sakuyaShining/FPGA-Music-project-internal/src/gowin/bringup_9k/image_rom_preview.png

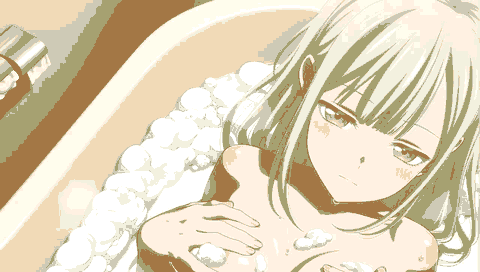
src/gowin/bringup_9k/image_rom_preview.png
