sakuyaShining/FPGA-Music-project-internal/README.md

**2026-10-29 基线复核更正：传感板暂停投产。** 实际S1 Gerber底层地铜到22个非地排针焊盘最小间距约0.162858mm，低于保留门限0.1651mm；此前原生DRC0、5μm图形比对与较低通用门限未覆盖该严格条件。可继续询价，先不按本版传感板付款生产。旧冻结包字节保留用于追溯，不能据其中的PASS或READY文字忽略本更正。详见基线`evidence/retained-clearance-gate-audit.json`。

**2026-10-29 硬件交付接续**：先读[当前交付基线](project/DELIVERY-BASELINE-20261029.md)。冻结Control88 R2×1与Sensor14Bank S1×6及送厂资料；采购报价、固件与整机验收仍未完成。任务分支候选不自动成为main。

# FPGA Music 项目总入口

**当前统一入口（2026-10-27）**：[project/CONSOLIDATION-20261027.md](project/CONSOLIDATION-20261027.md)。已整合硬件阶段成果与恢复资料；完整实体、制造文件和产品验收仍待完成。

**快速接手**：[产品规格与差距](project/PRODUCT-SPEC.md) → [工程分布](project/SOURCE-MAP.md) → [待办与验收](project/WORK-PLAN.md)。仓库现已公开；实际远程main是发布入口，未合并PR仍是候选。

当前协作工程见[工程入口](project/ENGINEERING.md)与[2026-10-24协作检查点](project/COLLABORATION-CHECKPOINT-20261024.md)：`fpga/current/`、`hardware/current/`、`host/current/`。这是有输入身份和验证边界的开发候选，完整产品未验收；历史根目录源码不作为最新开发入口。

**先读[当前设计](project/DESIGN-CURRENT.md)与[快速取得版本](project/QUICKSTART.md)，再读 [project/CURRENT.md](project/CURRENT.md)。** 该页统一导航音乐基线、开发候选、临时探针、GUI与硬件版本。

**新Agent直接读[启动入口](project/AGENT-START.md)和[交接身份](project/handoff.json)**；可转交的完整指令见[NEXT-AGENT-PROMPT](project/NEXT-AGENT-PROMPT.md)。

- 机器版本与验证边界：[project/state.json](project/state.json)
- 已保全源码及恢复身份：[版本清单](project/versions/workspace-preservation-20261022.json)
- 开工规则：[AGENTS.md](AGENTS.md) · [协作板](docs/00-协作/AGENT-BOARD.md)
- 核对命令：`python tools/scripts/project_control.py check --full --remote --fresh-entry`
- 审阅期限、活跃源与未发布WIP：`python tools/scripts/design_governance.py status --remote`，本机核对加`--live`；长期维护见[MAINTAINING-MAIN](project/MAINTAINING-MAIN.md)

当前完整功能产品顶层尚未实现并验收。GitHub保存的WIP不代表功能完成；路由完成也不代表STA通过。

---

## 历史主目录说明

以下保留原README的阶段基线。最新版本分工与有效证据以以上总入口为准。

# FPGA 加法合成电子乐器

基于高云 GW2AR-LV18QN88C8/I7（Sipeed Tang Nano 20K）的纯硬件实时加法合成乐器。
振荡器、包络、效果与曲谱时序全部在 FPGA 内完成，主机仅经串口下发控制参数。

选题：2026 高云半导体 FPGA 创新设计赛道「基于 FPGA 的实时多音色合成电子乐器引擎」。

## 音频链与硬件参数

| 项 | 参数 |
|---|---|
| 主时钟 | 板载 27 MHz（引脚 4），不使用 PLL |
| 采样率 | 52734.375 Hz = 27 MHz ÷ 16 ÷ 32 |
| 音频输出 | I2S 从模式（BCK / WS / DIN 三线），帧内单声道使用 24 位定点数据 |
| 控制接口 | UART 115200 8N1，两字节帧 `[地址][数据]`，地址表已冻结 |
| 演奏输入 | 16 路电容触摸电极（RC 充放电计数）：左手 8 键定音高，右手 8 键定泛音幅度 |
| 面板指示 | 6 个板载 LED；板载按键（引脚 88）预留 |

## 合成引擎要点

- **时分复用结构**：一个样本周期划分为 512 个时隙，即 32 声部 × 16 泛音。每个时隙完成一次相位累加、幅度查表与累加。
- **振荡器更新率**：512 × 52734.375 Hz ≈ 27.0 M 次/秒。
- **音高**：128 项相位增量 ROM 覆盖 MIDI 0–127。增量按精确频率计算而非现场近似，实测音高误差小于 0.1 音分。
- **混叠保护**：某次泛音的频率超过 Nyquist 频率时将其静音，而不是任其混叠。
- **塑谱**：16 字节泛音幅度表（谱 RAM），支持逐声部刷新。物理电极掩码与主机下发的谱按位或，因此"手指塑谱"与"软寄存器塑谱"逐位一致。
- **音色预设**：4 组泛音表。
- **效果**：延迟、合唱、8 抽头混响网络（含反馈与阻尼）。
- **曲谱时序**：片内定序器。曲谱既可固化在 RTL 中（上电后自行演奏，不依赖主机），亦可经 UART 下载。

## 目录结构

```
src/rtl        可综合 RTL：时分复用合成引擎、声部分配与音高、电极扫描、
               效果器、I2S 发送、串口接收、寄存器堆、片内定序器
src/sim        仿真测试台（各模块与顶层、判据验证）
src/constr     引脚约束（.cst）与时序约束（.sdc）
src/gowin      Gowin 工程与综合用数据表（音高表、预设泛音表、倒数表）
tools/scripts  构建、回归与判据脚本；命令行上位机；寄存器表抽取
tools/host     图形界面上位机（PyQt5）
docs           赛事情报、技术方案与学习路线文档
sim_build      仿真产物与音频证据（音频仅保留交付用的少量文件）
```

## 构建与验证

```powershell
# 编译全部仿真测试台
powershell -File tools\scripts\build_sims.ps1

# 全量回归：12 组套件，含 512 点频谱栅格与 16 组位一致比对
python tools\scripts\regress_all.py --full

# 综合与布局布线
powershell -File tools\scripts\build_gowin.ps1 `
    -Project src\gowin\tdm_synth\tdm_synth.gprj `
    -SspiAsGpio -PlaceOpt 2 -RouteOpt 2

# 图形界面上位机
python tools\host\dsp_gui.py
```

`-SspiAsGpio` 用于把 54/55/56 三脚从专用 SSPI 功能释放为普通 IO，DAC 数据线接在这三脚上，因此该选项不可省略。

## 验证方法

- **回归套件（12 组）**：加法引擎黄金参考（时分复用实现与全并行参考实现逐位一致）、I2S 编解码、包络、测试模式频谱栅格、寄存器音高、定序器事件、混响冲激响应、Nyquist 保护等。
- **音频级判据**：音高估计 7/7（±1 音分内）、混响衰减曲线、谱外能量占比。
- **判据全集、配方与证据路径**：`docs/02-技术方案/21-验收判据清单.md`。
- **接口规格（冻结）**：`docs/02-技术方案/19-UART协议v1.0草案.md`。
- **电极规格**：`docs/02-技术方案/20-pad扫描规格书.md`。

## 资源占用（最近一次布局布线）

- 逻辑资源 13690 / 20736（约 66%）
- SETUP 时序余量 +17.372 ns

## 上位机

`tools/host/` 为图形界面：键盘演奏、16 路泛音幅度调节、电极遥测柱状显示与量程判定、寄存器回读、帧序列导出。

串口不可用时可用内置"模拟设备"模式走通完整界面流程；连接真实硬件时，界面顶部徽标会明确标示当前设备类型，避免把模拟数据误认为硬件读数。

## 文档导航

| 想了解 | 位置 |
|---|---|
| 选题范围与硬性约束 | `docs/01-竞赛情报/01-选题确认与约束条件.md` |
| 整体开发计划与里程碑 | `docs/02-技术方案/01-开发方案与里程碑.md` |
| 板卡引脚与音频通路接线 | `docs/02-技术方案/02-硬件bringup-TangNano20K音频通路.md` |
| 乐器形态与交互层取舍 | `docs/02-技术方案/03-乐器形态方案建议.md`、`docs/02-技术方案/18-交互层决策清单.md` |
| 架构决策与候选方案对比 | `docs/02-技术方案/06-架构决策框架-v2.md`、`07-候选架构方案-v1.md` |
| 协议与寄存器表 | `docs/02-技术方案/19-UART协议v1.0草案.md` |
| 验收判据与证据 | `docs/02-技术方案/21-验收判据清单.md` |
| **演奏表情（力度/亮度/滑音/颤音）** | `docs/02-技术方案/31-演奏表情规格.md`（规格）、`32-演奏表情问题总表-设计层.md` / `-实现层.md` / `.json`（问题与落点）、`33-滑音颤音实现方案v1.md`（待拍板方案） |
| **当前版本规格（基线，带源码 SHA）** | `docs/02-技术方案/34-当前版本规格-基线v1.md` |
| **五阶段推进状态（阶段闸口）** | `docs/02-技术方案/35-五阶段推进状态.md` |
| 审计与复核记录 | `docs/02-技术方案/33-审计复核记录-2026-10-06.md` |
| 音高与八度规格 | `docs/02-技术方案/25-音高与八度规格.md` |
| 触控面板（选型/原型/PCB/装配） | `docs/02-技术方案/28-触控模块选型决策.md`、`29-触控原型验证程序.md`、`30-PCB布局需求单.md`、`26-电极面板装配指南.md` |

### 常用命令

| 目的 | 命令 |
|---|---|
| 全量回归闸口（33 套） | `python tools/scripts/regress_all.py --full` |
| **力度-亮度 试听与调音**（出 wav + 对照报告） | `python tools/scripts/vel_audition.py` |
| 只试一版新的力度权重表 | `python tools/scripts/vel_audition.py --table D:\tmp\my_vel.hex` |
| I²S 标准接收判据 | `python tools/scripts/i2s_std_check.py --simdir <dir>` |
| 顶层音频通路端到端判据 | `python tools/scripts/i2s_top_check.py --simdir <dir>` |
| GUI 自检（截图 + 帧一致性 10 项） | `python tools/host/dsp_gui.py --selftest` |
| 综合与时序 | `powershell -File tools/scripts/build_gowin.ps1 -Project src/gowin/tdm_synth/tdm_synth.gprj` |

## 命名约定

- 文档：`docs/<分类>/<序号>-<标题>.md`，序号自 00 起
- RTL：`src/rtl/<模块名>.v`，模块名小写下划线
- 约束：`src/constr/<顶层名>.cst`
- 测试台：`src/sim/tb_<被测模块>.v`
