sakuyaShining/FPGA-Music-project-internal/hardware/electrode-fullpanel-cam-20261030/README.md

# 完整84路电极面板：原生制造核验候选

2026-10-30已在嘉立创EDA V4.1.71实际恢复原工程，保存、关闭、重开后DRC违规0，并原生导出Gerber、BOM、插件坐标和IPC-D-356A。源文件SHA256仍为b7e9ecb16e4ea0141e8bf67e942ae228f7d2daf6d877422ee6b835a3f779530a，与旧WIP完全一致；没有重跑布线或修改C88/S2。

完整面板236×156mm，25音位×3+5八度+4备用=84路、六个背面1×16排针、六个3.2mm非金属安装孔。raw_index=channel*6+bank、C5三电极B0/B1/B2 CH12保持不变。整机450×190×60mm及18mm音位间距为已确认外形目标。

真实两层Gerber最小异网铜距：Top 0.264920mm、Bottom 0.255951mm，均通过0.25mm门限；90网全部连通，源铜与导出铜双向对应。84个活跃电极无阻焊开窗，102个过孔双面盖油，96个排针焊盘双面开窗；198 PTH（96排针+102过孔）与6 NPTH逐孔匹配，板框236×156mm，BOM六个C22465876、插件坐标与96针IPC网表逐项一致。详见FULL84-NATIVE-CAM-AUDIT.json、FULL84-NATIVE-ASSEMBLY-AUDIT.json。

首轮独立检查曾报六个安装孔中心各1µm铜点和排针钻孔坐标量化差。保留FIRST-PASS-RAW.json。源NPTH零尺寸焊盘被编辑器夹到0.001mm，导出同样的六个微小圆；检查明确证明它们全部位于3.2mm非金属钻孔内并在钻孔后去除，不能误算成成品浮铜，也没有忽略未知铜。排针导出内部单位量化最大约0.000081mm，逐孔对应界限0.0001mm；铜距门限仍为0.25mm。没有放宽铜距或修改源来掩盖差异。

本包供独立工程复核与厂家审单/报价，未代替用户制造放行、付款或供应商DFM。表面处理由厂家按阻焊覆盖及背面插件焊接工艺审单；不要求裸露触摸铜。装配目录为候选：真实屏幕盖板/孔位/后插头、线束对插高度与定长、覆盖材料/外壳配合、触摸和噪声性能仍未实测签收。不要据本包直接开整机屏幕孔或断言整机已可无条件装配。

复核：Python3+Shapely2，运行 python -B audit_native_cam.py 与 python -B audit_native_assembly.py。脚本只读原生源和导出、输出本目录报告；独立恢复重跑记录见PORTABLE-VERIFICATION.json。旧hardware/electrode-fullpanel-450-20261030保持WIP追溯，本目录为新增CAM检查点，不能把两版文件混装。
