sakuyaShining/FPGA-Music-project-internal/hardware/electrode-fullpanel-450-20261030/README.md

# 完整84路FR-4电极面板：布线源已完成，制造核验待接续

2026-10-30。**这次已经有整套25音位、5八度、4备用的完整PCB布线源；此目录当前用于队友/Agent备份与接续，不能作为已核验的送厂包。** 尚未生成本面板的真正Gerber。采购继续按C88 R2及Sensor14Bank S2各自入口审单；不要因本目录有原生PCB就付款生产电极面板。

采用用户确认的450×190×60mm外形包络、18mm音位间距。左手PCB236×156mm，两排12+13音位，每音位三电极，共75；另5个八度、4个实体备用，共84。六个背面1×16排针分别对接六块Sensor S2的J1。`raw_index=channel*6+bank`不变，C5三电极仍B0/B1/B2 CH12。右侧保留J10七英寸屏，J11取消。整机仍为C88×1+S2×6+已有Nano20K+本完整电极面板+右屏及电源/覆盖/结构/线束附件。

原生入口：`candidate/Electrode84-450-CANDIDATE/Electrode84-450-CANDIDATE.eprj3`，PCB位于其pcb子目录。最新PCB SHA256见CHECKPOINT.json（b7e9ecb1…）。原生API已将六排针翻至背面，添加布线并保存。成品源有457段线、102过孔（84个电极内原过孔+18布线换层孔）；路由器会话463段被原生合并6段冗余/共线记录，逐网逐层实际铜并集完全相同。

已独立核验：90个网络（84信号+6本地地针对）全部连通，异网源铜距最小0.255948989mm，保留0.25mm检查门限；铜到板边至少3.383026mm、到安装NPTH孔边至少2.259486mm；所有84映射及6背面排针匹配，无新增顶层走线/换层铜碰到活跃演奏电极。默认线宽0.254mm，部分焊盘逃线为0.1905mm，超过原生保留最小0.15249906mm。没有用宽度默认值掩盖颈缩。电极区域背面没有地铜平面；六组地仅连接各自15/16针，公共地经现有传感/控制线束汇合。

原生客户端在布线保存后退出，桥接连接窗口数变为0；窗口控制服务也返回app-server exited。长调用超时记录保留，不能把超时当成功。当前保存源的全部布线已用独立几何和路由会话核对，**原生保存重开DRC、真实Gerber导出及铜/阻焊/钻孔/板框对应核验仍未完成**。本次没有制造放行或实物演奏验收。

队友接续顺序：

1. 通过嘉立创EDA文件菜单打开上述eprj3，确认PCB名Electrode84-450；查询真实项目/文档ID，不照抄旧窗口ID。
2. 保存、关闭PCB、重开，运行严格DRC；记录实际结果与源SHA。若有失败，保留原门限修正，不降低规则。
3. 同源导出Gerber及BOM/插件坐标。预期96排针镀孔+102过孔=198个PTH，另6个3.2mm NPTH；ViaDRL是PTH子集，不能双计。此预期仍须逐孔核验。
4. 核对两层实际铜连通/异网间距、全部电极阻焊覆盖、所有过孔盖油、96排针开窗、NPTH/板框和源图形双向一致性。PCB顶层为演奏面，全部6排针在背面，由工厂插件预焊。
5. 使用assembly的96针合同预制六根1:1线束；确认实物接头高度/方向和屏幕完整外形/插头净空，再冻结外壳加工图、覆盖材料厚度与接线长度。
6. 厂家DFM和含运报价、700元总预算及实物触摸/串扰/标定另行验收。

`assembly/instrument-450-assembly-candidate.svg`为安装包络候选。六块S2旋转90°后按3×2排列，轮廓无重叠；屏幕180×104仅是预留名义框，厂商触控盖板/孔/插头数据未到，不能据此切壳。`overlay-cut-candidate-1to1.svg`和毫米DXF为连续绝缘覆盖外形候选，含6个3.4mm固定孔，没有露铜窗口；PET0.25+胶0.05mm仅待实测选型，没有确认具体采购商品。更多装配要求见assembly/ASSEMBLY.md。

独立复核需要Python3和Shapely2，在目录内运行`python audit_full_panel.py`与`python verify_assembly_contract.py`；复制到独立目录再跑，避免覆盖备份证据。原生工程已包含嵌入库，不依赖原作者D盘。运行记录与精确SHA见MANIFEST/CHECKPOINT/PORTABLE-VERIFICATION。
