sakuyaShining/FPGA-Music-project-internal/hardware/team-handoff-20261030/README.md

# 采购队友与 Agent：2026-10-30 统一交接入口

本包冻结的是截至本次同步的真实成果与已确认决定。**不是整机全部可付款生产的放行包。** 先读本文件和 `ORDER-STATUS.csv`，再打开旧送厂资料。旧文件中的 READY/PASS、手贴铜箔、另买音箱、外形待提供等内容与本页冲突时，以本页及对应新证据为准；旧制造源保持原字节供追溯。

## 整机统一口径

一台整机由 Control88 R2 控制板×1、Sensor14Bank×6、用户已有 Tang Nano 20K×1、左手完整 FR-4 电极面板×1套、右手 J10 7英寸电容触摸屏×1套，以及覆盖层、外壳、固定件、供电和连接线组成。不是七块板加屏就已可装成成品。Control88 已集成 PCM5122，无需再买 DAC；J11 已取消。音箱由用户借用，采购预算中不再计音箱。

用户已确认：**450×190×60 mm（宽×高×厚），18 mm 音位中心距优先采用**。左手两排25音位（C3–B3 的12个、C4–C5 的13个），每音位3电极共75路，加5八度与4备用，共84路。传感板每块14个外部通道，另2个校准通道。严守 `raw_index=channel*6+bank`；C5三电极仍为 B0/B1/B2 的 CH12。不能为了采购或布线重排映射。

左手236×156 mm与右屏名义180×104 mm的放置仅是包络候选；内部堆叠、安装孔、插头弯线和实际触控盖板干涉尚未验收。60 mm深度不是已经装配成功的结论。详见电极目录 `mechanical-envelope.json`。

新增全部硬件、PCB/SMT、屏幕、附件和运费合计上限 **700元人民币**。现有 Nano 不重复采购；用户没有 USB-A 转 USB-C 数据线或5V电源；有源音箱借用。没有已经确认的整机总价和供货日期，未知报价不能填0。

## 现在能做什么

|对象|当前状态|采购队友的动作|
|---|---|---|
|Control88 R2×1|原生与制造资料已冻结，可送厂家DFM/贴装审单|使用 `factory-files/factory-handoff-20261029/01-Control88-R2/` 的 Gerber/BOM/CPL，请厂家报1块组装成品、排针预焊、运费；裸板最小数量单独计价。确认预览、器件及报价后才付款生产|
|Sensor14Bank×6|**S1暂停投产；目前只是询价未付款**|只能询价和告知等待修订。不要按本包S1旧文件付款；S2修正制造文件尚未完成|
|左手完整电极面板1套|完整面板尚未布完；有单音位样片工程|本包 coupon 是46×72 mm单音位三电极，不能当25音位整套下单。等完整布局/制造核验与装配定义|
|J10屏幕1套|选型方向确定，完整配置和含运报价未闭合|可立即向厂家官方店询配置与交期，见下文；不要直接购买默认裸模块|
|USB数据线1条|有精确商品 C430908|可按详情核对后购买1条；不是系统大电流供电线的额定证明|
|音频面板座1个|已选 C381127，属于未接线裸座|可采购该座；优先连同线束询价预焊。并非C88上已有3.5mm座，也不能直接加进C88 SMT BOM|
|5V电源/分线、全部线束、覆盖层和结构件|接口/方案部分已定，精确商品未全部闭合|先按下文要求询价和核验，型号、额定值、配合尺寸与总价确认后购买|

## 直接商品与询价要求

1. **USB数据线：Ckmtw S100920007 / C430908**，USB-A公转USB-C公、1m、有数据功能，1条。立创详情：https://item.szlcsc.com/426730.html 。袋装数量不等于购买起订量；国内实时价格、库存、运费以结算页为准。
2. **音频座：星坤 XKB PJ-301M-3-B / C381127**，TRS立体声、3焊片、带螺母面板安装。https://item.szlcsc.com/353359.html 。不要误买 -2-B/-2-Y 单声道版本。C19189087不再作为本方案首选。C88 的 J12 是 C49257 三针排针，针1=L、针2=R、针3=GND；经约200mm柔性双芯屏蔽线到 TRS 的 Tip/Ring/Sleeve。实际座脚须以插入TRS插头的通断测试确认，不猜焊片编号。预焊、绝缘热缩、应力释放、面板固定一并报价。详见 `audio/` 的厂家图纸、接线说明和可直接提交的补充需求。
3. 嘉立创可以对 C88 上 J12 等排针做插件焊接审单；**外置音频座和线束是否接单尚未确认**。定制线束询价入口：https://cable.szlcsc.com/customize.html 。普通裸母排针不是已压接好的成品线束。若采购队友联系厂家，附 `audio/给嘉立创-音频接口预焊补充需求.txt` 并索取接单确认、针序图、含运总价和交期。
4. **屏幕厂家候选：BuyDisplay ER-TFTM070-5V4**，7英寸800×480、RA8875、FT5316电容触控。官方：https://www.buydisplay.com/7-inch-lcd-module-capacitive-touch-screen-panel-i2c-spi-serial 。明确要求出厂 **4线SPI、5V供电、3.3V逻辑兼容、FT5316 I2C/INT/RESET、预焊40针及所有匹配线束**；索取模块/触控外形、孔位和接头图纸、完整配置含运人民币报价与真实发货日期。默认接口可能为8080并口，料号和页面起价不足以保证配置；不能把 Arduino shield 变体当直接替代。用户仅允许屏幕单独走厂家官方店，其他器件继续嘉立创/立创。我们没有代发询价或取得报价。
5. **供电**：5V系统，Nano USB-C独立支路，C88 J13另一支路，共地；J5.1 的 Nano5V保持NC，J13不能给Nano供电。5V架构确定不等于电源商品已选好。需核对整机电流预算、峰值裕量、接头和线径后确定电源及分线，不能用未核实的充电头冒充已闭合方案。
6. 电极到传感板6组接口线、控制板到传感板线、J10屏线和触控线、USB线、供电分支和音频线均须在总表核对，不能只买排针。传感板J1通道CH0…13对应针8/7/6/5/4/3/2/1/14/13/12/11/10/9，15/16地；按针号逐端核验，不能只看线色。外壳、螺柱螺钉、绝缘支撑、连续粘合绝缘覆盖层仍待完整机械设计精确选型。Nano有TF槽，是否需另买卡及容量/格式随最终固件确认，不另买TF模块。

## 必须保留的工程暂停项

Sensor S1 实际导出的底层地铜到22个非地排针焊盘最小铜距 **0.16285815884790691 mm**，低于保留门限 **0.1651 mm**。原生DRC0和旧宽松图形容差没有覆盖此严格条件。旧冻结包与统一送厂包原字节保留，**完整性校验PASS不代表传感板可投产**。修正独立S2源、重铺地铜、保存重开DRC、同源Gerber严格量测及连通/回流/钻孔/BOM/CPL复核尚未完成。

电极 coupon 已有真实原生源、保存重开DRC0、同源Gerber和独立铜距/阻焊/19孔/闭合板框核验；完整25音位FR-4面板、安装孔、覆盖与预焊定义未完成。触摸单调性、噪声、邻音误触和演奏表情没有实物测量通过的结论。工厂蚀刻面板是当前方向，旧资料中的手贴铜箔不再作为最终采购动作。

后续执行顺序：S1严格铜距修正 → 完整电极/机械集成 → 同源制造及装配核验 → 其余精确采购闭合 → 实物安装、固件联调与标定。采购队友可同时推进C88审单、屏幕完整配置询价和附件供应确认，不必等待所有设计工作才询价。

## 包内索引与 Agent 接续

- `ORDER-STATUS.csv`：逐项数量、状态、下一动作和来源；询价反馈填 `QUOTE-REPLY-TEMPLATE.csv`，保留币种、运费、配置和交期，不填写虚构报价。
- `audio/`、`procurement/`：今天新增采购和音频资料；带日期的历史说明有沿革，当前状态以本页/STATUS.json为先。
- `electrode-candidate/`：样片原生工程、Gerber、84路CSV、生成/检查脚本、清单、真实核验输出和450mm包络。不是完整面板放行包。
- `factory-files/`：原统一送厂包解包，主要供C88审单；其中S1始终HOLD。`historical-recovery-HOLD/`：原封存包、原教程、Q4固件源码恢复包及证据。旧整机步骤仅供沿革，不覆盖本页。
- `MANIFEST.json`：本整合包所有文件大小及SHA256，附 `verify_handoff.py`。解压后运行 `python verify_handoff.py` 核对完整性。

远程仓库 https://github.com/sakuyaShining/FPGA-Music-project-internal ，交回既有 PR #9；本次同步仍是任务分支候选，尚未合入main。采购Agent不要只读取main或旧README。源码全历史以远程仓库为准，本包保全当前硬件与采购输入及Q4源码恢复，未声称固件/整机验收完成。

若从仓库获取：先 fetch `internal`，阅读本次PR指定提交的 `hardware/team-handoff-20261030/README.md`；不要在有未提交改动的目录直接切分支。原生电极源在 `hardware/electrode-panel-20261029/`，原冻结恢复在 `hardware/delivery-baselines/20261029-r2-s1/`。运行现有治理/完整性检查；缺本地producer路径时明确未实时核验，不擅自抹除检查项。只同步本轮实际工程、决定、采购和限制；未上传完整私聊、账号配置或令牌。
