sakuyaShining/FPGA-Music-project-internal/project/reviews/20261023-team-handoff/evidence/hardware/u8-power-corridor-20261022/address3-local-recovery/retained-control-recovery/u9-layout/README.md

# PCB当前施工入口

更新2026-10-23T18:58:38.588878+08:00。工程：C:\Users\Sakuya\Documents\LCEDA-Pro\projects\FPGA-Music-U9ControlWork-20261023。
SHA256：e098c5db426edb8e02a966807079db3f125332653c14a250b5521ffbb76655c7；会话：707f3d01-d542-452d-a514-a4d59d2f0078。

原生四层重铺、严格DRC、保存关闭重开：0间距/0物理/0网表，47项未连通/13网，227件616孔，899节点。**仍不可投板，实物UNMEASURED，aaa37恢复基线未修改且施工版未晋升。**

本批BUS_MOSI整网真实闭合，J6.6/U8.14/U15.4/R64.1/TP14已同一实铜岛。27段声明新铜、8个信号孔、6个新地孔；全板Top/Inner16/Bottom整岛目标路由先取得38段，再删除12个冗余线/孔对象，新增线长度合计137.738mm；这是分支长度总和，不是时序或示波器测试通过。电气工作频率、驱动强度和最终信号完整性仍须结合最终固件/上电波形核实，未修改产品RTL。

mosi-main-native-review.json通过：431项声明范围参考比较无新增退化、全部新增信号全宽最近参考缺口0、孔焊盘/钻孔及真实回流合格；899节点、52外部接口、全部未声明非铜及实际铜对账通过。额外mosi-main-connected-ground-review.json对整个实际MOSI的34根原生线核查，参考只计算通过四层实铜/焊盘/地孔环与U8.8地焊盘真实连通的地多边形，6个新地孔均连至该网；沿用自孔1mm/通孔焊盘0.5mm排除及已有回流门。后续批次自动保留此连接检查。

同网原生自动接点和拆段导致Bottom铜最大0.0000248498mm微差，已保留前后逐段声明mosi-main-bottom-native-junction-normalization.json；其他网/层保持独立1e-5mm铜对账，制造、连通、参考、回流规则未变。P0/C8/R63/R64/3个测试PAD的全部历史验收继续保留。

恢复包construction-native-NOT-FOR-FAB.zip包含19原生文件和本说明；前一2884/51/602孔完整包mosi-main-source-native.zip不覆盖。所有apply/路由终态。

当前唯一施工原生e098c5db/47未连通13网/227件616孔，MOSI已整网闭合，禁止再把U8/U15/J6/R64/TP14当未连通孤岛，也不重跑已终态MOSI寻路/apply。全部接口MOS信号现真实同岛；27段声明新铜(初始38段已去冗余)、8信号孔、6个真实地孔，最近实际回流均合格。431项参考比较无新增退化，899节点/52外部焊盘/精确非铜和实铜通过；MOSI全网34根实际原生铜的最近参考只采用与U8.8真实铜连通的地多边形，6个新地孔均连至该实地网。该门已加入control-branches-review.py next和four_layer_geometry.grounded_planes，后续必须保留。仅MOSI Bottom同网原生自动接点/拆段最大0.0000248498mm显式记录，不放宽全局1e-5mm铜对账或物理门。原2884/51/602孔完整包mosi-main-source-native.zip保留；原aaa37基线未改，区域施工仍不可晋升/投板，所有实物UNMEASURED。当前无活动路由任务。下一步读control-central-270-current-screen.json及control-native-footprint-geometry.json：已直接抽取本版原生内嵌FOOTPRINT，使用POLY3实际丝印含圆弧/圆、POLY48本体及真实焊盘，不能再只用焊盘加0.25mm代理器件边界。U9中央74/42mm270度、C9旧Top78.5/46.5种子有3处器件冲突，不能导入；C9改Bottom77.5/47.5(或77.5/48、77/47.5)的初筛无同面器件冲突，仍有按pad-对象计49处IO/GND/BUS_SCK/TP_RESET_N铜孔约束，未完成quiet/全部焊盘、去耦/回流/供电/参考/13控制及邻近TP_RESET_N联合恢复，绝不是可直接apply的方案。优先完成该短去耦回路和所有耦合线路方案，保留MOSI/P0/P3/HARM/触控复位和全部47个IO供电脚。当前实际U9=91/19mm180、C9=99.25/16mm0保持，只有完整13网及受影响TP_RESET_N恢复候选通过才原生联合改位，不增加未恢复负担。旧Top90度方案、原位ENC319mm/P2绕行、旧C8Top11mm、旧R64南移、541替换和SPI死支路均终态，不重跑。另一个只读反事实control-original-pose-current-screen.json显示原U9/C9回原位有7个新MOSI/孔焊盘冲突，不能直接回放老铜。共享IO母线27.232mm不能盲删；可联合调整控制/PDN/GND但必须完整恢复，不碰RC/传感/音频/5V铜，不改RTL。继承ADDR3/M02/M03/旧复位参考缺口、低活动触控复位Inner16最近Ground2约6.110mm例外、RC_DRIVE旧地孔Ground16接触0.1474mm²偏好缺口仍开放。实际3个Bottom SMT(C8/R63/R64)、224Top/3Bottom组件、212TopSMT/3BottomSMT/12TH不变，旧CPL及单面报价无效，背面净空/双面装配报价待核；不假设手焊。其后收口ADDR0/1/2/MUX_DISABLE与剩余9个区域控制。最终屏SKU/CTP/RESET(NC)接口/线束机械、电源/84附件/制造及BOM/CPL与上电测试门仍开放；本轮未改产品RTL、未下单、未外发。

9个区域控制及4个地址/禁用原目标仍开放；整板参考例外/真实功能验证/制造装配和最终硬件选型未收口。当前自动唤醒继续，仅PCB与最终选型均完成才关闭。

## 2026-10-23T22:59:02.407042+08:00 离线联合恢复与采购核对

本轮未修改原生，仍e098/47项13网，包及19个原生文件哈希均核对一致。当前CAD会话a367084e-a21d-4082-8b70-50052c68a272已恢复同一自有工程；首次冷启动枚举超时的证据保留，随后原工程UUID/PCB身份确认成功。

270度中央方案的供电/短去耦及触控复位候选不能通过完整时钟恢复，未导入；北移36/34mm又与SW2/模拟音频保护冲突，未导入。改为90度功能朝向后时钟已离线整网连通，整岛供电源/目标方法恢复47脚。当前仍需全部其余控制、真实参考/回流/铜与非铜验证，所有候选不得直接apply。唯一接续为本目录next-entry.json及central90-controls-work-state.json，运行状态须核对真实进程，不把旧running当活任务。

板上BOM已按227件逐项对齐为215SMT+12TH、36料号；新SMT草稿及采购入口在purchase-preparation-20261021-r1。新LCSC快照不是嘉立创工厂装配库存、国内报价或交期；Nano20K/屏/线束/84附件仍另行收口。实际仍224Top/3Bottom组件，旧CPL六行失效、双面及TH工厂装配/机械待核，不假设手焊。仍不可投板/下单，实物UNMEASURED。
