sakuyaShining/FPGA-Music-project-internal/hardware/team-handoff-20261030/procurement/采购优先-第一批核实-20261029.md

# 整机采购优先：第一批核实（2026-10-29）

**2026-10-30 更新：音箱改为借用，移出新购清单。音频引出插座选定星坤PJ-301M-3-B/C381127（带螺母TRS双声道面板座）；完整预焊线束尚无已确认成品SKU，已写明定制规格、固定和导通验收。详见 `audio-j12-20261030/J12音频输出插座-采购与装配.md`。下文“没有音箱，需要采购”是此前状态，由本更新覆盖。**

统一配置已写入远程 PR #9 的说明顶部：https://github.com/sakuyaShining/FPGA-Music-project-internal/pull/9 。本记录仅描述实际完成的采购核实，不表示全部配单完成。用户确认除 Tang Nano 20K 外，没有USB-A转USB-C数据线、5V电源或带AUX输入有源音箱；这三项均需采购。整机新增采购与运输上限700元保留。

## 已确定规格，可先购买

|用途|精确商品|数量|立创购买入口|边界|
|---|---|---:|---|---|
|Nano下载、调试及USB供电连接|Ckmtw 灿科盟 S100920007，C430908，USB-A公转Type-C公数据线，1m|1条|https://item.szlcsc.com/426730.html|国内页面确认数据线、1m、起订1条；电流额定值未给，不将它认定为整机大电流主电源线|

国内页面动态价格未读到；页面“￥0.00”是未选数量的占位，不能当免费。LCSC公开商品接口本次返回型号S100920007、库存67、起订档1件US$3.224；这是海外接口快照，不能当国内人民币价格、库存或交期。实际付款金额以国内页面为准。不要按100条/袋误买100条。

## 优先发起的成品板审单

- Control88 R2：1块装配成品，使用现有单板Gerber、BOM、CPL，含SMT并优先报价插件预焊。板上已含PCM5122，避免再买DAC模块或板载芯片散料。
- Sensor14Bank：6块装配成品，当前仅询价未付款。旧S1实际Gerber严格铜距未过，继续保留制造暂停；需修正版闭环后才能付款投产。
- 成品传感板独立分板交付；工厂SMT需要的拼板、工艺边和分板费用由厂家审单列出。按净需求1+6核价，多余裸板不自动增加SMT。

## 屏幕：可直接访问的精确厂家商品，完整选项尚待确认

首选仍是EastRising ER-TFTM070-5V4：https://www.buydisplay.com/7-inch-lcd-module-capacitive-touch-screen-panel-i2c-spi-serial 。官方索引确认RA8875、800×480及FT5316电容触控选项；基础显示价US$40.18是页面索引快照，不是完整含触控/预焊/线材/运费报价。本次直接取商品页返回403，未取得可结算配置总价；不据此声称已确认下单。

需要购买的完整配置：

1. ER-TFTM070-5V4，7英寸800×480，RA8875；触控选电容FT5316，不能选无触控或电阻触控版本。
2. 出厂配好4线SPI及5V输入，保留3.3V主控信号适配；请厂家回传显示/触控引脚表、触控I2C/INT/RESET电平、跳线与实物照片。
3. 预焊40针，配套母端连接器和可接线缆；电容触控接口及其线缆必须一并包含。控制板J10是1×12，不是屏端40针直接对插，仍须端到端配线。
4. 数量1套，报价分别列主模块、电容触控、预焊、连接线、税运、人民币结算方式和实际发货日。
5. 不为当前需求另买Arduino主板、第二块屏、HDMI模块、字体/闪存扩展等附件。

官方资料还存在ER-TFTM070-5V4-4125套装，页面说明默认5V/4线SPI，但包含Arduino shield配件。它尚未完成与现有J10、预焊和触控配线的核验，不直接替换首选型号，不因此新增功能板。

官方资料：https://www.buydisplay.com/download/manual/ER-TFTM070-5V4_Datasheet.pdf 。§4.4列出5V选择与4线SPI焊接配置，说明仅型号正确仍不足以认定到手接口配置正确。

## 继续优先核实的电源、音箱与线束

|项目|已确定的适配条件|未关闭项|
|---|---|---|
|成品电源|稳定5V；Nano USB-C和Control J13两支路，J13.1=5V/J13.2=GND|精确国内SKU、额定输出/负载预算、接口与供电分配线、价格交期|
|有源音箱|可接模拟立体声AUX线路输入，自带功放|立创精确商品、含运价、是否自带音频线及独立供电；USB纯数字音箱不能直接替代|
|Control到6传感板|6条1×16、2.54mm母对母，逐针1→1|成品/定制商品、长度、价与交期；不能用2×8 IDC替代|
|J13供电线|板端为JST B2B-XH-A(LF)(SN)，准确间距2.5mm|整条预压线商品；XHP-2只是胶壳，不能作为已完成电源线采购|
|音频输出端|J12.1=L/.2=R/.3=GND，可靠固定的插座或成品引出线|现有C19189087是裸插件插座，不当作接好线的附件购买完成|

已查到立创正式目录有音箱/音响168款、充电器315款，不能因为公开搜索结果不完整就断言平台没有卖。目录入口：https://www.szlcsc.com/catalog.html ；音箱类目：https://list.szlcsc.com/catalog/13614.html ，充电器：https://list.szlcsc.com/catalog/11536.html 。本次类目正文未成功读到完整可核实商品，所以两项继续找具体SKU，仍遵守屏幕以外优先嘉立创平台约束。

## 后续耗时工作

完成上述采购确认后，继续传感板铜距修复、完整25音位电极面板与结构尺寸、最终线束制造和整机装配核验。电极样片的DRC/Gerber检查不能代替完整面板或实物触摸验收。TF卡容量/格式和旋钮帽等按固件/轴型确认后配单，不能遗漏，也不能随意选一个商品先买。
