sakuyaShining/FPGA-Music-project-internal/hardware/current/module-plan/evidence/module-readiness-current.md

# 当前距离采购组装的剩余工作

**2026-10-27 接续更新**：用户已于17:58批准指定35段通孔过渡区的限定验收口径，证据见 `project/reviews/20261027-hardware-consolidation/sensor35-approval.json`。后续继续同源制造文件核验；尚未完成该核验，也未授权投板、下单或制造放行。文内较早的“待确认”属于批准前状态。

2026-10-27：不是只差保存/取消接口。新增三键候选解决的是电气输入设计，不能把它算成已经买到预焊成品或产品编辑功能已实现。

|组|项目|实际未完成项|
|---|---|---|
|G1|84路传感前端|35项数值已提交，验收口径待用户决定；同源制造、预焊报价、交期未闭合|
|G2|控制/编辑/存储/保护|三独立键串接候选逐针合同与64件电气清单已生成；完整预焊板、布局/CPL、固件读回和产品动作语义未签收|
|G3|J10完整屏配置|等待已约定的完整配置/含运报价/出货日；物理针序未全部冻结|
|G4|PCM5122到3.5mmAUX|准确55元音频板候选保留；初始化、共享模拟路径人口、输出RC保护、准确转接件与供电仍待关闭|
|G5|全部采购附件与预算交期|板载TF卡座已核可省外部FPGA读卡模块；卡SKU未选；电极、线束、结构、供电、代焊运费均须补齐，总价≤700未证|
|G6|实体整机与视频|完整产品物理顶层/驱动/时序及12条实测未签收；没有将旧板测继承为新整机通过|

新增进展：edit-control-interface-current.md/json列三键最小增量、全部脚号和位序；control64-candidate-BOM-current.csv/json列原56项和新增8件，未冒充正式BOM/CPL；Nano-TF-storage-scope-current.md/json保留板载TF证据、排除下架卡。不改PCB/RTL、不下单或外发询价。35项口径仍未获明确批准。
