sakuyaShining/FPGA-Music-project-internal/hardware/current/module-plan/evidence/sensor-header-fanout-current.md

# 传感前端：14路排针扇出与左8路完整路径离线候选

本轮没有原生PCB/原理图/RTL改动。源仍83b238df，原生仍21网56项未连。原951和14页、当前小板40项文件哈希保持。图中彩线仅为候选，不是当前接受铜。

## 已核过的具体改变

- 原14个排针信号回流地孔在排针右侧x约6.4513mm，占据J1到ESD的扇出区。候选把这14孔镜像到排针左侧x约3.5487mm；各孔y/孔径/钻孔不变，21个既有信号通孔回流约束未放宽，本次14孔对应距离最大1.45125964mm，均小于1.5mm。另22孔、91段原铜及全部器件位置保持。
- 不重跑终态网格搜索。改用明确整组几何：14路J1—ESD直达/折线路径；14段封装内外部NC直通短桥；左8路ESD—串阻在x17.5mm转为水平入焊盘。共68段候选铜、0新增信号孔，按150PAD、91原线、36候选孔以及全部候选线相互核实际间距，全部通过。
- 直接大斜率入串阻曾碰邻接R10/R9/R8焊盘（原实际距0.039761/0.053019/0.035239mm，要求0.1651mm），已明确改为x17.5水平入端；拒绝结果保存在JSON内，没有放宽规则。最终左8路额外净距最小0.00985183mm，仍需原生实际读回复核。
- 继承上轮22PAD候选改网及84路外接补偿表，仍未实施。对所有电极焊盘与候选真实铜做并集连通：E00—E07各1岛（排针/ESD IO/NC/串阻全部相连），E08—E13仍各2岛，尚缺ESD至右侧串阻部分。校准CH14/15、六路独立SENSE_OUT和单J10目标不变。

## 尚未通过的地参考与接受门

移孔后的Ground只有假设模型：用旧实际Bottom多边形填旧14个地钻孔、切新14孔，模型仍一组件；它不是原生真实重铺结果。左8条ESD—串阻在此模型全线宽缺失0，但排针扇出在通孔终端区域外仍有最大约0.000492292mm²未覆盖，因此**不把整组参考判为通过，也不扩大终端例外或阈值**。这个差异和TH过渡/原源Cu/接触/DC/细颈/机械均需在完整候选真实重铺后核验。

## 接续工作

1. 先完成右6路ESD至串阻的共同通道规划，保留这批明确扇出与左8路作为候选输入；不能把原生仍开放的8网报为已接受闭合。
2. 同时保留7个控制/采样网的通道，不能只求14电极而封死其余网络。不得重放旧grid/Top35/native apply或整段复建工程。
3. 完整候选成立后，先实时核同一工程/PCB/网关/PID、SHA/对象/规则/恢复点、软件自动保存和资源；再在同一自有工程可回滚试验，显式同步22PAD、14地孔和线束标签。
4. 实际重铺、全部源铜参考/回流/旧接触/DC及严格原生DRC、保存关闭重开全部通过后才可接受。之后才可提交同版制造与工厂预焊报价。

当前预焊报价/清远交期、控制保护、屏完整价、完整700元总价及整机固件接口仍未闭合。实物UNMEASURED。没有下单、付款、外发消息或删除功能。
