sakuyaShining/FPGA-Music-project-internal/hardware/current/module-plan/evidence/传感小板参考验收口径-待确认.md

# 传感小板：需要确认的一项验收口径

**2026-10-27 接续更新**：用户已于17:58批准指定35段通孔过渡区的限定验收口径，证据见 `project/reviews/20261027-hardware-consolidation/sensor35-approval.json`。后续继续同源制造文件核验；尚未完成该核验，也未授权投板、下单或制造放行。文内较早的“待确认”属于批准前状态。

当前候选 SHA256：`617f550eadc818ffab26a3992f2a86bb9f72ed027043c6e64a0c0428077ba643`。

小板已经完成真实四层重铺、保存关闭重开，严格 DRC 和未连通均为零。150 个焊盘与原理图网表一致；原 91 段铜和原硬规则逐项保留。实际新增及移动铜、钻孔间距独立检查通过。地网直流连通、实际地铜接触、全部三层地铜在 0.1651mm 细颈侵蚀检查后均保持一个连通组件。

此前两处真实问题已经修复：E13 改走底层避开相邻信号孔的地铜避空；ADDR2 局部改线避开 ADDR3 换层孔的地铜避空。排针地焊盘的内层热焊桥增加了真实地线连接，修复原细颈；没有画假地铜。新增 E13 换层孔有实际配对地孔，另补了 3.3V 输入排针的回流地孔。所有信号及电源通孔的最近实际配对地孔均不超过 1.452mm，配对地孔与实际铺铜的接触面积均不小于 0.15mm²。

## 剩余 35 段报警究竟是什么

它们不是 35 处断线。现有检查将地铜缺失投影到整段信号铜，并只扣除旧的“焊盘/孔铜边缘向外 0.1651mm”终端范围。原生地铜按保存的铜区规则及算法，为信号通孔留出的绝缘避空实际更大。因此，一段已经连接到信号通孔的铜线，在该孔自己的真实地铜避空内仍会触发旧口径报警。

本次没有扩大旧口径或将其改判通过。另做的诊断直接读取实际地铜多边形的孔边界，不用假设半径：**全部剩余缺失均仅落在本信号自己的实际反焊盘内，反焊盘没有包含其他网络通孔，实际反焊盘之外已无未覆盖的信号或供电铜段。** 上述真实邻网避空问题修复后才得到这个结论。

证据：`sensor-fourlayer-exact-antipad-scope-review-current.json`、`sensor-fourlayer-final-candidate-audit-current.json`、`sensor-fourlayer-Ground-DC-current.json`。其中旧验收仍明确记为失败，尚未接受小板。

## 请求确认的唯一变化

允许将“本信号通孔自身的、从原生真实地铜读取的绝缘避空”作为局部换层/排针过渡区，使用已经核实的配对地孔、地铜接触和连通性单独验收。过渡区外仍要求完整实际参考；不得把邻网避空或其他跨空区域并入。

所有铜距、孔距、过孔尺寸、细颈要求、严格 DRC、原铜保护以及其他功能要求保持原值。**这不是同意投板、下单或认为实体性能已测试。** 工厂叠层、装配机械、完整预焊方案、全部采购总价不超过 700 元和交期仍须收口。

需要确认的原因来自用户持续要求的“不得扩大旧例外”：在获得明确确认前，不能把上述诊断当作旧验收通过。若保持旧口径，此小板继续保持未接受状态。
