sakuyaShining/FPGA-Music-project-internal/project/reviews/20261023-team-handoff/evidence/hardware/AUTONOMOUS-CURRENT.md

2026-10-23T22:59:02.407042+08:00 本轮原生e098/47项13网未变；90度联合布局候选的时钟和47脚供电仅离线连通，完整控制/参考/回流待复核，不能导入或投板。采购227件/215SMT+12TH/36料号已与原生核对及新LCSC快照；屏/线束/机械/工厂报价仍开放。唯一入口u9-layout/next-entry.json，真实任务状态以进程核对；自动继续，实物UNMEASURED。

2026-10-23T18:58:38.588878+08:00：BUS_MOSI原生整网闭合，J6/U8/U15/R64/TP14同岛；当前e098c5db…0间距/物理/网表、47项13网、227件616孔。431项参考比较无新增退化，34根实际MOSI铜及6新地孔的真实接地参考核验通过；899节点/接口/非铜与铜对账通过。仍9个区域控制和4个地址/禁用原目标开放，尚不可投板/实物UNMEASURED。下一步新74/42mm270度U9与C9 Bottom候选联合恢复13网及邻近TP_RESET_N，候选只是筛选不得直接导入；原Top C9种子有3处器件冲突。唯一入口construction-state/README；原2884和aaa37包保留，自动继续。

以下历史仅供追溯，接续以上述唯一入口和实时哈希为准。

2026-10-23T18:27:02.262411+08:00：原生R63/R64与3测试PAD联合改位及供电/地/信号分组恢复，当前2884b393…0间距/物理/网表、51项14网、227件602孔；MOSI5岛→3岛，U8/R64/TP14同岛，J6/U15仍隔离，时钟原2岛无拆分。430参考比较无新增退化、899节点/接口/精确铜与非铜核验通过。当前3件Bottom SMT，旧CPL与单面报价无效，机械/双面报价仍开放。下一步新实际场上联合MOSI主干/邻近出线，再恢复9个U9控制；旧失败/终态事务不重放。唯一入口u9-layout/construction-state.json和README。仍不可投板、实物UNMEASURED、自动续跑继续。

以下为历史记录，当前只以上述入口实时哈希为准。

# PCB当前施工入口

更新 2026-10-23T17:59:16.682620+08:00。工程：C:\Users\Sakuya\Documents\LCEDA-Pro\projects\FPGA-Music-U9ControlWork-20261023。
SHA256：8a0fe13678ec90701948c6666fbd49aa8b9779a442ad7dc12477bc4d97be1fed。会话：9cd263f6-82f5-4793-9189-ade7dcaafcef。

四层重铺保存关闭重开严格DRC：0间距/0物理/0网表，54项未连通/14网，227件603孔，899节点。**仍不可投板，实物UNMEASURED，原aaa37基线未修改且未晋升本施工副本。**

本轮C8已实际移至Bottom，60.75/50mm、0°；同一电容/封装/引脚/物料，其他器件不动。3条13.2mil新铜、1个24/12mil供电孔及1个24/12mil地孔：U8 VCC到C8供电支路2.33650mm，C8地支路0.89874mm。全部47个3V3_IO供电脚原生闭合，地保持；实际换层回流距离1.45mm，新增地孔Ground15/16/2接触以报告实测几何为准。原Top新候选被固定5V总线迫成11.042mm绕行，未导入；Top近场和局部时钟改道筛选均终态，不能重复。

最新control-C8-bottom-native-review.json通过：428项当前/原生参考比较无新增退化、声明新增线全宽最近参考缺口0、孔与焊盘/钻孔间距及实际回流通过；PRESET0/PRESET3/HARM/触控复位保持。实际铜对账、899节点、52外部接口焊盘和全部未声明非铜保持；只声明C8位置/面和其自身随动标注，标注内容/字体/BOM属性保留，C8两焊盘位置/网/形状/面另行核对，未忽略非铜差异。

**装配约束已变化**：当前226件Top+1件Bottom；SMT为214件Top+1件Bottom，12件通孔。不能再沿用C8旧CPL行或单面SMT报价。完整机械背面净空与双面装配报价还未核实，不代表该制造条件已获报价或放行；不得假设用户可以手焊替代工厂工序。

Resume same native U9ControlWork source8a0fe136/54 connections/14nets/603vias. C8 is now ACTUALLY Bottom at60.75/50mm0deg, fully restored3V3_IO/GND; never replay or restore old Top C8 plan. Exact current proof control-C8-bottom-native-review.json, accepted_component_plans(C8) and accepted_control_plans(PRESET0+C8 power). New2.3365mm supply and0.89874mm Ground branches, actual1.45mm return, reference/physical/pads/native0clearance0physical0netlist and899node checks passed. Current board226 Top components+1 Bottom; same227 BOM; old C8 CPL and old single-side PCBA quote invalid. No fab release: mechanical underside clearance and two-side assembly quotation remain pending. Source9d03 cleanup andaaa37 backups preserved. Top C8-at58.75/52mm proposal had11.042mm supply detour and was rejected; close Top-only C8 fields and local clock-corridor probes terminal, do not repeat or rerun old job handles. All real jobs terminal. Next jointly relocate remaining R63/R64 and3 standalone testpads to free original U9 control area while preserving all current power/Ground/clock/BUS_RETURN pad partitions and improving or preserving MOSI. Since Bottom assembly is already introduced, screen short Bottom pulldown loops near U8: initial R64=63.75/50.25mm0deg, R63=66.75/50.25mm0deg are ONLY fresh seeds, not verified routes or imports; protect Bottom sensor/RC/audio quiet zones and C8 component courtyard. Prove all four-layer copper/hole/pad/nearest-reference/return geometry before any native batch, expand exact declaration validator specifically for these component moves and standalone TP13/14/15 PAD transforms, preserve both accepted PRESET0 and C8 checks. Testpads may be placed on actual connected main Cu islands, not fixed isolated goals. No new PCB copies or terminal-route replay. Future U9 site74/42mm must be re-screened with functional orientation: prefer checking270deg so CLK/LOAD face U8 and encoder inputs face right-hand controls; C9 near78.5/46.5Top is ONLY a seed with unknown actual clearances. Old90deg screen is historical, do not import directly. Keep actual U9=91/19mm180,C9=99.25/16mm0,R30=68.4/65.6mm90 until complete coupled13-net restoration is proven; do not add unfinished native debt. All9 regional U9 control mains and5 original targets still open, construction not promoted overaaa37. Keep RC/audio/sensor/5V copper and47IO supply pads,899nodes,52externalpads; all physical testsUNMEASURED.

实际U9=91/19mm180°，C9=99.25/16mm0°，R30=68.4/65.6mm90°，新C8=Bottom60.75/50mm0°。未连通仍9个U9控制网加原5目标，未缩减功能、未改产品RTL。继承ADDR3/M02/M03/旧复位参考缺口、触控复位最近Ground2约6.110mm例外及RC_DRIVE旧孔Ground16接触0.1474mm²偏好缺口仍开放。

恢复：construction-native-NOT-FOR-FAB.zip为本版19原生文件+本说明；C8-bottom-source-native.zip是改C8之前9d03/54/601孔；clock-clear-source-native.zip是40c/54/602孔；原aaa37包保持。所有apply均终态，不重放，不重开旧作业。当前没有活动路由任务。下一步只读construction-state.next_action和本README，旧Top八变换screen仅历史。最终屏SKU/CTP/线束机械/电源预算/84传感附件/同版制造和装配资料仍开放，自动唤醒继续。

---
历史记录（禁止当最新源或操作入口）：
# PCB当前唯一施工入口

更新 2026-10-23T13:27:54.333911+08:00。当前原生工程 C:\Users\Sakuya\Documents\LCEDA-Pro\projects\FPGA-Music-U9ControlWork-20261023。
PCB SHA256：9d03b544866a02748d0b6e19df21414a5ee23742a81723506d942844966767b0。会话：d67a7f2d-02ad-42d5-bd2b-c9b966fdce9c。

四层重铺、保存关闭重开：0间距/0物理/0网表错误，54项未连通/14网，227件601孔，899节点。仍不可投板，实物均UNMEASURED。原aaa37基线未修改、未晋升本施工副本。

本批删除已确认无负载的BUS_SCK Top终端死支路 1.253291mm 和其旧过孔：f3a6405ac4b283d9、1a1cee6c2ae8b608。该Top支路只接此同网过孔，不接任何焊盘/其他Top线；过孔的两段Inner16铜保持原坐标相接。删除前后时钟仍2个焊盘岛，全部原生未连通项逐网完全相同，不能称时钟主连接完成。未移动器件或测试点，未新增铜。

当前完整证据 control-clock-clear-native-review.json：428参考比较无新增退化，声明新增铜全宽参考/回流仍通过，PRESET0/PRESET3/47路3V3_IO及地保持，899节点/52外部接口焊盘/非铜和实际铜对账通过。clock-clear-field-review.json确认后续六邻件候选的两处原时钟铜/孔冲突已实际清除；仍未证明新布局供电/回流/完整布线或原生courtyard。

实际位置：U9=91/19mm180°、C9=99.25/16mm0°、R30=68.4/65.6mm90°。不要把离线候选当成这些器件已经改位。保留PRESET0/PRESET3，不重跑已完成作业。

Continue same U9ControlWork native9d03b544/54 connections/14nets/601vias, new session recorded in construction-state. Clock cleanup fully accepted: terminal Top stub f3a6405ac4b283d9 and obsolete via1a1cee6c2ae8b608 removed once; both Inner16 branches retained and clock pad partitions/native DRC unchanged. Never replay cleanup. PRESET0/PRESET3/PDN/HARM/touch reset preserved. Read control-clock-clear-native-review.json, clock-clear-field-review.json and rebased control-joint-layout-screen.json. Six-neighbor candidate new pads now have zero track/via conflicts; no components or testpads moved yet, no routes proven. Prepare one fully restored six-neighbor batch C8=58.75/52mm180deg,R63=66/52.75mm90deg,R64=62.25/52.75mm90deg,TP13=67.5/52,TP14=60.75/53.25,TP15=68.5/69, keeping actual U9=91/19mm180,C9=99.25/16mm0 and accepted P0/P3. First jointly prove short C8 supply/GND and new clock/pulldown/testpad links using real current copper and true old leaf classification. Preserve47 IO supply pads,clock and BUS_RETURN pad partitions, improve or preserve MOSI. Expand exact validator for declared C8/R63/R64 component and TP13/14/15 standalone TEST PAD moves before native import; preserve all other nonCu,899nodes,52externalpads and retained references/returns. Future U9=74/42mm90,C9=72/36.25mm0 only placement-screened,34 control/PDN/GND copper conflicts remain, not native/routed; do not move them until coupled restoration proven. ENC_A319mm/PRESET2detours terminal, no reruns. Preserve oldaaa37 and40c recovery packs. No RC/audio/sensor/5V copper edits or shared motherline blind deletion, no fab release/testsUNMEASURED. All9 U9 control mains and5 original targets still pending.

9个U9区域控制网仍待恢复：BUS_SCK、INPUT_LOAD_N、KEY_QH、ENC_A/B/PUSH、PRESET1/2、EDIT；原5目标BUS_MOSI、ADDR0/1/2、MUX_DISABLE仍开放。继承ADDR3/M02/M03/旧复位参考缺口未消失；低活动复位最近Ground2约6.110mm缺口例外不得扩大；RC_DRIVE孔Ground16接触0.1474mm²偏好缺口仍记录。最终屏SKU/CTP/电气/机械/线束、供电预算/84电极附件、同版制造和装配资料仍未定稿。

恢复：construction-native-NOT-FOR-FAB.zip为本次19原生文件+本README；native-package-manifest.json逐文件SHA/CRC核验。clock-clear-source-native.zip保留本次之前40c/54/602孔；control-branches-source-native.zip保留b766/58；control-source-native.zip保留adb/67；../native-touch-reset-WORK-IN-PROGRESS.zip保留aaa37。所有旧apply已终态，严禁重放。无活动路由任务，保持自动唤醒，只有PCB设计及最终硬件选型均定稿后关闭。

---
历史记录（不作为最新源/下一操作）：

## 2026-10-23T13:18:14.782062+08:00：固定布局试算终态，转联合邻近控制区域

原生源仍40c8175b…，54项/14网、227件602孔；PRESET0/PRESET3及已恢复供电保持，不是本轮新增成果。ENC_A三层与四铜层图搜索均得到约319.73mm绕行，未导入，均终态；四铜层选项没有实际使用Inner15，也没有证明更好的路线。禁止重复这些作业。

已完成 control-joint-layout-screen.json 的新布局初筛：U9=74/42mm90°、C9=72/36.25mm0°；C8=58.75/52mm180°、R63=66/52.75mm90°、R64=62.25/52.75mm90°、TP13=67.5/52、TP14=60.75/53.25、TP15=68.5/69。初始C8/U8包络、C9/RC_DRIVE、TP13及下拉电阻/5V铜冲突已通过候选位置调整消除，未动实物源。最新初筛的包络/焊盘冲突及范围外铜冲突为零；仍有36条按新器件分别统计的控制/供电/地铜冲突须恢复。这个数字不是剩余飞线，也不代表布通。

下一步唯一入口 construction-state.json.next_action：先准备C8/R63/R64及3个独立测试PAD的完整联合恢复批次，保持当前U9/C9/P0/P3，解除未来U9位置占用；新TP14/R64位置涉及BUS_SCK线f3a6405ac4b283d9和孔1a1cee6c2ae8b608，须联合恢复时钟。完整路线、实际新参考地、去耦回路、原生courtyard均尚未通过，不能直接导入八器件候选。TP13/14/15是独立PAD，验证器必须精确核对声明的PAD变换，不能忽略非铜差异。保护47供电脚、共享母线及RC/传感/音频，禁止为了开路删除共享电源主干。

所有任务终态，无路由进程；当前自有CAD会话路径/PCB UUID/哈希已复核。原生恢复包及aaa37回退包未改。浏览器读取官方屏目录尝试因本地运行时资源路径缺失失败，没有创建页面、没有核实新报价。硬件选型未定、所有实物UNMEASURED；继续自动唤醒。

2026-10-23T08:10:30.215435+08:00：本轮原位连通候选未同时满足回流/参考门，未导入；CAD仍aaa62f2、37项/6网。已转U9/C9联合布局筛选（91/19mm180°、97.75/16mm0°），零当前Top铜/孔到新焊盘冲突，短出线0.893mm间距且Ground15无全宽缺口，但13网尚未恢复，不能当投板版。唯一下入口 retained-control-recovery/u9-layout/README.md；旧局部作业终态，不重开。原37项原生包不变，自动唤醒继续。

# 当前PCB施工检查点：PRESET3按钮/上拉支路接通

2026-10-23T07:03:27.633525+08:00

原生工程：`C:\Users\Sakuya\Documents\LCEDA-Pro\projects\FPGA-Music-Dualscreen-Addr3Work-20261022`；PCB SHA256 `aaa62f2192f0779e8e69e94432d5eb0daee9dab01339829d435f060e789c6c7e`；会话 `50c7434a-3f4d-4707-8544-b1fd2a8ce3a8`。四层重铺、保存关闭重开严格DRC：**0间距、0物理、0网表错误；37项未连通（6网）**。227件（215SMT/12TH），609过孔。未投板放行。

本批以10条6mil线、2个信号孔将SW5.1/SW5.2/R56.2接成一个实际铜网络区域；PRESET3从4个焊盘孤岛降为2个，U9.5仍隔离，不能称整网完成。新增Ground孔109.8/30.7mm为换层提供实际Ground15/2回流，最近距离约1.079/1.049mm。原生重铺后发现EDIT Bottom参考Ground16损失0.679mm，已以123.35/30.4mm实际Ground孔恢复，未降低规则。

当前三基线f09/7ffb/6a参考比较共1287项，无新增退化；新增线中心及全线宽投影检查通过。38项接口比较无退化，899节点与原理图一致，实际铜与预期偏差0.00e+00mm。PCB元件/属性/网表/原理图/板框/层数/BOM除既有授权变更外完全保留；本批不改器件位置，R30仍68.4/65.6mm、90°，旧R30 CPL坐标仍失效。

保留单J10右手泛音构造触控屏、84路传感、Nano20K、140×100mm四铜层；J11音乐可视化屏已取消；产品RTL未改。HARM_CS_N及触控复位保持闭合。继承ADDR3、M02/M03及复位旧段参考缺口开放；低活动触控复位Inner16用Ground15，最近Ground2缺口约6.110mm，例外不用于时钟/数据。RC_DRIVE孔Ground16接触约0.1474mm²，低于项目0.15偏好，仍开放。上电、触控/显示、84路传感、音频/SNR/SI全部UNMEASURED。

剩余BUS_MOSI7、ADDR0/1/2各7、MUX_DISABLE7、PRESET3 2。最终屏SKU/CTP/线束、负载/机械、最终固件、同版制造/采购资料仍未闭合。自动唤醒pcb继续，仅PCB与最终硬件选型两项均落定后关闭。

唯一接续：`next-entry.json` → `mosi-closure/NEXT.md`。原生恢复包：`native-touch-reset-WORK-IN-PROGRESS.zip`；前一6a/39恢复包在`mosi-closure/source-native.zip`。全部旧作业终态，不重开或重放apply。

---

2026-10-23T03:14:35.579284+08:00 实际原生6a1363c7…HARM_CS_N完整闭合；R30移至68.4/65.6mm、90°并恢复供电，外部针脚及BOM227不变。四层重铺保存重开0间距/0物理/0网表/39未连通（6网），605孔。原新增复位/PRESET退化及I2C_SDA邻近退化均修复；854项双基线比较无新增退化，38接口比较通过，899节点一致。继承参考缺口及触控复位最近Ground2例外仍开放，实物全未测、未投板。下一步BUS_MOSI主干与R64/TP14联合布局，不重跑旧固定端点。唯一入口REGIONAL-WORK-IN-PROGRESS.json/retained-control-recovery/next-entry.json；自动唤醒继续。

2026-10-23T02:48:35.998541+08:00 实际原生7ffb8f92…已联合修复DISP_RESET_N/PRESET1及过程中TP_RESET_N/3V3_IO参考退化；426项实际比较无新增退化，37接口比较无退化。保存重开0间距/0物理/0网表/42未连通（7网），227件602孔。触控复位完整、实际Ground15投影缺口0，最近Ground2仍6.110mm及继承缺口开放，实物全未测。HARM_CS_N固定R30端点搜索终态受阻，下一步联合R30布局及供电支路。当前唯一入口REGIONAL-WORK-IN-PROGRESS.json；未放行投板，自动唤醒继续。

2026-10-23T02:24:53.565562+08:00 实际原生候选8e3d2a1f…：触控复位完整连通，四层重铺保存重开0间距/0物理/0网表/42未连通（7网），227件600孔。新增参考退化3项中RC_DRIVE浮岛已用真实三层地孔恢复，仍有DISP_RESET_N/PRESET1 Bottom两项退化待修，候选未通过参考地门；不是投板版。唯一入口REGIONAL-WORK-IN-PROGRESS.json与retained-control-recovery/README。f09/44的完整恢复ZIP保留，所有作业终态。

2026-10-23T01:37:26.990461+08:00 清理取消J11的SPI死支路11线/2孔共69.055mm；保留MOSI/SCK完整且无孤立铜，全部当前线参考地无新增退化。原生四层重建保存重开严格DRC仍0间距/0物理/0网表/44未连通（8网），227件590孔。当前源f09bf462…，唯一入口REGIONAL-WORK-IN-PROGRESS.json/retained-control-recovery。下一步TP_RESET_MOD_N等8网联合出线。未投板、实物未测。

2026-10-23T00:43:36.415053+08:00 实质进展：保留触控屏DISP_RESET_N完整闭合，U15改用6→14通道；U8.6/J10.7及52个外部接口焊盘不变，BOM227和布局不变。MOS参考退化已修复，36项接口及传感/音频无新增退化，新增铜投影缺口0；地网原生无断点。R30/R32/R33/R34层级标签修正后网表错误归零。当前原生源171a17cb…已保存重开0间距/0物理/44未连通（8网），当前唯一入口REGIONAL-WORK-IN-PROGRESS.json及retained-control-recovery/README.md。原30eb/46、db55中间参考退化及3c781中间元数据版均非当前入口；所有任务终态，不可重放旧脚本。继承参考缺口、制造/机械/屏SKU/最终固件与实物未测仍开放，未放行投板。

2026-10-22T23:15:26.272136+08:00 当前用户范围已落实：删除J11/R31/R65及视觉专用网，保留J10泛音触控屏、84路传感和Nano20K。当前施工源已切为单触控WIP SHA30eb6988…，保存重开0间距/0物理/46项未连通（9网），另有1项原生Netlist Error阻断；899有效节点独立一致不替代原生通过。6条敏感参考退化均已修复，保留触控链33项比较无新增退化，新线参考缺口仍开放。唯一入口REGIONAL-WORK-IN-PROGRESS.json及single-touch-scope/README.md，原650…/57双屏源仅供恢复。当前无运行作业，禁止重放事务。制造未放行、实物未测。

2026-10-22T22:49:28.549423+08:00 用户范围更新：取消J11/MSP2401实体可视化屏，保留J10右手泛音触控屏、84路传感及Nano20K。历史“保持双屏”和可视化专用BOM约束已被本次人类指令覆盖。现有已验证源650…/57项保留；独立候选79b…/50项的六条敏感参考退化均已修复，新线参考缺口仍开放。下一步从REGIONAL-WORK-IN-PROGRESS.json.pending_trial.single_touch_scope接续，先核对运行状态，禁止重复导入。制造未放行，实物未测。

2026-10-22T18:56:29.950114+08:00：参考地局部修复已保存重开，原生仍0/0/50；已修复原6条敏感线退化中的4条（L0_E08/L2_E05/RC4/L0_M07），余L2_M00/M01需联合8mil邻近短线与回流孔调整。当前候选SHAaabad01a…，新线参考缺口及50项未连通仍开放，未提升为已验证施工源，原SHA650…57项源未改。当前唯一入口REGIONAL-WORK-IN-PROGRESS.json.pending_trial及address3-local-recovery/reference-local-repair/README.md。所有作业终态；实物未测、禁止投板。

2026-10-22T18:04:28.498907+08:00：独立 ADDR3 原生候选已保存重开，严格 DRC 0/0/50（11网），ADDR3完整闭合，四条传感网均恢复（M04/M14原铜、M02/M03保持8mil）。17个新增地孔实铜接触通过。参考复核仍有6条Top敏感线退化及3处新线参考投影缺口；候选未提升，已验证施工源仍为SHA650…的0/0/57。唯一接续入口REGIONAL-WORK-IN-PROGRESS.json.pending_trial及address3-local-recovery/README.md；原生恢复包明确REFERENCE-REPAIR-PENDING。实物未测、禁止投板。

2026-10-22T12:25:15.665580+08:00 更新：INV2完整闭合，联合恢复局部3V3_PERIPH/VIS_DC并新增1个真实地缝合孔；保存重开严格DRC为0/0/57（12网）。实际铜/声明变更对账、115个敏感/音频网参考地无退化、原63及R15哈希核对通过。可恢复原生包及逐项证据见u8-power-corridor-20261022/inv2-coupled/README.md。唯一当前入口REGIONAL-WORK-IN-PROGRESS.json；8b9旧地址候选不可重放。制造未放行、实物未测。

2026-10-22 04:55 离线续作：原生源SHA8b9b68a5…未变，仍为已保存重开验证的0/0/59。地址/禁用35个目标中27个形成通过四层铜/孔/焊盘/敏感区几何检查的候选出线；尚有8个出口，未形成完整新网、未导入。ADDR0剩U2.10，其内侧出口受底层L1_M07/L1_M06实铜及敏感保护堵塞，首轮局部模拟线恢复在原紧密端点失败。唯一下一入口u8-power-corridor-20261022/address-next-checkpoint.json；后续须联合恢复受影响传感铜及真实参考地。MOSI/R64单独换位不足，不能重复；全板fanout因处理未选中3V3_IO而按范围保护中止，任务均已终止。21个探针网络复核并修正TP13/TP14旧坐标，实物仍未测。

2026-10-22 04:22 更新：U8供电/出线联合调整后 BUS_SCK 完整闭合，INPUT_LOAD_N恢复；10个新地孔连接真实参考地并关闭C8/R63.2地岛。保存重开原生DRC为0间距/0物理/59未连通（13网）。唯一入口 REGIONAL-WORK-IN-PROGRESS.json 已切到 U8BusWork 原生工程；原63项和R15保留。成果见 u8-power-corridor-20261022/README.md。R64已核实为BUS_MOSI到GND的下拉支路，下一步移动其位置/出线并恢复GND；不得重跑相同固定布局搜索。

2026-10-22 BUS_RETURN 已补缺失换层孔及邻近 GND 孔，保存重开后原生 DRC：0 间距 / 0 物理 / 63 未连通（14 网）；实际交付及最新源哈希见 bus-return-repair-20261022/checkpoint-review.json。R24 未闭合完整网络，未导入。夜间本对话续跑 automation id=pcb，每30分钟唤醒；额度耗尽不能绕过，保留断点接续。

# 最新施工接续 · 2026-10-21T23:28:33+08:00 · 当前账户Sakuya

当前施工以 **REGIONAL-WORK-IN-PROGRESS.json → R21原生工程（吸收R22/R23已验证结果）** 为入口。保存重开完整原生DRC为 **0间距／0物理／65未连通，15网**；接手R19施工状态为84项。新增关闭VIS_CS_N、VIS_BL_EN、DISP_MOSI、TP_RESET_N、3V3_IO和3V3_PERIPH；两处新增地网断点已补专用短线与过孔并复查关闭。详见regional-recovery-20261021-r21/README.md、checkpoint-review.json。

**稳定布线基线仍为R15的0/0/58，未晋升施工副本；制造未放行。** R15、R19原源保留。当前原生会话属于Sakuya账户，跨账户必须重新打开保存工程，不能沿用会话句柄。只用R21/native_project.py；源PCB SHA `5cd300aa8ebe4402c98b4d9d6336ab4d0df981354eaa93534e1d34b08c6dbb79`。R22/R23旧DSN/SES/计划已过期，禁止重放。没有在本聊天建立或修改自动化，不把历史goal/自动化状态当作当前运行证据。

下一步从新几何联合安排U8地址/禁用与BUS时钟/数据出口，继续恢复6条区域控制信号；保留回流、传感、工厂、机械、采购、同版CPL与最终固件开放项。当前采购CPL须核对U15/C35/R30/R31/R63/R64六器件坐标；TP13/TP14测试焊盘在PCB及测试资料中核对。下方R19及更早入口为历史。

---

> ???????**REGIONAL-WORK-IN-PROGRESS.json ? regional-layout-20261021-r19**????????????/????/?????????U15???6??+2?????????????????0??/0??/93???????????????????R15/0-0-58??????????????????goal API?????active?R17/R18???????????????????????????????????????????????

> 最新离线比较：**R16未采用，ACTIVE仍R15**。inv2-comparison-20261021-r16/README.md 与 CURRENT-RESULTS.json：从R15重新生成DSN，8轮有界结束但INV2无新铜；连续几何确认两端顶层自由区不同。R13为SENSE_2串联220Ω，不能套用R30供电上拉移动方案。原生19SHA未变，不重复相同DSN/无变化DRC。当前仍0/0/58、11网、530孔；下一步联合端点出线/合法换层及参考地，不将路由失败写成物理无解。下方R15为最新有效原生检查点。

> 最新工作版：**R15**，harm-closure-20261021-r15/README.md、native-candidate-checkpoint.json。HARM整网已闭合，完整原生保存重开DRC **0间距/0物理/58未连通，11网，530孔**。PCB SHA `5029ca7091053a207a08908edfbe4b2716058640fa654b720c08c2bc0333cacb`。只用R15/native_project.py，会话 `5f9103d1-1d21-447c-aca2-50e7aefa6a13`；不要用旧wrapper修改R3/R7。5信号孔+5参考地缝合孔，R30移动但3V3_IO原铜精确不变；原R7全部19文件未变。C35/R30历史CPL失效，制造未放行。原生包/回流空缺/下一步见R15 README。下文R7/R12/R13及旧goal状态均为历史。
>
> 接续：从R15源重新规划剩余11网，不重放R7 DSN。HARM仍有参考地空缺，音频原缺口未变，保留SI/传感/工厂/机械/报价/最终固件开放项。R5旧会话已正常关闭，R3/R7源保留。automation-2配置仍ACTIVE；goal接口最新返回paused而人类本次已明确继续，无resume接口可调用，不改配额/不标完成。防休眠helper未运行。

> 最新复核：topology-graph-20261021-r12/README.md 与 CURRENT-RESULTS.json。R12/R13试算均因绕行否决；已定位顶层3V3_IO分隔，48电源焊盘联合桥接几何连通但无整体收益，未写原生。ACTIVE仍R7，19SHA未变、0/0/62、520孔。下一步用现有Freerouting2.5.0做经过DSN坐标/层/孔校准的有界对照，禁止重复仅按过孔数的区域树或重放旧DSN；保留全部保护区与制造未放行状态。

> 技能已安装：skill-installation-20261021.json。当前用户技能目录C:/Users/huangyongtao/.codex/skills，新增pcb-routing-knowledge、schematic-design、review-schematic-and-layout、select-components-and-bom；原easyeda-api/lcsc已复制注册。下轮读取相关SKILL.md后用于复核，依旧以当前原生工程/主项目实验为准；社区工具通过安装试运行不代表PCB通过。

> 最新接续：routing-topology-20261021-r10/CURRENT-RESULTS.json。goal已恢复active；R10确认跨区域落孔导致绕行，R11四层单内层连通区尝试因U15.8无安全出线失败（非物理无解）。下一步建立顶层/内16区域及合法过孔连接图。ACTIVE仍R7，19文件SHA未变，无新原生修改。已找到并读取用户目录easyeda-api与lcsc技能，后续结合现有CLI和原厂验证使用，不新装桥接、不改权限。

> 最新离线检查点：`six-layer-comparison-20261021-r9/README.md`。R8/R9绕行方案未采纳，未创建六层原生工程；ACTIVE仍R7，19源文件哈希未变，最后原生0/0/62。下一步先诊断连续自由空间与局部电源/地支路阻挡，不要盲目加层。目标当前返回usageLimited，等待正常恢复；不标完成、不改配额。

> 当前R7优先：local-layout-20261021-r7/README.md 和LATEST顶部；ACTIVE已更新2cec5192…，0/0/62、520孔。用r7/native_project.py会话b6e9a4d0…，R4/R6旧CLI会话已正常关闭。C35历史CPL行失效。

# 自主接续入口 · 2026-10-21

> r6音频比较已否决：27→10孔虽DRC0/0/62，但真实邻近参考地覆盖不足，未晋升；ACTIVE仍r5。下一步和失败边界见LATEST顶部/audio-routing-20261021-r6/README.md。

> 最新r5工作源：ACTIVE-ROUTING-CANDIDATE.json；四铜层三介质物理结构已实际核验，0/0/62。仅用stackup-validation-20261021-r5/native_project.py操作新会话09c0fd69…；r4和r3保持原哈希。下面旧r4“叠层缺失”是历史，具体新证据和下一步优先看LATEST顶部/r5 README。

> 最新工作分支优先读取 ACTIVE-ROUTING-CANDIDATE.json：r4 独立逻辑四铜层原生候选，0间距/0物理/62未连通，物理叠层尚不完整。原双层r3/74项由CURRENT-STATE.json保留为采购/制造基线。新分支仅用 joint-routing-20261021-r4/candidate_native.py 的新项目和新会话继续；具体下一步见LATEST.md顶部与r4 README。

用户已授权长任务：争取明确/决定完整硬件清单，推进到可下单、组装、调试的准备阶段，并使用自动唤醒接续。不是仅做状态汇报。自主完成普通可逆工作；不实际付款/下单、不发供应商消息、不下载未验证固件、不削减功能。

## 唤醒与环境

- 本线程 heartbeat：`automation-2`，名称“双屏乐器硬件收口与采购准备”，ACTIVE，每小时一次。不能绕过额度；正常恢复后接续。不能因此保证关机/休眠时仍运行。
- 之前8小时防休眠helper PID11444已于UTC04:14正常结束；重新加载.ps1被本机ExecutionPolicy拒绝，未改/绕过策略，新进程未启动。automation-2仍ACTIVE但不保证休眠时唤醒。见task-runtime-20261021/keep-awake-restart-failure.json。不要把历史active状态当仍运行，不重复同一被拒绝调用。
- 当前goal已在系统接续时恢复，06:03 get_goal实际返回active。上轮05:46的blocked是历史状态；本轮有实际PCB修改/原生DRC进展，不能算作连续无进展阻塞。不得自行提前complete/blocked。
- 工作副本 `C:/Users/Sakuya/.codex/worktrees/06df/FPGA-Music-project`；主项目 `C:/Users/Sakuya/FPGA-Music-project`。
- 本副本 Git HEAD 是旧 `fe326ad...`，主项目 main `2770e637...`（38–86号记录已提交）；新硬件/实验不少未提交。不能拿副本旧根 src 替代最新产品来源。
- 原生工程 `C:/Users/Sakuya/Documents/LCEDA-Pro/projects/FPGA-Music-Dualscreen-Review-20261019`。
- 交付目录 `D:/FPGA-Project/codex-deliverables/dual-screen-review-20261020-v2`。
- Python 用 `D:/anaconda/python.exe`；PowerShell 管道中文需 `$OutputEncoding=[System.Text.UTF8Encoding]::new($false)` 和 `PYTHONIOENCODING=utf-8`，Python 文本显式 UTF-8。
- Git 加 `-c safe.directory=C:/Users/Sakuya/.codex/worktrees/06df/FPGA-Music-project`。不得输出账户凭据。
- 不主动创建子代理；用户未请求多代理。

## 当前真实检查点

先读 `CURRENT-STATE.json`、`LATEST.md`、`release-open-items.csv`。当前local-power-bus-r3 PCB SHA256：`0e96a38677afbe5af945c3ea02ea6915b26064fdeab45619d10ad11285cedd3a`。
230器件、3262段API线+28段真实原生微短线、533孔、1079焊盘、两面重建地铜。完整原生DRC保存重开后为0间距/0物理错误、74未连通对象、16网，5V_PERIPH已全部连通。I²S三线仍9/8/10孔。源清单 `route-checkpoint-0clear-74open-local-power-bus-r3-20261021.json`；捕获 `joint-routing-20261021-r3/verified-source-74.json`。旧quality-r1的be576哈希和78项方案仅供历史追溯，不能重放。
原生包和整理前快照均已保存并验哈希。后续规划必须从当前捕获开始，不重放旧方案。

已完成局部 ngspice：16 I²C+32电源工况，独立校准和步长检查，见 `spice-validation-20261021/README.md`。TPS2553原厂PSpice原库不兼容，保留原库，在独立副本仅适配一个XNOR表达式。不是完整电源链/工艺热角落/实物验证。
25/26物理位置均可由84接口容纳，采购按完整84能力保留，不能让尚未定的MIDI起止音阻断通用电子件准备。
尺寸草案：整机470×220mm来自10/15空间提案，当前PCB140×100mm仍暂定，未机械配准。`dimensions-review-20261021` 是核对重绘，不是新定稿机械图。图文见 `notes/2026-10-21-尺寸图与未决项说明.md`。

## 本轮推进顺序（进行中）

1. 建立当前原生硬件与最新86号冻结实验的接口/节点分配追溯，区分已有真实驱动与结构探针；发现问题先证据化，不能用旧16路pad测试签84路。
2. 形成完整采购主清单：36类板上件/230位号，以及Nano/喇叭已有项、两屏确切选配、线束公母/端子、AUX、电源、microSD、电极材料、固定/外壳和制造装配。每项写用量/购买量/备件/来源/核对状态及前置条件，不能把旧库存/美元价当实时人民币到手价。
3. 优先关闭能查资料决定的屏幕SKU、线束/配对和PCB机械器件；保留真实测量才可关闭的电源、模拟和人体交互问题。采购通用/可复用模块与定制PCB分别标明就绪条件，不能把它们全部冻结成假最终版。
4. 继续当前PCB的联合出线/回流整理与17网闭合。先备份、绑定哈希、几何审查，再应用原生；规则不放宽。每次应用后地铜重建、保存重开和完整原生DRC。
5. 从同版设计形成最终Gerber/钻孔/BOM/CPL与检查材料、工厂/手焊范围、逐模块组装调试流程和最小待用户补充信息。严格区分材料准备与可制造放行。

## 停止条件与恢复记录

### 已完成的自主阶段 r1

- `hardware-contract-20261021-r1/check_contract.py` 已真实执行6组数字测试：3个原版本负对照按预期失败、3个候选正对照通过。发现并隔离修复两个硬件接口问题：86号扫描595字的高两位00会把本板LCD/TP复位拉低；86号示例NODE_MAP顺序0..77不符合本板lane-major电极布局与存储address-major编号。候选增加运行时复位输入，生成25/26实际焊盘映射；完整串行595测试32行/128字，含授权等待、背压、复位状态切换、超时。尚未接入最终产品、未跑联合PnR，不是可下载固件。原PCB和5个冻结86源文件未改。
- `purchase-preparation-20261021-r1/refresh_catalog.py` 已从公开LCSC接口重新读取36类物料，完整原始响应和时间戳见catalog与fresh-catalog.json，33个MPN文本一致，3个连接器是既知本地化名称差异。**C318884按钮散买库存本轮为0，C50984仅5，PCM5122为52**；不拿旧网页缓存库存冒充本次结果。minimum必须取minBuyNumber，minPacketNumber是整包数量，已在脚本纠正。
- 小屏厂家页已核实MSP2401无触摸、3.3V IO、VCC3.3–5V及1..9脚功能，足以生成明确的载板J11到模块脚序表。原接口表的NOT_ASSIGNED尚未更新，下一步补。
- 大屏官网英文/中文页面和V4PDF直读仍403；官方中文搜索索引有FT5316、5V300mA最大和273.22元基础价线索，但不是含CTP/线束/税运总价或完整PDF核验。H01不能写关闭。
- 已读JST官方XH目录确认应匹配XHP-2及SXH-001T-P0.6系列，下一步选适配线径和成品压接线，避免漏壳体/端子。JLC国际官网明确PCBA原型最低2板；国内平台具体政策/报价仍需实际匹配。
- Spreadsheet skill已读取，运行时依赖当前可用：`C:/Users/huangyongtao/.cache/codex-runtimes/codex-primary-runtime/dependencies/node/bin/node.exe` 及其 `node/node_modules`。工作簿已用artifact-tool完成，见下文采购阶段记录。

### 采购阶段 r1 已完成

- 统一数据`purchase-preparation-20261021-r1/purchase-master.json`、全范围MD及4页Excel已生成；Excel在该目录outputs/本线程ID/硬件采购准备-r1.xlsx。**artifact create marker已成功执行一次，后续修改同文件不要再当首次创建重复标记。**
- 36类/230位号、32行外部范围已覆盖；每板装配分工调整为**217 SMT（含5个按钮）、13通孔**，没有改电路。国内公开商品页精确身份核验显示C318884散买0但smtStockNumber273109，因此选择工厂供料，不换封装。平台最终匹配和新增上料费仍待确认。国内对两个连接器的严格MPN文本比较失败已保留，不能把它当无货结论。
- 数量为1套整机，暂按2块SMT板（第二块备份）、1块补焊接口板、5块裸板询价；这是可修改的报价假设，未订购第二套屏幕，未提交订单。
- 八线MSP2401接线表已完成；217工厂供料项散买0，13通孔按MOQ/销售倍数上取整。4页均渲染检查，贴装数量和缺货状态重算测试、导出XLSX缓存逐行独立核验、3个筛选表及原生19文件未改检查通过，见final-verification.json。
- 下一步：先从当前原生PCB导出新的真实CPL，与217位号BOM核对；然后继续主板布局/剩余网络、连接器配合、大屏资料与报价问题。不要在DRC仍78未连通时误标制造放行。

### 原生导出权限与制造坐标核对

- Fresh `session list` 成功：a76fe16e-e9d6-4ef9-8423-778d735010aa alive/headless，指向正确原生工程。但 `autonomous-r1-current-cpl` 返回 **“未启用扩展和独立脚本的外部交互权限”**，原始拒绝在evidence目录。当前本轮第1次遇到此阻碍；未改应用权限，未绕过，不要再盲目重放同一失败调用。
- `reconcile_assembly_files.py` 已核对历史真实原生230行CPL与当前磁盘230组件：坐标原点最大舍入差0.00049924mm，旋转/层/封装全一致；得到30类217位号BOM和217行历史CPL筛选件，位号集合完全相等，见placement-reconciliation.json。不是本轮新原生导出，不可下单。
- 若原生权限未恢复，仍继续可独立完成的屏幕、配套线材/连接器、离线几何、模拟/接口和采购报价工作。只有同样阻碍连续3个goal turn且确无独立工作可推进才依规则标blocked；不能现在提前blocked，也不要求用户在睡觉时回复。

每个有效阶段在这里更新实际结果、证据、下一步和未解决原因。额度不足时保留检查点，后续唤醒继续；不使用账户限额重置权益。
用户在睡觉，不以缺可选偏好反复问。缺真实Nano版号/模块实测等信息时，继续其他能独立完成的工作，最后集中给出必要项。
完成目标后停用 automation-2；不要在仍有必需工作时标 goal complete。

### 05:45 heartbeat接续 · r2 实质进展

- 原厂XFCN/JST图纸取得，原PDF/UTC/SHA与渲染见`connector-qualification-20261021-r2`。J20–J25的16针2.54mm/Ø1.02mm，以及J13的2.5mm/两针Ø1.0mm均与当前嵌入原生封装一致。用原生封装中心而非0.1mil舍入API显示坐标；7组件全部标称尺寸匹配，仍未签成品孔公差/体积/插头/线束。
- 电源线端收敛为XHP-2+**SXH-001T-P0.6普通型**+AWG22，绝缘外径0.9–1.9mm；不自动替换低插入力N或002细线型。采购JSON、可读总表和Excel已更新。成品线供方/长度/适配器端仍待核。
- ALPS公开产品页确认Standard、20mm/6mm平轴、30定位15脉冲带按压；Discontinued是分类图例，不能误判停产。旋钮帽实际孔深/行程、通用封装/槽孔仍待核。三种BOOMELE图直读403，不重放；32GB存储卡候选尚无当前国内在售证据/到手价，不假定可买。
- 新执行入口 **`装配与分阶段验收-r2.md`**：217 SMT+13通孔，13通孔逐位号、线束、四种供电状态、双屏/共享总线/I2C/音频/电极小样/84扩展/整机并发均有阶段退出证据。明确EN直连Nano轨、FAULT仅TP8、小屏背光随轨使能、595上电状态与冷启动边界；没有发明额外GPIO/PWM或把独立候选当最终码流。
- `bringup-acceptance-20261021-r2/prepare_acceptance.py`核对21测试点网络/精确坐标、165接口脚网络、关键控制连接和230/217/13装配数。生成22阶段、四电源状态32测量槽和165脚模板，**全为pending/null，未实测**。每份记录必须填实物身份/限值/原始证据；不覆盖未来runs。
- `prepare_handover.py`的旧开放项仅作首次种子，改为保留已维护的release-open-items.csv，避免重建线束时把后续证据覆盖回旧状态；复验记录见本轮交付检查点。
- 根`harness-contract.csv`实际已含小屏错位映射，早先“NOT_ASSIGNED尚未更新”已过时；本轮165脚核对通过。
- 全部19原生文件仍与quality-r1相同。未重复原生权限拒绝、未重跑DRC、未改PCB/产品RTL、未下载或下单；仍78未连通、制造放行false。
- 下一步：有正常EDA外部交互权限恢复证据后，做联合中部出线/电源/I²S回流及同版原生导出；同时继续三种BOOMELE机械图/线端、确切大屏出货版、国内模块来源/整价。本轮未要求用户立刻醒来回复。

### 06:03 goal接续 · r3 已落盘原生进展

- 23网整网联合试布原始版全拒绝；SOIC出线预留范围修正到0.65mm后有2个候选，但恢复保留铜线后的联合几何仍失败，均未应用。不是原生DRC通过。
- 原生默认脚本的getCurrentDocument/getAll正常。doctor/functions仅作只读诊断，没有换到已授权Common扩展身份。此前带sys_FileSystem的CPL调用权限拒绝不能推断所有原生操作不可用；本轮正常原生create/delete/save/rebuild/reopen/check均已执行成功。
- 实际应用仅局部供电/BUS_RETURN/GND方案：删两段BUS局部线、三段冗余U13细连接，加入22段规划线、4孔（2电源/1信号/1地）。完整原生DRC从78降至74、5V网退出错误表；16个控制/显示网仍待布。1mm主干、0.8mmTPS出线、0.5mm独立DAC支路。电源负载/热/压降未签实测通过。
- 地缝合孔距新BUS过孔0.85mm；真实重建地铜的两面接触面积已核对（visual-local-power-bus-r3-20261021/plane-contact-audit.json），不能把这扩大为完整I²S回流签核。
- 应用后初始校验因“旧线段ID必须全部保留”过严而停止；编辑器实际自动拆分了3根相交电源线。native-geometry-reconciliation及final-verification已用原生铜形状证明完全符合方案、无非计划变化。其他17原生文件不变；eprj3只改PCB version/updateTime两项保存元数据。不要把这个中间断言当成未落盘或盲目重跑applier。
- 细线API在重开后过滤额外4段微短线，所以最新API3262+原生28=3290；不是丢线。规划必须包含全部28段真实铜线。原始API应用后3266是历史暂态捕获。
- 已保存修改前独立快照、74项原生ZIP、19文件SHA/CRC和源稳定DRC。CURRENT-STATE.json为采购/制造/台架生成器唯一最新入口。工作副本旧src仍不是最新产品固件。
- 继续优先处理中部/地址总线/I²S联合布局与16网；外部文件导出权限、确切大屏、价格/机械和实物问题继续保留，不因元件数一致就假制造放行。

### r4 接续中 · 2026-10-21 09:25

当前原生仍为 r3 / 74 项 / PCB SHA 0e96a38677afbe5af945c3ea02ea6915b26064fdeab45619d10ad11285cedd3a，未写入任何 r4 布线。`joint-routing-20261021-r4/progress.json` 保存本轮各失败边界：全 U15 + SCAN_LATCH 联合试布恢复原铜后冲突；connected-first 最后只留下与原线完全相同的 TP_RESET_N，均未应用。局部 IO/GND/电源交换本身几何通过，但完整显示时钟仍被外围封住，不能只应用孤立换层点当进展。`local-v3` 保留源绑定的假设局部交换。

已核查双层只是采购/报价暂定工艺，没有找到用户硬性锁定层数。现运行独立 `plan_four_layer.py`，输出 `four-layer-offline`，L2 全地、L3 控制线 + 剩余地，评估能否消除旧控制绕行；未创建或改动四层原生工程。必须补查连续几何、真实四层连通、保留失败网的铜线、L3 对底层 I²S/模拟回流影响、真实叠层及原生 DRC 后，才能决定该候选是否值得推进；不能把它当成已选工艺或制造放行。当前运行会话30771，仅此规划进程；不要重复启动同目录。

### r4 实质进展已归档 · 2026-10-21 09:55

优先读 `ACTIVE-ROUTING-CANDIDATE.json` 和 `joint-routing-20261021-r4/README.md`。独立原生候选已实际应用14网并重建4地铜、保存重开，完整原生DRC=0间距/0物理/62未连通，230件/1079pad/3264API+28微线/519孔。原双层r3全部19文件未动，CURRENT-STATE/采购基线仍为r3/74。四层新工程session ae301abb-a496-44e3-bb39-1706da348b0f，专用candidate_native.py；旧native_review默认指向双层，勿误调用。原生ZIP/源哈希/回滚快照/42个逐网逐层铜形核对均已保存。

不要重复运行prepare/apply/finalize/create-inner-ground，均已有结果且有重放保护。当前无持续路由进程。实际失败边界和下一步见r4 README：特别是逻辑4铜层API没补物理LAYER_PHYS（仍原两铜层/单介质），命名叠层API空，格式文档厚度单位与继承数据外观冲突；必须核实，不猜单位写入。回流几何定位为真实地铜，84地孔接触两个内层，但I²S排除自身信号孔1mm及信号通孔焊盘外扩0.5mm后的地覆盖约97.6/92.8/91.7%，不是SI合格。新平面传感Cp也未验证。后续先叠层/回流/C35去耦及余12网，多层过孔障碍必须包含四层。

### r5结构已修复，r6离线音频推进中

物理字段单位通过安装包decoder/UI双向代码确认：raw mil；CLI格式注释不适用该版本。叠层API是stub，不再重复调用。r5候选源d21fb554…，ZIP e9659c25…；四铜层三介质按JLC公开7628/1.6mm名义表建模并原生保存重开，DRC仍0/0/62。其余所有平面记录及API捕获与r4相同。损耗、工厂确认、传感Cp、SI未签核。第一次EOF写入失败在打开前拦截，只重建未打开副本，失败源保留。

r6阶段尚未应用任何铜线：top-only全局连通分区实际相连，旧A*有限窗口和1.5M上限不能证明无解；全局MCP顶层路径能找到但已试顺序绕行长度超预算。参考地预测过于保守/参考空洞栅格需正确保留洞（v1有填洞错误已拒绝，v2修正）；physical-diagnostic长度/过孔结果只作诊断，不得应用。接着用全局多层最短路或有依据的联合局部重布，同时验证真实地铜，不再盲目重复旧A*。当前无原生修改进行中；异步离线进程须按工具session核对终态。

### 12:20接续检查点 · r5结构闭合、r6回流筛查否决

r5四铜层三介质物理结构已核验并交付（0间距/0物理/62未连通、519孔）。**ACTIVE-ROUTING-CANDIDATE.json 仍是r5，采购基线仍r3。** r6隔离比较虽把音频27孔降到10孔并通过完整原生DRC，但真实邻近参考地覆盖不足，已明确否决，未晋升。详见 audio-routing-20261021-r6/README.md 与 actual-return/audio-reference-comparison.png；不要应用/重放失败试布，也不要把r6的502孔写成当前工作版。

下一次先构造音频铜移除后的最大真实地参考并约束回流，再进行一次联合试布；同时12网出线/C35去耦仍可独立推进。实际工厂叠层/传感寄生/大屏出货版/机械尺寸和产品固件整合仍未关闭。制造放行false，未购买/下单/联系供方/下载固件。

临时防休眠进程已按8小时期限正常结束。重新加载helper被本机PowerShell脚本执行策略拒绝，未改/绕过策略；automation-2仍配置ACTIVE，但不能保证电脑休眠/关机时唤醒。失败与恢复边界在task-runtime-20261021/keep-awake-restart-failure.json。

### 13:40 r7接续 · 本轮真实进展

ACTIVE-ROUTING-CANDIDATE.json 现指向 local-layout-20261021-r7，专用native_project.py，会话b6e9a4d0…。PCB SHA **2cec51920011e0e8512956064d1c3b396bc4b98b98a94989432e883b30029eae**。只移动C35及局部去耦铜，VCC支路10.11→2.38mm、地短线0.9mm/新接地孔接入两个内层地铜；其他229器件和音频铜不变。保存重开完整原生DRC **0间距/0物理/62未连接，520孔**。前两处因器件外形间距被否决；只认最终270°/77.7、45.3mm位置。原生源、图及全部失败边界见r7 README/final-layout-review.json。

下一步优先联合布通HARM_CS_N、ADDR1、ADDR3、PRESET3、DISP_SCK，使用current-escape-regions.json真实连续出线区。当前U15.18可放孔局部区域已由0.11146扩大至3.89179mm²，但还未布通，不计作闭合网络。余12网、音频回流、传感寄生、工厂工艺等仍未关闭，制造放行false。

采购仍以保留R3基线记录数量/物料；实际继续PCB工作认R7。C35改位使历史CPL该行失效，不能用于R7制造下单。R4/R6本线程旧后台会话因内存清理已正常关闭，源哈希未变；日常不要调用旧wrapper。R5保留，R6回流否决仍有效。防休眠helper仍未重启，不重复脚本执行策略拒绝。

2026-10-23T08:40:28.623044+08:00：U9/C9区域独立施工副本已实际改位（91/19mm180°、99.25/16mm0°），恢复全部3V3_IO/地并完整闭合PRESET3；新增I2S_BCK参考退化经移动新信号孔修复。最新原生adb46cc1…四层重铺保存重开0间距/0物理/0网表，67未连通/15网、578孔；411项当前几何比较无新增退化，899节点/外部焊盘不变。67包含拆线后10个待恢复控制网，临时副本不晋升，原aaa37验证包未改。唯一入口u9-layout/README.md及construction-state.json；无运行任务，禁止重放终态apply，自动续跑继续，实物UNMEASURED。

2026-10-23T12:22:39.013317+08:00：真实最新施工b766/58项15网/597孔，远端控制支路恢复，426比较无新增退化，899节点和其他非铜对账。旧入口adb67数字已统一纠正。10条U9主连接仍开放；固定单目标PRESET2两/三层试算终态未导入，现转整个连通铜岛目标方法，不改任何门限。只恢复当前施工副本，原aaa37不变，不可投板，实物UNMEASURED。当前离线作业是否存活必须查进程，不依赖stored running。

2026-10-23T12:40:06.993712+08:00：PRESET0整网原生恢复，施工58→54项/14网，当前SHA40c8175b…，227件602孔。实际重铺发现的既有Ground16接触不足经移动两段新控制铜共同折点+0.05/-0.10mm修复，实际0.166928mm²，回流0.809514mm。四层重铺保存重开0间距/0物理/0网表；428比较无新增退化，实铜/899节点/外部焊盘/非铜核验通过。当前仍9控制网待恢复，施工副本不晋升原aaa37。唯一入口u9-layout/README与construction-state；全任务终态，下一ENC_A，再其余控制。PRESET2旧固定目标/392及445mm绕行候选拒绝，不重跑；下次联合邻近DISP_MOSI/PDN方法。最终选型仍开放，实物UNMEASURED，自动续跑继续。
