sakuyaShining/FPGA-Music-project-internal/project/DELIVERY-BASELINE-20261029.md

**2026-10-29 基线复核更正：传感板暂停投产。** 实际S1 Gerber底层地铜到22个非地排针焊盘最小间距约0.162858mm，低于保留门限0.1651mm；此前原生DRC0、5μm图形比对与较低通用门限未覆盖该严格条件。可继续询价，先不按本版传感板付款生产。旧冻结包字节保留用于追溯，不能据其中的PASS或READY文字忽略本更正。详见基线`evidence/retained-clearance-gate-audit.json`。

# 当前硬件交付基线（2026-10-29）

默认送厂入口为[Control88 R2 + Sensor14Bank S1基线](../hardware/delivery-baselines/20261029-r2-s1/README.md)，机器索引为[delivery-baseline.json](delivery-baseline.json)。两种设计制造资料已保全，可提交询价；Sensor S1严格铜距未通过，需修复重导出后再重新核验；尚未下单付款、未取得厂家接受/交期，完整产品未实物验收。

|项目|冻结身份/数量|状态|
|---|---|---|
|Control88 R2|PCB 733e1d9c…；1块；88件|原生保存重开DRC0，同源Gerber/孔/BOM/CPL证据随包|
|Sensor14Bank S1|PCB 2184d027…，SCH 7710964c…；6块；28件/板|原理图及PCB保存重开DRC0，含实际地铜连通及四层制造图形比对|
|板上采购|38种C料号、256净件|232 SMT + 24插件；不能替代整机屏幕/附件清单|
|Q4固件|带显式依赖、数据表与报告的只读源码恢复包|未在本轮重跑构建/测试，不是可烧录正式版；旧PnR不继承为本快照验收|
|整机|已有Nano20K，J10单屏，84电极|屏幕、附件、全成本、固件接合与实物验收仍待完成|

从基线目录解压`factory-handoff-20261029.zip`，先读README及给厂家需求；PCB网站分别上传01/02内的Gerber。使用相应单板BOM和SMT CPL，成品目标1+6。源与证据另见两个冻结ZIP。

接续顺序：厂家审单/报价与屏幕配置询价；精确附件与700元含运预算；固件依据真实RC_DRIVE/SENSE接口做定向仿真并接屏幕/存储；到货后电源→一块传感板参考通道→一个三电极音位→六板→屏幕/音频→整机验收。详见基线里的两份采购/安装及下单教程。

旧951整合载板和早期小板/控制板候选是历史恢复来源，保留其原本未完成状态，不再作为这次1+6制造任务的默认输入。原FPGA/主机工程和产品音乐规则未被本次整理替换，完整四槽等目标没有削减。

本轮为当前任务分支的基线候选，main仍以实际合入为准。本次整理不自动授权合并main、给供应商发消息、付款投产或烧录。最终提交/远程核验收据见同一review目录；其他owner后续源码变化须另行登记。
