sakuyaShining/FPGA-Music-project-internal/project/WORK-PLAN.md

**2026-10-29 基线复核更正：传感板暂停投产。** 实际S1 Gerber底层地铜到22个非地排针焊盘最小间距约0.162858mm，低于保留门限0.1651mm；此前原生DRC0、5μm图形比对与较低通用门限未覆盖该严格条件。可继续询价，先不按本版传感板付款生产。旧冻结包字节保留用于追溯，不能据其中的PASS或READY文字忽略本更正。详见基线`evidence/retained-clearance-gate-audit.json`。

**2026-10-29 硬件交付基线更新**：送厂与采购接续先读[DELIVERY-BASELINE-20261029.md](DELIVERY-BASELINE-20261029.md)。当前为Control88 R2×1 + Sensor14Bank S1×6，制造源核验已完成，可交厂家DFM/SMT审单报价；屏幕/附件报价、固件接合、实物及整机验收仍待完成。下文旧日期的951载板和早期小板状态仅适用于各自历史版本。本更新仍是任务分支候选，main发布以实际合入为准。

# 下一阶段任务与验收

**2026-10-27 统一接续入口**：先读 [CONSOLIDATION-20261027.md](CONSOLIDATION-20261027.md)。当前硬件已汇入951保存源、模块／传感小板／三键候选和恢复检查点；35项限定口径已批准，制造核验及实体整机仍未完成。下文带旧日期的未合并／源版本说明保留历史适用范围。

本表定义任务及限定进度。4d37除维护规格/登记外，已在协作板认领的隔离目录实施资源协调器候选；不接管其他源owner目录。任务按依赖推进，硬件制造周期与音乐回归分别收口。

| 任务 | 优先级/负责范围 | 输入与允许写入 | 完成条件/交回内容 |
|---|---|---|---|
| T01 规格与入口纠错 | P0 管理，本轮 | PRODUCT-SPEC、决定证据、corrections、地图、公开仓库同步规则 | 人类决定可追溯；提案不升级为承诺；所有当前导航一致；治理/保全/工程检查通过；PR交回，合入仍由用户确认 |
| T02 音乐黄金差异定位 | P0 明确profile与反例已完成限定验证 | MUSIC-GOLDEN-DIAGNOSIS、music_profiles.py；原owner目录不改 | 历史profile三轨迹逐字节相等；当前profile三探针通过、7次快照/112幅度独立参考及3项定向反例有效。旧默认测试失败保留；并非独立完整PCM模型、四层产品或听感签收。后续按新功能扩展判据，RTL变更须新PnR/STA |
| T03 PCB施工收口 | P0 硬件，原owner | producers硬件入口→u9-layout/next-entry及真实保存PCB；管理只读 | 新观察原生a3a258局部ADDR1保存版49项13网/620孔，旧e09847项仍为current检查点；继续恢复控制/地址/禁用网络；保护已闭合MOSI和参考/回流门。原生严格DRC、保存关闭重开、哈希/网表/铜/非铜核对；同版BOM/CPL与参考例外清单；仍由独立门决定制造放行 |
| T04 屏幕/外围/装配资格 | P0 硬件，与T03协调 | 当前227件机器BOM、J10及电源/AUX原理图；提案不直接改接口 | 确定屏SKU/CTP/电气/机械/线束；核电极与结构、AUX有源音箱、供电/USB隔离；工厂SMT+TH/双面装配与含税运报价、板数/备用量；旧CPL六行和单面报价不得复用 |
| T05 设备接口合同 | P1 FPGA/主机/硬件共同审阅，owner待登记 | 当前寄存器/协议/引脚参考及用户流程；先形成接口文档 | 明确84节点、手指实例、四槽、J10、独立键/编码器、EEPROM/TF的消息与时序；区分旧pad/UART测试接口和载板接口；变更引脚先协调，不擅自采用PCF8575或16键方案 |
| T06 分层与实体编辑 | P1 资源候选由4d37限定实现；编辑/整机接口仍待接合 | current候选及R01/R05/R06/R07；D-019及NOTE-RESOURCE-CONTRACT；note_resource_20261024/audio | 已接真实四槽/音符分量生成器→TDM：16384×2独立分量向量、4幅度反例、546请求/5136真实装载/4080PCM帧；高倍率力度回绕和配置/起音并发互等已修复并有反例。同版综合11515Logic/4865REG/14BSRAM；后续input增量已接双来源身份路由/匹配回包及排队取消：24000拍独立参考/3反例、真实547请求/5136装载和取消反例通过，68单测；同版综合11722Logic/4974REG/14BSRAM。单元PnR两次路由进程异常，无STA；实际contact/曲谱适配、激发自动OFF、独立PCM/瞬变及完整顶层/PnR/STA仍待完成，短淡出待确认。实体编辑/逐槽/断电保存仍未完成，不以测试数据提供器或UART代替实体闭环 |
| T07 J10与扫描整链 | P1 功能owner待认领，依赖T04/T05 | J10路线、rh/rc模块和最终器件合同 | 泛音与曲谱/编辑页面按模式交互，保持/RESET行为正确；全规模扫描/多指跟踪/标定，最坏触摸至声音≤10ms实测，不声称电容测力 |
| T08 录放与整机验收 | P1，依赖完整顶层/文件协议 | SDRAM/PCM候选、TF与事件/曲谱需求；D-019 | 曲谱与现场同等共享32组，按空闲/尾音/最早按住音分配，整音符回收且新音完整起音；PCM播放另走最终混音，不替代曲谱事件重演。文件/事件恢复、完整同版资源/时序、AUX模拟、稳定与断电/故障恢复；保存源码不等于整机验收 |

## 开工与交回合同

用户已确认当前产品复述准确并授权按此推进；共享与尾音优先的最终资源方向见D-019，其替代旧D-018严格FIFO；剩余边界见OPEN-RULES.md。T02诊断证据不代表认领原FPGA目录或已完成整机验收。

功能任务必须补充：负责人、具体分支、精确输入清单/源提交、独占文件、接口依赖、判据和结果存放目录。未认领不视为已经并行实施；不得写其他owner目录、重用历史构建输出或改原黄金消除失败。

若必须重新解释音乐规则，先引用用户决定；未决项由用户确认，不用作者估算或工期压力替用户删功能。验收结果只绑定实际输入，main合入与制造放行为不同步骤。

## Contact命令端点增量

后续帧增量见versions/note-frame-source-20261024.json：已接捕获格式的immutable-frame源到完整token命令端点，保留坏帧/标定/序号/看门狗和seen/blocked，新增默认26联系人、四层小接口、背压与延迟起音取消语义对照；仍未接真实分配/renderer、全层finger消费端及实体模拟扫描。新单元PnR同样0xC0000005无STA；下一步不再重复帧/端点oracle-only工作，应接实际消费者与后端。

T06的contact生命周期已实现为独立RTL命令端点：两来源标签/31位serial及窄位宽耗尽、全层运动、取消/回包/尾音复用竞态对照通过，另有5项指定字段反例。边界见versions/note-contact-transport-20261024.json。尚未接原帧生产者、finger_pitch、曲谱脉冲源、自动OFF或真实音频顶层；本版单元全约束PnR在route80%发生0xC0000005，无有效STA。下一步必须接真实源与消费端，不再把oracle或替身回包当接合完成。
