sakuyaShining/FPGA-Music-project-internal/docs/02-技术方案/38-代码盘点与实现基线-2026-10-09.md

> **2026-10-23 当前范围覆盖提示**：先读[最新设计入口](../../project/DESIGN-CURRENT.md)及`project/design-state.json`。用户已取消J11实体音乐可视化屏，保留J10泛音触控屏；本文旧双屏要求与旧状态不覆盖后续决定。新观察FPGA候选和旧已验检查点分列，本轮未修改产品RTL。

# 代码盘点与实现基线 · 2026-10-09

> 当前实现的阅读入口。设计目标另见 [39-最新设计构想与落地差距](39-最新设计构想与落地差距-2026-10-09.md)。
> 盘点起点：`fe326ad9505c94f46f9236bf7f9bfc3b5f1b9a12`，开始时 Git 工作树干净。
> 本次只增加盘点、版本检查工具和文档提示，没有修改产品 RTL、参数表或协议。
> 当前主目录源码指纹：`notes/baselines/main-2026-10-09-board-diag.json`（192文件）；盘点阶段快照`main-2026-10-09-v2.json`与实测摘要`2026-10-09-verification.json`保留。
> 首次盘点快照 `2026-10-09.json` 保留，后续仅基线工具增加了跨工作树支持，产品源码未改。
> 后续板级测试增加独立诊断源码与脚本，对旧快照检查为7个新增、0个修改；完成评估和验证后另写上述新快照，旧快照不覆盖。产品RTL未改；源码指纹PASS不表示功能全绿。诊断副本修复不等于已合入产品；结果见[41号](41-板级全面测试报告-2026-10-09.md)。

## 0. 最重要的发现：最新成果并不都在 main

**2026-10-19联合探针资源后续**：见[86号](86-联合探针资源调整与布线失败边界-2026-10-19.md)和`experiments/joint_probe_resources_20261019/project/CURRENT.md`，版本`joint-probe-resources-20261019-v0`。先备份116项，MAC前15项、RAM延迟前11项；85号音乐引擎88文件及全部时序/引脚约束不变。仅把验证探针历史链迁至9个DSP寄存器与96拍RAM延迟，普通寄存器11243→10760；五配置10万拍逐位历史对照、DSP/延迟反例，以及两延迟各200实际音乐PCM录入/读出和200图案播放在限定数字范围**已验证**。联合布局通过，但正常策略仍DesRoute/PR0004，路由**未通过**；PnR报告20478Logic、10357/10368CLS、32BSRAM、22.75/24DSP，无有效setup/hold/recovery/removal余量、无新码流，加严构建未运行。三个前候选路由失败及错误目标中止均保留；不能用0 unrouted字样放行。COM6未找到，串口清单为空，本轮板状态未核实；无下载/发音/Flash/TF操作，最后成功确认仍76号。探针**已实现待验证**、整机**部分实现**，禁止下载结构探针；下一步针对核心高占用/局部路由及真实命令包装继续优化，不擅减复音/泛音或取消可视化，不据此裁定双板。

**2026-10-19联合布局实际边界**：见[85号](85-音乐存储联合布局与RAM模式修正-2026-10-19.md)与`experiments/joint_timing_20261019/project/CURRENT.md`，版本`joint-timing-20261019-v0`。先备份106项、修RAM前8项、原生RAM前8项；保留84/83及原源。建立保留音乐/可视化/扫描/录放的串行结构探针，实际PLL与55个SDRAM内部端口；不是实体演奏协议，禁止下载。联合PnR先暴露rc_delta_store的DPB READ_FIRST不支持，已改为写口保持＋碰撞旧值旁路；36万拍对照、160帧位置/5帧扫描回归通过。音高双存储改原生RAM，寄存器718→142，8万拍独立全地址及96万拍音高对照、三组985PCM旧轨迹逐字节一致；两延迟各200音乐PCM录入/读出和200图案播放在限定数字范围**已验证**。但最终综合20189Logic/11243寄存器/31BSRAM，默认和策略1均PR0003，仍158寄存器未放置，**联合布局未通过、无有效时序余量、加严构建未运行**。全部六构建保留FAIL；不能用资源总数或RTL回归放行。新路径**已实现待验证**、整机**部分实现**，没有下载/Flash/TF/新听感；COM6只读确认76号就绪/活动0/512拍。下一步压缩结构探针开销/状态布局并重做联合PnR，最终混音/文件/非易失继续**待实现**，不据此擅自减少功能或裁定双板。

**2026-10-19音高状态资源优化**：见[84号](84-音高状态分存与资源优化验证-2026-10-19.md)与`experiments/pitch_memory_20261018/project/CURRENT.md`，版本`pitch-memory-20261019-v0`。先备份102项，82号音乐/存储副本仅改pitch_mod状态存储；96万拍四配置逐拍/全组对照、两故障反例、原三组506645拍/985PCM轨迹逐字节一致及配置/包络回归，在限定数字范围**已验证**。公平综合20422→20117Logic，省305，BSRAM仍31，余619Logic/15BSRAM；寄存器增加64，并非整表变成RAM。无完整联合PnR或新音高实体验证，优化路径**已实现待验证**，整机**部分实现**。系统盘耗尽期间的轨迹/构建不签收，转D盘后完整重跑并保留失败；没有删除历史交付。用户断电后已用操作2重载76号，COM6身份/512拍/2048零PCM通过，无Flash/TF或新听感结论。下一步音乐＋实际SDRAM时钟联合时序，再接回放混音/文件；83号旧比较异常根因仍待定位，不据本轮综合解除。

**2026-10-18录放SDRAM板验**：见[83号](83-录放SDRAM调度板验与诊断比较修正-2026-10-18.md)与`experiments/sdram_stream_board_20261018/project/CURRENT.md`，版本`sdram-stream-board-20261018-v4`。先备份19项、诊断修订前再备份117项；82号五个搬运RTL逐字节保持。实际COM6/B、ID81B仅操作2 SRAM，默认1024字FIFO/每向256KiB环形区，两次完整静音合成图案测试各1345540内存事务：266240样本/方向含两次回绕、停止后排空、在途/阻塞请求清空、132097连续前缀、8次读空和4096样本/方向恢复均在限定范围**已验证**。早期四个物理版本最终前缀比较异常均保留FAIL并恢复76号；分字节寄存复核后两次通过，未证明旧异常根因为工具或排除全部时序因素。选定v4加严PnR setup/hold +4.205/+0.011ns，余量紧、原始时钟布线警告/确切die温压/完整联合时序仍**待验证**。已恢复76号，身份/512拍/2048零PCM确认，无Flash/TF操作。新调度限定板验完成，文件/非易失/最终混音/真实音乐录放及完整联合PnR仍**待实现/待验证**，整机**部分实现**。下一步先恢复逻辑余量并做音乐＋存储联合时序，再接回放混音/TF文件，不能用独立诊断余量签整机。

**2026-10-18录放环形调度接合**：见[82号](82-录放缓冲与SDRAM环形调度接合-2026-10-18.md)与`experiments/sdram_stream_20261018/project/CURRENT.md`，版本`sdram-stream-20261018-v0`。先备份101项，冻结原音乐/双FIFO，沿用81号注册输出控制器；新增录制/回放独立SDRAM环形区、四客户轮转及clear接受/清退/完成围栏，停止采集仍排空旧队列。四配置共680016拍/49139内存请求/6341清空、最多等其他3次授予；双后端整链及溢出前缀/读空恢复、四个故障反例在数字范围**已验证**。同工程20124→20422Logic，31BSRAM，余314Logic/15BSRAM；只算联合综合，无新PnR/板验。中间一次工具卡住人工终止，退出0仍不计通过，串行新工程正常完成后才签收。本轮无下载/COM/Flash/TF访问，板上仍76号；实际新调度**已实现待验证**。逻辑数据搬运已接通，但TF/文件/非易失/事件配对/最终混音/完整音乐联合时序仍**待实现/待验证**，整机**部分实现**。下一步隔离调度板验、联合时序与资源优化，再接TF和回放音频，不能用SDRAM易失缓存冒充断电保存。

**2026-10-18 SDRAM时序与板验**：见[81号](81-SDRAM时序排查与板级读写验证-2026-10-18.md)及`experiments/sdram_timing_20261018/project/CURRENT.md`，版本`sdram-timing-20261018-v0`。先备份109项，修复前再备份194项；隔离注册命令/地址/DQM输出，18万拍9593事务旧源对照和原SDR模型/四反例通过。补齐内部SDRAM映射、双向min/max及相关时钟约束，27→27MHz PLL改善核心时钟分布；正常setup/hold为+5.704/+0.225ns，加严为+4.204/+0.037ns，原未注册加严−0.877ns反例和漏约束假绿反例保留。实际COM6/B、ID81B，仅操作2 SRAM，两次8MiB双图案写读各16777216事务无错；已恢复76号并确认身份、512拍采样与2048零PCM。限定板上路径**已验证**，原始PLL输入PR1014/确切die与封装时序/温压和长期保持仍**待验证**，不作量产签收。本轮无Flash/TF访问或音乐源/GUI/旧快照变更；完整音乐＋新控制器联合资源/PnR、FIFO仲裁/环形区、TF文件/非易失/混音仍**待实现/待验证**，整机**部分实现**。下一步接录放缓冲与SDRAM有界调度/清退，再做联合时序与实测。

**2026-10-18 SDRAM控制增量**：[80号](80-SDRAM单事务控制与时序模型验证-2026-10-18.md)与`experiments/sdram_controller_20261018/project/CURRENT.md`为新存储控制实验。先备份108项；冻结79号引擎/双FIFO，新增16位单事务、32位SDRAM/半字DQM、200us候选初始化、CAS3、显式预充电与自主刷新。2147事务/1090读1057写、95刷新、最长间隔397拍、最长接受后响应11拍及四个故障反例，在自写子集模型范围**已验证**。公平联合综合20082→20114Logic，BSRAM仍31，余622Logic/15BSRAM；整体映射差值不等于控制器固有成本。真实die时序/封装内引脚/约束/收发时钟/PnR/板验仍**待验证/待实现**，没有下载/串口/Flash或介质访问，板上仍76号。FIFO到SDRAM环形缓冲/仲裁尚未连接，TF/文件/非易失/混音仍**待实现**；整机**部分实现**。下一步缓冲调度/在途事务清退与实际SIP包装/模型、资源和板级验证，不把子集模型PASS当实体RAM已可用。

**2026-10-18录放缓冲增量**：[79号](79-录放双向缓冲与停顿边界验证-2026-10-18.md)和`experiments/pcm_buffer_20261018/project/CURRENT.md`为新存储实验入口，音乐引擎沿用78号。先备份206项；新增两路1024×16同步RAM FIFO、录制溢出锁存/连续前缀保护、播放读空报告与独立清空。2/8/1024深度共153180拍独立队列参考/坏指针反例、2290578拍双路压力仿真通过；512拍采样、约14.81ms后台停顿后2344录制样本完整、同时2304播放样本无读空。公平联合综合19765→20082Logic、29→31BSRAM，余654Logic/15BSRAM。限定数字缓冲/综合**已验证**，无PnR/板验；SDRAM/TF控制器、文件保存、非易失、最终混音/曲谱配对仍**待实现**。本轮无下载/串口/介质/Flash访问，板上仍76号，原源/GUI/快照保持；录放整体**部分实现**。小FIFO单向满容量约19.42ms，不能保证卡停顿；下一步SDRAM初始化/刷新/读写与缓冲调度资源探针，后端切换还须清退在途事务。

**2026-10-18参数回读RAM优化**：[78号](78-参数回读RAM与逻辑余量恢复-2026-10-18.md)及`experiments/register_memory_20261018/project/CURRENT.md`为最新源码入口。先备份195项，保留原reg_bank/旧顶层和77号；仅在实际tdm_top_owned接入128字节同步RAM与35字节实时镜像/前拍写转发。15万拍全地址存储/复位、5万拍9993次回读对照及漏转发反例，原音乐/包络/配置回归和115200板级包装仿真通过。同工程20635→19765Logic，减少870；11592→10844寄存器，BSRAM28→29，余971Logic/17BSRAM。限定数字与综合**已验证**；诊断PnR10629Logic/22BSRAM，setup+9.076/hold+0.074ns，无新下载/串口/介质或Flash访问，实体新RAM路径**已实现待验证**。当前板上仍为76号；GUI/原源/旧包/快照保持。非易失、SDRAM/TF与录放仍**待实现**，整机**部分实现**；下一步以恢复的资源做存储控制器和缓冲的隔离验证/联合预算，不据诊断余量承诺全功能。

**2026-10-17效果器存储优化**：[77号](77-效果器单读口与存储资源账-2026-10-17.md)及`experiments/fx_memory_20261017/project/CURRENT.md`为最新源码入口。先备份189项，仅隔离改fx_delay为单同步读＋标签/转发，保留原抽头更新边沿及现有调度。两轮各60万拍、两种深度逐拍输出/十抽头/写回对照、错位标签反例和原音乐/包络/配置回归通过；同工程20537/46BSRAM→20635/28，释放18块但Logic增98仅余101。数字优化/综合**已验证**；14脚新诊断PnR10369Logic/21BSRAM，setup+7.694/hold+0.083ns，未下载/新板验，实体路径**已实现待验证**。板上和GUI仍用76号已实测版本；原源/包/旧快照保持，本轮无COM/Flash/介质访问/采购。原效果器实际free-running调度与注释不符及启动未知另列，等价不当作时间规格达标；断电保存/TF/SDRAM/录放仍**待实现**。下一步用释放RAM换逻辑余量，再接存储控制，整机仍**部分实现**。

**2026-10-17包络资源优化与配置板验**：[76号](76-包络共享资源优化与配置板验-2026-10-17.md)及`experiments/envelope_resources_20261017/project/CURRENT.md`为最新入口。先备份172输入，仅隔离共享互斥D/R运算；680560组×3宽度参考、原音乐逐拍/独立包络/配置传输及104GUI回归通过。相同工程仅osc_env不同，20767→20537Logic减少230，余199，BSRAM46/46；联合综合**已验证**，无完整联合PnR。14脚配置诊断PnR10495Logic/39BSRAM，setup+8.486/hold+0.074ns；实际COM6/B、ID81B，仅操作2 SRAM下载，新能力75/1，5次配置确认、快慢起音/击发/两独立音/坏CRC与忙拒绝、最终2048零PCM在限定板上范围**已验证**。当前SRAM已为新配置诊断，使用本轮隔离GUI；旧73六用例与原GUI/exe保留回退，未覆盖或读写Flash。加速复位测试仅确认512时隙关门/幅度/待写及零PCM，不宣称短窗口env全清或新增物理S2实测；新听感待用户反馈。整机仍**部分实现**，断电保存/录放/独立效果/四层/实体显示触控等缺口保持；下一步缓存与存储资源账、非易失和录放接合，不据诊断余量签整机容量。

**2026-10-17可靠配置传输/GUI接合**：[75号](75-配置可靠传输与GUI接合验证-2026-10-17.md)及`experiments/config_transport_20261017/project/CURRENT.md`为最新实验入口。先备份138输入，隔离接合能力75/ABI1、CRC完整帧、inactive bank提交、事务/版本回读、失败隔离/恢复及GUI应用，旧D4部分应用保留。串口独占/双入口与标准115200引脚到PCM、11主机故障项、104离线GUI、原包络/逐拍兼容及反例在记载范围**已验证**。完整联合候选实际综合20767Logic，超20736上限31，**未通过**；逐位CRC尝试已回滚，失败报告保留，无本版本PnR/码流/板验。完整配置仍**部分实现**，仅通电有效，非易失/录放/完整四层/独立效果/实体触控显示缺口保持。原源/GUI/74号/旧快照不改，未开COM或下载/Flash/采购；下一步有回归约束的资源优化，再做对应音频板级包装/PnR和真实应用确认，不以仿真回执当实体成功。

**2026-10-17乐器配置/独立包络接合**：[74号](74-乐器配置与逐层包络接合验证-2026-10-17.md)及`experiments/instrument_config_20261017/project/CURRENT.md`为最新实现入口。先备份110输入，在72号隔离副本扩88位运行时槽和独立A/D/R时间参数，schema1持续/击发/混合、频谱与ADSR可编译到逻辑配置口；旧音保留配置、新音用发布数据仍为原型。11项编译检查、5万拍独立RAM/包络参考、最大分频两次回绕、4123PCM/5ON5OFF整链、原985PCM逐拍兼容及额外启用选项兼容、3反例在限定数字范围**已验证**。完整组合综合20277Logic/11189寄存器/45BSRAM，余459Logic/1BSRAM，未PnR/新板验，不保证全产品容量。当前仍仅Nano20K＋喇叭；CLI只写本地文件，真实UART/GUI应用、非易失及独立颤音/效果器仍待接，开启不支持项明确拒绝，完整配置**部分实现**。原源/GUI/71/72/73/旧快照保持，无新下载或Flash操作；下一步可靠传输/能力确认与GUI应用，再接板级验证。

**2026-10-17在手硬件更正**：用户最新明确当前只有Tang Nano 20K和喇叭，暂无屏幕与实体触控；以此覆盖较早“已有显示屏”的在手清单，不能安排立即点屏/实体触控实测，也不将屏幕候选视为已购买/已到手。约7英寸右手泛音显示触控、逐音滑条及可视化功能目标保持；接口/面板仍待选型闭环与实物验证。73号板载音频限定实测继续有效，原RTL/包/快照未改。后续优先推进不依赖新增外设的完整乐器配置/逐层包络及主机参数应用，使用虚拟输入和仿真继续验证，再将已接合路径上板；录放/存储仍按资源与接口证据推进，不能把板载TF卡座当作已有存储卡。此为开发顺序建议，不替用户冻结音乐行为、取消功能或发起采购。详情见`notes/hardware-availability-20261017/CURRENT.md`。

**2026-10-17板级实测**：[73号](73-板级音频实测与复位按键更正-2026-10-17.md)与`notes/board-audio-hardware-20261017/CURRENT.md`为最新实体入口。USB恢复后识别COM6/B、GW2AR ID81B，操作2临时SRAM下载成功，实际UART profile72/ABI1/D3正确；六项2048PCM回读、512拍采样、32组满载/34子ON抢占和停止清音在限定板上范围**已验证**。短音另捕获起音/释放下降/最终零PCM；实际复位后计数/绑定归零、2048零PCM，重新A4演奏成功；用户反馈能听到且暂未发现异常。重要更正：约束87脚对应**S2**，旧72/40/41等“S1/87”是文字编号错误，按S1的失败记录保留；码流连接未改。原源/GUI/71/72准备包及旧快照保留，新证据另存，不读写Flash。实体引脚边沿/外部I²S时序/模拟质量、屏幕/触控/完整整机及配置/存储/录放缺口仍待验证/实现；不把短诊断检查外推整机完成。

**2026-10-17板级音频准备**：用户此前未上电；新增[72号](72-板级音频诊断准备与复位清音验证-2026-10-17.md)及`experiments/board_audio_20261017/project/CURRENT.md`。先备份542项，隔离14脚音频诊断与静音回退，保持原源/GUI/71号及旧快照；发现按住双层音复位后时隙可残留发声，板级默认启用两遍512时隙清音/启动围栏，默认关闭路径仍与71号三组506645拍/985PCM逐字节一致。板级284PCM/40ON38OFF/12移动、实际115200配置仿真、512时隙清零及故障反例、主机9项检查在限定数字范围**已验证**。最终默认策略PnR 15258Logic/7287寄存器/36BSRAM/14IO，内部27MHz setup +3.523ns、hold +0.214ns、TNS0；策略1超时保留，外部I²S/实体未验，诊断资源不外推完整71号/整机。交付SRAM临时镜像/静音回退/只读默认串口脚本，**已实现待验证**；未开实际串口、下载、读写Flash/采购，下一步上电核验并保存真实音频与状态证据，完整配置/录放/7英寸等缺口保持。

**2026-10-16资源优化与回归增量**：最新实验入口为`experiments/resource_safety_20261016/project/CURRENT.md`，见[71号](71-资源优化与逐拍等价回归-2026-10-16.md)。采用同触点锚点共享、实例身份预取、触点记录同步缓存/写转发；5000事件、三组各50040拍锚点、541帧原桥测试＋26条600帧随机桥对照及三组完整音频共506645拍/985PCM逐拍输出在限定范围已验证，3个故意错误副本均被检出。相同工程重新综合参考20668/12604/43与选定19892Logic/11120寄存器/43BSRAM，减少776Logic/1484寄存器，余844Logic/3BSRAM；未PnR/板验/证明全产品容量。先备份500文件，原产品/GUI/70号及旧快照保留，启动未知和既有硬件/显示/延迟缺口不清零，未改变音乐交互语义；下一步完整逐层包络/配置与非易失/录放接合。

**2026-10-16四槽/双层候选增量**：最新实验入口移至`experiments/instrument_layers_20261016/project/CURRENT.md`，见[70号](70-四槽运行时音色与双层音频原型-2026-10-16.md)。四槽运行时频谱/频率比/衰减/延音表、完整提交、双层子身份与一指多组滑音、原选择释放和抢占隔离在限定数字链已验证；原始595/理想RC到双层PCM及旧PCM/I²S对照通过。联合选定综合20668Logic/12604寄存器/43BSRAM，余68Logic/3BSRAM，无PnR/板验，不能容纳全部未来功能的证明。原配置格式/GUI仍未接完整设备应用，逐层起音/释音/效果器、四层同时、非易失、录放与7英寸界面待接；三次失败资源变体与启动未知边界保留。先备份334文件，原源/GUI/69号及旧快照保持。

**2026-10-16接合候选增量**：主目录产品源仍未变，较新实验代码在`experiments/left_hand_events_20261016/`。沿engine-safety246和68号接合区，新增带实例身份的分配/完成反馈、触点桥、逐指绑定；理想RC扫描到真实PCM、同音独立/抢占保护与左右控制在限定数字范围已验证，见[69号](69-左手实例事件与真实音频接合-2026-10-16.md)。串行实例查找联合综合19621Logic/41BSRAM，未PnR/板验，不是全机资源签收。完整配置/分层/非易失/录放/7英寸界面仍待接，当前入口为该实验`project/CURRENT.md`；原源/GUI/68号/旧快照均保留。

**2026-10-15高级工具窗口修复入口补充**：用户截图定位到`C:/Users/Sakuya/.codex/worktrees/ca03/FPGA-Music-project`的较新上位机10版（HEAD仍fe326ad、存在未提交GUI与此前RTL修复，不能以HEAD视作main同内容）。本轮只增量修复其高级工具的屏幕边界、固定关闭/部分应用、文件菜单与反馈，目标发行11版；100项离线主机测试及缩放布局检查通过，打包实际验收见`notes/advanced-tools-redesign-20261015/delivery.json`和该工作树`docs/05-上位机/高级工具窗口重设计-20261015.md`。实现前233文件ZIP/哈希备份，原10版发布输入零漂移；本次不改引擎/约束/音频帧协议，不合入main、不接串口或下载。10版已支持预设/谱部分应用，不能再将6e70的应用按钮禁用现状外推到用户运行版本；完整配置应用仍待实现。

**2026-10-15小样接线与新增录放需求**：既有工程备份后已保存三页接线草稿，53元件/231引脚，其中207接线、24明确NC；原生Protel网表独立比对0差异，原生规则检查0项，限于图纸连接范围**已验证**。交付在`hardware/pitch-sliders/prototype-schematic-20261015/`，保护/电极封装/最终Nano约束/PCB与实测仍待完成。用户新增音频保存播放、实体演奏录入与曲谱指引，见[57号](57-小样接线与录音曲谱功能扩展-2026-10-15.md)：候选用板载TF＋SDRAM、配对PCM与事件轨，均**待实现**，未把EEPROM当录音介质。main192输入仍PASS，未改产品源/旧快照。

**2026-10-15硬件选型恢复**：用户解除选型暂停，实际嘉立创选型审阅工程已保存12个关键元件，18种型号/C号/真实库UUID、原生BOM与129引脚在身份读回范围**已验证**。交付与脚本在`hardware/pitch-sliders/selection-20261015/`和`notes/hardware-selection-resume-20261015/`，说明见[56号](56-嘉立创硬件选型恢复与关键料审阅-2026-10-15.md)。未接线/ERC/PCB/报价签收，未改音乐引擎、产品RTL/表/约束/协议或旧快照；不以选型工具校核当传感/完整产品完成。

**2026-10-15可视化性能核验**：新增隔离`metrics/`测试，未改任何RTL。原双音20Hz不外推全负载：保守接口压力最长绘制51.721ms，50ms门槛未全通过；5ms短音轨迹漏记已复现。FFT实际约47.64Hz、9.71ms波形快照/50ms、频谱UI回落约900ms等见[55号](55-音乐可视化性能指标核验-2026-10-15.md)，源码/测试/日志哈希绑定在`metrics-summary.json`。性能审计范围**已验证**，优化与实屏**待实现/待验证**；不把审计COMPLETE说成流畅目标完成，原基线/引擎不变。

**2026-10-15可视化增量**：用户提供YT240L008N并要求先备份、保护引擎；实现前完成297/248/46文件三份ZIP备份及哈希校验。新模块隔离在`experiments/music_visualizer_20261015/`，含真实PCM波形、1024点FFT/48频带、32声部音高轨迹及ILI9341横屏局部更新。5组FFT/5组波形、8轮SPI图像、1505012周期PCM/I²S对照在各自数字范围**已验证**；单独2968Logic/7BSRAM，核心联合19777Logic/38BSRAM，无真实IO/PnR。产品接合**部分实现**、实屏**待实现/待验证**；main192和最新246身份PASS，原备份297文件未变，未改产品RTL/旧快照、未下载。具体来源、SHA-256、边界和下一步见[54号](54-音乐可视化独立模块与验证报告-2026-10-15.md)。

**2026-10-14增量**：整合07底座之上已在独立工作树`C:/Users/Sakuya/.codex/worktrees/instrument-engine-safety/FPGA-Music-project`实现第一阶段频率安全与重奏修复，分支`codex/instrument-engine-safety`，源码提交`a7427ed`，交付记录提交`683db48`。246输入清单`project/versions/engine-safety-20261014-01.json`；29项针对性组合覆盖（非一次全量29/29），最终新PnR setup+9.643ns/hold+0.310ns/TNS0，Logic18796、CLS10066、BSRAM38、DSP10.75；check-build通过，未下载/板验。main及原66a4产品源码未合并或覆盖。完整交付包与身份见主目录`notes/engine-safety-stage1-20261014/delivery.json`，详见本工作树`project/engine-safety-20261014.md`。下表较早快照和既有缺陷边界按各自版本阅读。

**main 停在 `fe326ad`，项目较新成果分散在工作树中。** 下文 §1–§5 描述当前主目录，不能套用到所有工作树。
本次没有切换分支、合并代码、修改其它工作树、提交或推送。

| 工作区 | 版本 / 工作树状态（本次读取） | 实际成果与边界 |
|---|---|---|
| 主目录 `main` | `fe326ad`，盘点前干净 | 旧事件源仍单槽；本次复现 pads 两项失败；无 `finger_pitch` |
| `a61b`，任务“修复 pad 紧邻事件丢失” | `7ca52c9`，detached HEAD，干净 | **事件修复已交付在此处**：四源各4槽、公共 FIFO 连续出队修正、轮转空源跳过、UART 可读丢弃诊断；另有逐指连续音高数字接口 |
| `6e70`，任务“冻结首版行为并确认 DSH 运行” | 分支 `codex/v1-behavior-freeze`，HEAD `6246926`，**有大量未提交修改** | 本地配置文件层已提交；新版 GUI、协议v1.1与部分 RTL/驱动改动仍是工作树状态，不能只用 HEAD 描述；未与 a61b 接合 |
| `eb59`，任务“调研项目触控器件” | `00cc5c5`，detached HEAD，**有未提交调研/文档** | 触控器件调研与旧PCB假设修正，后续快速前端候选还见 6e70 的47号文档；没有实物验收 |
| `4e09` | `90e891d`，较早检查点 | 数据清单整理历史版本，不是最新产品候选 |
| `8c56`、`b5b8` | 两者 HEAD 都是 `fe326ad` | 显示原理 / 公开字段任务上下文；不是事件和逐指接口最新版本 |

后三项是否存在未提交改动本次没有逐一盘点；不要从相同 HEAD 推断工作树内容相同。
各主要工作树源码指纹分别在 `notes/baselines/a61b-2026-10-09.json`、`6e70-2026-10-09.json`、`eb59-2026-10-09.json`；
快照包含采集时 Git 状态。**文件在同一个 Git 仓库中可见，不等于它已经进入 main。**

### a61b 的已提交增量与证据

- `3520270`：事件 FIFO / 四源队列 / 可读丢弃诊断；`494e278`：补轮转跳过两个空源测试；`f24aa0a`：修检查器环境依赖；`88a94ab`：固化证据。
- `6b50ca9`：`finger_pitch.v`、触点ID→声部绑定、位置锚点与逐组频率比例；`7ca52c9`：固化验收与待办。
- 事件阶段历史记录为一次全量 **50/51**，唯一检查器失败专项修正后通过；组合证据覆盖 **51 项硬判据**，不能写成当时全量51/51。
- 逐指阶段历史全量 **52/52**，另有 i2c/t60 两项已知失败、两项INFO；**额外旧 LFO 波形跳变缺陷未修，也未计入门禁失败数**。
- 逐指表达需 `FINGER_EXPR=1`；默认0，板级包装新输入接零。数字路径验过，**实体触控、触点追踪/绑定上游、同音多指独立性仍未完成**。
- 逐指启用探针只有综合：Logic 87%；不继承事件阶段 PnR 的 +10.218 ns 到逐指新版。

本次没有重跑 a61b 的长回归，只核对源码、版本差异和归档：两个证据 ZIP 的 **13+11 项 SHA-256 全匹配**，
逐指证据绑定的 **6 项源码 blob 与 a61b 当前工作树一致**。复核结果在 `notes/baselines/worktree-evidence-2026-10-09.json`。
原始证据在 a61b 的 `docs/02-技术方案/验收证据/`，没有搬走或改写。

### 接合前需要的最小处置

选定以哪个工作树成果作为下一版实现，先固定 6e70 的未提交改动清单与源码指纹，
再将 a61b 的事件/逐指成果与 GUI/协议逐项比对、接合并验证。此处是后续建议，**本次盘点没有执行合并**。
不要在 main 重新写一遍已经在 a61b 完成的修复；也不要因 a61b 回归通过就声称新版GUI和全部交互已交付。

## 1. 当前究竟是哪一版

当前**主目录**是 **32 声部 × 16 泛音的 TDM 加法合成引擎，带 16 路物理 RC 电极输入**。
38 通道键位映射模块已经存在，但整块新面板、逐声部四维表情和新手势尚未完成。
事件接收已有公共 FIFO 与确认握手，但源端单槽仍会丢紧邻事件。

| 项目 | 当前源码事实 | 核对入口 |
|---|---|---|
| 出货工程 | `src/gowin/tdm_synth/tdm_synth.gprj` | 19 个启用的 Verilog 文件、2 个约束文件 |
| 出货顶层 | `tdm_ship` 包装 `tdm_top`；调试音符口、引脚预设、引脚测试模式接常量 | `src/rtl/tdm_ship.v`；本地 process config 的 `TopModule=tdm_ship`；构建命令仍需核对选项 |
| 主时钟 | 27 MHz，音频主链无 PLL | `tdm_top.v`、`audio_clk_en.v` |
| 实际采样率 | **52734.375 Hz = 27 MHz / 16 / 32**，512 拍/样本 | `tdm_top.v:909` 显式覆盖 `DIV_BCK=16`；本次出货顶层仿真实测 |
| BCK / 字宽 | BCK 1.6875 MHz；内部 24 位、取高 16 位，左右槽重复同一个样本 | `i2s_tx.v`，不是双路独立立体声 |
| 合成配置 | `NSLOT=512`、`NG=32`、`P=16`、24 位相位 | `tdm_top.v`、`tdm_engine.v` |
| 物理输入 | `pad[15:0]`：低 8 位进音高，高 8 位进泛音掩码 | `tdm_ship.v`、`tdm_top.v:471–515` |
| 当前触摸音高 | 低 8 键是 MIDI 48–55，即 C3–G3 的全半音；固定力度 `4'd12` | `pp_touch={30'b0,pad_state[7:0]}`、`BASE=48`；不是旧五声音阶映射 |
| 音域条 | 模块已实例化，但 `cell_t=0`，保持默认档 | `strip_ctrl.v`、`tdm_top.v` |
| 主机控制 | UART 115200 8N1；寄存器写、回读、谱编辑、曲谱与遥测 | `reg_bank.v`、UART 收发、`tools/scripts/dsp_host.py` |

注意：`audio_clk_en` 的**默认参数**仍是 18，对应 46875 Hz；不能用模块默认值替代顶层覆盖值。
本次 `clock` 测试验证默认 18，另加 `shipclock` 测试验证真正出货配置 16，两项分别记录。

## 2. 模块盘点与边界

| 功能 | 主线代码 | 当前状态 / 边界 |
|---|---|---|
| TDM 振荡、累加与包络 | `tdm_engine.v`、`osc_env.v` | 已实现；历史黄金参考逐位比对通过，本次未重跑音频全量 |
| 声部分配、释放与抢占 | `note_map.v` | 同音优先、空闲优先、最后抢占；note-off 同时清 `gact` 并回 `FREE`；**释放回收已修复** |
| 事件接收 | `event_hold.v` + 顶层仲裁 | 公共队列深度 4，`ev_ack` 接收确认与轮转结构已存在；**源端缺陷仍在** |
| 音色 / 逐组刷新 | `note_map.v`、6 张 `.hex` | 4 预设、16 项谱 RAM、叠加/替换、`0x63` 指定组/全体刷新存在 |
| 力度 → 音量 / 音色 | `vel_shape.v`、`vel_wtab.hex`、`note_map.v` | 装载时烘进每泛音幅度；物理输入固定力度，未接真实力度采样 |
| 亮度 | `0x5C`、`tilt_wtab.hex` | 已实现；恒等点 `0x70`；参数为全局，装载/刷新时应用，尚无逐声部独立控制状态 |
| 滑音 | `note_map.v`、`pitch_mod.v` | 每组偏移与线性收敛已有；**正常连奏不会自动复用组**，声部满走抢占时才可能产生初值 |
| 颤音 | `pitch_mod.v` | 一个全局 `lfo_ph`、一个全局深度；不是逐声部颤音，也没有触后映射 |
| 效果器 | `fx_delay.v` | 延迟、合唱、混响通路存在；T60 高反馈限制未了结 |
| 定序器 / 指示 | `song_seq.v`、`led_ind.v` | 片内曲谱、下载和板载 LED 路径存在；新增面板 LED 驱动未接入 |
| 输入映射 | `pad_scan.v`、`pad_pitch.v`、`strip_ctrl.v` | 16 路 RC 扫描；38 位逻辑接口存在，仅低 8 位音高接入；音域条未接真实输入 |
| GUI | `tools/host/dsp_gui.py`、`serial_link.py`、`theme.qss` | 源码与历史帧一致性自检存在；模拟设备不出声；现有 exe 是否与源码同版本次未验证 |
| I²C | `i2c_master.v`、`mpr121_model.v` | v2 资产，**未列入 TDM 出货工程**，历史自检失败 3 项；不能算已接入触控器件 |
| 全并行引擎 / 显示 | `osc_core`、`osc_additive`、`synth_top`、显示相关模块 | 保留的参考与独立工程资产，不是当前音乐出货主线；显示历史上板记录不等于音乐系统上板完成 |

6 张权威数据表位于 `src/gowin/tdm_synth/`：`sine256`、`note_inc`、`preset_part`、`recip_inc`、`vel_wtab`、`tilt_wtab`。
改这些表同样属于产品行为变更。主线有 Nyquist 静音判断，但旧预设越界审计还存在；
本次只复核音符增量表，不据此宣称所有预设和音域都没有混叠。

## 3. 明确未修的缺陷与未验证项

| 编号 | 状态 | 证据与后续落点 |
|---|---|---|
| B-01 pads 紧邻 OFF→ON 丢失 | **本次复现，未修** | `tb_padfast` 产生 2 条，ack 1 条，note49 未分配；2 个断言失败；方案见 37 号文档 |
| B-02 UART 单槽覆盖 | **源码风险，未新增实测** | `if(u_ev_valid)` 无未处理保护，覆盖挂起数据；真实串口是否能达到触发速率需针对性验证，不能把内部一拍写当成真实串口吞吐 |
| B-03 定序器 / 调试口容量 | **每源单槽，突发风险** | `sh_pend`、`dh_pend`；本次未构造新复现 |
| B-04 丢事件对外可观测性 | **未实现** | 公共 FIFO 有 overflow 信号，但未形成主机可读、覆盖所有源的诊断通路 |
| B-05 legato 语义 | **现状测试确认缺口** | 按住 60 再按 64 → 两个组，未复用；先裁定和弦/连奏/滑动模式再改分配语义 |
| B-06 I²S 板级相位 | **未裁决** | 数字闭环记录不代替 WS/SD 实测；36 号文档为板级方案 |
| B-07 触控 / 压力与新面板 | **无完整验收** | 不把电容滤波数值直接当已验证压力；器件、IRQ、量程与采样周期仍需原型证据 |
| B-08 时序 / 烧录 / 听感 | **本次未验证** | 本次未 PnR、未烧录；旧 +17.372 ns / +15.229 ns 不能当当前源码签收结果 |

此前的 pads 队列集成已回滚。`sim_build/tdm_top.v.WIP-queue-attempt` 是忽略目录里的尝试存档，
不属于交付源码，不作为已经完成的修复；该文件是否完整可用本次未验证。

## 4. 本次验证与历史证据分开记录

2026-10-09 针对性验证（原始日志在 `sim_build/baseline-20261009/`，该目录被 Git 忽略）：

| 检查 | 本次结果 | 正确解释 |
|---|---|---|
| 出货顶层时钟 `shipclock` | PASS：样本 512 拍，BCK 16 拍 | 真实顶层配置为 52734.375 Hz |
| 默认时钟模块 `clock` | PASS：样本 576 拍 | 单元默认 46875 Hz，不是出货频率 |
| `alloc` | PASS | 32 组填满再释放，回收与不抢按住的音得到验证 |
| `inv` | PASS | `gact==0 ⇒ gtab==FREE`；可回收第三档当前不可达 |
| `legato` | PASS（现状刻画） | **证明正常演奏不触发**，不代表目标 legato 已完成 |
| `padfast` | **FAIL，2 项** | 与已登记缺陷一致；不能算产品验收通过 |
| `spec_sha` | PASS：23 行一致 | 旧文档 17 个 RTL + 6 个数据表指纹一致；不代表旧文档的文字结论正确 |
| `nyquist_check.py` | 见本次验证摘要 | 静态增量表公式核对，不能替代所有预设音频验收 |

历史记录 `sim_build/regress_FINAL_f4c53b5.txt` 为 **48/48 纳入项通过，另有 5 项未计入**。
其中 `25 i2c`、`35 t60`、`36 padfast` 是已知失败；`30 deadparam`、`34 gatecov` 是信息项。
所以“48/48”不等于“产品无缺陷”，也不是本次全量回归结果。
`cc3d496 → HEAD` 的 RTL diff 仅 `tdm_top.v` 新增 32 行缺陷说明注释，逻辑未改。

## 5. 文档冲突的裁定

| 旧说法 / 位置 | 本次核实后的阅读规则 |
|---|---|
| 34 号采样率 46875 Hz | 出货顶层覆盖为 52734.375 Hz；默认参数不能覆盖实例参数 |
| README / 旧图仍有五声音阶映射 | 现接 `pad_pitch BASE=48`，物理 8 键为全半音 48–55 |
| 35 号前半称事件通路完成 | 公共队列接好，但源端紧邻事件缺陷未修；以后半收口记录与本次复现为准 |
| 34 号称 note-off 不回 FREE、末尾说无公共队列 | 已过期：源码有回 FREE 和公共队列，本次验证回收正确 |
| 31 号称三维齐备 / legato 已可演示 | 是目标与早期误判混写；四维物理表情尚未完成 |
| 架构图 README / 05 图说 TILT 未实现 | TILT 已实现，连续手势和逐声部控制仍未完成；图绑定 `aa0ae80` 是历史版本 |
| 25 号同时写 36/38 通道、端点 C7/C8 | 最新通道表与 `pad_pitch` 都是 38；每档跨度只有 24 半音，详见 39 号待澄清表 |
| 顶层自举注释说 `0x02` 的 bit2=1 | **算术错误**：`0x02=00000010`，bit1=1、bit2=0；默认滑音应用门关闭，颤音深度为 0。本次保留 RTL 指纹，单独登记注释错误 |

历史材料保留供追溯，但当前状态从本文查，目标状态从 39 号查。

## 6. 以后怎样维持基线

每次切回一个设计话题，先运行：

```powershell
git status --short
python tools/scripts/project_baseline.py --check notes/baselines/main-2026-10-09-board-diag.json
```

该检查覆盖 Git 跟踪及未忽略的新文件：`src/`、`tools/host/`、`tools/scripts/`。
会列出新增、删除、内容变化，**只识别版本漂移，不证明功能正确**；不覆盖被忽略的产物或其它目录。
HEAD 单独显示：仅改文档的新提交不会使代码检查失败。

检查另一工作树（只读其源码，结果文件在当前主目录）：

```powershell
python tools/scripts/project_baseline.py --repo C:/Users/Sakuya/.codex/worktrees/a61b/FPGA-Music-project --check C:/Users/Sakuya/FPGA-Music-project/notes/baselines/a61b-2026-10-09.json
```

6e70/eb59 用对应路径与快照；未提交成果也能被指纹检查覆盖。该工具未覆盖讨论文档；最新决定须读39号。

讨论收尾时，更新 39 号对应设计项的状态与差距；实现收尾时记录源码版本、必要判据和未验证边界。
有实质实现改动并验证后，用 `--write notes/baselines/<新日期或版本>.json` 建立新快照，再更新本文的入口。
工具拒绝覆盖已有快照，避免重写证据。不要为了让检查变绿直接重记基线。
