sakuyaShining/FPGA-Music-project-internal/docs/02-技术方案/25-音高与八度规格.md

# 音高与八度规格（键位表）

> **2026-10-09：本文存在旧稿残留（36/38 通道、音域终点、Shift），不可把所有段落叠加成现行规格。**
> 通道表与映射模块为 38 通道；单档为 24 半音跨度，默认 C3–C5，五档整体 C2–C8。Shift 是否保留未统一。详见 [39-设计账本 §3](39-最新设计构想与落地差距-2026-10-09.md)。

> 2026-10-05 起草案 · 本文是**契约**，不是描述：每一条都对应到可自动执行的判据（见第 7 节）。
> 适用对象：左手音高键位、修饰键、八度档、以及它们产生的音符事件。
> 不涉及：音色（谱形）、效果器、包络——那些属于引擎规格。

## 1. 目的与范围

把"演奏者按下某个物理位置 → 系统发出哪个音"这件事**完全确定下来**，包括边界情况（高音到头、修饰键中途变化、挂音防护）。改键位时只改本文，不改代码里的隐含约定。

## 2. 物理布局与通道分配

面板为两排、每排 13 个触摸位置，另加两个八度键与八个泛音键，合计 **36 通道**（三片 12 通道触摸控制器）。

| 通道 | 位置 | 功能 | 半音偏移 |
|---|---|---|---|
| 0 – 11 | 下排第 1–12 键 | 音高：C3 → B3 | 0 – 11 |
| 12 – 23 | 上排第 1–12 键 | 音高：C4 → B4 | 12 – 23 |
| 24 | 上排最右 | 单独的高音 C5 键 | 24 |
| 25 – 29 | 面板顶部音域条 | 音域档 5 格（−1 / 0 / +1 / +2 / +3） | 不发声 |
| 30 – 37 | 泛音排 | 泛音 1–8 掩码 | 不发声 |
| **合计 38** | | 四片控制器（48 通道，也是 I²C 地址数上限）余 10 个 | |

说明：

- **没有两个通道映射到同一个音**。高音端点 C5 由单独的通道 24 提供，而不是让两排都包含端点——若两个相邻物理键对应同一个音，按在交界处会同时触发两个通道，白白占用两个声部并发出两条 note-off。
- 每排是 12 个等宽键（C 到 B），加上右侧独立的高音 C 键，构成完整的两个八度加一个端点。
- 泛音键不产生音符事件，只改变当前声部的谱形掩码（对应 `0x5B` 与掩码通路）。

## 3. 音高计算与八度档

### 3.1 计算公式

```
音符号 MIDI = 48 + 半音偏移 + 12 × 档位
```

- 基准 `48` = C3
- 半音偏移：见第 2 节表格，取值 0 – 24
- 档位：见 3.2

### 3.2 音域条（八度档）

音域条是**绝对位置选择器**：5 个独立触摸格，每格对应一个八度档。触摸某格并**持续按住 ≥ 100 ms** 后，该档生效。

| 格 | 档位 | 相对基准 |
|---|---|---|
| 第 1 格 | −1 | 低一个八度 |
| 第 2 格 | 0 | 基准（上电默认） |
| 第 3 格 | +1 | 高一个八度 |
| 第 4 格 | +2 | 高两个八度 |
| 第 5 格 | +3 | 高三个八度 |

防误触要求（三条同时满足）：

1. **确认延迟**：按住不足 100 ms 的触摸**不改变档位**
2. **位置分离**：音域条布置在手掌正常活动范围之外
3. **逐格指示**：每格旁一个 LED，当前档位常亮

**不做连续滑条**：手工铜箔难以保证位置检测线性度；连续滑条还会带来"滑过一点就换挡"的风险。分格条天然离散、可靠、易标定。

### 3.3 档位表

| 档位 | 相对基准 | 音域起点 | 音域终点 |
|---|---|---|---|
| −1 | 低一个八度 | C2 (36) | C7 (96) |
| 0 | 基准（上电默认） | C3 (48) | C8 (108) |
| +1 | 高一个八度 | C4 (60) | C8 (108) 截断 |
| +2 | 高两个八度 | C5 (72) | C8 (108) 截断 |
| +3 | 高三个八度 | C6 (84) | C8 (108) 截断 |

- **整体覆盖 C2 – C8（MIDI 36 – 108）**，含钢琴最高音 C8，E7(100) 在内。
- **限幅规则**：计算结果 **大于 108 时不再发声**（不是夹紧到 108）。理由：夹紧会让最高档的多个键发出同一个音，演奏者会误以为按键坏了；不发声是明确的行为。
  - 注意：现有 RTL 的上限判断是"小于 108"（即最高 107）。按本文应为 **≤ 108**，需要一行改动。
- **档位边界**：在 −1 档再按降档、在 +3 档再按升档，**档位不变**（不环绕）。
- 上电默认档位为 **0**。

### 3.4 档位与曲谱播放

片内曲谱播放**不随档位移调**，始终按曲谱自身音高发声。理由：行为可预期；否则"先按档位再播放"的结果不确定，且可能把整首曲子推到音域之外。

## 4. 修饰键（Shift）

| 项 | 规定 |
|---|---|
| 功能 | 与音高键同时按住时，该音升高一个半音 |
| 作用范围 | 只对音高键有效；对八度键与泛音键无效 |
| 单独按住 | **不产生任何音符事件** |
| 中途变化 | 不影响已经按下的音：**以按下瞬间算出的音为准**（见第 5 节） |
| 组合顺序 | 先按 Shift 后按键、或先按键后按 Shift 均可；以**按键瞬间** Shift 的状态决定 |

## 5. 音符事件语义（防挂音）

这是全篇最容易出错、也最必须写死的一节。

1. **按下**时：计算最终音符号 → **存入该通道的锁存器** → 发出 note-on（含力度）。
2. **松开**时：**读锁存器**发出 note-off → 清除锁存器。
3. 因此：按下之后无论档位或 Shift 如何变化，松开时一定发出**同一个音**的 note-off，**不会挂音**。
3b. **八度档只在按下瞬间参与计算，绝不作用于已经在发声的声部。**
    这是一条实现约束，不是风格偏好：若把档位做成引擎侧的实时移调，换挡就会让所有正在响的音一起滑音（或集体变调），与演奏直觉不符，也会让 P12 失败。
4. 锁存器**每通道一个**（36 个），互不影响。
5. **重复触发**：某通道在未松开时再次被识别为按下，视为**同一次按键**，不重复发 note-on。
6. **声部不足**：当 32 个声部已满，引擎的声部抢占策略决定谁被替换；**事件本身仍照常发出**（即本规格不因声部不足而改变事件语义）。

## 6. LED 指示

### 6.1 v1：板载 6 颗灯，按模式切换

板上是 6 颗独立单色 LED（引脚 20/19/18/17/16/15），**共阳接法、低电平点亮**。
六颗灯要同时满足多种用途，数量不够，因此**按模式切换含义**：

| 状态 | led[5] | led[2:0] | led[3] | led[4] |
|---|---|---|---|---|
| **曲谱播放中** | 节拍闪（跟拍点脉冲） | 音高台阶的 3 位 | 音高台阶的第 4 位 | 音高台阶的第 5 位 |
| **手弹时** | 心跳（1 Hz） | 音域档图案（见 6.2） | 定序器运行 | 测试模式 |

说明：

- 曲谱播放时，**音高台阶**把「下一个音的绝对音高」映射到 6 档中的一档，亮对应位置；节拍闪跟着拍点脉冲（对应拓展要求 E7 的「规范演奏节奏」）。
- 手弹时，音域档优先——这是演奏中最需要看清的信息。
- **模式切换必须可辨**：两种模式下同一颗灯含义不同，因此切换瞬间要有明显不同（见判据 P16）。

### 6.2 音域档图案（手弹模式）

| 档位 | led2 | led1 | led0 |
|---|---|---|---|
| −1 | 灭 | 灭 | 亮 |
| 0 | 灭 | 亮 | 亮 |
| +1 | 灭 | 亮 | 灭 |
| +2 | 亮 | 灭 | 灭 |
| +3 | 亮 | 亮 | 灭 |

五个图案两两不同（判据 P10）。

### 6.3 v1.1：面板指示灯走 I²C 总线

音域条的 5 格指示灯与音高台阶灯条**不直接接 FPGA 引脚**，而是挂在**同一条 I²C 总线**上的一颗 PWM LED 驱动芯片（如 PCA9685，16 路、16 位亮度，地址可级联）。

理由：

- **不占任何新增引脚**（引脚已被 16 路电极占满，48/77 又留给触摸控制器）
- **真 PWM 调光**，因此可做：当前档满亮、其它档半亮、呼吸心跳、换挡渐变
- 与触摸控制器共用总线，只多一颗芯片

代价与约束：

- 与触摸数据**共用总线带宽**——触摸轮询必须优先于 LED 刷新（LED 30 Hz 足够）
- 必须在触摸通路在真板上跑通之后再接入，**不列入 v1 关键路径**

因此 v1 阶段面板上**预留灯的焊盘与走线**，控制器侧预留接口，避免后续返工。

### 6.4 极性

板载灯是共阳（低电平点亮）；自己焊的外部灯通常是**高电平点亮**（阴极接地）。
RTL 中两种极性必须分开处理，否则会出现「逻辑对了但灯不亮」。

| 档位 | 指示 |
|---|---|
| −1 | LED1 亮 |
| 0 | LED1 + LED2 亮（上电默认，双重确认） |
| +1 | LED2 亮 |
| +2 | LED3 亮 |
| +3 | LED3 + LED2 亮 |

规则：档位指示占用 LED1–LED3；其余 LED 保持原有用途（心跳、定序器指引）。具体灯位分配在实现时按现有 LED 驱动补全，但**"每一档必须唯一可辨"**是硬要求。

## 7. 判据清单

每条判据都要能自动执行、能判红。

| 编号 | 判据 | 输入 | 期望 | 如何测 |
|---|---|---|---|---|
| P1 | 键位映射正确 | 25 个音高键 × 5 个档位 = 125 组 | 音符号 = 48 + 偏移 + 12×档位，逐组相等 | 表驱动测试台 |
| P2 | 半音完整 | 遍历下排 13 键 | 12 个半音类各出现一次，C4 出现两次 | 同上，集合比对 |
| P3 | 档位语义 | 同一键在 5 个档位各按一次 | 音符号依次相差 12 | 同上 |
| P4 | 上限行为 | 档位 +2 / +3 下的高音区键 | 超过 108 的键**不发 note-on**；不夹紧 | 事件序列比对 |
| P5 | 档位边界 | 在 −1 按降档、在 +3 按升档 | 档位不变，无环绕 | 读档位寄存器 |
| P6 | 挂音防护 | 档位 0 按下 → 切到 +2 → 松开 | 恰好一条 note-off，音符号等于**按下时**的值 | 事件序列比对 |
| P7 | Shift 语义 | Shift + 各音高键 | 升半音；Shift 单独按住无事件 | 事件序列比对 |
| P8 | 非音高键不发声 | 八度键、泛音键 | 不产生任何 note 事件 | 事件序列比对 |
| P9 | **无同音通道** | 遍历 25 个音高键（同一档位） | 25 个音符号**两两不同**，无重复 | 集合比对 |
| P9b | 高音端点存在 | 档位 0 下按通道 24 | 发出 C5（音符号 72） | 事件序列比对 |
| P10 | LED 唯一可辨 | 5 个档位 | 指示图案两两不同 | 断言灯位向量 |
| P11 | **切档不产生事件** | 只按八度键、不碰音高键 | 事件序列为**空** | 事件序列比对 |
| P13 | **音域条防误触** | 触摸某格但按住时间 < 100 ms | 档位**不变** | 读档位寄存器 |
| P14 | **音域条生效** | 触摸第 5 格并保持 ≥ 100 ms | 档位变为 +3，且相应 LED 常亮 | 读档位寄存器 + 灯位向量 |
| P15 | **音域条不发声** | 只操作音域条 | 事件序列为空 | 事件序列比对 |
| P16 | **LED 模式切换可辨** | 在曲谱播放与手弹之间切换 | 两种模式下的灯向量**不同**，且切换后稳定 | 断言灯位向量 |
| P17 | **音高台阶映射正确** | 给定曲谱下一个音的绝对音高 | 亮起的档位与映射表一致（表驱动，遍历音域） | 表驱动测试台 |
| P12 | **跨档同时发声** | 档位 0 按下键 A → 切到 +1 → 按下同一物理键 → 依次松开 | 发出 note-on(A) 与 note-on(A+12)，两者在重叠期间**同时存在**；松开时各自发出对应的 note-off；切档本身不产生事件 | 事件序列比对 + 声部数检查 |

P11 与 P12 保证一件事：**换挡只改变「下一次按键算出什么音」，不会打断正在响的音**。这是演奏上的硬要求——如果换挡会掐断当前音，任何跨档乐句都会出现断音，乐器就没法正常演奏。

## 8. 与旧判据的替换关系

旧判据是针对五声音阶写的，改键位后其断言全部失效。替换关系必须逐条列出，避免"悄悄丢掉一条判据"。

| 旧判据 | 新判据 | 说明 |
|---|---|---|
| PS1（8 键对应 8 个五声音） | P1、P2 | 被表驱动判据覆盖，且覆盖更全 |
| PS2（力度 12/15） | 保留（并入 P1 的力度字段） | 力度语义不变 |
| PS3（按下/松开事件） | P6 | 增加锁存语义 |
| PS4（音高表逐项相等） | P1 | 由 8 组扩为 125 组 |
| PS5（八度档） | P3、P4、P5 | 原为未接线状态，现正式定义 |
| PS6（修饰） | 新增 P7 | 原来没有修饰键 |
| PS7（非音高键） | P8 | 原为遥测键，现增加八度键 |

## 9. 涉及文件、接口与预期

| 项 | 内容 |
|---|---|
| RTL 改动 | `src/rtl/pad_scan.v`（音高表、偏移、档位）、`src/rtl/tdm_top.v`（事件通路加锁存、档位端口、LED 指示） |
| 约束改动 | `src/constr/tdm_top.cst` 增加八度键引脚（或经 I²C 通道 26/27 提供） |
| 引擎侧 | **不动**（1739 行，9 个文件） |
| 资源预期 | 逻辑占用不超过 70%（当前 66%） |
| 时序预期 | SETUP slack 变动不超过 1 ns（当前 +16.039 ns）；以 `accept_all.ps1` 的实测为准 |
| 协议 | 若档位需要主机可读，使用保留地址新增一个只读寄存器 |

## 10. 已定项与后续版本

**2026-10-05 已定**（原未定项，现全部落定）：

| 项 | 结论 |
|---|---|
| 半音布局 | 两排全半音（每排 12 键）+ 右侧独立高音 C |
| 泛音键数量 | **8 个**（对应现有 8 位泛音掩码） |
| 音域条几何 | **5 格，每格 20×30 mm，置于面板顶部** |
| 板载按键 S2 | **进/出设定模式** |
| 是否加第三排 | **v1 不加**（音域条已解决可达范围；第三排只影响同时按宽和弦） |

**后续版本：**

1. I²C PWM LED 驱动（面板指示灯，见 6.3）——列入 v1.1
2. 第 6 格半音级微调（若要更细的音域调整）
3. 第三排（若要单手宽和弦）
4. 蓝牙 / 手机联动（拓展要求 E8 的选做项；「在线曲谱下载」已用串口实现）

## 10b. 原始未定项（存档）

1. **半音布局形态**：当前采用"两排全半音、每排 12 键 + 独立高音 C"。备选为"两排全音阶交错"（A 排 = C D E F# G# A#，B 排 = C# D# F G A B），其优点是任意音程指法一致、换调只需整手平移，代价是学习成本。
2. 泛音键的数量与排列（当前按 8 个设计）
3. 音域条的具体位置与格宽（需与防误触要求一起定）；是否需要一个第 6 格做半音级微调
5. 是否把面板扩为 3 排 × 12 键（三个八度同时可及，通道数逼近 48 上限）
4. 是否需要一个"低音档"把音域向下延伸到 C1（会增大限幅与判据范围）

## 11. 手工电极的几何约束（制造相关）

电容触摸对相邻电极的耦合敏感，手工铜箔面板需要遵守：

| 项 | 要求 | 原因 |
|---|---|---|
| 单键宽度 | ≥ 12 mm（建议 15 mm） | 手指接触面积与重复性 |
| 键间距 | ≥ 3 mm | 减少邻键耦合 |
| 键间隔离 | 相邻键之间铺设**接地走线** | 显著降低串扰，是电容触摸的标准做法 |
| 两排间距 | ≥ 25 mm | 避免手指悬停时误触另一排 |
| 引线 | 尽量短、远离音频与时钟走线 | 减少噪声耦合 |
