sakuyaShining/FPGA-Music-project-internal/docs/02-技术方案/47-纯滑条音高演奏三方案与制造边界-2026-10-15.md

# 纯滑条音高演奏：三方案与制造边界

> **范围纠正/后续替代**：本文原先围绕少量全音域条及单条多指展开，源于助手误解，不是用户改变原两八度逐音设计。用户最新明确两排逐音滑条覆盖两个八度＋一条八度切换滑条；三版选型须以同一布局完整比较。最新有效入口为[48号](48-两八度逐音滑条三版选型设计-2026-10-15.md)。本文商城来源及错误检索证据仍可参考，4/8条规模例子和布局待选叙述不再用于定案。

状态：**讨论中**。用户已取消钢琴键，滑条演奏为**待实现**目标。用户后续明确“三板”是指**三套方案**，不要求制造三块实物板。用户询问两种滑条布局的含义，目前尚未选定；以下提供三个传感架构供实质比较，不是三个已完成PCB。

布局释义：多条独立滑条是多个分开的手指触摸/滑动区域，候选每条一次跟踪一个触点，各条可同时控制不同音；各条可配置相同音域，不要求一条固定对应一个音名或预设。单条多指滑条是一个共享连续区域，同时获取多个触点的位置及身份，每个触点独立控制一个音；需要多触点空间分离及追踪能力，单一电位器输出或单一重心不能直接满足。滑条在此指手指触摸的感应区域。四条示例不代表数量冻结，也与四预设槽数无绑定关系。两种布局与A/B/C三种传感架构是不同设计维度，并非一一对应。

## 1. 共同边界

Nano20K发声与触控算法；不增加计算MCU。屏/喇叭复用。保留逐音滑动、手动颤音、自定义乐器和音色分层；真实压力未有传感证据，不从电容量或接触面积推定。整机最坏触摸到声音≤10ms，包含传感、判定、通信、事件队列和音频，单元转换速度不能单独签收。

若使用多条单触点滑条，每条本身就是一个控制身份，可在FPGA绑定多个音符/层；若要求同一条多指独立，需要额外空间观测和触点分离，三个电极的单一重心不满足。音色分层不自动增加可跟踪的物理手指数。滑条绝对位置选音、落指量化/之后连续、每条固定基音相对弯音是不同音乐规则，尚未替用户选择。

## 2. 三个传感架构

| 方案 | 结构与商城候选 | 优点 | 主要缺口 | 当前建议 |
|---|---|---|---|---|
| A FPGA直接测量电容 | 定制PCB电极＋CD74HC4067M96 C496123（需要复用时）＋SN74LVC14ADR C133541＋外部RC | 主要算法和采样时序自有；电极可按布局制造；IC成本低 | 门限/寄生/干扰、多条时序、位置分辨率均需原型；不是成熟触控芯片替代品即插即用 | 低成本原型候选；未有实测前不作为最终量产承诺 |
| B 原始CDC＋FPGA位置算法 | 定制PCB电极＋AD7147ACPZ-1500RL7 C207411（SPI，LFCSP24） | 测量前端有正式规格，使用原始CDC结果计算位置；少量滑条时芯片数量可能合理 | 仍需电极/标定；QFN焊接与实际报价；内部自动基线/阈值不作为FPGA算法替代；具体禁用/读取配置待核对 | 少量独立条值得优先对照；芯片数随电极数/扫描预算算，不沿用旧24键规模结论 |
| C 膜式位置电位器＋ADC | ThinPot TSP-L-0050-103-3%-MP C17239514（50mm）＋多通道SAR ADC | 有现成线性位置传感器；FPGA处理电压采样与演奏语义 | 当前该条缺货/仅参考价；按压手感/有效行程；ADC及释放判定；若多条要累计逐条成本 | 保留技术对照，当前不能作为可下单主BOM |

方案B的AD7147（无-1）为SPI；AD7147-1是I²C，不能直接换协议。C207411对应1500RL7包装，C456284对应500RL7包装，不因核心型号相同就抄库存/价格。FDC2114RGHR C2652079及FDC2214RGHR C913845可读原始量，但每片4通道及LC网络增加规模，保留备选，不另外包装成已经满足成本/延迟的第四定案。

## 3. 实际查询的候选身份与供货观察

以下是本轮公开商品页观察，页面可能缓存；国际站库存与USD价格不等于中国站可结算报价，不据此冻结采购。所有参数最终以所列厂家手册及实物为准。

| MPN / C编号 | 包装 | 公开页面观察 | 来源 |
|---|---|---|---|
| CD74HC4067M96 / C496123 | SOIC24-300mil | 有库存；1+ USD0.6635，MOQ1 | [LCSC](https://www.lcsc.com/product-detail/C496123.html) |
| SN74LVC14ADR / C133541 | SOIC14 | 有库存；5+ USD0.2514/片，MOQ/倍数5 | [国内商城](https://item.szlcsc.com/144847.html)、[国际站](https://www.lcsc.com/product-detail/C133541.html) |
| AD7147ACPZ-1500RL7 / C207411 | LFCSP24 4×4mm | 有库存；1+ USD5.3468 | [LCSC](https://www.lcsc.com/product-detail/C207411.html) |
| AD7147ACPZ-500RL7 / C456284 | LFCSP24 4×4mm | 缺货；USD6.9985仅参考 | [LCSC](https://www.lcsc.com/product-detail/C456284.html) |
| TSP-L-0050-103-3%-MP / C17239514 | 膜式传感条 | 缺货；USD13.3441仅参考，50mm | [国内商城](https://item.szlcsc.com/18368621.html)、[国际站](https://www.lcsc.com/product-detail/C17239514.html) |
| FDC2214RGHR / C913845 | WQFN16 4×4mm | 有库存；1+ USD6.3908 | [LCSC](https://www.lcsc.com/product-detail/C913845.html) |
| FDC2114RGHR / C2652079 | WQFN16 4×4mm | 国内页已核型号/封装；公开目录显示缺货，未得有效国内价 | [国内商城](https://item.szlcsc.com/2743988.html) |

ADC128S022系列/国产XADC128S022-XC C53026457仅为方案C后续ADC候选，未完成手册、价格和完整模拟链审查；不放入已定BOM。

## 4. 规模与延迟如何计算

用`S`表示滑条数，`E`表示每条独立测量电极数；总节点`N=S×E`，不含右手及八度/设置。`E=3`只是小样候选，长滑条可能需要更多分段，不能先承诺长度再硬塞3电极。

- A：`B`条并行测量路径、每路径最大`K=ceil(N/B)`节点，则一轮约`K×(切换稳定＋放电＋充电计时＋读回)`。必须有实测上界，27MHz本身不证明足够快。
- B：AD7147在decimation64时，每转换阶段表列0.768ms，6阶段4.608ms，12阶段9.216ms；若采用每芯片6阶段并行，所需片数至少`ceil(N/6)`，仍须考虑芯片扫描/数字滤波的触摸响应及后续判定/读回，不把4.608ms当端到端测量。13输入不等于13个独立完整结果的同周期承诺，转换阶段与电极拓扑必须明确。
- C：ADC总吞吐按条数共享，计入通道切换后的RC稳定、采样保持建立、释放检测与滤波；12bit不等于12bit有效音高精度。单条电位器输出不能默认分辨同条两个手指。

仅举算例（不是用户已选布局）：4条×3电极=12节点，B用2片各6阶段；8条×3=24节点则4片。旧两排24～26滑动键的72～78节点估算不再作为新布局预算。换成少量独立条可能显著减少前端规模，需用户决定交互后再算。

## 5. 500元制造预算控制表（上限分配，非真实报价）

沿用此前“新增采购总预算”保守口径，已有Nano20K/屏/喇叭不重复计；在用户明确仅音高区预算前，不把500元全部花在音高滑条上。实物板数量、滑条尺寸、条数尚未确定，因此本表只能约束设计支出。

| 项目 | 分配上限（元） | 覆盖 |
|---|---:|---|
| 传感前端/ADC等核心器件 | 120 | 选定一个主方案，含MOQ/备件；不同时购买三方案全量 |
| PCB小样＋正式板 | 100 | 层数/面积/最小出货数量和重复打样都计；三块板是否够用待实际报价 |
| 焊接/装配 | 50 | 需要QFN时核实SMT或有能力的手工装配；不假设已有工具 |
| 连接器/阻容/保护/线材 | 50 | 原理图完成后落到具体料号 |
| 覆盖膜/固定结构 | 30 | 不含未经报价的大型外壳 |
| 运费 | 30 | 计PCB/物料分开发货 |
| 其余整机控件/接口预留 | 60 | 四槽/编辑/恢复等控件及必要适配 |
| 返工和波动预备 | 60 | 不先花满 |
| 合计 | **500** | 不以优惠券或国际站参考价冒充国内制造总价 |

超过某项上限时先换封装/料号或重新分配，不能静默减少多指/表情/可视化等已要求能力。预算内是否能完成必须以完整BOM和制造计价核实，现阶段不是已取得500元报价。

## 6. 制造方案的交付条件

最终制造包至少应有：已确认交互边界、传感器/电极/前端拓扑、精确BOM与替代项、EDA原理图与PCB、引脚与供电表、ERC/DRC及网表核对、制造文件、装配接线、位置/延迟验收方法、国内可结算报价与文件身份。

当前尚缺关键交互边界、EDA客户端、传感实测、国内完整报价，故**不满足用户“无未明确边界再制作最终制造方案”的条件**。可以交付架构比较、预算约束和接入工作流，不伪造已签收Gerber或最终型号。下一步先收到“三板”和滑条触点布局答复，再补条数/有效行程/起音音高规则，随后落实一个主方案的可审阅原理图和试制BOM。

## 7. 资料与验证边界

厂商资料：[AD7147表10及原始CDC](https://www.analog.com/media/en/technical-documentation/data-sheets/ad7147.pdf)、[Microchip滑条布局](https://www.microchip.com/content/dam/mchp/documents/TXFG/ApplicationNotes/ApplicationNotes/Capacitive-Touch-Sensor-Design-Guide-DS00002934-B.pdf)、[TI 4067](https://www.ti.com/lit/ds/symlink/cd74hc4067.pdf)、[TI LVC14A](https://www.ti.com/product/SN74LVC14A)、[FDC2x1x](https://www.ti.com/lit/ds/symlink/fdc2114.pdf)。公开商城身份/报价筛选已做，不等于原型验证。本轮无产品RTL/约束/参数表/主机协议变更，无新综合、板验或听感签收。
