sakuyaShining/FPGA-Music-project-internal/docs/02-技术方案/51-四滑条小样电路与整机接口候选-2026-10-15.md

# 四滑条小样电路与整机接口候选

> **2026-10-15接线增量优先阅读**：三页草稿53个元件已接线，207接线引脚＋24明确NC、59个网络；原生Protel网表独立逐引脚0差异，原生规则检查0项，仅为图纸范围**已验证**。交付`hardware/pitch-sliders/prototype-schematic-20261015/`；新增J1是12针逻辑主机线缆口，J2是12电极试验板连接口，不能套用下面旧20针示意。未用模拟通道I9～I15在当前草稿明确NC，未实际创建测试焊盘；ESD/电极封装/最终Nano引脚/PCB待完成，尚不能制造。用户新增录音/回放/曲谱需求及板载TF预留见57号。

> **恢复选型进展**：用户现已恢复选型，[56号](56-嘉立创硬件选型恢复与关键料审阅-2026-10-15.md)记录18种库身份、12件关键料审阅页/原生BOM、129引脚读回和新B2按压旋钮候选。尚未连线/ERC/PCB；本稿“无嘉立创工程/命令空间缺失”是此前状态。完整规模每路改列2个校准负载，避免26音位例超出128总节点；小样3负载保留。旋钮A/B/按压上拉、缺货阻容替代等以新审阅包为候选，不将本稿旧表直接下单。

状态：**讨论中/待实现**。本轮已生成可审阅的BOM与逻辑引脚连接表；尚无嘉立创工程、ERC/DRC、PCB/Gerber或采购订单，不是最终制造包。

## 1. 已确定的输入条件

- 产品继续两排、共两八度的逐音滑条，并有独立八度选档条；小样只有4条用于测量，不缩减完整产品音位。
- 用户新明确八度条无需测力，仅选择档位；可评估分段电容位置条，不再采购压力测量ADC/测力器件。最终档数/在奏音切换规则未定，不能凭例子冻结五档。
- 增加带按压旋钮；断电重启恢复保存的自定义乐器是需求。
- 预算仍约500元，包括小样与后续制造的总支出；已有Nano、屏和喇叭排除。没有完整人民币报价，不能把国际站USD或预算分配当结算价。

## 2. 小样候选电路

建议90×100mm范围内研究4条相邻滑条，每条候选有效区48×12mm、中心间距18mm、3个插值电极，共12个原始节点。上述尺寸为实验初值，不是用户已签收的人体工学/最终面板。电极参考[Microchip AN2934](https://www.microchip.com/en-us/application-notes/an2934)的自电容滑条/插值原则；专用触摸芯片参考设计的效果不直接继承到本RC前端。

电气分两路并行，每路两个滑条、6节点：

`电极 → 候选1k串联保护电阻 → CD74HC4067 → 公共RC节点 → SN74LVC14A → 候选220Ω数字串阻 → FPGA计时`

`锁存输出RC_DRIVE → 候选47k测量电阻 → 公共RC节点`

每路MUX的I6/I7/I8分别接10/47/100pF C0G参考负载；I9～I15留模拟测试焊盘，仍按完整16地址时序扫描。参考电容只验证测量链，不代表人体触摸信号或手感。

FPGA负责切换前禁用、地址和充放电控制、整形信号同步/计时、超时、基线、位置与接触判定。RC_DRIVE由锁存器输出，输出延迟计入计时起点；不能假定从FPGA发串行字的首位开始就已改变电极电压。

全规模例8路并行、16地址，目标一帧≤2ms时每地址≤125µs；小样同样扫描16地址，但只有两路实物前端，不冒充完整8路并发噪声/负载验证。两帧确认占约4ms仅是规划，必须再计入事件和音频，实际触摸到声音≤10ms尚未验证。

### 本轮识别的模拟风险

[4067手册](https://www.ti.com/lit/ds/symlink/cd74hc4067.pdf)给出典型公共端电容50pF；这与走线、输入、电极寄生共同降低小触摸增量的相对占比。[LVC14A手册](https://www.ti.com/lit/ds/symlink/sn74lvc14a.pdf)的输入漏电和阈值随指定条件变化，MUX亦有漏电；因此不能无限增加R来换计数灵敏度。

`rc_sensitivity.py`仅做集总RC敏感性算例：100pF基线/5pF增量、27MHz计数、假设阈值2.0/0.6V及不同漏电压力条件。不同器件手册限值的条件不相同，算例不是3.3V整机保证，更不是SPICE。较大R可能使充/放电无法跨过阈值；47k初值亦未资格确认。原理图评审和实测后才能确定R、阈值处理及是否改更低漏电前端。没有测量证据时不释放制造定稿。

覆盖层先比较薄绝缘膜与不同厚度样片，检查静按漂移和往返位置；不把裸铜直接触摸的小样结果继承到最终面层。屏/功放运行干扰、相邻多指、湿手与边缘误触另测。ESD器件需按电容/漏电选型；芯片HBM参数不等于面板已通过系统ESD。

## 3. 候选关键料与用途

| 小样器件 | 数量 | 商城参考料号 | 当前边界 |
|---|---:|---|---|
| CD74HC4067M96 | 2 | C496123 | 官方商城及社区目录身份核对；模拟性能待测 |
| SN74LVC14ADR | 1 | C133541 | 官方商城型号/封装可核；本次社区查询无命中，不填作匹配成功 |
| SN74LV595ADR | 1 | C205940 | 地址/禁用/驱动锁存候选；须核3.3V时序和封装 |
| SN74LV165ADR | 1 | C273656 | 4预设＋编辑＋编码器A/B/按压共8输入；须核最大旋转速度 |
| 24LC256-I/SN | 1 | C411625 | SOIC-8、32KiB I²C存储候选；报价和供货须在国内实际复核 |
| 带按压旋钮 | 1 | 待选 | 已明确需要，轴高/开孔/脚距未定；不能沿用任意EC11封装 |

生成文件见`notes/slider-prototype-20261015/`：

- `bom-review.csv`：数量、参考器件、封装和官方手册来源；未核通用阻容/编码器的具体商品号不伪填。
- `connections-review.csv`：按器件实际引脚号列出的逻辑连接。J_FPGA编号只是候选连接器编号，**不是Nano排针位置或FPGA封装管脚号**。
- `review-status.json`：只检查列表一致性/重复引脚，不替代ERC。
- `rc-sensitivity.json`：理论敏感性算例，不能签收传感性能。

本轮[商城4067](https://www.lcsc.com/product-detail/C496123.html)公开页为USD0.6635起、[LVC14](https://www.lcsc.com/product-detail/C133541.html)为5件起USD0.2514；社区装配库存/价格与商城不相同。仅说明有参考供应，不转换成国内总价保证。小样元器件采购最小量、PCB、焊接、面层和运费必须合并报价，不能把用量当购买量。

## 4. 保留整机扩展的接口方案

完整8路感测直连方案与屏/实体操作/存储约需29信号，超过现规划外接18GPIO。候选使用带锁存595和并载165，共享显示SCK/MOSI；全规模计数约18信号，详细预算见50号。小样只装2路感测，接口为其余6路预留逻辑连接，但尚无物理引脚表。

595必须在完整控制字移入后才锁存，禁止屏幕像素传输改变地址/驱动；165每次先并载、再按正确相位读回。读取实体输入的周期与编码器防抖另定，不能等一帧屏幕发完才扫描。低速和高速阶段的时序须依LV型号3.3V数据核对，不把普通HC的高电压典型速率直接套用。

串行移位/电平整形属于电气外围，扫描、触点位置、手势、音符和显示仍由FPGA计算。新增外围不授权引入计算MCU。

## 5. 断电保存的候选实现

[24LC256手册](https://www.microchip.com/content/dam/mchp/documents/MPD/ProductDocuments/DataSheets/24AA256-24LC256-24FC256-Data-Sheet-20001203W.pdf)列出2.5～5.5V、400kHz、64字节页、页写最长5ms。候选3.3V、SDA/SCL各4.7k上拉、地址0x50；原理图仍须核对总线电容与模块上拉。

建议每槽采用两份带版本/长度/序号/校验/提交标记的记录，先写非活动副本，读回校验后最后提交；启动选择完整有效的新记录。4槽×2副本×每份2048字节的候选配额为16KiB，32KiB候选容量尚有余量，但最终配置格式未冻结，不能把2048字节当用户自由度上限。

只在明确保存操作后写入，演奏时的连续表情不逐帧写EEPROM；I²C与页写等待使用非阻塞控制，不停止音频。掉电中断写入应保留上一份有效乐器；若两份都损坏，有明确错误与出厂预设恢复路径。记录层不是掉电前自动保存所有未提交编辑的承诺。

## 6. 下一步与放行条件

先补屏幕型号/接口并完成全机资源/引脚预算；修复嘉立创编辑器命令空间连接后，新建小样工程，核对库符号/封装与实际引脚，绘原理图、ERC、PCB/DRC和真实报价。当前CLI服务connected=true且版本匹配，但两次隐藏编辑器启动都报`BRIDGE_NOT_READY / command-space-missing`，无有效session；已请求用户手动进入编辑器，不能宣称已接通绘图。

小样需通过位置连续、多指相邻独立、静按/释放、噪声与全规模扫描预算，再选完整前端。完整面板还要实际组合PnR、真实≤10ms、总预算与制造评审。三版候选比较继续保留，不把第一版的设计文件当成传感性能通过。
