sakuyaShining/FPGA-Music-project-internal/docs/02-技术方案/58-右手泛音触控区域与音高滑条组合候选-2026-10-15.md

# 右手泛音触控区域与音高滑条组合候选

状态：**讨论中**，器件组合为具体候选，尚未替换现有原理图或形成采购定案。用户澄清“触控屏幕”指进行泛音构造的右手区域，不能继续当成只询问已有音乐可视化TFT是否有触摸。

**后续用户决定与筛选结果**：用户已明确右手需要在手指下方直接显示泛音图形；纯触控面板不再作为该区域替代。较新的3.5英寸/2.8英寸筛选、立创实际库存、双显示器预算，以及GT911上报周期资料修正见[59号](59-右手触摸显示区商城筛选与接口预算-2026-10-15.md)。下文“是否需要本地显示”是较早未决状态，已被该决定解决；尺寸/型号/是否最终合屏未冻结。

## 1. 已有事实与不能混淆的部分

- 已有YT240L008N为用户确认的ILI9341无触摸显示屏；左手四滑条RC小样已完成图纸连通检查。
- 右手多触点、全和弦修饰、松手保持、RESET平滑恢复保留。V1.0的二维选组/纵向相对调整、每组单编辑所有权等按原讨论状态阅读，不借选型冻结新手势。
- 先前8组×3电极=24节点是容量算例，**没有选定一块二维多点触控屏**；三个自电容电极的一维条也不能直接等同任意二维多指触摸屏。
- 用户这次澄清不等于已经选定两块LCD、替换已有TFT、右手尺寸或增加预算。下面以右手区域可显示泛音图形并触摸作为一种具体候选；若仅需触控平面而无显示，选型应另列纯传感面板。

## 2. 具体组合候选：独立多点触控屏＋PCB逐音滑条

| 区域/器件 | 型号与参数 | 采购/接合状态 |
|---|---|---|
| 右手泛音触控屏 | Waveshare **2.8inch Capacitive Touch LCD，SKU27579**；ST7789T3显示＋CST328触摸；240×320，横屏320×240；厂家标称5点触控；显示SPI、触摸I²C；模块50.54×73.06mm，显示区43.20×57.60mm；厂家标称3.3V/5V输入 | 新增候选，未采购；不是ILI9341驱动直接即插即用；手指间距与右手操作面积待实测 |
| 左手逐音滑条 | 定制PCB自电容，25/26音位两例，每音位3电极，保留两排各完整八度；小样仍4条×3节点，48×12mm有效区/18mm中心距为实验初值 | 已有小样草稿；原始传感/定位/延迟待验证 |
| 左手/八度模拟复用 | **CD74HC4067M96 / C496123**，小样2颗；完整新组合6颗为容量例 | 本轮不把原8路示意BOM直接删成6路，不更改原理图 |
| RC输入整形 | **SN74LVC14ADR / C133541**，小样1颗；6路例1颗六门可供6路 | 漏电、阈值、噪声/供电干扰待测 |
| 扫描锁存/实体输入 | **SN74LV595ADR / C205940**、**SN74LV165ADR / C273656**，各1颗 | 沿用候选，时序与总线仲裁待实现 |
| 八度选择 | 独立位置/接触条，不测力；用5节点仅作预算例 | 档数/尺寸不冻结 |
| 参数存储 | **24LC256-I/SN / C411625**，32KiB I²C | 与右手触摸同总线是候选，地址、电平、并联上拉和总线服务延迟须核 |

[微雪官方产品资料](https://www.waveshare.com/product/displays/lcd-oled/2.8inch-capacitive-touch-lcd.htm)的搜索缓存提供上述模块身份/参数；直接页面读取返回403，未绕过，也未据缓存判断实时库存或国内成交价。[官方模块原理图](https://files.waveshare.com/wiki/2.8inch-Capacitive-Touch-LCD/2.8inch_Capacitive_Touch_LCD_Sch.pdf)可读取。不得混买同厂带ESP32/RP2350开发板的型号，亦不能将ST7789T3+CST328写成ILI9341+FT6336。规格可能依模块版本变化，采购前仍需核实实物版本与参考程序。

CST328先提取触点坐标，FPGA再做触点状态/所有权、泛音映射与音乐处理。这与原始电极全部由FPGA处理不同，是架构候选调整；虽然未增加通用计算MCU，也不能声称所有原始触控计算都在FPGA。屏幕显示更新与触摸报告率是两个指标；当前未取得足够资料/实测证明CST328的最坏报告周期和端到端≤10ms，因而不能签收。

## 3. 通道/接口重新核算

右手由独立I²C触控控制器提供坐标时，原24个RC节点不再计入同一个模拟前端。以每音位3电极、八度5节点、每路2个参考负载为例：

- 25音位：75＋5=80感测节点。
- 26音位：78＋5=83感测节点。
- 6颗4067有96地址，每路保留14/15两个参考地址，余84个感测位置，可容纳上述两例；两个例子余4/1位置。
- 六个计时输出由一颗六门LVC14提供。跨路标定、所有电极的扫描/串扰/位置算法仍需验证；容量足够不代表传感已达标。

原18逻辑GPIO例：共享显示/移位SCK及MOSI2＋595锁存1＋165并载/串行输入2＋原始计时8＋LCD CS/DC/RST3＋I²C2。将计时8→6可空出2逻辑GPIO，用于TP_INT与TP_RST；触摸SDA/SCL与EEPROM共用则示例仍为18。以上假设只有一条显示输出、显示只写不接MISO、背光无需新增GPIO、八度节点不超过容量，且还未分配真实Nano管脚。

若已有YT240L008N与新触摸屏都要同时显示，就属于双屏方案，必须另算CS/DC/RST、实际写入带宽、渲染及FPGA资源；不能套用18GPIO单屏例宣称直接可接。共用SPI也不会把两块屏的带宽变成两份。是否复用一屏显示泛音/可视化、保留两屏或采用纯触摸面板仍待确定。

## 4. 其他候选的排查结果

- XPT2046四线电阻触摸的常规单触点方案不能当作右手多点二维需求已经满足；不因便宜而默默削成单指。
- 更大的纯触摸面板参考 **Orient Display CTP043B0**：4.3英寸、GT911、I²C、3.3V、5点，盖板105.5×67.2mm；它是触摸面板而非完整LCD，厂家页面当前缺货、美国发货，不列为500元预算的采购首选。[厂家资料](https://orientdisplay.com/products/4-3-capacitive-touch-panel-ctp043b0/)
- [汇顶官方](https://www.goodix.com/en/product/touch/touch_screen_controller)列GT911报告率100Hz；若实际模组上报周期为10ms，不能保证再加读取/处理后的最坏≤10ms。后续取得的模组厂家公开手册有`0x8056`的`5+N ms`周期配置，不能将100Hz概述当成不可更改的芯片极限；资料差异、实际配置和端到端验收见59号。触摸控制器名称不能替代具体面板报告周期/抖动/丢点验收。
- 普通4.3英寸800×480 RGB整屏会增加数据/IO和缓冲需求，不因为“更大”直接替换当前SPI屏。

## 5. 预算与下一步

新增右手触摸屏的国内含运价、连接器和触控驱动开销尚未取得；原500元预算只排除了原有Nano、屏、喇叭，新购另一块屏必须真实加入，不能宣称组合已满足500元。减少模拟前端可能省料，但不能以未报价的节省抵消屏幕费用。

下一步优先核对右手是否需要本地显示、操作面积与同时触点目标、报告周期及10ms预算；再确认对应模块国内版本/报价、总线/真实引脚、联合综合PnR。已有四滑条小样仍可推进，不先购整机面板或改已审阅原理图。若严格≤10ms为不变硬门槛而成熟屏触摸不满足，须换可证明更快的触摸前端或继续FPGA原始感测路线，不能以屏幕标称多点取代延迟验收。

本轮主目录HEAD `fe326ad9505c94f46f9236bf7f9bfc3b5f1b9a12`，192输入基线PASS；仅用户术语澄清、候选资料与容量/接口算例，无RTL/约束/原理图改变、无采购及新增硬件验证。原型53元件/231引脚的图纸验证不扩展为本候选组合已验证。

## 6. 嘉立创平台承担范围

状态：**讨论中**。右手泛音触控区可以以嘉立创体系为主要选型、接板和制造工作流；尚未证明所需完整触控模组能在商城直接买齐。

- 立创商城：筛选匹配的多点触控面板/成品模组，核对资料、接口、尺寸、库存及含运价格。优先完整匹配的面板与控制器组合，单独选定触控芯片不等于已经得到可用触控面板。上一节微雪型号仍只是外部参考候选，未确认商城有对应在售料号。
- 嘉立创EDA：建立连接器、供电、保护与SPI/I²C接口，纳入原理图、PCB和BOM，检查实际模块电平、引脚和安装尺寸。
- 嘉立创PCB/SMT：制作载板/转接板及左手铜电极滑条，按实际工艺与BOM报价。普通PCB下单不能视为已包含定制TFT液晶玻璃或多点触摸玻璃总成；若完整面板需外购，仍可在嘉立创设计其接口与配套板。

下一步先查商城可供的完整多点触控组合，再逐项核对操作面积、触点稳定性和报告延迟；未找到合适现货时再对比外部成品模组。总预算约500元与端到端延迟目标分别验收，平台选型成功不代表这两项目标已达成。本节未新增采购、音乐交互决定或硬件实现。

服务依据：[嘉立创平台](https://www.jlc.com/)、[PCB/FPC/SMT工艺能力](https://www.jlc.com/portal/vtechnology.html)、[嘉立创EDA PCB下单说明](https://docs.lceda.cn/cn/PCB/Order-PCB/)。
