sakuyaShining/FPGA-Music-project-internal/docs/02-技术方案/59-右手触摸显示区商城筛选与接口预算-2026-10-15.md

# 右手触摸显示区：商城筛选与接口预算

状态：**讨论中**。用户已决定右手泛音构造区必须在手指下方直接显示可操作的泛音图形；纯触控平面＋另一块屏反馈不作为这一区域的替代。器件尚未采购、未冻结尺寸和触点数，也未完成制造定案。

**较新核对**：见[60号](60-整机选型收尾与真实排针核对-2026-10-15.md)。F款SKU30896官方资料列5V供电/3.3V逻辑、显示窗口49.36×73.84mm；下表此前借通用3.5英寸/DFR0669的73.44×48.96mm作面积例，不能用于F款开孔。新取得国内官方搜索索引107.06元参考价，仍无库存/结算证明；双屏GPIO另有共享DC/复位经595的17脚候选及真实排针位置，原21脚仅为较早独立控制预算。旧源码“27～42全在排针”的注释已发现不准确，实际接法依60号核对且尚待实现/实测。

## 1. 本轮收敛结果

优先验证**3.5英寸、五点电容触控、带显示显存的SPI模组**，2.8英寸五点为紧凑备选。这是工程推荐，不是用户已决定的屏幕尺寸或五指同时操作规则。屏幕控制器负责像素存储，触控控制器负责提取坐标，音乐及手势解释仍由FPGA承担；没有引入通用计算MCU。

| 候选 | 显示/触控 | 显示区（横屏） | 供货、价格证据 | 本轮判断 |
|---|---|---|---|---|
| Waveshare **3.5inch RPi LCD (F)，SKU30896** | ST7796S＋GT911；480×320；SPI显示/I²C触控；厂家标称5点 | 73.44×48.96mm | 官方国际页标价USD19.99；国内C号、含运人民币价及库存未核实 | 较大面积优先候选；须核对RGB565配置、模块接口/供电、触控上报与国内报价 |
| DFRobot **DFR0669 / C17641738** | ILI9488＋GT911；480×320；SPI/I²C；厂家标称5点 | 73.44×48.96mm；模块95×55.5mm | 立创公开商品数据精确MPN/C号匹配，当前库存0；厂家国内自营页标价**169元、有货**，未进入结算 | 有明确国内价格的采购参考候选；显示发送需按RGB666三字节评估，不直接套用已有ILI9341驱动 |
| Waveshare **2.8inch Capacitive Touch LCD，SKU27579** | ST7789T3＋CST328；320×240；SPI/I²C；厂家标称5点 | 57.60×43.20mm | 官方国际页USD16.99；国内商城完整料号/人民币含运价未知 | 紧凑备选；报告时序和指腹遮挡待验证 |

厂家依据：[微雪3.5寸F款](https://www.waveshare.com/product/displays/lcd-oled/3.5inch-rpi-lcd-f.htm)、[DFR0669资料](https://wiki.dfrobot.com/dfr0669/)、[DFR0669国内自营](https://www.dfrobot.com.cn/goods-2877.html)、[微雪2.8寸](https://www.waveshare.com/product/displays/lcd-oled/2.8inch-capacitive-touch-lcd.htm)。微雪本轮网页直接读取有403，规格/美元标价来自官方搜索索引，不当成实时库存或国内报价；未绕过访问限制。DFRobot自营页面通过公开HTTP实际读取并留存。

立创页：[DFR0669](https://item.szlcsc.com/18770998.html)。公开SSR包含`productModel=DFR0669`、`productCode=C17641738`、`stockNumber=validStockNumber=0`。保留`encaptionPrice`但不把它直接当成交单价。零库存结论只针对查询时的国内商城，不扩展为所有渠道缺货。

## 2. 具体排除和降级

- **HS28B03A / C42432560**：商城挂载的汉昇手册封面是**HS28B03ASRN**，后缀R为电阻触摸；G才表示GT911多点。手册描述了可选多种配置，不能把基础商城型号、家族可选功能和五点成品混为一谈。五点SGN/IGN配置只是依命名推导出的询价方向，没有已核实的在售C号。本轮不纳入可直接下单的五点清单。[商城托管厂家手册](https://atta.szlcsc.com/upload/public/pdf/source/20250102/A36DE46EC42CDC76F150F51E9212C5B9.pdf)
- **LCKFB-st7789-2.0inch-screen / C53184555**：商城精确身份和当前1434库存可读；厂家文档为2英寸、ST7789V2＋FT6336，有效区40.8×30.6mm。资料未证明该模块达到五点，面积也更小，降为接口/开源参考，不因有现货替代多点需求。[立创开发板文档](https://wiki.lckfb.com/zh-hans/fdb/lckfb-st7789-2.0inch-screen.html)
- 微雪 **3.5inch Capacitive Touch LCD / SKU29318** 是ST7796S＋FT6336U，官方明确两点；**SKU30896的F款**才是本轮五点GT911候选，不能只按“微雪3.5寸电容屏”购买。[29318官方规格](https://www.waveshare.com/3.5inch-capacitive-touch-lcd.htm)
- XPT2046/HR2046常规电阻单点、额外MCU开发板、HDMI/DSI整屏不因便宜/同尺寸自动替换当前接口路线。

## 3. 操作面积比像素数更直接

以尚未冻结的8逻辑组横向显示作几何算例：3.5英寸每组9.18mm，2.8英寸每组7.20mm；若16列同时直接编辑，则分别仅4.59/3.60mm，尚未扣除边框和间隙。五点上报不等于五指可以舒适地并排操作。

因此推荐优先评估3.5英寸的触点移动、邻区误选及手指遮挡。8组、16列、分组或翻页属于UI候选，不在选型过程中擅自冻结，也不改变全和弦修饰、松手保持与RESET平滑恢复。已生成[实际尺寸A4比较图](../../hardware/right-touch/selection-20261015/touch-area-actual-size.svg)，按100%打印并核对50mm标尺；它不是模块开孔或PCB外形图。

## 4. 延迟结论修正与验证入口

此前58号按[汇顶官网GT911标称100Hz](https://www.goodix.com/en/product/touch/touch_screen_controller)指出10ms周期已经占满预算，该推论只在实际模组采用10ms上报时成立。**不能据此断言GT911没有更快配置。** DFRobot公开提供的GT911手册，寄存器`0x8056 Refresh_Rate`注明周期为`5+N ms`；另有按下/松开去抖`0x804F`、滤波`0x8050`和低功耗`0x8055`。这为更短周期提供了资料线索，仍不证明具体量产模组的固件、配置、五点噪声条件下会稳定实现5ms，也不代表首次落指响应为5ms。[模组厂公开手册](https://dfimg.dfrobot.com/wiki/21129/DFR0669_tft-touchscreen-display-module_datasheet_v1.pdf)

GT911地址按7位写为0x5D或0x14，手册0xBA/0xBB与0x28/0x29为含读写位的8位表示；与EEPROM0x50无地址冲突不等于共线电气已验证。原理图需检查上拉并联、3.3V逻辑、INT上电地址选择、触摸RESET可控性及不使用SD卡的片选状态。

400kHz I²C按“读1字节状态＋读5×8字节触点记录＋清状态”计算：含从地址、16位寄存器地址、ACK/NACK为477个时钟，即**1.1925ms理想总线时间**；不含START/STOP、总线空闲、拉伸、仲裁、传感去抖、滤波和音频输出。该值是算式，不是实测最坏时延。

下一轮验收按物理触摸→INT/有效报告→FPGA读取→音乐参数生效→声音输出测量；分别覆盖落指、连续移动、松手、1～5触点、屏幕刷新与功放干扰、休眠后首触。保留≤10ms目标，不以提高LCD刷新率代替触控验证，不先改面板出厂传感参数。若某模组不能满足，应标不合格或继续找前端；不能默默放宽原要求。

## 5. 显示与单/双屏资源

右手必须显示泛音图形已经明确；已有YT240L008N的音乐可视化用途继续保留。**优先按现有可视化屏＋右手触摸显示屏的双显示器场景核算**，不把“屏幕数量未定”当成无须计算第二屏。是否最终合屏是后续产品选择，本轮未擅自取消已有可视化区，也不据双显示器直接增加第二块FPGA。

- 左手6路RC＋单触摸LCD的18逻辑GPIO算例，增加独立第二屏CS/DC/RST是约21逻辑GPIO；可否共享DC/复位、背光固定、是否接MISO、模块RESET实际接法须逐项核查，尚未分配Nano物理引脚。不能把原18脚单屏结论用于双屏。
- LCD SPI与触控I²C分别调度，声音更新不等待画图完成。共享I²C的EEPROM写入/ACK轮询不得长期阻塞触点服务；共享SPI时595锁存仍必须隔离LCD移位流。
- 模组自带GRAM允许局部绘制，不需要立即在FPGA内放两张整帧缓存；右手需要独立寄存器/布局、显示初始化、脏区管理和仲裁，资源尚未联合综合/PnR。
- 同为480×320，RGB565整帧307200byte；DFR0669厂商[ILI9488初始化代码](https://raw.githubusercontent.com/DFRobot/DFRobot_GDL/master/src/Drivers/DFRobot_ILI9488.h)设置`0x3A=0x66`，须按RGB666、3byte/像素评估，共460800byte。商品写RGB565不能据此套用2byte的SPI线速预算。
- 6.75MHz时以上纯像素分别约364.09/546.13ms；2.8英寸RGB565约182.04ms。它们都不能据“SPI”就宣称全屏20/30fps。ST7796S可用频率、RGB565模式、模块电平转换/线缆和FPGA时钟须单独资格确认，不能直接套树莓派示例48MHz/60fps。

这些是预算和接口检查，**未新增显示RTL、未验证双屏流畅性或单板整机资源**。

## 6. 500元预算的真实状态

右手触摸显示屏是新增采购，已有无触摸屏不能抵扣。DFR0669厂家169元标价占总预算33.8%，留下331元用于全部滑条/控件/存储卡/PCB/装配/结构/运费/返工。**当前没有整机含运报价证明可以控制在500元。**

另存一份500元的分项支出上限工作表：屏170、传感/控件/EEPROM器件80、两轮PCB80、装配35、连接/保护/阻容线材35、覆盖固定20、TF卡30、运费20、余量30。它是后续询价的约束，任何一项均非商家报价；比旧分配压缩了其他项目，尚未证明可行，也不以假设减掉右手RC节点就声称节省已实现。若报价超限，先找同能力更合适的模块与制造组合，并列出超额来源，不擅自减音位/触点、取消录放或改变交互。

## 7. 嘉立创实际连接结果与交付

已使用独立隐藏会话对现有小样工程进行**只读系统库查询**。指定真实系统库UUID后，已知SN74LVC14ADR/C133541对照能查回；DFR0669、HS28B03A、CTPH043、2.8inch Capacitive Touch LCD、LCKFB-st7789-2.0inch-screen、DFR1092查询返回空。查询范围有限，不能由此断言整个商城没有这些器件，也不能虚构模块deviceUuid/footprintUuid。SKU30896本轮未做精确库查询。

后续接合可以使用核实过的模块端口/连接器建立接口，配套PCB仍由嘉立创制作；模块是外接装配件时应在系统BOM列明，不能把整屏误放为普通SMT芯片。本轮未放器件、接线、保存图纸、换封装或下单；会话结束仅关闭助手创建的窗口。现有工程所有受检文件SHA256前后相同，新增文件0。

交付：`hardware/right-touch/selection-20261015/`中的候选CSV、预算/线速/I²C算式JSON、A4尺寸图、证据哈希；完整原生查询/公开网页及PDF在`notes/right-touch-selection-20261015/evidence/`。入口main HEAD `fe326ad9505c94f46f9236bf7f9bfc3b5f1b9a12`，192输入基线PASS。身份/资料读取在记录范围**已验证**；器件资格、双屏接合、触控实测、整机预算及制造包均**待实现/待验证**。未改引擎/产品RTL/约束/协议或旧快照。

下一步按3.5英寸F款与国内明确价格候选核对具体版本、报告配置、完整引脚/上拉和国内报价；并行以两屏局部更新估算联合资源。器件通过资格确认后再备份现有图纸并建立右手接口页；目前不给不确定模块锁死PCB外形与孔位。
