sakuyaShining/FPGA-Music-project-internal/docs/02-技术方案/62-七英寸右手触屏选型与整机布局评估-2026-10-15.md

# 七英寸右手触屏选型与整机布局评估

状态：**讨论中**。本轮实际通过嘉立创EDA原生系统库和立创商城继续搜索，并以厂家资料补全整屏选项；未冻结采购型号、画新PCB或下单。右手尺寸方向改为用户提出的**约7英寸**，此前2.8/3.5英寸不再作为主要尺寸推荐。已确认需求及原引擎继续保留。

## 1. 本轮推进结果

- 新增6条整屏比较路线、原生库17条筛选命中记录、5条国内公开商品身份/库存、500元分配表及470×220mm布局提案。文件在`hardware/seven-inch-selection-20261015/`。
- 主推荐**架构方向**为7英寸横屏、800×480、屏侧显存/图形命令、低引脚SPI显示与直接I²C多点电容触摸。五点是筛选目标，不把用户原需求自动变成“只准五点”。7英寸和分辨率不等于已保证刷新/端到端延迟。
- **尚未找到同时完成接口资格确认、可小量购买、整机约500元闭环的最终型号**。型号候选与价格待核没有混写为已选定；尤其整屏参考价不能忽略控制板、触摸版本、线缆、供电和驱动开发代价。
- 左手逐音PCB滑条、只选档八度条、四槽预设/编辑/按压旋钮、已有小屏、录制伴奏＋现场演奏、喇叭及AUX线路输出继续保留。没有偷偷合并两屏、增加计算MCU、购买第二FPGA或减少八度范围。

## 2. 嘉立创平台的实际结果

原生嘉立创EDA专业版4.1.71只读打开既有小样工程，助手拥有的隐藏会话`7050cfd7-edaf-486d-b00a-63c36da1de58`。系统库UUID为`0819f05c4eef4c71ace90d822a990e87`，正对照SN74LVC14ADR成功；搜索结果为空只表示该查询未命中，不推断整个平台没有这类器件。

| 实际库件 | 立创号 | 本轮意义 |
|---|---|---|
| LT7680A-R / Levetop | C5156687 | QFN68、真实库UUID；但国内商品页**已停售/库存0**，不能列为已选采购件 |
| LT7683 / Levetop | C360622 | 原生精确厂家/型号/C号命中，可作显示桥研究；未取得国内小量价格/库存闭环 |
| LT7381 / Levetop | C360626 | 原生精确身份命中；不因型号较新就当LT7680针脚/寄存器直接替换 |
| RA8875L3N / RAIO | C77790 | 原生真实库件；芯片支持SPI不等于所有使用它的成品模块均引出了SPI |
| SSD1963QL9 / SOLOMON | C15216 | MRB路线控制器参考；整屏仍按厂家16位并口规格核对 |
| SN74LV595APWR / TI | C116847 | TSSOP16真实库件，可研究串转并；尚未实施该屏接口桥 |
| PCM5122PWR / TI | C962071 | 原生精确命中，国内公开库存456；小量单价和52.734375kHz配置/串行时序资格仍未完成 |
| PT8211-S / PTC | C92004 | 原生精确命中，国内公开库存1；低成本AUX方向，但右对齐格式和模拟支路需另核 |

实际CLI请求、原始响应/编码、查询及公开HTML保留在`notes/seven-inch-selection-20261015/evidence/`；表中库存是本轮公开读取瞬时口径。AT070TN92返回的C990…且厂家空白记录仅是裸屏线索，不视为可购七英寸触摸成品。MRB7966、ER-TFTM070、SSP0700A、MSP7001查询无结果，未虚构库UUID；LT7686查询也未命中，不能借LT7683代替。

国内页面精确核对MPN/C号后才接纳库存。`encaptionPrice`按原字段保留为**整包参考价**，没有把2000片PCM5122整卷价24020元当成单片价，或将PT8211-S百片包208元作为一片小量报价。C359951包数1、参考239.40元可说明单件包装水平，仍不等于含税运/最终结算金额。原始数据可复核。

来源：[LT7680A-R商城页](https://item.szlcsc.com/5791065.html)、[PCM5122PWR商城页](https://item.szlcsc.com/1043162.html)、[PT8211-S商城页](https://item.szlcsc.com/93193.html)、[微雪7英寸HDMI C商城页](https://item.szlcsc.com/334768.html)。

## 3. 整屏候选与排序

### 3.1 成本追查线索：RONBO MSP7001

厂家页列7英寸800×480、电容触摸、185×105mm、有效区154.08×85.92mm、5V供电/3.3V逻辑和SPI显示，公开美元标价30。**没有取得国内人民币小量含运报价**，不直接换汇当预算结论。

关键缺口：显示控制器IC栏空白；页面写3线SPI，同厂家其他销售描述写4线；触摸IC、触点数和完整接口图未定。产品页后面的GT911/FT5316触摸面板“相关产品”不等于该模组实际装配的触摸IC。不能看到“电容”就认为五点或把MSP7001当Surenoo同款。

本轮将其列为**优先追查的低成本成品线索**，不作为已经可直接连线/购买的推荐型号。要取得确切控制器/显存/绘图能力、触摸型号与点数、原理图、版本及人民币报价，才进入小样屏接口。

来源：[RONBO原厂产品页](https://www.ronboe.com/shop/msp7001/)；原始公开HTML已保存，200响应。无需留言/询价授权来完成只读搜索，本轮未联系厂家。

### 3.2 价格比较路线：LCDWIKI MRB7966

明确为**电容版MRB7966**，不是电阻版MRB7963。800×480、SSD1963、GT911/I²C、16位8080显示、5V供电/3.3V IO，PCB181×108mm，有效区154.08×85.92mm；官方功耗2.03W。厂家原理图存在，可核查实际供电/触摸接口。

它的SPI FLASH/SD接口**不能作为显示SPI**。主机直接并口约需16条数据＋控制，不能照搬原17 GPIO表。串转并可以研究，但至少还要处理RS、WR、CS、读写方向、锁存和共享传感扫描；“两颗595就直接兼容整机”尚无证据。本轮不生成未经验证的桥接电路/约束，也不因桥便宜承诺流畅。

没有国内小量完整报价，暂作成本对比候选。若它价格明显更低，再与SPI成品的开发/器件开销一起比较。

来源：[厂家wiki](https://www.lcdwiki.com/zh/7.0inch_16BIT_Module_SSD1963)、[官方模块原理图](https://www.lcdwiki.com/res/MRB7963/7inch_SSD1963_display_Schematic.pdf)。原理图属于该系列，仍须核实际电容版与批次。

### 3.3 资料较清楚的SPI备选：ER-TFTM070-5V4

需要选定**4线SPI＋电容触摸FT5316配置**，不能只买同名基础版。7英寸800×480、RA8875带图形功能，接口由版本配置决定。厂家国内页搜索索引基础标价**273.22元**，电容触摸为单独选项，尚未取得这一配置的总价。273.22＋其他分配300已经573.22元，且还没加未确认的电容选项，因而不作为当前500元预算已满足的方案。

产品表外形180×104mm，规格书不同修订机械图存在差异，未用该数给外壳开孔。直读厂家页403，保留失败，不绕过；索引信息只用于技术/价格线索。

来源：[厂家国内产品页](https://www.buydisplay.com/chinese/7-inch-lcd-module-capacitive-touch-screen-panel-i2c-spi-serial)、[厂家规格书](https://www.buydisplay.com/download/manual/ER-TFTM070-5V4_Datasheet.pdf)。

### 3.4 其他路线的处理

- **Surenoo SSP0700A-800480 CTP**：LT7686、详细表触摸FT5426/I²C，185×105×7.98mm/5V，低引脚显示架构较合适。标题“GT5426”和详细表不一致，所谓3线SPI同时有分开的MOSI/MISO；须看手册时序，不按线数文字接线。国内价/点数和具体可售版本未闭环，外币搜索标价不能直接作国内报价。来源：[厂家页](https://www.surenoo.com/products/23163813)。
- **MACLIGHT 7英寸LT7680 SPI＋I²C五点模块**：接口方向符合，但缺确切料号、外形、后缀和价格，只作架构线索，不交付假MPN。来源：[厂家页](https://www.szmaclight.com/product/7-inch-spi-tft-lcd-800480-i2c-ctp.html)。
- **微雪7inch HDMI LCD (C)，C359951**：国内公开库存1、单件包参考239.40元；厂家定义1024×600、HDMI视频＋USB五点触摸。Nano有HDMI口不代表有USB触摸主机栈；需核USB主机电路/HID、视频合成资源和时序。因额外开发与资源开销，不作为本轮首选。既有USB调试口不能直接当USB Host。来源：[厂家产品页](https://www.waveshare.com/product/raspberry-pi/7inch-hdmi-lcd-c.htm)。
- RGB裸屏/MIPI/纯USB显示、单点电阻屏、未证明多点的UART菜单屏不因面板便宜进入首选。屏侧专用图形控制器与另加一颗通用计算MCU是不同架构，后者未自动获准。

## 4. 整机布局：先用470×220mm空间提案

交付`layout.png`为比例草图，**不用于PCB封装、开孔或制造**：

- 左手两排逐音滑条在左；示例每排13个位置、18mm中心距、12×48mm触控区，两排净高108mm。13格仅容量示例，不替用户冻结完整八度端点数或MIDI映射。
- 右手横放7英寸触屏，先容纳185×108mm模块包络；有效触控图形区约154×86mm，左右预留隔离带。候选实际玻璃可能超出PCB，必须按最终模组整体尺寸再核。
- 已有可视化屏放左上；预设1～4、编辑和按压旋钮位于上缘，八度选择条置于左手上方。小屏外框只是留位，YT240L008N转接板/引脚未实测。
- Nano插接载板置于下层，USB/TF/电源/AUX朝背缘并留插拔空间；喇叭开孔、支撑柱、连接器高度、排线弯折/EMI、腕部空间仍待实物布局，不称整机结构已经设计完成。

7英寸若示例划成8组，每组节距154.08/8≈19.26mm；留7条2mm间隔后每组净宽约17.51mm。相较3.5英寸更适合多指直接操作，但8组/图形形态仍是示意，不把物理屏变大解读为音乐映射已冻结。先画纸样试双手姿势，再确定有效条长、位置和倾角。

## 5. 性能和接口门槛

- 800×480 RGB565一帧768000字节；6.75MHz SPI只传像素理想就要**910.22ms**，20次全屏/秒需122.88Mbit/s。不能承诺原小屏驱动换个分辨率就流畅。
- 推荐用屏侧显存保持图像，图形命令/局部更新画泛音和手指反馈。控制器内部扫描刷新率、主机图形更新率、触控报告率是三个指标。七英寸尺寸本身不要求主引擎持有一张新帧缓冲。
- 即使是SPI成品，也须核MISO/忙状态/FIFO、独立CS、复位、上电触摸地址、I²C地址/上拉和共享总线仲裁。原17脚表依赖两小屏共DC/写入方式；新屏控制接口不同，**本轮未沿用它作为最终接线**。既有音频/TF/USB/保留脚继续保护。
- 触摸目标包括真实并发点数、触点ID连续、落指/移动/抬指、位置噪声/边缘/手掌误触和整机干扰；最坏触摸到声音≤10ms仍需示波/音频或等价测量，不以“GT911”“100Hz”字样代验收。
- 按MRB功耗，单屏约5V/0.406A；原型整机可按**5V3A供电容量候选**重新核峰值及电源路径，非已证实消耗3A，也不表示直接并接USB与外源。新适配器/线材若需购买计入预算。
- 原可视化联合核心19777/20736 Logic、38/46 BSRAM属于此前构建，仍无新屏/触控/录放/四层全功能联合PnR；专用屏控可减轻像素存储/持续扫描，不能据此宣布单板资源已经满足。

## 6. 500元预算约束的实际含义

`budget-targets.csv`仅给控制成本的**分配目标**：屏幕/触摸/控制板及线缆200；左手前端/逻辑/合格保护60；电极和载板小样制造/装配65；AUX支路25；卡25；按钮旋钮连接器30；电源线材25；面板覆盖/简易结构35；运费/余量35，合计500元。

**这些都不是已报价成本**。特别80/83电极保护、较大PCB/装配、供电及简易外壳可能超出分配；不靠忽略保护、假定免费打样或虚构零元外壳让总数等于500。更完整外壳或多轮迭代应另核。

本轮确切售价线索仍未给出“200元以内已资格确认的7英寸整屏”。若屏最终239.40元，其他仍按300分配则539.40元，且HDMI/USB开发代价另算；ER基础273.22则至少573.22元加触摸选项。预算压力据此明确保留，不能写“全部选型完成且500元保证”。

## 7. 验证范围与下一步

本轮仅资料/身份/算式与布局评估。原生只读会话已关闭，只关闭助手创建的会话；既有EDA工程前后哈希**changed0/added0**。主目录源码HEAD仍`fe326ad9505c94f46f9236bf7f9bfc3b5f1b9a12`，main192输入身份检查PASS；不新写快照、不改变引擎/参数/协议/约束、不改旧BOM和图纸。公开数据、生成脚本与交付哈希保留供复核。

下一步按优先顺序：

1. 对MSP7001及直接SPI/I²C七英寸模组补齐控制器/触摸型号、具体版本/原理图和国内小量整价；缺一不作为下单料。
2. 取得MRB7966实际完整价格，比较“便宜并口模组＋桥接验证”与SPI成品总成本，而不是只比玻璃价。若无可读报价，可先把询价所需规格明确列成待办，不冒充已联系商家。
3. 按实际屏重算GPIO/电源/连线、隔离驱动和图形命令压力测试，连同左手扫描、音乐可视化、TF录放一起做联合资源验证。任何借用LED脚/读入串行脚都需波形与总线方向审查。
4. 纸样/实屏确认双手姿态与安装尺寸后，再先备份、修改原生原理图并导出BOM/网表；完整报价与屏接口通过之前不生成“最终制造包”。

新硬件功能均**待实现/待验证**，选型**讨论中**。本轮没有采购、制造、外部联系、下载码流或更改用户音乐交互决定。
