sakuyaShining/FPGA-Music-project-internal/docs/02-技术方案/73-板级音频实测与复位按键更正-2026-10-17.md

# 板级音频实测与复位按键更正 · 2026-10-17

本轮在用户上电并恢复USB数据连接后，完成板载音频诊断的首轮实体检查。该限定范围**已验证**，完整产品继续**部分实现**。只执行Gowin操作2的SRAM临时配置，没有读写Flash；测试结束设备处于未使能、未演奏、无活动绑定/音符、无故障状态。

## 1. 重要更正：87脚对应S2

当前约束和实际码流的`reset_button`位于FPGA87脚，官方Nano20K rev1.30原理图将其标为`PIN87_MODE1_KEY2 → KEY_S2 → S2`；88脚对应S1。72号及较早记录将87脚文字标成S1，是编号错误。RTL连接和高有效极性未改变，本轮无需重编音频镜像；操作时应按**S2**。

起初按S1后的回读仍为case3、ack192，未观察到复位。失败记录保留在`after-user-reset/result.json`，没有把静音PCM误报为复位通过。更正为S2后，监听捕获计数/状态清空及2048个零PCM；用户回复“已按S2”。旧准备包与72号保留为历史快照，后续操作使用本轮修正说明/包。

## 2. 来源、连接与配置身份

- main `fe326ad9505c94f46f9236bf7f9bfc3b5f1b9a12`，engine-safety `683db4834a031baca217b9e3ae7a0369644b8935`，源自71/72号隔离音频诊断，原引擎/GUI/71号/准备交付不变。
- 13:40、13:43两次检查没有USB串口/下载器；13:54重试识别COM5/COM6，FTDI 0403:6010，A/B序列号`2025030317A/B`。本轮实际UART为COM6/B，未向COM5发送串口控制。
- JTAG扫描1个器件，Family GW2AR，ID `0x0000081B`；Gowin操作2“SRAM Program”成功，UserCode `0x94CB`，Status `0x6020`。实际码流SHA256为`7384acdf9fb51f887dc20d1d63ed01a8dc69cb36d78305fc77d9e6a8df8ca246`。
- 实际UART读取profile `0x72`、ABI1、诊断`0xD3`、范围32；使能前ready=true、armed/running/bound/fault=false、活动0。不能仅凭下载器退出0判定正确固件运行。
- 前置583个源/证据文件及包/文档哈希逐项一致；本轮另备份12个交付/入口/包文件，ZIP逐项校验。主机脚本和记录在`notes/board-audio-hardware-20261017/`，具体会话`20261017-135414/`。

## 3. 六项板上检查

每项通过实际UART捕获2048个24位单声道PCM，停止后检查清音；这不是主机合成音频。初轮数字结果如下：

| 测试 | 采样时活动组 | 非零PCM数 | 绝对峰值 | 停止后活动组 |
|---|---:|---:|---:|---:|
| 1 A4单音 | 1 | 2045 | 126688 | 0 |
| 2 C/E/G和弦 | 3 | 2048 | 260640 | 0 |
| 3 同音双层 | 2 | 2048 | 126656 | 0 |
| 4 两音/单指滑音 | 2 | 2048 | 210096 | 0 |
| 5 短音自动释放 | 0 | 0 | 0 | 0 |
| 6 静音满载/抢占 | 32 | 2048 | 736976 | 0 |

所有采样间隔观察值均为512个FPGA时钟；A4频谱峰约439.35Hz（以标称27MHz、52734.375Hz采样率换算，未外部校准晶振）。2048样本窗口约38.8ms，FFT补零不增加原始频率分辨率，不能把小数位当绝对音准精度。

压力测试观察活动掩码`0xffffffff`（32组），先16触点×2层，再增加第17触点使子ON增量34；最终ON/OFF相等、活动0、无故障。该例硬件PA/DIN按设计保持静音；主机回读没有外部功放引脚测量，不能独立签收模拟静音电平。

捕获中没有样本命中±24位满量程端点；这只是该检查结果，不等于证明所有混音情况下无溢出/模拟削顶。case3证明两组同时分配及非零音频，采样较晚，未单独定量分离两个音色贡献；case4证明两组运行和音频回读，逐指隔离完整规则还结合71号数字回归阅读。

`fingers`字段来自`finger_pitch.expr_active=enabled`，释放时保留偏移供尾音使用，不是物理手指数。停止后该掩码可以保留；当前清音检查使用分配表active、触点bound、使能与PCM，不能将其非零误判为仍按住。

## 4. 短音补测与实体复位

初轮case5延后捕获时已全部为零，仅足以说明该时刻静音；因此另做三个完整捕获窗口。起音2048样本全非零；释放窗口256样本分块RMS从约39214降到22036；最终2048样本全零。每次只有一次ON和一次OFF、停止后活动0。触发由Windows/UART控制、偏移为近似，未测精确起音/释音延迟。

S2监听中，复位前最近一次观察有2组活动；按键期间出现一次预期的UART无回应，恢复身份后case/ack/on/off/active/fingers均归零，ready恢复且未使能，无故障，2048个PCM全零。前后快照间隔约3.875s，其中包含3秒UART等待；这是抽样观察与用户操作反馈，未用仪器捕获按键边沿或逐一读出512个时隙RAM。512时隙的逐项清空仍以72号仿真为证。

随后重新演奏A4成功，2048样本非零、谱峰约439.35Hz，再停止后active0、armed/running/bound/fault=false。不是只有复位成功、无法恢复演奏的单向检查。

用户对本轮扬声器短音的反馈为“能听到，暂未发现异常”。这补充了真实功放/喇叭路径的基本发声观察，没有示波器、模拟录音或系统听感评测，外部I²S setup/hold和模拟质量仍**待验证**。

## 5. 当前交付与下一步

新入口`notes/board-audio-hardware-20261017/CURRENT.md`，修正包`package/`含相同音频SRAM镜像、静音回退镜像、原校验脚本及S2说明；本轮未下载静音回退镜像。哈希、主机脚本、原始PCM、成功/失败记录与文档状态由新`delivery.json`绑定，旧72号准备快照不覆盖。

本轮没有修改音乐RTL/参数/约束或新增合成配置。测试工程的15258Logic/36BSRAM/14IO与27MHz内部PnR来自72号，不代表包含左手扫描、右手触控和可视化的完整整机容量。临时SRAM配置断电消失，Flash内容未检查。

下一步转向真实屏幕接口/供电/绑带确认、屏幕显示与物理触控小样验证；完整逐层包络/配置应用、四层同时、断电保存、录制伴奏＋实时旋律/曲谱、7英寸界面、完整资源/延迟及约500元制造仍**待实现/部分实现/讨论中**。本轮不减少既定功能或裁定未决音乐交互。
