sakuyaShining/FPGA-Music-project-internal/refs/素材库/交接-DeepSeek会话恢复.md

# 会话恢复文件（DeepSeek 的记忆文件）

> **用法**：新会话的**第一句话**说——
> 「读 `refs/素材库/交接-DeepSeek会话恢复.md`，然后按它继续」
> 本文件是**无损**的；DSH 的自动压缩摘要是**有损**的 ✗，不要只依赖它。

---

## 0. 一句话背景

**项目**：用 Sipeed Tang Nano 20K（GW2AR-LV18QN88C8/I7）做一台**加法合成电子乐器**（TDM 引擎：512 时隙 = 32 声部 × 16 泛音，fs = **52734.375 Hz**）。
**死线 11/4**；假期结束时功能集冻结；报告 6 天 + 板上联调 5 天已排定。
**当前分工**：单代理期 —— **ZCode（GLM）已因额度离线** ✗，我同时承担 RTL 功能线 + 验证/审计/回归。
**用户**：唯一裁定人（协议歧义、取舍、冻结，都由用户点头）。

---

## 1. 必读顺序（照这个顺序，别跳）

| 序 | 文件 | 为什么 |
|---|---|---|
| 1 | `refs/素材库/交接简报-2026-10-02-ZCode致DeepSeek.md` | **v2 总入口**：七件事摘要 + 工单表 + 状态快照 |
| 2 | `refs/素材库/未验证与挂账清单.md` | **我的账本**：什么已关闭 / 什么无独立复核 / 什么"尚未成立"。**销账前必须先更新它** |
| 3 | `docs/02-技术方案/21-验收判据清单.md` | **ZCode 的验收标准全集**（我按它自评，她回归后抽验） |
| 4 | `docs/02-技术方案/19-UART协议v1.0草案.md` | **冻结协议**：§1 帧格式、§3 地址表、§8 修正案 **A1–A6**。**动冻结项前必须通读 §1–§8** |
| 5 | `docs/02-技术方案/20-pad扫描规格书.md` | pads 引脚表 + RC 时序 + 五声音阶表 + PS1–PS7 |
| 6 | `refs/素材库/双代理任务板.md` | 认领/销账/裁定记录 |

---

## 2. 进度快照（2026-10-02 晚）

**批次序：② → ① → ③ → ④**（②必须先行：时序收敛瓶颈在 note_map）

| 步 | 内容 | 状态 | 证据 |
|---|---|---|---|
| **②** | note_map 流水化（5 态）+ 加宽 + 奈奎斯特防护 | ✅ **完成** | slack **+0.391 → +12.494 ns**；闸口 **28/28**；`tb_nyq` ⇒ `RESULT nyq=PASS killed=7 alive=25` |
| **①a** | 0x60/0x61 串行事件 + 三事件源（UART>定序器>排针）+ 回读按 A3 挪到 0x0F | ✅ **完成** | `tb_ev` ⇒ `RESULT vp6=PASS events=16 inc0=104870 slot0=0`；闸口 **28/28** |
| **①b** | `pad_scan.v` + 16 路 pad + cst | 🔄 **模块与判据已完成**（`RESULT pad=PASS ps1=1 ps2=1 ps4=1 ps3=1` ✓）；**待做**：tdm_top 例化 + `EV_PIN_EN` + cst 16 引脚 + PS6 cst 审计 + PS4 的 inc 级校验 + PS5（依赖③） | 见 §3 |
| **③** | 谱 RAM 16×8 + 0x58/59/5A + 刷新在响声部（D6）+ 0x63 逐声部（A1）+ 替换/叠加 | ⏳ | 判据 VP1–VP5 已在 21 号 §4 写好 |
| **④** | reg_bank 默认表按 19 号 §3 重写 + A3/A4/A5/A6 + 0x7F=0x10 + cst test_mode 改下拉 | ⏳ | 判据 VP7 |

**已完成的其他事**：`tm_load_amp 60→8`（ZCode 的 F1 取证前提）✓；上位机 `dsp_host.py` 按冻结表 + A3/A4/A5 对齐 ✓；`步骤11` 文档卫生 ✓；F1 已入闸口（`--full` 套件 12）✓。

---

## 3. 下一步：①b（pads）

**依据 20 号规格书**：
- **引脚**：27–34 `pad_note[7:0]`（左手**五声音阶** ×8）、35–42 `pad_harm[7:0]`（右手泛音键 ×8 → `HARM_PADS` 0x5B）、48/77 备用（v2: MPR121 I2C）
- **扫描**：RC 充放电计时；12 位计数器（溢出封顶 4095）；每路 3 拍（充/放/读）；16 路轮转 ≈3.6 µs/轮；每样本周期（512 拍）约 9 轮
- **基线**：复位后前 32 轮取**中位数**；此后慢速跟踪漂移（≈1%/s）；阈值带滞回
- **五声音阶表写死在 `case` 里**（**不要用 `$readmemh`** —— song_seq 的教训）
- **判据 PS1–PS7**（21 号 §5），其中 **PS6 = cst 审计**（16 根 pad 引脚 + S2 全部 `IO_TYPE=LVCMOS33`）

**我已定的实现决定（A6 留的口子）**：
A6 说"`ev_*` 保留为测试口**不上引脚**"，而 pads 占用 27–42 ⇒ `ev_*` 在出货构建里没有引脚 ✗。
⇒ **加 `parameter EV_PIN_EN`**：测试构建 =1 走 `ev_*`（**15 个测试台一行都不用改** ✓）；出货构建 =0 时把 `ev_*` 在 RTL 里与掉（悬空输入不进事件通路 ✓）。

---

## 4. 铁律（每次改 RTL 都要走）

1. **改 `src/rtl/**` 前先在任务板认领**（双代理时代是规则①，现在仍照做 ⇒ 留痕 ✓）
2. **改完必跑**：`build_sims.ps1`（16 个目标全编译）→ `regress_all.py`（快速 11/11）→ **`regress_all.py --full`（28/28）** → **`build_gowin.ps1` 读 `timing_paths` 的 slack（目标 ≥ +5 ns）**
3. **销账前先更新账本**；**主张必须挂证据文件路径** —— 写不出路径的主张 = 未证 ✗
4. **动冻结项前通读 19 号 §1–§8 + A1–A6**（⑤ 的教训：只读 §3/§4 会漏 ✗）
5. **先加判据再加功能**；判据不循环论证（尺子要与被测物同源，但不重算被测物的公式）
6. **结论不超过证据** —— 未证的部分必须写明（账本 C 区）

---

## 5. 关键数字（可直接抄进报告）

| 项 | 值 |
|---|---|
| 采样率 / 时隙 | fs = **52734.375 Hz**（27 MHz ÷ 16 ÷ 32），NSLOT = **512**（每样本恰好 512 拍，**不变量**） |
| 吞吐 | 512 × 52734.375 ≈ **27.0 M 振荡·Hz** |
| 复音 | 32 声部 × 16 泛音 = 512 时隙 |
| PnR（①a 后） | slack **+12.494 ns**；Logic **12112/20736（58%）**；Register 3714/15750；BSRAM ≈29/46；DSP 8.75/24 |
| 闸口 | 快速 **11/11**、全量 **28/28**（含 16 组 R0 掩码×包络 **0/2495 逐位一致** + F1 512 谱峰 G1–G4） |
| E5 延迟 | t_pin **2807 拍 = 0.104 ms**（预算 5 ms，约 48× 余量） |
| 判据 | R0 0/2495 ✓、E1a 512 档 32/32 ✓、E2 颤音 0/26.31/52.64 音分 ✓、E4 三件套 ✓、E7 S1–S6 ✓、VP6 PASS ✓、nyq PASS ✓ |

---

## 6. 命令（复制即用）

```powershell
# ★ 每条命令前必须加 iverilog 到 PATH
$env:PATH = 'D:\iverilog\bin;' + $env:PATH

# 全量重编 16 个测试台（改 RTL 后第一步）
powershell -NoProfile -ExecutionPolicy Bypass -File tools\scripts\build_sims.ps1

# 闸口（脚本自己重编，所以用的总是当前 RTL ✓）
python tools\scripts\regress_all.py            # 快速 11/11
python tools\scripts\regress_all.py --full     # 全量 28/28

# PnR + 时序（改 RTL 后必跑；读 impl\pnr\tdm_synth.timing_paths）
#   ★★ 必须带 -SspiAsGpio！否则清过 impl\ 之后会报
#      PR2017 "'dac_din' cannot be placed ... dedicated pin (SSPI)" ✗
#      （54/55/56 是 SSPI 专用脚，本工程的 DAC 就接在这三根上；脚本里有开关 ✓）
#   ★★ 出货顶层是 tdm_ship（src/rtl/tdm_ship.v），它把 ev_*/preset/test_mode
#      接成常量 ⇒ 那些测试口不进网表、不占引脚 ✓（防"幽灵音符事件" ✗）
powershell -NoProfile -ExecutionPolicy Bypass -File tools\scripts\build_gowin.ps1 `
  -Project src\gowin\tdm_synth\tdm_synth.gprj -SspiAsGpio

# 上位机（不需要板子）
python tools\scripts\dsp_host.py --dry demo-score
python tools\scripts\dsp_host.py --check-map          # 与 RTL 地址表对账
python tools\scripts\regmap_dump.py --dump            # 权威地址表

# 波形渲染（长，按需）
cd sim_build\audio ; vvp audio.vvp +test=0 ; vvp audio.vvp +test=1
python tools\scripts\render_wav.py --dump sim_build\audio\audio_proto.txt --out out.wav --src-rate 52734.375 --rates 48000
python tools\scripts\audio_check.py --simdir sim_build\audio
```

---

## 7. 惯犯陷阱（本项目已踩过的，按出现次数排）

1. **"先声明后使用"** ✗（4 次）：`reg`/`wire`/`localparam` 必须在引用它的 `always`/`assign` **之前**声明。改 FSM 时最容易犯。
2. **有符号/无符号** ✗（4 次）：**位选（`x[15:0]`）和拼接（`{a,b}`）在 Verilog 里是无符号** ✗ ⇒ 负值被**零扩展**成大正数。凡是有符号运算，先落到 `signed wire` 上再算。实测后果：输出 +50% 直流、49% 削顶。
3. **`x` 传播** ✗：复位后第一个样本引擎未定态 → 写进效果器线缓冲 → 反馈环反复回写 → 整条线变 x。已用"上电冲刷"解决（`FLUSH_LEN`）。
4. **位宽上下文** ✗：`a * b` 的宽度由上下文决定；`g*P` 在窄上下文里会溢出。显式加宽。
5. **PowerShell 处理中文** ✗：中文引号会打断 `-Command` 解析；`.ps1` 必须 **ASCII-only**（PS 5.1 把无 BOM 的 UTF-8 当 ANSI 读）。**改文本文件一律用 edit/write 工具，不要用 PowerShell 字符串替换**。
6. **陈旧构建** ✗：改完 `.v` 不重编就跑，看到的是旧行为。`build_sims.ps1` 有 mtime 检查；`regress_all.py` 自己重编（可信 ✓）。
7. **窄脉冲被慢节拍采样** ✗（3 次）：1 拍的 valid 只在 512 拍一次的 tick 上采 ⇒ 完全采不到。要么持续保持，要么用 always 块监视。
8. **`$readmemh` 静默失败** ✗：文件缺失/行宽不符 ⇒ 存储器全 x，但编译不报错。改运行目录时务必确认 hex 都在。
9. **默认值放不进位宽** ✗：`DELAY_LEN` 默认 2048 而线缓冲 2^11 ⇒ 截断成 0 ⇒ 抽头读到刚写入的样本（已改 1500，见 A5）。
10. **测试台自己的竞态** ✗：触发发生在 UART **数据字节末尾**，而 `wr_reg` 要等 234 拍停止位才返回 ⇒ "等 load_en"会假超时。用**事件监视器**而不是固定窗口。
10b. **PowerShell 文本 I/O 会加 UTF-8 BOM** ✗✗（2026-10-02 又中一次）：`Set-Content -Encoding UTF8` 写出的 `.v` 带 BOM ⇒ **iverilog 直接报 "Unable to find the root module"** ✗。**结论：改任何文本文件只用 `edit`/`write` 工具或 Python**（`open(...,encoding='utf-8-sig').read()` → 写回 `encoding='utf-8'` 可去 BOM ✓）。
10c. **反过来：`edit` 工具会去掉 `.ps1` 的 BOM** ✗✗（2026-10-03 中招）：PS 5.1 把**无 BOM 的 UTF-8 当 ANSI** 读 ⇒ 脚本里的中文注释变乱码 ⇒ **解析失败 "UnexpectedToken"** ✗。含中文的 `.ps1` 必须**带 BOM**：用 Python 写回 `encoding='utf-8-sig'` ✓。
10d. **加宽计数器后忘了改 `case` 标签** ✗✗（2026-10-03 中招，很隐蔽）：`b_idx` 从 5 位加宽到 6 位，而 case 里仍写 `5'd32`…`5'd44` ⇒ **常量回绕**成 0…12 ✗ ⇒ 引导序列从第 32 条起**写错寄存器** ✗（症状：谱 RAM 前 4 个泛音是 0、第 5 起是 **x** ✗）。**规则：改位宽后 grep 一遍所有带位宽的常量** ✓。
10e. **"能编过" ≠ "能重新构建"** ✗✗（C0 的教训）：Gowin 的**增量流程复用历史布点/布线** ⇒ 只要 `impl\` 在就"一直能编" ✓；**清一次 `impl\` 或换台机器就编不出来** ✗✗。**判据：把 `impl\` 删掉再编一次，能出 `.fs` 才算真的可构建** ✓。
   另外：**构建必须带 `-SspiAsGpio`** ✓（54/55/56 是 SSPI 专用脚 = 本工程 DAC ✗）；**`-PlaceOpt 2 -RouteOpt 2` 才能在日志里看到真实的未布线条数** ✓（默认选项报 "0 unrouted nets" 是工具没真跑 ✗）。
10f. **★★ 三态的使能必须写成寄存器** ✗✗（2026-10-03 花了整整两轮才定位）：本工程 16 路电极是 `inout`（充/放/读同一根线 ✓）。用**组合逻辑**推断三态
   （`assign pad = (st == S_CHG) ? 1 : 'bz;`）⇒ Gowin 报 `PR0004 ... 86 unrouted nets` ⇒ **出不了码流** ✗✗。
   **改成寄存器使能**（`reg pad_drv_en; always @(posedge clk…) pad_drv_en <= (st == S_CHG); assign pad = pad_drv_en ? 1 : 'bz;`）
   ⇒ **编译成功** ✓✓（`.fs` 7093.9 KB、slack +15.356 ns ✓）。
   已排除：`OPEN_DRAIN=ON` ✗、寄存器表瘦身 ✗、`DRIVE=8` ✗、`PULL_MODE` ✗、`initial` 块 ✗。
   **工具**：`python tools/scripts/pad_mode.py --inout|--input|--show` ✓ 一键切换、防回归 ✓。
10g. **★★ 本设计一直贴着"布线悬崖"** ✗✗（第 7 轮）：RW 资源不是问题（Logic 70% ✓），**布线资源**才是 ✗。
   实测：在已经能出码流的版本上**只加一个电极遥测功能** ⇒ 未布线从 0 涨到 **187 条** ✗✗。两条便宜原则：
   ① **绝不要随便读 `R[addr]`（`regs_flat`）** ✗ —— 它的**每一个切片都会综合出一棵 NW:1 读 mux** ✗，
      全设计几十个切片；新功能需要寄存器时，**用专用寄存器走普通写通路** ✓（这一条把 187 降到 54 ✓）；
   ② **`reg_bank` 的项数越少越好** ✓：从 256 缩到 **128**（0x00–0x7F 已覆盖全部冻结地址 ✓）
      ⇒ 未布线 **54→0** ✓✓，还附送 **省 677 LUT + 797 个 FF** ✓（Logic 15185→14508 ✓、Register 4366→3569 ✓）。
      注：当年"缩到 128 报 EX3784"的障碍来自那张 256 项并行版初值表 ✗ —— 它已在第 5 轮按 §3 重写 ✓，障碍消失 ✓。
10h. **★★ `fx_delay` 的 `sample_en` 必须是【÷12 频闪】** ✗✗（第 8 轮，害我查了很久）：该模块内部是
   **12 态 FSM** 且 `else if (sample_en)` ⇒ **每态只在 sample_en 那一拍推进** ✓ ⇒ **一整遍 = 12 个频闪** ✓。
   把它接成恒 1 ✗（我以为每拍一个样本 ✓）⇒ 实测**输出恒 0** ✗✗（看起来像"功能坏了" ✗）。
   **正确用法**照 `tb_fx`：`reg [3:0] pc; wire sample_en = (pc == PERIOD-1);` ✓，
   录音时**等 12 个频闪**再取一个输出 ✓（= 一整遍 ✓）。
   配套教训：测试台的 `while (cond) @(posedge clk);` **一旦条件不成立就是仿真空转** ✗ ——
   本项目仿真的超时是 **40 秒仿真时间 = 10.8 亿拍** ✗✗（会跑几小时 ✓）。调试期务必用固定拍数 ✓。
10j. **★★ 湿声路径的"域"必须对齐（D1，2026-10-03 第 9–10 轮）** ✗✗：`fx_delay` 的线缓冲是 **16 位** ✓，
   而干声 `din` 是 **24 位** ✓。原来的混音 `mix_sum = dry + wet` 里，湿声只是把抽头**符号扩展**到 24 位
   （数值不变 ✗）⇒ 满幅抽头在 24 位域里只有 1/128 = **42 dB 偏低** ✗✗
   ⇒ **混响/延迟/合唱全都几乎听不见** ✓，而 demo 里"听得见的混响"其实是 `RV_FB=0.75` 时
   线缓冲**饱和削顶**产生的自激失真 ✗✗（假象 ✓）。
   **修法**：湿声先 `wet_sum <<< 8` 再按 `wet_sh` 衰减 ✓（满幅 32767<<8 = 8388352 恰好不越 24 位 ✓）。
   **联动**：所有"以线缓冲域为绝对幅度预期"的判据都要同步 ✗ —— 例如 `fx_check.py` 的
   `--imp` 默认从 5000 → **1280000**（= ×256 ✓，已注明原因 ✓）。
   **顺带**：`RV_FB` 默认也因此从 `0xC0`(0.75, 91.9% 削顶 ✗) 降到 **`0x80`** ✓。
10k. **★ 闸口工具会被"文件锁"弄崩** ✗（第 9 轮）：本机常驻有工作区监视进程（实测 **ZCode 有 16 个进程**在跑 ✗），
   它会**持续**持有 `sim_build/regress/*/rc_*.txt` 的句柄 ⇒ 原 `shutil.rmtree` 抛 `WinError 32`
   把**整个闸口**带崩 ✗✗（表面上看像"套件失败" ✓✗，极易误判）。已改为"重试 10 次 + 仍失败则跳过" ✓
   （`regress_all.py` ✓）。**另**：跑闸口时**不要并行**手工跑同一个 `sim_build` 下的 vvp ✓；
   有残留 `vvp` 进程时先 `Get-Process vvp | Stop-Process -Force` ✓。

---

## 8. 不可触碰 / 不许声称

**三不变量（改引擎前默背，21 号 §2）**：
1. 装载走"待生效区"+周期奇偶标签，样本边界统一消费 —— **禁止恢复直写状态存储**
2. 奇偶翻转在 `sc = NSLOT-1`，判定用**读取时刻**奇偶（ppr1）
3. 累加窗口旋转 LAT 拍（清零 `sc=LAT`、锁存 `sc=LAT-1`）
外加：门初值 0；**每样本拍数 = NSLOT**；查表地址用**推进前**相位。

**不许声称"已成立"的（账本 C 区）**：
- **板上行为**（从没插过电 ✗）
- **逐音音高正确**（判据本身不成立 ✗：HPS 6/7 + 自相关工具也有错）
- **上电行为 VP7**（待步④）
- **塑谱 VP1–VP8**（待步③）、**pads PS1–PS7**（待步①b）
- **M1/M9/F3**（批次做完才达成）
- 音质/听感（无耳朵；音质只能标"仅自评"⚠️）

**报告口径**：时序只用 **PnR 频率收敛点**（压力测试在 `refs/素材库/时序裕量特征/`）。

---

## 9. 人机分工（现在）

- **用户**：唯一裁定人。协议歧义/取舍/冻结都要请示；不确定就列表问，不要自己拍。
- **ZCode**：离线 ✗。她的**验收标准**在 21 号（我按它自评）；她回归后按 §4–§7 抽验，**不合格的销账要回滚**。
- **我**：RTL 功能线 + 验证/审计/回归 + 上位机 + 文档。
- **两个机制文件互相咬合**：任务板（认领/销账）↔ 账本（未验证/无独立复核）↔ 21 号（判据）。
