sakuyaShining/FPGA-Music-project-internal/refs/素材库/TDM顶层端到端证据.md

# TDM 顶层端到端验证证据（tdm_top）

> 2026-10-01 · **`tdm_top` 此前只综合过、从未仿真过。这是第一次端到端验证。**

## 结论

**TDM 顶层从引擎到 DAC 引脚，整条链打通，逐样本一致。**

```
==============================================================
 tdm_top 端到端验证
==============================================================

[V1] 时钟链（引脚实测）
     BCK  周期 = 666.684 ns  -> 1.5000 MHz   (期望 666.667 ns / 1.5 MHz)
     LRCK 半周期 = 10666.944 ns   全周期 = 21333.888 ns
     LRCK 频率   = 46873.7813 Hz              (期望 46875 Hz)
     BCK/LRCK    = 32.000                   (期望 32)

[V2] 起音与输出
     非零样本数 = 199 / 200
     第一个非零样本 = 4

[V3] I2S 闭环（解码 vs 引擎 sample_out）
     收到 左 202 个 / 右 202 个样本，比对 201 次
     对齐 now（与最近一次 sample_en 的值比）：不符 0
     对齐 old（与上一次 sample_en 的值比）  ：不符 1
     => ★★★ I2S 链路逐样本一致（对齐 now）
```

| 项 | 结果 |
|---|---|
| BCK 频率 | **1.5000 MHz** ✓ |
| LRCK 频率 | **46873.78 Hz** ✓（差 1.2 Hz 是仿真时钟半周期取 18.5185 而非 18.518518… 所致） |
| BCK/LRCK | **32.000** ✓ |
| 是否出声 | **是** ✓（199/200 样本非零，第 4 个样本起） |
| **I2S 闭环** | **201 次比对，0 不符** ✓ |

---

## 复现

```powershell
mkdir sim_build\toptb -Force
copy sim_build\additive\sine256.hex sim_build\toptb\   # ★ 必须：$readmemh 找不到会静默输出全 0
iverilog -g2005 -o sim_build\toptb\top.vvp -s tb_tdm_top `
  src\rtl\audio_clk_en.v src\rtl\osc_env.v src\rtl\i2s_tx.v `
  src\rtl\tdm_engine.v src\rtl\tdm_top.v src\sim\tb_tdm_top.v
cd sim_build\toptb ; vvp top.vvp
```

---

## 这次验证解决了什么

1. **`tdm_top` 的开机装载序列能用吗** —— 之前**没人知道**。
   它驱动 `boot_clr` / `boot_pclr`，而这两个信号在引擎里**都已经没有逻辑**
   （`clr` 分支与 `pclr` 预置分支分别在第五轮与第二十三轮被删除）。
   实测：**仍然出声** ✓ —— 因为门初值改成 0 之后，装载时的
   `load_gate=1'b1` 正好构成一次显式 0→1 沿，触发起音 ✓
2. **I2S 链路通不通** —— 全并行版做过（`tb_i2s_tx`），**TDM 路径从未做过** ✗。
   现在补上了：**逐样本一致** ✓

---

## 过程中修掉的三个错误（都是测试台自己的）

### 1. I2S 解码状态机多要一拍 → 收到 0 个样本

一个 LRCK **半帧只有 16 个 BCK 上升沿**，而 **WS 跳变的那一拍本身就是 MSB** ✓。
正确的状态机是「跳变拍移入 bit0，之后 15 拍移入 bit1..bit15」，**恰好 16 拍**。

第一版写成「跳变拍只做检测、不移位，之后收 16 位」——**需要 17 拍**，
在半帧里结构上不可能完成，于是计数永远到不了终点，表现为**收到 0 个样本** ✗。

> **这个约束本身就是判据**：另一种常见理解（「跳变后跳过一格」）同样需要 17 拍，
> 因此**结构上不可能** —— 这从侧面证实了 `i2s_tx.v` 注释所述的约定。

### 2. 把 LRCK 的【半周期】当成了周期

WS 的跳变包含上升沿与下降沿，所以"相邻两次跳变的间隔"是**半周期**。
第一版直接当周期报，得到 **93747 Hz —— 恰好是 46875 的两倍** ✓
**这个数字本身就在提示"你量的是半个周期"。**

### 3. I2S 帧与 `sample_out` 的对齐差一个样本

I2S 帧是在 `sample_en` **之后**的 32 个 BCK 里发出去的，
等左声道收满 16 位，`sample_out` 可能已经推进到下一个样本 ✗。

**没有猜"差几拍"，而是两种对齐都测** —— 结果 `now` 为 0、`old` 为 1，
判据自明 ✓（同一招也用于判定 I2S 约定）。

---

## 审计中发现的待处理项（尚未修）

| 项 | 说明 | 风险 |
|---|---|---|
| `boost_en` 端口 | **早期轮次留下的有害残留**（实测破坏包络关闭基线），现已无人使用 | 死代码，但会误导 |
| `tdm_top` 驱动 `boot_clr`/`boot_pclr` | 两者在引擎里已无逻辑 | 死代码；实测不影响功能 |
| `tdm_top` 硬接 `gate_in(1'b1)` | 无演奏控制 | 功能缺口，非缺陷 |

**三项都需要改 RTL，改完必须重跑 `tb_tdm_equiv` 的 8 掩码回归。**
