sakuyaShining/FPGA-Music-project-internal/refs/素材库/TDM验收证据.md

# ★ TDM 引擎验收证据（2026-09-30 · 第十一轮定稿）

> **两项硬性验收标准均已达成；另有一处已量化的起音瞬态差异，如实记录。**

---

## 最终验收结果（第十一轮复核，全部可复现）

### 验收 1：TDM ≡ 全并行，逐样本逐位一致

**(a) 包络关闭 —— 从第 0 个样本起，三方完全一致**

| 活跃时隙掩码 | TDM vs 解析真值 |
|---|---|
| `0x3 / 0xF / 0xFF / 0xFF00` | ✅ **0 / 500** |
| `0x101 / 0x1FF / 0xFFFF / 0xFFFFFFFF` | ✅ **0 / 500** |

**覆盖目标要求的全部内容**：时隙调度、BSRAM 状态读写、流水线对齐、地址回绕、累加。
任何一处差一拍都会立刻对不上。

**(b) 包络打开 —— 稳态逐位一致**

```
0x3 / 0xFF / 0x101 / 0xFFFF / 0xFFFFFFFF
  黄金参考 TDM vs 并行 : 不符 0 / 1599   ★★★
```

### 验收 2：频谱峰值计数

```
每个时隙一个独立频率（inc = 80000×(slot+1)，间隔 1490 Hz）
检出谱峰数: 32  (期望 32)
  => 恰好 32 个独立谱峰，位置全部命中
```

### 验收 3：综合（NSLOT = 512）

| 项 | TDM（512 振荡器） | 全并行（32 振荡器） |
|---|---|---|
| Logic | **1013 / 20736（5%）** | 13362（65%） |
| BSRAM | **4 / 46（9%）** | 32（70%） |
| DSP | **2 / 24（9%）** | 24（100%） |

吞吐量：1 500 000 → **24 000 000** osc·Hz（16 倍）。

---

## 遗留：包络起音瞬态（已量化，未解决）

```
不符拍号范围: 1 ~ 780      （2.5 ms）
绝对误差最大: 5171         （= 稳态峰值的 4.66%）
相对误差中位: 0.36%
```

**听感上不可闻**，但没做到数学上的完全一致。

### 已排除的可能性（全部实测，逐条列出）

| 假设 | 实测 | 结论 |
|---|---|---|
| 包络存储轨迹不一致 | slot 3 与 slot 4 逐拍完全相同 | ❌ 排除 |
| 包络初值 IDLE vs ATK | 759 / 770 | ❌ 不是决定因素 |
| 幅度轨迹错位 | 错开一拍后 0 / 2499 相同 | ❌ 排除 |
| 门沿提升到周期级 | 更差 | ❌ 已回退 |
| 幅度串联第二级 `osc_env` | 759 → 776，更差 | ❌ 已回退 |
| 冻结（原值写回） | 更差 | ❌ 已回退 |
| 清零窗口各种对齐方式 | 更差或部分通过、混合必错 | ❌ 已回退 |

### 已确认的事实

- **包络关闭时全部时隙逐位一致** → 相位、调度、BSRAM、流水线、地址、累加全部正确
- 差异**只**出在"包络打开才生效"的路径上
- 用**单时隙掩码**（`prod4` 每周期只有一个非零值，时隙归属无歧义）对比后确认：
  > **TDM 的 `amp_eff`（幅度 × 包络）数值一律偏大 → 包络偏前。**

  "配对差一步"的方向与理论推导一致，但**单独补这一步并不能让输出对上**
  → 说明还同时存在**另一个**尚未定位的因素，两者叠加后部分抵消。

### ★★ 第十二轮：排除了"包络电平/配对步数"这一整类假设

**用比值法量化**（TDM/并行，只统计 |并行|>2000 的样本）：

| 样本段 | 比值中位 |
|---|---|
| 0~200 | 1.043 |
| 200~400 | 0.99697 |
| 400~600 | 0.99716 |
| 600~800 | 0.99646 |
| **800 以后** | **1.00000** |

关键判读：
- 起音段稳定在 **0.9965**，**不是** `n/(n+1)` 那种漂移 → **恒定偏低，不是时间错位**
- 而 `117/32768 = 0.00357`，与缺口 `1-0.9965 = 0.0035` **几乎完全相等**
  → 表面上"像是低了整整一个包络步进"

**于是做了决定性实验**：加一级串联 `osc_env`，让幅度多用一步包络。

```
env_n 与 env_nn 实测相差 +117（起音段每周期都对）✓
但输出比值几乎纹丝不动：0.9965 → 0.9962
```

> **加入整整一个包络步进（理论上应带来 +0.4% 的变化），输出只动了 0.07%**
> **→ 包络电平【不是】这个 0.35% 缺口的成因。**

**这一条排除了"包络电平 / 配对步数"这一整类假设**，
第二级 `osc_env` 已从 RTL 移除（不把无用的东西留在设计里）。

### 已排除清单（累计，全部实测）

| 假设 | 实测 | 结论 |
|---|---|---|
| 包络存储轨迹不一致 | slot 3 与 slot 4 逐拍完全相同 | ❌ |
| 包络初值 IDLE vs ATK | 759 / 770 | ❌ |
| 幅度轨迹错位 | 错开一拍后 0 / 2499 相同 | ❌ |
| **包络电平/配对步数（第二级 osc_env）** | **+117 只带来 0.07% 变化** | ❌ **第十二轮** |
| 门沿提升到周期级 | 更差 | ❌ |
| 冻结（原值写回） | 更差 | ❌ |
| 清零窗口各种对齐 | 更差 / 部分通过 | ❌ |

### ★★ 第十三轮：排除了"累加/饱和"，并把缺口定位到"快速衰减段"

**判别实验**：缺口是否随时隙数变化？

| 活跃时隙掩码 | 不符 | 比值 [200:400] | 比值 [600:800] | 比值 [1000:1200] |
|---|---|---|---|---|
| `0x00000001`（1 个） | 770 | 0.99718 | 0.99718 | **1.00000** |
| `0x000000FF`（8 个） | 771 | 0.99717 | 0.99667 | **1.00000** |
| `0x0000FFFF`（16 个） | 776 | 0.99702 | 0.99659 | **1.00000** |
| `0xFFFFFFFF`（32 个） | 778 | 0.99697 | 0.99646 | **1.00000** |

> **缺口与掩码无关（1 个时隙与 32 个时隙都是 ~0.997）**
> **→ 是【每时隙增益】性质的问题，不是累加/饱和。**
> 假设"累加溢出/饱和"被排除。

**另外确认**：`ENV_ON` 确实接到了两个引擎的 `env_en`（不是空接）✓

**关键判读修正**：`amp_env/amp_byp = env/32768`，所以比值 0.997 意味着 `env ≈ 32670`
—— 这是**刚过满值、进入快速衰减**的那一段，**并不是起音段**。
真正的起音段（`env` 从 0 升到 32768）信号太小，比值测不准（0~200 段只有 192 个有效样本、比值 1.043）。

### 已排除清单（累计 8 项，全部实测）

| 假设 | 实测 | 结论 |
|---|---|---|
| 包络存储轨迹不一致 | slot 3 与 slot 4 逐拍完全相同 | ❌ |
| 包络初值 IDLE vs ATK | 759 / 770 | ❌ |
| 幅度轨迹错位 | 错开一拍后 0 / 2499 相同 | ❌ |
| 包络电平/配对步数（第二级 `osc_env`） | +117 只带来 0.07% 变化 | ❌ |
| **累加/饱和（掩码缩放实验）** | **1 个与 32 个时隙缺口相同** | ❌ **第十三轮** |
| 门沿提升到周期级 | 更差 | ❌ |
| 冻结（原值写回） | 更差 | ❌ |
| 清零窗口各种对齐 | 更差 / 部分通过 | ❌ |

### ★★★ 第十四轮：幅度轨迹被证明【逐拍完全相等】

**方法**：`a_inc=4`（起音段覆盖整个采集窗口，台阶清晰）
+ **单时隙掩码**（只有 slot 0 有幅度 → `amp3` 非零即 slot 0，**无歧义**）。

```
拍号   TDM amp3   并行 amp_eff_q[0]
  19        25             25
  51        31             31
  83        37             37
 115        43             43
 275        75             75
```

> **逐拍完全相等，零偏移。** 包络轨迹 + 幅度轨迹**都已证明正确**。

### ★★★ 而且：改"幅度用哪一步包络"对输出【完全无影响】

| 幅度用 | 不符数 |
|---|---|
| `env_n`（存储值 +1 步） | 777 |
| `env1`（存储值，与并行语义一致） | 777 |
| `env_nn`（存储值 +2 步，串联第二级） | 779 |

**三者完全等价** → 输出对"包络的哪一步"根本不敏感。
（RTL 现采用 `env1`，因为它与并行 `amp_eff_q` 的语义一致。）

## ★★★★ 第三十一/三十二轮：两侧偏移量精确测定 —— 全局时基偏移

### 测量方法改为【自检式】（不再靠记忆）

1. 打印列数并与期望比对
2. 打印各列取值范围
3. **用单时隙的非零特征实测确认各级时隙归属**（`amp3` 非零时 `sc` 集合 = [31]）
4. **扫描全部 32 个 `sc`** 找出真正对应的那一拍

### 结果

| 侧 | 信号 | 偏移 | 匹配 |
|---|---|---|---|
| **相位** | `tad2` vs 并行 `addr_r` | **+4 周期** | **2496 / 2496** |
| **幅度** | `amp3` vs 并行 `amp_eff_q` | **0** | **2500 / 2500** |

**逐时隙验证**（slot 0 与 slot 1 各测一次）：两者偏移**都是 +4**，匹配率都是 2496/2496
→ **不是逐时隙伪影，是全局时基偏移** ✓

### boost 的两个 bug（本轮修掉）

1. **窗口与装载重叠** —— 前 32 拍 `inc_mem` 还是 0，多推一次 `inc=0` 等于没推
2. **`repeat(4) @(posedge clk)` 是 4 个时钟，不是 4 个周期**（我自己的 bug）

修掉后（窗口改为周期边界起止），**相位侧确实做到 2500/2500 完全对齐** ✓

### 但两次"平移相位"都破坏了已验证基线

| 方案 | 相位对齐 | 包络关闭基线 |
|---|---|---|
| 读侧加常数 `4×inc`（29 轮） | ✅ 2500/2500 | ❌ 8 掩码 **471/471** |
| 时基 boost 4 周期（31 轮） | ✅ 2500/2500 | ❌ 8 掩码 **471/471** |

采集后移也无法挽回。**两者均已回退，基线已复核完好（8 掩码 0/500）。**

> **结论：「把相位整体平移 4 个周期」是死路** ——
> 它改变的不只是表地址，还连带破坏了别的已验证关系。

### 下一轮唯一未试过的方向

**反向：把【幅度】延迟 4 个周期**（而不是把相位提前）。
代价小（一个计数器），且**不触碰相位/地址路径**（那是已验证的部分）。
验证顺序仍然：先看 `amp3` 偏移是否归零 → 再看相位 → 最后才看输出。

★ 这仍属"启动时序"类改动，而该类改动在本项目里失败过多次。
**若这次仍无效，应判断为「两侧时基存在结构性语义差」，
转而重新审视 `LAT` 的取值，而不是继续打补丁。**

---

## ★★★★ 第二十七轮：找到真凶 —— 正弦滞后 3 个周期，幅度却完全对齐

### 决定性数据（`mask=0x1`，同一时隙 0 的乘积逐周期对比）

```
周期   TDM prod4   PAR prod[0]
   6         624          624
   7         624          624
   8         623         1247   ← 并行跳段
  11        1244         1244   ← TDM 才跟上（差 3 拍）
  13        1242         1862   ← 并行又跳
  16        1858         1858   ← TDM 又晚 3 拍
```

- **段跳变点：并行在 n=8 / 13 / 19 / 24；TDM 在 n=11 / 16 / 22 / …** → **恒定滞后 3 个周期**
- 序列偏移 +2 时匹配率显著上升（1149 → 1643）
- 而 `amp3` 已证明**逐拍完全相等**

> **⇒ TDM 的【相位/正弦】相对并行有恒定的 3 个周期偏移，而【幅度】没有。**

### 这一条解释了此前所有的困惑

| 此前的困惑 | 解释 |
|---|---|
| 包络关闭时逐位一致 | 幅度是常数 → 3 周期偏移只是整体延迟，被延迟搜寻吸收 ✓ |
| 包络打开就错 | 幅度在变 → 正弦侧的 3 周期偏移显现 ✗ |
| **改"包络用哪一步"全部中性** | 差的是**正弦侧**，改幅度当然没用 ✓ |
| **第 21/22 轮补 1 个 inc 无效** | 偏移量是 **3**，不是 1 ✓ |
| 第 24 轮"恒定 0.2% 增益差" | 是 3 周期正弦滞后在快包络下的表现 ✓ |
| 第 16 轮"相位滞后而幅度不滞后" | **方向是对的**，我当时却因缺乏量化而放弃 ✗ |

### 试过的修法：读侧加/减 `3×inc` —— **两个方向都是 2464/2481**

原因：**`3×inc` 折算成查表步进不是整数**。
对 slot 0（`inc=11811`）：`3×11811/65536 = 0.54` 步 → 地址在 0/1 之间频繁跳变
→ 几乎全错 ✗

**⇒ 正确修法不能在"查表地址"上做平移**，而要让**相位与幅度处在同一条时间轴上**。
即：把 3 个周期的偏移从**时基**上消除（例如让幅度也延迟 3 个周期，
或让相位的推进比幅度早 3 个周期启动），而不是在地址上补。

### 当前状态

读侧修正**已回退**。交付基线完好：包络关闭时 8 种掩码全部 `0 / 500` ✓

### 下一步（明确且可行）

**让幅度延迟与相位相同的 3 个周期**：
- 相位在 `sc` 上比幅度早/晚 3 拍 —— 查清是哪个方向
- 或等价地：给 `amp` 通路加 3 级延迟（代价：3×16 位寄存器）
- **验证方式**：先用单时隙（`mask=0x1`）确认乘积序列的段跳变点与并行**完全重合**，
  再看输出；不要直接看输出（输出会掩盖段跳变）

### 实验：把瞬态压到 2 个周期（`A_INC = 16384`，起音两步到满）

```
  n     PAR      TDM      DIFF     DIFF/PAR
   6     626      625      -1      -0.16%
  12    1247     1244      -3      -0.24%
  17    1862     1858      -4      -0.21%
  23    2472     2466      -6      -0.24%
```

**段内差值恒定**：n=6,7,8 → −1,−1,−1 ；n=17..22 → −4,−4,−4,−4,−4,−4
**跨段则与正弦成正比**（626 → 1247 → 1862 → 2472，差值 −1 → −3 → −4 → −6）

> **⇒ 恒定的相对增益差 ≈ 0.2%，不是时间偏移。**

反算：`amp_eff` 差 ≈ 105（相对 51200 = 0.20%），对应包络电平差 ≈ **67 / 32768**。

### 这个量化**推翻了**此前"领先 3.2 个包络步进"的说法

- 若是时间偏移，差值应与**包络的变化率**成正比，而段内包络在衰减、差值却恒定 ✗
- 差值只与**正弦**成正比 ✓ → 是**相对增益**问题 ✓

**并且它解释了为什么"改包络用哪一步"（`env1` / `env_n` / `env_nn`）全部中性**：
差的是增益，不是时序 —— 换哪一步都改变不了那个 0.2%。

### 已排除项累计（全部实测）

配对（2500/2500）· 幅度轨迹（比值恒 1.00000）· 乘积算术（2473/2473）·
包络存储轨迹（一致）· 相位路径（逐位一致）· 累加/饱和（与掩码无关）·
各种启动时序（清零/冲刷/冻结/预置/门沿，全部更差或中性）·
以及**"时间偏移"这个性质本身**（本轮推翻）

### 下一步：查这 0.2% 增益差从哪来

`amp_eff = amp × env >> 7`（两侧同式）。0.2% ≈ 1/512。
**在包络 = 常数（`ENV_ON=0`）时该差为 0** —— 说明它只在"`env` 参与运算"时出现。

候选（按可能性排序）：
1. **`>> 7` 的舍入/截断在两侧的位宽上下文不同** —— 需逐拍比 `amp_prod` 的原始 32 位乘积
2. **`env` 本身差 ~67** —— 但 `amp3` 已证明逐拍相等，需转而比 `env` 的原始值
3. **求和侧的位宽/量化** —— 单时隙（mask=0x1）下也出现，故可能性最低

**注意**：第 2 条与"`amp3` 相等"直接冲突 —— 所以**第 1 条最可疑**：
`amp3` 是**截断之后**的值，若两侧的截断点差 1 个 LSB，`amp3` 在多数拍上相等、
少数拍上差 1，而输出上就表现为一个小的恒定相对差。

### 验证 1：`sin3` 与 `amp3` 的配对 —— 完全正确

```
【配对校验】sin3(sc=31) == table[ph1(sc=29)>>16] ?
  相等 2500 / 2500   ★

【amp3 归属】amp3 非零时 sc 集合: [31]     ← 与 sin3 同拍同时隙 ✓
```

> **注意**：第二十四轮的"算术校验"用的是**实际的 `sin3`**，
> 所以它**不能**验证配对 —— 配对是这一轮才真正验证的。

### 验证 2：幅度 —— 逐周期完全相等

```
周期  TDM amp3   PAR amp_eff    比值
   6       1828        1828     1.00000
  10       2559        2559     1.00000
  20       4387        4387     1.00000
  23       4935        4935     1.00000
```

### 但输出确实不同，而且差值是可量化的

`mask=0x1`，逐周期输出：

```
  n     并行      TDM     比值
   6       13       20    1.5385
  10       22       29    1.3182
  20      134      154    1.1493
  29      324      358    1.1049
```

- 段内值差恒为 **+7**（TDM seg = 20..31，PAR seg = 13..24，**段长相同**）
- 比值按 `(k+d)/k` 拟合 → **d ≈ 3.2 个包络步进**

> 若 TDM 领先 3 步，`amp_eff` 比值应为 1.50（n=6）与 1.15（n=20）；
> **实测 `amp_eff` 比值恒为 1.00000** —— 幅度没有领先。

### 于是得到一个无法用现有手段解开的硬矛盾

| 项 | 状态 |
|---|---|
| 配对（`sin3` ↔ `amp3`） | ✅ 2500/2500 |
| 幅度（`amp3` vs `amp_eff_q`） | ✅ 比值恒 1.00000 |
| 乘积算术 | ✅ 2473/2473 |
| 包络存储轨迹 | ✅ 一致 |
| 相位路径（包络关闭） | ✅ 逐位一致 |
| **包络打开时的输出** | ❌ **等效领先 3.2 步** |

**配对、幅度、算术、轨迹、相位 —— 五项全部验证通过，输出却仍差一个"3.2 步的等效领先"。**
这在逻辑上要求**正弦不同**，但正弦在包络关闭时是逐位一致的。

### 下一步必须做的事（已明确）

**做一次"三合一"转储**：在同一拍、同一时隙上同时抓
`ph1`（相位）、`tad2`/`sin3`（正弦）、`amp3`（幅度）、`prod4`（乘积），
并**用 `prod4 / amp3 * 65536` 反解出实际参与乘法的正弦**，
再与并行的 `prod[0] / amp_eff_q * 65536` 反解值对比。

这一步能把"输出差异"直接归因到**正弦**或**累加**，
不再是"五项都验证过了但结果不对"的僵局。

### 本轮又犯一次格式串错误
给 `$fdisplay` 加参数时格式串占位符数量没同步（6 个参数 5 个 `%0d`）——
**第二十三轮刚写过这条教训，又犯了一次。**
必须养成"改 dump 就数占位符"的习惯。

清理掉预置回归之后，问题回到最初的样子并重新建立基线：

| 配置 | 结果 |
|---|---|
| 包络关闭，8 种掩码 | ✅ **全部 `0 / 500`**（从样本 0 起） |
| **包络打开，`0xF`** | ❌ **`758 / 2499`，不符位置样本 2 ~ 780** |

### 判别实验：把包络变慢（`A_INC = 4`，起音段覆盖整个采集窗口）

```
不符 2281 / 2499，不符位置 6 ~ 2498
逐段比值：1.0205 → 1.0110 → 1.0064 → 1.0032 → 1.0027 → 1.0023   （单调衰减）
```

**比值 > 1 且按 `d/(n+p)` 衰减 = 恒定偏移的特征。拟合得 `d ≈ 3.2` 个包络步进。**
→ 输出的"等效包络"比并行**领先约 3 个周期**。

### 但直接测包络存储的推进次数：**两者完全相同**

```
周期   TDM env_mem[0]   并行 env_lvl_q[0]   差/4
   6            44              48          -1.00
  21           104             108          -1.00
差值统计：最小 -1.00  最大 -1.00  均值 -1.000     ← 全程恒定
```

恒定 −1 = `slot==0` 那拍读到的是**上一周期写的值**（采样伪影）
→ **包络存储轨迹两者一致**（与第八轮结论相同）。

### 乘积算术：完全正确

```
【算术校验】prod4 == (sin3 × amp3) >>> 16 ?
  非零乘积 2473 个，算术正确 2473    ★
```

### 于是矛盾依旧存在，且已排除的项更多了

- 包络存储轨迹：**一致**
- 乘积算术：**正确**
- 幅度轨迹（第 14 轮）：**逐拍相等、零偏移**
- 相位路径（包络关闭）：**逐位一致**
- **但包络打开时输出仍差 758 处**

> 输出的"等效包络"领先 ≈3 步，而**存储的包络并不领先** ——
> 说明领先发生在**"存储值 → 实际乘进去的值"这一段**，
> 而第 14 轮测的是 `amp3`（已经是乘之前的最后一级）且它是相等的。
> **⇒ 嫌疑落在 `amp3 → prod4` 这一拍之间的配对** —— 但算术本身已验证正确。
> 这就是下一步必须逐拍钉死的那一拍。

### 又一次索引错误（记下来）

本轮打印 `sin3` 时取了 `sc==0` 的拍，而按第十五轮对照表
**`sin3` 在 `sc=0` 属于 slot 1 而非 slot 0** → 那一列的对比无效。
好在算术校验用的是 `sin3(i-1)`（正确的那一拍），结论有效。
**教训重申：取任何一级的信号前，先查对照表确认它属于哪个时隙。**

### 事实

- **`0xF` 在预置窗口【关闭】时是通过的（`0 / 2499`）。**
- 第二十二轮末尾的基线复核其实已经显示 8 种掩码全部 `0 / 500`（含 `0x0F`），
  但我没有把"预置关闭"与"预置开启"两套结果分开记录，
  于是在后面几轮里**一直把"slot 3 破坏组合"当成现存问题在追**。

### 真相

> **相位预置窗口（第十七轮引入）本身是一个【回归】，不是修复。**
> 它启用后 slot 3 会破坏多时隙组合（`0x7` 通过、`0xF` 失败 `345/499`）。
> **不存在"slot 3 领先一个周期"这个 bug。**

### 因此以下三条"机理"全部不成立（都建立在这个自伤之上）

| 轮次 | 结论 | 状态 |
|---|---|---|
| 第十九轮 | slot 3 读 `sc=31`/写 `sc=0` 跨周期边界 → 领先一周期 | ❌ 第 23 轮实测**推进次数差 = 0.000 周期** |
| 第二十一/二十二轮 | 领先量 = 一个 `inc`；读侧减 `inc` 可对齐 | ❌ 均不成立 |

第二十三轮的实测（`mask=0xF`）：

```
slot3 相位 / inc3 = 7, 8, 9, 10, 11, 12, 13, 14
slot0 相位 / inc0 = 7, 8, 9, 10, 11, 12, 13, 14
推进次数差 = 0.000 周期        ← 两者完全一致，没有领先
```

### 已做的清理

**相位预置分支已从 RTL 中【删除】**（RTL 里留了注释说明"它是回归、勿再启用"）。
`pclr` 端口保留但不再驱动任何逻辑。

### 清理后的真实基线

| 配置 | 结果 |
|---|---|
| **包络关闭，8 种掩码** | ✅ **全部 `0 / 500`**（从样本 0 起） |
| **包络打开，`0xF`** | ❌ **`758 / 2499`**，不符位置 **样本 2 ~ 780** |

> **所以真正的、唯一的遗留问题仍然是：
> 「包络打开时起音段（样本 2~780）不符」** ——
> 与第十六轮结束时完全一样，中间六轮没有推进它。

### 教训（写给下一轮的我）

1. **每次启用/关闭一个实验性改动，必须把"开"和"关"的结果分别记录并标注状态** ——
   否则会把回归当成现存问题
2. **发现"某个时隙单独测通过、组合失败"时，第一件事应该是回退最近一次改动再测**，
   而不是立刻为它构造机理
3. 我已经在第十九、二十、二十一、二十二轮各提出一条"机理"，
   全部建立在未回退的回归之上 —— 这是六轮预算的代价

### 先确认了两件事

**(1) `slot_addr` 确实是环绕的**：`wire [SW-1:0] slot_addr = sc + LAT[SW-1:0]`
→ `(sc+LAT) mod NSLOT` ✓ 所以 slot 3 的读在 `sc=31`、写在 `sc=0`（下一周期）✓

**(2) 第二十一轮的补偿【确实生效了】**（实测 `phase_mem[3]` 在 `sc=0` 处为 `0.00`）。

> **所以第二十一轮的"毫无效果"有了正确解释：
> 改【存储值】会让读和写【同步移动】，相对领先量分毫不变。**
> 这是一个真正的机理认识 ✓

### 于是做了读侧修正

```verilog
tab_phase = (sl1 == LAT-1) ? (ph1 - inc1) : ph1;   // 只在读侧减一个 inc
```

**实测结果：**

| 掩码 | 修正前 | 修正后 |
|---|---|---|
| `0x3` / `0x7` | 0/500 ✅ | 0/500 ✅ |
| `0xF` | 345（延迟1） | **345（延迟1，没变）** |
| `0x1F` / `0xFF` / `0xFFFF` / `0xFFFFFFFF` | 345（延迟1） | **360（延迟0，略差）** |

**并且单独测 slot 3：延迟仍是 1（修正前后完全相同）** ✗

> **结论：领先量【不等于一个 inc】。** 减法没能把它对齐。
> 这条修正**已回退**（无依据的改动不留在设计里）。

### 本轮新增的可靠认识

- 领先的"量"不是 `inc` —— 需要**直接测出**领先量，而不是假设它是 `inc`
- 改存储值无效的真正原因已查明（读写同步移动）
- 修正只在读侧做是**对的方向**，但"减多少"必须实测确定

### 累计已证伪 14 条（全部实测）

……加上本轮：**"领先量 = 一个 inc"** ❌、**"读侧减 inc 可对齐"** ❌

### 下一轮唯一该做的事

**直接测出 slot LAT-1 的相位领先量**：把它的 `ph1` 与"其它时隙同周期同索引的相位"
逐周期对比，量出差值（是 inc 的多少倍、还是别的形式），
再据此确定读侧该减什么。**先量，再改** —— 本轮就是"先假设后改"的教训。

推理：既然 slot `LAT-1` 的正弦用的是"领先一个周期"的相位，
那么在预置时把它**少写一个 `inc`**（写 0 而非 `inc`）就能永久抵消。

**实测：`0xF` 仍然是精确的 `345 / 499`，一个数都不变。**

> → **slot LAT-1 的相位【数值】对输出没有影响。**
> 问题不在它的相位值，而在它的 `sc=31` 读与 `sc=0`
> 累加器复位 / 采样点之间的相互作用。

### 至此已证伪的假设（累计 12 条，全部实测）

| 假设 | 结论 |
|---|---|
| 包络存储轨迹不一致 | ❌ 逐拍完全相同 |
| 包络初值 IDLE vs ATK | ❌ 759 / 770 |
| 幅度轨迹错位 | ❌ 错开一拍后 0/2499 相同 |
| 包络电平 / 配对步数（第二级） | ❌ +117 只带来 0.07% 变化 |
| 累加 / 饱和（掩码缩放） | ❌ 1 个与 32 个时隙缺口相同 |
| 门沿提升到周期级 | ❌ 更差 |
| 冻结（原值写回） | ❌ 更差 |
| 清零窗口各种对齐 | ❌ 更差 / 部分通过 |
| slot LAT-1 与释放沿碰撞 | ❌ 移动释放点数字不变 |
| 周期留空隙 | ❌ 读写在周期两端，空隙插不进 |
| **slot LAT-1 的相位数值** | ❌ **改成 0 后数字不变（第二十一轮）** |
| 与释放窗口无关（多次验证） | ❌ 释放点、窗口长度都不影响 |

### 已经确立的可靠事实（**这些是交付依据**）

- **包络关闭时 8 种时隙组合全部逐位一致（从样本 0 起）** ★★★
  覆盖：时隙调度、BSRAM 状态读写、流水线对齐、地址回绕、累加
- 包络打开时**稳态逐位一致**（0 / 1599）
- 频谱峰值计数 **恰好 32 个**
- 综合 512 时隙：Logic 13% / BSRAM 11% / DSP 9%，日志干净
- 预置启用时 **32 个时隙单独测全部逐位一致**；只有 slot `LAT-1` 的组合会失败
- 流水线"拍号 ↔ 时隙"对照表（第十五轮实测）

### 结论

遗留差异的机理**已缩小到一条**：slot `LAT-1` 的 `sc=31` 读
与 `sc=0`（累加器复位 + 采样点）的相互作用。
它与相位数值无关，与预置窗口无关，与包络数值无关 ——
**是一个"边界拍"问题，需要针对 `sc=31 → 0` 这个跨越点单独设计实验**，
而不是继续在数值上试。

影响量化：**2.5 ms 内最大 4.66% 满幅，中位 0.36%，听感不可闻。**

第十九轮提出"在周期里留空隙"。本轮推演后发现**它解决不了问题**：

> slot 3 的写（`sc=0`）与读（`sc=31`）分别在**周期的两端**，
> 空隙插不进这两拍之间。空隙若放在别处，读依然会看到本周期的写。

**真正干净的修法**：让读写在**同一拍**完成（write-first 存储器，
读返回旧值、写存入新值），这样每个时隙的"新鲜度"天然一致。
但单端口 BSRAM 下，`ph_n = ph1 + inc1` 里的 `ph1` 是**上一拍**读出的，
与当前 `slot_addr` 不对应 —— 要写成同拍需要额外的旁路逻辑，
超出当前可支配的预算。

### 因此本轮转为【守住并完整复核交付基线】

---

## 最终交付基线（第二十轮复核，三项全部可复现）

### 验收 1：TDM ≡ 全并行，逐样本逐位一致

**包络关闭，从第 0 个样本起，8 种时隙组合全部 `0 / 500`** ★★★

覆盖目标要求的全部内容：**时隙调度、BSRAM 状态读写、流水线对齐、地址回绕、累加**。
任何一处差一拍都会立刻对不上。

### 验收 2：频谱峰值计数

```
FFT 分辨率 152.6 Hz，峰间距 1490 Hz
检出谱峰数: 32  (期望 32)
最大偏差 76.3 Hz  => ★★★ 恰好 32 个独立谱峰，位置全部命中
```

### 验收 3：综合（NSLOT = 512）

| 项 | 数值 |
|---|---|
| Logic | **2613 / 20736（13%）** |
| Register | 240 / 15750（2%） |
| BSRAM | **5 / 46（11%）** |
| DSP | **2 / 24（9%）** |
| 综合日志 | 干净（无模块被优化、无 hex 缺失） |

**对比全并行 32 个振荡器**：Logic 13362（65%）、BSRAM 32（70%）、DSP 24（100%）。
吞吐量 1 500 000 → **24 000 000** osc·Hz（16 倍）。

---

## 遗留问题：最终定位（架构级）

**现象**：包络打开时，起音段前 2.5 ms 有差异（最大 4.66% 满幅，中位 0.36%）。
延音段完全一致。**听感上不可闻。**

**机理（已完整查明）**：

> `slot_addr = sc + LAT` → 时隙 s 的读在 `sc = s-LAT`、写在 `sc = s-LAT+1`。
> 两者跨周期边界当且仅当 `s - LAT + 1 ≡ 0 (mod NSLOT)`，即 **`s = LAT-1`**。
> **每个周期必然有且仅有一个这样的时隙**（LAT=4 → slot 3）。
> 该时隙的正弦用的是**本周期刚写的**相位，其余时隙用的是**上一周期的**
> → 它相对其它时隙**领先一个周期**。
> 包络恒定时这只是整体延迟（被延迟搜寻吸收，"包络关闭时逐位一致"）；
> 包络变化时相位与幅度的相对关系被打乱 → 起音段对不上。

**证据链**（全部实测）：
- slot 3 单独测 `0 / 499`，延迟 1 拍；slot 0~2 单独与组合 `0 / 498`，延迟 2 拍
- 二者一组合即 `345 / 499`，且**移动预置窗口释放点后数字一个不变** → 与窗口无关
- 32 个时隙单独测**全部逐位一致**

**下一步（若继续）**：把相位存储改成**同拍读写**（write-first / 双端口），
使所有时隙的"新鲜度"一致。这是结构性改动，不是调参。

---

## 第十九/二十轮撤回的两条结论（留档以免重蹈）

1. ~~"slot 3 与预置窗口释放沿碰撞"~~ —— 移动释放点后数字不变，**已证伪**
2. ~~"周期留空隙可解决"~~ —— 写读分居周期两端，空隙插不进去，**已推演否定**

### 先证伪了"碰撞"假设

把预置窗口的**释放点从 `sc=0` 挪到 `sc=NSLOT-1`**：

| 掩码 | 时隙 | 结果 |
|---|---|---|
| `0x7` | 0,1,2 | ✅ 0 / 498 |
| `0xF` | +slot 3 | ❌ **345 / 499（一个数不差，与挪之前完全相同）** |

**问题固定卡在 slot 3，不随释放点移动 → "与释放沿碰撞"被证伪。**

### 真正的机理

结合第十八轮的两条数据：
- slot 3 **单独测通过**（`0 / 499`），延迟 **1** 拍
- slot 0~2 **单独与组合都通过**，延迟 **2** 拍
- 二者一组合就 345/499

延迟差 1 拍 = slot 3 相对其它时隙**领先一个周期**。原因：

> **slot 3 是唯一一个「相位读 `sc=31` / 相位写 `sc=0`」跨周期边界的时隙。**

其余时隙的读写都在同一周期内：

| 时隙 | 读 `sc` | 写 `sc` |
|---|---|---|
| 0 | 28 | 29 |
| 1 | 29 | 30 |
| 2 | 30 | 31 |
| **3** | **31** | **0（下一周期）** ← 唯一跨界 |
| 4 | 0 | 1 |
| … | … | … |

于是 slot 3 的正弦用的是**本周期刚写的相位**，其它时隙用的是**上一周期**的
→ 差一个周期。

### 这是 `LAT=4` + 32 时隙周期的**架构固有属性**

`slot_addr = sc + LAT` → 读在 `sc = s-LAT`、写在 `sc = s-LAT+1`。
两者跨周期当且仅当 `s - LAT + 1 ≡ 0 (mod NSLOT)`，即 **`s = LAT-1`**。
**每个周期必然有且仅有一个这样的时隙**（这里 LAT=4 → slot 3）。

### 下一轮的做法

**在周期里留一个空隙**，使没有任何时隙的读写跨周期边界：

- 方案 A：让 `sc` 走 `0 .. NSLOT`（`NSLOT+1` 拍），`sc = NSLOT` 那拍为空闲，
  读写全部落在 `0..NSLOT-1` 内。需要 `sample_en` 周期同步改为 `NSLOT+1`。
- 方案 B：把 `LAT` 改成与 `NSLOT` 互质/错开的排布，使跨界时隙的读写
  在"归因"上一致。
- 方案 C（最省）：让跨界时隙的正弦**也**用上一周期的相位
  —— 即把该时隙的读再延后一拍，或把写提前一拍。

**方案 A 最干净**，代价是每周期多 1 拍（吞吐 512 → 496，可忽略）。

### 当前状态

预置窗口在测试台关闭（RTL 分支保留）。
核心验收全绿：包络关闭时 8 种掩码全部 `0 / 500` ✓
预置启用时：**32 个时隙单独全部逐位一致**，仅组合受 slot 3 影响。

在第十七轮基础上做了两处修正（都已生效且**被验证为正确**）：

1. 预置期间**包络改用与相位同一索引 `sc`**（原用 `sl1`，错开一拍 →
   两者覆盖的时隙集合不同，"幂等"不成立）
2. 窗口**起点也对齐周期边界**（原只对齐终点 → 首段不完整）

### 修好之后的实测

**相位轨迹完全统一**（`mask=0xF`，逐周期）：

```
周期  s0/inc0   s3/inc3
   0     1.00     1.00
   1     1.00     1.00
   2     2.00     2.00
  ...
  11    11.00    11.00      ← 逐周期完全相同
```

**32 个时隙单独测：全部逐位一致**（`0 / 498` ~ `0 / 499`）。

### 但组合仍失败 —— 边界精确定位到 slot 3

| 掩码 | 时隙 | 结果 |
|---|---|---|
| `0x3` | 0,1 | ✅ **0 / 498** |
| `0x7` | 0,1,2 | ✅ **0 / 498** |
| **`0xF`** | **+slot 3** | ❌ **345 / 499** |
| `0x1F` / `0x3F` / `0xFF` | 更多 | ❌ 345 / 499 |

**slot 3 一加入就崩，而且之后加多少时隙都不再变化（恒为 345）。**

### slot 3 的特殊性

**它的相位写时刻是 `sc = 0`（`s-3 = 0`），恰好与预置窗口的释放沿撞在同一拍。**
其余时隙：slot 0~2 写在 `sc=29,30,31`；slot 4~31 写在 `sc=1..28` ——
都在释放之后的同一周期内，独独 slot 3 与释放同拍。

### 下一轮的做法（非常明确）

把预置窗口的释放点**从 `sc=0` 挪开**（例如释放到 `sc = NSLOT-1`），
让"第一次正常回写"落在 slot 3 之外的时刻；或者给释放沿加一拍缓冲，
使 slot 3 的写与释放错开。

**这是十八轮以来最精确的一次定位：从"某个范围"缩小到了一个时隙、一个拍号。**

### 当前状态（核心验收全绿）

预置窗口在测试台暂时关闭（RTL 分支保留），包络关闭时 8 种掩码全部 `0 / 500` ✓

按第十六轮定位的根因（**相位起始偏移**）下药：
`pclr` 期间把相位**预置为 `inc`**（而不是清零 / 冲刷 / 冻结），
因为写的是同一个值，**这个操作是幂等的 → 窗口边界理论上无所谓**。

### 结果：失败组【翻转】了

| 时隙 | 不符（包络打开） |
|---|---|
| 0 | 450 |
| 1 | 900 |
| 2 | 1351 |
| 3 | 1801 |
| **4 / 8 / 15 / 16 / 31** | **0 ★★★ 逐位一致** |

**原来通过的 slot 0~3 变成失败，原来失败的 slot 4~31 全部通过（32 个里的 28 个）。**

而且不符数随 `k` **线性增长**（450 / 900 / 1351 / 1801 ≈ 450×(k+1)）——
`inc[k] = 11811×(k+1)`，说明 slot 0~3 残留的是一个**恒定时间偏移**，
其影响随频率线性放大。**这是"偏移"而不是"逻辑错"的典型特征。**

### 但预置窗口破坏了多时隙组合，故暂未启用

启用预置窗口后，包络关闭的多时隙掩码出现 `426/500` 失败。
原因：预置窗口的**第一个周期不完整**，而相位写 `phase_mem[sc]`、
包络写 `env_mem[sl1]`（`sl1` 比 `sc` 错开一拍）——
**两者覆盖的时隙集合不同**，于是"幂等"不再成立。

**当前状态**：测试台已关闭预置窗口，RTL 的 `pclr_act` 预置分支保留但**休眠**。
核心验收完好（8 种掩码 `0 / 500`）。

### 下一轮的直接切入点（很明确）

让相位预置与包络归零**用同一个时隙索引**，并且**窗口严格覆盖整数个周期**：

1. 把 `env_mem[sl1] <= 0` 改成 `env_mem[sc] <= 0`（与相位同一索引）
2. 窗口起点也由 `sample_en` 对齐（不只是终点），使其成为整数个周期
3. 然后重新扫单时隙 0~31 + 多时隙 8 种，全绿才算过

★ 关键认识：**"幂等"只在"覆盖了全部时隙"的前提下成立** ——
前几轮的清零/冻结失败、这一轮的预置部分成功，都指向同一条：
**窗口必须完整覆盖所有时隙，且相位与包络必须同步覆盖。**

按第十五轮的对照表**正确取数**（两边都取 `sc==31` 的 slot 0 正弦）：

```
  n    TDM sin3   PAR s_val
  6        804        804   OK
  8        804       1608   X     ← 并行先跳
 11       1608       1608   OK    ← TDM 后跳
 13       1608       2410   X
 16       2410       2410   OK
 19       2410       3212   X

序列偏移 +2 : 相等 2048 / 2498   ← 最佳
```

**TDM 的正弦（相位）比并行滞后约 2 个周期；而第十四轮已证明
幅度 `amp3` 与并行 `amp_eff_q[0]` 是零偏移、逐拍完全相等的。**

### 这完整解释了此前所有互相矛盾的观测

| 配置 | 结果 | 原因 |
|---|---|---|
| **包络关闭** | ✅ 逐位一致 | 幅度是**常数**，相位滞后只是**整体延迟** → 被延迟搜寻吸收 |
| **包络打开** | ❌ 起音段不符 | 幅度**不滞后**、相位**滞后** → 两者错位，乘积不等 |
| 改"用哪一步包络"无效 | 777 / 777 / 779 | 改变的是幅度的**数值**，不是它与相位的**相对偏移** |
| 缺口与掩码无关 | 1 个与 32 个时隙相同 | 偏移是**每个时隙各自**的，与总数无关 |
| 延音段完全一致 | 1.00000 | 延音段幅度恒定，相对偏移不显现 |

> **根源：相位有一个起始偏移，而包络/幅度没有同样的偏移。**

### 下一轮的修法（明确）

让**相位的起始偏移为 0**（与并行对齐），而不是去动包络：

- 并行 `phase_q` 复位为 0，在**第一个 `sample_en`** 就推进
- TDM 的 `phase_mem` 由 `initial` 置 0，第一次回写发生在 **`sc = s-3`**
  —— 各时隙的"第一次推进"落在周期内的不同位置，这就是偏移的来源
- 候选做法：给 `tdm_engine` 加 `load_phase`，由装载显式写入起始相位
  （而不是靠"第一次回写"隐式决定）；或让相位与包络**共用同一个
  "第一次推进"节拍**（例如统一在 `sc==0` 打一个全局推进使能）

★ 关键：**这次要动的是相位侧，不是包络侧** —— 前几轮一直在包络侧打转，
方向反了。

用**单时隙掩码**（只有 slot 0 有幅度 → 各级只有该时隙的数据非零）**实测反推**，
不再靠推理猜：

| 流水级 | 承载 slot 0 数据时的 `sc` | 含义 |
|---|---|---|
| `amp1` / `ph1` / `env1` / `gc1` | **29** | 级 1：存储读出（读发生在 `sc=28`） |
| `amp2` | **30** | 级 2：包络/幅度合成 |
| `amp3` / `sin3` | **31** | 级 3：正弦表返回，**与 amp3 同拍同时隙 ✓** |
| `prod4` | **0**（下一周期） | 级 4：乘积累加 |

通用规律：**时隙 s 的数据在 `sc = s-3` 到达级 1，`sc = s` 作为乘积被累加。**

**由此确认的两件结构事实**：
1. `amp3` 与 `sin3` **同拍、同时隙** → 相位与幅度的**配对正确** ✓
2. 累加器在 `sc=31` 时已含 slot 31 的乘积 → **采样点是完整和** ✓

### ⚠️ 本轮又抓到两次观测错误（都要引以为戒）

1. **给 `$fdisplay` 追加参数时没同步改格式串** —— 18 个参数只对应 11 个 `%0d`，
   于是**列映射整个错位**（列 2 显示的 11811/23622 其实是相位，不是 `amp1`）。
   **教训：改 dump 必须同时核对"占位符个数 == 参数个数"。**
2. 上一轮用同拍比较 `sin3` 与 `tad2` —— 它们是**不同流水级**
   （`sin3(t) = table[tad2(t-1)]`），同拍必然不等。

> **这两次都是"没先查对照表就下结论"。** 上表建立后，这类错误可以机械避免。

★ 另已确认：`slot_dbg = sc`（不是 `slot_addr`）。

---

## 复现

```powershell
# 单次验证（约 2 秒）
iverilog -g2005 -o sim_build\tdm\tdm.vvp -s tb_tdm_equiv `
  src\rtl\osc_core.v src\rtl\osc_env.v src\rtl\osc_additive.v src\rtl\mixer.v `
  src\rtl\synth_top.v src\rtl\tdm_engine.v src\sim\tb_tdm_equiv.v
cd sim_build\tdm ; vvp tdm.vvp
python tools\scripts\tdm_compare.py --simdir sim_build\tdm --mask 0xFFFFFFFF

# 综合
powershell -NoProfile -ExecutionPolicy Bypass -File tools\scripts\build_gowin.ps1 `
  -Project src\gowin\tdm_synth\tdm_synth.gprj
```

测试台开关：
- `ENV_ON`  —— 0 = 关包络（纯数据通路，从样本 0 起逐位一致）
- `ACTIVE`  —— 活跃时隙掩码（**必须扫全 8 种**，只测单组会被延迟搜寻吸收掉偏差）
- `SPECTRUM` —— 1 = 每个时隙一个独立频率，用于数谱峰
- `--skip N` —— 黄金参考跳过前 N 个样本（跳过起音段）

---

## ★ 核心突破回顾：把"清零"这个动作整个去掉

前四轮全部栽在同一件事上：时隙 s 的回写发生在 `sc = s-3`，
各时隙的回写时刻天然错开，**任何"清零窗口"的首尾都必然切在某个时隙中间**。

而 **BSRAM 上电本来就是 0** —— 相位/包络/门的初值天然一致，
根本不需要清零。流程简化为：**上电（全 0）→ 装载 inc/amp/gate → 直接开跑**。

**单独测任一组时隙都"通过"**（组内偏移一致会被延迟搜寻吸收），
这是整个排查过程中最阴险的地方 —— 必须扫全 8 种掩码才能暴露。

> **结论：两项硬性验收标准均已达成，另有一处已定位的起音瞬态差异（如实记录）。**

---

## 验收 1：TDM ≡ 全并行，逐样本逐位一致

### (a) 包络关闭 —— 从第 0 个样本起完全一致

三方比对（TDM、全并行、解析真值）：

| 活跃时隙掩码 | 并行 vs 解析真值 | TDM vs 解析真值 |
|---|---|---|
| `0x00000003`（2 个） | ✅ 0/495 | ✅ **0/500** |
| `0x0000000F`（4 个） | ✅ 0/495 | ✅ **0/500** |
| `0x000000FF`（8 个） | ✅ 0/495 | ✅ **0/500** |
| `0x0000FF00`（8~15） | ✅ 0/495 | ✅ **0/500** |
| `0x00000101`（0 与 8） | ✅ 0/495 | ✅ **0/500** |
| `0x000001FF`（9 个） | ✅ 0/495 | ✅ **0/500** |
| `0x0000FFFF`（16 个） | ✅ 0/495 | ✅ **0/500** |
| `0xFFFFFFFF`（32 个） | ✅ 0/495 | ✅ **0/500** |

**这一项覆盖了目标要求的全部内容**：时隙调度、BSRAM 状态读写、流水线对齐、
地址回绕、累加 —— 任何一处差一拍都会立刻对不上。

### (b) 包络打开 —— 稳态逐位一致

| 掩码 | 黄金参考 TDM vs 并行 |
|---|---|
| 全部 8 种 | ✅ **不符 0 / 1595**（跳过前 900 个样本） |

稳态段 1595 个样本、0 处不符。

---

## 验收 2：频谱峰值计数

每个时隙给一个互不相同的频率（`inc = 80000 × (slot+1)` → 1490 Hz 间隔），
对 TDM 输出做 FFT：

```
检出谱峰数: 32  (期望 32)
期望峰位: 1490, 2980, 4470, 5960, 7451, 8941 ...
实测峰位: 1526, 3052, 4425, 5951, 7477, 9003 ...
最大偏差 76.3 Hz  (FFT 分辨率 152.6 Hz)
  => 恰好 32 个独立谱峰，位置全部命中
```

> **踩过的坑**：第一版把峰间距设成 46.5 Hz，而 FFT 分辨率是 152.6 Hz ——
> 峰挤在 2.56 个格内，被"间隔≤3 格就合并"的分组规则并成了一个峰，
> 白排查一轮。**峰间距必须远大于 FFT 分辨率。**

---

## 验收 3：综合（NSLOT = 512）

| 项 | TDM（512 振荡器） | 全并行（32 振荡器） |
|---|---|---|
| Logic | **1013 / 20736（5%）** | 13362（65%） |
| Register | 166 / 15750（2%） | 4459（29%） |
| BSRAM | **4 / 46（9%）** | 32（70%） |
| DSP | **2 / 24（9%）** | 24（100%） |
| 综合日志 | 干净（无模块被优化、无 hex 缺失） | — |

**用 5% 的逻辑、9% 的 BSRAM、9% 的 DSP，做出了 16 倍的振荡器数。**

吞吐量对比：
- 全并行：32 × 46875 = **1 500 000** osc·Hz
- TDM：512 × 46875 = **24 000 000** osc·Hz

---

## ★ 突破点：把"清零"这个动作整个去掉

前四轮全部栽在同一件事上，而正确的做法是**不做这件事**。

时隙 s 的回写发生在 `sc = s-3`，各时隙的回写时刻天然错开。
任何"清零窗口"的首尾都必然切在某个时隙中间：

| 释放点 | 受害时隙 | 实测现象 |
|---|---|---|
| `sc = LAT` | 写回时刻 `sc < LAT` 的（s3~s6） | 0~7 延迟 2、8~15 延迟 1 |
| `sc = 0` | 换一批（s3） | 问题没消失 |

**单独测任一组都"通过"**（组内偏移一致会被延迟搜寻吸收）——这是最阴险的地方。

**正确做法**：BSRAM 上电本来就是 0。相位/包络/门的初值天然一致，
流程简化为 **上电（全 0）→ 装载 inc/amp/gate → 直接开跑**。

---

## 遗留问题（如实记录，未解决）

### ★★ 已把范围锁死到"slot 4 及以上"（本轮最大进展）

**逐个时隙单独测**（包络打开，黄金参考从样本 0 起）：

| 时隙 | 结果 |
|---|---|
| **slot 0, 1, 2, 3** | ✅ **不符 0 / 2495** |
| **slot 4 ~ 31** | ❌ 不符 750~764 / 2495 |

**分界正好落在 `slot = LAT = 4`。**

而 slot s 的**首次访问时刻是 `sc = s - 4`**（`slot_addr = sc + LAT`，读发生在 `sc = s - LAT`）：

| 时隙 | 首次访问 `sc` |
|---|---|
| 0~3 | **28, 29, 30, 31**（周期末尾，绕回） |
| 4~31 | **0 ~ 27**（周期开头） |

**所以：首次访问落在 `sc=0..27` 的时隙出错，落在 `sc=28..31` 的正常。**

回写时刻是 `sc = s - 3`，同样以 `s=4` 为界。

### 已排除的可能性（逐条实测，不是推理）

| 假设 | 实测 | 结论 |
|---|---|---|
| 包络存储轨迹不一致 | `TDM 领先一格后：0 / 2499 不同` | **轨迹完全相同** ❌ |
| 幅度对齐错位 | `amp3` 与 `amp_eff_q[0]` 错开一拍后 **0 / 2499 相同** | 幅度轨迹也一致 ❌ |
| 初值 IDLE vs ATK | 759 / 770，几乎一样 | 不是决定因素 ❌ |
| 幅度该"多用一步包络"（串第二级 `osc_env`） | 759 → **776（更差）** | **已回退** |
| 门沿检测提升到周期级 | 更差（连小规模都不过） | **已回退** |

### 症状特征
> **只有起音+衰减段对不上（样本 1~780），延音段 0 处不符。**
> 延音段包络是常数 —— 任何"用错包络步数"的偏斜在常数段都看不出来。

### ★ 已排除：包络（第八轮，逐拍实测）

把**通过者 slot 3** 与**失败者 slot 4** 的每次访问逐拍拉出来：

```
拍   sc  slot   env1  envn
 0    0   4      0     0     ← 触发
31   31   3      0     0     ← 触发
32    0   4      0   117     ← 第一次步进
63   31   3      0   117     ← 第一次步进
64    0   4    117   234     ← 第二次步进
95   31   3    117   234     ← 第二次步进
```

**两者包络轨迹逐拍完全相同** → **包络不是成因**。

同时确认周期 0 的第一拍（复位释放那一拍）的陈旧写回是无害的：
该拍 `sl1` 是复位值 0，写出的 `ph_n` 与 `gc1` 也都是 0（复位值），
所以 `gq_mem[0] <= 0`，不会误把 slot 0 标记成"已触发"。

### ★ 第九轮：试过"冻结"方案，实测更差，已回退

思路：pclr 期间把相位/包络的**原值写回**（不推进）。冻结是**幂等**的，
理论上窗口首尾切在哪里都无所谓 —— 这正是"清零/冲刷"解决不了的问题。

**实测结果：更差，已回退。**
- 第一次跑：`pc` 在 `t_pclr` 期间被按住 → 没有 `sample_en` →
  `pclr_hold` 永远释放不了 → 包络被永久冻结（不符 2449/2461）
- 修掉 `pc` 之后：全部时隙都不符 770 左右，**比不回退还差**

已把 `pclr` 从测试台移除（RTL 里的冻结路径保留但处于休眠）。

### ⚠️ 需要说明的状态变化

第八轮记录过"包络打开时 slot 0~3 通过、4~31 失败"。
经过第九轮的几处改动与回退，**测试台的时序基准发生了偏移**，
当前包络打开时**所有时隙都不符约 770**。

**核心验收不受影响**（回退后已重新验证）：
包络关闭时 8 种时隙组合仍全部 `0 / 500` **逐位一致**。

### ★ 第十轮：残余差异的【量化】

```
最佳延迟 1，不符 778 / 2499
不符拍号范围: 1 ~ 780         （2.5 ms @312.5kHz 仿真采样率）
绝对误差最大: 5171            （= 稳态峰值的 4.66%）
相对误差    : 中位 0.36%、最大 518%（最大值出现在信号过零点附近，
                                    绝对差极小但因分母接近 0 而放大）
```

**结论：残余差异集中在音符起始的 2.5 ms 内，最大偏差不到满幅的 5% —— 听感上不可闻。**

### ★ 第十轮：配对关系已用【无歧义】的方式钉死

用**单时隙掩码**（只有 slot 0 有幅度）—— 这样 TDM 的 `prod4`
每个周期只有一个非零值（实测间隔严格为 32 拍），**时隙归属毫无歧义**。

逐段对比后确认：
> **TDM 的 `amp_eff`（= 幅度 × 包络）在同一段内数值一律偏大 → 包络偏前。**

即：配对关系"差一步"这个方向是**对的**（与理论推导一致），
但单纯补这一步（第九轮试过串联第二级 `osc_env`）并没有让输出对上 ——
说明还同时存在**另一个**尚未定位的因素，两者叠加后互相抵消了一部分。

### 已试尽的启动/配对方案（七种，均未解决）

| 方案 | 结果 |
|---|---|
| 清零窗口对齐周期边界 | 更差 |
| 清零走正常回写通路 | 更差 |
| 零 + LAT 冲刷 | 部分通过、混合必错 |
| 包络初值 ATK | 759→770，无改善 |
| 门沿提升到周期级 | 更差 |
| 幅度串联第二级 `osc_env`（补一步） | 759→776，更差 |
| 冻结（原值写回） | 更差 |

**共同教训**：每一次"看起来更合理"的启动时序改动，实测都没有改善甚至更差。
继续盲试只是在消耗预算。

### 建议的下一步（换思路，不再动启动时序）

把 **`prod4` 与并行 `prod[0]` 在【同一时隙、同一相位索引】下逐拍比对**
（本轮已建立无歧义的观测手段：单时隙掩码 + `prod4` 每周期一个非零值）。
先把"配对是否等价"彻底钉死，再回头谈启动 —— 顺序反了就一直在打转。

> **包络关闭时全部时隙都逐位一致** —— 这说明**相位、时隙调度、BSRAM 状态读写、
> 流水线对齐、地址回绕、累加全部正确**。
> 因此差异**只可能**出在"包络打开才生效"的那条路径上，
> 而包络的**存储轨迹已被逐拍证明与并行完全一致**（第八轮）。
> 剩下的唯一嫌疑是 **`amp_eff` 的配对/启动方式**。

**下一轮建议**：不要再动启动时序（清零/冲刷/冻结都已试过、都更差）。
改为**把并行的包络路径也搬进 TDM 的验证范围** ——
即抓 `prod4` 与并行 `prod[0]` 的**同一时隙、同一相位索引**值逐拍比对，
先把"配对是否等价"这件事彻底钉死，再谈启动。

已确认的事实链：
| 项 | 状态 |
|---|---|
| 包络轨迹（存储值） | ✅ 逐拍一致 |
| 幅度轨迹（`amp3` vs `amp_eff_q`） | ✅ 错开一拍后 0/2499 相同 |
| 包络关闭时全部时隙 | ✅ 逐位一致 |
| 包络打开时 slot 0~3 | ✅ 逐位一致 |
| 包络打开时 slot 4~31 | ❌ 7xx 不符 |

**所以差异出在"包络打开时才生效"的那条路径上**，而包络本身已排除 ——
即 **`amp_eff` 的配对方式**（用包络的哪一步去乘）在**不同时隙上表现不同**。

这与"相位首次回写发生在周期 0 还是周期 1"直接相关
（slot 0~2 在周期 0 的 sc=29/30/31 完成首次相位回写；
slot 3 及以后在周期 1 的 sc=0..28 完成 —— 同样以 **s=3/4 为界**）。

**下一轮**：把 slot 3 与 slot 4 的**相位存储**逐周期打出，确认是否也存在
"首次回写落在周期 0 还是周期 1"的差别；若是，把相位初值也改成显式装载
（`load_en` 同时写相位），彻底消除"首次回写时刻"这个变量。

---

## 复现

```powershell
# 单次验证（约 2 秒）
iverilog -g2005 -o sim_build\tdm\tdm.vvp -s tb_tdm_equiv `
  src\rtl\osc_core.v src\rtl\osc_env.v src\rtl\osc_additive.v src\rtl\mixer.v `
  src\rtl\synth_top.v src\rtl\tdm_engine.v src\sim\tb_tdm_equiv.v
cd sim_build\tdm ; vvp tdm.vvp
python tools\scripts\tdm_compare.py --simdir sim_build\tdm --mask 0xFFFFFFFF --skip 900

# 综合
powershell -NoProfile -ExecutionPolicy Bypass -File tools\scripts\build_gowin.ps1 `
  -Project src\gowin\tdm_synth\tdm_synth.gprj
```

测试台开关：
- `ENV_ON`  —— 0 = 关包络（纯数据通路，从样本 0 起逐位一致）
- `ACTIVE`  —— 活跃时隙掩码（**必须扫全 8 种**，只测单组没有意义）
- `SPECTRUM` —— 1 = 每个时隙一个独立频率，用于数谱峰

---

# ★ 2026-10-01 修复验收：起音段对齐（ZCode）

## 结论
**8 种掩码在【跳过 0 个样本】（含完整起音段与衰减段）下，TDM ≡ 全并行逐位一致，各 0/2495，延迟恒 5 拍。**

| 掩码 | 活跃时隙 | ENV_ON=1（含起音段） | ENV_ON=0（回归） |
|---|---|---|---|
| 0x00000003 | 2 | 0/2495 ✓ | 0/2495 ✓ |
| 0x0000000F | 4 | 0/2495 ✓ | 0/2495 ✓ |
| 0x000000FF | 8 | 0/2495 ✓ | 0/2495 ✓ |
| 0x0000FF00 | 8 | 0/2495 ✓ | 0/2495 ✓ |
| 0x00000101 | 2 | 0/2495 ✓ | 0/2495 ✓ |
| 0x000001FF | 9 | 0/2495 ✓ | 0/2495 ✓ |
| 0x0000FFFF | 16 | 0/2495 ✓ | 0/2495 ✓ |
| 0xFFFFFFFF | 32 | 0/2495 ✓ | 0/2495 ✓ |

## 修了什么（三处 RTL + 一处测试台，根因链见《TDM进展与未解问题.md》§3.1）
1. **装载样本边界对齐**：load 口改写"待生效区"（pv/pp/pg/pi/pa 存储阵列 +
   周期奇偶标签），各时隙在装载后第一个完整样本周期统一消费。
   两个陷阱：奇偶翻转点必须在 sc=NSLOT-1（周期末尾）；判定用读取时刻奇偶（ppr1）。
2. **累加窗口旋转 LAT 拍**：清零 sc=LAT、锁存 sc=LAT-1、sum_raw 改寄存器输出。
   旧窗口 [sc0..sc31] 混两代状态（slot 0~3 读上一周期、slot 4~31 读本周期），
   旧版能过解析真值纯属装载起点恰落在组边界的幸运。
3. **门初值 1→0**：废除"上电幽灵音符"，起音只由显式 load_gate 0→1 沿触发。
4. **测试台激励对称化**：并行侧 inc/amp/gate 改寄存器（STIM_INC_AT=0/Gate_AT=1），
   与 TDM 装载同为"显式音符事件、样本边界生效"。

## 代价与回归
- 综合（tdm_synth, NSLOT=512）：Logic 1979→2089（11%）、BSRAM 4→5 块、DSP 2/24、
  SETUP slack +18.4ns（42.331ns 要求）。报告存档：步骤4_多声部/综合报告_TDM修复后.txt
- 音色示范（tdm_demo render）：四个音色频谱演化数据与修复前逐位相同
  （org 18%→18% 静止；piano 10→5.2%；bell 5.1→3.1%；marimba 3.6→0%）→ 听感零变化
- 其余测试台不触及 tdm_engine，无需回归

## 复现
```powershell
# 包络开（验收对象）：把 tb_tdm_equiv.v 的 ENV_ON 改 1'b1、ACTIVE 改目标掩码
iverilog -g2005 -o sim_build\tdm\tdm.vvp -s tb_tdm_equiv `
  src\rtl\osc_core.v src\rtl\osc_env.v src\rtl\osc_additive.v src\rtl\mixer.v `
  src\rtl\synth_top.v src\rtl\tdm_engine.v src\sim\tb_tdm_equiv.v
cd sim_build\tdm ; vvp tdm.vvp ; cd ../..
python tools\scripts\tdm_compare.py --simdir sim_build\tdm --mask 0xFFFFFFFF
```
