sakuyaShining/FPGA-Music-project-internal/refs/素材库/地板完成索引.md

# 必须项地板 —— 完成索引（2026-09-30）

> 本文件是「地板」阶段的总索引：每个步骤做了什么、解锁了哪条必须项、证据在哪。
> 决赛答辩前用这一页就能把整条链路串起来。

---

## 一、完成情况总览

| 步骤 | 内容 | 解锁 | 证据目录 |
|---|---|---|---|
| 0 | 纪律 1 重构（加法树搬进无状态运算核） | — | `2026-09-30-地板步骤0与2/` |
| 2 | 27 MHz 音频时钟链 + `.sdc` | M4 可测 | 同上 |
| 1 | 每泛音 ADSR 包络 | **M7 + F2** | `步骤1_包络/` |
| 3 | I2S 发送器 + 闭环解码自检 | **M3 + M2** | `步骤3_I2S/` |
| 4 | 4 声部 + 混音 | **M5 + M8** | `步骤4_多声部/` |
| 5 | RTL 内置测试模式 + LFSR | **F1 + R3** | `步骤5_测试模式/` |
| 6 | 寄存器映射 + 实时变调 | **M6** | `步骤6_寄存器变调/` |

**全部在无开发板条件下完成**（纯仿真 + 综合）。

---

## 二、当前设计规格

```
4 声部 × (8 泛音 × 独立相位累加器 + 独立 ADSR)
  → 混音（增益 + 饱和）
  → I2S（16bit / 46875 Hz / BCK 1.5 MHz）
  → 板载 MAX98357A
```

| 指标 | 数值 |
|---|---|
| 振荡器数 | 32（4 声部 × 8 泛音） |
| 输出采样率 | 46875 Hz（27 MHz ÷ 18 ÷ 32，全整数零抖动） |
| **吞吐量 = 振荡器数 × 采样率** | **1 500 000 osc·Hz** |
| Logic | 13362 / 20736（65%） |
| Register | 4459 / 15750（29%） |
| BSRAM | 32 / 46（70%） |
| DSP | 24 / 24（100%） |
| 关键路径 | 24.76 ns / 37.04 ns（slack **+12.3 ns**） |

---

## 三、RTL 模块清单（可直接对着读）

| 文件 | 行数 | 作用 |
|---|---|---|
| `audio_clk_en.v` | 79 | 时钟使能链：÷18 → BCK 1.5 MHz，÷32 → LRCK 46875 Hz |
| `osc_core.v` | 180 | **无状态**运算核：相位 → 查表 → 乘幅度 → 7 级流水加法树 → 饱和 |
| `osc_env.v` | 145 | ADSR 状态机（纯组合，槽式接口，为 TDM 预留） |
| `osc_additive.v` | 222 | 单声部壳层：持有 8 个相位寄存器 + 8 个包络状态 |
| `mixer.v` | 66 | 4 声部混音：加法 + 增益 + 饱和 |
| `synth_top.v` | 113 | 4 声部例化 + 混音（NV 参数化） |
| `test_mode.v` | 69 | 32 泛音各占独立频率格 + LFSR 随机自证 |
| `reg_bank.v` | 187 | 256×8 寄存器堆（所有参数的唯一来源） |
| `uart_rx.v` | 94 | 115200 8N1 接收，两字节一帧（地址 + 数据） |
| `i2s_tx.v` | 52 | I2S 串行化（MSB first，32 BCK/帧） |
| `osc_additive_top.v` | 332 | 综合顶层，把所有东西连起来 |

---

## 四、验证体系（10 套自检，全绿）

| # | 测试 | 强度 |
|---|---|---|
| 1 | 振荡器输出 vs 基线（SHA256） | 回归 |
| 2 | **Python 模型 ≡ RTL 逐位一致** | 最强（跨实现） |
| 3 | 包络 A1~A9（四段时序、阈值归零、永不自停） | 状态机 |
| 4 | 时钟链 S1~S6（BCK/LRCK/相位关系） | 时钟 |
| 5 | **I2S 闭环**（串行流解码回样本，逐位一致） | 最强（协议） |
| 6 | 演奏模式（松手收声、重复抑制、余韵） | 交互 |
| 7 | 多声部（**FFT 4 个独立基频峰** + 混音逐样本相等） | M5 实证 |
| 8 | 测试模式 T1（**恰好 32 个谱峰**） | F1 实证 |
| 9 | 测试模式 T2（两窗 16 格不同） | R3 实证 |
| 10 | 寄存器 P1~P4（读回 / 变调 / **相位连续** / 复位保留） | M6 实证 |

---

## 五、下一步（不属于"地板"）

| 项 | 内容 | 解锁 |
|---|---|---|
| 步骤 7 | 交互层：按键矩阵 / UART 协议 / 音色切换 | M1 + M9 + F3 |
| — | M4 端到端延迟实测 | 需要开发板 |
| — | 报告 + 视频 + 提交 | 11/4 截止 |

### 已知限制（如实记录）
1. **包络参数是编译期常量**，不能运行时改。
   原因是它们要被 32 份包络实例使用，做成寄存器会直接撑爆器件（实测 26226 > 20736）。
   音高与幅度是运行时寄存器 —— 这正是 M6 与「多音色」所需。
2. **UART 引脚尚未指定**（需对照 Tang Nano 20K 原理图确认 BL616 的串口脚）。
   已开内部上拉，悬空时读高电平 = 空闲，不会误触发写。
3. **DSP 已 100%**、BSRAM 70% —— 全并行声部数的天花板约 5 个。
   再往上必须走 TDM。

---

## 六、复现命令

```powershell
# 振荡器回归
iverilog -g2005 -o sim_build\additive\sim.vvp -s tb_osc_additive `
  src\rtl\osc_core.v src\rtl\osc_env.v src\rtl\osc_additive.v src\sim\tb_osc_additive.v
# 包络 / 时钟 / I2S / 多声部 / 测试模式 / 寄存器（分别编译对应文件）
# 综合
powershell -NoProfile -ExecutionPolicy Bypass -File tools\scripts\build_gowin.ps1 `
  -Project src\gowin\osc_additive_synth\osc_additive_synth.gprj
# Python ≡ RTL
python tools\scripts\synth_engine.py verify --simdir sim_build\additive `
  --meta sim_build\additive\stimulus_meta.json
```
