sakuyaShining/FPGA-Music-project-internal/refs/素材库/表情调制验收证据.md

# 表情调制验收证据（滑音 + 颤音）

> 2026-10-02 · **赛题拓展要求 E2「≥3 维演奏表情调控逻辑（力度动态、滑音、颤音）」的引擎侧实现与验收。**
> 新增模块：`src/rtl/pitch_mod.v`；改动：`tdm_engine.v` / `note_map.v` / `tdm_top.v`。

---

## 一、结论

**滑音与颤音已用"音高比例偏移"实现，两档配置（128 / 512 时隙）判据全部通过，且关闭时逐位不影响原有回归。**

### 128 档（NG=8 / 128 时隙，fs=39062.5）—— 用来把轨迹看细

| 判据 | 结果 |
|---|---|
| **G1** 滑音轨迹 vs Python 镜像 | **滞后 0 样本，不符 0 / 39598** ✓ |
| **G1b** 滑音终点 | 实测 252256.0，目标 252256 → 误差 **+0.000 音分** ✓ |
| **G2** 滑音全过程 第16泛音/第1泛音 频率比 | **16.00000 ~ 16.00013**（偏差 0.0008%）✓ |
| **V1** 颤音幅度与周期 | 频偏 **−26.63 ~ +26.00 音分**（设定 26.22），周期 **0.2000 s**（期望 0.2000）✓ |
| **V2** 两个泛音的 cents 偏移差 | 最大 **0.0146 音分** ✓ |
| **C1** 相位增量连续性 | 相邻样本最大相对变化 **0.045%**（无跳变＝无咔哒）✓ |
| **R0** 调制关闭时 TDM ≡ 全并行 | **延迟 5，不符 0 / 2495**（与改动前完全相同）✓ |

### 512 档（**出货配置**：NG=32 / PART=16 / 512 时隙，fs=48828.125）—— 用来证明"真的这一档"

| 判据 | 结果 |
|---|---|
| **E1a** 32 复音同时发声 | **32 / 32 路**声部的基频时隙相位增量**逐个精确等于** `note_inc.hex` 期望值 ✓★ |
| **E1b** FFT 旁证 | 高音区 16 个基频附近均有能量 **16 / 16**（旁证；11.9 Hz 分辨率本来就数不出 32 个峰） |
| **E1 意义** | 「32 复音」从此**不再只有综合证据**（此前一直是覆盖清单里的已知缺口） |
| **G1** 滑音（**16 号组** slot 256） | 轨迹 vs Python 镜像 **不符 0 / 6048**，初值 gq0 = −39528（≈ −1600 音分 = 16 个半音）✓ |
| **G2** 比例 d271/d256 | **16.00000 ~ 16.00021** ✓ |
| **V1** 颤音 | 深度 26.22 音分、周期 **0.02000 s**（LFO 50 Hz）✓ |
| **V2** 两泛音 cents 差 | **0.0180 音分** ✓ |

> ★ **为什么必须单独做 512 档**：两档差的不是性能，是**索引位宽**（组号 = slot[8:4]，5 位）。
> 本次修掉的一个真 bug 正出在这里 —— 组号曾被截成 4 位，第 16~31 组的滑音初值会被写到
> **错误的组**（0~15）。**综合告警发现了它，而 8 组的仿真发现不了**。
> 512 档专门让抢占指针走到 16 号组，测的正是会出错的区间。

---

## 二、实现要点（三句话）

1. **插入点只有一行**（`tdm_engine.v`）：
   ```
   ph_n = ph1 + eff_inc + ((eff_inc × poff) >> 16)
   ```
   `poff` = 每音符的有符号 Q2.16 **音高比**偏移。因为 `inc` 里已含泛音比，
   所以**所有泛音同比移动** —— 这才是"音高在滑"，而不是"音色在扭"。

2. **两个来源、一个乘法**：`poff = gq[note] + vib_q`
   - `gq`：滑音偏移，note_on 时初值 = `(inc_旧 − inc_新)/inc_新`，之后
     `|gq| -= max(1,(|gq|×m)>>k)` **指数衰减到 0**（复用包络那套移位衰减，**零 DSP**）。
   - `vib_q`：全局三角 LFO × 深度（Q16），控制速率。
   - 初值不用除法器：`note_map` 用 **128 项倒数 ROM**（`recip_inc.hex`）乘一次即可。
     实测 MIDI 60→74：gq0 = **−36343** = 2^(−14/12)−1 的 Q16 表示，**精确吻合**。

3. **默认关，且关闭时逐位不变**（保护门）：`GLIDE_EN=0 且 VIB_EN=0` → `poff ≡ 0`
   → `ph_n` 与原来的 `ph1 + eff_inc` 逐位相同。R0 回归因此必须原样通过。

### 为什么 `gq` 必须走装载待生效区（不是设计洁癖，是实测逼出来的）

**这个坑有正反两副面孔，两次都被判据抓出来了。**

**第一副（128 档发现）："旧 inc × 新 gq"**

第一版让 `note_map` 直接写 `gq`。实测在滑音起点出现**1 个样本的相位增量异常**：

```
实测序列（组 0 的 slot 0 相位增量）：
  112367  112367  112367  [50053]  112417  112467 ...
                            ↑ 旧 inc × 新 gq = 112367 + ((112367×−36343)>>16)
```

即"新 gq 已到、新 inc 还没生效"的**混代样本** —— 与本项目栽过的
"累加窗口横跨两代状态"是同一类错误。修法：把 `gq` 并入装载待生效区
（`pgq_mem`，+1 块 BSRAM），在**装载被消费的那一拍**与 inc/amp/gate/epar 一起生效。

**第二副（512 档发现）："新 inc × 旧 gq"**

上面修完后，128 档全绿，但 512 档（16 号组）又出现 1 个异常样本：
实测 **179788 = 纯新 inc、无调制**，而镜像期望 71348（= 新 inc × 旧音高比）。
成因不同：`gq` 表是**寄存器组**，在第 N 拍写入、第 N+1 拍才读得到；
而 inc 走的是**待生效区直通**（`eff_inc = consume ? pi1 : inc1`），第 N 拍就生效。
两者差一拍，于是在消费那一拍配错。

修法（与 inc/amp/gate 完全对称的**一次选择**）：

```verilog
wire signed [QW-1:0] gq_eff = (gw_en === 1'b1) ? gw_val : gq[rd_note];
```

即"正在消费装载的那个时隙，用待生效值"，同时照旧写回寄存器供后续样本使用。
修后 512 档 G1 **0/6048**、G2 **16.00000~16.00021**，128 档仍全绿。

> **教训（值得写进报告）**：一个"边界对齐"的修复必须**覆盖同一组参数的所有成员**。
> 只把 `gq` 放进待生效区、却让它在读口上比 inc 晚一拍，等于把混代问题从
> 一副面孔换成了另一副。**判据必须是"逐样本比对"，而不是"看起来对"。**

---

## 三、过程中修掉的两个真 bug + 一个附带发现

### 1. LFO 三角波写错（两处）
- 错法一：`lfo_t = ph[23] ? (127-u) : (u-128)`，其中 `u = ph[23:16]`。
  `ph[23]=1` 时 `u` 已经是 128..255，再算 `127-u` 得到的还是负半周
  → **三角波根本没越过零点**。
- 错法二：三元表达式两个分支一个有符号一个无符号 → 整体判为无符号，负半周当大正数。
- 症状：`vib_q` 恒正、均值 ≈ +1450（应 ≈ 0），频偏呈 +25..+50 音分。
- 修法：两半都用段内 7 位 `u7 = ph[22:16]`，且乘法两个操作数都显式 `$signed`。

### 2. `sample_en` 自锁（测试台）
`wire sample_en = (pc == 0)` 又拿 `sample_en` 去清零 `pc` → `pc` 永远停在 0、
`sample_en` 永远为高 → 引擎的 `sc` 每拍被清零，**两个引擎都不推进**，数据全 0。
更隐蔽的是：中间还写过 `pc == NSLOT[6:0]` —— **对 128 做位选得 0，不是 127**。
现在测试台自带自检：**`sample_en` 周期必须 = 128 拍**（那两次错误时它分别是 1）。

### 3. ★ 附带发现：`note_inc.hex` 的采样率与顶层不匹配（会毁掉现场演示）

`note_inc` 里的数字直接含采样率：`inc = f × 2^24 / fs`。

| 用途 | 采样率 | MIDI 69（A4）的 inc |
|---|---|---|
| 原表（`note_map_gen.py` 默认） | 39062.5 Hz（5 MHz / 128，仿真时间基准） | 188979 |
| **`tdm_top` 实际**（27 MHz/18/32） | **46875 Hz** | **157482** |

两者差 **1.2 倍 = 3.16 个半音** —— 上板后 **A4 听起来是 528 Hz**，
而综合、时序、I2S 全部正常，**没有任何工具会报这个错**。
已修：`note_map_gen.py` 增加 `--fs`，并分别生成
`sim_build/*`（39062.5，给 tb）与 `src/gowin/tdm_synth/`（**46875，给上板**）两份。

---

## 四、资源与时序增量（GW2AR-LV18QN88C8/I7，NSLOT=512）

| 项 | 加表情调制前 | **加之后（最终）** | 增量 |
|---|---|---|---|
| Logic | 4093 / 20736（20%） | **8874 / 20736（43%）** | +4781 |
| Register | 719（5%） | 1313（9%） | +594 |
| BSRAM | 8 / 46（18%） | **9 / 46（20%）** | +1（`pgq_mem`） |
| DSP | 3.25 / 24（14%） | **6.25 / 24（27%）** | +3 |
| 综合告警 | — | **仅剩既有的 PR1014** | 无新增 |
| SETUP | arrival 31.42 ns，slack +10.912 | arrival **30.111 ns**，slack **+12.220** | 更宽 |
| HOLD | slack +0.324 | slack **+0.201** | 变薄，**要盯** |

> **逻辑 43% 是本次最大的代价**（32 项 `gq` 表的每样本衰减回路 + 32:1 读选择
> + `note_map` 的 25×20 初值乘法 + 128 项倒数 ROM）。
> 若将来紧张，最省的一刀是：把 `gq` 衰减从"每样本 32 路并行"改成
> **分时复用**（样本末尾有 64 拍空闲），预计可回收一千多 LUT。

---

## 五、复现

```powershell
# 生成表（注意 fs：仿真用默认值，上板/综合必须 46875）
python tools\scripts\note_map_gen.py gen --outdir sim_build\pitchmod                 # 39062.5
python tools\scripts\note_map_gen.py gen --outdir src\gowin\tdm_synth --fs 46875     # 46875

# 表情调制验收（约 1 秒音频，2~4 分钟）
iverilog -g2005 -o sim_build\pitchmod\pm.vvp -s tb_pitch_mod `
  src\rtl\osc_env.v src\rtl\tdm_engine.v src\rtl\pitch_mod.v src\rtl\note_map.v src\sim\tb_pitch_mod.v
cd sim_build\pitchmod ; vvp pm.vvp
python tools\scripts\pitch_mod_check.py --simdir sim_build\pitchmod

# R0 回归（调制关闭，必须仍 0/2495）
iverilog -g2005 -o sim_build\_recheck\tdm.vvp -s tb_tdm_equiv `
  src\rtl\osc_core.v src\rtl\osc_env.v src\rtl\osc_additive.v src\rtl\mixer.v `
  src\rtl\synth_top.v src\rtl\tdm_engine.v src\rtl\pitch_mod.v src\sim\tb_tdm_equiv.v
cd sim_build\_recheck ; vvp tdm.vvp
python tools\scripts\tdm_compare.py --simdir sim_build\_recheck --mask 0xFFFFFFFF

# 顶层端到端（I2S 闭环）
python tools\scripts\build_gowin.ps1 -Project src\gowin\tdm_synth\tdm_synth.gprj
```

**运行目录必须有四张表**：`sine256.hex` / `note_inc.hex` / `preset_part.hex` / `recip_inc.hex`
（`$readmemh` 找不到不报错，只是表全 0 → 静音或全 0 数据）。

---

## 六、验证范围与已知缺口（如实记录）

| 项 | 状态 |
|---|---|
| 滑音/颤音功能验证 | ✅ **两档都做了**：128 档（轨迹细节、终点收敛 0.000 音分）+ **512 档（出货配置，32 复音 + 16 号组滑音）** |
| 512 档 = 出货配置 | ✅ NG=32 / PART=16 / NSLOT=512；**32 路基频逐个精确** ⇒ 「32 复音」已有功能证据（不再只是综合证据） |
| 颤音在 `tdm_top` 里默认关 | 有意为之：测试模式的 512 个谱峰若被颤音抹开就数不清（现场自证要求）。等交互层的寄存器通路建好，按模式开关 |
| 参数目前是编译期常量 | 与现有包络参数一致；接入 `reg_bank` 时统一改成端口（见 `docs/02-技术方案/15-拓展项内核化方案与排期.md`） |
| 力度 | 已有（装载时 `amp × vel`），本次未改 |
| 板上实测 | 未做 |

### 下一步
见 `docs/02-技术方案/15-拓展项内核化方案与排期.md`：
两天内按 **E5 延迟测量 → E2+E3 参数寄存器化 → E4 延迟+合唱 → E7 定序器+E6 LED 指引** 推进。
