sakuyaShining/FPGA-Music-project-internal/project/reviews/20261024-frame-source/ASSESSMENT.md

# Frame-format producer to full-token contact ledger

This increment connects the captured immutable-frame interface format to the implemented contact command endpoint. Frames, note maps, raw position, resolved velocity/glide/layers are frozen. Seen/blocked state, consecutive bad-frame quarantine, calibration, sequence gaps/wrap and stale-frame recovery are retained. Release during delayed admission now exercises the actual connected cancellation path. Resource retirement does not cause a held contact to emit another ON; full token and all surviving layer groups are retained for movement.

Final replay09 covers1143 accepted stimulus frames acrossNF4/four-layer, defaultNF26/single-layer and event/reply-backpressured scenarios. Single-layer selection is a declared fixture configuration, not an automatic product reduction. There are five designated faults: mutable-frame position, held retrigger, ignored sequence gap, missing watchdog recovery and missing accepted-transaction timeout. Timely boundary observations and direct held-request assertions prevent eventual ON/OFF counts or a timeout from falsely qualifying those mutants.107 unit tests pass.

An implementation review caught an actual omission before publication: monitoring only source command stalls lost the original bridge's REPLY-wait link diagnostic after acceptance. The final wrapper tracks link_pending through completion consumption; a delayed-admission case checks that diagnostic even while the source itself is idle. The ignore-pending-link mutant reproduces the omission and fails LINK. No unresolved transaction is dropped or rewritten to recover from timeout.

Zero resolved layers is handled as a diagnostic invalid admission, without presenting an invalid zero-layer ON or deadlocking a frame; seen state still needs a real release. This does not approve editor/all-slots-off workflow or in-flight-note update rules. Positions are forwarded without a new pitch scale, and velocity/glide/note map remain caller-resolved.25/26 physical endpoints and84-node analog scanning are not decided or measured by these fixtures.

## Failures and scope

- Replay01 compilation failed because of a generated string newline; original tool/bench/errors remain, no negative qualified.
- Replay02 candidates passed, but observations were too weak to qualify three counterexamples. It remains FAIL. Replay03 added frame-boundary and pre-ready held assertions;04 adds stalls;05 cancellation;06 sequence wrap;07 source-command timeout;08/09 restore and test accepted-transaction timeout.
- Pre-fix timing01 and final changed-RTL timing02 retain the same complete diagnostic constraints. Both reach routing80% then exit0xC0000005. Their distinct Windows events match actualPID64416 and55736, gowin.dll offset0x1c9f10. Final source guards are unchanged; no STA exists.02 is required validation of changed RTL, not a blind rerun of the old17-case investigation.
- The draft pre-link capture is preserved on D; all original experiment directories remain. The final archive binds original failures, source/tool snapshots, commands, expected semantic traces, actual traces and reports. Opaque compiled netlists/binaries remain in original D outputs; no golden or old result is edited.

The allocation server is still a test stub. The actual analog scanner, full-layer finger-pitch consumer/allocator reuse notifications, real manager/renderer/audio path, score source/overflow/automatic OFF and complete top remain pending. A frame-format test is not physical sensor qualification, independent full PCM validation, a10ms latency measurement or final bitstream acceptance. Fixed scan-shell pins/27MHz constraints are not a PCB interface and must never be programmed.

The new four-producer observation matches the preceding reviewed metadata with no added/modified/deleted producer inputs. It renews only actual source observation after reviewing this new functional increment, not hardware/functional acceptance. The hardware951 owner handoff is still failed/unqualified as previously recorded; no CAD, geometry job, native archive qualification or manufacturing release is performed here. D-019 is unchanged, P-020 remains unapproved and other product rules are not silently frozen. PR4 remains an unmerged candidate, actual main the sole published authority.
