sakuyaShining/FPGA-Music-project-internal/fpga/current/upstream-notes/FPGA-REMAINING-20261022.md

# FPGA 侧剩余工作清单 · 2026-10-22

只列 FPGA 侧。不含 PCB、不含采购、不含上位机。
全部结论来自只读核查，未修改任何源文件。

---

## 0. 先纠正一个容易混的事实：当前顶层不发声

`rtl/joint_timing_top.v:270`：

```verilog
// No acoustic output: internal DAC logic remains visible in observation.
assign {dac_din,dac_ws,dac_bck,pa_en}=4'd0;
```

**音频四根线全部硬钉为 0。** 这不是"待接线"，是设计上就不出声——这个顶层的目的只是把内部状态
压成 956 位可观察量、再从 `probe_out` 一位一位吐出来。

同一文件 `:38`：

```verilog
localparam INPUT_BITS=587,OUTPUT_BITS=956,OBS_CHUNKS=30;
```

输入是 587 位串行历史（一根 `scan_in`），输出是 956 位异或压缩（一根 `probe_out`）。
**这是一个纯位串行探针，不是产品。**

所以必须区分三种构建，不能混着说"板子能出声"：

| 构建 | 内容 | 发声 | 真实输入 | 面积 |
|---|---|---|---|---|
| 72/73 号测试工程 | 音乐引擎 + I²S 输出 | **是** | 否（PC UART） | 15258 Logic / 14 IO |
| `joint_timing_top` | 全功能探针 | **否** | 否（1 位 `scan_in`） | 20233 Logic |
| **产品顶层** | — | — | — | **不存在** |

73 号文档自己也写明了：「测试工程的 15258 Logic / 36 BSRAM / 14 IO 与 27MHz 内部 PnR 来自 72 号，
**不代表包含左手扫描、右手触控和可视化的完整整机容量**」。

---

## 1. 关键判断：最小可演奏单板的面积其实是够的

按 87 号的分层账（同一次综合、互不重叠的子层次，不能相加父层）：

| 层 | Logic | 属于"能演奏"必需吗 |
|---|---:|---|
| 音乐全部 | 14710 | **是** |
| 原始扫描 / 校准 / 位置 | 1523 | **是** |
| **小计** | **16233** | |
| 可视化 | 2909 | 否 |
| 双向 FIFO / 环形仲裁 | 501 | 否（录放用） |
| SDRAM 控制 | 153 | 否（录放用） |
| system 合计 | 19796 | |

**16233 / 20736 = 78%。** 按 87 号的折算比 0.5136 估 CLS ≈ 8337/10368，**余约 2000 格**。

而现在塞不下的 20233 里，有 **3563 Logic 是可视化 + 录放 + SDRAM——没有一项是"能演奏"的必需品**。

> **结论：砍掉可视化与录放，做一个"音乐引擎 + 左手电极 + 音频输出"的最小单板，
> 面积与时序大概率自然通过。** 这是 11-04 前唯一现实的路径。
> 限定：8337 是线性估算不是实测，必须真跑一次 PnR 才算数。

---

## 2. 工作项清单

### P1 产品顶层（阻塞其余一切）

| # | 工作 | 现状 | 说明 |
|---|---|---|---|
| **W1** | 新建产品顶层 | **不存在** | 从 `joint_timing_top` 派生，但删掉全部探针 |
| **W2** | 音频真正接出 | `:270` 钉 0 | 删掉那行，`dac_*`/`pa_en` 接到真实引脚 |
| **W3** | 真实引脚映射 | 14 IO，全用于探针 | 左手电极 `pad` **inout ×16**、I²S ×3、UART ×2、复位、LED |
| **W4** | 去掉 587 位串行历史 | `probe_scan_store` 占 368 Logic + 1 BSRAM | 换成真实源：`pad_scan` + UART + 配置寄存器 |
| **W5** | 原子演奏命令入口 | 无，现在靠 587 位分次移位 | 一次写入整组事件，避免半截状态被当成演奏 |

> W4 是真正的工作量所在：那 587 位 `controls` 现在是靠位串行移进来的，产品里必须由
> `pad_scan` 的 `ev_note/ev_on/ev_valid`、右手推子、配置寄存器三方真实驱动。

### P2 时序收敛

| # | 工作 | 现状 |
|---|---|---|
| **W6** | 最小单板重跑完整 PnR，四类 STA | setup −0.700 / hold −0.126（**全功能**构建） |
| **W7** | 若最小单板仍违例 | 已穷尽 `place_option` 0/1/2/3/4、`route_option 1`、`correct_hold_violation`；唯一未试的是 RA8875 渲染器替换 |

> 最小单板不含可视化，所以 W7 大概率用不上。**但必须真跑一次才知道**，不能拿 20233 的结论套 16233。

### P3 右手泛音构造

| # | 工作 | 现状 | 代价 |
|---|---|---|---|
| **W8** | 规则 6 条定案（R1–R6） | 65 号列了 5 条待定 | 纯文档 |
| **W9** | 推子能否衰减 | **不能**，`tdm_engine_rh.v:493` 下限钳 256 | RTL + 重做 HEX + 重算位宽 |
| **W10** | 16 泛音配对方案 | `part_to_control` 是外部 48 位输入 | **零 RTL**，只改映射表 |
| **W11** | **屏触摸 → I²C → 推子位置** | **不存在** | 新写 I²C 主机 + FT5316/GT911 协议 + 坐标→推子映射 |

> W11 是右手通路唯一的硬缺口。注意屏的触摸 IC 可能是 FT5316 不是 GT911，寄存器表不同。

### P4 演奏逻辑

| # | 工作 | 现状 | 代价 |
|---|---|---|---|
| **W12** | 效果器打开 | 已实现且已在网表，开机 `FX_CTRL=0x01` 旁路 | **零面积**，写一位寄存器 |
| **W13** | 包络按泛音独立 | 16 泛音共用一条包络形状 | 要面积（`env_mem` 已是每 slot 一份，缺的是每泛音参数） |
| **W14** | `nyq_kill` 高音闷 | 超 Nyquist 直接清零（数学对，听感闷） | 小改动 |
| **W15** | 同音叠层 | 不能，`found_match` 复用同组 | 中，涉及分配器 |
| **W16** | 三 / 四层 | **未实现**，`layer_dispatch.v:100` 明确拒绝 `>2` | 大，新写分配逻辑 |

### P5 存储 / 录放

| # | 工作 | 现状 |
|---|---|---|
| W17 | TF 控制 + 文件服务 | 未实现 |
| W18 | PCM 与事件配对 | 未实现 |
| W19 | 断电保存（24LC256 EEPROM） | 未实现 |
| W20 | 回放 + 现场最终混音 | 未实现 |

### P6 显示

| # | 工作 | 现状 |
|---|---|---|
| W21 | RA8875 渲染器集成 | 已写好并实测（−628 Logic、路由 FAIL→PASS），**但在 `experiments/` 里，未进产品源** |
| W22 | 短音漏显示 | 已知缺陷 |
| W23 | 双屏 | 面积不够，暂缓 |

### P7 验证签收

| # | 工作 | 现状 |
|---|---|---|
| W24 | 行为等价性回归六套（pitch / engine / phase_wrap / native / layers / sensor） | 部分有 |
| W25 | `audit_build.py` 四类 STA 全绿签收 | 未签 |
| W26 | `HANDOFF.json` + `verify_handoff.py` | 未做 |

---

## 3. 11-04 前的现实切片

| 档 | 工作 | 理由 |
|---|---|---|
| **必做** | W1–W6（产品顶层 + 音频接出 + 真实引脚 + 最小单板时序） | 不做就没有能烧的码流 |
| **必做** | W8–W10（右手规则 + 配对方案） | 纯文档 + 零 RTL，不做白不做 |
| **必做** | W12（效果器） | 零面积，一行寄存器 |
| **可缓** | W11（右手触摸 I²C） | 来不及就先用上位机滑块，文档写明是原型路径 |
| **可缓** | W13–W16（包络/nyq/叠层/四层） | 都在面积与排期之外 |
| **不做** | W17–W20（录放）、W23（双屏） | 面积和排期都不允许 |
| **顺手** | W21（RA8875 集成） | 如果最小单板有余量再考虑 |

---

## 4. 建议的下一步

**W1 的骨架**：从 `joint_timing_top.v` 派生一个 `product_top.v`，分四刀切：

1. 删 `probe_scan_store` 与 956 位 `observable` 压缩链
2. 删 `assign {dac_din,dac_ws,dac_bck,pa_en}=4'd0`，把 `probe_dac_*` 提到端口
3. 把 587 位 `controls` 拆成三路真实源：`pad_scan` 事件、右手推子增益、配置寄存器
4. 端口换成真实引脚：`pad` inout ×16、I²S ×3、UART ×2、复位、LED

第 3 刀最难，也是整个 P1 的核心。

---

## 5. 复现命令

```bash
P=D:/FPGA-Project/codex-deliverables/fpga-agent-handoff-20261022-v1/candidate_source

# 顶层不发声
sed -n '268,271p' $P/rtl/joint_timing_top.v

# 探针规模
sed -n '38,40p' $P/rtl/joint_timing_top.v

# 左手是 FPGA 直扫，电极 inout
sed -n '1,3p;85,88p' $P/engine/src/pad_scan.v

# 分层限制
grep -n "selected_count" $P/engine/src/layer_dispatch.v

# 推子下限
grep -n "bounded boost only\|10'd256 ? 10'd256" $P/engine/src/tdm_engine_rh.v

# 效果器旁路
grep -n "8'h40; b_data <= 8'h01" $P/engine/src/tdm_top_owned.v
```
