sakuyaShining/FPGA-Music-project-internal/fpga/current/upstream-notes/INFO-BASELINE-20261023.md

# 项目信息基线 · 2026-10-23

> **这份文档是什么**：把散落在 20 多个位置的事实汇到一处，作为开工前的唯一事实来源。
> **不是什么**：不是方案，不是建议。方案要你拍板（`PROJECT_MEMORY` 明确「架构决策权归用户」）。
> **读法**：§1–§2 是硬约束，§3–§6 是现状，§7 是冲突清单，§8 是导航，§9 是我此前的错判记录。

---

## §1 死线与硬约束

| 项 | 内容 |
|---|---|
| **提交死线** | **2026-11-04 18:00**（距今 **12 天**） |
| 决赛 | 2026-11-20～22，南京，含 FPGA 基础编程考核 |
| 选题 | 高云赛道二「基于 FPGA 的实时多音色合成电子乐器引擎」 |
| 平台 | GW2AR-LV18QN88C8/I7（Tang Nano 20K），**不换平台、不增 MCU** |
| 时钟 | 27 MHz，不用 PLL；fs = 52734.375 Hz = 27M ÷ 16 ÷ 32 |
| 文档权威顺序 | 官方原文 > `docs/01-竞赛情报/01-选题确认与约束条件.md`（项目宪法）> 设计方案 > `notes/` |

### 1.1 七条红线（AGENT-BOARD §2，任何 agent 不得以"省资源"为由推翻）

1. **双屏保留，不合屏、不缩小推子。** RA8875 出推子/编辑/曲谱，ILI9341 出可视化。（Codex 87 号 §4.6）
2. **不削减**：32 组 × 16 分量、四槽分层、逐音滑条、录放、非易失、实体交互。
3. **不换平台**（GW2AR-LV18QN88C8/I7），**不改 PCB 接口**。
4. **左手是两排逐音滑条 + 独立八度条**，不是 8 个离散触摸键。
5. **右手是 7 英寸电容触摸 + 分区竖直推子**；左右分区、同侧就近、两侧取算术中点、松手保持、分区隔离。
6. **PCM5102A 在 52.734375 kHz 不可用**，用 PCM5122（TI SLAS859C §9.3.5.2 的 ±4% 检测窗口）。
7. **禁止下载码流、禁止制造放行**，除非用户明确批准。

> 注意：红线 1「不合屏」与 87 号动作 A「合并两屏删 ILI9341 渲染器」在字面上冲突。
> 87 号的实测结论是：合屏只回收 −37 CLS，但让布线从 FAIL 变 PASS；随后暴露出 WNS −5.608 ns。**该动作尚未成为产品决定。**

---

## §2 三条并行轴与所有权

| 轴 | 内容 | 所有者 | 独占路径 | 当前状态 |
|---|---|---|---|---|
| **A · 逻辑时序与资源** | `u_tdm` 关键路径、M1/M2、真实产品顶层 | **Codex**（`4d37`） | `experiments/nano20k_feasibility_*/`、`src/rtl/`、`experiments/joint_probe_resources_*/` | 布线 PASS 但 **WNS −5.608 ns** |
| **B · PCB 与硬件制造** | 逐网收敛 → DRC → Gerber → 制造放行 | **WorkBuddy** | `hardware/`（06df）、LCEDA 工程 | **0/0/57（12 网未连通）**，制造未放行 |
| **C · 显示与交互驱动** | RA8875 命令层、双屏仲裁、推子/曲谱界面 | **待认领** | `experiments/ra8875_driver_*/` | 未开工 |

**A 与 B 的唯一交界**：`hardware/review-manufacturing-20261019/expected-pin-nets.json` 与 17 脚面板 GPIO 表。双方共读、只读。

### 2.1 仓库与远程（两个坑）

- 真正 git 仓库：`C:/Users/Sakuya/FPGA-Music-project`（main = `3824391`）
- **只推 `internal`。禁止 `git push origin` / `git push public`** —— 不带 `-internal` 的仓库是对外公开的
- push 不保护 `experiments/`（2103 MB，0 跟踪）、`notes/`（502 MB，2 跟踪）、`hardware/`（304 MB，0 跟踪）
- 17 个 worktree 并存，其中 `4d37`、`4a4b` 是 detached + 未提交

---

## §3 产品规格（已冻结部分）

- **核心**：实体机独立完成自定义乐器（激励 + 频谱/分量 + 时间演化 + 表情映射）+ 四槽同次演奏同音分层
- **左手**：两排逐音滑条，每排一个完整八度；另有**只选档、不测力的八度条**
- **右手**：7 英寸触摸显示区，手指下显示泛音图形，作用于全和弦，松手保持，RESET 平滑恢复
- **音频**：板载 MAX98357A + 4Ω/3W 喇叭；新增 3.5mm **线路输出**（只接有源音箱，非耳机/无源喇叭）
- **录放**：TF + SDRAM 缓冲 + 事件/音频配对；支持"伴奏回放期间现场演奏另一乐器"
- **存储**：24LC256 存乐器参数（32 KiB）
- **控件**：4 预设 + 编辑 + 带按压旋钮

### 3.1 17 脚 GPIO（零余量，88 号 §1）

| 信号 | 脚 | 备注 |
|---|---|---|
| BUS_SCK / BUS_MOSI | 27 / 15 | 共享 SPI（595/165/两屏） |
| SCAN_LATCH / INPUT_LOAD_N / INPUT_DATA | 16 / 17 / 28 | 595 锁存 / 165 载入 / 165 输出 |
| SENSE_0/1/2 | 29/30/31 | 6 路 RC 并行测量 |
| SENSE_3/4/5 | 41/42/48 | 同上 |
| STORE_SDA/SCL | 25/26 | I²C：EEPROM + FT5316 + PCM5122 |
| LCD_VIS_CS_N / LCD_HARM_CS_N / LCD_SHARED_DC | 18 / 19 / 20 | 双屏 |
| TP_INT | 77 | 触摸中断 |

**零余量是最大单点风险**：若模组需 BUSY/背光 PWM/第二路 TP_INT，没有安全余量（6 路 SENSE 减到 4 路会让节点容量从 84 降到 56，不够 83 节点）。

---

## §4 硬件：**三套设计，不要混**

| # | 名称 | 时间 | 规模 | 用途 | 状态 |
|---|---|---|---|---|---|
| ① | 四滑条小样 | 10-15 | **19 种 / 53 件**，2 颗 4067，**2 根 sense** | 传感原理验证 | 原理图接线完成，**PCB 空** |
| ② | 双屏载板 v2 | 10-20～22 | **230 件 / 1054 引脚 / 261 网络 / 14 页**，6 颗 4067，**6 根 sense** | 整机 | 布局完成，布线 **0/0/57** |
| ③ | 88 号采购 BOM | 10-19 | 23 项，**¥652.8** | 采购清单 | 已核价，未下单 |

### 4.1 传感链路（已定，88 号 §0）

```
电极 → 1kΩ 串阻 → 74HC4067（16 地址）→ 公共端 RC → SN74LVC14ADR（施密特）
     → 220Ω → FPGA 计时
```

- **6 路并行 SENSE**，每片 4067 用 14 个电极位 + 2 个参考负载（地址 14/15）
- 6 × 16 = 96，减 12 个参考负载 = **84 可用电极位**
- 25 音位 = 80 节点（余 4）；26 音位 = 83 节点（**余 1**）
- 595 的 8 位全占满：Q0–Q3 地址 / Q4 使能 / Q5 RC_DRIVE / Q6 屏 RESET / Q7 触摸 RESET
- 165 的 8 路全占满：4 预设 + 1 编辑 + 旋钮按压 + A 相 + B 相

### 4.2 预算（已裁定放宽）

- 原目标 ¥500 → **10-19 21:13 用户裁定放宽到 ¥700**，采纳 7 英寸屏
- 88 号合计 **¥652.8**（含 ER-TFTM070 ¥280 起价，**未含 CTP 加价与运费**）
- 加上已购 Nano 20K（¥180–220）与已持有小屏/喇叭，整机物料约 **¥850–900**
- `budget-ceilings.json`（500 元 9 项分配）是**旧版**，已被上述裁定覆盖

### 4.3 B 轴 PCB 收敛轨迹

| 日期 | 未连通 | 网数 | 过孔 |
|---|---:|---:|---:|
| 10-19 v1 | 149 | — | — |
| 10-21 R15 | 58 | 11 | 530 |
| 10-21 R21 | 65 | 15 | — |
| 10-22 BUS_RETURN | 63 | 14 | — |
| 10-22 U8 | 59 | 13 | — |
| 10-22 12:25 INV2 | **57** | **12** | — |
| 10-22 18:04 ADDR3 候选 | 50 | 11 | **未提升** |

**制造未放行**：无 Gerber、无钻孔、无真实 CPL、实物未测。板框 140×100 mm 是临时评估用。

---

## §5 A 轴逻辑/资源现状

### 5.1 资源账（87 号 §2，综合口径）

| 资源 | 用量 | 上限 | 占用 | 余量 |
|---|---:|---:|---:|---:|
| **CLS（约束项）** | ~10168 | 10368 | **98.1%** | **~200** |
| Logic | 19796 | 20736 | 95.5% | 940 |
| 普通寄存器 | 10708 | 15552 | 68.9% | 4844 |
| BSRAM | 31 | 46 | 67.4% | 15 |
| DSP | 13.75 | 24 | 57.3% | 10.25 |

**关键判断**：约束是 **CLS（物理逻辑片）**，不是 Logic/寄存器/BSRAM/DSP。过去几轮优化（71 号锚点共享、78 号参数回读 RAM、85 号音高 RAM）都在减寄存器，方向对但收益有限——寄存器本来就有 31% 余量。

要在 CLS 上腾余量：5% 余量需砍 ~620 Logic；10% 需砍 ~1630；容纳新功能需砍 ~2270。

### 5.2 层次明细（86 号 resource-map.json）

| 层次 | Logic | 占比 |
|---|---:|---:|
| `music` | 14710 | 74.3% |
| └ `u_tdm`（合成引擎） | 3999 | 20.2% |
| └ `u_nm`（声部分配） | 2702 | 13.7% |
| └ `contact_expression.u_finger` | 1942 | 9.8% |
| `visualizer` | 2909 | 14.7% |
| └ `u_renderer` | 2057 | 10.4% |
| `sensor` | 1523 | 7.7% |
| `transport` + `sdram` | 654 | 3.3% |

三个反常点：`u_nm` 1474 寄存器（逐组平铺）；`sensor` 1458 寄存器（比 `u_tdm` 还多）；`u_renderer` 2057 Logic 只为画 320×240。

### 5.3 动作 A 的实测修正（重要）

| | 估算 | **实测** |
|---|---:|---:|
| 删 `u_renderer` + 接 RA8875 命令层 | −1657 Logic / −851 CLS | **−628 Logic / −37 CLS** |

**错因**：按模块名切账 ≠ 按"与输出方式是否相关"切账。`u_renderer` 的 2057 Logic 里 1428 是画面内容计算，与输出方式无关。

**但结论方向成立**：布线从 `DesRoute failed` → **PASS**，第一次拿到有效码流。真正起作用的机制是"凑出 48 个空 CLS 给打包器"。

**同时暴露**：`core_clk` Setup **TNS −250.223 ns / WNS −5.608 ns**（在 `u_tdm`，26 号从来测不到）。

### 5.4 87 号给出的解法（一箭双雕）

```
要时序约束 → 需要探针 → 探针放不下 → 路由失败 → 拿不到时序
```

86 号探针用了 **587 位串行输入历史链** + **956 位分 30 块奇偶观察**，本身不是产品需要的（只占 368 Logic / 1.8%，但占 9 DSP）。

**解法**：用真实 UART 命令接口替代重型探针。产品本来就需要命令协议（配置/演奏/状态回读）。输入变成真实音乐命令帧，输出变成状态寄存器回读，探针开销降到接近 0，同时解决"探针不能演奏"。

---

## §6 传感与力度现状

### 6.1 两条扫描路线互斥

| 顶层 | 传感前端 | 能发声 | 资源 |
|---|---|---|---|
| `tdm_top_owned.v` | `pad_scan #(.NCH(16))`，16 路 inout **直连** | **能**（73 号已验证） | CLS 99.6% |
| `instrument_sensor_probe.v` | `rc_mux_scan #(.LANES(6), .STRIPS(26))` | **不能**（纯探针） | 95.4% Logic |

`rc_mux_scan` 在 `engine/src/` 里**只被探针实例化**，主顶层里没有。

**⇒ 能演的固件跑不了现有小样板（2 根 sense），能跑小样板的固件不发声。** 这是 11-04 前必须裁定的岔路口。

### 6.2 力度：表是对的，功能是关的

- **`vel_wtab.hex` 完全正确**：16 力度 × 16 泛音，基音恒 256，有效泛音数随力度增加（vel0 只 3 条 → vel15 全 16 条），频谱重心 0.96 → 8.32（8.7 倍）
- **Bug 1**：`reg_bank.v` 只有 `mem[8'h5C]=8'h70`，**没有 `0x6E`** ⇒ 复位 0 ⇒ `vel_vscale=0` ⇒ 力度完全不影响音色
- **Bug 2**：力度值本身是固定的 —— `pad_scan` 固定 12/15，`pitch_pos` 固定 `4'd12`（`tdm_top_owned.v:645`），只有 `u_ev_vel = wr_data[3:0]`（上位机）可变
- **MUX 路线**：`rc_strip_positions` 只用 `read_delta` 做位置质心，`grep -i "vel|force|pressure"` **零命中** ⇒ 力度通路一行没写
- **物理信号在**：`row_count` 每帧都有，轻按接触面积小 → delta 小，重按压扁覆盖层 → delta 大
- **时间预算**：每地址 ~31 μs 典型 / ~97 μs 最坏，16 地址整帧 **0.5–1.6 ms**，对 10 ms 指标有 6–20 倍余量
- **唯一硬前提**：重按/轻触 ≥ 1.5 倍（**未上板验证**）

### 6.3 现有 `pad_scan` 素材（若走直连路线）

`cnt[i]`（12 位放电计数）、`raw[i]`（锁存）、`base[i]`（标定窗最小）、`hi = base×1.156`、`lo = base×1.078`；`dbg_raw_sel`/`dbg_base_sel` 已输出。

加力度需：`output reg [3:0] ev_vel` + `input [3:0] vel_shift`，约 **32 LUT + 4 寄存器**。`vel_shift ≈ log2(base/60)`，**必须上板量 base**。

---

## §7 五处文档冲突（需终审，我不裁定）

### 冲突 1：C470754 到底有没有按压开关 —— **翻了三次**

| 时间 | 文档 | 结论 |
|---|---|---|
| 10-15 | 56 号（`selection-20261015/README.md` §1） | **带**按压，1.5 mm 行程 |
| 10-19 | 88 号 §4.1 | **不带**，改 C370986（EC11E183440C） |
| 10-19 晚 | PCB 审查 README（`review-manufacturing-20261019/README.md` §"本轮纠正"第 5 条） | **撤销 88 号**，恢复 C470754。理由：ALPS 原厂页面明确带按压；C370986 附件实际指向 **EC11E15244G1**，不能证明 EC11E183440C 规格 |

**当前倾向**：带按压（恢复 C470754）。但**建议以 ALPS 原厂图纸 + 实物终审**，因为这条已经错了两轮。

### 冲突 2：屏到底有没有

| 文档 | 说法 |
|---|---|
| 43 号（10-14）§1 | "已有/已购：显示屏、Tang Nano20K、喇叭" |
| 49 号 10-17 增量 + `hardware-availability-20261017/CURRENT.md` | **更正为"仅有 Nano 20K + 喇叭，暂无屏幕"** |
| 88 号 | 买 ER-TFTM070-5V4 ¥280 |

**结论**：没屏。10-17 的更正最新。

### 冲突 3：预算 500 还是 700

`budget-ceilings.json` 与 43/49 号都是 500 元；但 **10-19 21:13 用户裁定放宽到 ¥700**，采纳 7 英寸屏。500 元那份文件未更新。

### 冲突 4：MUX 型号

| 来源 | 型号 |
|---|---|
| 四滑条小样（10-15） | `CD74HC4067M96`（TI, SOIC-24, C496123） |
| 88 号 §3.2 | 改 `74HC4067PW,118`（Nexperia, TSSOP-24, C179326），6 片省 ¥6.90，需交厂 SMT |
| PCB v2（10-20） | 需核实实际用的是哪个 |

### 冲突 5：25 还是 26 音位

84 个可用电极位。25 音位 = 80 节点（余 4）；26 音位 = 83 节点（**余 1**）。成本差 ¥2.3。**这是设计决定，不是成本决定**，未裁定。

---

## §8 信息地图（去哪读什么）

### 8.1 必读三份（开工前）

1. `docs/00-协作/AGENT-BOARD.md` —— 轴划分、红线、编号规则、交接格式
2. `docs/02-技术方案/38-代码盘点与实现基线-2026-10-09.md` —— 源码事实与验证边界
3. `docs/02-技术方案/39-最新设计构想与落地差距-2026-10-09.md` —— 目标、状态、未决项

### 8.2 按主题

| 想了解 | 去哪 |
|---|---|
| **设计总纲（含所有增量）** | `49-最终收敛设计总纲-2026-10-15.md`（最上面是最新） |
| **通用乐器框架** | `43-通用乐器框架与功能选型定案工作稿-2026-10-14.md`、`44-音乐引擎对通用乐器与分层的适配审计` |
| **资源约束与收敛路径** | `87-资源约束定位与单板收敛路径-2026-10-19.md`（在 `codex/wb-20261019` 分支） |
| **硬件选型与 BOM** | `88-硬件选型与BOM-2026-10-19.md` + `.csv`（同上分支） |
| **RA8875 渲染器验证** | `89-渲染器RA8875化-字节级与帧级验证-2026-10-19.md` |
| **PCB 当前状态** | `hardware/review-manufacturing-20261019/LATEST.md` + `AUTONOMOUS-CURRENT.md`（最新在最上） |
| **PCB 唯一接续入口** | 同目录 `REGIONAL-WORK-IN-PROGRESS.json` |
| **四滑条小样** | `hardware/pitch-sliders/prototype-schematic-20261015/README.md` |
| **选型审阅包** | `hardware/pitch-sliders/selection-20261015/README.md` |
| **经验教训** | `PROJECT_MEMORY.md` §896–1294（含"架构决策权归用户"原则） |
| **行动指南** | `PROJECT_MEMORY.md` §1294–1579 |
| **M1 工作（10-22）** | `codex-builds/fpga-m1-agent-work/`（13 份 md，含 ARTICULATION-RUNTIME-SPEC、GENERAL-INSTRUMENT-GAPS、VELOCITY-PATH、HARDWARE-ALIGNMENT） |
| **接口规格（冻结）** | `19-UART协议v1.0草案.md` |
| **电极规格** | `20-pad扫描规格书.md`、`25-音高与八度规格.md` |
| **验收判据** | `21-验收判据清单.md` |
| **演奏表情** | `31-演奏表情规格.md`、`32-*`、`33-滑音颤音实现方案v1.md` |

### 8.3 编号规则（已撞过一次）

- **Codex**：继续 `NN-标题-日期.md`，下一个可用号 90（87/88 各存在两份）
- **WorkBuddy**：**不用** `NN-`，用 `WB-NN-标题-日期.md` 或写进 `experiments/<axis>/README.md`
- 新建 `NN-` 前先 `ls docs/02-技术方案/ | grep -E '^[0-9]+-' | sort -n | tail -3`

---

## §9 我此前的错判记录（供你判断我的可信度）

| 我之前的说法 | 实际 | 错因 |
|---|---|---|
| "C470754 无按压，不可用"（10-22 BOM-PROTOTYPE） | 来自 88 号 §4.1，而 88 号**已被 PCB 审查撤销** | 只读了 88 号，没读到撤销它的那份 |
| "我错了，C470754 带按压"（10-23 HARDWARE-ALIGNMENT） | 方向对了，但**不知道中间有 88 号那一轮**，也不知道已撤销 | 只读了 56 号 |
| "16 路直连 GPIO，不需要外部模拟前端" | 现有小样只有 2 根 sense，必须 4067 分时 | 只读 `pad_scan.v`，没读原理图 |
| "5 颗 IC 必须等 PCB ¥288" | 10-15 就已在实物 BOM | 同上 |
| "买 ¥280 屏会破 500 元预算" | 预算 10-19 已裁定放宽到 ¥700 | 只读 `budget-ceilings.json`，没读到裁定 |
| "退路 B：全局力度推子" | 板上没这个物理件，设计明确"八度条不测力" | 没读 43/49 号的左手规格 |
| "现有硬件清单 19 项" | 那是**四滑条小样**；整机是 230 件双屏载板 | 没读 `hardware/` 全目录 |

**共性错因**：只读一个来源就下结论，没有做"同一事实的所有出处"检索。本文 §7 的冲突清单就是为了堵这个洞。

---

## §10 现在能开工的四条路（等你指定）

| # | 轴 | 具体动作 | 阻塞 |
|---|---|---|---|
| **1** | A | 修 `0x6E` 初值（一行）+ 用真实 UART 命令接口替探针 | 需确认 `reg_bank.v` 改动不破 8047→26226 那个综合失败陷阱 |
| **2** | A | 接 `rc_mux_scan` 进主顶层，让能演的固件跑小样板 | CLS 99.6%，面积可能放不下 |
| **3** | B | 继续 PCB 逐网收敛（12 网剩） | 需 LCEDA Pro 在跑 + 原生会话 |
| **4** | C | RA8875 命令层（89 号已验证字节级/帧级） | 无人认领 |

**我建议的顺序**：先 1（一行改动，立刻让 vel12 那行的音色效果出现，且是力度通路的前置），再 4（C 轴空白，且 89 号已有验证基础），2 和 3 属于 11-04 之后。

但**顺序由你定**。要我先做哪条？
