sakuyaShining/FPGA-Music-project-internal/fpga/current/upstream-notes/PROCUREMENT-20261023.md

# 采购单与 codex 版 BOM 比对 · 2026-10-23

回答两件事：**① 现在该买什么、买多少；② 和 codex 已有的采购方案差在哪。**

数据来源（三份，互相有冲突，见 §4）：

| 来源 | 覆盖范围 | 电极路线 |
|---|---|---|
| `docs/02-技术方案/88-硬件选型BOM表-2026-10-19.csv`（分支 `codex/wb-20261019`） | 产品全集，23 项，大部分已核价 | **83 节点 MUX**（6×74HC4067） |
| `BOM-PROTOTYPE-20261022.md`（工作区） | 原型，从 88 号裁剪 | **16 路直连** |
| `hardware/system-candidate-20261015/system-bom-candidate.csv` | 官方候选，价格多为 pending | 未定 |

---

## 1. 现在买（解锁 11-04 B 档：四层 + 编辑宏观版 + 自定义上传）

| # | 件 | 具体型号 | 数量 | 参考价 | 为什么是现在 |
|---|---|---|---:|---:|---|
| 1 | **I²C 16 位 IO 扩展模块** | **PCF8575 模块**（成品带排针，地址 0x20–0x27） | **2** | ~¥7/个 | 16 独立键方案的核心。**买模块不买芯片**：PCF8575 只有 SOIC/SSOP/TSSOP-24，**没有 DIP**，裸片要自己焊转接板 |
| 1b | 备选（若买不到 8575） | **PCF8574 模块 ×2**（地址 0x20 / 0x21） | 2 | ~¥3/个 | 8+8=16 键，功能等价，模块更好买 |
| 2 | **EEPROM（DIP 版）** | **24LC256-I/P**（PDIP-8） | **3** | ~¥5 | **不要买 codex 单子里的 `-I/SN`（SOIC-8）**，那个要转接板。DIP 直接插面包板 |
| 3 | 轻触按键 6×6 | TS-1187A-B-A-B（C318884）或 6×6 通用 | **25** | ~¥0.30 | 16 键 + 备 9。codex 单子只有 6 颗 |
| 4 | I²C 上拉电阻 | 10 kΩ（0603 或插件均可） | **10** | ~¥0.02 | **SDA/SCL 各一颗必需**，其余备用。codex 三份单子里原型版**完全没有** |
| 5 | 去耦电容 | 100 nF（0603 或插件） | **10** | ~¥0.03 | PCF8575 + EEPROM 各一颗，其余备用 |
| 6 | 洞洞板 | 7×9 cm 双面镀锡 | **3** | ~¥4 | 焊模块 + 16 键。比面包板可靠得多 |
| 7 | 杜邦线 | 母对母 20 cm | **1 排（40 根）** | ~¥8 | 板 → 模块 |
| 8 | 排针 | 2.54 单排 + 双排 | 各 1 条 | ~¥5 | |
| | **小计** | | | **≈ ¥68** | |

## 2. 强烈建议（省掉一整天的盲调）

| # | 件 | 型号 | 数量 | 参考价 | 为什么 |
|---|---|---|---:|---:|---|
| 9 | **USB 转 I²C 适配器** | CH341A 模块（带 I²C 排针版） | 1 | ~¥15 | **在写 FPGA 驱动之前，先用 PC 确认三个从机地址都应答**：PCF8575=0x20、24LC256=0x50、触摸 IC=0x5D/0x70。这一步不做，就是"FPGA 不响应"却不知道是 RTL 错还是线错 |
| 10 | **逻辑分析仪** | 24 MHz 8 通道（配 PulseView） | 1 | ~¥30 | I²C 时序出问题时，没有它只能猜。**codex 三份 BOM 全都没有这一项** |
| 11 | SOP8/SOIC24 转 DIP 转接板 | 各 2 片 | 4 | ~¥2 | 万一只能买到贴片封装 |
| 12 | 万用表（若手上没有） | 任意 | 1 | ~¥30 | 量 3.3 V、量通断 |
| | **小计** | | | **≈ ¥83** | |

## 3. 可以等

| 件 | 为什么能等 |
|---|---|
| **7" 触摸屏 ¥280–350** | **SKU 三份文档不一致，必须先定案**（见 §4.3）。买错 = 白花钱 + 白写驱动 |
| EC11 编码器 ¥15.56 | 16 个独立键已经够用；编码器是连续调参的锦上添花 |
| microSD ¥30 | 只有录放功能需要 |
| PCM5122 线路输出 ¥28 | 拍视频用板载 MAX98357A 够 |
| 74HC4067 ×6 / SN74LVC14 ×5 / 595 / 165（¥38.41） | **原型阶段不需要**（7 电极直连）。产品阶段做 84 电极时才需要 |
| 覆盖膜 / 底板 / 铜柱 ¥40 | 用亚克力或洞洞板代 |

---

## 4. 与 codex 版 BOM 的比对

### 4.1 最关键的一条：路线变了，不是"加几颗料"

| | codex 88 号 BOM（产品全集） | 本次方案（原型） |
|---|---|---|
| 电极 | 83 节点，**6×74HC4067 MUX** + 5×施密特 + 595/165 扫描 | **7 路直连 GPIO**（引脚 27/28/29/30/31/41/42） |
| 按键 | **6 颗轻触，直连 GPIO**（备注原文"4预设+1编辑+备"） | **16 颗，走 I²C PCF8575** |
| I²C 总线 | 只有 EEPROM 一个从机 | **三个从机**：PCF8575(0x20) + 24LC256(0x50) + 触摸IC |
| I²C 上拉 | 无 | **必需**（SDA/SCL 各 10 kΩ） |
| 调试工具 | 无 | CH341A + 逻辑分析仪 |

**所以不是"在 88 号 BOM 上加 PCF8575"，而是原方案的按键是 6 颗直连、现在改成 16 颗走 I²C。** 原方案的 6 键连"4 槽 + 1 编辑 + 1 备"都紧，16 键在它那里根本放不下（GPIO 不够）。

### 4.2 codex 版里六处需要修正的地方

| # | 位置 | 原文 | 问题 |
|---|---|---|---|
| 1 | `BOM-PROTOTYPE` §3.1 | "CLS 现在 99.6% 满，第二块屏面积放不下" | **数字错了**。99.6% 是 SDRAM 探针顶层（`build_m1_*`）；产品顶层 `tdm_ship_owned` 是 **8265/10368 = 80%**。结论（单屏）恰好是对的，但理由不对——单屏是因为**用户主动取消了可视化屏**，不是面积 |
| 2 | `BOM-PROTOTYPE` §3.2 | "板载功放 + 喇叭已实测能出声" | **措辞会误导**。板载只有 MAX98357A **功放**，**没有喇叭**。用户 10-23 就是因为"没接喇叭"以为板子坏了。应写"板载功放，需外接 4Ω/3W 喇叭" |
| 3 | `BOM-PROTOTYPE` §1.2 | 轻触按键 **6** 颗 | 16 键方案要 **25** 颗（含备） |
| 4 | `BOM-PROTOTYPE` §2 | 24LC256 列进"必须等 PCB" | **原型就需要**。要做"掉电保存"演示必须有它，¥5 的东西不该等打样 |
| 5 | `BOM-PROTOTYPE` §1 | 无 I²C 上拉、无逻辑分析仪、无 CH341A 之外的调试件 | 接上三个 I²C 从机后，**没有上拉就完全不通信**；没有分析仪就只能猜 |
| 6 | 88 号 BOM | `24LC256-I/SN`（SOIC-8） | 原型用 **`24LC256-I/P`（PDIP-8）**，直接插面包板，省掉转接板 |

### 4.3 屏的三个版本不一致 —— 这个必须先定

| 文档 | 屏 | 显示控制器 | 触摸 IC | 价 |
|---|---|---|---|---:|
| 88 号 BOM / `BOM-PROTOTYPE` | **7" ER-TFTM070-5V4** | RA8875 | FT5316 | ¥280 起 |
| `system-bom-candidate.csv` | **3.5" Waveshare RPi LCD (F) SKU30896** | ST7796S | GT911 | ~¥107 |
| `DESIGN-CURRENT.md`（权威） | "**7 英寸候选**；具体模组 SKU/CTP/电气/线束和机械**尚未全部签收**" | — | — | — |

**权威文档只写了"7 英寸候选"，没有签收型号。** 而两份 BOM 一个写 7" 一个写 3.5"，**触摸 IC 也跟着不同（FT5316 vs GT911）**，这直接决定要写哪个驱动。

**建议**：先不买屏。用 **CH341A（¥15）** 去读手上任何一块能拿到的屏的触摸 IC 地址，确认是 `0x5D`（GT911）还是 `0x70`（FT5316），再决定。**¥15 换掉一个 ¥280 的买错风险。**

---

## 5. 总额

| 组 | 金额 |
|---|---:|
| 现在买（§1） | **¥68** |
| 强烈建议（§2） | **¥83** |
| **合计（不含屏）** | **¥151** |
| codex `BOM-PROTOTYPE` §1.1+§1.2 小计 | ≈ ¥485（**含 ¥280 屏**） |
| codex 88 号 BOM 全集 | ≈ ¥653 |

**即：codex 单子里去掉屏之后约 ¥205，本单 ¥151。差额主要是把 codex 的编码器、microSD、旋钮帽等非当前必需项（¥48.56）换成了 debug 工具（CH341A ¥15 + 逻辑分析仪 ¥30 + 万用表 ¥30）。**

---

## 6. 到货依赖顺序

```
D+0  下单：PCF8575 模块、24LC256-I/P、按键、电阻电容、洞洞板、CH341A、逻辑分析仪
D+2~3 CH341A 到 → 先单独验 EEPROM 和 PCF8575 地址（不碰 FPGA）
D+3~5 PCF8575 到 → 写 I²C 调度器 + 按键驱动（E0 步）
D+3~5 EEPROM 到 → 写读写 + 校验（掉电保存）
```

**CH341A 应该最先到、也最先用。** 它能在 FPGA 代码一行没写的时候就告诉你"地址对不对、线接对没对"，把最容易卡住的一类问题挡在前面。

---

## 7. 一句话总结

> **买**：PCF8575 模块 ×2、**24LC256-I/P（DIP，不要 SOIC）×3**、6×6 按键 ×25、10 kΩ ×10、100 nF ×10、洞洞板 ×3、杜邦线、排针、**CH341A ×1、逻辑分析仪 ×1**。合计约 **¥151**（A 组 ¥68 + B 组 ¥83，均不含屏）。
>
> **先不买**：7 寸屏（SKU 三份文档不一致，先定案）、EC11、microSD、PCM5122、74HC4067 那一批（原型用不上）。
>
> **与 codex 版的差别不是加料，是路线**：codex 是"83 节点 MUX + 6 颗直连按键"，现在是"7 电极直连 + 16 键走 I²C"。
