sakuyaShining/FPGA-Music-project-internal/refs/素材库/时序裕量特征/F1-TDM谱峰验证-2026-10-02.md

# F1 证据重制：TDM 测试模式 512 频率栅格（2026-10-02 · ZCode）

## 结论
1. **引擎的 512 频率栅格本身精确无误**：16384 样本 FFT（分辨率 3.2Hz）下，
   栅格峰与理论值偏差 0.1–1.1 Hz（225.3/280.0/334.7/418.4/502.1/556.8Hz…全部命中）。
2. **当前谱中的"栅格外森林"（2121 峰/65% 谱外能量）= 饱和互调**：
   tm_load_amp=60 × 512 时隙同时满叠 × 顶层增益 ≈ 输出触及 2²³ 满幅 →
   设计内的饱和限幅（防回绕）在病态激励下产生互调产物。
   真实音乐不会 512 音同幅，这不影响演奏；但 F1 证据需要干净的栅格。
3. **待修（一行常量，DeepSeek 的 tdm_top.v）**：`tm_load_amp 8'd60 → 8'd8`，
   使 512 音之和远低于满幅 → 栅格干净后重出本证据。
4. **附带确认 A1 谱证据**：reg_bank 上电默认 0xDC = 延迟/合唱/混响全开+干声关、
   VIB_DEPTH 0x9E06（正常测试值 40 倍）——UART 引导写清零后仍需修默认值
   （修正案 A2 已批准，步④实施）。

## 过程中的三个坑（都值得记）
- **I2S 采样沿**：LRCK 每半帧翻转一次，两个沿都采会把时间轴拉长一倍、
  频率全部减半（症状：栅格 225Hz 测出 112.7Hz、间距 27.7 测出 13.85）——
  必须只采 posedge。
- **采样等待要按"样本周期"计而非"拍"**：BOOTWAIT 6000 拍=11.7 个样本，
  采在包络瞬态里 → AM 边带污染。
- **判据失败先看谱长什么样再定论**：G3 55.79% 两轮一模一样的"没变化"是
  BFM 有效但该寄存器不是主因的线索；Top-25 峰表一出来定位只用了 1 分钟。

## 复现
见 `src/sim/tb_tdm_f1.v` 头注释（tb + f1_check_tdm.py + 4 个 hex 表）。

## ★ 终版结果（tm_load_amp=8 + 判据栅格公式修正后）

| 判据 | 结果 |
|---|---|
| G1 栅格覆盖 | **512/512** 全部为独立局部极大 |
| G2 独立峰计数 | **512**（恰好等于振荡器数） |
| G3 谱外能量 | **1.99%**（<5% 过） |
| G4 峰位偏差 | **max 1.61 Hz**（≪ 半格 13.85） |

★★★ 通过：512 个独立谱峰与 RTL 栅格公式一一对应。
另记：DeepSeek 纠正 ZCode 简报一处算术（100ms = 5273 样本，非 5040）——属实，已认。
