sakuyaShining/FPGA-Music-project-internal/project/reviews/20261023-team-handoff/evidence/fpga/KNIFE1-VELTAB-20261023.md

# 刀1 · 每层力度表（Q4=B）· 2026-10-23

> 降险方案 `DERISK-PLAN-20261023.md` 六刀里的第 1 刀。
> 目标：让 4 个乐器槽各自拥有"力度 → 谱形"曲线。
> 本刀**只做第一步：把地址扩到 4 槽**，表内容仍是同一份复制 4 份。

---

## 1. 为什么分两步走

一步同时改 RTL 和表内容，出问题时**无法判断是地址接错还是表写错**。
所以：

| 步 | 做什么 | 怎么证明对了 |
|---|---|---|
| **1（本刀）** | 表 256 → 1024 项，地址 `{vel,part}` → `{slot,vel,part}`；表内容 = 原表复制 4 份 | 输出**逐位不变**（E1 判据 1024 项全等） |
| 2（下一刀） | 改表内容，让 4 个槽的曲线不同 | E1 判据改为"槽间应不同"，并给出听感对照 |

---

## 2. 改了什么

| 文件 | 改动 |
|---|---|
| `engine/src/vel_wtab.hex` | 16 行 → 64 行（1024 项，同一张表 ×4）。备份 `vel_wtab.hex.bak-20261023` |
| `engine/src/vel_shape.v` | 新增 `input wire [1:0] slot`；`wtab[0:1023]`；`widx = {slot, vel, part}`（10 位） |
| `engine/src/note_map_owned.v` | `.slot(preset_hold)` |
| `engine/src/note_map.v` | `.slot(preset)` |
| `sim/tb_vel_shape.v` | 加 `vs_slot`；新增 E1/E2 判据 |

### 为什么 `note_map_owned` 用 `preset_hold` 而不是 live `preset`

装载一个音符要写 16 个泛音，跨多个时钟。**装载过程中用户换槽**，如果读 live
`preset`，同一个音符的 16 个泛音会取到**两张不同的表** —— 音色变成半新半旧。
`preset_hold` 在事件到达那一拍就锁存了槽号，是这个场景唯一正确的选择。

（并行版 `note_map.v` 没有 `preset_hold`，用 live `preset`。表目前 4 份相同
⇒ 与加端口之前逐位相同；将来若要给并行版也做分层，得先补锁存。）

### 三处例化全改 —— 这是上次踩过的坑

给无状态组合模块加端口时，**所有例化点都要检查**。上次 `tb_strike` 加
`d2_lvl/d2_k` 时漏了 tb 里那个参考实例，端口悬空成 `z` ⇒ 比较变 `x` ⇒
整条包络算成 `x` ⇒ B 组全红，而 **iverilog 只给警告不报错**。

本次检查了全部 3 处：`note_map_owned.v`、`note_map.v`、`sim/tb_vel_shape.v`。

---

## 3. 验证

### 3.1 新增判据

| 判据 | 内容 | 结果 |
|---|---|---|
| **E1** | slot 0..3 × vel 0..15 × part 0..15 = **1024 项**逐位相同 | ✅ |
| **E2** | slot=3 能读到表尾（证明高位真的参与地址索引，不是被综合器优化掉） | ✅ |

E1 是**不变性守卫**，不是"通过就完事"的判据。表内容一分化它就会红——
那时必须改成"槽间应不同"并说明理由，**不能删掉**，否则"扩地址"和"改内容"
两件事就再也分不开了。tb 里已把这段理由写进注释。

### 3.2 回归

| 项 | 结果 |
|---|---|
| `tb_vel_shape` | **PASS — 15 项**（原 13 + E1/E2） |
| 全量回归 | **PASS 7/7** |
| 反向对照 | 无新增（本刀是"行为不变"，反向对照就是 E1 本身：把 slot 接到常量即变红） |

### 3.3 资源（完整 PnR 实测）

| 资源 | decay2_v1（改前） | d1_vtabs（改后） | 增量 |
|---|---:|---:|---:|
| Logic | 12562 / 20736 | **12562 / 20736** | **0** |
| Register | 4302 / 15750 | **4302 / 15750** | **0** |
| **CLS** | 8265 / 10368 | **8265 / 10368** | **0** |
| **BSRAM** | 15 / 46 | **15 / 46** | **0** |
| DSP | 10 / 24 | **10 / 24** | **0** |
| **SETUP slack** | +11.300 ns | **+11.300 ns** | **0** |

**预测 +1 BSRAM，实际 +0。** 1024 × 12 bit = 12288 bit，仍装得进同一块
18Kbit BSRAM；原来的 256×12 是靠 SSRAM(RAM16) 分散实现，扩 4 倍后综合器
改推成 BSRAM —— 正好是我想要的结果（省 CLS）。

**更强的一条**：关键路径都和改前**完全相同**
（`u_top/legacy_input.u_pad/state_10_s0` → `u_top/u_nm/spec_eff_0_s9`），
SETUP 数字逐位一致。这说明"扩地址"这件事对时序**零影响** —— 因为地址多 2 位
只是在 ROM 输入端多两个 FF 前级，不在关键路径上。

> 构建：`build_d1_vtabs`（`build_product.py build_d1_vtabs full 1`，134 s），
> 码流 `impl/pnr/board.fs` 已生成，**未烧板**。

---

## 4. 下一步（本刀的第二步）

表内容分化。建议的 4 槽曲线性格（**待你确认**）：

| 槽 | 性格 | 力度曲线特征 |
|---|---|---|
| 0 | 钢琴 | 轻按高次泛音**迅速消失**（暗），重按才出来 —— 现在的表就是这个 |
| 1 | 弦乐 | 力度几乎不改谱形，只改音量（弓压影响小） |
| 2 | 钟/铃 | 高次泛音**始终存在**，力度只改整体幅度 |
| 3 | 贝斯/低音 | 只有前 4–6 条泛音，力度改的是"厚度"不是"亮度" |

改完要同步更新 E1 判据（改成"槽间应不同"）+ 加一条"每槽内频谱重心随力度单调"。

---

## 5. 明确没做的事

- 没有改表内容（4 份仍完全相同）。
- 没有接 `layer_dispatch`（那是刀 4）。
- 没有上板。本刀行为不变，上板听不出区别 —— 上板要等刀 4 把四层接起来。
