sakuyaShining/FPGA-Music-project-internal/tools/host/README.md

# 上位机（PyQt5 + QSS）使用说明

> 单文件 exe：`tools/host/dist/dsp_gui.exe`（约 37.7 MB，免装 Python）
> 源码运行：`python tools/host/dsp_gui.py`

## 一、文件构成

| 文件 | 作用 |
|---|---|
| `dsp_gui.py` | 主界面（键盘 / 塑谱 / 电极遥测 / 寄存器表 / 日志） |
| `serial_link.py` | 通信层：**真串口**+**模拟设备**，外加量程判定与打包路径解析 |
| `theme.qss` | 主题样式表（"好看"全部集中在这里，改一行即换肤） |
| `build_exe.py` | 一条命令打包成单文件 exe，并**自测产物**|

## 二、三种"设备"状态（顶部徽标一眼可分）

| 徽标 | 含义 | 能做什么 |
|---|---|---|
| 🟢**真实串口**| 真的在跟板子说话 | 全部功能；声音由**FPGA**产生 |
| 🟡**模拟设备**| 进程内模拟：只存寄存器 + 合成遥测数字 | 走流程、看字节/回读/遥测柱判定；**不出声**|
| ⚪**未连接**| — | 只能点，不发帧 |

**模拟设备不是"电脑在算音频"**—— 它**根本不产生声音**。详细的边界见文末"硬底线"。

## 三、怎么用

1.**开发/无板**：端口选「【模拟设备】」→ 连接 → 随便点（键盘、塑谱、扫描 16 路）
2.**连板子**：装好驱动 → 刷新端口 → 选 `COMx` → 连接 → 顶部应显示 🟢**真实串口**
3.**上板第一件事**：点**扫描 16 路**—— 按 §1 的判据逐根看判定颜色：
 - 🟢 量程可用（松手 raw∈[20,2000]，按住 raw ≥1.3×base）
 - 🔴 封顶（RC 太慢）／太快（分辨率不足）⇒ 先调外接 R/C（建议每根**1 MΩ + 22 pF**）
4.**导出帧序列**：把界面上做过的所有帧写成一个文本文件 （**与 `dsp_host.py --emit` 同格式**，
 可被仿真测试台原样重放 —— 界面行为因此可复现、可回归）

## 四、自测（可证伪）

```powershell
python tools/host/dsp_gui.py --selftest      # 源码模式
tools\host\dist\dsp_gui.exe --selftest       # exe 模式（--windowed 无 stdout，结果落盘）
```

产物（`sim_build/gui/`）：
- `gui_preview.png` —— 界面截图（离屏渲染）
- `selftest_report.txt` —— 含**`RESULT gui_selftest=PASS`**与四项**帧一致性**检查

四项检查的含义：界面发出的字节必须与 `dsp_host.py` 的对应命令**逐字节相同**
（地址表与帧构造直接 `import dsp_host`，**不另抄一份**—— 从根上防"上位机与 RTL 各改各的"）。

## 五、重新打包

```powershell
python tools/host/build_exe.py
```

它会：检查/安装依赖 → `PyInstaller --onefile --windowed` →**运行 exe 的 `--selftest` 验证产物**。

要点/坑（都踩过）：
-**`pyserial` 必须在打包前就装好**—— exe 冻结后**不能**再用系统里的 pyserial；
 打包时没装 ⇒ exe 只能"模拟设备"（自测报告里会明写 `打包内含 pyserial = 无 ✗`）
-**`--add-data` 必须用绝对路径**—— PyInstaller 3.6 会按 `--specpath` 目录解析相对路径，
 拼成 `tools\host\tools\host\...` 找不到
- 三份 data 缺一不可：`theme.qss`（主题）、`dsp_host.py`（协议表，缺了 exe 里 import 不到）、
 `regmap_baseline.csv`（模拟设备的真实上电默认值，缺了会全 0）
-**本机 pip 的系统是坏的**（`ProxyError` / `getaddrinfo failed`）：`NO_PROXY=*` 可绕过
 （`build_exe.py` 已自动设置 ；手工装包时这样写：
 `$env:NO_PROXY='*'; python -m pip install pyserial`）
- 打包中间产物 `tools/host/build/`（约 41 MB）可随时删

## 六、硬底线（用户定的，必须守）

>**有板子的时候，电脑仅仅是展示界面，不是计算工具。**

| # | 约束 | 现状 |
|---|---|---|
| 1 | 协议里**没有**音频样本口 | 地址表 44 项全是参数/遥测（`dsp_host.py --check-map` 可对账） |
| 2 | 音频样本通路**永不经过 PC**| PC 只发参数级数据（实测 26 帧=52 B / 2.84 s ≈ 18 B/s） |
| 3 | 若将来加"本地发声引擎"，**连上真串口必须强制停用**| ⏳ 接口预留（`SerialLink` 与本地引擎互斥） |
| 4 | 界面/日志/导出文件三处标注设备类型 | 徽标 + 日志 + 导出表头 |
| 5 | 备好"脱机自证"演示动作（拔数据线，板子自己弹） | ⏳ 按钮待加（片上定序器已就绪） |

另注：项目复核记载**M1 判定为"现场演示可分别操控，PC 端不算"**——
所以上板演示时应用**触摸电极**操控，PC 键盘只作故障兜底 。
