sakuyaShining/FPGA-Music-project-internal/src/constr/README.md

# 引脚约束

Gowin `.cst` 文件。Tang Nano 20K 的音频引脚见 `docs/02-技术方案/02-硬件bringup-TangNano20K音频通路.md`。
