sakuyaShining/FPGA-Music-project-internal/hardware/team-handoff-20261030/procurement/READ-FIRST.md

本目录保留带日期的采购记录。当前采购状态与优先级先读上层README和ORDER-STATUS.csv；旧记录中音箱采购、外形待提供等文字已由2026-10-30决定覆盖。
