sakuyaShining/FPGA-Music-project-internal/hardware/current/module-plan/evidence/control-power-current-plan.md

# 控制、存储与电源保护当前核对

这是采购准备与接线核对，尚不是“购买后直接组装”的完整清单。保留原227功能；本文件展开其中56项控制/存储/接口/供电功能，不替代84路前端与音频文件。

## 本轮核到实际人民币价的直插候选

|器件|准确料号|所需/需买数量|网页单价|本行采购额|
|---|---|---:|---:|---:|
|U10 alternative|[24LC256-I/P / C411624](https://item.szlcsc.com/403161.html)|1/1|11.81元|11.81元|
|U15 alternative|[SN74LVC244AN / C1548565](https://item.szlcsc.com/1639371.html)|1/1|9.33元|9.33元|
|Local decoupling candidate; allocate per original C10 and retained rail locations|[CCT104KC6X7RF5FH5A0 / C2896145](https://item.szlcsc.com/3138694.html)|2/10|0.4142元|4.1420元|
|U10 socket candidate|[DS1009-08AT1NX-0A2 / C72124](https://item.szlcsc.com/73233.html)|1/20|0.2075元|4.1500元|
|U15 socket candidate|[DS1009-20AT1NX-0A2 / C72118](https://item.szlcsc.com/73227.html)|1/12|0.356元|4.272元|

五行合计33.704元，按33.70元展示，已经计入插座/电容起订多买部分。尚缺载体、实际组装、导线/排针、上拉、电源隔离保护与运费；网页“9元运费券”不是本项目实际运费。全部是直插件，不能称预焊模块。插座/电容的固定与焊接方案仍需落实，不把用户只能焊排针/导线自动扩大为贴片或整板焊接。

## 接线保持原功能

EEPROM使用原0x50地址：1/2/3/4/7接GND，8接3V3_IO，5接NanoJ6.10/SDA，6接NanoJ6.11/SCL；100nF靠近8/4。共享总线总上拉与负载核算后再落线，不盲目每块模块再加上拉。64字节页边界、双字节地址、ACK轮询和断电回读要求不变。

屏缓冲器以PDIP20替换同族封装，完整20针见JSON和此前同器件针号证明。20接3V3_PERIPH、10/1/19接GND；2/4/6/8/15分别接BUS_SCK/BUS_MOSI/LCD_RESET_N/HARM_CS_N/TP_RESET_N，18/16/14/12/5分别输出DISP_SCK/DISP_MOSI/DISP_RESET_N/DISP_HARM_CS_N/TP_RESET_MOD_N；11/13接GND、17接3V3_IO，3/7/9是未用输出保持NC。原J10逻辑针号不能当屏厂家40针编号；屏复位物理定义待完整配置冻结。

## 电源保护的实际容量约束

原R67=23.7kΩ±1%，结合TPS2553原厂公式得到限流约1.002A下界、1.184A上界，标称约1.09A。它不是接上5V3A适配器就能提供3A的通道。原PTC、反接管、限流、断电使能/泄放和3.3V隔离功能全部保留，未调整任何阈值。

本产品以3.5mm立体声AUX输出，不把内置或USB供电喇叭加入必购清单。仅核屏、音频板和原控制/传感电路的峰值、启动电流与受保护分支；当前资料还不足以证明原限流下的整机功耗余量。外部演示接收设备如需新增，须明确计入预算，不暗算成已拥有。

## 排除误用与仍需实现

DFR0565虽然有预焊隔离模块和99元标价，但原厂限定隔离侧最大150mA，且要求两侧不可短接。不能当作原共同地整机的TCA9517直接替代，也不能给屏/声卡整路供电。Adafruit5159/TCA4307原厂明确电源直接贯通，不能把3V3_IO与3V3_PERIPH按默认线缆接到同一模块两侧。其供电/上拉/使能断电行为和国内交付尚未核实，不列入接受替代。

原U8/U9的LV595/LV165、U11读回选择、U14 I2C隔离、U16触摸中断整形、U17限流、U18外围3.3V仍没有已核价、预焊且满足原功能的完整采购实现。本轮检索没有找到合格项，不等于市场不存在；不重跑已知无关社区搜索结果。56项原器件的具体网络和保留去向见JSON。

## 下一步

先收口仍需代焊的最小功能集合与实际可交付服务/报价，完成前端整组通道方案后才能获得小板有效制造报价；同时等待屏完整报价，核3.5mm立体声AUX链与受保护电源分支。所有载体、配线、材料、运费和代焊计入700元。到货前做兼容性和采购证据闭合；实物验收仍UNMEASURED。

资料：原厂[限流器数据手册](https://www.ti.com/lit/ds/symlink/tps2553.pdf)第15/18页；当前文件全部本地保存，原生40文件哈希核对未变，没有改RTL、烧录、外发消息或下单。
