sakuyaShining/FPGA-Music-project-internal/PROJECT_MEMORY.md

# 项目持久记忆 Project Memory

> 本文件由 dsh-memoir 插件维护：记录本项目历次会话的工作归纳、经验教训与行动指南，
> 作为未来 AGENTS 接手本项目时的行动指南；它是人类可读的投影，不是 system prompt 的完整注入内容。
> 新会话只注入有界的 Hot Memory，完整历史通过 memoir_read 按需检索。

## 工作记录 Work Log

- [2026-09-18 18:09] [工作记录] 2026 FPGA创新设计赛道 赛事基础信息（时间线/规则/提交物/模板） — 赛事全称：2026 年全国大学生嵌入式芯片与系统设计竞赛 — FPGA 创新设计赛道（大赛含芯片应用/芯片设计/FPGA创新设计三条独立赛道）。
官网：www.fpgachina.cn（报名/作品提交都在这里，个人中心 dashboard.html）；大赛总官网 www.socchina.net。公众号：大学生FPGA创新设计竞赛。QQ群：1043037750、811036991。

【2026 时间线】发布通知 2026-07-06；报名 2026-07-06 ~ 09-22 24:00；作品设计 2026-09 ~ 11-04；作品提交截止 2026-11-04 18:00；决赛 2026-11-20~22，地点南京江北新区。
注意：今天是 2026-09-18，报名只剩 4 天。

【组织方】指导：中国电子学会；主办：中国电子教育学会；承办：东南大学 + 南京江北新区管委会。
协办（=7 家出题企业）：AMD、紫光同创、安路科技、高云半导体、易灵思、复旦微、中科亿海微。支持单位：武汉易思达、芯驿电子、璞致电子。运营：东南大学—无锡集成电路技术研究所等。

【规则要点】每队 ≤3 人、≤2 名指导老师、每人限 1 队；分组别=高职高专组/本科生组/研究生组（有研究生即研究生组）。报名后要资格审查（看完整度/创新性/科学性/工程可行性/设计难度/FPGA平台适用度）。初赛=线上评审作品报告+视频；决赛需现场 FPGA 基础编程能力考核，通过才有评奖资格。
奖项：一等奖 ≤100、二等奖 ≤200、三等奖酌情；另有最佳创意奖、最佳工程奖（各 ≤3）与企业特别奖。
竞赛方式：参赛队自行选择项目，用组委会指定 FPGA 平台开放自主设计，也可在指定平台外自行扩展电路。平台技术细节见各协办企业《选题指南》。
与 FPT'26 Design Competition 有合作赛道（FPT 赛题入选决赛名单已于 2026-09-01 公示，属独立通道）。

【作品提交物】视频(mp4) + 技术文档(pdf) + 代码包(.rar) + 参赛作品使用授权书(pdf)，海报(pdf/ppt) 可选。作品报告模板沿用 2025 版结构：摘要(≤800字)→一 作品概述(功能与特性/应用领域/主要技术特点各≤400字，主要性能指标≤200字建议表格，主要创新点≤200字逐点，设计流程≤200字)→二 系统组成及功能说明(整体框图+硬件系统+软件系统，软硬件模块要给出流程图与关键输入输出)→三 完成情况及性能参数(实物照片为主+量化指标)→四 总结(可扩展之处≤300字，心得体会≤1000字)→五 参考文献≤20篇。注意：作品名称与正文不得出现学校名称。

【2026 各厂商选题指南（7 份）】已下载原文 PDF 到 .site-probe/pdfs/，抽取文本在 .site-probe/txt/。
- [2026-09-18 18:12] [工作记录] 参赛选题确定：高云 选题二 · 实时多音色合成电子乐器引擎 — 已确定参赛选题：**高云半导体 选题二 —— 基于 FPGA 的实时多音色合成电子乐器引擎**（2026 FPGA 创新设计赛道）。
用户于 2026-09-18 通过问答确认。工作区 C:\Users\Sakuya\FPGA-Music-project 即为此项目。

【赛题硬性要求（原文）】
- 交互：自研方案（电容触摸/光电感应/压力检测/无接触手势等），≥2 个独立可控演奏维度，能识别选音、和弦、触发、拨弦等指令。
- 合成：完整音频生成通路必须**全部基于 FPGA HDL 硬件逻辑**，逐样本、逐声部实时运算；算法可用波表采样/加法合成/FM 调频/物理建模任意一种；**经 I2S 输出至 DAC 解码发声**。
- 延迟：控制信号到音频输出**总延迟 ≤10ms**（拓展 ≤5ms 且确定性无抖动）。
- 复音：**基础 ≥4**（四路及以上独立声部并发）；拓展 ≥32 复音，或单音加法合成分量 ≥32 路，或多条并行物理建模单元。
- 必须支持：单音实时变调、ADSR 包络调控、多声部实时混音。
- **红线：严禁直接播放预录 PCM 音频、预置推流及整段录音触发**；现场需用频谱独立谱峰 + RTL 代码佐证纯硬件合成通路，验证无预录播放行为。
- 拓展：≥3 维表情调控（力度/滑音/颤音）；≥2 种音色切换；硬件内实现混响、延迟、合唱等效果器；可视化（LED 演奏指引、李萨如图形、实时频谱、波形）；脱机 LED 曲目指引、蓝牙+手机 App（曲谱下载/键位自定义/录音回传）。

【评分规则（原文核心）】
1. 独立发声单元 = 含独立相位累加器 + 频率调控 + 包络控制的完整振荡器；单波表采样查表不计多谐波数量，仅计单个振荡器；加法合成按运算分量统计、FM 按调制运算器统计、物理建模按并行弦/模态单元统计。
2. **吞吐量指标 = 同时活跃可闻独立振荡器总数 × 实际音频输出采样率**（过采样不叠加加分）。
3. 现场验证：测试模式输出多路不同频率音频，频谱可观测对应数量独立谱峰，并用 RTL 代码佐证。

【适配板卡】Sipeed Tang 系列 Tang Nano 20K / Primer 25K / Mega 60K / Tang Mega 138K。注意：高云免费申请通道的申请表里，选题 2 对应的可申请板卡只有 **Tang Mega 60K**（GW5AT-LV60PG484A），每队只能申请一块，**完赛后需寄回**。申请渠道 https://www.gowinsemi.com.cn/university/boardapply/2026 ，报名参赛时须同时勾选申请。
【EDA】指南未指定 EDA 工具与版本（高云自家为 Gowin EDA / 云源软件 GowinSynthesis）。
【技术支持】FPGA 竞赛官方指导群 QQ 213923272；官网 gowinsemi.com.cn；B 站线上课程 space.bilibili.com/1930822744；Sipeed 文档 wiki.sipeed.com/hardware/zh/tang/ 。
【原文空白】该指南未给出提交物清单、赛程时间、报名截止、板卡寄送时间；选题二未指定 DAC 型号（DAC 为外部器件）；各 Tang 板卡是否板载音频 codec 原文未说明。
- [2026-09-18 18:12] [工作记录] Tang Nano 20K / Mega 60K 板卡规格与音频通路（选题二硬件前提） — 高云选题二可选板卡（Sipeed Tang 系列）实测规格与音频通路结论：

【Tang Nano 20K】GW2AR-LV18QN88C8/I7：LUT4 20736 / FF 15552 / S-SRAM 41472 bits / B-SRAM 828K bits(46 块) / 乘法器 18x18 共 48 个 / PLL 2 / 64Mbit SDR SDRAM / 板载 BL616 作 JTAG+串口 / MS5351 时钟芯片（可出 3 路额外时钟）/ 27MHz 晶振 / HDMI + 40P RGB LCD / 6 个单色 LED（共阳）+ 1 个 WS2812 / 2 个用户按键 / TF 卡槽 / 64Mbit Flash。
**关键：板载 1 个功率放大器 MAX98357A —— 这是 I2S 输入 DAC + D 类功放，直接满足赛题「I2S 输出至 DAC」的硬要求，无需外接 DAC 模块。** 淘宝自购约百元级，适合立刻 bring-up。
资料：github.com/sipeed/TangNano-20K-example ；wiki.sipeed.com/hardware/zh/tang/tang-nano-20k/nano-20k.html

【Tang Mega 60K】GW5AT-LV60PG484AC1/I0（IDE 里选封装 PBG484A + Device Version B）：LUT4 59904 / FF 59904 / S-SRAM 468 Kbits / B-SRAM 2124 Kbits(118 块) / 乘法器 118 / PLL 8 / Transceivers 4 路 270Mbps–8.8Gbps / PCIe2.0 硬核（因 60K 与 138K 的 SERDES 通道 1/3 互换，本底板只能 x1）/ MIPI D-PHY 软核 RX≤1.6Gbps TX≤2.0Gbps / ADC 2 路 / 512MiB DDR3 / 64Mbit Flash。
底板（与 138K 共用 TANG MEGA NEO）：**2 个 Speaker CONN（支持两个 3W 扬声器）+ 1 个 3.5mm 立体声耳机口（无 Mic）+ 1 个 MIC ARRAY 接口（Sipeed 6+1 麦克风阵列）**；另有 HDMI TX/RX（DVI RX/TX 互占）、千兆网、USB3 x2、SD 槽、DVP、RGB888、2×40P 排针、2×PMOD、8 个 LED、1 个 WS2812、3 用户按键+1 reconfig、12V DC 供电、3.7V 锂电充放电管理。
注意坑：需长按 PWR 键 2s 开机；供电不足会导致指示灯全灭再依次亮起（需双 USB 5V 或 12V DC 或锂电）；烧录口是标记 DEBUG-USB2 的 USB-C，需装 FT2232 驱动；固化到 Flash 推荐用 exFlash Erase,Program thru GAO-Bridge 5A（IDE ≥1.9.10.03）；代码下载需商业版 IDE ≥1.9.10.03 或教育版 ≥1.9.11.03；商业版 Lic 可用 Sipeed 在线 Float Lic（ip 106.55.34.119 port 10559 或 gowinlic.sipeed.com）。
资料：github.com/sipeed/TangMega-60K-example ；原理图 dl.sipeed.com/shareURL/TANG/Mega_138K_60K/02_Schematic ；wiki.sipeed.com/hardware/zh/tang/tang-mega-60k/mega-60k.html
**待办：Mega 60K 板载音频 DAC/Codec 的具体型号未在 wiki 正文写明，需从原理图确认后才能写 I2S 引脚约束。**

【获取方式】高云免费申请只能申请一块，选题二对应 Tang Mega 60K，完赛后需寄回；申请渠道 gowinsemi.com.cn/university/boardapply/2026 ，须在报名参赛时同时勾选申请。
- [2026-09-18 18:26] [工作记录] 工作区目录结构（已重整）与用户零基础情况 — 项目工作区结构（2026-09-18 重整，用户明确要求"做好文件分类，不要在工作区根目录堆一堆单独文件"）：

根目录 C:\Users\Sakuya\FPGA-Music-project\
- README.md —— 目录索引 + 各目录用途速查表 + 命名约定
- PROJECT_MEMORY.md —— 记忆库自动生成，勿手改
- docs/01-竞赛情报/ —— 赛事情报、选题总览
- docs/02-技术方案/ —— 开发方案与里程碑、硬件bring-up、乐器形态建议
- docs/03-学习路线/ —— 零基础作战计划、教程笔记
- src/rtl/ —— 我们写的 Verilog（i2s_tx/osc_simple/sine_rom/voice/note_alloc/mixer/debounce/top）
- src/sim/ —— Testbench
- src/constr/ —— .cst 引脚约束
- src/gowin/ —— Gowin 工程与 IP 核
- refs/candidate-guides/ —— 7 家厂商选题指南 PDF + 抽取文本（含 _gaoyun-imgs）
- refs/official-notices/ —— 官网通知、竞赛背景
- refs/report-template/ —— 官方作品报告模板
- refs/vendor-examples/tang20k-audio/ —— Sipeed 官方音频例程源码
- refs/_site-archive/ —— 官网抓取的原始 json/html/js（存档，一般不看）
- tools/scripts/ —— Python/PS 小工具；tools/pylib/ —— 本地 pypdf 依赖
- notes/ —— 临时笔记、调试记录

命名约定：文档 docs/<分类>/<序号>-<标题>.md；RTL src/rtl/<模块名>.v（小写下划线）；约束 src/constr/<顶层名>.cst；笔记 notes/YYYY-MM-DD-<主题>.md。
原 .site-probe/ 目录已删除（内容全部分类归位）。

【重要】作品提交死线 = 2026-11-04 18:00。

【用户情况（关键）】完全零基础，2026-09-16 左右才开始学 FPGA 入门教程，目前仍在摸索。**没有申请板卡的打算**（不必再催板卡申请）。采用"一边学一边做"策略，要求学习过程与项目设计融合，尽快缩短真正上手的时间。→ 因此所有产出都要兼顾"教学性"：代码要带详细注释，文档要说清"为什么"。制定的路线见 docs/03-学习路线/00-零基础47天作战计划.md（三段式：能出声 9/18-10/05 → 能弹曲 10/06-10/19 → 能拿分 10/20-11/04），核心策略是"学习产物即项目零件，不做与项目无关的练习"。
- [2026-09-18 18:40] [工作记录] Gowin EDA 教育版安装完成记录（D盘，C盘零占用） — Gowin EDA 教育版已成功装到 D 盘（2026-09-18 由我执行完成），C 盘零占用。

【安装路径】
- IDE: D:\FPGA-Project\Gowin\Gowin_V1.9.11.03_Education\Gowin_V1.9.11.03_Education_x64\IDE\bin\gw_ide.exe
- Programmer: ...\Programmer\bin\programmer.exe
- USB驱动: ...\Programmer\driver\GowinUSBCableDriverV5_for_win7+.exe（需管理员权限手动点UAC）
- 卸载: ...\Gowin_V1.9.11.03_Education_x64\uninst.exe
- 桌面/开始菜单快捷方式已自动创建，均指向 D 盘。
- 版本：云源软件教育版 V1.9.11.03（64-bit），无需 License、不绑 MAC、无期限。

【关键成功要素】装进 D 盘且不吃 C 盘的做法：①安装包下到 D 盘；②解压到 D 盘；③**把 TEMP/TMP 环境变量指向 D:\FPGA-Project\temp** 再跑安装器（否则安装器往 C 盘临时目录解压）；④该安装器是 **NSIS** 打包，支持 `/S` 静默 + `/D=<路径>` 指定目录（/D 必须放最后且不加引号）。
⚠️ 用 Start-Process -Verb RunAs 提权会因 UAC 被取消而失败（"The operation was canceled by the user"）；**不提权直接跑 /S 安装反而成功**（装到 D 盘不需提权）。

【验证结果】①安装包 MD5 与官网一致；②IDE 能启动（窗口标题 "GOWIN FPGA Designer - [Start Page]"）；③**器件库确认支持 GW2AR-LV18QN88C8/I7**（在 IDE\share\device\device_info.csv，参数 20736 LUT/15552 FF/828Kb BSRAM，与 Tang Nano 20K 完全吻合）；④新建工程选型路径：GW2AR-18C 系列 → 封装 QFN88 → GW2AR-LV18QN88C8/I7。

【高云官网下载接口（无需登录）】GET https://www.gowinsemi.com.cn/softwareopen/{id} 返回 {"status":0,"url":"..."}。id: 9=云源软件教育版Win, 11=编程器教育版Win, 10/12=对应Linux, 51=教育版发布说明PDF。实际直链在 cdn.gowinsemi.com.cn。
教育版Win MD5: 软件 e5ed6222b1038369e52efbe1584f55a9 / 编程器 ae8db0e1cc0353cd7a07ac421e149eea。

【磁盘现状 — 重要隐患】C: 仅剩 2.6 GB / 146.5 GB（1.7%），D: 剩 53.6 GB / 329.1 GB。C盘可回收点：C:\Users\Sakuya\AppData\Local 约 25.6 GB（最大头）、Downloads 705 MB、AppData\Local\Temp 576 MB。**清理涉及删文件，须先列清单让用户确认，不擅自动手。**
D:\FPGA-Project\downloads (508MB) 与 installer (422MB) 可删，共省约 930 MB。

【待办】USB Cable 驱动需管理员权限手动安装（UAC），我没法代点。装完插板子到标 DEBUG-USB2 的 USB-C 口，设备管理器应出现 Gowin USB Cable。
文档：docs/02-技术方案/05-Gowin-EDA安装记录.md
- [2026-09-18 19:19] [工作记录] 建立「选题确认与约束条件」权威文档 + 工作区约束完整性审计 — 2026-09-18 应用户要求做了一次"工作区约束条件完整性审计"，结论与修复如下。

【审计发现的问题（已全部修复）】
1. **选题决策没有落到权威文档**：docs/01-竞赛情报/00-竞赛选题总览-2026.md 结尾仍写着"最终选定的厂商与选题"待确认 —— 与事实矛盾（选题早已锁定）。已改为"事项状态"表并标注 ✅ 高云选题二。
2. **无单一权威的"约束条件"文档**：赛题要求散在方案文档、赛事规则散在情报文档，没有一个地方能一眼看全"必须做什么/不能做什么"。→ 新建 **docs/01-竞赛情报/01-选题确认与约束条件.md** 作为"项目宪法"。
3. **失效路径引用**：文档里还写着 `.site-probe/`（该目录已在重整时删除）。已修正 5 个文件（docs/02-技术方案/02、refs/candidate-guides 下 4 份提取稿）。PROJECT_MEMORY.md 保留历史记录不改。
4. **文件错位**：template_general_2025.txt 误放在 candidate-guides/ → 移入 refs/report-template/ 并改名 `template_general_2025-报告结构.txt`；tools/pylib/pylib 多套一层 → 已拍平；gowin_edu_page.html → 移入 refs/_site-archive/。
5. 根 README 补了"先看这两份"、"文档权威顺序"、"关键节点"，并加了 refs/README.md 说明。

【新建的权威文档：docs/01-竞赛情报/01-选题确认与约束条件.md】
结构（七部分）：
- 第一部分 选题确认（高云 选题二，2026-09-18 锁定）
- 第二部分 赛题硬性约束：M1-M9 必须项（≥2维交互 / 全FPGA HDL通路 / I2S→DAC / 延迟≤10ms / 复音≥4 / 实时变调 / ADSR / 多声部混音 / 自研交互形态）；R1-R3 合规红线（**严禁播放预录PCM、预置推流、整段录音触发**）；2.3 核心评分依据（吞吐量=活跃独立振荡器总数×采样率，过采样不加分）+ 振荡器计数规则（加法按分量、FM按调制器、物理建模按并行单元；单波表查表只计1个）；E1-E8 拓展项；原文未指定项
- 第三部分 赛事规则约束（时间线/团队≤3人≤2老师/组别/资格审查/初赛线上评审报告+视频/决赛含FPGA基础编程考核通过才有评奖资格/奖项/提交物/报告模板结构/不得出现学校名称）
- 第四部分 我方自加设计约束 D1-D7（波表为主+加法特色音色、效果器并联湿声、引擎与形态解耦、采样率46.875kHz、ROM仅作波表、内置测试模式、RTL逐行中文注释）
- 第五部分 **约束自检清单**（合规性/必须项/交付物，提交前必须全打勾）
- 第六部分 约束来源与证据位置（可追溯到具体原文文件与行号）
- 第七部分 变更记录 + 待官方发布后回填项（高云评分细则、2026报告模板、2026提交要求、决赛编程考核范围）

【关键原则（已写入 README）】文档权威顺序：①官方原文（refs/下的PDF与通知）②约束条件文档（项目宪法）③其他方案文档 ④notes/临时笔记。

【已逐条比对原文核验通过】≤10ms、≥4、≥32、≤5ms、≥3维、≥2独立可控维度、严禁预录PCM、I2S、吞吐量公式、≤3人≤2老师、报名截止9/22 24点、提交截止11/4 18点、决赛11/20-22 —— 全部在原文中找到对应句。
- [2026-09-18 19:31] [工作记录] 决策清单第1批交付 + BSRAM双端口/时隙预算关键发现 + 外部信息监控机制 — 【协作模式再确认 — 用户 2026-09-18 明确】用户原话："我不是来参加手工比赛的 你也不是唯一设计者 而是协助我扩大设计空间以及帮我进行操作的 同时 我希望在这个项目中 你能够及时更新相关文档及其外部信息。"
→ 三条职责：①**扩大设计空间**（给足选项与代价，不要只给一个方案）；②**替他执行操作**（装环境、写代码、跑验证、抓资料）；③**及时更新文档与外部信息**（官网动态、官方新发布、文档同步）。
→ 决策粒度：**一次给 3–5 条**（他明确要求），不要一次只给 1 条。

【已交付：决策清单第1批 — docs/02-技术方案/06-架构决策清单-第1批.md】
5 项决策：D1 板卡档位(Nano 20K / Mega 60K / 双目标)｜D2 引擎架构(全并行 / TDM / 混合 / 推迟策略)★最关键｜D3 合成算法配比(波表/加法/FM/物理建模)｜D4 采样率(46.875k / 48k / 更高)｜D5 精度规格(相位位宽/波表深度/插值)。每项含选项表、代价、赛题影响、我的观察（标注"非结论"）、需要用户回答什么。未替用户做决定。

【本批两个关键事实发现（已写入文档）】
1. **Gowin BSRAM 支持真双端口（DP）**：官方 UG285《Gowin存储器(BSRAM & SSRAM)用户指南》原文「个 BSRAM 具有独立的 A、B 两个端口，具有独立的时钟、地址、数据和控 制信号，可以独立的进行读写操作，且两个端口共享一块存储空间」。→ 一块 BSRAM 可被 2 个声部同时独立查表，把"BRAM 端口不够"这个常见瓶颈砍半。Nano 20K 有 46 块/828Kb；1024点×16bit 波表=16Kb≈1 块，32 声部只需 16 块。
   （该 PDF 已抽取到 refs/_site-archive/UG285-Gowin-BSRAM用户指南.txt；本地文档在 D:\FPGA-Project\Gowin\...\IDE\doc\CN\，共 20+ 份官方 UG/SUG 手册可查）
2. **时隙预算极宽松**：46.875kHz 采样率 + 100MHz 内部时钟 = 每采样周期约 2100 个时钟。→ TDM（分时复用）理论上限可达 200+ 声部，振荡器上限不是逻辑资源而是控制复杂度。32 复音只是起点。
3. **指标效率排序（振荡器数/资源）**：物理建模(Karplus-Strong，一根弦=一段延迟线，成本极低) > 波表 ≈ FM > 加法(每分量需独立相位器+查表)。物模可能是性价比最高的指标放大器。

【新增外部信息监控机制】已写入约束文档第八部分：记录核查基线（通知 55 条最新 id=56/2026-09-15；文件 25 个最新 id=25/2026-08-31），并给出判定规则：**出现 id>56 的通知或 id>25 的文件即为有新内容**。核查命令已写入文档（用 tools/scripts/api.ps1）。待发布项：2026报告模板、2026提交要求、高云评分细则、决赛编程考核范围。
- [2026-09-18 19:34] [工作记录] 外部信息周检机制（Windows计划任务，每周五20:00自动执行） — 【外部信息监控机制 — 用户要求"每周查一次"，已做成真正的自动化（2026-09-18）】

用户要求：每周检查一次官网及外部信息。已实现为 Windows 计划任务，不依赖我记得。

【机制组成】
1. 检查脚本 `tools/scripts/weekly_check.ps1`：调用官网接口 `/cms/news/list` 与 `/cms/file/list`，与基线比较，把结果追加到日志，并更新基线。
2. 基线状态 `tools/state/monitor-state.json`：记录 lastNewsId / lastFileId / lastCheck / lastResult。
3. 检查日志 `docs/01-竞赛情报/monitoring-log.md`：人对可读的累积记录（含机制说明、预计执行日期、变更历史、逐次检查记录）。
4. Windows 计划任务 `FPGA竞赛官网周检`：**每周五 20:00** 执行，已启用 StartWhenAvailable（错过会补跑）。
   查看：`schtasks /query /tn "FPGA竞赛官网周检" /fo LIST`
   删除：`schtasks /delete /tn "FPGA竞赛官网周检" /f`
   手动跑：`powershell -NoProfile -ExecutionPolicy Bypass -File tools\scripts\weekly_check.ps1`

【判定规则】通知 id > lastNewsId 或 文件 id > lastFileId 即视为有新内容。基线（2026-09-18）：**lastNewsId=56、lastFileId=25**。→ 出现 id>56 的通知或 id>25 的文件就是有更新。

【预计执行日期】9/18(基线已跑)、9/25、10/2、10/9、10/16、10/23、10/30（提交前最后一次）、11/4 18:00 提交截止。

【⚠️ 重要环境坑（已解决，务必记住）】Windows PowerShell 5.1 读取**无 BOM 的 UTF-8 .ps1 文件会按 GBK 解码**，导致中文字符串乱码 → 语法错误（报 "You must provide a value expression following the '-' operator"）。**解决：含中文的 .ps1 必须保存为 UTF-8 with BOM**（EF BB BF）。write 工具写出的是无 BOM，需再用 [System.IO.File]::WriteAllText + UTF8Encoding($true) 转一次。
另：PowerShell 双引号字符串里的反引号是转义符，写 Markdown 的 `` ` `` 要避免，否则会吞掉后面的引号。

【未纳入自动检查（需人工）】高云官网软件页（EDA 新版本）、Sipeed 板卡资料、**高云官方指导群 QQ 213923272 公告**（我无法访问 QQ 群，需用户自己看；评分细则可能先在群里发）。
- [2026-09-18 19:40] [工作记录] 什么才叫好作品：官方评价维度 + 1442件历届获奖作品分析 + 音频方向历史战绩 — 【重大情报资产：历届获奖作品全量数据（2026-09-18 挖掘）】

发现官网 `/competition/awardInfo/search` 接口（参数 keyword/year/pageNum/pageSize，pageSize 上限 50），返回**全部获奖作品的 作品名称 + 奖项 + 学校 + 团队名 + 队员 + 指导老师**。
已全量拉取 2024+2025 共 **1442 条**，落盘：`refs/_site-archive/history-lists/获奖作品-2024-2025.csv`。
调用方式：`. tools/scripts/api.ps1` 然后 `Invoke-Api '/competition/awardInfo/search' @{keyword='';year=2025;pageNum=1;pageSize=50}`。

【奖项规模】2024: 一等100/二等194/三等395=689；2025: 一等100/二等193/三等460=753。**一等奖固定 100 个**（两年都一样）。另有 5 个企业杯（AMD杯/紫光同创杯/安路科技杯/**高云杯**/易灵思创新杯）+ 最佳创意奖≤3 + 最佳工程奖≤3（企业杯与专项奖不在该接口里，只在 PDF 名单）。
存疑：2025 获奖 753 支 vs 晋级决赛现场 305 支，数字对不上，官方未解释。

【官方评价维度（原文）】资格审查6项：提交完整度/创新性/科学性/工程可行性/设计难度/**FPGA平台适用度**；决赛评审3项：作品完整度/专业性/创新性；决赛另有 **FPGA基础编程设计能力考核，通过才有评奖资格**。
高云给选题三的权重表（可推测其评分习惯）：FPGA实时感知与控制40% / 系统稳定性25% / 自主导航能力20% / 创新设计10% / AI扩展功能5%。→ 高云最看重"FPGA真的在干活"+"稳不稳"，创新只占10%。

【高分画像（1442件定量分析）】
- 主题一等率：机器人34% > 密码29% > 医疗内窥25% > AI/加速21% > **音频17%** > 视觉14% > 信号仪器13% > 通信12% > 工业11% > **游戏娱乐10%(最低)**
- 2025 一等奖命名：40% 含"系统"，28% 含"智能/AI"，27% 含"基于FPGA"，26% 含具体应用场景词；名称平均11.4字
- **命题式赛题占比巨大**：同一作品名反复出现（如2024「高精度音频处理和效果生成系统」横跨5校多奖项；2025「智能信号分析与测试系统」10+次；「L1算子优化/HLS加速器」7+次=AMD命题基础赛道）→ 走企业命题是主流且能出一等奖，我们选高云选题二符合主流路径。

【与我们最相关：音频方向历史战绩】84 件音频类获奖，**14 件一等奖（17%，高于平均）**。一等奖含：「基于高云FPGA的音频处理系统」(2024,东莞理工)、「基于GW5A的高精音频处理装置」(2024,集美大学诚毅学院)、「高精度音频处理和效果生成系统」(2024,电子科大)、「高性能实时音频与音效处理系统」(2024,电子科大)、「真实沉浸式声音空间RISS」(2024,电子科大)、「FPGA私人可配置录音棚」(2025,电子科大)、「基于EG4S的多功能智能音箱」(2025,陕科大) 等。
→ **音频方向能拿一等奖，且有高云平台先例**。但**历届没有明确的"电子乐器/合成器"命名作品**，最接近的是「音频处理多功能演奏系统」(2025三等,重庆理工)、「灵芯：智能吉他效果器」(2025三等,大连理工)。→ 我们是新方向，无先例可抄，但邻近题材已被证明可行；需把"这是什么、有什么用"讲得比成熟题材更清楚。

【结论：什么才叫好作品】= 一件"完整、可演示、有真实应用场景、且 FPGA 在其中承担**不可替代**核心作用"的系统级作品。
六判据（按重要性）：①完整度(端到端跑通) ②FPGA不可替代性 ③应用场景清晰 ④可现场演示+可量化指标 ⑤专业性(规范/可复现) ⑥创新性。
陷阱：单模块验证无闭环 / FPGA只当接口板 / 无法现场演示 / 拿不出量化指标 / 只好玩没价值 / 基础编程考核过不了。

【对项目的行动含义】①第3层(现场演示与可讲解性)要在架构阶段就纳入设计；②第2层赛题评分指向明确=振荡器数×采样率；③第1层报告/视频是初赛生死线，从第一天起留存素材；④要给作品包装：应用场景故事+产品化名字(11字左右含场景词)+"FPGA为何不可替代"的核心论述+量化指标表+现场演示脚本。

文档：docs/01-竞赛情报/02-什么才叫好作品-评审逻辑与高分画像.md
- [2026-09-18 19:44] [工作记录] 2026 赛题与往年对比：厂商5→7家、赛题几乎全换、音频题从安路转到高云并升级为电子乐器 — 【2026 赛题与往年对比 — 关键结论（2026-09-18）】

**结论：今年课题与往年差异极大，几乎全换。**

【厂商阵容】2025 年 5 家（安路/高云/易灵思/紫光同创/AMD）→ 2026 年 **7 家**（新增 **复旦微、中科亿海微**）。2024 年官网未上传选题指南（只有通知，且是扫描件，通知里只写"详见竞赛协办企业选题指南"），2024 题目只能从获奖作品反推。
2025 选题指南以"通知"形式发布（通知 id=40~44，2025-09-01 同日）；2026 以"文件"形式发布（id=19~25）。已下载 2025 全部 5 份到 `refs/past-years/`。

【逐家赛题对比（2025 → 2026，几乎全换）】
- **高云**：全景会议相机/无线通信系统/多功能协议调试器/开放型 → **实时姿态控制/实时多音色合成电子乐器引擎/具身智能机器人/开放型**。3/4 换新，仅"开放型"延续。板卡也换：2025 用 TangMega60K/J270/ACG525 → 2026 用 J280/Tang系列/小梅哥ACG系列。
- **安路**：语音信号处理/以太网数据传输/实时图像信号传输/飞龙SOC人机交互/自主命题 → HDMI多媒体播放/实时数字图像处理/图像压缩加速/飞龙SOC智能工业/自主命题。4/5 换新。**注意：2025 音频题在安路（语音信号处理），2026 转到了高云且升级为电子乐器合成。**
- **紫光同创**：仪器仪表(智能信号分析测试)/智能制造(缺陷检测定位)/视频图像(软硬协同机器视觉)/自主命题 → RISC-V CPU设计/任意角度畸变矫正/ADAS/开放选题SOPC。全部换新。
- **易灵思**：2mm内窥图像/畸变校正/众脸识别加速/T20 ADC UI/自主命题 → AI实时绘画风格化/2D图形渲染加速/多模态AI终端/实时图像边缘检测/自由选题。全部换新。
- **AMD**：命题式基础赛道/FPT国际赛道/自主选题初级/高级 → **RTL/HLS本地智能体设计/具身智能**/自主选题初级/高级。结构大改，取消命题式基础赛道与国际赛道FPT。

【主题风向】2024：仪器仪表/ISP/采集卡/音频处理。2025：以太网传输/协议调试器/信号分析/AI算子。2026：**具身智能、AI智能体、电子乐器、多模态、ADAS**。明显从"接口与信号处理"转向"AI与具身智能"。"自主命题/开放型"是唯一每年都保留的选项。

【重要发现：2024 高云疑似就有音频题】2024 获奖名单中「基于ACG525的音频处理系统」出现 3 次（东南/重邮/东北）+「基于ACG525的音频处理」1 次（湖北大学）。**ACG525 是高云板卡** → 强烈提示 2024 高云有「基于ACG525的音频处理」命题。其战绩含 **一等奖**「基于高云FPGA的音频处理系统」(东莞理工)、**一等奖**「基于GW5A的高精音频处理装置」(集美大学诚毅学院)。→ **高云+音频历史上出过一等奖。**

【音频方向三年曲线】2024：48 件获奖（占 7%），其中一等奖 7 件（占一等奖 7%）→ 2025：24 件（3%），一等奖 5 件（5%）→ 降温一半，且转向语音识别/降噪/声源定位。**2026 高云重新给出专门的电子乐器合成题**（从"处理"变"生成"）。

【对我们选题的判断】历届获奖名单中**没有任何"电子乐器/合成器/音色引擎"命名的作品**，最接近的是「音频处理多功能演奏系统」(2025三等,重庆理工)、「灵芯：智能吉他效果器」(2025三等,大连理工)、「FPGA私人可配置录音棚」(2025一等,电子科大)。→ **我们是全新题目**：好处是参考少竞争可能小、创新性天然占优；风险是没现成做法可抄、更依赖自己的演示说服力。

【重要推论】**因为题目每年几乎全换，往届获奖作品只能参考"什么算好作品"的抽象规律，不能抄具体做法**（2025 高云的无线通信方案对我们毫无参考价值）。

文档：docs/01-竞赛情报/03-今年课题与往年对比.md；2025 指南原文存 refs/past-years/
- [2026-09-18 19:48] [工作记录] 架构决策框架 v2：审计发现 v1 漏掉两层评审，重写为三道闸 + 8 项决策 — 【决策框架 v2 审计重写（2026-09-18）】

用户要求："今年的选题更新很大 我们没现成做法可抄 但是别人也别想用祖传项目参赛 接下来重新审计一下那个决策框架"。→ 审计后确认 v1 有系统性缺陷，已重写为 v2。

【v1 的缺陷（审计发现）】
v1 决策框架（原 06-架构决策清单-第1批）**只优化了三层评审中的第2层（厂商评分）**，措辞统计为证：振荡器 18 次 / 指标 13 次 / 赛题 10 次，而 **完整性、创新、场景、量化、可复现 全部 0 次**，演示/答辩仅 2 次。
后果：按 v1 选出的架构可能"指标高但讲不清"（决赛失分）、"技术强但写不出故事"（初赛被刷）、"做成孤立引擎不像产品"（违反完整度判据）。
另一缺陷：v1 的 D2 只给实现方式，**没把"产品定位"当架构级决策**——而 26% 一等奖名称含应用场景词，定位反向决定技术选型。

【v2 的核心升级】
1. **三道闸评估**：每个决策必须过 ①闸1 合规与指标（第2层）②闸2 完整与演示（第3层）③闸3 报告与可复现（第1层）。依据：高云给另一题的权重是「FPGA实际作用40%+稳定性25%+创新10%」→ **"能演示、够稳定"权重高于"指标漂亮"**，与 v1 隐含假设相反。
2. **8 项决策**（v1 是 5 项）：新增 **D0 产品定位与场景故事（★最先定，阻塞其余全部）**、**D6 效果器与可视化**、**D7 测量与自证方案**。
3. **依赖图**：D0 → D1 → D2 → (D3,D5) → D4 → D6 → D7；D8 板卡横切。阻塞关系：D0 不定则后面空转；D2 不定则 D3/D5 是纸上谈兵；**D7 不是最后才测，测量方案要一开始设计**。
4. **D2 补上两个 v1 漏掉的代价**：TDM 的**答辩成本**（要论证"共享硬件算不算独立振荡器"，赛题定义含独立相位累加器/频率调控/包络控制）+ **调试成本**（时隙数据流比全并行抽象得多，对零基础是实际负担）。并提出"**双模式对照**"思路：平时全并行保演示，测试模式启用更多振荡器保指标。
5. **D6 关键洞察**：**可视化不只是好看，它是合规自证的武器**——赛题要求现场用频谱独立谱峰自证无预录，把实时频谱做出来等于自带证据。→ 建议**可视化优先于效果器**。
6. **D8 补闸2 风险**：Nano 20K 板载 MAX98357A 已验证通路（风险零）；Mega 60K 音频 DAC 型号尚未从原理图确认（未知数）。

【v2 提供的选项概要】
D0 定位：A 音乐教育 / B 无障碍演奏 / C 舞台演出合成器 / D 声学实验平台。我的观察（非结论）：A+B 可叠加（键盘保演示稳定性 + 手势拿赛题点名的"无接触"与社会价值故事）；D 不建议（难演示）。
D1 形态：A 键盘 / B 触摸滑条 / C 无接触手势 / D 吹奏。推荐组合 A 为主 + C 为辅 = **"演示冗余"**（即使手势失效，键盘仍能完成演示，这是决赛策略）。注意 Nano 20K 无 ADC，模拟力度用 RC 充放电时间测量法。
D3 顺序建议：波表(必须) → 物模(便宜且好听) → 加法(贵但指标高) → FM(可选)。物模(Karplus-Strong)是性价比之王。
D4 建议 A 46.875kHz（零复杂度+时序余量最大+对指标中性）。
D7 需问用户：**有没有示波器？**（决定延迟能否实测）；测试模式是否作为早期必做项。

【v1 处置】已归档到 docs/02-技术方案/archive/06-架构决策清单-第1批-v1.md（选项数据仍可参考）。
【v2 位置】docs/02-技术方案/06-架构决策框架-v2.md
【README 已更新】速查表新增"什么叫好作品""今年与往年对比""架构决策框架v2""历届获奖作品CSV"入口。
- [2026-09-18 19:53] [工作记录] 实验条件确认：有示波器，延迟可实测（影响 D7 与报告专业性） — 【实验条件确认（2026-09-18）】用户有**示波器**可用——原话："当然 我有 学校的实验室最不缺的就是这个东西"。
→ 这是重要条件，直接影响 D7（测量与自证方案）与报告的专业性：
- **"延迟 ≤10ms" 可以实测**（而非理论推算）：GPIO 输出触发脉冲 → 示波器 CH1；音频输出 → CH2；测时间差 = 端到端延迟。
- 可做**抖动分位数**（P50/P95/P99），高分作品的共性就是有分位数数据而非只有平均值。
- 可用示波器 FFT 做**频谱数峰**（赛题现场自证刚需：验证无预录 PCM）+ THD 测量。
- 若采纳 TDM 架构，还能验证时隙是否引入额外抖动。
待确认：示波器带宽/通道数（≥100MHz、2 通道够用）、是否有音频分析仪/频谱仪。
已更新文档：docs/02-技术方案/06-架构决策框架-v2.md 的 D7 节（含具体测量方案图）+ docs/01-竞赛情报/01-选题确认与约束条件.md 新增 3.7 节「可用实验条件」。
建议：测试模式在 P1 阶段就搭骨架（哪怕只有 2 个振荡器），后续每加一种算法就往里塞——它同时是赛题现场验证手段和多路互质频率演示工具。
- [2026-09-18 20:09] [工作记录] 四个关键维度：强制/自由/过拟合/FPGA与Agent发挥空间（含D0定位的一句话检验标准） — 【四个关键维度分析（2026-09-18）— 用户要求先铺信息再定方向】
用户原话："我想你先回答我'题目强制的东西 / 可自由设计的东西 / 最容易过拟合的地方 / 最值得发挥 FPGA 与 Agent 的地方' 至于我的直觉与野心暂时太大了 所以我想先了解更多信息和技术让这些直觉落地"
文档：docs/01-竞赛情报/04-四个关键维度-强制自由过拟合与发挥空间.md

【维度一 强制】
- 红线级3条：R1 严禁播放预录PCM/预置推流/整段录音触发；R2 所有音频逐音逐样本实时生成；R3 须能用 RTL 自证无预录。
- 硬指标级9条：M1 独立可控维度≥2；M2 完整音频通路全部基于FPGA HDL；M3 必须经 I2S→DAC；M4 控制信号到音频输出总延迟≤10ms；M5 基础复音≥4；M6 单音实时变调；M7 ADSR包络；M8 多声部实时混音；M9 交互形态必须自研。
- 形式级4条：F1 测试模式（多路不同频率、频谱可见独立谱峰）；F2 振荡器必须含独立相位累加器+频率调控+包络控制；F3 能识别选音/和弦/触发/拨弦；F4 适配 Sipeed Tang 系列。
- **关键**：题目强制的是"达到什么效果"，不是"用什么手段"——原文用"任意自研交互方案""任意合规算法"，交互/算法/形态/音色/UI 全部自由。

【维度二 自由】完全自由：产品定位与应用场景(⭐⭐⭐⭐⭐)、作品形态外观、交互传感器方案、合成算法组合(直接决定吞吐量指标⭐⭐⭐⭐⭐)、音色设计、演示脚本、可视化形式、额外功能。
半自由：板卡(限Tang四款)、采样率(未规定)、复音数(≥4底线，可到200+)、延迟(≤10ms上限)、精度、效果器。
**被忽略的自由度**："乐器"这个词本身——赛题没规定必须长成传统乐器样子，可能是键盘/触摸条/空气琴/打击垫/吹奏式/全新交互。

【维度三 过拟合】**反直觉实测数据：命题式作品一等率 12.8%，全部作品 13.9%，具体场景命名 13.4% —— 几乎持平，"照着命题做、名字取成赛题名"不带来优势。**（2024 大批「FPGA基础能力」一等奖是因为那属命题式基础赛道考核科目，非创意作品）
五个陷阱：①**唯指标论（最危险）**——为堆振荡器数牺牲稳定性/可演示性/可闻性；注意规则强调"同时活跃**可闻**"；②只做赛题列的算法/功能不做产品（功能堆砌≠好乐器）；③交互做成"能过测试"而非"能演奏"（赛题要求"适配乐器演奏场景"）；④追求参数漂亮忽略可闻（过采样不叠加加分）；⑤照着赛题原文写报告（一等奖作品名平均11.4字带具体场景词，"证明合规"是底线，"讲清价值"才拿分）。
镜像风险=欠拟合：只炫酷但没满足≥2维/复音不够/拿不出指标/没测试模式 → 同样致命。
平衡点：指标服从"能稳定演示+频谱数得清峰"。

【维度四 FPGA与Agent】
FPGA不可替代性（40%权重来源）：①大规模并行(CPU只能串行或几个核) ②**确定性时序**(延迟固定不抖动，CPU有中断/调度/缓存抖动) ③单周期级流水线 ④数据流架构。均可量化。
**建议的强论证结构**：同做32复音，CPU需分时调度+音频回调，延迟受缓冲区限制(5-20ms)且受负载抖动；FPGA是32套并行硬件每采样周期同时算完，延迟=固定流水线级数，抖动为0。**这个对比若能用示波器实测出来（CPU vs FPGA 同任务延迟+抖动分布），是最强加分点**，且成本低（软件合成器现成+有示波器）。
反面：软核跑合成(违反M2)、FPGA只做I2S接口、全用现成IP拼接、ROM放PCM(踩红线)。
Agent两个含义要区分：(a)**开发助手**——今年赛制明确鼓励（AMD 2026 新增"RTL/HLS本地智能体设计赛道"，自主选题权重含"大模型协作与技能包 15分"，要求提交交互记录+可复用技能包；复旦微 2026 明确鼓励用 Agent 工具做选题/方案/算法/开发，并要求细化"在什么环节用了何种AI工具及其在整体工作量中的占比"）。**但高云选题二未提及 Agent 协作，不假设加分，可低成本主动体现。**(b)**作品内智能**——必须仍满足 M2（纯FPGA HDL），会稀释精力，建议放最后作锦上添花。
已建 notes/agent-collaboration-log.md 协作日志（含已记录的3条协作 + 未来可沉淀为 skill/ 的候选清单）。

【给用户定 D0 的检验标准（一句话）】"如果这个作品用一台普通电脑/手机就能做出来，那 D0 选错了。" → 定位最好选"CPU 做不好"的场景：超低延迟演奏✅、几十声部同时✅、单纯播放音乐❌。
- [2026-09-18 22:02] [工作记录] 候选架构方案 v1「塑谱 Spectra」：音色可演奏的电子乐器（待用户批判） — 【候选架构方案 v1 已交付（2026-09-18）】文档：docs/02-技术方案/07-候选架构方案-v1.md
用户要求：以"系统架构师"角色，自主选定一个完整自洽的产品方向并推演到可实施程度，供他批判。明确要求：不要只依赖 prompt、要通读工作区全部文档、发现冲突必须指出不得静默修正、不伪造精确数字、每个架构选择说明 trade-off、必须 Red Team 自攻。

【产品定位（核心创意）】「塑谱 Spectra」——一台**"音色可演奏"的电子乐器**。
- 传统电子乐器：音色是"名词"（预设），选一次就固定
- 本产品：音色是"动词"——左手选音触发（上排12电极），右手在同一时间**连续改变这个音的内部泛音结构**（下排12电极横向滑动）
- 交互关系 = "塑造者"而非"选择者"；类比小提琴右手运弓、管乐气息（控制投入声音的能量分布），是演奏者已有的身体直觉
- 主要交互形式 = **"连续塑造声音"**（廉价乐器里最缺失的一种）
- 5 个独立维度：音高/谱心/力度/谱宽/滑音，全部来自**同一种硬件原语**（电容测量）
- 独立设备存在的三条理由：①感知闭环要求 <3ms（PC 5-20ms 抖动破坏闭环）②数百泛音 + 每周期必须完成的硬实时性 ③两手分工需要固定物理布局

【合成架构选择：加法合成】论证不是"因为它简单"，而是：
- **交互维度与合成参数完全同构**：交互控制的"谱心/谱宽"就是加法合成的参数本身（波表=表索引❌、FM=不能独立控单个泛音⚠️、物模=被物理限制❌）
- **只有加法能做"非谐变形"**（管风琴谐波列 → 钟的非谐列如 1:2.76:5.40:8.93），滤波器物理上做不到
- 验证性最好（每个泛音是独立可测单元）
- 诚实说明：产品需求与赛题指标（加法按分量计数）恰好同向，但**不是为指标设计的产品**

【关键硬结论：TDM 不是偏好而是物理必需】全并行时每泛音需每周期读正弦表，BSRAM 每块最多2个读端口，46块 → **最多92个并发读端口** → 全并行上限约92泛音 ≈ 5声部×16泛音，达不到要求。故 512 泛音（32声部×16泛音）**必须时分复用**。

【时钟推导（全部精确）】27MHz → rPLL → 108MHz（=27×4）；108e6/2304 = **46875 Hz 整除**；108e6/72 = 1.5 MHz BCK；46875×32 = 1.5e6 自洽。每采样帧 2304 周期。**单时钟域、零 CDC**（I2S 用寄存器输出而非派生时钟）。
⚠️ **重要：rPLL 具体参数未能确定**——官方 Sipeed 例程（27→6MHz）的 IDIV_SEL=5/FBDIV_SEL=0/ODIV_SEL=112 用官方文档公式 fCLKOUT=(fCLKIN×FBDIV)/IDIV **无法复现 6MHz**，说明 defparam 编码与文档公式间还有一层映射没搞清；VCO 范围 UG286 只说"参考产品数据手册"而本地无该手册。→ **因此文档中拒绝给出具体 PLL 参数值**，改为列出公式、备选频率表（108/81/54MHz 对应每帧 2304/1728/1152 周期）与保底方案（54MHz 下只能 256 泛音/16声部），并要求在 Phase 0 用 IP 向导+实测确认。

【其他关键结论】
- 数值：相位32bit（避免非谐拍频，24bit会引入2.8mHz拍频）、表1024×16+8位插值（SFDR≈-80dB）、幅度Q1.15、泛音累加32bit、主混音32bit→16bit饱和、输出round-to-nearest
- 分层包络：**泛音级指数衰减**（音色时间演化，钟声高频先消失）× **声部级ADSR**（提取到声部求和之后，省 512→32 次乘法）
- 特色机制：**掩蔽感知的泛音预算分配**（512泛音槽按心理声学规则动态分配，<200 LUT，诚实声明是启发式非机器学习）
- 效果器取舍：**做延迟(5块BSRAM) + 简化混响(6块)；合唱因 MAX98357A 单声道会退化为失谐，给出三条路径**（接受退化/外接 PCM5102A 立体声DAC ¥15/换其它效果），建议路径B
- 硬件：**一种传感原语×24**（铜箔电极 + IO弱上拉RC充放电 + FPGA并行TDC），无ADC无运放无模拟前端无机械结构，手工量约5小时
- 资源估算（architecture-level，无综合）：LUT 6900/20736(33%)、FF 4390/15552(28%)、BSRAM 20/46(43%)、DSP 18/48(38%)；**最大风险是 BSRAM 与 108MHz 时序，不是 LUT**

【主动声明的 6 处文档冲突（用户明确要求不得静默修正）】
1. 约束文档 D1「基础架构用波表法」**提前锁定了合成架构**，与本文档的加法核心冲突 → 提交为"待重新审议项"
2. `03-乐器形态方案建议.md` 主张"先引擎后外形"，与用户本次"先定产品定位"矛盾 → 调和为"定位先行、物理形态后置"
3. 两份不同的 47 天阶段计划（学习路线 P0-P5 vs 本文档 Phase 0-8）→ 建议以后者取代（原计划缺"架构风险前置验证"阶段）
4. 决策框架 v2 把 D0~D8 留给用户，本文档却给出选择 → 处理为"提案"，决策权仍在用户
5. **复音数指标（E1 要求≥32）vs 音乐需求（8-16声部已足够）** → 真实张力，不做调和，明确呈现
6. **MAX98357A 单声道 vs 赛题要求的"合唱"效果** → 给出三条路径不自行决定

【Red Team 7 条，最致命三条】
- RT-4：Teensy 4.0 可能做得更好（600MHz M7 能跑100+振荡器、开发快10倍、¥200）→ 诚实的回答是"产品层面 Teensy 覆盖 60-70%；若最终只做到 8×8，Teensy 确实更好——必须用数据证明 FPGA 必要性"
- RT-5：47 天对零基础可能不够（保守估算 44-49 天，成功率 40-50%）→ **必须立即定义 MVP = 4声部×8泛音（全并行）+12通道传感+测试模式+报告视频，MVP 优先级高于一切扩展项**
- RT-1：若只做到"亮度增减"就只是个滤波器 → 必须做出非谐变形

【下一步：4 个可验证实验（4.5 天内）】
E0 系统时钟可达性（0.5天，Gowin IP 向导试 108MHz）→ E1 电容传感 PoC（1天，最大风险，判定 SNR≥20:1、10min漂移<5%）→ E2 全并行 vs TDM 对比原型（2天）→ E3 最简链路延迟基线（1天，示波器测 100 次）

【三个最大未知数】U1 电容传感能否用 IO 弱上拉稳定工作（P0，3天内）｜U2 TDM 调度器能否在 47 天内写对（P3）｜U3 8声部×8泛音是否足够好（P2）
【附带未知数】108MHz 时序收敛（影响"指标优先配置"能否用，不影响产品成立）
- [2026-09-21 12:35] [工作记录] Tang Nano 9K + 4.3寸屏 第一次烧录 bring-up 完成（码流已编译） — 【板卡事实更正 — 重要】用户手上是 **Tang Nano 9K 和 20K 两块都有**（此前记忆写"只有 20K"不准确）。屏幕为 **Sipeed 4.3 寸 RGB 屏 480×272、40P 排线**（官方 lcd_4.3 例程对应）。
【战略提醒】竞赛指南适配板卡列表为 Nano 20K/Primer 25K/Mega 60K/Mega 138K，**不含 9K**；且赛题硬性要求「经 I2S 输出至 DAC」，**9K 无板载 DAC/功放，20K 才有 MAX98357A**。→ 9K 定位为学习/bring-up 板，声学通路最终必须在 20K 上打通。

【本次交付（2026-09-21）】
- 码流：src/gowin/bringup_9k/impl/pnr/bringup_9k.fs （2022 KB，MD5 13B562C6EEEC078C8B9C3E49F9637A58），器件 GW1NR-LV9QN88PC6/I5
- RTL：src/rtl/ 下 bringup_top.v / gowin_rpll.v / video_timing.v / test_pattern.v / led_heartbeat.v（全中文逐行注释）
- 约束：src/constr/bringup_top.cst；工程：src/gowin/bringup_9k/bringup_9k.gprj（用 ../../ 相对路径引用 rtl/constr，已验证可用）
- 工具：tools/scripts/build_gowin.ps1（一条命令编译）、tools/scripts/check_video_timing.py（时序自检）
- 指南：docs/02-技术方案/09-第一次烧录bring-up指南.md
- 官方保底码流：refs/vendor-examples/tang9k-official/step1_led/、step2_lcd43/

【设计要点】单设计两个独立时钟域：LED 跑 27 MHz 晶振直连（不过 PLL），视频跑 PLL 像素时钟。目的：PLL 挂了时 LED 仍能工作，故障现象唯一可辨（LED全灭=没配置成功；led[5]常亮=PLL没锁；LED闪+屏黑=屏侧问题）。视频总量照抄官方（560×297 @ 9MHz，54.1Hz），但把 DE 修正为正好 480×272（官方是 481×273 差一），并把官方"几乎恒低、实际无脉冲"的 HSYNC/VSYNC 改成规范同步脉冲（安全性论证：官方能跑⇒屏是DE模式⇒同步被忽略⇒规范脉冲也能跑）。
【资源基线】226 LUT(3%) / 109 FF(2%) / 0 BSRAM / rPLL 1of2 —— 8608 个 LUT 空着，说明后续 32 复音引擎逻辑资源不是瓶颈。
- [2026-09-21 12:39] [工作记录] Tang Nano 9K 上机首试：USB 未枚举，定位到物理层（换线/换口待验证） — 【当前状态（2026-09-21，未完成）】用户把 9K 插上电脑后 **USB 完全未枚举**：无新 USB 设备、无未识别设备、无 COM 口，`programmer_cli --scan-cables` 扫不到（exit 48）→ 排除驱动层，问题在物理连接层。
【用户实测】①板子上**有灯亮**（供电正常，VBUS 通）②插的是**靠 S1/S2 按键那一头的 Type-C**③用的是**随便找的一根 Type-C 线、未换过**。
【头号嫌疑 — 未验证，不得当结论】充电专用线（只有 VBUS/GND、无 D+/D-），现象完全吻合：灯亮但永不枚举。其次才是插错口（9K **两端各有一个 Type-C 口**）。尚未换线/换口验证。

【本轮从官方 FAQ 拿到的新情报】出处 https://wiki.sipeed.com/hardware/zh/tang/common-doc/questions.html
- **正常枚举形态**：设备管理器应出现**两个 `converter` 设备（USB Serial Converter A/B）+ 一个 COM 口** → BL702 固件是模拟成 **FTDI FT2232 双通道**的，**不是**"Gowin USB Cable"；FAQ 的排障建议是重装 FTDI 驱动。
- **Nano 9K 专属坑（重要，原文）**：「Nano 9K 在设计的时候将 JTAG_SEL 引脚连接到了 S2 按键上…JTAGSEL_N=0 的时候，芯片的 Jtag 引脚可以正常使用。在使用 Programmer 对 Nano 9K FPGA 板卡进行操作的时候按住 S2 按键就可以了。」
- **下载频率必须 ≤2.5MHz**，否则极慢或失败；不要勾带 Verify 的选项。
- 通电后需 2~3s（调试器可达十多秒）加载驱动才出现设备；只有两个 converter 而无 COM 时，走 converter B → 属性 → 高级 → 加载 VCP。

【交叉印证 1】本工程 PnR 报告显示**引脚 4 的 CFG 功能是 `JTAGSEL_N`**，而引脚 4 是官方例程里的复位按键 → **推测引脚 4 实物即 S2**，即我此前把 S1/S2 命名弄反了（bringup_top.v 中 pin4 叫 btn_rst_n/S1、pin3 叫 btn_user_n/S2）。**该对应关系待实物确认后再改代码与文档。**
【交叉印证 2】官方引脚图（wiki Tang-Nano-9K/assets/clip_image010.gif，实际是 PNG 需改名）底部图例明确标注 **BANK3 Vio=1.8V**、BANK1/BANK2=3.3V → 独立印证上一轮"Bank3 不能写 LVCMOS33"的约束修复；同图确认 9K 有两个 Type-C 口。
【旁证】官方仓库 .assets/lcd_4.3_colorbar.jpg 是 4.3 寸屏点亮彩条的实拍照片 → 该屏 + 官方例程组合确实能工作。
- [2026-09-21 12:59] [工作记录] 首次烧录成功：USB 认到、JTAG 扫到 GW1NR-9C、SRAM 烧录 2.9 秒、LED 与屏幕均已出图 — 【里程碑：2026-09-21 首次成功烧录并上板运行】

【1. USB 枚举问题已解决】设备管理器出现**两个 `USB Serial Converter A/B`（服务 FTDIBUS）+ `USB Serial Port (COM3)`（服务 FTSER2K）**，全部 Status=OK，与官方 FAQ 描述的"两个 converter + 一个 COM 口"完全一致。`programmer_cli --scan-cables` → **exit 0**，扫到 `USB Debugger A/0/8769`、`A/1/8770`。
⚠️ 触发因素**未确认**：用户上一轮明确说"还没换线、还没换口"，两轮之间执行了什么未知；`setupapi.dev.log` 显示 12:54:26 系统又跑了一次 FtdiPort 安装并成功。**不能断言"就是线的问题"**。

【2. JTAG 扫到 FPGA】`programmer_cli --device GW1NR-9C --scan`（exit 0）：
```
Target Cable: Gowin USB Cable(FT2CH)/0/None/null@2.5MHz
Family: GW1NR   Name: GW1N-9C GW1NR-9C   ID: 0x1100481B
```
→ 下载频率**自动就是 2.5MHz**（FAQ 推荐值），无需手动设。
⚠️ **重要修正（推翻此前待验证项）**：**不需要按 S2** 就能扫描并烧录成功。上一轮记录的官方 FAQ"用 Programmer 时按住 S2（JTAGSEL_N=0）"在本板/本机**并非必需**。适用范围：本次实测环境下成立；若将来扫不到器件，再回头尝试按住该键。

【3. 命令行烧录流程完全打通（可复用）】
```
programmer_cli.exe --device GW1NR-9C --operation_index 2 --fsFile <绝对路径>.fs
```
本次结果：`SRAM Program` 100%，`User Code is: 0x00000977`，`Status Code is: 0x0003F020`，`Cost 2.91 second(s)`，exit 0。
- `--operation_index 2` = **SRAM Program**（掉电即失、零风险）；4 = SRAM Program and Verify（**不要用**，FAQ 说带 Verify 会卡/极慢）。
- cable 无需指定，自动选中。
**烧录耗时仅 2.9 秒 → 改代码→重编→重烧的迭代成本极低。**

【4. 上板实测结果（自写码流 bringup_9k.fs，用户目视报告）】
- **LED：有几颗在有规律地变化，有的快有的慢，呈二进制计数状** → 正是设计预期（led[0] 1Hz 心跳 + led[4:1] 二进制计数）→ **证明 FPGA 配置成功、27MHz 晶振正常、PLL 已锁定、逻辑在跑**。
- **屏幕：由纯白变为出现图案** → **纯白 = 没收到有效图像；有图案 = 像素时钟已输出、DE 有效、面板正在接收有效时序** → 下载链路/时钟/PLL/屏时序/排线**全部打通**。
- ⚠️ **但图案与设计描述不一致，具体形态尚待用户拍照确认后定位**（未定位，不得写成已解决）。

【由此获得的实测结论】`gowin_rpll.v` 里照抄官方 lcd_4.3 的 rPLL 参数（IDIV=2/FBDIV=0/ODIV=48）**在这块板子上确实能工作**（否则 LED 不会闪、屏不会出图）。但"实际输出频率具体是多少 MHz"仍未核实，Phase 0 用 IP 向导核对的待办依然有效。
- [2026-09-21 16:00] [工作记录] rPLL 公式破解（9MHz 权威确认）+ 显示模块重构 + 图片显示上板验证 + 坐标偏移 bug 修复 — 【一、rPLL 频率之谜**彻底解决**（本轮最大成果）】
权威证据来自官方 IP 配置文件 `refs/vendor-examples/tang9k-official/step2_lcd43/src/gowin_rpll/gowin_rpll.ipc`：里面写着 **`CLKOUT_FREQ=9`**。
公式真相藏在同目录的 `.mod` 里——它记的是**向导界面上填的数**，而生成的 Verilog 写的是**减 1 之后的编码**：
```
.mod : -idiv_sel 3   -fbdiv_sel 1
.v   :  IDIV_SEL=2    FBDIV_SEL=0
```
于是两边公式完全一致：**fCLKOUT = fCLKIN × (FBDIV_SEL+1) / (IDIV_SEL+1)**，
约束：**fVCO = fCLKOUT × ODIV_SEL 必须落在 400~1200 MHz**。
本 IP：27×1/3 = **9 MHz**，VCO = 9×48 = 432 MHz ✓
三组官方例程交叉验证全部对上：9K lcd_4.3 → 9MHz（.ipc 佐证）；9K lcd_led → 27×24/5=129.6MHz，经 CLKOUTD(÷4)=32.4MHz（其注释说 33.33MHz），VCO=518.4 ✓

⚠️ **推翻一条旧结论**：项目早期记的"20K 音频例程 PLL 输出 6 MHz"是**错的**。该例程参数为 IDIV_SEL=5/FBDIV_SEL=0，正确公式下是 27×1/6 = **4.5 MHz**。做音频通路时必须重算，不得沿用 6 MHz。

决策：**刻意不把 .ipc/.mod 放进工程**——一旦放进，用 IP 向导"重新生成"会覆盖掉我加了 lock 端口的 wrapper。要看配置直接读 refs 里的原始文件。

【二、显示驱动重构为可复用模块】
- 新增 `src/rtl/lcd_480x272.v`：封装 PLL + 行场时序 + 打拍 + 消隐，对外只暴露"画布接口"。
- **客户契约只有两条**：① 组合逻辑：给 (px_x, px_y) 出 (px_r/g/b)；② 不用管消隐、不用管打拍。
- IP 归位：`gowin_rpll.v` 移到 `src/gowin/bringup_9k/ip/gowin_rpll/`（符合工作区约定）。
- 资源：LUT 241 → 310（4%），仍有大量余量。

【三、图片显示功能（已上板验证）】
需求：把 `D:\References\Pictures\305D2F603960543563769FDF41EA4463.jpg`（1280×1556 竖构图）显示到 480×272 屏上。
- **排版**：用户从 4 个候选方案中选定「**顶部对齐 + 裁剪填满**」。
- **硬约束（关键）**：GW1NR-9 的 BSRAM 只有 26 块共 468 Kbit；480×272 全彩 16 位需 2,088,960 bit（**4.5 倍**），8bpp 差 2.2 倍，**4bpp 也差 9%** → **只能 3bpp（8 色）**，实测占 **24/26 块（93%）**。
- 图像处理：裁剪填满 → 对比 ×1.25 + 饱和 ×1.5 → 8 色 + **Floyd-Steinberg 抖动**（抖动对观感提升巨大，实测无抖动版全是色块断层）。
- 实现：`image_rom.v`（`$readmemb` 加载）+ `image_view.v`（**地址预取 +1 抵消 BRAM 读延迟**，恰好满足驱动的"纯组合"契约；`y*480 = (y<<9)-(y<<5)` 无需乘法器）。
- 工具：`tools/scripts/make_image_rom.py`（可复现；已验证重跑生成的调色板与 RTL 里逐位一致）。
- 按键：松开 = 图片；**按住**（非复位键）= 自检图案。
- 用户确认：图片"**能认出是谁**"，颜色偏淡但正常。

【四、修掉一个真 bug：把"计数器值"当"像素坐标"】
`video_timing` 的行场计数器范围是 `x=0~559 / y=0~296`，而**有效区只是 `x=30~509 / y=5~276`**。
早期直接把计数器值当坐标交给图案模块，导致：白条只显示 30px（应 60）、黑条占 90px、左边框(x=0)画在行消隐里**永远不可见**、上边框同理；而 x=479/y=271 这两条"边框"落在有效区**内部**成了画面里的细线。
**最阴之处：色条顺序是对的**，只检查"颜色对不对"完全发现不了。
修法：`lcd_480x272` 交给客户的是**有效区相对坐标**（减掉 H_BP/V_BP）。
**已上板验证**：用户确认「八条彩条宽度相等，四周都有白边，底部有计数条」✓
- [2026-09-21 17:38] [工作记录] 新增一键烧录脚本 + 向用户讲清 bitstream/配置SRAM/BSRAM 的概念体系 — 【一、新增工具：一键烧录脚本】
`tools/scripts/flash_sram.cmd` —— 双击或命令行运行即可。
流程：① 检查 `programmer_cli.exe` 与码流文件是否存在（缺哪个明确报哪个）② 找下载器 ③ SRAM 烧录（约 4 秒）④ 失败时打印排查清单（线是否带数据 / 换口 / 等 10 秒驱动 / 设备管理器应有 2 个 converter + 1 个 COM）。
注释**刻意只用英文**：`.cmd` 在中文 Windows 的 cmd 里按 GBK 解码，中文注释会乱码（功能不受影响）。
至此项目有三条一键命令：编译 `build_gowin.ps1`、换图 `make_image_rom.py`、烧录 `flash_sram.cmd`。

【二、本轮向用户讲清的概念（准确表述，供未来复用，不要讲重复或讲错）】
- **`.fs` 就是 bitstream**（码流文件）。同目录还有 `.bin`/`.binx` 是同一设计的其他封装格式（实测 `.fs` 约为 `.bin` 的 8 倍大，**格式差异未验证**，只知道烧录用 `.fs`）。
- **`.fs` 里既没有 Verilog 也没有约束文件**。Verilog + `.cst` 是**编译输入**，它们的信息被"编译"成了"每一个配置开关的状态清单"。最贴切的类比：`.v`/`.cst` ≈ 源码，综合+布局布线 ≈ 编译链接，`.fs` ≈ `.exe`。
- **运行时 `.fs` 的状态**：就是躺在硬盘上的普通文件，一动不动。它的信息已变成电路（布线/LUT 部分）和 BSRAM 内容（图像数据部分），**芯片里没有任何地方还"存放着"这个文件**。类比：CPU 是"边看菜谱边做菜"，FPGA 是"按图纸把机器造好，图纸就可以收起来"。
- **为什么掉电丢失**：配置点是 **SRAM 工艺**，这是刻意的工程权衡——SRAM 配置点换来"快 + 可无限次重配 + 低功耗 + 高密度"，代价是掉电丢失。用 Flash 做配置点会牺牲 FPGA 最核心的"可重配置"能力。→ 行业方案：配置点用 SRAM + 外挂小 Flash 存配置数据。
  类比：**FPGA 配置点 = 白板**（写得快、可反复擦、断电即白），**板载 SPI Flash = 笔记本**（翻页慢、有寿命、合上还在）；每次上电 FPGA 先把笔记本抄到白板上（约 1 秒）。
- **精确边界**：GW1NR-9C 有 **608 Kbit User Flash**，但那是给设计用的非易失存储，**不参与配置**，容量也远不够（76 KB vs 码流 2 MB 起）。所以准确说法是"FPGA 没有把自己配置存下来的机制"，而不是"它没有非易失存储能力"。
- **必须分清两个都叫 SRAM 的东西**：**配置存储器**（决定芯片内部怎么连线，上电时用一次）vs **BSRAM**（你的设计运行时用的内存，图片/波表放这儿）。两者都掉电丢失，但 BSRAM 的内容会被码流一起带进来。
- **BSRAM 概念**：Block Select RAM，块状硬核存储，Xilinx 叫 Block RAM、Intel 叫 M9K。每块可配成 16K×1 / 8K×2 / 4K×4 / 2K×9 / 1K×18 / 512×36 等形状——**这就是"打包效率"的来源**，也直接决定 480×272 只能上 8 色。与 SSRAM（用 LUT 拼的分布式 RAM，仅 17,280 bit）相对。

【三、用户当前的理解进度】（便于下次接续，避免重复讲）
已讲清：JTAG vs UART 两条通道（本设计全程只用 JTAG，UART 引脚 17/18 完全没碰、COM3 从未打开）；"配置只发生一次、运行期完全独立"；706 万是**总吞吐量**而非每像素闪烁次数（每像素每秒刷新 54.1 次，且液晶是 sample-and-hold 不闪烁）；bitstream 与配置 SRAM 的本质。
用户已能提出"为什么 FPGA 不自动保存"这类概念性问题——**理解层次明显在往上走**。
- [2026-09-22 21:41] [工作记录] 答辩核心论证：「为什么是 FPGA 而非 MCU」四条论证 + 装饰性作品判据 + 最危险的平庸（软核） — 【核心判据（可证伪，一句话）】
> **"把这块 FPGA 换成一个同等价位的 MCU，什么东西会真的坏掉？"**
- 答"没什么会坏，只是慢一点" → **装饰性作品**，懂行的人一眼看出，不用到答辩
- 答"某条硬指标直接不成立" → 站得住

【四条论证，按强度排序】
**1) 确定性 —— 最强，因为它是架构属性而非性能指标**
best-effort vs **guarantee**。FPGA 里的"分时"是**编译期定死的静态调度**，最坏情况**可证明**；MCU 里是**运行期动态抢占（中断/cache/DMA 仲裁）**，最坏情况**只能统计**。赛题"≤5ms 且确定性无抖动"考的就是这个。
⚠️ 前提：必须能给出**具体数字**（"端到端 X μs，由 A 段 12 拍 + B 段 40 拍构成，时序报告可查"）。只说"我的延迟很低"是空话。

**2) 扩展的代价曲线**
FPGA 加通道 = 加**逻辑资源**（芯片够就能加）；MCU 加通道 = 加 **CPU 时间**（串行、总量固定、迟早撞墙）。
FPGA 是"**预算制**"（每采样周期 2304 拍，可逐拍算清）；MCU 是"**概率制**"。

**3) 并行性 —— 这是结构问题，不是性能问题**
要在同一个 21.3 μs 采样周期内同时完成：512 个泛音更新 + **12 个电容电极扫描** + 效果器 + 显示。MCU 上这些在抢同一份 CPU 时间（触摸扫描一轮几百 μs~几 ms，一轮就吃掉延迟预算一大块）；FPGA 上是**物理独立的电路**。
→ **"加一个电极，音频侧时序一个拍都不变"——这是 FPGA 独有的性质。**

**4) 吞吐量 —— 最弱，慎用** ⚠️
512 泛音 × 46,875 = 2400 万泛音采样/秒 ≈ 1 亿次运算/秒。
**"算力不够"这个理由站不住**——懂行的会直接回"Teensy 4.0 就能跑 32 复音波表"。
⚠️ 512 这个规模**正好卡在高端 MCU 极限上，是危险区**。吞吐量只能当佐证，**必须配合论证 1** 才有意义。

【诚实承认 MCU 更强的地方（能说清对手优势才说明想清楚了）】
复杂顺序逻辑/状态机、浮点与三角函数、文件系统/USB/蓝牙协议栈、手机 App 通信。
赛题拓展项里的"蓝牙+手机 App、脱机 LED 曲目指引"**天然属于 MCU**。
→ 成熟的架构回答是**分工**：FPGA 管必须确定/必须并行的部分（合成+交互闭环），MCU 管外围串行事务。**但音频通路必须全部在 FPGA —— 这是赛题红线。**

【型号选择的分层论证】
- **为什么高云**：赛题 7 家协办厂商之一（前提，非选择）+ 国产替代主题 + Tang 系列资料/例程最全
- **为什么 9K 不行**：不在赛题适配列表 + **无板载 DAC**
- **为什么 20K 够**：**板载 MAX98357A（I2S 输入 DAC + D 类功放）→ "经 I2S 至 DAC 发声"这条硬要求不用外接任何器件就满足**；20736 LUT4 / 46 块 BSRAM(828Kbit) / 48 乘法器
- **什么时候要 60K**：59904 LUT4 / 118 块 BSRAM(2124Kbit) / 118 乘法器 / 8 PLL / DDR3
  ⚠️ 但注意：**BSRAM 端口→TDM 的因果链不会因换芯片而消失**——全并行需每泛音每周期读正弦表，每块 BSRAM 最多 2 个读端口：20K 的 46 块 = 92 端口（全并行上限≈92 泛音），60K 的 118 块 = 236 端口，**仍不够 512** → **TDM 依然是正确解法，更大的芯片只是抬高天花板**。这条推理的价值在于：它不是"资源不够所以凑合"，而是"从芯片物理结构推导出架构的必然形态"。
  现实约束：60K 是申请制、每队限一块、完赛寄回；20K 自购常用。

【⚠️ 最危险的平庸（必须避开）】
**在 FPGA 里放软核 CPU（PicoRV32 / RISC-V），用 C 代码跑合成算法** —— 那是"用 FPGA 实现了一个更差的 MCU"：付出 FPGA 成本、得到 MCU 性能、还丢了确定性。
**Tang Nano 官方例程里就有 PicoRV 例子（`picotiny/`），诱惑就在那儿。**
赛题红线"完整音频生成通路必须全部基于 FPGA HDL 硬件逻辑"正是在堵这条路。
→ **软核只能做外围（UI/协议/调度），绝不能碰音频通路。**

【好消息：赛题规则本身就在防平庸】
禁预录 PCM（防当播放器）｜必须 I2S 至 DAC 逐样本实时运算（防外包）｜吞吐量=振荡器数×采样率且过采样不加分（强制真规模）｜现场频谱独立谱峰 + RTL 佐证（强制真做了）｜确定性无抖动（强制用上结构优势）｜决赛编程考核（强制人真懂）。
→ **一个用对了 FPGA 的作品，指标本身就是证据。如果作品需要靠在答辩里"论证 FPGA 有用"，那它大概真的没用。**

【验收清单（防跑偏）】
① 规模能越线吗 ② 延迟能给出上界吗 ③ 加一个交互维度，音频侧时序变不变 ④ 音频通路里有软核吗 ⑤ 效果器是"够用"还是"MCU 也能做" ⑥ **有没有一个功能是 MCU 根本做不到的** ← 终极判据。
对本项目，那一项应该是：**512 个独立振荡器，每个采样周期全部更新完毕，且延迟有硬上界。**

【当前诚实状态（不得粉饰）】今天的成果（8 色图片 + LED）**如果拿去交就是装饰性作品**——同样功能 MCU 是全彩且更轻松，我们做得更差。它的正确定位是**调试仪器，不是产品功能**。今天本来是打通链路阶段，但"打通链路过程中做出来的东西很容易被误当成作品的样子"。
- [2026-09-22 22:03] [工作记录] 仿真环境建成：iverilog 14.0 + GTKWave 装于 D:\iverilog，sim.cmd 一条命令跑通并验证自检能抓 bug — 【仿真环境建成：Icarus Verilog 14.0 + GTKWave（2026-09-21）】
- 安装包 `iverilog-v14-20260804-x64_setup.exe`（25.8 MB，来源 bleyer.org/icarus/）由我下载；**由用户自己点 UAC 完成安装**（见 lessons：Inno Setup 包绕不过提权）
- 安装位置：**`D:\iverilog`**
- 关键文件：`D:\iverilog\bin\{iverilog.exe, vvp.exe, gtkwave.exe}`
  ⚠️ **GTKWave 是官方安装包自带的**（装在 `bin\` 下），不需要另外下载
- 版本：Icarus Verilog **14.0 (devel)**，2026-08-04 构建
- ⚠️ **PATH 里没有它**（注册表 HKCU / HKLM 的 Path 均不含 iverilog，安装时没勾"加入环境变量"）
  → 按用户偏好（宁可终端级覆盖、不动系统 PATH），做成**会话级临时 PATH**，未改注册表

【新增：`tools/scripts/sim.cmd` —— 一条命令跑完 编译→仿真→开波形】
```cmd
tools\scripts\sim.cmd  src\sim\tb_xxx.v  src\rtl\xxx.v
```
内部三步：`iverilog -g2005 -Wall -o sim_build\sim.vvp <files>` → 在 `sim_build\` 里 `vvp sim.vvp` → 找最新 `.vcd` 用 GTKWave 打开。
只在当前会话加 PATH，**不改注册表**；仿真产物全部落 `sim_build\`（可安全删除）。
纯脚本调用时设 `SIM_NOWAVE=1` 跳过 GUI（原因见 lessons：GUI 占管道）。

【新增：仿真教学材料（`src/sim/`）】
- `hello_tick.v` —— 入门例子：每 N 个时钟产生一个使能脉冲。
  **选它是因为它同时是 UART 波特率发生器、I2S 位时钟 BCK、音频采样率发生器（46875 Hz）的共同内核**，正好等于用户《9/24 验收清单》里的 B3。
- `tb_hello_tick.v` —— **自检式** testbench：既录 VCD，又有自动断言（数 tick 间隔并打印 PASS/FAIL）
- `tb_template.v` —— 复制即用的 testbench 模板
- `src/sim/README.md` —— 重写：工具位置与用法、写 testbench 三要点、避竞争手法、GTKWave 首次使用步骤

【三项验证（均通过）】
1. 工具本体：`iverilog -V` → 14.0；`vvp -V` → 14.0；`gtkwave.exe` 存在
2. `sim.cmd` 端到端：编译 exit 0 → 仿真打印 `[PASS] 观察到 4 个 tick，间隔全部正好 10 拍` → VCD 3238 字节 → 脚本 exit 0
3. **自检确实能抓 bug**：把 `cnt == DIV-1` 改成 `cnt == DIV` 后重跑 → 报 `[FAIL] tick 间隔 = 11 拍，应该是 10 拍` × 3 次 + `[FAILED] 共 3 处错误`
   → 这条同时把用户《9/24 清单》的 **D3（有过一次仿真抓 bug 的真实经历）** 准备好了，他照 README 做一遍即可拿到

【本轮教给用户的可复用观念（认知优先）】
- testbench 的**两种用法**：① 看波形（新人用）② **自检**（专业做法，每次改代码都跑，几百个用例眼睛看不过来）
- **竞争（race）**：被测模块在 `posedge` 更新，检查逻辑若也在 `posedge` 读，读到更新前还是更新后**标准不保证** → 本项目统一**检查逻辑走 `negedge`**（隔半周期，值一定稳定）
- **坏习惯的替代方案**：不要"分频出一个慢时钟"去驱动别的模块，要用"**单一时钟 + 使能脉冲**"（`if (tick) ...`）——避免多时钟域、省全局时钟资源、时序分析简单。**这是本项目的单时钟域铁律。**
- [2026-09-23 19:43] [工作记录] Gowin EDA 无自带仿真器（三条证据）+ 全家桶 CLI 清单 + gao_sh 待探索 — 【Gowin EDA **没有自带仿真器**（2026-09-21 查证，三条证据）】
1. `IDE\bin` 全部 exe 中**没有任何仿真器**（无 vsim / vlog / modelsim）。
2. 官方文档 SUG100 §7「仿真文件」原文：**"云源提供用于仿真的输入文件"** —— 它只生成仿真所需的**输入**：综合后网表 `.vo`/`.vho`、延时文件 `.sdf`、功能仿真库 `prim_sim.v`（位于 `installPath\IDE\simlib`）、时序仿真库 `prim_tsim.v`。**仿真本身不归它管。**
3. 默认搭档是 **ModelSim**（文档原文："`*.vcd` 类型文件可用 ModelSim……Matlab、ModelSim 工具的使用需要取得**第三方授权**"）。安装目录里官方 IP 的仿真脚本全部放在 `IDE\ipcore\*\sim\Modelsim\` 下。
另：文档还提到 **"DSim 仿真验证云平台"**（IDE 菜单里有入口），是把设计传到云端跑——日常不合适。
→ **结论：在 Gowin IDE 里点不出仿真，别再找了。** 日常功能仿真用 **iverilog**（完全独立于 Gowin，环境见条目 de76a52a9d61）；时序仿真等后期需要时，再用 Gowin 生成的 `.vo`/`.sdf` 喂给 iverilog。

【Gowin 全家桶的 CLI 版清单（实地核对 `IDE\bin` 与 `Programmer\bin`）】
| 工具 | GUI 版 | **CLI 版** | 状态 |
|---|---|---|---|
| 云源软件 / IDE | `gw_ide.exe` | **`gw_sh.exe`**（运行时自打印 `*** GOWIN Tcl Command Line Console ***`） | ✅ 天天用 |
| 综合 | — | `GowinSynthesis.exe`（由 gw_sh 调用） | 间接用 |
| 布局布线 | — | 无独立 exe，由 `run all` 驱动 | 间接用 |
| 编程器 | `programmer.exe` | **`programmer_cli.exe`** | ✅ 今天烧 6 次 |
| 在线逻辑分析仪 GAO | `gao_analyzer.exe` | **`gao_sh.exe`** | ⏳ 未用 |
| 虚拟 IO 调试 | `gvio_analyzer.exe` | **`gvio_sh.exe`** | ⏳ 未用 |
| Verilog 预处理器 | — | `vlg_pp.exe` | 未用 |
| **仿真** | ❌ | ❌ | 用 iverilog 顶上 |
| 其他 | — | `hierarchy.exe` / `nlsresource.exe` / `gw_ctrl_reg.exe` / `GowinModGen.exe` / `gw_pkgviewer.exe` / `gw_sdceditor.exe` | 未用 |
→ **除仿真外，Gowin 全家桶都有 CLI 版。** 关键钥匙：**`gw_sh.exe` 是个 Tcl 控制台**，三行脚本即可驱动全套流程 —— `open_project "x.gprj"` → `set_option ...` → `run all`。

【🔍 未来值得探索（**未验证，不是承诺**）：`gao_sh.exe`】
GAO = 芯片内部逻辑分析仪，能把 FPGA **内部信号**（相位累加器值、包络电平、混音结果……）抓出来。
若它能像 `gw_sh` 一样被脚本驱动、并把抓到的数据**导出成文件**，那就意味着：**我可以直接"看见"芯片内部正在发生什么，不需要用户用眼睛描述。**
这对**音频调试**意义极大 —— 音频算法在板子上看不见、听不出细节（包络曲线对不对、有没有溢出、相位精度够不够，只有波形能说明）。现在的循环是"我改 → 用户听/看 → 用户描述"，GAO 若可用就能变成"我改 → 我直接读波形数据 → 我自己判断"。
⚠️ **尚未验证 `gao_sh.exe` 是否支持该用法。** 等要正式调音频时再一起摸。
- [2026-09-23 21:34] [工作记录] 2026-09-23 盘点：真实剩 41 天、声音进度 0%；能力评估=在"阅读理解"阶段未到"写作"；必须先补的只有三样 — 【⚠️ 时间校准（重要：此前多次算错）】
真实日期 **2026-09-23（周三）21:33**。此前我在多轮对话中默认按 **09-21** 计算，导致天数偏乐观。
- 提交截止 2026-11-04 18:00 → **剩 41 天**
- 第 1 段「能出声」（09-18 ~ 10-05，共 18 天）已过 **5 天，只剩 12 天**
- **9/24 回归验收 = 明天**
→ **纪律：算日期必须用 `Get-Date` 实取，不要沿用对话上下文里推断/记忆的日期。**

【工作区清点（2026-09-23）】
| 层 | 内容 | 状态 |
|---|---|---|
| 情报层 | `docs/` 19 份：竞赛情报 6 + 技术方案 9 + 学习路线 2 + 笔记 1 | ✅ |
| 资料层 | `refs/`：7 家厂商选题指南、往年真题、官方通知、Sipeed 9K 例程、4.3 屏官方 `.fs` + 源码 | ✅ |
| 代码层 | `src/rtl` 6 个模块（显示通路）+ `src/sim` 3 个 + `src/constr` 1 个 + Gowin 工程 | ✅ |
| 工具层 | 4 条一键命令：`build_gowin.ps1` / `flash_sram.cmd` / `sim.cmd` / `make_image_rom.py` | ✅ |
| **声音层** | **0 —— 没有任何音频相关模块** | ❌ |
→ **地基打得很好，房子还没开始盖。**

【能力评估（**按工作区实际痕迹，不按用户自我感觉**）】
| 技能 | 证据 | 判定 |
|---|---|---|
| Verilog 基础语法 / 时序逻辑 | 自学 UART 并写出收发 | ✅ |
| 计数器 + 使能脉冲 | UART 波特率发生器 | ✅ |
| 移位寄存器 | UART 串行收发 | ✅ |
| 状态机 | UART 收发状态机 | 🔶 会写简单的 |
| 工具链（综合→烧录） | 自己装 iverilog、自己烧板 | 🔶 会，但依赖脚本 |
| **`.cst` 引脚约束** | **用户主动说"这个要麻烦你"** | 🔶 见过，未独立写过 |
| **仿真** | `sim_build/` 里只见到我跑过的记录 | ❌ **未见到用户自己跑过的痕迹** |
| 多模块设计（例化/参数化/generate） | 读过 `bringup_top` 的结构 | ❌ 未自己搭过 |
| BSRAM 使用与初始化 | 见过 `image_rom.v` | ❌ 未自己写过 |
| 定点数 Q 格式 / 位宽溢出 / 流水线 / 时序报告 WNS / I2S / 电容触摸 / TDM | — | ❌ |

【核心判断：用户在"阅读理解"阶段，尚未进入"写作"阶段】
证据：`lcd_480x272.v` / `video_timing.v` / `image_view.v` / `image_rom.v` 等 **600+ 行 RTL 全部由我写**；用户**确实读懂了**（能发现"屏幕上在闪二进制数字"、能指出"图片颜色偏淡"、能问出"为什么 FPGA 不自动保存 bitstream"这类概念性问题），但**没有自己从零写过并调通**。
→ **读懂别人写的 ≠ 自己能写出来并调通。** 过这条河靠的不是更多知识，而是**自己独立做完一次**。
→ 比喻：用户现在能"跟着导航开车"，还不能"自己看地图找路"。
→ 这个判断**必须对用户明说，不能因为怕打击而含糊**——他自己就要求过诚实评估、拒绝虚高画像。

【"是否完备"是**错的问法**】
FPGA 知识体系无限，追求完备会把 41 天全花在准备上。
**用户自己那份《9/24 清单》第三部分已经回答了这个问题**——明确列出"不需要现在会"的 7 项（SDRAM/DDR 控制器、高速接口 PCIe/MIPI/千兆网、软核 CPU/AXI、复杂 IP 集成、高级时序约束、SystemVerilog 高级特性、PCB/信号完整性）。
→ **正确问法不是"我学完了没有"，而是"下一个零件，我能不能独立做出来"。**

【真正"必须先补"的只有三样，其余全可边做边学】
1. **仿真** —— 音频算法在硬件上**看不见**（包络曲线对不对、512 路累加会不会溢出、相位精度够不够，只有波形能说明），没仿真就是盲写。工具已就位，成本 **30 分钟**。
2. **`.cst` 引脚约束** —— 日常使用频率最高；用户必须**看得懂**（决赛要解释"为什么这个信号接这个脚"，将来加按键/触摸电极也要自己加行）。成本 **~30 分钟**。
3. **自己走完一次独立闭环** —— 不是知识，是**信心**。即《9/24 清单》里的「30 分钟挑战」。

【关键洞察：用户比自己以为的更接近"能出声"】
写 I2S 所需的东西：计数器+使能脉冲 ✅（UART 里已写过）、移位寄存器 ✅、MSB 先出 🔶半小时、WS 相位 🔶半小时、仿真 ⬜30分钟、`.cst` ⬜30分钟。
→ **UART → I2S 是一次小跳跃，不是大跳跃。**
→ 其余技能全部跟着项目零件自然出现：相位累加器→定点数；波表 ROM→BSRAM；ADSR→状态机进阶；32 声部→generate；混音→饱和限幅+流水线；效果器→真正的 DSP。

【时间账（难听的部分）】第 1 段的验收标准是"喇叭响"，而**当前声音进度 0%**。这 5 天做的工具链/显示/仿真/概念**是必要地基，没有白做**，且用户的理解深度（能问出"为什么不用 MCU"）**远超刚学 5 天的零基础**。**但地基不能替代房子——9/24 验收完必须立刻开始 I2S，不能再在地基上打磨。**
- [2026-09-23 21:53] [工作记录] 方案1深度审计v2：四条弱主张两条不成立 + 纯仿真验证链跑通（泛音独立性已证明） — 【方案1 深度审计 v2（2026-09-23）—— 新约束"只能靠仿真"下的重审】

【触发条件】用户明确：「我们现在没有那么多外设 甚至连板子都不一定一直有的用 所以我们只能靠仿真了」

【先做了纯仿真验证链（已跑通，可复现）】
链路：Python 生成正弦表+激励 → iverilog 仿真 → dump 12000 样本 → FFT 验证 + 渲染 WAV。
文件：`src/rtl/osc_additive.v`（8 个独立相位累加器的加法合成振荡器组）、`src/sim/tb_osc_additive.v`、`tools/scripts/additive_tool.py`（gen/analyze 两个子命令）、`tools/scripts/run_additive_sim.cmd`（一键复现）。
模型约定：fs=50 kHz（1 时钟=1 样本，周期 20 µs），相位 24 位，正弦表 256 项×16 bit，8 泛音，每测试 12000 样本（0.24 s）。
**实测结果：两个测试各 8/8 谱峰命中，频率误差 <1.67 Hz（FFT bin=4.17 Hz）。**
**核心证据：测试 A（谐波 1..8×220Hz）与测试 B（只把第 3 泛音改成 2.76×）对比 —— 只有第 3 个峰从 658.3 移到 608.3 Hz，其余 7 个峰位置逐位一致。这直接证明「每个泛音有独立相位累加器与频率控制」，正面命中赛题对"独立振荡器"的定义。**
桌面交付：`C:\Users\Sakuya\Desktop\FPGA仿真结果_20260923\`（2 个可播放 WAV + 报告 + 频谱 CSV + VCD + 源码 + 审计报告 + 「先看这个.md」）。

【四条弱主张裁决 —— 两条不成立、两条部分成立】
1. **TDM 必要且可实现 → ⚠️ 部分成立**。"全并行上限≈92 泛音"（BSRAM 46块×2端口）是硬事实；但"必须做 512 泛音"这个前提可疑。**新发现遗漏判据：仿真成本**——8 泛音仿真数十秒、32 泛音约 2-4 分钟、128 泛音 10-20 分钟、512 泛音 40-90 分钟，**会摧毁迭代节奏**。↔ 反向正面影响：TDM 原本最大的代价"时隙不可观测"在仿真里几乎消失（可 dump 任意内部信号）。
2. **电容传感可靠 → ❌ 不成立**。三重打击：无外设；**传感可靠性是物理/模拟问题，仿真只能验证其下游数字逻辑，无法验证"手指按上去真能测出来"**；而原方案整个产品概念全依赖这 24 个电极 → **照原样执行第一步就卡死**。
3. **47 天够用 → ⚠️ 需重估**。天数已变 41 天（9/23→11/4）。省掉硬件 bring-up 与传感器调试，但演示准备变难、新增仿真等待。**风险性质改变：从"技术做不出来"变成"做出来了但无法令人信服"（交付风险）**。
4. **32 声部有意义 → ❌ 基本不成立**。音乐上过剩；**在仿真条件下"高数量"变得廉价、说服力低**（没有物理约束在抵抗它）；消耗最稀缺的仿真时间。建议把"声部数"从目标降为参数。

【新判据：闸4「可仿真性」】在三道闸之外新增——①可观测吗（能否 dump 内部信号）②确定性吗 ③**仿真成本多大**。按此给设计要素打分：相位累加器/包络/混音/I2S/WS2812 全优；TDM 可用但规模受限于仿真成本；HDMI 视频成本高；传感逻辑可仿真但物理层不可验证。

【修订架构建议（方案1'）：三层解耦】
- 第3层 物理传感（可缺席、不在关键路径）：现状缺席 → 部署目标 = **板载 2 按键 + UART（零外部器件）**；可选增强 = 电容电极
- 第2层 事件解释与映射（纯逻辑，✅完全可仿真）：用**行为模型**驱动验证
- 第1层 合成引擎（✅已证明可仿真）：加法合成/包络/混音/效果器
**关键：三层之间唯一契约是「演奏事件接口」，只要它不变，第3层怎么换都不影响 1、2 层。**
参数化三档规模应对仿真成本：日常调试 8-16 泛音（<1min）／功能验证 32 泛音／最终演示 64-128 泛音（一次性长跑）。

【交付物形态调整（关键）】纯仿真下"作品"= 三件套：①可听音频（仿真渲染 WAV）②可视化证据（频谱图+**泛音独立性对比图**）③**工程严谨性（RTL+测试套件+资源/时序报告+一键回归）**。第③件被严重低估——没有实物时，**一套严谨的验证体系本身就是最能打的作品**，直接命中评审判据的"专业性"与"完整度"。

【时间重排结论】纯仿真路径下 41 天是够的（Phase 0 省 3 天因取消传感 PoC、Phase 1 省 2 天、Phase 4 省 2 天、Phase 7 省 3 天；Phase 6 验证 +2 天、Phase 8 +1 天）→ 合计 39 天，余 2 天缓冲。**比原估 44-49 天宽松**，因为省掉了硬件调试。

【新增风险】R21 无实物导致初赛视频说服力不足（高概率高影响，**头号战略风险**）｜R22 仿真规模拖慢迭代｜R23 仿真通过≠综合能跑（对策：每阶段跑一次综合，本机 CLI 已跑通）｜R24 行为模型与真实传感不一致。

【待用户决策 4 项】①板子能否稳定用 ②交互层走哪条路（板载按键+UART／行为模型／两者都做）③规模目标（16/32/64/128 泛音）④是否接受"验证体系即核心交付物"。

文档：docs/02-技术方案/10-方案1深度审计-v2.md
- [2026-09-23 22:02] [工作记录] 实时键盘演奏 + 长音频交付 + Python模型与RTL逐位一致（0样本差异） — 【音频交付与实时演奏（2026-09-23）】

【用户反馈】①上一轮 0.24 秒的 WAV 听不到（太短）②希望能"用电脑当上位机、键盘交互"，尝试第一次与项目交互。

【已解决：实时音频通路】手动安装 sounddevice 0.5.6（PyPI wheel 自带 PortAudio DLL，解包到 tools/pylib/_sounddevice_data/portaudio-binaries/）。本机音频设备正常（Realtek + Intel SST），默认输出设备 index=4，默认采样率 44100/48000。**实时播放已验证可用**（测试播放过 C-E-G-C 和弦 1.5 秒）。
⚠️ pip 仍因系统代理不可用 —— 装包方法：Invoke-WebRequest 从 pypi 下载 wheel → python zipfile 解包到 tools/pylib → 设 PYTHONPATH 使用。

【核心交付：tools/scripts/synth_engine.py】三个子命令：
- `verify`：逐位比对 Python 模型与 Verilog RTL 的仿真输出
- `demo`：渲染长音频到 WAV（小星星 29s × 2 + 泛音逐个进出 12s）
- `play`：实时键盘演奏（sounddevice OutputStream + msvcrt 轮询）

**【关键成果：Python 模型与 RTL 逐位一致，已实测 0 个样本差异】**
测试 harmonic 与 inharmonic 各 12000 样本比对，**不一致样本数 = 0，最大差异 = 0**。
→ 这句话因此成立："你在电脑上听到的，就是 RTL 烧进 FPGA 后会发出的声音。"
**注意 RTL 有一个固定启动延迟 = 2 个样本**（复位序列导致，起始相位 = 2×inc）。这是设计的真实属性，不是 bug（48kHz 下 42 µs，可忽略）。验证脚本用自动扫描起始相位（0..11 × inc）找出该延迟。

【实时演奏操作映射（play 模式）】白键 A S D F G H J K L ;（C D E F G A B C D E）／黑键 W E T Y U／Z X 八度／**[ ] 谱宽（泛音数 1-8）**／**- = 谱心（泛音衰减快慢）**／**, . 非谐度（0=管风琴 1=钟声）**／ESC 退出。4 声部复音，6ms attack + 200ms release 防爆音。
→ 这直接呼应方案1"塑谱"的核心交互：非谐度那条轴就是"管风琴↔钟"的连续变形。

【踩坑记录】
1. Verilog task 的字符串参数宽度不够会**静默截断**：`input [8*16-1:0] fname` 装不下 "samples_harmonic.txt"（20 字符），结果文件被写成 "les_harmonic.txt"。改成 8*40 解决。
2. Python 类里属性与方法同名会冲突：`self.release = int(...)` 覆盖了 `def release(self)` → `TypeError: 'int' object is not callable`。改名 release_len / start_release。

【桌面交付】C:\Users\Sakuya\Desktop\FPGA仿真结果_20260923\
- **★弹一弹（键盘实时演奏）.cmd** ← 双击即可实时演奏
- 音频\ ：1_小星星_管风琴音色_29秒.wav、2_小星星_音色渐变_29秒.wav、3_泛音逐个进出_12秒.wav
- 先看这个.md（操作说明+证据）、方案1深度审计.md、仿真验证报告.md、频谱CSV、VCD、源码\
- 注：旧的 0.24s 短音频 `听_加法合成_纯谐波.wav` 被播放器占用删不掉，已在 README 中说明可无视（也说明用户确实尝试播放过）。

【待办：用户听完后要拍板 4 件事】①板子能否稳定用 ②交互层路线（板载按键+UART／行为模型／两者都做）③规模目标（16/32/64/128 泛音）④是否接受"验证体系即核心交付物"。
【下一步技术动作】把这个 osc_additive 跑一次综合（tools/scripts/build_gowin.ps1），看 LUT/BSRAM/DSP 与 WNS —— 这是"能不能真的做出来"的答案。目前尚无该设计的综合数据。
- [2026-09-24 19:30] [工作记录] 综合暴露两问题并修复：LUT↓85%、时序违例消除、算法仍逐位一致 + 课题覆盖仅15%（F2缺包络） — 【综合 + 课题覆盖审计（2026-09-24）— 两个真问题已发现并修复】

【第一次综合 osc_additive v1 暴露两个仿真看不见的问题】
1. **正弦表没进 BSRAM**：`assign s_val = sine_tab[phase[..]]` 是**异步读**，而块 RAM 是**同步读**的 → 综合器无法映射到 BSRAM，退化成 LUT 搭的多级选择树。结果 LUT 用了 **2070 个**，BSRAM = 0。
2. **时序违例**：`sum_comb` 用组合 always + for 循环 → 综合成**串行 8 级加法链**。**SETUP slack = −2.987 ns**（数据路径 18.281 ns vs 要求 15.294 ns）。
v1 资源：Logic 2467/20736(12%)、Register 197、BSRAM 0、DSP 3/24（6×MULT18X18）、CLS 1241/10368。

【v2 修复（只改硬件结构，算法一字未改）】
- 表地址寄存一拍 + 同步读 → 表进 BSRAM
- 8 路求和改**加法树 + 逐级打拍**（7 级流水线，全部由 sample_en 使能）
- ⚠️ 关键：流水线寄存器必须由 sample_en 使能，否则每个系统时钟都推进一级，样本间空闲拍会被当数据处理
- v1 已存档 `src/rtl/archive/osc_additive_v1_异步读表.v`，v1 样本备份在 `sim_build/additive/_baseline_v1/`

【修复效果（实测）】
| 项 | v1 | v2 |
|---|---|---|
| Logic | 2467 (12%) | **371 (2%)** ↓85% |
| LUT | 2070 | **19** ↓99% |
| BSRAM | **0** | **8/46 (18%)** |
| Register | 197 | 391 |
| DSP | 3/24 | 3/24 |
| **SETUP slack** | **−2.987 ns 违例** | **+4.244 ns 满足** |
| 数据路径 | 18.281 ns | 11.050 ns |
**算法一致性已验证：v1 与 v2 各比对 2000 样本，不一致 0、最大差异 0，仅多 6 个样本延迟（流水线深度，48kHz 下 125µs）。**

【⚠️ 修复暴露的更硬约束 — 全并行上限修正】**BSRAM 用了 8 块 = 8 泛音一块一个**（综合器为每个读端口复制一份表，没用真双端口）。→ 推算：16泛音=16块、32泛音=32块(70%)、**46泛音=46块(100%上限)**、64+不可行。
→ **全并行实际上限 ≈ 46 个泛音**（不是我之前估的 92）。之前的 92 是按"真双端口 2 读/块"算的理论值，综合器实际按 1 读/块复制。**这反而更强支持 TDM 的必要性**：要做 128-512 泛音必须时分复用。理论上可手工约束成真双端口把上限提到 92，属后期优化项。

【时序距 108 MHz 仍差】工具无 .sdc 时默认要求 15.294 ns(≈65MHz)，v2 slack +4.244 ✅。但我们的目标 108 MHz = 9.259 ns，v2 数据路径 11.050 ns → **slack −1.79 ns 仍违例**。需再优化约 2 ns（继续细分流水线）或先降到 54 MHz。**同时必须补 .sdc 时序约束**，否则分析无意义。

【课题要求覆盖审计结果】**总覆盖度约 15%**
- 必须项 2/9（M2 部分：合成引擎是纯 RTL 但无输出通路；M6 架构支持但 inc 还是常量）
- 红线 2.5/3（R1 ✅设计上不可能踩、R2 ✅已仿真证明、R3 部分）
- 形式项 1.5/4
- 拓展项 0/8
**🔴 关键缺口 F2**：赛题要求"独立发声单元为包含**独立相位累加器、频率调控、包络控制**的完整振荡器"。我们现在有相位累加器✅ 频率调控✅ 但**没有包络**（amp_flat 是静态常量）→ 严格讲现在的单元还不算"完整振荡器"，**直接关系吞吐量指标的成立**，优先级高于扩展项。
其它缺口：M1/M9 交互层、M3 I2S、M5/M8 复音与混音、F1 测试模式、F3 指令识别。

【下一步 7 步（全部不需要开发板）】①✅修两问题 ②✅verify确认算法未变 ③✅重跑综合 ④补 .sdc 时序约束按 108MHz 分析 ⑤继续细化流水线把 slack 拉正 ⑥补包络(F2/M7) ⑦写 I2S(M3)

文档：docs/02-技术方案/11-综合结果与课题覆盖审计.md（含完整数据表与修复前后对比）
- [2026-09-27 19:48] [工作记录] 修复4个Bug（含摧毁核心演示的那个）+ 算法可行性成立 + 竞争力诚实评估（不在算法在交互） — 【模拟器 Bug 修复 + 算法可行性 + 竞争力评估（2026-09-27）】
文档：`docs/02-技术方案/13-模拟器Bug修复与算法可行性评估.md`

【修复的 4 个 Bug（tools/scripts/synth_engine.py）】
1. 🔴 **致命：按住音时改参数完全无效** —— `Voice.__init__` 把 `inc`/`amp` 固化了，之后改 state 只影响新按下的音。**这意味着我此前告诉用户"按住 A 连续按 . 会听到音色从管风琴变钟"在当时是假的**，而这是"塑谱"产品概念的核心演示。修法：新增 `Voice.set_spectrum(ratios, amps)` + play 模式里的 `apply_to_sounding()`。
   修复后实测：前段谱峰 [440,880,**1320**,1760,**2200**,2640,3080] → 后段 [440,880,**1215**,1760,**1915**,2640,**2685**]，第3/5/7泛音精确移到非谐比例，音高完全不动。✅
2. 🟠 改幅度会"咔哒" → 改为 **10ms 线性斜坡**过渡（频率仍立即生效，因相位连续不会咔哒）
3. 🟠 **方向键会弹出音符** —— Windows 下功能键是两字节（\xe0/\x00 打头），原代码丢掉首字节后第二字节被当普通字母（上箭头=H=A音）。修法：检测到 \x00/\xe0 就吃掉第二字节
4. 🟠 **音频回调抛异常会让流静默死掉** → 回调整体 try/except，异常记 state["err"] 供主循环检测
附带清理 `render_spectral_sweep`：删掉一段算完从未使用的死代码；原实现的语义也错了（把整段8泛音底噪与扫描段叠加，听不出"逐个进出"）→ 改用新加的 set_spectrum 做单 voice 实时幅度谱扫描。

【回归测试全绿】①与 RTL 逐位一致：0 差异（**验证脚本也修了**——v2 流水线版输出开头有 4 个填充样本，原脚本只扫起始相位不够，现在变成 (skip, k) 二维扫描）②demo 三段渲染正常 ③实时改参数生效 ④包络向量化后状态机正确（attack→sustain→release→done）

【算法可行性结论】**成立且证据充分**（8 条已验证）：频谱精确（误差<半个FFT格）、泛音真正独立、非谐变形可实现、定点无溢出、Python=RTL逐位一致、可综合（371LUT+8BSRAM+3DSP、slack+4.244ns）、可实时改参数、能出声。
**未验证 6 条**：多声部混音不溢出、TDM 调度器正确、高泛音数资源、108MHz 时序收敛（现仅满足~65MHz）、**实际听感（我听不到，需用户确认）**、演奏手感。

【⚠️ 对用户判断的诚实修正（重要，不要迎合）】用户说"算法比较优秀、比较激进、能实现的话应该有竞争力"。逐句评估：
- **"算法优秀"需修正**：**加法合成不是新算法**（1970年代 Synclavier、Kawai K5000 都是）。算法创新维度我们**没有优势**。答辩若说"我们用了加法合成"，评委会问"50年前就有了，新意在哪"——**答案不能是算法，必须是交互**（把音色内部结构做成可实时演奏的轴，这是廉价乐器里真没被做过的事）。
- **"激进"成立，但激进的不是算法而是工程目标**：实时塑谱交互 ✅激进｜零外设纯仿真可验证 ✅激进｜<3ms确定性延迟 ✅激进｜512泛音 ⚠️中等｜加法合成 ❌不激进。
- **⚠️ 必须警惕的陷阱：指标高 ≠ 竞争力强**。仿真条件下"512个振荡器"说服力低（没付出物理代价）。对比："测试模式输出512个独立谱峰"（中） vs "这是我们**弹**出来的，只有32泛音但能实时变形"（**高**）。**胜负手在能不能演示，不在数字多大。**
- **真正的竞争力来源排序**：①交互设计（实时塑谱）②**完整度+可验证性（我们的强项，命中"专业性"判据）**③FPGA不可替代性的可测证据（有论证但**还没做 CPU vs FPGA 对比实验**）④指标 ⑤算法创新（没有）。
- **一条现实对照**（来自1442件获奖作品分析）：音频类一等率17%高于平均13.9%，方向不错；但**历届无电子乐器先例**，没人证明过这条路能拿一等奖；一等率最高的是"有明确现实价值+FPGA不可替代"（机器人34%/医疗25%）→ **我们"给谁用"的应用价值叙事目前偏弱**，这是最可能失分处。

【建议下一步（按优先级）】①用户先听修复后的音频确认能听到、且听得出管风琴→钟的变化 ②用户先弹一遍 play 模式验证这次真有变化 ③补振荡器**包络**（M7/F2 最高优先级缺口）④做 **CPU vs FPGA 延迟对比实验**（把不可替代性从论证变成数据）⑤想清楚"给谁用"的应用场景。
【核心提醒】"现在的风险不是算法不行，而是**做出来没人信**。每一分力气优先花在'让它可信'上——能听、能弹、能测、能复现，比多100个振荡器有价值得多。"

【桌面已更新】C:\Users\Sakuya\Desktop\FPGA仿真结果_20260923\ —— 音频\ 里三段已换成修复后重渲染的版本，新增 Bug修复与可行性评估.md
- [2026-09-27 20:03] [工作记录] 修复演奏模式"一直响"：补上按键抬起事件 + 余韵档位 — 用户反馈"弹出来的音频会一直响"。定性：是 bug + 设计缺口，不是有意为之。

改动（tools/scripts/synth_engine.py）：
1. 新增 ConsoleKeyReader 类 —— ctypes 调 kernel32，CreateFileW("CONIN$") + GetNumberOfConsoleInputEvents + ReadConsoleInputW，拿到 bKeyDown 为 True/False 的按下与抬起事件；解析逻辑抽成独立函数 _parse_key_records 便于单测。
2. cmd_play 主循环重写：held 字典 键→声部，按下建声部、抬起 start_release()；自动重复（已在 held 里的键）忽略；ESC/Ctrl+C 退出；finally 里 reader.close() 恢复控制台模式。
3. 退化兜底：reader.ok 为假时仍走 msvcrt，但每个音 1.5 s 后自动 start_release()，杜绝"永远不停"路径。
4. Voice 新增余韵：self.decay（每采样衰减系数，1.0=不衰减）+ set_decay_seconds(sec)，_env_block 的 sustain 段支持指数衰减，env<1e-4 自动 done。播放模式用 1/2 键在 [0(持续),4,2,1,0.5,0.25] 秒之间切换。

新增测试 tools/scripts/test_play_release.py（假按键回放 + 假 sounddevice 驱动真实 cmd_play，逐块记峰值）：10 项断言全过；变异测试（start_release 置空）能报 3 项失败。

回归确认：synth_engine.py verify 仍报"逐位完全一致"（0 样本差异）；demo 三个 WAV 与桌面已交付版本 SHA256 完全相同，无需重新交付。

其它修复：桌面 ★弹一弹.cmd 的中文原本全变成 '?'（写文件时编码丢失），已按 UTF-8 重写并补上新按键说明；tools/scripts/play.cmd 头部注释同步更新；桌面 Bug修复与可行性评估.md 增加 Bug 5 章节（标题改为"5 个 Bug"）；先看这个.md 按键表补 1/2 余韵键。

遗留（下一步）：RTL osc_additive.v 目前完全没有包络，只有纯振荡器，所以这个 bug 在硬件上还不会出现 —— 但包络进 RTL 时必须把 RELEASE 由"按键抬起事件"驱动，而不是只在声部被抢占时进入。
- [2026-09-27 20:09] [工作记录] 架构数据核实与指标差距测算：DSP 24 而非 48、剩 37 天、无 .sdc、TDM 比全并行高 1~2 个数量级 — 对项目现状做了一次数据核实，更正了 3 处此前文档中的错误，并算出引擎架构（D2）的真实指标差距。

【已核实的事实（可复核，非推测）】
1. GW2AR-LV18 的 DSP 只有 24 个，不是文档 `06-架构决策框架-v2.md` 写的 48 个。来源：`src/gowin/osc_additive_synth/impl/pnr/osc_additive_synth.rpt.txt` 第 3 节 Resource Usage Summary，实际为 `Logic 371/20736`（19 LUT + 352 ALU）、`Register 391/15750`、`BSRAM 8/46`、`DSP 3/24`。
2. 今天 2026-09-27，死线 2026-11-04 18:00 → 剩 37 天。`12-课题要求覆盖清单.md` 里写的"剩 41 天"是 09-24 的旧数据，已过期。
3. 全项目**一个 .sdc 都没有**（只有 src/constr 下 3 个 .cst 管脚约束）。所以"时序收敛"不是"调优"，是完全没开始；此前说的"默认约束约 65 MHz"只是工具猜测值。
4. rPLL 公式之谜已解开（见 `src/gowin/bringup_9k/ip/gowin_rpll/gowin_rpll.v` 注释）：`fCLKOUT = fCLKIN×(FBDIV_SEL+1)/(IDIV_SEL+1)`，`fVCO = fCLKOUT×ODIV_SEL` 须落在 400–1200 MHz。108 MHz 的合法配置为 IDIV_SEL=0 / FBDIV_SEL=3 / ODIV_SEL=4（VCO=432 MHz）。108 MHz ÷2304 = 46875 Hz，÷72 = 1.5 MHz BCK，全整数无抖动。

【算出的架构差距（理论估算，未实测）】
全并行加法合成的真实瓶颈是**正弦表读口**（综合器按读口复制表，8 泛音 = 8 块 BSRAM），不是乘法器；46 块 BSRAM → 天花板约 46 泛音。三种架构的吞吐量（振荡器数 × 46875 Hz）估算：
- 现状 27 MHz 全并行 ×8 = 375,000 osc·Hz
- 全并行顶满 ~46 = ~2,160,000（5.8×）
- TDM @27 MHz（每样本 576 个时隙）= 13.5M–27M（36–72×）
- TDM @108 MHz（每样本 2304 个时隙）= 54M–108M（144–288×）
原因：全并行 8 套运算硬件在 576 拍里只用 1 拍（利用率 0.17%）；TDM 只需 1–2 块 BSRAM 放表，不再受读口限制。

【一个必须一起算的软天花板】
指标原文是「同时活跃**可闻**独立振荡器总数 × 实际音频输出采样率」。单个声部的可闻泛音数受 20 kHz 上限约束：220 Hz 音约 90 个、440 Hz 约 45 个、880 Hz 约 22 个。所以堆单声部泛音数没有意义，撑高数字必须靠声部数。可辩护的目标档：8 声部×32 泛音 = 256（12M，完全可闻）／16×32 = 512（24M）／32×32 = 1024（48M，需解释"32 个音同时响"）。

【与赛题要求的吻合点】
赛题 F1/R3 原文要求「支持测试模式下输出多路不同频率音频，频谱可观测对应数量独立谱峰」——所以"测试模式下 N 个独立谱峰"本身就是赛题要的验证方式，正好也是指标的证明方式。文档提过的"双模式（平时全并行、测试模式 TDM）"因此不是权宜之计。风险：评委可能追问"乐器平时只用 32 个振荡器，凭什么按 512 算"。

【包络的设计空间（5 个正交选择，尚未拍板）】
1) 挂在哪层：每泛音／每声部／分组。建议接口做成"每泛音"的形状、先只实例化"每声部"的数量。
2) 曲线：线性计数器（最省、与现有 Python 模型逐位一致）／一阶 IIR `env <= env + ((target-env)>>>k)`（一个加减+一个移位，天然指数，听感最好）／定点乘法／查表。
3) 更新率：每 64 样本（≈732 Hz）就够，且**不影响**"振荡器数×采样率"指标。
4) RELEASE 必须由按键抬起事件驱动，而不是只在声部被抢占时进入。
5) 参数走寄存器（可实时调），编译期常量则无法现场演示。
约束：任何包络实现都必须能镜像进 Python 模型，以保住"Python ≡ RTL 逐位一致"的验证性质。
- [2026-09-28 12:04] [工作记录] 交互维度实测：Python 侧 7 类可控量，RTL 侧 0 个运行时输入；4 个音色维度不等于赛题要的"演奏表情"维度 — 用户问"目前有多少个输入交互去决定一个音"。逐行核对代码后的实测清单（非估计）：

【Python 演奏器 = 7 类输入交互】
| # | 交互 | 影响 | 范围 |
|1| 15 个琴键 a s d f g h j k l ; / w e t y u | 音高 f0 | C4–E6 |
|2| Z / X | 八度 | −2 … +2 |
|3| 按键按下 / 松开 | 包络门（起音 / 释放） | 开 / 关 |
|4| [ / ] | 谱宽（参与发声的泛音数） | 1 … 8 |
|5| − / = | 谱心（泛音幅度衰减斜率） | 0.3 … 3.0 |
|6| , / . | 非谐度 | 0 … 1 |
|7| 1 / 2 | 余韵（包络衰减时间） | 0 / 4 / 2 / 1 / 0.5 / 0.25 s |
**写死不可调**：起音 6 ms、释放 200 ms、增益 1.0、幅度斜坡 10 ms。

【RTL = 0 个运行时输入】
`osc_additive.v` 名义上有 `inc_flat` / `amp_flat` 两个端口，但顶层 `osc_additive_top.v` 把它们接到了 **8 + 8 = 16 个编译期常量**上；顶层模块对外只有 `clk / rst_n / led / test`。**没有任何运行时控制入口**——改音高要重新综合。

【对照赛题】
- M1「≥2 个独立可控演奏维度」，判定方式是"现场演示可分别操控"→ RTL 侧 0 个，**完全未达成**。
- E2「≥3 维表情调控」→ 0 个。
- M6「单音实时变调」→ inc 是编译期常量，架构支持但没做。

【必须警惕的风险（已告知用户）】
现有 4 个音色维度（谱宽/谱心/非谐/余韵）**全都是"音色"维度**，而赛题 E2 原文举例的是「**力度动态、滑音**」这类**演奏表情**维度。这既是差异化（"塑谱"产品概念建立在此），也可能被评委判成"参数调节而非演奏维度"。
→ 建议至少补 1 个真正的演奏维度（力度或弯音/滑音），与音色维度搭配，"≥2 个独立可控"才守得住。
→ 力度在 Tang Nano 20K 上可行路径：**RC 充放电测时法（纯数字，零额外器件）**，本身也是技术亮点。注意 GW2AR **无 ADC**，不能用模拟采样。
- [2026-09-28 20:06] [工作记录] 分工定为方案 C；必须项 8.5 天计划落档；I2S 目标器件确认为 MAX98357A（免 MCLK 免 I2C） — 【用户拍板：分工 = 方案 C】
RTL 由 AI 实现；用户负责架构决策、产品定义、频谱曲线审美、验收、以及**答辩可辩护性**。用户自称"还没有足够合格的能力带你去实现更高更先进的项目"，已明确告知：这是正确分工，且选 C 不是降低天花板，是把瓶颈从"技能"换成"时间"。
**选 C 的必要条件（用户已知悉）**：决赛（11-20~22 南京）用户要一个人面对评委，所以每个模块必须配中文设计说明，做到"读完就能回答这块为什么这么写"；关键决策点要停下来问，不闷头写完。

【产出：`docs/02-技术方案/14-必须项实施计划.md`】
6 步 8.5 天，**全程不需要开发板**：
1. RTL ADSR 包络（1 天）→ M7 + F2 + 核心指标成立
2. 时钟架构 + 时序约束（1.5 天）→ 使 M4 可测，为 I2S 供时钟
3. I2S 发送器（1.5 天）→ M3 + M2
4. 多声部 + 混音 + 声部分配（3 天）→ M5 + M8；**★ 本步结束时产出 TDM 决策数据（8/16/32 泛音三档资源与时序曲线）**
5. RTL 内置测试模式（1 天）→ F1 + R3
6. 实时变调接口（0.5 天）→ M6
时间账：8.5 + 交互层 3 + 报告/视频/提交 6 = 17.5 天，剩 37 天 → 缓冲 19.5 天。
计划刻意不做：频谱参数化、TDM、物理建模、拓展项 E1–E8（都是天花板，等地板铺完）。

【三条设计纪律（贯穿全部步骤，属接口写法而非额外工作量）】
① 振荡器单元无状态（"给我 inc，还你一个正弦样本"，相位存哪由外层决定）
② 幅度来源可替换（常量 → 寄存器 → 参数化发生器，引擎一行不改）
③ 包络按"可时分复用的槽"设计（状态进/状态出）
合起来 = **状态与运算分离，且输入可替换**。成本约两小时接口思考，收益是 8.5 天后 TDM 的门还开着。

【I2S 目标器件已确认：MAX98357A（重要，之前是最大未知数）】
证据：`src/constr/tangnano20k.cst` 第 49–53 行（注释"MAX98357A I2S DAC + 功放"）、`docs/02-技术方案/02-硬件bringup-TangNano20K音频通路.md`。
- **不需要 MCLK**、**不需要 I2C 配置** → 省掉整个配置状态机，步骤 3 由 2 天下调为 1.5 天
- 支持 8 kHz–96 kHz → 46875 Hz ✅；BCK/LRCK = 32×（1.5 MHz / 46875）✅
- 使能：PA_EN（引脚 51）= SD_MODE，高电平有效
- **单声道**（D 类功放仅 1 路）→ 立体声效果需外接 DAC
- 官方 README 标注 "A bit loud" → 调试时先压低幅度，避免烧喇叭/扰民
- **新未知**：MAX98357A 内部有数字处理，存在固有群延迟，M4（≤10 ms）必须把它算进去 → 待查数据手册

【I2S 的验收方法：闭环自检】
写脚本把 I2S 串行流**解码回样本**，与源样本逐位比对。0 差异即证明整条输出通路，**不需要板子也不需要示波器**。这是本计划里最强的证据形式。

【时钟链（已验证推导）】
27 MHz → rPLL → 108 MHz（IDIV_SEL=0 / FBDIV_SEL=3 / ODIV_SEL=4，fVCO = 432 MHz ∈ [400,1200]）→ ÷72 = 1.5 MHz BCK；÷2304 = 46875 Hz 采样率。公式：fCLKOUT = fCLKIN × (FBDIV_SEL+1) / (IDIV_SEL+1)。

【已解决的历史悬置问题】
用户"内核比较激进"的印象来源已澄清：他读文档后认为"用大量 partial 合成"是有架构水平的事。已答复：复制不是架构，架构出现在"复制粘贴不管用"的那一刻（本设计约 46 泛音处）。
- [2026-09-28 21:40] [工作记录] 步骤0完成：释放曲线改指数并加 0 键 A/B；修掉"截止阈值导致 release_len 名不副实"的坑 — 完成用户批准的「步骤 0」：把模拟器的音符释放曲线从线性改成指数，并加现场 A/B 切换，让用户用耳朵拍板 RTL 包络的曲线。

【改动（tools/scripts/synth_engine.py）】
1. `Voice` 新增 `self.curve`（"exp" 默认 / "lin" 保留旧行为）+ `_calc_r_coef()`：`r_coef = 0.001 ** (1/release_len)`，即 release_len 个样本内衰到 -60 dB。新增 `set_curve()`。
2. `_env_block()` 的 release 段分两路：exp 走 `env * r_coef**arange(1,k+1)`；lin 保留原线性斜坡（供对比）。
3. `start_fast_release()`（声部抢占用）同步重算 r_coef。
4. 演奏模式新增 **`0` 键现场切换曲线**，状态栏显示"淡出=指数/线性"，`note_on` 时把当前曲线传给新声部。

【实测对比（fs=48000，松手后，分块取 max 换算 dB）】
| 松手后 | 线性(旧) | 指数(新) |
| 25 ms | −0.99 dB | −6.47 dB |
| 50 ms | −2.30 dB | −13.97 dB |
| 100 ms | −5.73 dB | −28.97 dB |
| 150 ms | −11.46 dB | −43.97 dB |
| 到静音 | 205 ms | 205 ms |
→ 指数 = 每 50 ms 稳定掉约 14 dB（听感均匀）；线性 = 前 100 ms 只掉 6 dB 然后一头栽下去（就是用户抱怨的"松开像被切断"）。

【踩坑并修复（可复用）】
指数截止阈值最初设在 `env < 1e-4`（-80 dB），导致释放实际拖到 **267 ms = release_len 的 1.33 倍**，`release_len` 名不副实，并让回归测试的静音窗口误判（假音频流里 peak>1 会被回调归一化到 1.0，所以只要非零就报 1.000）。
→ 改为 `env < 1.001e-3`（-60 dB），释放时长精确 = 200.0 ms（实测 9599 样本 vs 设定 9600），与线性一致。
**教训：渐进型（指数）包络必须显式定义"结束阈值"，否则参数名与真实时长不符；阈值应取 -60 dB 而非 -80 dB。**

【验证结果】
- `tools/scripts/test_play_release.py`：10 项断言全过（把第二次松手的静音窗口从 1.45–1.65 放宽到 1.48–1.68）
- `synth_engine.py verify`：仍是 **0 个样本差异**（包络不在比对范围内，符合预期）
- 桌面三个 demo WAV **故意未重出**——等用户听完 `0` 键定了曲线再一次性重新渲染交付
- 同步更新 `tools/scripts/play.cmd` 头部注释与桌面启动器 `★弹一弹（键盘实时演奏）.cmd` 的按键说明

【用户是否已试听并拍板】尚未回复。
- [2026-09-28 23:41] [工作记录] 修复"末尾截断感"：释放长度改为 3/4 键可调（默认 0.40s）+ 收尾阈值降到 -80 dB — 承接用户"末尾依旧有被截断的感觉"的反馈，完成诊断与修复（tools/scripts/synth_engine.py）。

【改动】
1. 新增模块常量 `ENV_CUTOFF = 1e-4`（−80 dB），替代原来写死的 −60 dB 收尾阈值；`_env_block()` 的指数分支改用它。
2. `Voice.__init__` 的 `release_s` 默认值 0.20 → **0.40**，并新增 `set_release_seconds(sec)`（同时重算 `release_len` 与 `r_coef`）。`release_s` 语义 = 衰到 −60 dB 的时间。
3. 演奏模式新增 `state["release_s"]`、`RELEASE_STEPS` 档位表、`bump_release()`，绑定 **`3`/`4` 键**；`note_on` 时把当前释放长度传给新声部；对已进入 release 的声部实时生效。状态栏新增"释放=0.40s"。
4. `banner()` 与 `tools/scripts/play.cmd` 头部注释、桌面启动器 `★弹一弹（键盘实时演奏）.cmd` 同步更新。

【测试改动（为消除对默认值的依赖）】
- 用例 1 改为**先按 4 次 `3`** 把释放压到最短档（0.10 s）再起音。注意：释放长度是在**建声部时**传给它的，所以参数键必须排在起音之前。
- 用例 1 各断言窗口整体后移并用大余量（响 [0.25,0.45]、静音 [0.75,0.90]、响 [1.05,1.25]、静音 [1.55,1.80]）。
- 用例 3（退化兜底）ESC 时刻 2.30 → 2.90 s，静音窗口改 [2.15,2.85]（默认释放变长后原来的窗口会被尾巴打中）。

【验证】
`python tools\scripts\test_play_release.py` → **10 项断言全过**（含"松手收声 / 自动重复抑制 / 余韵 / 退化兜底"）。
释放各档实测见同名 lessons 记忆。

【未做】
桌面三个 demo WAV 仍未重出——等用户听完 `3`/`4` 定了释放长度、并确定曲线后一次性重新渲染交付。

## 经验教训 Lessons Learned

- [2026-09-18 18:08] [经验教训] fpgachina.cn 官网情报抓取方法（API 签名 + PDF 解析 + 环境坑） — 抓 www.fpgachina.cn（FPGA创新设计赛道官网）的可行路径与踩坑记录：

【站点结构】dashboard.html?page=xxx 是 iframe 壳；真实页面是同目录下的 <name>-content.html（如 home-content.html / jssm-content.html / download-content.html）。jssm.html 等只是 meta refresh 跳转壳。

【接口需要签名】接口基址 http://www.fpgachina.cn/rest/pc。请求头必须带 lang: zh（值只能是 zh 或 en；zh-CN 会返回空字段）。GET 参数需签名：
- 取 params（去掉 null/空串），加 timestamp=Date.now()(毫秒)、nonce=16位随机字母数字
- 按 key 的 ASCII 升序拼 key=value&，末尾追加 key=<密钥>
- 密钥 defaultKey='kiHjr0YY2GXSu8FySitOKUiwRGmKwGaGFjc1Cm'（在 js/httpUtils.js 的 SignUtil 类里）
- MD5 后转大写即 sign，一并作为查询参数
已封装脚本：.site-probe/api.ps1（Get-Signed / Invoke-Api）。
常用接口：/cms/news/list、/cms/about/{id}（3=竞赛背景）、/cms/file/list、/cms/file/download/{id}（返回带签名的 OSS 直链）。

【环境坑】
1) PowerShell 5.1 的 Get-Content 默认按 ANSI(GBK) 读无 BOM 的 UTF-8 文件 → 中文全乱。必须用 [System.IO.File]::ReadAllText(path,[Text.Encoding]::UTF8)，并把 [Console]::OutputEncoding 设为 UTF8。Invoke-WebRequest 的 .Content 也会按 Latin-1 解码，应 -OutFile 后读字节再 UTF8 解码。
2) pip 直接安装失败（系统代理坏了：ProxyError Cannot connect to proxy），但 pypi 本身可直连。解法：用 Invoke-WebRequest 从 pypi 下载 whl，再用 python 的 zipfile 解包到本地目录，PYTHONPATH 指向它即可用（本机 Python 3.8.6，装了 pypdf 5.9.0 到 .site-probe/pylib）。
3) oss.fpgachina.cn 的 https 证书不受信任（握手失败）→ 把 URL 的 https 换成 http 可正常下载。

【产出物位置】.site-probe/ 下有：pdfs/（各厂商选题指南原文 PDF）、txt/（pypdf 抽取的纯文本）、about3.txt（竞赛背景）、news_*.txt（通知正文）、extract.py（PDF→文本）、docx_text.py（docx→文本）、api.ps1（接口调用）。
- [2026-09-18 18:28] [经验教训] 协作原则：架构决策权归用户 + Gowin EDA 选型结论 — 【重要协作原则 — 用户明确要求】用户不接受"先给框架让他照做"的协作方式。原话："这个项目的设计 我不会完全依赖你 整个项目的架构等等设计 我需要通过我自己的技术理解来拍板决定 而不是你先给一个框架让我照做就行（如果是那样的话我直接将这个设置为自动任务就行了）"。

→ 因此：**架构决策权归用户**。我的角色调整为"提供决策所需信息 + 执行用户决定 + 逐行讲解原理"，而不是"设计架构 + 布置作业"。
→ 具体做法：遇到技术选择时，列出选项、各自代价/收益、赛题规则如何影响该选择，让用户拍板；用户拍板后再实现。不要先写完整框架再让用户填空。
→ 理由（也是说服用户的论点）：决赛有专家提问环节，架构若不是自己想清楚的，问"为什么这么分声部""为什么相位位宽选24位"就答不上来。

【Gowin EDA 选型结论】教育版 vs 商业版差异（官网 2026-09-18）：教育版 V1.9.11.03 / 422MB / **无需 License** / 不绑定 / 仅限教育科研非盈利；商业版 V1.9.12.03 / 530MB / **需申请 License**（免费但需提交 MAC 地址，审核 1-3 工作日邮件发放）/ 期限 1 年 / **绑定本机 MAC，一套只能一台电脑**。
建议：**先装教育版**——零等待、零绑定风险、GW2AR 是老器件教育版必支持（Sipeed wiki 入门教程即基于教育版；且教育版 V1.9.11.03 已支持 GW5AT-60K）、竞赛属教育用途合规。这是可逆决策（不行再换），而先申请商业版是不可逆的 1-3 天等待。
下载页：教育版 https://www.gowinsemi.com.cn/software/3 ，商业版 https://www.gowinsemi.com.cn/software/1 。
需下两个包：云源软件教育版 + 云源编程器教育版（后者烧录用，别漏）。安装路径不要有中文和空格。
验证成功标准：新建工程时器件列表能找到 **GW2AR-LV18QN88C8/I7**。
文档：docs/02-技术方案/04-Gowin-EDA安装选型.md
- [2026-09-18 22:04] [经验教训] 用户澄清：要的是灵感不是审校 + 12 个乐器概念灵感库 — 【重要：用户澄清需求（2026-09-18）】用户原话："不是文档冲突 我是单纯的没灵感想让你给我一篇 找找灵感"。
→ 澄清：上一轮他要的不是"审校/冲突分析"，而是**灵感**。我上一轮把重点放在了文档冲突声明上，跑偏了。
→ 需求本质：**他目前没有灵感，需要一份概念素材来找感觉**。他此前也说过"我的直觉与野心暂时太大了，想先了解更多信息和技术让这些直觉落地"。
→ 对我（Agent）的要求：这个阶段该给的是**广度与启发**，不是深度与工程严谨。不要把创意阶段当成设计评审阶段。

【已交付：概念灵感库 docs/02-技术方案/08-概念灵感库.md】
12 个电子乐器概念，按四根轴组织：
- **轴一 换身体动作**：①「呼吸」手的高度控制"存在感"（高次泛音依次加入/退场）②「重力」倾斜板子=音的重量 ③「双人」一台乐器两人演奏/互相干扰
- **轴二 换映射隐喻**：④「不完美」把"电子乐器不好听"的病根做成可演奏维度（完美度从机器滑向生物，几百路独立LFSR微扰）⑤「时间」包络时间尺度可拉伸（同一个音色可以是鼓也可以是云）⑥「泛音阶」泛音不是音色而是音阶（蒙古喉音/口弦琴）
- **轴三 换可演奏对象**：⑦「群」一个音=8~16个微失谐副本，"一个"与"一群"之间连续滑动 ⑧「回声织机」演奏空间而非声音，几十条并行延迟线 ⑨「共振体」模态合成，敲哪里决定音色
- **轴四 换美学立场**：⑩「谱面」LED频谱就是键盘，所见即所触 ⑪「有限」把资源有限做成作曲规则 ⑫「数字」把数字性当美学（chiptune/比特破碎）

【还给了】①组合器：四根轴（动作/对象/隐喻/立场）交叉生成新概念的方法，附组合示例表；②陷阱清单（粒子合成会踩预录红线、纯手势空气琴演示翻车、带屏幕UI让注意力离开乐器、"AI生成音乐"引发质疑、追数字本身没意义、堆效果器）；③一句话判据："别做能发声的东西，做一件你按下第一次之后还想按第二次的东西——你自己愿意在没人的时候玩它吗？"；④说明所有概念都天然满足赛题要求（不用担心合规性，先选想做的）。

【我的私心推荐（已标注供参考可无视）】「不完美」+「群」的组合：纯FPGA强项、直击电子乐器不好听病根、极易被听懂、手工量近零、且有哲学上的漂亮——用最数字的硬件模拟最不数字的东西。

【教训】上一轮我把"用户要灵感"误读为"用户要设计评审"，做了 21 个维度的完整工程方案 + 6 处冲突声明。虽然内容有价值（用户未否决），但**方向偏了**。以后遇到"给我想法/找灵感"类需求，应先给广度再问是否需要深度。
- [2026-09-18 22:05] [经验教训] 交付新文档须标注路径与既有文档关系（07 与 08 是互补而非取代） — 【结论】docs/02-技术方案/07-候选架构方案-v1.md（「塑谱 Spectra」）**未被 08 取代，仍然有效**。两份文档用途不同、互为补充：
- 07 = **一个**方案的完整推演（21 部分，含产品定义/交互/合成/时钟/数值/资源/验证/47天计划/20项风险/7条RedTeam），供批判修改
- 08 = **12 个**概念的菜单（每个只讲"手做什么/为什么有意思/FPGA干嘛/代价"），供找灵感、挑选、组合
用户曾一度以为 07 "不见了"，实际是它在上一轮回复里没有出现在显眼位置。

【可复用经验】交付新文档时必须显式给出：①完整路径 ②它与此前交付文档的**关系**（取代/补充/并列/归档）。仅写"已创建"而不说明关系，会导致用户误以为旧文档被替换或丢失。
本项目已出现过同类问题：v1→v2 决策框架、P0-P5→Phase0-8 两份计划，都存在"新旧并存但关系未标注"的情况（后续已用 archive/ 目录与冲突声明处理）。

【当前技术方案文档谱系（稳定事实）】docs/02-技术方案/ 下：
01 开发方案与里程碑｜02 硬件bringup-TangNano20K音频通路｜03 乐器形态方案建议（其"先引擎后外形"主张与 07 的"定位先行"存在方法论张力，07 已声明）｜04 Gowin-EDA安装选型｜05 Gowin-EDA安装记录｜06 架构决策框架-v2（D0~D8 决策权在用户）｜07 候选架构方案-v1｜08 概念灵感库｜archive/06-架构决策清单-第1批-v1.md（已归档）。
- [2026-09-21 12:35] [经验教训] Gowin/Tang Nano 9K 实战踩坑集：Bank3 1.8V、SSPI 释放、gw_sh 批处理、PS1 编码 — 【坑1 — Gowin Bank 3 VCCIO 固定 1.8V】Tang Nano 9K 的 Bank 3（引脚 3、4、10、11、13、14、15、16）VCCIO 被锁在 1.8V。在这些脚上写 `IO_TYPE=LVCMOS33` 会让 PnR 直接报 `ERROR (CT1136): Bank 3 vccio(1.8) is locked by other constraint or embedded port`。→ 官方 led 例程故意不写 IO_TYPE，照抄（只写 PULL_MODE/DRIVE）。引脚报告里这些脚显示 LVCMOS18。
【坑2 — RP2017 / SSPI 专用脚】引脚 54/55/56（本设计用作 LCD 的 B0/G5/G4）默认是 SSPI 从机配置专用脚，不释放会报 `ERROR (PR2017): ... is a dedicated pin (SSPI)`。解法：`set_option -use_sspi_as_gpio 1`（命令行）或 `Project → Configuration → Place & Route → Dual-Purpose Pin → 勾 Use SSPI as regular IO`。⚠️该选项会持久化到 `impl/<工程名>_process_config.json`（写为 `"SSPI": true`），所以 IDE 里直接编译也通。释放 SSPI 不影响 JTAG 烧录，也不影响从板载 Flash 启动（那走 MSPI）。官方 wiki 驱屏教程明确提到这一步。
【坑3 — `cell` 是 Verilog-2001 保留字】`wire [3:0] cell = ...` 会报 `Syntax error near 'cell'`。改名即可。
【坑4 — gw_sh 批处理流程（重要工具知识）】Gowin 命令行编译用 `<GowinHome>\IDE\bin\gw_sh.exe <script.tcl>`，脚本三步：`open_project "xxx.gprj"` → `set_option ...` → `run all`，产出 `impl/pnr/<顶层名>.fs`。**工程选项不在 .gprj 里**（.gprj 只有器件+文件列表），必须用 set_option 传。set_option 全部选项名查本地 `IDE\doc\CN\SUG100-*_Gowin云源软件用户指南.pdf` §8.3.19（猜名字会浪费大量时间，直接查文档）。.gprj 里的文件路径支持 `../../` 相对路径。
【坑5 — PowerShell 编码】本机 harness 的 shell 实际是 **Windows PowerShell 5.1**（不是 PS7，且 PATH 里没有 pwsh）。含中文的 .ps1 必须存成 UTF-8 with BOM，否则按 GBK 解码出语法错（write 工具写出的是无 BOM，需用 [System.IO.File]::WriteAllText + UTF8Encoding($true) 转一次）。
【流程经验 — 烧录前的分阶段验证】第一次烧板子不要直接烧自写码流：先烧官方出货验证过的 .fs（点灯→再驱屏），把"线/驱动/板子/工具链"一整类问题排除掉，再烧自写码流。否则不亮时无法区分是代码问题还是硬件问题。烧录优先用 SRAM Program（掉电即失，零风险），确认正常后再固化 Flash。
- [2026-09-21 12:41] [经验教训] 「亮白光」= 空片 FPGA 的预期现象，不是屏坏；反过来可证 40P 排线已插好 — 【现象】Tang Nano 9K 通电、40P 排线接上 Sipeed 4.3 寸屏后，屏幕呈**纯白**（实测于 2026-09-21）。

【判读 — 可复用】背光与图像信号是**两条独立通路**：
- 背光从 40P 排线的**电源脚**直接取电 → 板子一通电背光就亮，**与 FPGA 是否已配置无关**。
- 此时 FPGA 若为空片（未烧任何码流），IO 处于浮空 / 弱上拉状态 → RGB 数据线全被拉高 = 全 1 = 最亮 → 面板显示**纯白**。
→ 结论：**"背光亮"不等于"屏幕在工作"**，也不能用来判断码流是否烧进去了。唯一可靠判据是**屏幕上有没有图像内容**（彩条 / 边框 / 计数条）。

【反向价值（这是正面证据，不是故障）】背光能亮 ⇒ 排线已把电源送到面板 ⇒ ①40P 排线插到位了 ②方向大概率正确（官方警告插反可能不出图甚至伤屏；插反时背光通常不会亮）③面板本体与背光未损坏。

【操作约束】既然排线是当时唯一"已确认插对"的连接，**不要反复拔插排线去"试试看"** —— 那会把唯一确定的变量重新变成不确定。

【对照参考】官方仓库 `.assets/lcd_4.3_colorbar.jpg` 是同一块屏正常显示彩条的实拍照片（有图像内容），可用来对照"什么是正常的"。

【适用范围】本判读针对「背光直接取电、无独立 BL 使能」的 RGB 屏 + 空片 FPGA 组合。若某面板的背光由 FPGA 引脚使能，则本判读不适用。
- [2026-09-21 12:59] [经验教训] 设备问题代码 28 的排查法：读 setupapi.dev.log 定性；libwdi 是红鲱鱼；Gowin 命令行烧录命令 — 【一、Windows 设备「问题代码 28 / CM_PROB_FAILED_INSTALL」的正规排查路径】
本次现象：Tang Nano 9K 的调试器（VID_0403&PID_6010，FTDI FT2232 双通道，设备自报字符串 "JTAG Debugger"）两个接口都是 Status=Error、ProblemCode=**28**。

排查该问题的**决定性证据源**是 Windows 的设备安装日志：
```
C:\Windows\INF\setupapi.dev.log
```
它会逐条记录 INF 段落安装、服务创建、设备启动的每一步与退出码。本次从中读到：
- `FtdiPort.NTamd64` 段安装、`Add Service: Created service 'FTSER2K'`，段落 `[Exit status: SUCCESS]`
- 但紧接着 `Device Status: 0x01802400 [0x1c - 0xc0000490]`（0x1c = 28）
→ 即**驱动段安装成功、设备仍启动失败**，据此可知问题不在"缺驱动"。

配套用法：
- 查驱动仓库里到底有没有可用驱动：`pnputil /enum-drivers`（关注 Published Name / Original Name / Provider / Driver Version / Signer Name）
- 查设备问题码：`Get-PnpDeviceProperty -InstanceId <id> -KeyName DEVPKEY_Device_ProblemCode`
- 查问题设备汇总：`pnputil /enum-devices /problem`
- 本次驱动包实际存在且 WHQL 签名正常：`oem132.inf = ftdibus.inf`、`oem133.inf = ftdiport.inf`，Provider **FTDI**，v**2.12.36.20**，Signer = Microsoft Windows Hardware Compatibility Publisher。

【二、一个已排除的红鲱鱼（避免下次误判）】
驱动仓库里有 `oem131.inf = usb_device.inf`，**Provider 是 `libwdi`**（即 Zadig / libusb 装 WinUSB 驱动的工具留下的）。看上去很像"被 Zadig 抢走了驱动"，但读 INF 内容发现它匹配的是 **`VID_33AA&PID_0120`（DeviceName = "GWU2X"）**，那是**高云自家的另一种下载线**，与本设备的 VID_0403&PID_6010 **无关**，且当时未绑定任何设备。
→ 结论：**看 Provider 名字就下判断会误判，必须读 INF 里实际匹配的 Hardware ID。**

【三、Gowin 驱动安装包的形态（供将来需要时参考）】
- 安装目录里**没有散装的 .inf/.cat/.sys**，驱动只存在于 `Programmer\driver\GowinUSBCableDriverV4/V5_for_win7+.exe` 内。
- 该 exe 是 **NSIS** 打包（读文件头可判定），本机无 7-Zip 时无法直接解包，需运行安装（要管理员/UAC）。

【四、Tang Nano 9K 上板烧录的可复用命令与参数】
```powershell
$env:GOWINHOME="D:\FPGA-Project\Gowin\Gowin_V1.9.11.03_Education\Gowin_V1.9.11.03_Education_x64"
& "$env:GOWINHOME\Programmer\bin\programmer_cli.exe" --scan-cables                       # 找下载器
& "$env:GOWINHOME\Programmer\bin\programmer_cli.exe" --device GW1NR-9C --scan             # 扫 FPGA
& "$env:GOWINHOME\Programmer\bin\programmer_cli.exe" --device GW1NR-9C `
      --operation_index 2 --fsFile "<绝对路径>.fs"                                        # SRAM 烧录
```
- `--operation_index`：2 = SRAM Program（**首选，掉电即失、零风险**）、4 = SRAM Program+Verify（**避免**，会卡/极慢）、8/9 = exFlash（固化，确认无误后再用）。
- 器件填 `GW1NR-9C`；下载频率自动 2.5MHz。
- 退出码 0 = 成功。实测 2.9 秒完成。

【五、背面教训】本机 pwsh 实际是 Windows PowerShell 5.1；`Get-PnpDevice -PresentOnly` 与不过滤的 `Get-PnpDevice` 结果不同 —— **未识别的/有问题的设备用 `-PresentOnly` 可能被过滤掉，排查"设备根本没出现"时两个都要跑**。
- [2026-09-21 16:00] [经验教训] 可复用经验：接口传相对坐标、显示要验几何、BSRAM 按打包位宽算、$readmem 静默陷阱、PS5.1 抓 stderr — 【一、模块接口：坐标必须传"有效区相对坐标"】
把行场计数器的原始值当像素坐标交给下游模块，会让整个画面偏移、且边界元素画在消隐区里**永远不可见**。
接口应传**有效区相对坐标**（已减 H_BP / V_BP），让客户模块根本不需要知道消隐有多少拍。
适用范围：任何"时序发生器 → 图案/绘图模块"的接口设计。

【二、显示类问题不能只验证"顺序"】
坐标偏移 bug 的**色条顺序完全正确**，只有宽度和边框位置是错的。
→ 排查显示问题必须同时查两件事：**顺序**（颜色映射对不对）+ **几何**（各段宽度是否相等、边界元素是否贴边）。
只用"颜色对不对"验收，会放过这一类 bug。

【三、BSRAM 容量账要按"可打包位宽"算，不能只看总位数】
GW1NR-9：26 块 × 18,432 bit = **479,232 bit** 理论总量，但打包效率取决于数据位宽能否整除块字宽（36 bit）：
· 3 bit/像素 → 12 像素/块字 = 100% 效率 → 实测 131072 深的 ROM 占 **24 块**
· 4 bit/像素 → 480×272 需 522,240 bit → **超上限，装不下**
**结论：480×272 在这块芯片上最高只能 3bpp（8 色）。** 想提升画质只能换存储介质（板载 64 Mbit PSRAM / 32 Mbit SPI Flash），需另写控制器。

【四、Gowin `$readmem*` 的两个静默陷阱（GW1NR-9C 实测）】
1. **数据宽度必须与存储器位宽严格一致**。用 `$readmemh`（1 字符 = 4 bit）给 3 bit 宽的存储器加载，Gowin 只报一条不起眼的 `WARN (EX2526): Entry size 4 ... does not match memory width 3`，然后**静默丢弃全部内容** —— 存储器虽被识别（日志里有 `Extracting RAM`），但没有初值，整个 ROM 被优化掉（资源表 BSRAM 显示 **0 块**），极易误判成"Gowin 不支持 readmem"。改用 `$readmemb` 每行 3 个二进制字符后正常。
2. **测试存储器推断时，绝不要用能被地址推导出来的规律数据**（如 `mem[i] = i % 8`）。综合器会常量传播把整个 ROM 消掉，让你以为"推断失败"，其实是测试用例本身没意义。

【五、Windows PowerShell 5.1 抓外部程序输出的坑】
本机 shell 实际是 **Windows PowerShell 5.1**（PATH 里没有 pwsh）。
`& exe args 2>&1 | Out-String` 在外部程序写 stderr 时会抛 **NativeCommandError**，**哪怕程序运行完全正常**（gw_sh 就会写 stderr）；临时改 `$ErrorActionPreference` **压不住**。
可靠做法：`Start-Process -RedirectStandardOutput/-RedirectStandardError <文件>` 再读文件——两个流在操作系统层就分开了。
另：含中文的 .ps1 必须存 **UTF-8 with BOM**。

【六、判断屏幕方向不能靠照片】
手机前置摄像头会自动镜像、照片也可能被旋转 180°。本轮据照片量出"色条顺序反了"并据此误判画面被镜像，白做一轮实验（真因是坐标偏移 bug）。
**正确做法**：在画面上放两个不可能认错的标记（左上大黑方块 + 右下小白方块），让人眼直接判定；
`(x,y)` 平面的四种变换（正常 / 水平镜像 / 垂直翻转 / 旋转180°）被两个方块的位置唯一区分。
补充：照片里的**几何比例信息**（如各色条宽度比）比颜色顺序更可靠——本轮那个 3:1 的宽度差其实已经指对了方向，只是被误归因成成像 artifact。
- [2026-09-21 17:38] [经验教训] cmd 长命令防错：读报错先核对拼写、set 引号要包住整个赋值、优先给脚本而非让用户手打 — 【现象】用户手打长路径时把 `programmer_cli.exe` 打成 `prgrammer_cli.exe`（少一个 `o`），cmd 报：
```
'"D:\...\Programmer\bin\prgrammer_cli.exe"' 不是内部或外部命令，也不是可运行的程序或批处理文件。
```

【怎么读这个报错】`'...'` 里的**单引号是 cmd 的固定格式**，内容才是**它实际尝试运行的程序名**。
→ **对策：拿到这个名字直接去核对拼写**，不要先怀疑环境/权限/路径。
cmd 的报错**不会直接说"你拼错了"**，只说"找不到"，极易让人往错误方向排查。

【cmd 的 `set` 引号陷阱】
```cmd
set PC="D:\...\programmer_cli.exe"     ← 错：引号本身被存进变量
set "PC=D:\...\programmer_cli.exe"     ← 对：引号只包住赋值，不进变量
```
前者会让 `%PC%` 展开成带引号的字符串（报错信息里的名字外面套着双引号就是这么来的）。路径无空格时常常还能跑，但一旦出错会非常难读。

【通用对策：不要让手指承担机器该记的东西】
- 短名字 → **Tab 补全**（cmd 里打 `prog` 按 Tab 会自动补成 `programmer_cli.exe`）
- 长路径 → 交给**变量**或**脚本**
- 重复流程 → **包成一条命令**（本项目已有 build / make_image_rom / flash_sram 三条）

【适用范围】以上针对 **Windows cmd**。PowerShell 的引号与变量规则不同（`$var` vs `%var%`），本机默认交互 shell 是 **Windows PowerShell 5.1**，但用户自己的终端习惯是 **cmd**（Windows Terminal 的 cmd profile），给命令时要想清楚他在哪个 shell 里跑。
**给用户长命令时，优先直接提供脚本，而不是让他手打。**
- [2026-09-22 22:03] [经验教训] 安装与自动化踩坑：Inno Setup 绕不过 UAC、GUI 子进程占管道、.v 文件不能有 BOM（.ps1 反而必须） — 【一、Inno Setup 安装包绕不过提权 —— 不要浪费时间尝试绕过】
iverilog v14 是 Inno Setup 打的包。**非提权的三条路全部失败**：
- `/VERYSILENT /SUPPRESSMSGBOXES /NORESTART /DIR=...` → 进程挂起等 UAC，**180 秒超时**（未提权时 Inno Setup 会拉起 UAC 并等待）
- `/CURRENTUSER` → **退出码 1**（该开关只在构建时设了 `PrivilegesRequiredOverridesAllowed` 才有效）
- `winget install --scope user` → "找不到适用的安装程序"
**结论：这类安装包必须由用户点 UAC，这是设计使然。**
→ 我该做的分工是：**把安装包下载好、校验好、给出确切路径，让用户双击**；而不是反复尝试绕过提权。本次用户自己装成功了（装到 `D:\iverilog`）。

【二、GUI 子进程会占住输出管道（自动化验证 GUI 程序时的通用坑）】
`start "" gtkwave.exe xxx.vcd` 拉起的 GUI **继承了父进程的 stdout**。如果调用方把输出接进管道或文件（如 PowerShell 的 `| Out-String`），**管道在 GTKWave 关闭前不会结束** → 捕获端一直等。
本次现象：`sim.cmd` 调用**超时 300 秒**，但**仿真其实早已成功跑完**（超时是假象）。
**解法**：脚本里加开关跳过 GUI 启动（本项目 `sim.cmd` 用 `SIM_NOWAVE=1` 环境变量）。
**适用范围**：任何"脚本里拉起 GUI 程序 + 捕获输出"的场景。

【三、BOM 陷阱 —— 同一台机器上两种**相反**的要求，别混淆】
- 含中文的 `.ps1` **必须**存 UTF-8 **with BOM**（否则 Windows PowerShell 5.1 按 GBK 解码 → 语法错）—— 已知
- 喂给 **iverilog 的 `.v` 文件不能有 BOM** —— PowerShell 5.1 的 `Set-Content -Encoding UTF8` **会加 BOM**，iverilog 解析不了文件开头的 BOM，报 **`Unknown module type: xxx`**
  ⚠️ **它表现为"模块找不到"，而不是"编码错误"，极易误判成路径/文件名问题**
  解法：`[System.IO.File]::WriteAllText($p, $text, (New-Object System.Text.UTF8Encoding($false)))`
  自检方法：读前 3 字节，`EF BB BF` = 有 BOM

【四、winget 非交互使用的必要参数】
非交互环境下 `winget search/install` 会**卡在 msstore 源协议确认**上（读不到输入 → 报 `0x8a150042`）。
必须加：`--source winget --accept-source-agreements --disable-interactivity`（install 还需 `--accept-package-agreements`）。

【五、本机"安装类操作"的分工经验（可复用）】
| 我能做 | 必须用户做 |
|---|---|
| 下载、校验（大小/哈希）、静默安装（**当且仅当**不要求提权，如 Gowin 的 NSIS 包）、写配置、建脚本、跑验证 | **点 UAC**、插拔线缆、按键、看实物（屏幕/灯） |
→ 遇到需要提权的安装，**最省时间的做法是：我把包下好 + 给确切路径 + 说明要装到哪，让用户双击**。
- [2026-09-23 19:43] [经验教训] 方法论：我不操作软件而是运行命令——GUI是外壳、内核是CLI；能力边界与"找配置文件优先于求助用户" — 【核心：我不"操作软件"，我"运行命令"】
- **GUI 程序** = 画窗口 + 等鼠标点击 → 我看不见、点不到
- **CLI 程序** = 读命令行参数 + 把文本写到 stdout → **我完全能用**
**关键事实：绝大多数工程软件的 GUI 只是外壳，内核是命令行程序。**
例：Gowin IDE 的窗口底下是 `gw_sh.exe` + `GowinSynthesis.exe` + 布局布线引擎 + `programmer_cli.exe`。
→ **绕过外壳直接调内核，就是我的全部"秘密"。不是模拟点鼠标，是喂脚本。**

【我的工作循环（就这一件事）】
发一行命令 → 操作系统启动进程 → 进程把结果以**文本**写 stdout → 我读到文本。
**没有鼠标、没有屏幕、没有图像识别。**
我判断"编译成功"不是看到绿色对勾，而是读到自己脚本打印的 `== 编译成功`；判断"仿真通过"是读到 `[PASS]`。

【能力边界（必须对用户讲清，避免过度承诺）】
| 我能 | 我不能 |
|---|---|
| 运行**任何有 CLI 的程序** | 点按钮、拖窗口、看图形界面 |
| 读写文件 | **看用户的屏幕**（除非用户拍照给我） |
| 读程序的文本输出 | 插拔线缆、按板子上的键 |
| 通过 USB/JTAG 与硬件通信 | **点 UAC** |
特别说明：**点不了 UAC 不是技术缺陷，是操作系统的安全设计** —— UAC 弹窗存在的全部意义就是"必须有一个真人同意"。绕过它等于绕过安全边界，那是不该做的事。
→ 装软件时的正确分工：**我下载 + 校验 + 给确切路径，用户双击。**

【对"你能做什么"的准确回答模板】
用户问"你能写 Verilog + 仿真 + 综合出 bitstream + 传进硬件吗" → **能，2026-09-21 全都实际做过**：
写 Verilog（写文件）→ 仿真（iverilog / vvp / gtkwave）→ 综合+布局布线（`gw_sh` + Tcl 脚本）→ 生成 `impl/pnr/*.fs` → 烧录（`programmer_cli` 走 USB/JTAG）。
**唯一需要用户的是：插线、按键、看屏幕、点 UAC。**

【适用范围】
以上适用于**任何有 CLI 的工程软件**。若某功能**只有 GUI 入口**（例如某些厂商的 IP 向导界面、部分调试工具的图形视图），我就无法直接操作，只能：① 找它的 CLI 或配置文件替代（如 Gowin 的 `.ipc`/`.mod` 就是 IP 配置的文本形式）；② 或写步骤让用户点。
**遇到"只能点界面"的功能时，第一反应应该是去找它的配置文件或命令行开关，而不是直接求助用户。**
- [2026-09-23 21:41] [经验教训] Vivado 无法编译高云芯片（硬约束）+ Vivado到Gowin对照表 + 9/22报名截止时间风险 — 【工具链硬约束确认（2026-09-18）】用户想改用 Vivado（因为觉得 Gowin 工具不好用、只看过 Vivado 教程）。核对后确认以下事实，**已向用户说明**：

【决定性事实】**Vivado 只支持 AMD(Xilinx) 自家芯片，无法编译高云的 GW2AR-18C**。用户选的是高云选题二、板子是 Tang Nano 20K（GW2AR-18C），Vivado 根本不认识这颗芯片。这不是"哪个好用"而是"能不能用"的问题。反之 Gowin EDA 也不能编译 Artix-7/Zynq。

【纠正的误会】**需要"申请"的是 Vivado 而不是 Gowin**：高云教育版**不需要 license**（已装好并验证）；Vivado 需要免费 AMD 账号才能下载，且安装体积 20–50 GB（当前 D 盘剩 39.8 GB、C 盘 6.7 GB）。

【磁盘变化记录】C: 从 2.6 GB → 6.7 GB；D: 从 53.6 GB → 39.8 GB（用户可能移动过文件，原因未确认）。

【关键洞察（用于解决用户真实痛点）】**Verilog 是通用语言，不是 Vivado 的**。用户完全可以用 Vivado 教程学 Verilog，再把代码放进 Gowin 综合——我们需要的语法 95%+ 通用。差异只在：约束文件(.xdc vs .cst)、IP 核(Clocking Wizard vs rPLL)、工具操作步骤、板级引脚号。我们项目只需要 rPLL 一个 IP，其余（ROM/乘法器/FIFO）都可靠代码推断，这部分完全通用。

【已交付工具】docs/03-学习路线/02-Vivado到Gowin对照表.md —— 含工程文件对照、约束语法转换（set_property PACKAGE_PIN → IO_LOC；注意 Gowin 引脚是纯数字封装编号，与 Vivado 的行列坐标如 W5 体系完全不同不可互推）、IP 对照、工具操作对照、看 Vivado 教程时"可直接吸收/要打标记/可跳过"三类章节清单、Tang Nano 20K 关键引脚（clk=4、rst=87、PA_EN=51、HP_DIN=54、HP_WS=55、HP_BCK=56）、Gowin 中文学习资源（高云B站空间1930822744、Sipeed wiki、以及本机 D:\FPGA-Project\Gowin\...\IDE\doc\CN\ 下 20+ 份官方中文手册——离线可用无需申请）。

【⚠️ 时间敏感风险（已提醒用户）】报名截止 **2026-09-22 24:00**，而用户 **9/24** 才回来。若切换赛道（高云→AMD）需要修改报名信息，这个窗口会在用户回来之前关闭。且切到 AMD 赛道还需一块 AMD 板子（PYNQ-Z2 约¥1000+，或便宜 Artix-7 板 ¥200-500）。**建议用户今天就登录官网确认报名信息能否修改、截止到何时。**

【三条可选路径（已给出）】A 用 Vivado 教程学 + Gowin 实现（推荐，零成本、不换板、不换赛道）；B 换到 AMD 赛道 + 装 Vivado（需 AMD 板子 + 可能已过改报名窗口）；C 双轨（性价比低）。等用户决定。
- [2026-09-27 20:02] [经验教训] Python 控制台键盘读不到"松开"事件：msvcrt.getch() 的坑与 ReadConsoleInputW/CONIN$ 正解 — 现象：FPGA-Music-project 的实时演奏模式（tools/scripts/synth_engine.py cmd_play）弹一下音频就一直响。

根因链：声部状态机 attack→sustain→release→done 本身没问题，但 release 只有主动调 start_release() 才进入；演奏模式里唯一调它的是"超过 4 声部时的抢占"。再往下追，键盘用的是 msvcrt.getch() —— **只在按下时返回字符，松开时什么都不返回**，所以"松手收声"根本无法实现。

正解（Windows 控制台）：
1. 用 ctypes 调 kernel32 的 ReadConsoleInputW / GetNumberOfConsoleInputEvents，读 INPUT_RECORD；KEY_EVENT_RECORD 里有 bKeyDown（按下 True / 松开 False）和 wRepeatCount。
2. **不要用 GetStdHandle(STD_INPUT_HANDLE)**：stdin 被重定向成管道/文件时它不是控制台句柄，GetConsoleMode 报 ERROR_INVALID_HANDLE(6)。用 CreateFileW("CONIN$", GENERIC_READ|GENERIC_WRITE, ...) —— 永远指向本进程真正的控制台输入缓冲区，已验证在 stdin 被重定向时仍可用（GetFileType=2）。
3. ctypes 结构体布局已验证：sizeof(KEY_EVENT_RECORD)=16、sizeof(INPUT_RECORD)=20、KeyEvent offset=4、uChar offset=10。
4. 必须保存并在退出时恢复 GetConsoleMode 原值（会关掉 LINE_INPUT/ECHO_INPUT/PROCESSED_INPUT）。
5. 必须忽略系统自动重复（按住键约 30 次/秒重复发按下），否则几秒就打满声部上限。
6. 退化兜底：拿不到松开事件时用固定时长自动收声，绝不能留"永远不停"的路径。

测试方法（可复用）：不依赖真人按键 —— 用"按时间轴回放的假按键读取器" + "假 sounddevice 在后台线程驱动真实音频回调"，逐块记录输出峰值做断言。见 tools/scripts/test_play_release.py，并用变异测试（把 start_release 换成空函数）确认测试真能抓到 bug。

★ 写这类假音频设备时有个陷阱：不能用 time.sleep(block/fs) 定速（Windows sleep 粒度会让线程跑到 ~68% 实时），否则"音频时间"和"墙上时间"错位，按秒断言的窗口全错。要按累计样本数对齐：target = t0 + n/fs，然后 sleep 到 target；标记也用 n/fs 而不是 time.time()。
- [2026-09-27 20:35] [经验教训] 包络实测：现在是 ASR（6ms起音+满幅延音+200ms线性释放），不是 ADSR；线性淡出听感像硬截断，应改指数 — 问题起点：用户反馈"按下去就响，松开就马上截断"，怀疑没有包络。实测后确认——**有包络，但形状错了，且不是 ADSR**。

【澄清：三个层的真实状态】
- Python 模拟器（synth_engine.py 的 Voice）：**有**包络，但只是最简 **ASR** —— 起音 6 ms → **满幅**延音 → 释放 200 ms **线性**。
- RTL osc_additive.v：**完全没有**包络，振幅是写死常量 amp_flat。（注意不要把这两层混为一谈）

【实测曲线（fs=48000，松手之后）】
t=5ms → −0.10 dB ; 25ms → −1.04 dB ; 50ms → −2.50 dB ; 100ms → −6.02 dB ; 150ms → −12.04 dB ; 180ms → −20 dB ; 200ms → 归零硬停。
**前 100 ms 只掉 6 dB（人耳几乎察觉不到），后 50 ms 掉 26 dB** —— 这就是"松开像被一刀切"的数学原因：一半时间听着没变化，然后一头栽下去。

【可复用的听觉规律】
人耳响度感知是对数的，所以：
- **线性幅度淡出 = 前松后紧**，听感像开关（gate）。
- **指数淡出 = 每秒固定掉多少 dB**，听感均匀自然；钢琴/钟/吉他等自然衰减全是这个形状。
  -60 dB / 200 ms 的指数：25ms→−7.5dB，50ms→−15dB，100ms→−30dB，150ms→−45dB，200ms→−60dB（等于没了，末端不会有可闻的硬停）。
结论：做乐器包络，释放段应当用指数（一阶 IIR `env *= coef` 或 `env += (target-env)>>>k`），不要用线性斜坡。

【为什么它还不是 ADSR】
赛题 M7 要 ADSR 四段，现在只有三段：A 有（6ms）／**D 缺失**／S 有但固定**满幅**（不可调）／R 有但线性。
后果：只能做管风琴那种一直平的音色，**做不出钢琴/钟/拨弦这类自然衰减音色**。

【测量方法（避免踩坑）】
分块 render（STEP = 5 ms），对每块取 max(abs) 再换算 dB。**不要逐样本 render 后取 abs** —— 单样本值会撞到波形过零点，得出"0.1 ms 就衰减到 −60 dB"的假结论（本次先踩了这个坑）。

【一个重要边界条件】
改包络**不会**破坏"Python ≡ RTL 逐位一致"的验证性质：`synth_engine.py verify` 只比对 `AdditiveEngine` 的输出，包络在 `Voice` 层，不在比对范围内。反过来说——**包络本身目前没有任何 RTL 对照物，两边都要各自单独验证**。
- [2026-09-28 12:04] [经验教训] 加法与模态在数学上等价（指数包络就是阻尼正弦）；但按赛题计数口径物模不比加法更省指标，切换会与 M6 实时变调冲突 — 用户问"我们这套加法架构是不是能自然衔接到物理建模"。核对后结论：**能，但衔接点是「模态合成 modal synthesis」，不是通常说的物理建模（波导/Karplus-Strong）**。

【数学等价（这是核心，可复用）】
- 加法泛音 + 指数包络：y(t) = Σ aᵢ·e^(−t/τᵢ)·sin(2πfᵢt+φᵢ)
- 模态谐振器（2 阶 IIR）：y[n] = 2r·cosθ·y[n−1] − r²·y[n−2] + x[n]，冲激响应 = rⁿ·sin((n+1)θ)/sinθ，**就是阻尼正弦**
→ 二者是同一数学对象的两种写法。**推论：把包络从线性改成指数之后，这个加法引擎在数学上就已经是模态引擎了**；差别只在衰减是"显式包络乘法"还是"藏在极点半径 r 里"。

【资源对照（每单元，估算）】
| | 加法 | 模态 |
|状态|相位累加器 24bit|y[n−1],y[n−2]|
|每样本|1 查表 + 1 乘 + 1 加|2 乘 + 2 加，不查表|
|频率|inc，直接可改|系数 a₁ = 2r·cosθ|
|衰减|需独立包络生成器|免费（就是 r）|
|BSRAM|每泛音占 1 读口 ← 46 上限唯一来源|不用 BSRAM|
|激励|不需要|需要冲激/噪声|
|稳定|无条件|定点下 r 量化可能 ≥1 → 自激发散|

【模态的 3 好处 / 3 代价】
好处：① 绕开 BSRAM 读口瓶颈（当前全并行卡在 ~46 泛音的唯一原因）② 衰减免费内建 ③ 音色天然物理。
代价：① **实时变调变难（与必须项 M6 直接冲突）**——加法改 inc 即可且相位连续，模态要重算 cosθ；缓解办法是系数表，只在换音高时读一次而非每样本。② 定点 IIR 稳定性风险。③ 要额外做激励发生器。

【对文档一处说法的更正（需后续复核，不是定论）】
`docs/02-技术方案/06-架构决策框架-v2.md` 的 D3 表里写「物理建模：资源低（一条延迟线）／指标效率**最高**／性价比之王」。但赛题口径是「物理建模按**并行弦/模态单元**统计」——**一个模态单元算 1 个，与加法一个泛音算 1 个完全相同**，每单元资源也接近。按同一口径重算**看不出物模在指标上的优势**。
→ 结论（适用范围仅限"吞吐量指标"这一维度）：**模态的价值在音色和绕开 BSRAM，不在指标效率。** 不要为指标去做物模。

【现阶段的行动判断】
不应现在切换到模态：9 个必须项一个都没完成；物理建模只是拓展项 E1 里的一句话（加分项非必需项）；切过去等于重写引擎而 M6 反而更难。
→ 正确做法：**架构上留好接口（振荡器单元做成"可替换运算核"），把它记为 E1 技术储备，做完必须项再评估。**
- [2026-09-28 12:08] [经验教训] 当前内核不激进（资源 2%/3%/18%/13%，每 576 时钟仅 15 次算术运算）；须区分"必要的复杂度"与"野心的复杂度" — 用户问"我们目前这个内核似乎是比较激进了？"，并表示乐意迎接复杂硬件挑战。核对后结论：**当前内核一点都不激进，是教科书里最保守的一档。**

【数字证据（来自 PnR 报告 + 代码，非估计）】
- 逻辑 371/20736（**2%**）、寄存器 391/15750（**3%**）、BSRAM 8/46（18%）、DSP 3/24（13%）
- 时钟利用率：**每 576 个时钟，整个引擎只做 8 次乘法 + 7 次加法 = 15 次算术运算**
- 架构本质 = "N 个振荡器并行，各自查表，求和输出" —— Synclavier 在 1970 年代就是这个结构

【可复用的二分法：三种复杂度必须区分开】
| 类型 | 例子 | 性质 |
|**必要的复杂度**| 同步读表进 BSRAM、加法树流水、饱和限幅、定点 Q1.15 | **不加就不能工作**（v1 就是这么时序违例的，slack −2.987 ns）|
|**野心的复杂度**| TDM 时分复用、混合架构、108 MHz 收敛 | **主动选更难的路去换性能指标** |
|**呈现的复杂度**| 7 级流水线、位精确比对 | 看着唬人，实为第一种 |
→ 当前内核**只含第一种**。"看着复杂" ≠ "架构激进"。这个区分可用来判断任何一次架构讨论是否被表象误导。

【项目真正激进之处（沿用 `Bug修复与可行性评估.md` 3.2 的既有结论，未改动）】
加法合成 ❌ 不激进（50 年前成熟技术）／512 泛音 ⚠️ 中等但说服力存疑／**实时塑谱交互 ✅ 激进**／**零外设纯仿真可验证 ✅ 激进**／**<3 ms 确定性延迟 ✅ 激进**。
→ **激进的是「交互设计」与「工程方法」，不是「内核性能」。**

【对审计文档 3.3 的一处部分反驳（我的观点，已告知用户）】
文档 3.3 称"只能靠仿真时，512 个振荡器说服力很低，因为没有付出任何物理代价"。
- 同意：单纯在测试台把参数调大、跑长仿真、画频谱，确实廉价。
- 不同意：若 TDM 引擎**真的综合出来、时序收敛、资源报告在案**，它已付出真实物理代价（占用真实 BSRAM/DSP/时序预算），且"用 1 套运算硬件喂满 576 个时隙"是**架构成就**而非调参。
- 修正后的分界线（适用范围：竞争力说服力评估）：**指标是「参数改出来」的说服力低；指标是「架构挣来」的说服力高。** 文档那句"没有物理代价"只对前一种成立。

【TDM 的真正难点（不是写代码难）】
① 状态存储变新瓶颈（相位搬进 BSRAM，每样本读-改-写，存储器带宽成天花板）② 时隙调度（576 时隙分给振荡器/包络/混音/控制，分错就掉音）③ **bug 极难查**（现象是"某个音偶尔错一拍"，波形上看不出来）④ Python 逐位模型要从"每样本对齐"重写成"每时隙对齐" ⑤ 答辩要守住"共享运算硬件算不算独立振荡器"。
**最担心第 ③ 条：TDM 的调试成本与"只能仿真、没板子、没逻辑分析仪"这个约束正相关。**
- [2026-09-28 21:40] [经验教训] 原文两次要求"充分发挥/最大化 FPGA 并行优势"；"充分利用"的两种读法支持混合架构；报告模板硬性要求实物照片 — 【原文证据：「充分发挥 FPGA 并行优势」在选题二里出现两次，不是我的推断】
出处 `refs/candidate-guides/gaoyun-选题提取.md`（结构化提取，非 PDF 乱码）：
- 主设计要求（第 62/140 行）：「系统**充分发挥 FPGA 并行流水线运算优势**，具备高复音并发能力、多音色切换、多维表情调控特性，严格控制演奏延迟…」
- 拓展要求 1（第 66/152 行）：「突破基础复音限制，实现复音数 ≥32，或单音加法合成分量 ≥32 路，或多条并行物理建模运算单元，**最大化发挥 FPGA 并行计算优势，提升振荡器整体吞吐量**。」
- 自由选题通用要求（第 109/120/124 行）：「能**充分体现高云 FPGA 芯片的主体地位，体现 FPGA 的性能和非替代性（不使用 MCU）**，鼓励设计具有创新性，工程完整性的作品。」
**第 2 条把"发挥并行优势"和"提升吞吐量"写在同一句里** → 吞吐量指标不是孤立数字，它就是这条要求的操作化。
→ 修正我之前的一个偏差：我说过"指标高 ≠ 竞争力强"，**该结论只对"参数灌水式的大数字"成立**；原文明确要求最大化并行优势，所以指标本身是要争取的。

【"充分利用"有两种读法，且会冲突（新论据）】
| (a) 用掉很多资源 | 利用率百分比高 → 大规模并行满足 |
| (b) 用好芯片能力 | 并行/DSP/BSRAM 用到位 → **纯 TDM 也能满足** |
**冲突点**：纯 TDM 用 1–2 块 BSRAM 跑几百个振荡器，技术上漂亮，但报告上会写「BSRAM 2/46、LUT 1%」，评委可质疑"这么点资源怎么体现充分利用平台？"
→ **理想解既不是最高数字也不是最省资源，而是「高吞吐 + 有分量的资源占用」→ 指向混合架构（N 条并行通道 × TDM）**。这是支持混合而非纯 TDM 的新论据。

【报告模板要求实物照片（交付风险，非技术风险）】
出处 `refs/report-template/template_general_2025-报告结构.txt`（UTF-8）。第三部分结构：
- 3.1 整体介绍（**整个系统实物的正面、斜45°全局性照片**）
- 3.2.1 机械成果（**实物照片**）／3.2.2 电路成果（**实物照片**）／3.2.3 软件成果（界面照片）
- 3.3 特性成果（逐个展示功能、性能参数等量化指标）（**可加重要仪器测试或现场照片**）
其余结构：摘要 800 字；第一部分 作品概述（功能特性 400／应用领域 400／技术特点 400／**主要性能指标 200 字建议用表格**／创新点 200 逐点／设计流程 200）；第二部分 系统组成（整体框图 + 硬件系统 + 软件系统，逐模块图与关键输入输出）；第四部分 总结（可扩展 300／心得体会 1000）；第五部分 参考文献 ≤20 篇。
→ **没有开发板就交不出实物照片**。已向用户提出：需确认板子能否拿到（哪怕只借几天拍照片、录演示视频）。
- [2026-09-28 23:41] [经验教训] "末尾被截断"是时长问题不是切口问题：指数匀速掉 dB，200ms 时到 -20dB 只要 77ms；形状与长度是两个独立旋钮 — 用户反馈"末尾依旧有被截断的感觉"。诊断后确认：**不是切口问题，是长度问题**。这条区分可复用。

【第一步：先证明"不是咔哒/台阶"（实测）】
收尾那一下的逐样本跳变 = **0.7 / 47269 = −96.6 dBFS**，完全听不见；释放过程中最大逐样本跳变 53，而音符正常进行中的跳变是 12810。
→ 排除爆音，问题只能出在时长或曲线形状。

【第二步：查出真正原因 —— 指数曲线在"响"的区间掉得更快】
指数淡出是**匀速掉 dB**。release=200 ms 对应 −60 dB，即 **−14 dB / 50 ms**：
| 松手后 | 线性(200ms) | 指数(200ms) |
| 到 −20 dB（听感上"没了"） | ~170 ms | **71~77 ms** |
| 到 −40 dB | ~195 ms | 139 ms |
**教训：改曲线形状 ≠ 改听感长度。** 上一轮只把线性换成指数，以为解决了"截断感"，实际上指数在开头掉得更快，"响的那一段"反而更短了。**形状和长度是两个独立的旋钮，必须分别调。**

【第三步：修复】
1. **释放长度做成可调**：演奏模式 `3`/`4` 键，7 档 `0.10 / 0.20 / 0.30 / **0.40** / 0.60 / 0.90 / 1.30` 秒，默认从 0.20 s 提到 **0.40 s**（"响的那一段"从 77 ms 变成 139 ms，近一倍）。新增 `Voice.set_release_seconds()`。
2. **收尾阈值从 −60 dB 降到 −80 dB**：新增模块常量 `ENV_CUTOFF = 1e-4`。理由：−60 dB 截止在 16 bit 下是 **32 个 LSB** 的台阶，安静环境下可能听到极轻的"嗒"；−80 dB 只有 3~5 个 LSB。
   → `release_s` 的语义定为"衰到 −60 dB 的时间"，实际尾巴约 1.33 × release_s。

【第四步：释放各档实测（分块取包络）】
| release_s | 到 −20 dB | 到 −40 dB | 实际静音 | 收尾台阶 |
| 0.10 s | 39 ms | 71 ms | 135 ms | −74 dBFS |
| 0.20 s | 77 ms | 139 ms | 267 ms | −74 dBFS |
| **0.40 s** | **139 ms** | **277 ms** | 533 ms | −78 dBFS |
| 0.90 s | 300 ms | 616 ms | 1200 ms | −74 dBFS |
| 1.30 s | 439 ms | 877 ms | 1735 ms | −74 dBFS |

【测量陷阱：本次又踩了一次（此前已记录过，仍未改掉习惯）】
用"逐样本 render 后取 abs"测包络会撞到波形过零点，得出"1 ms 就到 −20 dB"的荒谬结果。
**必须分块 render（如 64 样本）取每块 max 作为包络。** 同一个坑踩了两次，以后测包络一律分块。

【必须分开的两个问题（已向用户说明，避免误判需求）】
- **释放不够长** → 按 `4` 加长释放即可解决。
- **按住时音符就该在衰减** → 这是 ADSR 的 **D（decay）段**，需要真实的钢琴/钟式行为；当前 sustain 是满幅直通，靠 `1`/`2` 余韵键手动开启衰减。**两者是不同的问题，不要混为一谈。**

## 行动指南 Action Guide

- [2026-09-18 18:15] [行动指南] 项目当前状态与 P1 下一步（含紧急板卡申请待办） — 项目状态与关键结论（2026-09-18）：

【已确认】
- 用户已在官网完成报名（2026 FPGA 创新设计赛道）。
- 手上已有 **Tang Nano 20K**，开发可立即开始。
- ⚠️ 报名时**未勾选高云板卡申请** → 需在 9/22 前尝试补救：官网看能否修改 / 直接试填 https://www.gowinsemi.com.cn/university/boardapply/2026 / 官方指导群 213923272 询问。指南原文要求"报名参赛时同时勾选申请"。
- 乐器形态未定，用户仍在摸索。

【Tang Nano 20K 音频通路已打通资料（官方例程 audio/）】
- 引脚：PA_EN=51、HP_DIN=54、HP_WS=55、HP_BCK=56、rst(S1)=87、clk(27MHz)=4，全部 LVCMOS33。
- 板载 MAX98357A（I2S 输入 DAC + D 类功放，单声道）。
- 官方 I2S：每采样点 32 个 BCK，前 16 拍左声道后 16 拍右声道（16bit/声道），b_cnt==0/16 拉 req，MSB 先出，WS 低=左声道，标准 Philips 格式。
- 时钟：27MHz → rPLL(VCO 432MHz=27×16, ODIV 72) → 6MHz → CLKDIV÷4 → 1.5MHz BCK → **fs = 46.875kHz**。48kHz 需要 1.536MHz BCK，27÷1.536 非整数，rPLL 凑不出，故采用 46.875kHz（MAX98357A 支持 8–96kHz，音高按实际 fs 算相位增量即可，无音准问题）。备选：用板载 MS5351 出精确 48kHz，但需解决配置通道，P1 不做。
- 官方例程文件：src/{top.v, audio_drive.v, rom_wave_sine.v, gowin_rpll/, gowin_clkdiv/, audio.cst}，已下载到 .site-probe/tang20k-audio/。
- ⚠️ ROM 只能当**波表**用（按赛题规则只计 1 个振荡器），绝不能当成品音频流回放（赛题红线：禁预录 PCM）。

【战略要点（重要）】
赛题核心评分依据 = **同时活跃可闻独立振荡器总数 × 实际音频输出采样率**。计数规则原文：独立发声单元 = 独立相位累加器 + 频率调控 + 包络控制；**加法合成按运算分量统计、FM 按调制运算器统计、物理建模按并行弦/模态单元统计**。
→ 意味着加法合成的每个分量都算一个振荡器！例如 8 复音 × 16 加法分量 = 128 个振荡器 = 6.0 M osc·Hz，而 32 复音波表只有 1.5 M osc·Hz。
→ 推荐策略：基础架构用波表法（每 voice 成本低，先稳拿 32 复音），再挑 2~4 个"特色音色"用加法合成，既满足"≥2 种音色"又大幅拉高吞吐量，且完全合规。前提是资源够（Nano 20K 只有 48 乘法器/20736 LUT4，Mega 60K 有 118/59904）。

【开发策略】先做与外形无关的引擎（I2S→振荡器→ADSR→复音→混音→效果器），预留稳定的"演奏事件接口"（note_on/note_off/pitch_bend/modulate/timbre_sel），P3 阶段再定乐器形态。Nano 20K 无 ADC，模拟力度用 RC 充放电时间测量法（纯数字，零额外器件）。

【产出文档】docs/00-竞赛选题总览-2026.md、docs/01-开发方案与里程碑.md、docs/02-硬件bringup-TangNano20K音频通路.md、docs/03-乐器形态方案建议.md

【下一步（P1）】装 Gowin EDA → 建工程（GW2AR-LV18QN88C8/I7）→ 跑通官方 audio 例程验证 DAC → 自写相位累加器发 440Hz 正弦 → 测端到端延迟 → 记录资源占用基线。
- [2026-09-19 00:08] [行动指南] 项目暂停待用户学完教程回归（下次先确认日期并重排计划） — 【项目状态：暂停中（2026-09-18 起）】用户决定先集中学完一套 FPGA 教程、具备能力后再回来做项目，原话"先都放着 等我将一整套fpga教程学完 具备完备的能力之后 我再来工作 毕竟是11月而不是10月 see you next week"。预计下周回来。

【下次会话必做】
1. **先确认当前日期**，再按剩余天数重排计划——现有的 Phase 0-8 计划是按 2026-09-18（剩 47 天）排的，用户回来时剩余天数会少很多。参考：9/25 剩 40 天、10/2 剩 33 天、10/9 剩 26 天、10/16 剩 19 天、10/23 剩 12 天。若剩余 <30 天，必须按 MVP（4声部×8泛音全并行 + 12通道传感 + 测试模式 + 报告视频）取舍，不能照搬全计划。
2. 检查 `docs/01-竞赛情报/monitoring-log.md`，看周检是否发现官网新内容（2026 报告模板 / 提交要求 / 高云评分细则均未发布）。
3. 若用户已开始动手，第一步是 4 个验证实验：E0 系统时钟可达性(0.5天) → E1 电容传感 PoC(1天，最大风险) → E2 全并行vs TDM对比原型(2天) → E3 延迟基线(1天)。

【已验证的稳定资产（不受暂停影响）】
- Gowin EDA 教育版 V1.9.11.03 已装 D 盘，器件库含 GW2AR-LV18QN88C8/I7
- Tang Nano 20K 音频通路资料完整（引脚 PA_EN=51/HP_DIN=54/HP_WS=55/HP_BCK=56/rst=87/clk=4）
- 官网周检 Windows 计划任务 `FPGA竞赛官网周检` 每周五 20:00 自动运行
- 全部情报与设计文档在 docs/ 与 refs/ 下，谱系见 README.md 速查表
- **待用户处理**：USB Cable 驱动仍需管理员权限手动安装（UAC），我无法代点
- **环境约束**：C 盘仅剩约 2.6 GB，清理需先列清单经用户确认

【未决】07 候选架构方案「塑谱 Spectra」与 08 灵感库均待用户批判/挑选；决策框架 v2 的 D0~D8 决策权仍在用户手上。
- [2026-09-19 00:12] [行动指南] 9月24日回归验收清单：不追求完备，只求能独立完成最小闭环 — 【用户回归日期确定：2026-09-24（周四）】用户原话："我将在24日回来 到那时候我也许就会有完备的fpga基础了 说说看 你希望我回来之后会什么？"
→ 从今天 9/18 起 6 天学习期，回来后**距提交截止（11/4 18:00）剩 41 天**（不是原计划的 47 天）。

【已交付：回归验收清单 docs/03-学习路线/01-9月24日回归验收清单.md】
核心理念：**不追求"完备"，只追求"能独立完成一个最小闭环"**。已明确排除不需要学的部分，避免浪费时间。

验收项分组：
- **A 工具链闭环（硬门槛，最高优先）**：A1 从零建 Gowin 工程且器件选对（GW2AR-18C→QFN88→GW2AR-LV18QN88C8/I7）；A2 写 .cst 绑引脚；A3 走完综合→布局布线→烧录；A4 找到资源报告 LUT/FF/BSRAM/DSP；A5 在时序报告找到 WNS 并知道 WNS<0 含义
- **B Verilog 核心**：B1 1Hz 闪灯；B2 说得清 wire/reg 与非阻塞赋值；B3 用计数器产生 clock enable 脉冲；B4 case/if 组合逻辑；B5 parameter 与 generate；B6 简单状态机
- **C 心智模型（比分语法更重要，是"能否独立判断"的分水岭）**：C1 代码是同时存在的硬件不是顺序执行；C2 一个 always 块=一组寄存器；C3 组合逻辑延迟 vs 时序逻辑按周期推进；C4 位宽自理；C5 为什么 FPGA 能同时算 100 个东西而 CPU 不行
- **D 仿真（必须有，否则盲写）**：D1 写 testbench；D2 看波形并从中看出问题；D3 有过至少一次仿真发现 bug 的经历
- **E 定点数（建议）**：Q 格式、16位有符号范围、Q1.15 相乘要右移 15 位

【验收仪式：30 分钟挑战】计时 30 分钟从零完成：建工程→写 LED 闪烁→写 .cst→综合布线→烧录→灯按预期闪→说出资源占用。完成=准备好了；超时要记录卡在哪一步。

【明确不需要学（避免浪费时间）】SDRAM/DDR 控制器、高速接口(PCIe/MIPI/以太网)、软核CPU/AXI、复杂IP集成、高级时序约束、PCB设计、SystemVerilog 高级特性、形式验证/UVM。

【6 天不够时的优先级】A组全部 > B1B3 > D1D2 > C组 > B4B5B6 > E组。**最低底线：A 组全部 + B1 + B3。**

【分工预期（回来后的）】用户负责判断拍板/理解原理/决定方向；我负责摊开选项与代价、写代码骨架、查资料、排坑、跑验证、维护文档。TDM调度器/定点数值/时序收敛这些最难的部分我给方案和代码但要用户能讲明白。决策框架 v2 的 D0~D8 决策权仍在用户。

【希望用户带回的四样东西】①回归日期（用于重排计划）②被哪个概念打动了（07方案/08灵感库里哪个让他"心里动了一下"，这决定 D0）③学习时卡住的问题清单 ④USB 驱动装好没（UAC 需他手动点【是】）。

【回归当天流程】①确认日期重算剩余天数 ②检查 monitoring-log.md 看周检是否发现官方新内容 ③做 30 分钟挑战 ④决定直接进 Phase 0 还是补 1-2 天基础 ⑤从 07/08 挑方向开始推 D0。
- [2026-09-21 12:39] [行动指南] 下一步：先核实固化介质（embFlash vs exFlash），再定"哪块板 + DAC 方案"动声音线 — 【当前状态（2026-09-21 收尾，均已上板验证）】
- ✅ 首次烧录 + 全链路验证（LED 心跳、彩条、色序、二进制计数条、画面方向）
- ✅ rPLL 实际频率确认 **9 MHz**，参数公式已破解（**旧结论"20K 音频例程 6 MHz"是错的，正确是 4.5 MHz**）
- ✅ 显示通路重构为可复用模块 `src/rtl/lcd_480x272.v`，客户契约见 `src/rtl/README.md`
- ✅ 坐标偏移 bug 已修复并验证（八条彩条等宽、四周白边、计数条在最底部）
- ✅ 图片显示功能（8 色，BSRAM 24/26）；松开按键=图片，按住=自检图案
- ✅ 文档回填：`docs/02-技术方案/09-第一次烧录bring-up指南.md`（含 PLL 公式推导 + 10 个坑）
- ✅ 三条一键命令：编译 `build_gowin.ps1`、换图 `make_image_rom.py`、**烧录 `flash_sram.cmd`（本轮新增）**

【⚠️ 必须核实后才能做的一件事：固化到 Flash】
上一轮给出的固化命令用的是 `--operation_index 8`（**exFlash 外部 Flash**），但后来发现官方 FAQ 有一句可能矛盾的话：
> "以高云半导体**小蜜蜂（GW1N 开头系列）**为主控的板卡，芯片**内部含有 FLASH**，因此下载时把固件烧录到**芯片内部**即可，将板载的 FLASH 芯片当作外设使用。"

Tang Nano 9K 的器件是 **GW1NR-9C**，正属 GW1N 系列 → 若该说法适用，正确操作应是 `--operation_index 5`（**embFlash 片内 Flash**）。
**两种可能未定，做固化之前必须先查清**（办法：看 Programmer 图形界面 `Access Mode` 下拉提供哪些选项；或查器件手册/配置模式）。
**在查清之前不要执行任何固化命令。** 目前也不需要固化——调试阶段一律用 SRAM。

【下一步 —— 声音线仍未动（用户 2026-09-21 明确选择先夯实地基）】
开始声音前**必须先拍板两件事**：
1. **用哪块板 / DAC 怎么解决**：赛题硬性要求「经 I2S 输出至 DAC 解码发声」，适配板卡列表**不含 9K**；9K 无板载 DAC，20K 有 MAX98357A（I2S DAC + D 类功放）。→ 推荐 20K；若坚持 9K 需外接 I2S DAC 模块（PCM5102 / MAX98357A 模块）。
2. ⚠️ **重算 I2S 采样率**：不得沿用旧笔记的"PLL 输出 6 MHz"，正确公式下该例程是 **4.5 MHz**。以 20K 音频例程自己的 `.ipc`/`.mod` 为准推导 BCK 与 fs。
3. 乐器形态仍未定（用户尚未拍板，属其架构决策权范围）。

【迟早要做的技术项】
**PSRAM / SPI Flash 控制器**：目前图片只能 8 色就是被 BSRAM 468 Kbit 卡的。装上板载 64 Mbit PSRAM 后：① 图片可上全彩；② **音频引擎的延迟线/混响缓冲区同样需要它**。一举两得，Gowin 有现成 PSRAM IP。

【环境事实（省得再试）】
- 烧录**不需要按 S2**；下载频率自动 2.5 MHz；器件填 `GW1NR-9C`
- 编译：`powershell -NoProfile -File tools\scripts\build_gowin.ps1 -Project <gprj> -SspiAsGpio`
- 烧录：`tools\scripts\flash_sram.cmd`（或在 Programmer\bin 下跑 `programmer_cli.exe --device GW1NR-9C --operation_index 2 --fsFile <fs>`）
- **改代码 → 编译 → 烧录 → 看到结果，全流程约 10 秒**
- 用户的终端习惯是 **cmd**（Windows Terminal 的 cmd profile）；本机 harness shell 是 Windows PowerShell 5.1 —— **给用户命令时按 cmd 语法给，或直接给脚本**
- [2026-09-22 21:41] [行动指南] 学习路线：仿真环境已就绪（下一步=跑通例子+注bug实验拿D3），之后写 I2S 需先定板 — 【盘点：对照《9/24 回归验收清单》（2026-09-21）】
| 组 | 状态 |
|---|---|
| A 工具链闭环 | ✅ 大部分（仅 A5「时序报告看 WNS」尚未碰过） |
| B Verilog 核心 | ✅ 大半已被自学 UART 覆盖：波特率发生器=计数器+使能脉冲(B3)、发送状态机(B6)、移位输出 |
| C 心智模型 | ✅ 概念讨论覆盖良好（"代码是同时存在的硬件"/位宽管理/并行性） |
| **D 仿真** | 🔄 **工具已就绪，等用户跑一遍拿到达成** |
| E 定点数 | ❌ 空白（可边做边补） |
→ 用户选 UART 练手选得很对：它是"麻雀虽小五脏俱全"的练习，不知不觉把 B 组练了一大半。

【✅ 已完成：仿真环境（原"下一步"的第 1 项）】
`D:\iverilog`（iverilog 14.0 + vvp + GTKWave 自带），一条命令：
```cmd
cd /d C:\Users\Sakuya\FPGA-Music-project
tools\scripts\sim.cmd src\sim\tb_hello_tick.v src\sim\hello_tick.v
```
材料：`src/sim/{hello_tick.v, tb_hello_tick.v, tb_template.v, README.md}`，用法与 GTKWave 首次操作步骤都写在 README 里。

【接下来用户要做的两件事】
1. **跑通例子**（上面那条命令）→ GTKWave 弹出，看 `cnt` 从 0 数到 9、数到 9 时 `tick` 拉高一拍
2. **做那个"注 bug"实验**（README「五」有步骤）：把 `hello_tick.v` 里 `cnt == DIV-1` 改成 `cnt == DIV` → 自检报 `[FAIL] 间隔 = 11 拍` → **这就拿到了《9/24 清单》D3「有过一次仿真抓 bug 的真实经历」**
3. 9/24 做「30 分钟挑战」：从零建工程 → 点灯 → 约束 → 烧录 → 报资源占用数字

【用户接下来会自己写 Verilog，分工已约定】
- 用户：写 `.v`、决定要什么功能
- 我：**配 `.cst` 引脚约束**（他明确说这个麻烦我）、写 testbench、一起分析波形、一起综合烧录

【⚠️ 仍未解决的前置阻塞：在哪块板上出声】
9K **无 DAC**；20K **板载 MAX98357A**。《47 天计划》的任务 A 与里程碑（"喇叭响"）用的正是 20K 的官方 audio 例程。
→ **如果用户这轮要写 I2S，必须先定板**；若只是练手（更复杂的 UART / 状态机），9K 够用。

【DSP 的时机：不必刻意安排，会自己出现】
| 做到哪一步 | DSP 知识自动出现 |
|---|---|
| 相位累加器 + 波表 | 采样定理、混叠 |
| ADSR 包络 | 指数衰减的定点实现 |
| 混音 + 饱和限幅 | 增益结构、溢出与削波 |
| **效果器（延迟/混响/合唱）** | **延迟线、梳状/全通滤波器** ← 真正的 DSP |
| 频谱可视化 | **FFT** |
计划里已排在 P2（10/20 之后）。**现在学 = 提前三周空转。**
核心认知：**在 FPGA 上做 DSP，难点从来不是数学，而是"怎么把数学塞进硬件"**（流水线、定点数、存储组织(TDM)、位宽管理）——这些都不在 DSP 教材里，全在第 1~2 段任务中。正确顺序：先有硬件直觉 → 再学 DSP 数学 → 公式会突然"有形状"。
- [2026-09-23 21:34] [行动指南] 9/24 验收日安排（跑仿真+注bug实验+30分钟挑战）+ 启动 I2S 前必须定板与 DAC — 【2026-09-24（明天）就是《9/24 回归验收清单》的验收日】
建议按这个顺序做，总耗时约 **1 小时**：
| # | 做什么 | 耗时 | 达成清单哪条 |
|---|---|---|---|
| 1 | 跑 `tools\scripts\sim.cmd src\sim\tb_hello_tick.v src\sim\hello_tick.v`，看 GTKWave 弹出 | 15 min | **D1 / D2** |
| 2 | 做 `src\sim\README.md` 第五节的"注 bug"实验（把 `hello_tick.v` 里 `cnt == DIV-1` 改成 `cnt == DIV`）→ 自检应报 `[FAIL] tick 间隔 = 11 拍` | 15 min | **D3**（"有过一次仿真抓 bug 的真实经历"）✅ |
| 3 | **「30 分钟挑战」**：从零建 Gowin 工程 → 写点灯 → 写 `.cst` → 综合 → 布局布线 → 烧录 → 报出 LUT 占用数字 | 30 min | 回归验收仪式 |
| 4 | 把卡在哪一步告诉协助方 → 重排剩余 41 天计划 | — | — |

【⚠️ 启动 I2S 的前置条件：定板 + DAC 方案 —— 已挡在路上一周，必须尽快拍板】
- **Tang Nano 9K**：**无板载 DAC** → I2S 写出来也没法听（须外接 I2S DAC 模块，如 PCM5102 / MAX98357A 模块）
- **Tang Nano 20K**：**板载 MAX98357A**（I2S 输入 DAC + D 类功放）→ 插上就响
- 《47 天计划》的任务 A 与里程碑（"喇叭响"）用的正是 **20K 的官方 audio 例程**（`refs/vendor-examples/tang20k-audio/`）
→ **若要在 I2S 阶段就听到声音，必须用 20K，或给 9K 外接 DAC。** 这是用户的架构决策，协助方只提供选项与代价。

【9/24 之后立刻进第 1 段任务 C：自己写 I2S 发送器】
- 参考实现：`refs/vendor-examples/tang20k-audio/audio_src_audio_drive.v`
- **UART → I2S 迁移对照**（用户已有技能直接复用）：
  | UART | I2S |
  |---|---|
  | 波特率发生器（分频计数） | 位时钟 BCK 发生器 |
  | 起始位 / 停止位 | **WS（每 16 拍翻一次）** |
  | 8 位 **LSB 先出** | 16 位 **MSB 先出** ← 主要新知识点（方向反了） |
  | 每帧 10 拍 | 每帧 **32 拍**（左 16 + 右 16） |
  | 发完进入空闲 | **永不空闲，连续不断** |
- **分工（已与用户约定）**：用户写 `.v` 并决定功能；**协助方配 `.cst` 引脚约束**、写 testbench、一起分析波形与综合烧录。
- ⚠️ **重算采样率**：不得沿用旧笔记"20K 音频例程 PLL 输出 6 MHz"——按正确公式 `fCLKOUT = fCLKIN × (FBDIV_SEL+1)/(IDIV_SEL+1)`，该例程是 **4.5 MHz**。以该例程自己的 `.ipc`/`.mod` 为准推导 BCK 与 fs。

【说明】本条接替条目 `8bea3b7e9809` 中「接下来用户要做的两件事」部分；那份盘点表与 DSP 时机表**仍然有效**。
- [2026-09-24 19:36] [行动指南] 课题覆盖逐条清单：25项要求覆盖26%（必须项0/9完全达成），补包络是最高优先级 — 【课题要求覆盖清单（2026-09-24 逐条核对完毕）】
文档：`docs/02-技术方案/12-课题要求覆盖清单.md`

⚠️ **更正此前数字**：上一轮我记录的"总覆盖度约 15%"是粗略估计。**逐条核对后的准确结果是 26%**（完全达成 3 / 部分 7 / 未做 15，共 **25 项**要求）。此前条目的综合部分仍然有效，仅覆盖度数字以此条为准。

【判定口径（重要）】**只有"RTL 实现"才算覆盖**；Python 验证器只证明算法可行，**不算**——因为赛题要求「完整音频通路全部基于 FPGA HDL」。

【25 项要求分布】必须项 9（完全达成 **0** / 部分 3 / 未做 6）｜合规红线 3（✅2 / 部分1）｜核心评分依据 1（部分）｜形式项 4（✅1 / 部分2 / 未做1）｜拓展项 8（全未做）。
加权覆盖率 = (3 + 7×0.5)/25 = **26%**。**但 9 个必须项里完全达成 0 个 → 按现状无法提交合格作品。**

【逐条状态】
- **M1 ≥2维交互** ❌（RTL无；Python演奏器有音高/谱宽/谱心/非谐度 4 维）
- **M2 完整音频通路全基于FPGA HDL** ⚠️（引擎是纯RTL，但**无输出通路**）
- **M3 I2S→DAC** ❌（一行没写）
- **M4 延迟≤10ms** ⚠️（7级流水线≈6样本=128µs 架构支持，但**没有I2S就测不了端到端**）
- **M5 复音≥4** ❌（RTL 1声部；Python 有4声部）
- **M6 单音实时变调** ⚠️（`inc` 是编译期常量，改可写寄存器即可但没做）
- **M7 ADSR包络** ❌（**RTL 完全没有**，amp_flat 是静态常量；Python 有 6ms起音+200ms释放）
- **M8 多声部实时混音** ❌
- **M9 自研交互形态** ❌
- **R1 严禁预录PCM** ✅（代码里无任何音频存储器，设计上不可能踩）
- **R2 逐音逐样本实时生成** ✅（Python与RTL 0 样本差异）
- **R3 现场自证** ⚠️（A/B独立性实验是雏形，非RTL内置测试模式）
- **核心指标"振荡器数×采样率"** ⚠️ **目前不能声称成立**——因"完整振荡器"定义缺**包络控制**
- **F1 测试模式** ⚠️（仿真做过8峰全中，非RTL内置）
- **F2 振荡器含 相位累加器+频率调控+包络控制** ⚠️ **2/3，缺包络**（与M7同一缺口）
- **F3 识别选音/和弦/触发/拨弦** ❌
- **F4 适配Sipeed Tang系列** ✅（Tang Nano 20K）
- **E1–E8** 全 ❌

【最致命的一条】**M7 一个缺口卡住两处**：既是必须项，又卡住核心评分依据。赛题定义"独立发声单元为包含独立相位累加器、频率调控、**包络控制**的完整振荡器"——我们现在 2/3。**补包络是解锁核心指标的前提。**

【达标必须补的顺序（8 步，含是否需要板子）】
1. **加包络**（解锁 M7+F2+核心指标）｜不需板子｜1天 ← **性价比最高，建议先做**
2. 补 `.sdc` + 时序收敛到目标频率（M4/E5可测）｜不需板子｜1天
3. **I2S 发送器**（M3+M2）｜不需板子｜2天
4. **多声部+混音+声部分配**（M5+M8）｜不需板子｜3天
5. **测试模式（RTL内置）**（F1+R3）｜不需板子｜1天
6. 实时变调接口（M6）｜不需板子｜0.5天
7. **交互层**（M1+M9+F3）｜**部分需硬件**｜3天
8. 拓展项（E1–E8）｜不需板子｜3天+

【关键结论】**第 1–6 步全部不需要开发板**，可完全在"仿真+综合"里完成，能解锁 **9 个必须项中的 7 个**（M2/M3/M4/M5/M6/M7/M8）+ F1 + F2 + 核心指标。只有第 7 步交互层可能需要硬件，且可用**板载按键+UART（零外设）**满足。

【时间账】1–6步 ~8.5天 + 第7步 ~3天 + 第8步 ~3天 + 报告视频提交 ~6天 = **~21 天**，剩余 **41 天** → **够，前提是不在意外处耗掉**。

【乐观因素】Python 验证器已把 M1/M5/M6/M7/E2/E3 的**算法全部跑通**（音高映射/4声部/变调/ADSR/音色切换/3维表情），剩下的是**把算法搬进 RTL**，不是从零发明。
- [2026-09-27 20:09] [行动指南] 三个待用户拍板的决策 + 最短可提交路径（约 18 天 / 剩 37 天） — 当前卡在三个待用户拍板的决策上（用户明确要求架构由他自己定，不要替他决定）。已把选项与代价列给他，等回复后再开工。

【决策 1｜D2 引擎架构】A 全并行（约 46 泛音 / 2.2M osc·Hz，好讲好调）／B TDM（13.5M–108M，但要论证"共享运算硬件算不算独立振荡器"，且调试抽象）／C 混合（平时全并行保演示，测试模式启用 TDM 冲指标）。我的观察倾向 C，因为它同时拿到"好讲好调"和"高指标"，且测试模式本就是赛题强制项；但需要**现在就把振荡器的「运算核」与「状态存储」分离开设计**，否则后期加 TDM 通道要重写。这是本决策对当下编码的硬约束。

【决策 2｜包络形态】快速解锁型（线性曲线 + 每样本更新 + 每声部，约 1 天，与现有 Python 模型逐位一致）／音色优先型（一阶 IIR 指数 + 每 64 样本 + 每声部，约 1.5 天）。我倾向先做快速解锁型：用 1 天同时补上 M7 + F2 + 让核心指标成立，先把项目从"无法提交"变成"可提交"。两种可后换，代价仅 2–3 天。

【决策 3｜指标目标档】8 声部×32 泛音=256（12M，稳）／16×32=512（24M，中）／32×32=1024（48M，激进）。我倾向 512。此档决定声部分配器复杂度、BSRAM 用量与答辩论证量。

【最短可提交路径（均不需要开发板，估算约 18 天 / 剩 37 天）】
1. RTL 包络（1 天）→ M7 + F2 + 核心指标成立
2. .sdc + 时序收敛（1–2 天）→ M4 可测。注意：.sdc 目前完全不存在，是从零开始
3. I2S 发送器（2 天）→ M3 + M2 完整通路
4. 多声部 + 混音 + 声部分配（3 天）→ M5 + M8
5. RTL 内置测试模式（1 天）→ F1 + R3
6. 变调接口 inc 改寄存器（0.5 天）→ M6
7. 交互层（3 天）→ M1 + M9 + F3，此步可能部分依赖硬件
8. 报告 + 视频 + 提交（6 天）
前 6 步完全不需要板子，解锁 9 个必须项中的 7 个。

【已向用户提出、待他答复的下一步】
我提议先把决策 1、2 的详细对比（含资源估算与 RTL 骨架草案）写成文档供他批注，等他确认。

【环境约束提醒】只有仿真 + 综合可靠，硬件访问断续、外设稀缺，"可仿真性"是一等设计准则；开发循环应停在 8–16 泛音，参数化以便放大。
- [2026-09-27 20:35] [行动指南] 包络下一步：先改指数释放（A）再补 ADSR（B），等用户选 — 紧接"包络实测"结论（Python 侧是 ASR + 线性释放；RTL 侧无包络），已向用户提出两条路，等他选：

- **A（建议先做）**：只把释放曲线从线性改成指数（约 5 行，立即能听出"渐弱"而非"开关"）。目的是先验证听感方向对不对，不改状态机。
- **B**：一步补齐 ADSR 四段（加 D 衰减段 + 可调 S 延音电平），**Python 与 RTL 同步实现**。B 解锁 M7 + F2 + 核心指标成立，属于上一轮"决策 2 包络形态"的展开。

我的建议顺序：先 A 验证听感，再定 B 的参数（A/D/S/R 四个时间/电平值）。

【B 的硬约束】
1. 包络不在 `synth_engine.py verify` 的比对范围内（该命令只比对 AdditiveEngine），所以 Python 侧和 RTL 侧**各自都要单独验证**，不能靠现有逐位一致机制兜底。
2. RELEASE 必须由按键抬起事件驱动（不要重犯"只在声部被抢占时进入 release"的错）。
3. 参数走寄存器而非编译期常量，否则现场无法演示调节。

【本轮尚未确认的事】用户还没回答选 A 还是 B。
- [2026-09-28 12:04] [行动指南] ★最紧急：确认开发板能否拿到（报告要实物照片）；待定释放长度档位、曲线与包络 4 选择 — 【已解决，从待办中移除】
- ~~用户"内核比较激进"的印象从哪来~~ → 已澄清。
- ~~I2S 目标器件型号~~ → MAX98357A（免 MCLK 免 I2C）。
- ~~TDM 现在还是按顺序来~~ → 已在 8.5 天计划中顺延至步骤 4 后用数据拍板。
- ~~步骤 0 是否要做~~ → 已做完（指数释放 + 0 键 A/B）。
- ~~"末尾截断感"的诊断~~ → 已定位为**时长问题**（非切口），已把释放长度做成 `3`/`4` 键可调、默认 0.40 s、收尾阈值降到 −80 dB。详见同轮 lessons/work 记忆。

【★★ 最紧急：开发板能不能拿到】
报告模板 `refs/report-template/template_general_2025-报告结构.txt` 硬性要求实物照片（3.1 系统实物正面/斜45°照片、3.2.1/3.2.2 机械与电路实物照片、3.3 仪器测试或现场照片）。
→ **没有板子就交不出实物照片**，属交付风险而非技术风险，直接影响评分。已问用户，**仍未答，不宜再拖**。

【待用户回复（本轮更新）】
1. **释放长度哪一档听着自然**（按 `4` 在 0.40 / 0.60 / 0.90 / 1.30 s 之间试）。我猜 0.60~0.90 s。这是步骤 1 包络设计的前置输入。
2. **释放曲线选指数还是线性**（按 `0` 对比）——倾向指数。
3. **包络 4 个设计选择**：曲线（待 1、2 定）／挂载层（建议先每声部 1 个，接口留成"每泛音"形状）／更新率（建议每 64 样本，不影响指标）／参数来源（建议寄存器）。
4. **复音数目标（4 / 8 / 16）** —— 步骤 4 开始前需要。
5. 模态衔接技术储备文档（只写接口设计与对照，不实现）。
6. 先做「力度」这一维（补 M1 + 撑 E2；RC 充放电测时，纯数字零额外器件；GW2AR 无 ADC）。属步骤 7，不在 8.5 天内。

【已向用户澄清的一个需求歧义（重要，防止做错方向）】
- "释放不够长" → 按 `4` 解决。
- "按住时音符就该衰减"（钢琴/钟式）→ 需要 ADSR 的 **D 段**，当前 sustain 是满幅直通，只能靠 `1`/`2` 余韵键手动开。**这是两件不同的事，等用户听完分辨。**

【决策依据更新（影响 TDM 选型）】
"充分利用平台"有两种读法且冲突：(a) 用掉很多资源 (b) 用好芯片能力。纯 TDM 用 1–2 块 BSRAM → 报告上"BSRAM 2/46、LUT 1%"，可能被质疑。→ **理想解是「高吞吐 + 有分量的资源占用」→ 支持混合架构（N 条并行通道 × TDM）。**

【不变的环境与架构约束】
- 只有仿真 + 综合可靠；硬件访问断续、外设稀缺，"可仿真性"是一等设计准则。
- 架构决策由用户本人拍板；关键决策点必须停下来问，不闷头写完。
- 任何新增交互维度都必须能落进 RTL 并可现场演示——Python 侧有不算覆盖。
- 先地板后天花板：8.5 天必须项做完之前不动架构。
- 每个新模块必须配中文设计说明（决赛答辩可辩护性）。
- 分工为方案 C：AI 写 RTL，用户决策 + 验收 + 答辩。
