sakuyaShining/FPGA-Music-project-internal/project/COLLABORATING.md

# 协作接手：仓库权限与离线补丁

目标仓库已由用户公开，任何人可读取和克隆；直接推送需写权限，其他协作者可fork后提交PR。不要共享账号密码、令牌或CAD会话句柄。公开不代表允许上传完整会话、账号配置或其他未筛选的本机资料。

## 选择协作方式

| 方式 | 交付与回收 | 适用范围 |
|---|---|---|
| 仓库/公开fork协作 | 从实际main取得入口，在命名任务分支提交，通过PR交回 | 持续合作及公开贡献者；无写权限时使用fork |
| 离线协作包 | 维护者提供明确范围的源码、依赖、版本清单、任务说明和测试入口；协作者交回补丁及结果 | 临时任务、专项审查、不授予仓库权限的参与者 |

离线包的分享对象与内容由用户决定。额外本机资料不随仓库公开自动获准分享。不要直接打包整个工作目录或完整会话，以免夹带账号配置、无关资料或构建垃圾。

## 开工前的任务卡

两种方式都要记录这些信息：

- 任务ID、负责人、协作轴、允许写入的路径，以及接口或依赖的负责人。
- 实际内部main提交号、当前review路径及时间；选用源码的提交或归档SHA256、逐文件清单。入口版本和功能源码版本分别填写。
- 已确认的产品目标、尚未决定的交互语义，以及本任务的验收条件。
- 工具版本、可运行的构建和回归入口、黄金数据的来源；已有PASS实际绑定哪个版本。
- 输出分支名称、提交号或补丁、测试结果与未验证项、交回日期。

先读[QUICKSTART.md](QUICKSTART.md)、[AGENT-START.md](AGENT-START.md)、[DESIGN-CURRENT.md](DESIGN-CURRENT.md)和协作板。功能owner正在写的目录不得直接接管。FPGA活跃会话ID仍未登记；认领重叠任务前必须澄清边界。一个Agent同时只认领一条轴。

## 仓库协作

按QUICKSTART从目标仓库实际main克隆，阅读PRODUCT-SPEC、SOURCE-MAP及WORK-PLAN。执行入口及governance检查，在自己的`codex/<topic>-<date>`分支工作，提交并推到已授权仓库或fork，登记实际远程commit，通过PR交回。旧origin/public指向另一个仓库，不能仅按remote名称推送。

只读取已发布记录时，外部电脑不能访问维护者D盘属正常限制；必须显示实时源未观察。审阅过期、需要最新活跃源或源发生漂移时，由维护者/owner交回新版本再开始依赖它的实现，不能关闭检查或复制旧PASS。

## 离线协作包

维护者按任务白名单准备新包，至少包含：`TASK.md`任务卡、入口决定与冲突说明、选定源码及数据表/约束/协议、运行所需脚本和依赖说明、必要黄金数据，以及逐文件字节数和SHA256。给包本身另算SHA256，写明打包时间、源截止时间和未包含项。不要将原作者报告当新验证结果。

接收者校验包与文件哈希，保留原包，在新目录建立本地Git基线。完成后提供相对基线的`git diff --binary`补丁或`git format-patch`、新增文件、执行命令及结果。维护者在隔离任务分支中审查并试应用补丁，核对上下文，运行受影响回归，再走内部PR；过期包需明确与当前源的差异及冲突。

当前工程检查点见[ENGINEERING.md](ENGINEERING.md)和[协作检查点](COLLABORATION-CHECKPOINT-20261024.md)。`engineering.py export`可在新目录恢复指定领域，并生成逐文件来源清单；按任务提供这个输出、依赖说明和任务卡。v1/v2继续作为历史恢复包，不能改名为最新。导出的开发候选也不是完整产品验收版本。

当前保留Tang Nano20K、32组×16分量、四层目标、84节点能力、J10触控屏、逐音滑条、录放及非易失；取消的是独立J11实体可视化屏。已有`tdm_ship_owned`为受限包装，不能用于签收完整载板产品。不擅自改PCB接口、删功能、下载或制造放行。
