sakuyaShining/FPGA-Music-project-internal/notes/工作索引-本地.md

# 项目目录说明

> 项目：2026 FPGA 创新设计赛道 · **高云选题二「基于 FPGA 的实时多音色合成电子乐器引擎」**
> 更新：2026-09-18

## 📌 先看这两份

| 文档 | 作用 |
|---|---|
| **[`docs/01-竞赛情报/01-选题确认与约束条件.md`](docs/01-竞赛情报/01-选题确认与约束条件.md)** | **项目"宪法"**：选题是什么、必须满足什么、红线是什么。一切决策以此为准 |
| **[`docs/03-学习路线/00-零基础47天作战计划.md`](docs/03-学习路线/00-零基础47天作战计划.md)** | 每天该学什么、写什么 |

## 关键节点

| 日期 | 事项 |
|---|---|
| **2026-11-04 18:00** | **作品提交截止（死线）** |
| 2026-11-20 ~ 11-22 | 决赛（南京，含 FPGA 基础编程考核） |

## 目录结构

```
FPGA-Music-project/
├── README.md                  ← 你在这里（目录索引）
├── PROJECT_MEMORY.md          ← 记忆库存档（自动生成，勿手改）
│
├── docs/                      ← 文档（要读的东西）
│   ├── 01-竞赛情报/            ← 赛事情报、选题总览
│   ├── 02-技术方案/            ← 方案、bring-up、形态建议
│   └── 03-学习路线/            ← 学习计划与教程笔记
│
├── src/                       ← 【主战场】我们写的 RTL 源码
│   ├── rtl/                   ← Verilog 源文件
│   ├── sim/                   ← Testbench 仿真
│   ├── constr/                ← 引脚约束 .cst / .sdc
│   └── gowin/                 ← Gowin 工程文件 (.gprj)
│
├── refs/                      ← 参考资料（只读，不用改）
│   ├── candidate-guides/       ← 7 家厂商选题指南原文 PDF + 抽取文本
│   ├── official-notices/       ← 官网通知、竞赛背景
│   ├── report-template/        ← 官方作品报告模板
│   ├── vendor-examples/        ← 厂商官方例程（Tang Nano 20K audio 等）
│   └── _site-archive/          ← 官网抓取的原始数据（存档，一般不用看）
│
├── tools/                     ← 辅助工具（非项目本体）
│   ├── scripts/                ← Python/PowerShell 小工具
│   └── pylib/                  ← 本地 Python 依赖（pypdf）
│
└── notes/                     ← 临时笔记、调试记录、随手记
```

## 各目录用途速查

| 我想… | 去哪 |
|---|---|
| **确认选题是什么、有什么硬性约束、红线在哪** | **`docs/01-竞赛情报/01-选题确认与约束条件.md`** |
| **搞清楚"什么叫好作品"、评委奖励什么** | **`docs/01-竞赛情报/02-什么才叫好作品-评审逻辑与高分画像.md`** |
| 看今年题目和往年差多少、有没有先例 | `docs/01-竞赛情报/03-今年课题与往年对比.md` |
| 了解全赛事 7 家厂商都有什么题 | `docs/01-竞赛情报/00-竞赛选题总览-2026.md` |
| **看官网有没有新通知（每周五自动查）** | `docs/01-竞赛情报/monitoring-log.md` |
| **要拍板的架构决策（8 项，含选项与代价）** | **`docs/02-技术方案/06-架构决策框架-v2.md`** |
| 看整体开发计划和排期 | `docs/02-技术方案/01-开发方案与里程碑.md` |
| 查板卡引脚、I2S 怎么接 | `docs/02-技术方案/02-硬件bringup-TangNano20K音频通路.md` |
| 决定乐器做成什么样 | `docs/02-技术方案/03-乐器形态方案建议.md` |
| 查 EDA 装在哪、怎么装 | `docs/02-技术方案/05-Gowin-EDA安装记录.md` |
| **知道今天该学什么、写什么** | `docs/03-学习路线/00-零基础47天作战计划.md` |
| 写 Verilog 代码 | `src/rtl/` |
| 查某厂商原始赛题原文 | `refs/candidate-guides/`（2026）、`refs/past-years/`（2025） |
| 看官方音频例程怎么写的 | `refs/vendor-examples/tang20k-audio/` |
| 查作品报告要写哪些章节 | `refs/report-template/` |
| 查历届获奖作品 | `refs/_site-archive/history-lists/获奖作品-2024-2025.csv` |
| **查地板阶段完成情况与验证证据** | **`refs/素材库/地板完成索引.md`**（TDM/包络/I2S/测试模式证据都在同目录） |
| 记录踩坑和调试日志 | `notes/` |

## 自动化

| 机制 | 说明 |
|---|---|
| **官网周检** | Windows 计划任务 `FPGA竞赛官网周检`，每周五 20:00 自动检查官网新通知/新文件，结果追加到 `docs/01-竞赛情报/monitoring-log.md` |
| 手动触发 | `powershell -NoProfile -ExecutionPolicy Bypass -File tools\scripts\weekly_check.ps1` |

## 命名约定

- **文档**：`docs/<分类>/<序号>-<标题>.md`，序号 00 起
- **RTL**：`src/rtl/<模块名>.v`，模块名小写下划线（如 `i2s_tx.v`、`osc_wavetable.v`）
- **约束**：`src/constr/<顶层名>.cst`
- **笔记**：`notes/YYYY-MM-DD-<主题>.md`

## 文档权威顺序

当文档之间冲突时，按此顺序取信：

1. **官方原文**（`refs/` 下的 PDF / 通知）——最高
2. **`docs/01-竞赛情报/01-选题确认与约束条件.md`**（项目宪法）
3. 其他设计方案文档
4. 临时笔记（`notes/`）——仅参考
