sakuyaShining/FPGA-Music-project-internal/notes/agent-collaboration-log.md

# Agent 协作日志

> **为什么记这个**：2026 年赛制里，"如何用 AI/Agent 做工程"已进入评分视野。
> - AMD 2026：自主选题权重含「**大模型协作与技能包 15 分**」，要求提交「体现大模型协作过程的交互记录（提示词、模型回答、自我纠错轨迹）」与「可复用技能包」
> - 复旦微 2026：「鼓励…利用合适的 Agent 工具与大模型进行选题、方案制定、算法实现以及高效开发」，并要求「细化具体在什么环节中使用了何种 AI 工具及其在整体工作量中的占比」
> - 高云选题二：**未提及** Agent 协作（所以不假设加分，但主动体现成本很低）
>
> **成本**：每次重要协作花 2-3 分钟记一行。**收益**：可作报告素材 + 帮自己复盘。
> **注意**：只记**有实质决策影响**的协作，不用把每次对话都记下来。

---

## 记录格式

| 字段 | 说明 |
|---|---|
| 日期 | |
| 环节 | 情报调研 / 架构决策 / RTL 编写 / 调试 / 测试 / 文档 / 资料查询 |
| 我的问题 | 问的是什么（可贴原始提示词要点） |
| Agent 给了什么 | 关键结论或产出 |
| 我采纳了什么 | **重要：体现了人的判断** |
| 我否决了什么 | **重要：体现独立判断，评委爱看** |
| 为什么 | 决策理由 |

---

## 协作记录

### 2026-09-18 · 情报调研
- **我的问题**：调查竞赛官网课题，确定选题
- **Agent 给了**：抓取官网 7 家厂商《2026 选题指南》PDF 并结构化提取；发现全赛事仅高云选题二为原生音频/乐器赛题；建立选题总览
- **我采纳**：选定高云选题二
- **我否决**：Agent 建议的备选落点（安路选题一、易灵思自由选题、AMD 3.3）—— 因为只有高云选题二是以乐器为本体
- **为什么**：赛题本体对口，且评分规则明确（振荡器数×采样率），比开放型题目更可把握

### 2026-09-18 · 情报调研（历史数据）
- **我的问题**：想知道"什么才叫好作品"
- **Agent 给了**：发现官网 `/competition/awardInfo/search` 接口，全量拉取 2024+2025 共 1442 件获奖作品；定量分析得出一等率分布、命名规律、音频方向历史战绩
- **我采纳**：结论中的"六条判据"与"FPGA 不可替代性优先"
- **我否决**：（暂无）
- **为什么**：数据来自官方接口，可复核

### 2026-09-18 · 环境搭建
- **我的问题**：C 盘要满，能否装 D 盘
- **Agent 给了**：识别安装器为 NSIS 格式，用 `/S /D=` 静默参数装到 D 盘；并把 TEMP/TMP 重定向到 D 盘避免污染 C 盘
- **我采纳**：接受该方案
- **我否决**：Agent 最初用 UAC 提权（被系统取消），改为不提权直接安装后成功
- **为什么**：C 盘仅剩 2.6GB，必须避免占用

### 2026-09-18 · 架构设计（端到端候选方案）
- **我的问题**：以"系统架构师"角色提出一个完整自洽的产品方向并推演到可实施程度（20 个维度 + 21 项最终输出）
- **Agent 给了**：`docs/02-技术方案/07-候选架构方案-v1.md` —— 产品定位（"音色可演奏"的乐器）、交互设计、传感方案（电容 + FPGA 并行 TDC）、加法合成核心、TDM 架构、时钟推导、数值架构、效果器取舍、自证方案、资源估算、验证架构、47 天计划、20 项风险、7 条 Red Team
- **我采纳**：（待我批判后填写）
- **我否决**：（待我批判后填写）
- **关键过程价值**：Agent **主动声明了 6 处文档冲突**（合成架构被提前锁定、先引擎后外形的顺序矛盾、两份 47 天计划并存、D0~D8 决策权归属、复音指标 vs 音乐需求、单声道 vs 合唱），而非静默修正
- **Agent 主动承认的不确定**：① rPLL 参数语义未能搞清（官方例程参数用文档公式无法复现），故**拒绝给出具体 PLL 参数值**；② MAX98357A 群延迟未查证；③ 板载是否有喇叭未确认；④ 资源数字全部标注为 architecture-level estimate
- **为什么有价值**：把一个模糊的"做电子乐器"推到"3 天内可验证的 4 个实验"，且明确标出了最该先验证的未知数

---

## 待沉淀为"可复用技能包"的内容

> AMD 明确要求提交 `skill/` 目录，评价标准是**可复用性**（陌生队伍能否直接用在自选题上）。
> 我们即使是高云赛道，也可以准备一份，作为工程方法论的体现。

| 候选技能 | 内容 | 状态 |
|---|---|---|
| 竞赛情报自动抓取 | 官网 API 签名调用 + PDF 批量解析（含踩坑记录） | 已有雏形 `tools/scripts/` |
| 获奖数据分析 | 用 `/competition/awardInfo/search` 做竞品与趋势分析 | 已有 `history-lists/` |
| Gowin 工程一键搭建 | 工程模板 + 引脚约束模板（Tang Nano 20K 音频通路） | 待做 |
| FPGA 延迟实测方法 | 示波器双通道测量流程与数据处理模板 | 待做 |
| Agent 协作工作流 | 本日志 + 决策框架模板 | 进行中 |
