sakuyaShining/FPGA-Music-project-internal/docs/02-技术方案/49-最终收敛设计总纲-2026-10-15.md

> **2026-10-23 当前范围覆盖提示**：先读[最新设计入口](../../project/DESIGN-CURRENT.md)及`project/design-state.json`。用户已取消J11实体音乐可视化屏，保留J10泛音触控屏；本文旧双屏要求与旧状态不覆盖后续决定。新观察FPGA候选和旧已验检查点分列，本轮未修改产品RTL。

# 最终收敛设计总纲 · 2026-10-15

> **2026-10-19联合探针资源后续**：见[86号](86-联合探针资源调整与布线失败边界-2026-10-19.md)和`experiments/joint_probe_resources_20261019/project/CURRENT.md`，版本`joint-probe-resources-20261019-v0`。先备份116项，MAC前15项、RAM延迟前11项；85号音乐引擎88文件及全部时序/引脚约束不变。仅把验证探针历史链迁至9个DSP寄存器与96拍RAM延迟，普通寄存器11243→10760；五配置10万拍逐位历史对照、DSP/延迟反例，以及两延迟各200实际音乐PCM录入/读出和200图案播放在限定数字范围**已验证**。联合布局通过，但正常策略仍DesRoute/PR0004，路由**未通过**；PnR报告20478Logic、10357/10368CLS、32BSRAM、22.75/24DSP，无有效setup/hold/recovery/removal余量、无新码流，加严构建未运行。三个前候选路由失败及错误目标中止均保留；不能用0 unrouted字样放行。COM6未找到，串口清单为空，本轮板状态未核实；无下载/发音/Flash/TF操作，最后成功确认仍76号。探针**已实现待验证**、整机**部分实现**，禁止下载结构探针；下一步针对核心高占用/局部路由及真实命令包装继续优化，不擅减复音/泛音或取消可视化，不据此裁定双板。

> **2026-10-19联合布局实际边界**：见[85号](85-音乐存储联合布局与RAM模式修正-2026-10-19.md)与`experiments/joint_timing_20261019/project/CURRENT.md`，版本`joint-timing-20261019-v0`。先备份106项、修RAM前8项、原生RAM前8项；保留84/83及原源。建立保留音乐/可视化/扫描/录放的串行结构探针，实际PLL与55个SDRAM内部端口；不是实体演奏协议，禁止下载。联合PnR先暴露rc_delta_store的DPB READ_FIRST不支持，已改为写口保持＋碰撞旧值旁路；36万拍对照、160帧位置/5帧扫描回归通过。音高双存储改原生RAM，寄存器718→142，8万拍独立全地址及96万拍音高对照、三组985PCM旧轨迹逐字节一致；两延迟各200音乐PCM录入/读出和200图案播放在限定数字范围**已验证**。但最终综合20189Logic/11243寄存器/31BSRAM，默认和策略1均PR0003，仍158寄存器未放置，**联合布局未通过、无有效时序余量、加严构建未运行**。全部六构建保留FAIL；不能用资源总数或RTL回归放行。新路径**已实现待验证**、整机**部分实现**，没有下载/Flash/TF/新听感；COM6只读确认76号就绪/活动0/512拍。下一步压缩结构探针开销/状态布局并重做联合PnR，最终混音/文件/非易失继续**待实现**，不据此擅自减少功能或裁定双板。

> **2026-10-19音高状态资源优化**：见[84号](84-音高状态分存与资源优化验证-2026-10-19.md)与`experiments/pitch_memory_20261018/project/CURRENT.md`，版本`pitch-memory-20261019-v0`。先备份102项，82号音乐/存储副本仅改pitch_mod状态存储；96万拍四配置逐拍/全组对照、两故障反例、原三组506645拍/985PCM轨迹逐字节一致及配置/包络回归，在限定数字范围**已验证**。公平综合20422→20117Logic，省305，BSRAM仍31，余619Logic/15BSRAM；寄存器增加64，并非整表变成RAM。无完整联合PnR或新音高实体验证，优化路径**已实现待验证**，整机**部分实现**。系统盘耗尽期间的轨迹/构建不签收，转D盘后完整重跑并保留失败；没有删除历史交付。用户断电后已用操作2重载76号，COM6身份/512拍/2048零PCM通过，无Flash/TF或新听感结论。下一步音乐＋实际SDRAM时钟联合时序，再接回放混音/文件；83号旧比较异常根因仍待定位，不据本轮综合解除。

> **2026-10-18录放SDRAM板验**：见[83号](83-录放SDRAM调度板验与诊断比较修正-2026-10-18.md)与`experiments/sdram_stream_board_20261018/project/CURRENT.md`，版本`sdram-stream-board-20261018-v4`。先备份19项、诊断修订前再备份117项；82号五个搬运RTL逐字节保持。实际COM6/B、ID81B仅操作2 SRAM，默认1024字FIFO/每向256KiB环形区，两次完整静音合成图案测试各1345540内存事务：266240样本/方向含两次回绕、停止后排空、在途/阻塞请求清空、132097连续前缀、8次读空和4096样本/方向恢复均在限定范围**已验证**。早期四个物理版本最终前缀比较异常均保留FAIL并恢复76号；分字节寄存复核后两次通过，未证明旧异常根因为工具或排除全部时序因素。选定v4加严PnR setup/hold +4.205/+0.011ns，余量紧、原始时钟布线警告/确切die温压/完整联合时序仍**待验证**。已恢复76号，身份/512拍/2048零PCM确认，无Flash/TF操作。新调度限定板验完成，文件/非易失/最终混音/真实音乐录放及完整联合PnR仍**待实现/待验证**，整机**部分实现**。下一步先恢复逻辑余量并做音乐＋存储联合时序，再接回放混音/TF文件，不能用独立诊断余量签整机。

> **2026-10-18录放环形调度接合**：见[82号](82-录放缓冲与SDRAM环形调度接合-2026-10-18.md)与`experiments/sdram_stream_20261018/project/CURRENT.md`，版本`sdram-stream-20261018-v0`。先备份101项，冻结原音乐/双FIFO，沿用81号注册输出控制器；新增录制/回放独立SDRAM环形区、四客户轮转及clear接受/清退/完成围栏，停止采集仍排空旧队列。四配置共680016拍/49139内存请求/6341清空、最多等其他3次授予；双后端整链及溢出前缀/读空恢复、四个故障反例在数字范围**已验证**。同工程20124→20422Logic，31BSRAM，余314Logic/15BSRAM；只算联合综合，无新PnR/板验。中间一次工具卡住人工终止，退出0仍不计通过，串行新工程正常完成后才签收。本轮无下载/COM/Flash/TF访问，板上仍76号；实际新调度**已实现待验证**。逻辑数据搬运已接通，但TF/文件/非易失/事件配对/最终混音/完整音乐联合时序仍**待实现/待验证**，整机**部分实现**。下一步隔离调度板验、联合时序与资源优化，再接TF和回放音频，不能用SDRAM易失缓存冒充断电保存。

> **2026-10-18 SDRAM时序与板验**：见[81号](81-SDRAM时序排查与板级读写验证-2026-10-18.md)及`experiments/sdram_timing_20261018/project/CURRENT.md`，版本`sdram-timing-20261018-v0`。先备份109项，修复前再备份194项；隔离注册命令/地址/DQM输出，18万拍9593事务旧源对照和原SDR模型/四反例通过。补齐内部SDRAM映射、双向min/max及相关时钟约束，27→27MHz PLL改善核心时钟分布；正常setup/hold为+5.704/+0.225ns，加严为+4.204/+0.037ns，原未注册加严−0.877ns反例和漏约束假绿反例保留。实际COM6/B、ID81B，仅操作2 SRAM，两次8MiB双图案写读各16777216事务无错；已恢复76号并确认身份、512拍采样与2048零PCM。限定板上路径**已验证**，原始PLL输入PR1014/确切die与封装时序/温压和长期保持仍**待验证**，不作量产签收。本轮无Flash/TF访问或音乐源/GUI/旧快照变更；完整音乐＋新控制器联合资源/PnR、FIFO仲裁/环形区、TF文件/非易失/混音仍**待实现/待验证**，整机**部分实现**。下一步接录放缓冲与SDRAM有界调度/清退，再做联合时序与实测。

> **2026-10-18 SDRAM控制增量**：[80号](80-SDRAM单事务控制与时序模型验证-2026-10-18.md)与`experiments/sdram_controller_20261018/project/CURRENT.md`为新存储控制实验。先备份108项；冻结79号引擎/双FIFO，新增16位单事务、32位SDRAM/半字DQM、200us候选初始化、CAS3、显式预充电与自主刷新。2147事务/1090读1057写、95刷新、最长间隔397拍、最长接受后响应11拍及四个故障反例，在自写子集模型范围**已验证**。公平联合综合20082→20114Logic，BSRAM仍31，余622Logic/15BSRAM；整体映射差值不等于控制器固有成本。真实die时序/封装内引脚/约束/收发时钟/PnR/板验仍**待验证/待实现**，没有下载/串口/Flash或介质访问，板上仍76号。FIFO到SDRAM环形缓冲/仲裁尚未连接，TF/文件/非易失/混音仍**待实现**；整机**部分实现**。下一步缓冲调度/在途事务清退与实际SIP包装/模型、资源和板级验证，不把子集模型PASS当实体RAM已可用。

> **2026-10-18录放缓冲增量**：[79号](79-录放双向缓冲与停顿边界验证-2026-10-18.md)和`experiments/pcm_buffer_20261018/project/CURRENT.md`为新存储实验入口，音乐引擎沿用78号。先备份206项；新增两路1024×16同步RAM FIFO、录制溢出锁存/连续前缀保护、播放读空报告与独立清空。2/8/1024深度共153180拍独立队列参考/坏指针反例、2290578拍双路压力仿真通过；512拍采样、约14.81ms后台停顿后2344录制样本完整、同时2304播放样本无读空。公平联合综合19765→20082Logic、29→31BSRAM，余654Logic/15BSRAM。限定数字缓冲/综合**已验证**，无PnR/板验；SDRAM/TF控制器、文件保存、非易失、最终混音/曲谱配对仍**待实现**。本轮无下载/串口/介质/Flash访问，板上仍76号，原源/GUI/快照保持；录放整体**部分实现**。小FIFO单向满容量约19.42ms，不能保证卡停顿；下一步SDRAM初始化/刷新/读写与缓冲调度资源探针，后端切换还须清退在途事务。

> **2026-10-18参数回读RAM优化**：[78号](78-参数回读RAM与逻辑余量恢复-2026-10-18.md)及`experiments/register_memory_20261018/project/CURRENT.md`为最新源码入口。先备份195项，保留原reg_bank/旧顶层和77号；仅在实际tdm_top_owned接入128字节同步RAM与35字节实时镜像/前拍写转发。15万拍全地址存储/复位、5万拍9993次回读对照及漏转发反例，原音乐/包络/配置回归和115200板级包装仿真通过。同工程20635→19765Logic，减少870；11592→10844寄存器，BSRAM28→29，余971Logic/17BSRAM。限定数字与综合**已验证**；诊断PnR10629Logic/22BSRAM，setup+9.076/hold+0.074ns，无新下载/串口/介质或Flash访问，实体新RAM路径**已实现待验证**。当前板上仍为76号；GUI/原源/旧包/快照保持。非易失、SDRAM/TF与录放仍**待实现**，整机**部分实现**；下一步以恢复的资源做存储控制器和缓冲的隔离验证/联合预算，不据诊断余量承诺全功能。

> **2026-10-17效果器存储优化**：[77号](77-效果器单读口与存储资源账-2026-10-17.md)及`experiments/fx_memory_20261017/project/CURRENT.md`为最新源码入口。先备份189项，仅隔离改fx_delay为单同步读＋标签/转发，保留原抽头更新边沿及现有调度。两轮各60万拍、两种深度逐拍输出/十抽头/写回对照、错位标签反例和原音乐/包络/配置回归通过；同工程20537/46BSRAM→20635/28，释放18块但Logic增98仅余101。数字优化/综合**已验证**；14脚新诊断PnR10369Logic/21BSRAM，setup+7.694/hold+0.083ns，未下载/新板验，实体路径**已实现待验证**。板上和GUI仍用76号已实测版本；原源/包/旧快照保持，本轮无COM/Flash/介质访问/采购。原效果器实际free-running调度与注释不符及启动未知另列，等价不当作时间规格达标；断电保存/TF/SDRAM/录放仍**待实现**。下一步用释放RAM换逻辑余量，再接存储控制，整机仍**部分实现**。

> **2026-10-17包络资源优化与配置板验**：[76号](76-包络共享资源优化与配置板验-2026-10-17.md)及`experiments/envelope_resources_20261017/project/CURRENT.md`为最新入口。先备份172输入，仅隔离共享互斥D/R运算；680560组×3宽度参考、原音乐逐拍/独立包络/配置传输及104GUI回归通过。相同工程仅osc_env不同，20767→20537Logic减少230，余199，BSRAM46/46；联合综合**已验证**，无完整联合PnR。14脚配置诊断PnR10495Logic/39BSRAM，setup+8.486/hold+0.074ns；实际COM6/B、ID81B，仅操作2 SRAM下载，新能力75/1，5次配置确认、快慢起音/击发/两独立音/坏CRC与忙拒绝、最终2048零PCM在限定板上范围**已验证**。当前SRAM已为新配置诊断，使用本轮隔离GUI；旧73六用例与原GUI/exe保留回退，未覆盖或读写Flash。加速复位测试仅确认512时隙关门/幅度/待写及零PCM，不宣称短窗口env全清或新增物理S2实测；新听感待用户反馈。整机仍**部分实现**，断电保存/录放/独立效果/四层/实体显示触控等缺口保持；下一步缓存与存储资源账、非易失和录放接合，不据诊断余量签整机容量。

> **2026-10-17可靠配置传输/GUI接合**：[75号](75-配置可靠传输与GUI接合验证-2026-10-17.md)及`experiments/config_transport_20261017/project/CURRENT.md`为最新实验入口。先备份138输入，隔离接合能力75/ABI1、CRC完整帧、inactive bank提交、事务/版本回读、失败隔离/恢复及GUI应用，旧D4部分应用保留。串口独占/双入口与标准115200引脚到PCM、11主机故障项、104离线GUI、原包络/逐拍兼容及反例在记载范围**已验证**。完整联合候选实际综合20767Logic，超20736上限31，**未通过**；逐位CRC尝试已回滚，失败报告保留，无本版本PnR/码流/板验。完整配置仍**部分实现**，仅通电有效，非易失/录放/完整四层/独立效果/实体触控显示缺口保持。原源/GUI/74号/旧快照不改，未开COM或下载/Flash/采购；下一步有回归约束的资源优化，再做对应音频板级包装/PnR和真实应用确认，不以仿真回执当实体成功。

> **2026-10-17乐器配置/独立包络接合**：[74号](74-乐器配置与逐层包络接合验证-2026-10-17.md)及`experiments/instrument_config_20261017/project/CURRENT.md`为最新实现入口。先备份110输入，在72号隔离副本扩88位运行时槽和独立A/D/R时间参数，schema1持续/击发/混合、频谱与ADSR可编译到逻辑配置口；旧音保留配置、新音用发布数据仍为原型。11项编译检查、5万拍独立RAM/包络参考、最大分频两次回绕、4123PCM/5ON5OFF整链、原985PCM逐拍兼容及额外启用选项兼容、3反例在限定数字范围**已验证**。完整组合综合20277Logic/11189寄存器/45BSRAM，余459Logic/1BSRAM，未PnR/新板验，不保证全产品容量。当前仍仅Nano20K＋喇叭；CLI只写本地文件，真实UART/GUI应用、非易失及独立颤音/效果器仍待接，开启不支持项明确拒绝，完整配置**部分实现**。原源/GUI/71/72/73/旧快照保持，无新下载或Flash操作；下一步可靠传输/能力确认与GUI应用，再接板级验证。

> **2026-10-17在手硬件更正**：用户最新明确当前只有Tang Nano 20K和喇叭，暂无屏幕与实体触控；以此覆盖较早“已有显示屏”的在手清单，不能安排立即点屏/实体触控实测，也不将屏幕候选视为已购买/已到手。约7英寸右手泛音显示触控、逐音滑条及可视化功能目标保持；接口/面板仍待选型闭环与实物验证。73号板载音频限定实测继续有效，原RTL/包/快照未改。后续优先推进不依赖新增外设的完整乐器配置/逐层包络及主机参数应用，使用虚拟输入和仿真继续验证，再将已接合路径上板；录放/存储仍按资源与接口证据推进，不能把板载TF卡座当作已有存储卡。此为开发顺序建议，不替用户冻结音乐行为、取消功能或发起采购。详情见`notes/hardware-availability-20261017/CURRENT.md`。

> **2026-10-17板级实测**：[73号](73-板级音频实测与复位按键更正-2026-10-17.md)与`notes/board-audio-hardware-20261017/CURRENT.md`为最新实体入口。USB恢复后识别COM6/B、GW2AR ID81B，操作2临时SRAM下载成功，实际UART profile72/ABI1/D3正确；六项2048PCM回读、512拍采样、32组满载/34子ON抢占和停止清音在限定板上范围**已验证**。短音另捕获起音/释放下降/最终零PCM；实际复位后计数/绑定归零、2048零PCM，重新A4演奏成功；用户反馈能听到且暂未发现异常。重要更正：约束87脚对应**S2**，旧72/40/41等“S1/87”是文字编号错误，按S1的失败记录保留；码流连接未改。原源/GUI/71/72准备包及旧快照保留，新证据另存，不读写Flash。实体引脚边沿/外部I²S时序/模拟质量、屏幕/触控/完整整机及配置/存储/录放缺口仍待验证/实现；不把短诊断检查外推整机完成。

> **2026-10-17板级音频准备**：用户此前未上电；新增[72号](72-板级音频诊断准备与复位清音验证-2026-10-17.md)及`experiments/board_audio_20261017/project/CURRENT.md`。先备份542项，隔离14脚音频诊断与静音回退，保持原源/GUI/71号及旧快照；发现按住双层音复位后时隙可残留发声，板级默认启用两遍512时隙清音/启动围栏，默认关闭路径仍与71号三组506645拍/985PCM逐字节一致。板级284PCM/40ON38OFF/12移动、实际115200配置仿真、512时隙清零及故障反例、主机9项检查在限定数字范围**已验证**。最终默认策略PnR 15258Logic/7287寄存器/36BSRAM/14IO，内部27MHz setup +3.523ns、hold +0.214ns、TNS0；策略1超时保留，外部I²S/实体未验，诊断资源不外推完整71号/整机。交付SRAM临时镜像/静音回退/只读默认串口脚本，**已实现待验证**；未开实际串口、下载、读写Flash/采购，下一步上电核验并保存真实音频与状态证据，完整配置/录放/7英寸等缺口保持。

> **2026-10-16资源优化与防回归**：[71号](71-资源优化与逐拍等价回归-2026-10-16.md)采用锚点共享、身份预取及触点记录缓存/写转发，保持原音乐、事件/采样与右手规则；5000事件、锚点与桥接专项、三组完整音乐506645拍/985PCM参考/选定轨迹逐字节一致，3个故意错误副本均被检出，限定数字范围**已验证**。同工程重新综合20668→19892Logic、12604→11120寄存器、43BSRAM不变，余844Logic/3BSRAM，未PnR/板验或证明完整产品容量。当前入口`experiments/resource_safety_20261016/project/CURRENT.md`；完整包络/配置、断电保留、伴奏录放/曲谱、7英寸界面及约500元制造继续**待实现/讨论中**。先备份500项，原源/GUI/70号/旧快照保持，无采购/下载，不减少用户功能或冻结新交互。

> **2026-10-16四槽/双层音频接合**：[70号](70-四槽运行时音色与双层音频原型-2026-10-16.md)新增四个运行时16分量槽、暂存完整提交、双层独立预设/身份与一指双组滑音，选择变化后释放旧层、被抢层不误控新声部等限定数字范围**已验证**。真实音乐352样本、理想原始扫描到双层259样本，原PCM/I²S兼容通过；完整通用配置仍**部分实现**，起音/释音/效果器共享，四层同时、GUI/实体完整应用、断电保留、伴奏PCM录放/曲谱、7英寸界面继续待接。选定联合综合20668Logic/43BSRAM，仅余68Logic/3BSRAM；不是整机资源、引脚/时序或实体签收，先进一步优化，不擅自减功能/加板/扩大约500元预算。旧音保持配置、最多双层与抢占策略是原型边界，不替用户定案。原源/GUI/69号/历史快照保留，当前入口`experiments/instrument_layers_20261016/project/CURRENT.md`。

> **2026-10-16左手从位置到音频接合**：[69号](69-左手实例事件与真实音频接合-2026-10-16.md)完成带实例身份的物理输入端点、接受/完成反馈和逐指绑定，数字扫描到真实PCM及同音独立滑动/松手/抢占保护已在限定范围**已验证**，同时保留原来源行为与左右手保持/恢复。并行/串行实例候选联合占用19758/19621Logic、41BSRAM；不把余1115Logic/5BSRAM当全功能容量，未PnR/实体/试听。故障超时、世代与测试26端点/位置尺度不冒充最终音乐规则；原源/GUI/68号/协议/快照保持并先备份。完整配置/四槽分层、断电保留、伴奏录放、7英寸界面和约500元制造仍**待实现/讨论中**；当前实施入口`experiments/left_hand_events_20261016/project/CURRENT.md`。

> **2026-10-16整机实现持续推进**：[68号](68-整机接合实现与扫描资源优化-2026-10-16.md)新增整机实施清单和接合候选。左手6路96节点扫描/校准/26条位置数字链、音乐/FFT并发已在限定范围**已验证**，但位置→实例事件/逐指绑定仍待接；参数和电极映射只是小样设置。联合资源原滑音20175Logic/41BSRAM，共享滑音候选17234Logic/41BSRAM，减少2941Logic；原行为对照及整链通过，未PnR/板验。录放、完整配置/分层、非易失保存、7英寸界面与最终制造继续**待实现/讨论中**，不自动扩大500元或加板。每控制字授权等64拍时扫描2.011ms，未过2ms规划，整机≤10ms未验。原代码/旧实验/GUI保留并先备份；进度入口`experiments/system_integration_20261016/project/IMPLEMENTATION.md`。

> **2026-10-16推子接入声音的实现增量**：[67号](67-右手推子音频接入与联合资源探针-2026-10-16.md)交付独立音频原型，完整报告→分区推子→映射/平滑→真实合成PCM，在限定数字仿真范围**已验证**；保持及平滑恢复不重奏、不改基础谱/音高/相位/包络，覆盖释放包络。原产品及浏览器几何演示未替换；后者仍无音频。8组/2倍等是试听配置，跨区和层/PCM范围仍**讨论中**。资源发现：保留旧扫描并叠可视化21658/20736Logic，综合失败；隔离去旧扫描后18292Logic/39BSRAM，尚未含新实体左手前端及其他待实现功能，未做PnR/板验。整机继续**部分实现**，不把诊断余量当最终选型或单板部署保证；500元预算与硬件闭环仍待完成。原194/930/43项备份并保持，main192/最新engine246身份通过。

> **2026-10-16分区推子代码交付**：用户确认左右/算术中点并授权实现，新增66号及独立RTL/浏览器原型；同侧最近、双侧中点、松手保持、完整报告快照/原子发布与恢复抢占在数字范围**已验证**。用户补充分区隔离、范围可调；原型按硬边界内调半径，是否显式跨区及横向距离度量仍按原型设置记录。2480帧与11项规则单元、11项UI检查通过；示例8组封装独立综合564Logic/0BSRAM，没有联合PnR/板验或声音应用。产品仍**部分实现**，具体屏驱动、声音映射/平滑/尾音/层与回放范围待接合。原194/930/219来源备份并保留，未替换GUI/引擎/码流/图纸/旧BOM/快照；见`experiments/right_hand_faders_20261016/README.md`。

> **最新右手推子决定（2026-10-16）**：用户明确选“触点附近的泛音推子随触点移动”，同侧两个触点取最近者，两侧各一个则推子移动至中心；松手保持继续有效。旧相对位移/落指单组独占不再作为默认方案，未选择靠近手柄才接管。当前需确认分侧方向及“中心”的几何含义，距离/影响范围/交接平滑仍**讨论中**，新行为**待实现**。本轮仅记录用户决定，无引擎/GUI/图纸/采购变化；见65号顶部增量。

> **2026-10-16可行性与右手应用审计**：[65号](65-成本可行性与右手泛音构造应用审计-2026-10-16.md)确认当前约558元只是附条件模型，便宜MRB7966为16位并口，不能与原SPI/17GPIO方案拼接签收；适配、替代资格、SMT最小装配与含运报价仍缺。右手构造分正式基础谱、演奏修饰、编辑草稿，7英寸/全和弦/松手保持/RESET目标保持；组数/相对手势细节仍候选。当前ca03主机仅空闲应用预设/谱，旧RTL掩码命中255且刷新只看gact，完整多指触屏/平滑/保持/尾音范围未完成；100Hz触控也不能证明10ms。分层各自基础谱与PCM伴奏受右手影响的范围待讨论，不自动冻结。核查在只读源码/资料/算式范围**已验证**，产品路径**部分实现/待实现/待验证**；无引擎/图纸/旧BOM/快照变化或下单。下一步先收口可接合整屏与隔离控制/资源证据，再取制造实价。

> **2026-10-16降本与装配决定**：[64号](64-七英寸整机降本候选与选择性装配-2026-10-16.md)新增独立条件BOM，不覆盖旧表。Nexperia C179326/台舟四通道C2841426国内公开参考，使26音位例部分电子料采购模型潜在降低61.06元；RC/漏电/电容/串扰/封装与数量档结算未闭环，状态**讨论中/待验证**。原其余315元预留保持，180元屏参考下情景约558元，适配未含，不能宣布500元达标。用户确认排针/按键/普通贴片可自行焊接，小封装交厂；另报告已有5V3A电源，型号/铭牌后补。按选择性SMT收口，电源资格及具体扣费待核，45元电源/线材/路径合项未直接扣除。7英寸及全部功能目标保留，无图纸/引擎/旧BOM/快照变更或下单。下一步先验证替代小样、补整屏含适配及实际制造报价。

> **2026-10-16成本调查增量**：[63号](63-七英寸整机成本调查与预算缺口-2026-10-16.md)保留500元新增目标和约7英寸方向，明确此前“200＋300”不是实际报价。18条国内公开Offer、9条国际USD阶梯与最小包装算例表明，当前保守混合参考情景约619～712元且部分仍有选配/适配缺口；其中315元是未报价预留，7.2为假设换算，不能当实际市场总价或证明500元绝对不可行。后续需补齐屏幕国内整价、合格保护少量价、制造/装配与已有电源资格，再交付真实总价。没有自动扩大预算、缩屏、改交互或取消保护，成本与选型**讨论中**；没有采购/改引擎/图纸或旧BOM。

> **最新尺寸方向：右手约7英寸**。用户要求从整机布局继续低成本嘉立创选型，7英寸为新的主要筛选尺寸，先前2.8/3.5英寸保留为历史候选。[62号](62-七英寸右手触屏选型与整机布局评估-2026-10-15.md)交付整屏比较、真实库件/国内库存、470×220mm布局提案和500元成本分配；优先屏侧显存/图形命令＋SPI显示/I²C多点触摸。型号/整价、GPIO/供电与联合资源未闭环，未冻结采购或制造，不能将LT7680A-R库命中视为在售（国内已停售/0库存）。原两屏、左手两排逐音滑条＋选档八度条、录制伴奏＋现场演奏和AUX需求保留；13格/8组仅图示。选型**讨论中**，新增功能仍**待实现/待验证**；原生工程只读哈希零变化、main192身份PASS，无引擎或旧BOM/图纸变更。

> **伴奏功能硬件规划增量**：[61号](61-录制伴奏与现场合奏硬件规格规划-2026-10-15.md)给出复用Nano/TF座/SDRAM、SDHC卡/PCM带宽/1MiB缓冲预留与新增AUX电路规格。候选设计值和预算分配均未当成已验证/已报价；DAC须先核当前52.734375kHz及实际串行时序，整机联合资源也未闭环。实现仍待完成，不先加第二板，不修改原引擎。

> **最新用户决定：录制伴奏＋现场独立演奏**。正式增加“先演奏并保存钢琴伴奏，播放该伴奏时，再现场演奏弦乐旋律”。至少支持一段已保存伴奏与现场演奏同时发声，二者可使用不同乐器、不同音符与节奏；不再将回放期间手动演奏一律禁用作为最终产品规则。此功能与原同音音色分层并存，状态**待实现**。循环、继续叠录、轨数、速度调整、事件/音频回放选择及表情作用范围仍**讨论中**。见57号§6；下文较早“未决定分轨”的记载保留为历史。

> **本轮讨论增量**：用户要求重新讨论音色分层与演奏录入。下面已确认的功能保留作讨论起点，这两项的具体规则继续**讨论中**；没有新增分轨/循环叠录决定，也不替用户取消既有录音/回放目标。相关实现以讨论后的用户决定更新，本轮未修改代码或制造文件。

> **本轮复述口径与恢复推进（含AUX及上位机11版之后）**：用户要求继续硬件选型和最终实现，当前先复述产品功能与硬件要求。已解除前段问答期间的实施等待；此处不视作付费采购/打板下单，也不把未决音乐语义默认为已冻结。后面的历史“暂停”“右手形态未定”等须按以下最新汇总及59/60号阅读。

## 当前执行汇总

- 核心产品：实体机独立完成自定义乐器、实时表情和最多四槽同次演奏同音分层；定义由激励、频谱/分量、时间演化与表情映射组合。实体编辑入口为Edit→选择预设槽，已接受按压旋钮；乐器保存后必须断电保留。试听/设备应用/保存要能区分，具体在奏音更新规则未冻结。
- 面板：两排逐音滑条，每排完整八度；另有只选档、不测力的八度条。右手必须带能在手指下显示泛音图形的触摸显示区，作用于全和弦，松手保持、RESET平滑恢复；尺寸优先用户新提出的约7英寸。保留已有YT240L008N/ILI9341无触摸屏作音乐可视化，当前按两块屏核算；触摸屏具体型号、接口与安装尺寸仍为候选，不能写成已购。
- 音频：保留4Ω/3W原型喇叭；新增3.5mm仅接有源音箱/音响AUX的模拟线路输出，不要求耳机直驱。新增独立DAC/线路电路需计入预算，不能直接接差分喇叭端；插线静音未决。
- 录放：保存设备自身演奏音频并回放，实体演奏录入、曲谱指引与播放；新增已保存伴奏回放期间现场演奏另一乐器的独立内容。TF存储、SDRAM缓冲和音频/事件配对为实现候选；最少时长、逐音编辑、外谱、循环及继续叠录等未定，不新增麦克风要求。
- 硬件：沿用Tang Nano20K，拟用排针/排母插入自制载板并固定；原始左手电容电极/前端、小样和完整尺寸板均须实测。参数非易失存储、TF介质、两屏接口、按键/旋钮、音频线路输出、供电/保护/结构都纳入完整BOM。主实时计算沿用FPGA，不默认加计算MCU；只有联合资源/效果证据不足才评估双FPGA。
- 约束：新增采购与制造总预算约500元，已有板/屏/喇叭不重复购买；最坏触摸至发声≤10ms为待验目标。音乐可视化约20Hz局部更新是当前目标而非满负载实屏保证。完整32组×16分量是共享音源预算，不是每层各32组或四层复音已验。
- 状态：上位机11版窗口/离线流程已交付，仍只支持预设/泛音谱部分应用；完整自定义配置、实体触控、分层、双屏及录放联合闭环仍**部分实现/待实现**。不能将主机100项或main192输入PASS当整机完成。

本轮仅核对和更新执行汇总，main192输入身份PASS，未改产品源码、图纸或旧快照。下一步继续补AUX DAC/完整BOM与接口、原生图纸，配合隔离资源验证和电极小样；完整制造前收口实际屏/排针、面板尺寸端点、满载资源/延迟及真实报价。

> **最新新增需求**：保存演奏音频并播放、实体录入演奏、曲谱指引及播放，已纳入产品目标，均**待实现**。候选采用板载TF保存PCM＋演奏事件，SDRAM缓冲，参数EEPROM独立；录音最少时长、逐音编辑/外谱范围及操作细则仍待明确，不替用户冻结。见[57号](57-小样接线与录音曲谱功能扩展-2026-10-15.md)。三页小样接线草稿已保存，53元件/231引脚原生网表0差异、规则检查0项，仅为图纸范围验证；整机资源、实价、PCB和实体尚未签收。

> **最新工作顺序**：用户已明确恢复嘉立创硬件选型，见[56号](56-嘉立创硬件选型恢复与关键料审阅-2026-10-15.md)。已取得真实库引用并保存关键料审阅页/BOM；小样原理图/PCB/实价与实物性能仍待实现/待验证。下文“继续暂停”是此前阶段记录，现选型暂停解除；55号显示优化与实屏缺口仍挂账，未授权付费生产采购。

> **最新实现进展**：用户补充屏幕YT240L008N，先备份后完成[54号音乐可视化独立模块](54-音乐可视化独立模块与验证报告-2026-10-15.md)。波形/实际FFT/轨迹及20Hz调度在隔离数字测试范围**已验证**，产品接合**部分实现**；没有改原引擎。联合核心综合Logic19777/20736、BSRAM38/46，尚无真实IO/PnR/实屏，不能将剩余约4.6%逻辑当作完整产品足够的证明。ILI9341无触摸版已由用户确认，N变体实际接口/电平仍需实物核对；选型与制造继续暂停。下文较早进度按各次证据阅读。

本文汇总截至本轮用户已经明确的产品决定，作为后续讨论与实现的产品阅读入口。**“收敛”指产品主线和已决定的边界，不表示所有交互细则已经冻结，更不表示已经实现。**

> **2026-10-15后续决定**：用户明确八度切换条仅选择八度档位，不需要测力电路；接受增加一颗带按压功能的旋钮；自定义乐器必须在设备断电重启后保留。三项需求状态**待实现**，不再列为用户需求未决。用户允许在单板确实无法满足或效果不足时考虑双板；这是对原固定单计算板约束的条件性放宽，不是已决定加板或购买第二板。资源审计见50号。

> **当前工作顺序更新**：用户随后担忧可视化失败，暂停继续选型，优先进行[52号屏幕/可视化验证](52-屏幕与音乐可视化优先验证计划-2026-10-15.md)。产品主线保留；以下选型与小样是已整理候选，不代表当前继续制造。屏幕确切型号尚待补充，驱动仿真/联合PnR/实屏验证尚未完成。

> **屏幕信息增量**：用户现已明确ILI9341无触摸版本，随后补充8080/SPI接口描述；控制器级4线SPI候选完成[53号第一轮数字验证](53-ILI9341驱动仿真与资源探针报告-2026-10-15.md)。芯片型号不再未决，模块实际接口配置/排针/供电仍待核。驱动仿真通过不等于真实屏幕、完整三视图或联合PnR通过；选型暂停继续有效。

冲突处理：用户后续决定优先；本文不能替用户裁定下面明确保留的未决项。源码事实、版本与验证边界仍看[38号](38-代码盘点与实现基线-2026-10-09.md)，决定沿革看[39号](39-最新设计构想与落地差距-2026-10-09.md)。旧稿用于追溯，不能覆盖后续决定。

## 1. 产品定义与两条核心功能

**以Tang Nano20K为实时核心，在实体机上构造自己的乐器，通过多指滑条演奏和连续表情控制，并能让多个乐器随同一次演奏同时发声。**

| 已明确的产品决定 | 具体含义 | 实施状态 |
|---|---|---|
| 自定义乐器 | 组合激励、频谱、包络/时间演化、表情映射，保存为自己的乐器；包含实体机编辑和演奏时实时塑形 | 待实现；已有部分声音及文件管理基础 |
| 通用框架 | 既能表现多种可辨识的乐器行为，也能创造原有乐器之外的声音；用同一套可配置框架承载 | 待实现 |
| 音色分层／个人合奏 | 选择一个或多个乐器预设，同一次音符演奏驱动选中的乐器，各层保留自己的声音响应 | 待实现 |
| 可表达演奏 | 各手指控制自己音符的音高表情；右手音色构造作用于整个在奏和弦 | 数字接口部分实现，实体与完整行为待实现/验证 |
| 演奏音频录放 | 保存设备演奏产生的实际数字声音，之后可播放 | 新增需求，待实现；板载TF候选 |
| 实体录入与曲谱指引 | 在设备上录入演奏，显示参考曲谱/跟弹提示并支持播放 | 新增需求，待实现；录入/播放细则待明确 |

这里的“个人合奏”已经明确的例子是：演奏一个音，同时听到钢琴式与小提琴式预设的这个音。**自动创作其他旋律、自动伴奏或琶音不属于已经确认的功能。**

四个预设不是把产品限制成四种固定乐器：它们是四个快捷乐器槽。具体出厂音色名称、各类激励的详细规则仍需明确；不承诺以现有加法合成规模真实复刻所有声学乐器。

## 2. 实体面板：保留的最终形态

| 区域 | 已明确的设计 | 尚待落实的工程细节 |
|---|---|---|
| 音高演奏区 | 两排逐音滑条，每排覆盖一个完整八度，共两个八度；直接落指演奏对应音高，沿条移动实现滑音、手动颤音等，多指可演奏和弦 | 尺寸、滑动量程、端点音位、传感电极、滤波与标定 |
| 八度切换 | 另有一条独立滑条，只选择不同八度档位；不需要测力电路 | 档数、切换动作/在奏音规则与位置/接触器件 |
| 音乐可视化 | 已有YT240L008N，用户确认ILI9341无触摸版；原生240×320，候选横屏320×240、SPI/RGB565，由FPGA计算 | 实物接口绑带/排针/供电、联合资源/实屏；局部更新20Hz是目标，压力与短音缺口见55号 |
| 音色构造 | 沿用已有泛音构造方向，实时平滑修饰和弦音色 | 物理触控形态、分组数量、贡献叠加与增益参数 |
| 四个预设按钮 | 选择一种或多种乐器，支持自定义乐器演奏和分层 | 单击/组合操作、开关切换时机与层状态反馈 |
| 一个编辑按钮 | 按下后选择一个预设槽，在实体机编辑该乐器的音色、激励等 | 参数导航、试听、保存和退出流程 |

**取消的是独立钢琴键机构，保留原有两八度逐音布局。**不改成少数几条覆盖全音域的滑条，也不把整块单条多指面板当作已选方案。

音位数量暂按旧通道表的25音位（24个半音加高端点）计算，同时列出26音位增量。两排是否都独立包含完整端点尚未由用户明确；这不是重新选择总体布局。

右手交互延续后续决定：**全和弦修饰、连续变化、松手保持、RESET平滑恢复**，不能退回“只修饰单音”或“松手回中”。新音继承和可听尾音参与等已有V1.0设计项应继续追踪，但不借本文替全部建议参数完成冻结。

RESET恢复动作需要保留；它是否使用独立物理键，尚未冻结。带按压编码器已由用户接受，实体编辑增加该硬件；导航与确认的详细规则仍需形成操作表。

## 3. 通用乐器框架的定义

乐器不只等于“激励模式＋音色名称”。本项目已选择的组合方向是：

`乐器定义 = 激励 + 频谱/分量结构 + 包络与时间演化 + 表情响应映射`

- **激励**：声音如何获得和持续获得能量。框架需要考虑持续、瞬态及混合的行为类别；具体再激发、松手阻尼和自然衰减规则仍待确定。
- **频谱**：各声音分量的频率关系与基础幅度；以现有加法合成内核为起点，不把所有新乐器都限定成同一份静态泛音表。
- **时间演化**：起音、保持、衰减、释放，以及分量随时间的变化。实际可编辑字段和范围须结合资源与听感验证。
- **表情映射**：将演奏动作映射到有界的声音参数；动作含义应稳定，乐器响应可以不同。不能仅凭乐器名或未声明的速度阈值偷偷改变手势含义。

实现时要区分四类状态：**保存的乐器定义、尚未保存的编辑草稿、演奏时的实时修饰、正在发声的音符实例**。保存一个乐器，不应在没有明确操作的情况下把所有层的混音或临时修饰混入该槽。

首版自由度是上述模块的有界组合；任意连线的模块化工作站不属于已经确认的要求。具体声音生成模块能力不能先于FPGA资源验证作无限承诺。

## 4. 演奏与分层如何组织

统一事件接口、音符生命周期、配置版本与多实例身份是实现两条主线所必需的架构。以下是实现组织方向，不替代未决的音乐规则：

1. 一次手指演奏具有自己的音符实例身份；滑动更新所属音的音高，不能串控另一手指或已经重用的声部。
2. 一个演奏音符可关联多个乐器层的发声实例。各层共享这次演奏动作，但拥有各自的乐器配置、包络和发声状态。
3. 松手、尾音结束、重新触发、资源抢占需要显式处理，不能把多个层简单叠加后丢失身份。
4. 逐指音高表情与右手全和弦音色修饰职责不同；各层对公共表情的具体响应范围要有配置边界。

当前内核是**32组×每组16个分量**，32组由所有乐器层共享。按每个演奏音在每层占一组计算，四层时理论上最多容纳8个完整组合，尾音也占资源；这不是四层实体复音验收结果，也不是每种乐器各有32组。最终分层上限、尾音和抢占策略需经实现与联合验证确认。

## 5. 实体编辑：确定的入口与尚未冻结的流程

**已确定**：编辑键→选择四个预设槽之一→在实体机编辑乐器。编辑对象包括音色、激励，以及自定义框架要求的时间演化和表情配置。用户可以保存自己的乐器。

**建议流程，仍为讨论中**：保留进入前的分层选择→编辑目标槽的草稿并试听→明确保存、放弃或继续编辑→返回演奏。建议将结构性修改的生效时机与连续参数平滑分开处理，避免编辑造成不受控的声音突变。

不能把上述建议直接写成已确认的产品默认；尤其需要补齐：试听时哪些层发声、在奏音是否应用新配置、切换编辑对象如何处理未保存草稿、右手修饰如何与草稿隔离。

“保存乐器”包括**设备断电重启后仍保留**，已由用户明确。具体非易失器件、记录格式与掉电恢复机制待实现；电脑本地文件保存、设备RAM应用和设备非易失保存必须分别标注。

## 6. 固定技术边界与选型状态

- Tang Nano20K保留；触控算法、音乐发声与独立实体屏计算由FPGA承担，不以新增计算MCU替代。后续若资源/显示效果证据表明单板不能满足，可按用户新授权评估双FPGA板；尚未选定第二板。
- 电脑可用于配置、文件管理、调试和辅助显示；实体演奏应形成独立闭环。
- 已有Nano20K、TFT和喇叭；本轮新增采购与制造预算约**500元**，已有三项不重复计入。
- 保留实际最坏触摸到声音**≤10ms**目标，必须包含所有工作通道、滤波、处理和输出；当前尚未实测验收。
- 真实压力或力度能力必须有对应传感证据，不能将电容值或接触面积直接当作已测得的力。

三版选型均针对同一套完整两八度逐音滑条＋独立八度条，不是三块板，也不靠缩减音位让预算成立。详见[48号](48-两八度逐音滑条三版选型设计-2026-10-15.md)：

| 方案 | 目前定位 | 未完成的关键验证 |
|---|---|---|
| 定制PCB电容滑条＋FPGA计时前端 | 优先验证候选，最有希望适配预算 | 全规模扫描、位置稳定性、多指串扰、触摸延迟与实际人民币总价 |
| 定制PCB滑条＋原始电容CDC | 对照方案 | 通道/扫描时限与完整规模成本，不能假定满足500元 |
| 膜式位置滑条＋ADC | 对照方案 | 现查进口器件成本明显不适配；国产替代、接触检测、全规模成本尚无证据 |

**传感器/BOM尚未最终签定，制造文件尚未完成，500元不是已取得的完整实时报价。**依据用户新决定，八度条可按接触/位置选档设计，不再要求压力位置器件；仍不能用整条仅一个开关冒充多个档位选择。

嘉立创用于器件身份与供应核对、原理图/PCB、电极制造、装配及制造报价；不能自动保证音乐交互或传感性能。客户端4.1.71已安装、CLI检查通过；最近连接检查为未连接，未据此宣称已有可制造工程。

## 7. 必须继续明确的规则

这些是局部行为细则，不重开产品主线：

| 待明确事项 | 需要形成的结果 |
|---|---|
| 分层开关 | 是否允许全关；开层是否加入已按住的音；关层的尾音如何处理 |
| 激励与释放 | 各类别的再激发、保持、松手阻尼/自然衰减和资源回收规则 |
| 编辑与应用 | 草稿试听对象、修改生效时机、保存/取消与脏草稿切换规则 |
| 表情细节 | 滑音范围、八度切换对在奏音的影响、右手叠加/限幅与各层响应 |
| 持久化 | 断电保留已明确；还需器件、记录格式、写入动作和恢复策略 |
| 面板与外围 | 25/26端点、右手实际形态、屏幕实际接口/供电与喇叭参数；按压旋钮已接受，候选EC11E15244B2 |

规则应用“动作→预期声音→例外”的例子确定，由用户决定体验方向；实现不能用默认值代替这些决定。

## 8. 实现现状、验收与下一步

当前已有TDM声音底座和部分逐指接口、配置文件能力。第一阶段频率安全/重新起音修复位于隔离工作树，源码`a7427ed`、交付`683db48`；专项数字检查和最终PnR在记录范围内已验证，**未并入main、未下载板验**。完整自定义乐器、实体编辑、两八度实体触控、四槽分层与实体可视化不能标为完成。

本轮仅整理设计。主目录HEAD为`fe326ad9505c94f46f9236bf7f9bfc3b5f1b9a12`；入口指定基线检查192项PASS，说明既有输入未漂移，不是新功能验收。未改产品RTL、协议、参数表或构建入口，未更新源码快照；未新增仿真、综合、PnR、下载或试听。

下一步仍沿用已讨论的顺序：在已记录的第一阶段之上，推进**单乐器可写定义和生命周期闭环→连续表情与尾音→多实例分层→联合资源/实体演奏验证**。传感前端可先用相邻少量滑条验证测量方法，再核算完整25/26音位规模；小样通过不能替代整机验收。

最终演示应形成一条完整路径：实体编辑并保存自定义乐器→多指触摸与逐音滑动演奏→选多个槽，同一演奏驱动不同乐器→右手修饰全和弦并保持/恢复→实体屏显示→断电重启恢复保存的乐器→在全规模负载下验证可靠释放、声音过渡、延迟和资源。断电保留已明确为需求，实际功能仍待实现和验证。

## 9. 边界讨论与选型/打板的推进建议

2026-10-15用户询问应继续明确边界还是继续选型、打板。本轮建议为：**先收口会改变硬件的少量边界，同时推进选型和测量；先验证小样，再做完整面板。**此为推进建议，状态**讨论中**，不视为用户已批准采购、下单或任何未决音乐规则。

- 选型与原理图前优先明确：各区域真正需要测的位置/接触/压力等物理量、同时触点目标、八度条操作所需传感能力、实体编辑导航输入、非易失保存需求，以及屏幕/喇叭实际接口。全尺寸面板前另需明确端点音位、尺寸、间距和面层材料；可比较25/26预算，不能替用户定布局细节。
- 分层启停、再激发、编辑试听/应用等音乐规则继续细化，可先形成候选规则和数字验证，不必阻塞公开资料核对、小样电极与模拟前端研究。涉及改变物理输入能力或算力/存储规模的规则，应反馈硬件预算。
- 小样建议包含相邻3～4条逐音滑条及相关前端，检查位置连续性、串扰、误触、松手识别；同时做完整通道负载的扫描时序测量或保守上界估算。小样不能代替满面板多指及最坏触摸到声音≤10ms验收。
- 完整面板制造前应具备：可用的传感证据、完整规模通道/引脚/资源核算、含其他必需区域及结构/运费的约500元总预算、原理图/PCB检查和真实制造报价。当前尚不满足，不直接宣称可以定版打板。

本轮仅补充推进顺序建议；main192输入基线检查PASS，无产品源码或制造文件变更，无新增硬件验证，不更新源码快照。

## 10. 当前关键器件规格速查（2026-10-15）

**较新用户决定**：右手泛音构造区必须直接显示可操作图形，按带LCD的多点触摸模组选型。见[59号](59-右手触摸显示区商城筛选与接口预算-2026-10-15.md)：3.5英寸五点优先验证、2.8英寸紧凑备选，型号/尺寸仍讨论中；已有YT240L008N可视化屏不擅自取消，先按双显示器核算。下表右手“形态未冻结”现须在触摸显示这一边界内阅读；旧24节点容量例不表示右手仍用纯PCB条。

针对用户询问“触控屏、显示屏、音高滑条等规格”的澄清：目前没有选用触控显示屏；用户已有的YT240L008N为其确认的ILI9341无触摸版本，触控演奏由独立PCB滑条承担。本轮只核对规格，不新增音乐交互决定或冻结尺寸；main192输入基线PASS，无产品源码/原理图变更，无新增实物验证。

| 部件 | 当前规格或设计值 | 状态与差距 |
|---|---|---|
| 显示屏 | 已有YT240L008N、ILI9341无触摸；按2.4英寸、原生240×320设计，横屏320×240 | N后缀实物信息仍未独立匹配厂家规格书；供电、排针与接口绑带待核 |
| 显示驱动 | 候选4线SPI、RGB565（16位色）、SCK 6.75MHz；图表局部更新目标20Hz | 数字路径部分已验证；压力绘制最长51.721ms，非全负载20fps承诺，未实屏验收 |
| 音高滑条 | 定制PCB自电容，逐音独立条；两排各一个完整八度，总端点暂列25/26两例 | 优先候选；不是已有商品型号，也非单条覆盖全部音域；最终触点能力/量程/精度待测 |
| 四条小样 | 4条×每条3个电极=12节点；每条有效区48×12mm，中心距18mm；试验板约90×100mm内研究 | 实验初值，未冻结全机尺寸/覆盖膜；原理图部分实现，电极PCB未完成 |
| 触控前端 | 小样2×CD74HC4067M96＋1×SN74LVC14ADR，3.3V方案；每电极1k、每路测量47k、输出220Ω；每路10/47/100pF参考 | 图纸连通已验证，阻容为起始值，非模拟测量或抗干扰签收 |
| 八度切换条 | 1条独立分段位置/接触条，只选八度档位，不测力 | 需求明确，长度/段数未定；5段只是通道预算算例 |
| 右手音色区 | 沿用全和弦泛音修饰，松手保持、RESET平滑恢复 | 物理尺寸/电极形态未冻结，24节点仅容量算例 |
| 实体操作 | 4预设＋1编辑按钮（TS-1187A-B-A-B候选）；1个EC11E15244B2按压旋钮候选 | 已入小样原理图；机械尺寸/厂家引脚图及操作细则仍待完成 |
| 参数存储 | 24LC256-I/SN、32KiB、I²C；候选3.3V/400kHz | 用于自定义乐器，掉电保存协议待实现，不存演奏音频 |
| 录音存储 | 优先板载TF卡座＋8MiB SDRAM缓冲 | 卡型号/容量未定，控制器资源与录放功能待实现；5分钟只是当前核算候选 |
| 喇叭 | 用户已补充当前原型为4Ω、3W；音频输出沿用Nano20K板载MAX98357A路径 | 连接器/供电、实际音量与失真/温升待核；原型规格不等于已完成全机音频验收，见60号 |

[厂家YT240L008系列页](https://www.eya-display.com/yt240l008/)列有2.4英寸、240×320、TN/12点钟视角、300cd/m²、40Pin/0.5mm FPC和参考外形42.72×60.26×2.6mm；以上是系列资料，不把它们全部当作N后缀实物或转接板尺寸已确认。整机触摸至发声≤10ms、完整扫描帧≤2ms均仍为目标，不能把数字位宽或RC计时分辨率当毫米位置精度/实测多指能力。
