sakuyaShining/FPGA-Music-project-internal/notes/project-organization-audit-20261023/PR1-DESCRIPTION.md

项目的最新设计、源码和验证证据散落在多个工作树及D盘目录，默认main入口落后，旧双屏要求也未跟上后续人类决定。本PR建立可追溯的设计与接手入口，使其他Agent可以从私有GitHub取得已发布设计及明确身份的源码检查点。

- 保全22个历史检查点，18,277项文件记录；各自源码、约束、测试与验证边界保持区分。
- 汇入2026-10-23当前设计：直接人类决定取消J11实体音乐可视化屏、保留J10泛音触控屏，原话与会话turn入库；不削减其他功能。
- 新保全586项输入/上下文，含105项最新观察FPGA构建输入、新增复位/力度/strike源码与测试，以及所列硬件原生恢复ZIP。候选未合并，不能继承旧100输入的回归PASS。
- 新增DESIGN-CURRENT、机器设计登记、快速获取命令和Agent启动提示；入口检查拒绝旧版/未发布入口，并支持内容相同的squash合并。
- GitHub自动核验设计源指纹、归档和全部历史快照；恢复命令拒绝覆盖已有目录，不执行原始构建、CAD或下载。

验证记录在`project/versions/design-management-validation-20261023.json`，说明见`notes/project-organization-audit-20261023/RESULT.md`。已完成历史完整哈希/远程ref检查及新归档恢复哈希检查；发布后的新克隆与自动检查按实际结果登记。

本PR不修改活跃产品RTL或PCB，不进行新的功能回归/PnR/板测，不代表完整产品验收或制造放行。旧探针、旧板验、新候选和活跃CAD状态分别保留。main合入后成为默认阅读入口；实时发布管理分支仍保留，冻结标签仅用于复现。
