sakuyaShining/FPGA-Music-project-internal/docs/01-竞赛情报/monitoring-log.md

# 竞赛官网监控日志

> 由 `tools/scripts/weekly_check.ps1` 自动追加。**每周五 20:00 自动执行**。
> 判定规则：通知 id > `lastNewsId` 或 文件 id > `lastFileId` 即为有新内容。
> 基线状态存于 `tools/state/monitor-state.json`。

## 自动化机制

| 项 | 内容 |
|---|---|
| 计划任务名 | `FPGA竞赛官网周检` |
| 执行频率 | **每周五 20:00** |
| 错过后补跑 | ✅ 已启用（`StartWhenAvailable`，若周五没开机，下次可用时补跑） |
| 手动立即执行 | `powershell -NoProfile -ExecutionPolicy Bypass -File tools\scripts\weekly_check.ps1` |
| 查看任务 | `schtasks /query /tn "FPGA竞赛官网周检" /fo LIST` |
| 删除任务 | `schtasks /delete /tn "FPGA竞赛官网周检" /f` |

### 预计执行日期（至提交截止）

| 日期 | 备注 |
|---|---|
| 2026-09-18 | ✅ 基线（已执行） |
| 2026-09-25 | |
| 2026-10-02 | |
| 2026-10-09 | |
| 2026-10-16 | |
| 2026-10-23 | |
| 2026-10-30 | ← 提交前最后一次 |
| 2026-11-04 18:00 | **作品提交截止（死线）** |

## 监控范围

| 对象 | 方式 | 说明 |
|---|---|---|
| 官网通知 | ✅ 自动 | `/cms/news/list` |
| 官网文件 | ✅ 自动 | `/cms/file/list`（选题指南、报告模板、提交要求等） |
| 高云官网软件页 | ⚠️ 人工 | 是否有 EDA 新版本 |
| Sipeed 板卡资料 | ⚠️ 人工 | 原理图/例程更新 |
| 高云指导群公告 | ⚠️ **需你查看** | QQ 群 213923272，我无法访问 |

> 自动部分覆盖了最关键的"官方发布"；人工部分属辅助渠道，阶段性检查即可。

## 变更历史

| 日期 | 通知 id | 文件 id | 结果 |
|---|---|---|---|
| 2026-09-18 | 56 | 25 | 基线建立（通知 55 条 / 文件 25 个） |

---

# 检查记录

## 检查 2026-09-18 19:33

- 通知总数 **55**（上次基线 id=56）
- 文件总数 **25**（上次基线 id=25）

> OK — 无新内容

## 检查 2026-09-18 20:00

- 通知总数 **55**（上次基线 id=56）
- 文件总数 **25**（上次基线 id=25）

> OK — 无新内容

## 检查 2026-09-27 15:58

- 通知总数 **53**（上次基线 id=56）
- 文件总数 **25**（上次基线 id=25）

> OK — 无新内容

## 检查 2026-10-02 20:00

- 通知总数 **53**（上次基线 id=56）
- 文件总数 **25**（上次基线 id=25）

> OK — 无新内容

## 检查 2026-10-09 20:24

- 通知总数 **53**（上次基线 id=56）
- 文件总数 **25**（上次基线 id=25）

> OK — 无新内容

## 检查 2026-10-16 20:00

- 通知总数 **54**（上次基线 id=56）
- 文件总数 **23**（上次基线 id=25）

### 新通知 1 条

- id=57  2026-10-13 15:35:59  「关于开放 AMD - RTLHLS 本地智能体设计赛道验证窗口的通知」

> 注意 — 发现新内容，需判断是否影响项目（评分细则 / 作品报告模板 / 提交要求 / 选题指南）
