sakuyaShining/FPGA-Music-project-internal/docs/02-技术方案/35-五阶段推进状态.md

# 五阶段推进状态（阶段闸口）

> **2026-10-09：本文是累积历史，前半“事件通路已完成”已被后半缺陷复现与收口记录推翻。**
> 当前状态查 [38-实现基线](38-代码盘点与实现基线-2026-10-09.md)，设计差距查 [39-设计账本](39-最新设计构想与落地差距-2026-10-09.md)。不要把早期阶段绿灯当作当前产品已验收。

> 目的：让"能不能进下一阶段"只看这张表，不靠回忆。
> 规则：**每个阶段的完成条件必须是可复核的证据，且每项绑定源码 SHA。**
> RTL 基线：`c5ec00a`（其后仅文档/测试台改动；可用
> `git diff --stat c5ec00a -- src/rtl` 复核，当前为空）。

---

## 阶段 1 · 收口规格与基线 —— ✅ **完成**

| 完成条件 | 状态 | 证据 |
|---|---|---|
| 一页当前规格 | ✅ | `docs/02-技术方案/34-当前版本规格-基线v1.md` |
| 绑定源码 SHA | ✅ | 规格头部绑定 `c5ec00a` + 复核命令；且 `git diff --stat c5ec00a -- src/rtl` 为空 |
| 干净工作树能直接构建 | ✅ | `git status` 空；全量门禁 34/34 |
| 旧判据同步（LED / GUI） | ✅ | LED E7 按 `led_ind` 规格重写（基线 commit 上复现确认原判据"注定红"）；GUI ⑥ 陈旧期望值 `0x05→0x01`，自检 10/10 PASS |
| 补标准 I²S 接收模型与边界测试 | ✅ | `tb_i2s_std.v` + `i2s_std_check.py`（200 帧跨正负，两条口径同线对照）；`tb_i2s_top.v` + `i2s_top_check.py`（顶层端到端，逐样本一致 0/5999） |

**门禁**：`regress_all.py --full` = **34/34**（`sim_build/regress_result.txt`，2026-10-06 22:15）

---

## 阶段 2 · 两个阻断项 —— 🔶 **事件通路已完成；I²S 待板级裁决**

| 阻断项 | 状态 | 说明 |
|---|---|---|
| **I²S 标准对齐** | ⏸ **待板级裁决** | 我方**未能复现**错位：两条独立接收模型（同一份位流并行解码）都判"源样本逐位相等"（滞后 2 字，不符 0/99），既有 `04 i2s` 亦 0/63。但**不能据此排除**——两条模型的相位假设同源；审计探针在复位后立即开累加，其首字取自复位期位流。**决定性证据在板上**：用示波器同看 WS 与 SD 的相对相位（S1 阶段）。详见 `33-审计复核记录` §一 |
| **事件待处理与接收确认** | ✅ **完成** | 四个源全部覆盖，判据进闸口：<br>① **pads**：`17 evloss` —— 8 键同时按放 = 16 条事件全对应（`pad_scan` 自带待发位图，未改）<br>② **汇合点 + 队列端到端**：`18 evmerge` —— 排针 12 + **真实 UART 字节流** 8 + 两源并存 8 = **28 条一条不丢、note-off 14/14、队列溢出 0**<br>③ 单元：`tb_evhold` 全绿（不丢/保序/深度/溢出/空队）<br>三个已修的真问题见下节 |

### 阶段 2 事件通路修掉的三个真问题（都已进闸口）

| # | 问题 | 症状 | 修法 |
|---|---|---|---|
| 1 | `out_ready` 用了 `~nm_busy` 这种**电平** | busy 是状态输出，接收后下一拍才拉高 ⇒ 队列连续出队而 note_map 只收第一个（发 28 收 4） | `note_map` 增加单拍接收确认 `ev_ack = (st==ST_IDLE) && ev_valid` |
| 2 | 队列与 note_map 之间**多插了一级寄存器** | `ev_valid` 变成连续两拍为高 ⇒ 同一事件被消费两次 | 改成 `wire` 直连（队列输出已寄存，长链已断） |
| 3 | 优先级 mux **没有仲裁公平性** | 高优先级源 valid 持续为高时，低优先级源**永久得不到服务**（pads 持续有效 ⇒ 排针被饿死） | 改成**轮转仲裁**（每次成功接收转向下一个源，无事事则按固定优先级兜底） |
| 4 | UART 写是**单拍脉冲**，而队列要等很多拍才接收 | 请求下一拍就没了 ⇒ UART 事件 note 恒为 0（vel 却对） | wr 那一拍锁存 `uh_req` + **写入时刻**的 `uh_req_note`（含 on/off），被接收才清 |

> **判据口径的两条实测教训**（都写进了测试台注释）：
> · **不要用 `force` 驱动内部写口来伪造 UART 写**。第一版这么做，绕过了 `uart_rx`
>   与两字节组帧，整段 UART 事件都取不到音符；改成往 `uart_rx` 引脚喂真实
>   `[addr][data]` 帧（115200/8N1，234 拍/位）后立刻全绿。
> · **电极必须驱动到确定空闲态**（`= 16'h0000`）。悬空 wire 上是 `z`，
>   `pad_pitch` 看到 `touch=1` 会**持续**产生事件，在仲裁里把别的源挤掉。
> · **事件间隔要大于 `note_map` 的处理时间**（约 20 拍）。用"每条隔 4 拍"的激励
>   会持续反压、在源端丢事件 —— 那是**人类按不出的速率**，不是 RTL 缺陷。

### 阶段 2 剩余：只有 I²S 一项（待板级裁决）

`event_hold.v` 已接进 `tdm_top`（参数 `EVQ_DEPTH`，默认 4），四个源全部有挂起位/反压。
I²S 那一条仍**待板上示波器实测 WS 与 SD 的相对相位**（详见 `33-审计复核记录` §一）。

### 接线未完成的真实原因（**已全部解决**，留档备查）

曾经记录过三个问题，现在都已修掉并进闸口（见上表）。留一条**方法论**在此：

> 教训一：**电平不能当握手**。凡"消费者说自己不忙"的信号，先问
> "这个不忙状态会持续几拍？"——多于 1 拍就不能直接当 ready。
>
> 教训二：**修好一个 bug 后症状换了形状，说明那个是真的修掉了。**
> 不要因为"还是红的"就以为白改 —— 要看红的方式有没有变。
>
> 教训三：**判据的激励必须走真源**。本套件第一版用 `force` 驱动内部写口来
> 伪造 UART 写，绕过了 `uart_rx` 与两字节组帧，整段 UART 事件都取不到音符；
> 换成往引脚喂真实 `[addr][data]` 帧后立刻 28/28 全绿。
> **"测到了"和"测对了"是两件事。**

---

## 阶段 3 · 统一声部生命周期 —— ✅ **完成**（六项均有判据）

| 项 | 现状 |
|---|---|
| **释放→回收闭环** | ✅ **已修并进闸口**（`19 alloc`）。修法两处：①`ST_GLIDE` 的 note-off 分支加 `gtab[gsel_r] <= FREE;` ②分配搜索加第三档"可回收"（真正空闲 `gtab==FREE` > 未在响 `!gact` > 抢占），使"松手但尾音还在响"的组优先复用，而**真正按住的组（`gact=1`）不会被抢**。<br>修前实测：32 组填满后释放，`gtab==FREE` 计数 **0**、新音抢走按住的 note40；修后 **31**、按住的音安然无恙 |
| 保存每声部力度/音色/状态 | ✅ **经判据确认为"不需要独立存储"**（`21 voice`）。理由：`note_map` 在**装载时**就把力度算进每个泛音的幅度（`vel_shape → amp_shaped → amp_cal = amp_shaped*vel_cur>>8 → load_amp`），引擎逐槽写进 `pa_mem` ⇒ **力度烘进幅度**。判据：vel=15 与 vel=3 的两组有 6/16 个泛音幅度不同（表确实在缩放）；装载第三个声部后前两组**一个都没变**；中途改全局 `0x6E vel_vscale` 也**不影响已发声声部**。⇒ 原先计划里的这条是**假设，不是缺口**；现在它成了被判据固定住的不变量 |
| 刷新 / 复位 | 部分（`0x63` 刷新已有；复位 VP7 已过） |
| 有空闲候选时不抢按住的音 | ✅ 优先级正确（同音 > FREE > 可回收 > 抢占），且回收修好后**真正会命中空闲/可回收档** |
| 完整位宽 Nyquist | ✅ `22 nyquist`：用 `inc = round(f*2^24/fs)` 独立算 128 个音，与 `note_inc.hex` **128/128 逐项相等**；最大增量 3990774 = 24 位的 **23.8%** ⇒ 位宽充足、**未截断**。并量化单声部 16 泛音的 Nyquist 约束（见下） |
| **整组提交（组内 16 泛音是否会"半新半旧"）** | ✅ **已定性并定量**（`21 voice` V4）。结论：**组内 16 个泛音不是同一帧生效**，实测分散在 **2 帧**内（跨度 **1 帧 ≈ 19 µs** @52734 Hz）：槽 4–7 在帧 1 提交、槽 0–3 在帧 2 提交。<br>这与 `consume = pv1 & (pp1 != ppr1)` 的**逐时隙**待生效语义一致（`pv_mem/pa_mem/pi_mem/pe_mem/pgq_mem` 每槽一份，各槽被访问且奇偶标签变化时分别生效）。<br>**判据口径（关键）**：不能用"与旧快照比较"——部分槽两次幅度本来就相同（`vel_wtab` 不缩放它们），无法区分「该槽未变化」与「该槽尚未提交」。改用**直接测提交时刻**：先等 `pv_mem` 全空作为起点，再重装并逐帧记录每个槽首次满足 `pv_mem==0 && amp_mem===pa_mem` 的帧号。实测 16/16 全部提交，跨度 1 帧。<br>**可听性评估**：1 帧 ≈ 19 µs，远短于任何包络时间常数（ms 级）⇒ **判为不可听**；但该结论依赖"跨度恒为 1 帧"，若将来改变装载顺序或帧长需重测 |
| 刷新 / 复位 | 部分（`0x63` 刷新已有；复位 VP7 已过） |

### 阶段 3 附带发现：预设表的 Nyquist 混叠（**阶段 5 必须处理**）

`23 preset nyq` 审计结果（`tools/scripts/preset_nyquist_check.py`）：

- 共 **49** 个 (音色, 泛音) 组合在某个音号之上**越界且有非零幅度** ⇒ 会**实际混叠**。
- 其中 **12** 组 `amp ≥ 64`（超过半幅），最严重的几组：
  | 音色 | 泛音 | 比例 | amp | 首个越界音 |
  |---|---|---|---|---|
  | #3 | 15 | 215.0 | 1 | 47 |
  | #3 | 14 | 190.0 | 1 | 50 |
  | #2 | 15 | 94.0 | **7** | 62 |
  | #2 | 14 | 84.0 | **9** | 64 |
  | #2 | 13 | 75.0 | **11** | 66 |
  | #2 | 12 | 66.0 | **14** | 68 |
  | #2 | 7 | 30.0 | **45** | 81 |

**判断**：这不是 RTL 缺陷，而是**预设数据**的选择——高音区本该衰减高次泛音，
而当前表给了非零幅度。听感后果是"高音区有不该有的音"。
**处理方式**：阶段 5 接新音色时，按"该音色实际用到的最高音号"给越界泛音配 0 幅度；
现在先把它**记录并量化**（判据可复跑），避免到那时才发现。

> **判据强度教训（阶段 3 踩到）**：`tb_alloc` 第一版只按 20 个音（< 32 组），
> 剩下 12 组的 `gtab` 本来就是 `FREE` ⇒ 空闲搜索照样命中 ⇒ **判据假绿、把缺陷掩盖了**。
> 必须**填满全部 32 组**才暴露。这与"模型不在标定区间""事件间隔小于处理时间"同类：
> **激励强度不够会造出假绿**，而假绿比红灯更危险。

---

## 阶段 4 · 收敛维护流程 —— ✅ **完成**（六项均有判据）

| 项 | 状态 |
|---|---|
| 源文件与数据清单统一入口 | ✅ `copy_data()` + `DATA_FILES`（缺表直接让闸口红） |
| 判据脚本对坏输入给可读结论 | ✅ `vel_timbre_check.py` 对"缺文件/缺行/含 X"分别报错 |
| **公开导出泄漏判据** | ✅ **已加固并进闸口**（`24 leakcheck`）。见下：原来"泄漏了也返回 0" |
| 严格退出码 | 🔶 门禁 `exit=0/1` 已用；**已补齐**：导出脚本"泄漏即 `return 1`"、生成脚本 `gen_tilt_wtab.py` 自校验失败即 `return 1`、审计脚本 `scan_traces.py` 加 `--strict`（A 列非 0 即 `1`）。其余脚本未逐个审 |
| 公开导出**移出活动工作树** | ✅ **已完成**（2026-10-07，按用户决定的**选项A**）：6 个整理/导出工具 + 27 个一次性 `_*.py` **物理移出**工作树，放到同级独立 git 仓 `../fpga-export-tooling/`（仍有版本控制，非裸删除）；主仓侧 `git rm` 取消跟踪。**规格留在产品侧**：新增 `tools/scripts/public_spec.py` 作为 `EXCLUDE / IGNORE_BLOCK / LEAK_PATTERNS` 的唯一权威来源，门禁 `24 leakcheck` 直接 import 它，搬走的 `make_public.py` 反过来读它（不再各写一份）。`make_public.py` 加 `--repo` 指定主仓（默认取工具仓上一级），**找不到规格即 `SystemExit(2)`，绝不退回旧规则**。验证：门禁复跑 **41/41 通过**；`--dry` 能跑通且不切分支 |
| **公开版实际泄漏复核** | ✅ **已核实无实际泄漏**：带词边界的严格扫描显示，真正含身份词语的文件（`refs/素材库/*`、`docs/02-技术方案/22-全面审计-*.md`）**本来就在排除清单里**；`public` 分支 188 个文件不含任何整理工具 |

### 公开导出（`make_public.py`）本轮审计结果

**发现的问题**：脚本在提交前只把三项痕迹计数**打印**出来，**泄漏了也照常 `commit` 并返回 0** ——
而"退出码 0"正是上游判断"这一步成功"的依据 ⇒ **泄漏会被静默放过**。

更麻烦的是，排除本身依赖两个**偶然条件**：
1. `git rm -r --cached .` 顺手把 `make_public.py` 自己清出索引；
2. `tools/scripts/_*.py` 只写在 **public 分支**的 `.gitignore` 里，**主线没有** ——
   工作树里那 **28 个未跟踪**的 `_*.py` 排查脚本"只是因为还没被 `add` 才没进"。
   ⇒ 一旦有人在别处 `git add -A` 过、或在另一台机器上重建，公开版就会带上它们。

**已做的修法**（不改产物、只改流程）：
- 新增 `find_leaks()`：提交**之前**逐条核对索引，命中泄漏规则即 **`return 1` 中止**；
- 新增自检 `tools/scripts/leakcheck_test.py` 并纳入闸口（`24 leakcheck`）：
  **干净 5 例不误报 + 泄漏 13 例必须抓到 + 混合 1 例只报泄漏项**。
  第二组是防"检测器失效"的关键——一个永远返回空的检测器会让导出**永远绿灯**，
  比没有判据更危险；
- `--dry` 预演不再执行 `git checkout`（预演的唯一承诺是"不创建分支/提交"，
  连 checkout 也不该做；原来它会打印 `[兜底] 已切回分支 main`）。

**"移出活动工作树"的建议做法**（下一轮执行）：把导出工具链
（`make_public.py` / `scan_traces.py` / `neutralize_*.py` / `git_precheck.py` /
`fix_gitignore.py` / `strip_refs.py`）与那 28 个 `_*.py` 一次性脚本一起移到
**工作树之外**（例如仓库同级目录 `../fpga-export-tooling/`），理由：
- 导出工具**不属于作品本体**，放在被导出的工作树里本身就会暴露整理过程；
- 移出后 `tools/scripts/_*.py` 这条 .gitignore 规则也就不再必要，
  排除逻辑从"依赖未跟踪状态"变成"结构上不可能出现" —— 这是**结构性**修复，
  比再加一条忽略规则更可靠。

| 严格退出码 | 🔶 门禁 `exit=0/1` 已用于 CI 判定；其他脚本未逐个审 |
| 公开导出移出活动工作树 | ❌ 未做（`make_public.py` 有"回退到 main"的兜底，注意别切回孤立分支） |

---

## 阶段 5 · 接入新交互 —— 🔶 **纯仿真部分已开工；其余依赖硬件**

I²C / 38 通道 / 音域条验证 → 再逐项接力度、触后、滑音、亮度。
每项都要有物理输入证据 + 明确声部归属 + 独立验收。

### ✅ 本轮新增：滑音（portamento）的首个判据（`26 glide`）

**背景**：本仓此前**完全没有滑音判据**，而出货默认配置下滑音**不可听**：
- `CTRL(0x00)` 自举 = `0x02` ⇒ **bit2 = 1 ⇒ GLIDE_EN 是开的**
  （`tdm_top.v` 原注释写 `GLIDE_EN=0`，**是错的**，已逐位核对并更正）
- `GLIDE_STEP(0x35/0x36)` 自举 = `0` ⇒ 速率 0 ⇒ `gq` 永不衰减

⇒ **默认无滑音** ⇒ 既有任何音频判据都**不会**因滑音逻辑有 bug 而变红。
滑音长期处于"开着、没速率、也没人验"的状态。现由 `src/sim/tb_glide.v` 钉住（G1–G7）：

| 判据 | 内容 |
|---|---|
| G1 | `glide_en=0` ⇒ `poff` 恒为 0（门控在**应用处**，不是衰减处） |
| G2 | `glide_step=0` ⇒ 不衰减，初值原样出现在 `poff`（**出货默认行为**） |
| G3/G4 | 正/负方向每样本走 `step`，**耗时精确等于 `ceil(|gq0|/step)`** |
| G5 | 小初值 / 带余数也**精确收敛到 0**（不卡在 ±1）—— 这才是"无残余抖动"的真保证 |
| G6 | 收敛后稳定停在 0 |
| G7 | 关滑音期间 `gq` **仍在衰减**：关→等→再打开不残留旧偏移 |

**逐行核对 RTL 后确认的两条「设计如此」**（第一版判据我照文档写错了，3 项假失败）：
1. **衰减不受 `glide_en` 门控** —— 注释明写"关滑音时也要照常走完，否则残留偏移会永久卡住"；
   门控在**输出**处（`pitch_mod.v:182` `gq_sel = glide_en ? gq_eff : 0`）。
2. **`GLIDE_CUT` 是死参数** —— 衰减式 `(gq > stp) ? gq-stp : 0` 本身就精确收敛到 0，
   所以**从未读它**（grep 全文件：只在参数声明与文档出现）。
   ⇒ 不是缺陷（精确收敛已达成），但**未使用的参数会误导读者**，已在测试台注释里写明。

> 教训（与前面几轮同类）：**先把被测语义从源码逐行核实，再写判据**。
> 照文档或照直觉写判据，产出的往往是"假失败"或"假通过"。

### 已核实的事实（2026-10-07）

| 项 | 事实 |
|---|---|
| **I²C** | `src/rtl/i2c_master.v`（246 行）+ `src/sim/mpr121_model.v` + `tb_i2c_master.v` **存在，但全仓只有那个 tb 例化它** —— `tdm_top` 没用它；约束文件 `tdm_top.cst:166` 明写 *"Reserve them for v2"*。⇒ 它是**为 v2 准备的资产，不参与出货设计** |
| **38 通道 / 音域条** | `pad_scan.v`(NCH=16) + `pad_pitch.v` + `strip_ctrl.v` 已存在，且**已在门禁里**（`09 regctl` 查 `led_ind` 音域条、`17 evloss` 查 8 键并发） |

### ⚠️ 新发现：I²C 资产的自检**失败 3 项**（此前从未被任何判据跑过）

首次运行 `tb_i2c_master`（2026-10-07）：

```
用例 1：写 0x5E=0x24 再读回     FAIL  reg-readback   得到 0x00000000 期望 0x24000000
用例 2：读触摸状态 2 字节        FAIL  touch-status   得到 0x0000ffff 期望 0xf0000000
用例 3：访问不存在的从机 0x33    FAIL  未应答未被标记
```

**已查到的线索（未证实，勿当结论）**：主机接收侧 `rd_d <= {rdbuf[23:0], sh}`
（`i2c_master.v:213`）位于"位周期结束"分支，而 `sh` 的**最后一次**移位在同一拍
由 `:164` 发出（非阻塞）⇒ 有"少移一位"的时序嫌疑。
但数值反推校验**只解释了用例 1，解释不了用例 2**
（少一位预测 `0x0000_0000`，实测 `0x0000_FFFF`）⇒ 该嫌疑不足，需继续定位。

**处理方式**：已把 `tb_i2c_master` 登记为门禁套件 **`25 i2c(kf)`**——
**跑它、如实登记失败、但不计入通过率**。理由：
- 直接标红 ⇒ 门禁长期红 ⇒ 红灯疲劳，反而没人看；
- 直接删掉 ⇒ 丢掉真实失败信息；
- 它不参与出货设计，所以不构成上板阻塞。
**等 v2 要用它时必须先修好，届时把 `known_fail` 改成硬判据。**
（门禁汇总里 `ok is None` 显示为 ⚠️ 并以"另有 N 项已知失败已登记，不计入"单独交代。）

### 仍依赖硬件、本机做不了的

- **I²S 标准对齐的板级裁决**（阶段 2 唯一剩余项）：需示波器同看 WS 与 SD 相对相位。
- **真实 I²C 器件 / 38 通道 / 音域条的物理验证**：需板子 + 器件。
- **亮度轴乘法的 PnR slack 复核**：需装有 Gowin 工具链的机器。

---

## 当前最该做的三件事（按性价比）

1. **把 `event_hold` 接进 `tdm_top` 汇合点 + 三个源加挂起位 + 端到端判据**（阶段 2 收尾；
   队列件与单元判据已经就绪，剩下是接线与集成验证）
2. **声部释放→回收闭环**（阶段 3 核心；缺陷已定位到具体行，改动面小）
3. **板卡到手后立刻做**：标准 DAC 输出验证 + 示波器同看 WS/SD 相位（一次性了结 I²S 争议）

## 累计踩到并已记录的坑（同类不要再走一遍）

| 坑 | 症状 | 出处 |
|---|---|---|
| 模型不在标定区间 | `state` 回不到 0 ⇒ 一个 note-off 都没有，看着像挂音缺陷 | `tb_evloss.v` |
| 读代码推结论 | 两次误判（I²S 标准对齐、pad_scan 是否丢事件） | `33-审计复核记录` |
| 并发测试台时序 | 三版 fork/join 都对不齐，失败长得像 RTL 丢事件 | `tb_evhold.v` H4 |
| 回绕式 for 一次不执行 | 队列永远出不去事件 | `event_hold.v` |
| NBA 同拍取旧值 | 紧凑队列搬错下标 ⇒ 顺序乱、出现重复项 | `event_hold.v` |
| 在时钟沿之后读组合 ready | 计数比实际少 1 | `tb_evhold.v` H2 |
| 指标方向本身错误 | 用谱心判亮度会反向 | `32-实现层` §1c |
| 新寄存器默认值不是恒等点 | `0x5C` 写 0 会改掉上电音色 | `reg_bank.v` |
| `$readmemh` 数组开小 | 静默只装一半、其余 X | `note_map.v` |
| **激励强度不够 ⇒ 假绿** | 只按 20/32 组，剩 12 组本来就 FREE，掩盖了回收缺陷 | `tb_alloc.v` |
| **判据激励绕过被测路径** | 用 `force` 伪造 UART 写，绕过 `uart_rx` 与组帧，整段 UART 事件取不到音符 | `tb_evmerge.v` |
| `Set-Content` 写 .v 带 BOM | iverilog 报 "Unable to find the root module" | 本轮环境 |
| **审计类判据的"通过"token 缺失** | 审计脚本输出 `AUDIT` 而非 `PASS`，被门禁判红 —— 但**有发现 ≠ 回归**；审计"跑完并给出明确结论"就是通过 | `preset_nyquist_check.py` |
| **加性合成的 Nyquist 在上高音区必然越界** | 音号 127 时第 3 次及以上泛音全部越界；`fs/2 = 26367 Hz`，而 3×12544 = 37631 Hz。这不是缺陷而是**固有约束**，必须量化后写进配表规则 | `nyquist_check.py` |
| **注释里的措辞不是契约** | `gen_tilt_wtab.py` 顶部写「基音退、高次进」，而实测 `w(t,0)` **恒为 256** ⇒ 真实行为是**基音不变、只有高次进**。照注释写判据会把**正常的表判成失败**（本轮实测：报"最亮档基音未小于最暗档"）。已更正注释并把真实行为写成契约 | `gen_tilt_wtab.py` |
| **判据自身循环（永远绿）** | 自校验用同一个常量既做"公式参数"又做"期望值" ⇒ 把它改成任何值都"通过"。修法：期望值按**外部契约**（寄存器 `0x70` 量化出的档）独立算一次 | `gen_tilt_wtab.py` |
| **生成脚本无退出码 / 无自校验** | `gen_tilt_wtab.py` 原来只往 stdout 写表：表错了照样退出 0，下游无从察觉（同类还有 `$readmemh` 装一半、位域重叠） | 本轮修复 |
| **扫描器的假阳性被当成真泄漏** | `scan_traces.py` 的 `GLM`/`prompt` **没加词边界**，于是内联 **base64** 里 `...ZwGlmTZl...` 被算成身份痕迹：5 个架构 HTML 各报 A=2（单文件 750 KB，内嵌图片 base64）。我一度当成"公开版真有泄漏"差点去动公开版；打印命中上下文才看出是编码数据。加 `\b` 后命中文件 28→23，那 5 个全部消失。**教训：扫描器报命中后必须打印上下文再定性；正则命中 ≠ 事实** | `scan_traces.py` |
| **审计脚本永远 return 0** | `scan_traces.py` 无论查出多少痕迹都退出 0 ⇒ 在任何流水线里永远绿灯，只能靠人眼看 | 本轮加 `--strict` |
| **同一份知识写成三处、规模还不一致** | `make_public.py` 的排除集合有**三个投影**：`EXCLUDE` 20 条 / `IGNORE_BLOCK` 43 条 / `LEAK_PATTERNS` 21 条。新增排除项时只改一两处很容易；**只改前两者而不改 `LEAK_PATTERNS`** ⇒ 新项"不被判据拦住"（排除规则与泄漏判据脱节）。已加 `24 leakcheck` 的 **D 组**断言三者同步（并验证该判据确实能失败：抽掉 `^refs` 后未覆盖条数 0→15） | `make_public.py` |
| **"检查器自己有 bug"本会话出现三次** | ① `GLM` 无词边界 ⇒ base64 假阳性；② 代表路径漏尾斜杠 ⇒ 假报 8 条缺口；③ `EXCLUDE` 目录不带尾斜杠 ⇒ 假报 5 条缺口。**教训：先把检查器本身验一遍，再相信它给出的缺口/命中** | 本会话 |

## ⏳ 两项**待裁定**（都会改变乐器行为，故不擅自改）

| # | 事项 | 现状（已实测） | 选项 | 影响面 |
|---|---|---|---|---|
| **1** | **legato 滑音由什么触发** | 机制在、但**正常演奏不触发**：`glide_ok = GLIDE_EN(硬接1) && !match_r && !free_r`，而搜索顺序 同音 > FREE > 可回收 > 抢占 ⇒ 有空闲组时必选 FREE ⇒ `free_r=1` ⇒ 无滑音。只有 **32 组占满走抢占**时才滑。判据 `28 legato`（L1 按住 60 再按 64 ⇒ 落别组；L4 占满 32 组 ⇒ 才滑） | **(A)** 保持现状 ／ **(B)** 由「上一个音是否还在响」驱动（需输入层/声部管理提供该信息 + 新增模式位；**符合"明确区分 legato 与滑动"这条原则**）／ **(C)** 明确降级为"待输入层接入"、本版记为未实现 | **(B) 要动声部分配语义**，改后必须复跑 `19 alloc` / `28 legato` / `32 pitchmod` |
| **2** | **混响 RV_FB=0xC0（fb=0.75）档** | **反馈环失控直流**：4 档里只有这档坏 —— 均值 **7,811,904**（满量程 93%）、削顶 **98.6%**，而其余三档均值 ≤108、削顶 **0.0%**。机理：环内削顶 = 整流，直流被环路增益 `1/(1−fb)` 放大（fb=0.75 → **4 倍**；0.5 只有 2 倍）。`fx_delay.v:189-194` 已记载过这个机理，但当时修的是 0x40~0x80，**0.75 余量不够**。判据 `35 t60(kf)`（`--full` 专属，已知失败） | **(A)** 加发送衰减 / 缩放反馈把它救回来 ／ **(B)** 明确从可用档位移除 | **(A) 改变混响音色**。注意 `tb_t60` 本就把该档注释为"已知限制探针" |

> 两项都**不裁定也不会误导人** —— 文档已按实测标注，且判据（`28 legato` / `35 t60(kf)`）
> 会持续把真实行为报出来。

### 另两项**未登记的判据资产**（本轮实测，已测出耗时，结论：都不进门禁）

| 资产 | 实测 | 结论 |
|---|---|---|
| `tb_t60` + `t60_check.py` | **130 秒**（4 档 × 70000 样本） | ✅ 已登记为 `35 t60(kf)`（`--full` 专属） |
| `tb_show` + `show_check.py` | **5590 秒 ≈ 93 分钟** | ❌ **不进任何门禁**。它本质是**演示渲染器**（需 `+show=N` 选 3 个场景之一；不带参数会跑默认场景），产物交给 `render_wav.py` 出 WAV 用。93 分钟属于"一次性演示"量级，不是判据 |
| `tb_perf` + `perf_check.py` | 能跑完 | ❌ 不登记：`perf_check` 要 **4 组**产物（`perf_a/b/latch/rate/int`），tb 只产出 1 组 ⇒ **判据未完成（WIP）** |
| `tb_latency` | 能跑完（给出 `t_smp=2052 / t_pin=2807 / t_load=1022` 拍） | ❌ 不登记：`latency_check.py` 的参数是 `--file/--limit-ms`、**不读目录产物** ⇒ 它是**手动工具** |

> ### `show_check.py` 实测 0/15 命中 —— 深查后：**判据假设与实际产物不符**（结论已修正）
>
> **★ 本文上一版对这条的判断是错的**，这里连"我是怎么错的"一起记下来：
> · **先自查判据**：`show_check.load()` 读的是 `f[1]`（= 音频列），**它是对的**。
>   我第一版的分析脚本误用了 `raw[:,0]`（= 样本序号列，一条 0..202499 的**斜坡**）
>   ⇒ 那组"精确整数倍"的比值（2.005 / 2.998 / 3.365）只是**斜坡**被 FFT 测出的假象，
>   我却据此写成"音高是对的、只是窗口偏移"。
>   （**本会话第六次"检查器 / 我的分析脚本自己有 bug"**。）
> · **用正确的音频列复现**：0/15 **仍然复现** ⇒ 是**真失败**，不是测量口径问题。
>   实测峰全部挤在 **129–193 Hz**（跨度 1.5 倍），而期望跨 **261–659 Hz**（2.5 倍）。
> · **决定性证据**：**音频里没有任何静音间隙** —— 202 个 1000-样本块**全部有能量**
>   （RMS 从 ~297k 递降到 ~238k）；而判据假设的是
>   `PER=13500 / ON=12000`（每音后留 1500 样本间隙）的**离散分段旋律**。
>   ⇒ **"判定依据"与"实际产物"不一致**：连续信号无法按"每音一窗"切开。
>
> **待查（下一轮从这里开始，别重走上述弯路）**：到底是
>   **(a)** `tb_show` 的 `+show=0` 场景本身不产生分段旋律（⇒ 判据需改写），还是
>   **(b)** pad 路径在这条演示激励下**真的**没按预期逐键触发（⇒ 真缺陷）。
> 已知线索：`17 evloss`（8 键同时按放 16 条事件全对应）**已登记且通过**，
> 说明 `pad_scan` 本身正常 ⇒ 嫌疑偏向 (a) 或 `tb_show` 的激励方式。
> **本轮不下结论** —— 上一轮就是"下得太早"，才写出了错的判断。
>
> #### ✅ 已定性（2026-10-07 第二轮深查）：**期望音高确实在音频里，是判据的测法不适用**
>
> 对判据第一音的窗（`x[3000:3000+8192]`）做全谱分析，**推翻了"音符没响"的假设**：
>
> | 频率 | 幅度 | 归属 |
> |---|---|---|
> | **128.75 Hz** | **512,718,193** ← 全谱最强 | **C3（比期望的 C4 低一个八度）** |
> | 135.18 Hz | 403,907,936 | 邻近 bin |
> | **263.93 Hz** | **321,090,527** | **就是期望的 C4（261.63 Hz）** |
> | **257.49 Hz** | 265,519,247 | 同上（窗泄漏） |
> | **392.68 Hz** | 197,961,392 | **G4（期望音阶第 4 个音）** |
> | **521.42 / 527.86 Hz** | 150M / 112M | **C5（期望音阶第 6 个音）** |
>
> ⇒ **期望音阶的多个音（C4/G4/C5）都在音频里** ⇒ pad 路径**确实在按谱发声**；
>   而判据的 `peak_freq()` 用「取最强 bin」（`argmax`），最强 bin 被
>   **低一个八度的 C3 分量（还比 C4 强约 1.6 倍）** 抢走。
> ⇒ **(a) 成立**：这不是"pad 没触发"，而是**判据的测法（argmax 取单峰）
>   不适用于这种"含八度分量 + 多音叠加"的信号**。
>
> #### ✅✅ 最终定性（2026-10-07 第三轮）：**pad 路径没有缺陷；是判据把 pad0 的八度写错了**
>
> **本文上两版对此的判断都是错的**，连错误一起记下来（这是本会话第七次
> "检查器/我的分析脚本自己有 bug"，也是最值得记的一次）：
>
> · 第一版错：把 `raw[:,0]`（**样本序号斜坡**）当音频做 FFT ⇒ 得出"比值是精确整数倍、
>   音高是对的、只是窗口偏移"。真实原因是我读错了列。
> · 第二版错：纠正读列后，看到 **128.75 Hz 是全谱最强峰**、且恰为 C4 峰的一半
>   （257.49/2，误差 0.00%），于是判定"存在**亚八度分量**"。**这个分量不存在。**
>
> **真正的原因**：`pad_pitch.v:22` 的 **`BASE = 48`** ⇒ **pad0 发的是 MIDI 48 = C3
> （130.81 Hz），不是 C4**。我却按"pad0 → C4"去找基频，于是把
> **真正的基频（130.81 Hz）当成了"低一个八度的伪分量"**，
> 又把它的 2 次谐波（261.63 Hz）当成了"期望的基频"。
>
> **独立证据**（专门做了快判据 `tb_padoct.v`，只按 pad0，26k 样本，554 秒）：
> | 频率 | 幅度 | 相对 |
> |---|---|---|
> | **131.96 Hz** | 7.367e8 | **1.000** ← 就是基频 C3 |
> | 260.71 Hz | 4.808e8 | 0.653 ← 2 次谐波 |
> | 524.64 Hz | 1.846e8 | 0.251 ← 4 次谐波 |
> | 785.35 Hz | 4.180e7 | 0.057 ← 6 次谐波 |
> 谐波序列是 **f : 2f : 4f : 6f**，与预设表的比例 **(1,2,4,6)** 一致
> ⇒ **谱形完全正常**，音高正确，**没有亚八度**。
>
> ⇒ **最终结论**：
>   ① **pad 路径正常**（`17 evloss` 与本次快判据一致）；
>   ② `show_check.py` 的 **`exp = [60,62,...]`（C4 起）本身就是错的** ——
>      按 `BASE=48`，期望序列应从 **48**（C3）起。这就是 0/15 的**全部原因**；
>   ③ 该判据从未进过门禁、也从未被验证过，所以这个错误口径一直没被发现。
>
> #### ✅✅✅ 根因已彻底查清（2026-10-07 第五轮）：**判据写于旧输入层，记的是旧映射**
>
> 本轮把"pad0 到底是哪个音"追到底，三条证据**互相印证**：
>
> | 证据 | 内容 |
> |---|---|
> | **哪条通路是活的** | `tdm_top.v:505` 例化 `pad_pitch #(… .BASE(48))`，其 `.ev_note → pp_ev_note` 进仲裁器；而 `pad_scan`（含 `penta_note()`：pad0→**MIDI 60**）**只做遥测** —— `tdm_top.v:490` 原话：「pad_scan 依旧保留，负责遥测」 |
> | **通道映射** | `tdm_top.v:500`：`pp_touch = {30'b0, pad_state[7:0]}` ⇒ **物理 pad i 直接驱动 `pad_pitch` 通道 i** |
> | **音符号公式** | `pad_pitch.v:5` 头注释：音符号 = **48** + 偏移 + 12×档位；`0..11 下排 C3..B3` ⇒ **通道 0 = MIDI 48 = C3** |
>
> ⇒ **pad0 = C3（130.81 Hz）**，与快判据实测的 **131.96 Hz** 完全一致。
>
> **所以 `show_check.py` 的 `exp=[60,62,64,67,69,72,74,76]` 是从 `pad_scan.penta_note()`
> 抄来的**（那里确实是 C4 起），但 `penta_note()` **在现版本已不是发声通路** ——
> 输入层已从 `pad_scan` 迁到 `pad_pitch`（BASE=48）。判据停留在旧映射上。
> **这正是"旧判据未同步"的一个实例**（对应目标里的"旧判据同步"）。
>
> **结论修正（收回我前几轮的两处错判）**：
> · 先前写"判据把八度写错了" —— **方向对**，但更准确的说法是
>   **判据记录了已被替换的旧输入层映射**；
> · 先前写"存在亚八度分量" —— **错**（那是 C3 基频本身）。
>
> **⚠️ 同时必须说明：本轮仍未解释"奇偶键稳态差 25 倍"**（见下节）。
>   `pad0..pad7 → MIDI 48..55`（C3..G3，含黑键），
>   奇位实测 **9.0k**、偶位 **226k** —— 这个 25 倍差异**与音高无关**
>   （同一个 pad6 出现在偶位时 305k、奇位时 92.9k）。
>   **两者是不同的问题，不要混为一谈**：
>     · `show_check` 0/15 ← 判据用旧映射（已查清，属**判据**问题）；
>     · 奇偶电平差 25 倍 ← **产品行为**问题（**仍未解释**，见下）。
>
> **教训（比结论更重要）**：我两次都在**没有先确证"预期值从哪来"**的情况下
> 就开始解释频谱。**先确证基准（这里是"pad0 到底是哪个音"），再解释数据。**
> 本会话第七次自查出检查器/分析脚本的问题 —— 所以凡判据与预期不符，
> **第一件事是核对预期值本身，而不是去 DUT 里找原因**。
>
> #### 修判据后的实测（用**已有的** 93 分钟产物复核，无需重跑）
>
> 把 `show_check.py` 的期望序列改为 **C3 起（BASE=48）** 后复跑：
>
> ```
> 第 1 音: 期望 C3 (130.81 Hz)  实测 130.48 Hz = C3   偏差   -4 音分  OK
> 第 2 音: 期望 D3 (146.83 Hz)  实测 138.65 Hz = C#3  偏差  -99 音分  XX
> 第 3 音: 期望 E3 (164.81 Hz)  实测 147.10 Hz = D3   偏差 -197 音分  XX
> 第 4 音: 期望 G3 (196.00 Hz)  实测 155.46 Hz = D#3  偏差 -401 音分  XX
> 第 8 音: 期望 E4 (329.63 Hz)  实测 195.93 Hz = G3   偏差 -901 音分  XX
> ```
>
> · **第 1 音命中（−4 音分）** ⇒ **基准修正正确**，pad0 确实是 C3。
> · **但第 2 音起仍不命中，且呈"单调曲线"**：实测 130.48 → 138.65 → 147.10 →
>   155.46 → 165.09 → 174.53 → 185.32 → 195.93 再回落，
>   **相邻步长几乎恒定为 ≈ 65 音分**；而期望的五声音阶步长应是 204/204/294/204… 音分。
>   ⇒ 这**不是"八度写错"那类问题**，而是一个**新的、独立的**现象：
>     分析窗锁到的是一条**平滑变化的频率曲线**，而不是离散音级。
>     可能：窗起点与音符实际起始错位（窗跨越了过渡段），或整段音频本身连续滑移。
>   **本轮到此为止，不再下结论**（本会话已因"下得太早"错了两次）。
>   **下一轮起点**：用**快判据**（`tb_padoct.v` 那类，分钟级；不要再跑 93 分钟）
>   逐个定位"每个音的实际起始样本"，先把「窗错位」与「音频连续」分开。
>
> #### ✅✅ 已用**已有产物**把"窗错位/连续"排除，并找到一个**新的真缺陷**（2026-10-07 第四轮）
>
> 先核对了**激励的 ground truth**（读 `tb_show.v`）：
> `for i=0..7 { tch(i,1); rec(12000); tch(i,0); rec(1500); }` 再 `for i=6..0` 同款，
> **录音就发生在同一个循环里** ⇒ `PER=13500`、窗 `[+3000,+11192]` 落在 note-on 段内
> —— **判据的时序假设是对的**（这一点我先前怀疑错了，现予纠正）。
>
> 于是逐音测 **note-on 段的 RMS**（15 音，`idx 0..14`，`pad` 为实际触摸的键）：
>
> | idx | pad | RMS(前 3000) | 峰 |
> |---|---|---|---|
> | 0 | 0 | **303,039** | 724,720 |
> | 1 | 1 | **92,517** | 339,312 |
> | 2 | 2 | **305,235** | 732,960 |
> | 3 | 3 | **92,675** | 358,160 |
> | 4 | 4 | **298,899** | 701,856 |
> | 5 | 5 | **92,693** | 373,088 |
> | 6 | 6 | **299,149** | 705,680 |
> | 7 | 7 | **92,931** | 388,864 |
> | 8 | 6 | **304,658** | 738,736 |
> | 9 | 5 | **91,832** | 388,432 |
> | … | | | |
> | 14 | 0 | **303,017** | 720,592 |
>
> **规律极强**：**偶数键（0/2/4/6）≈ 30 万，奇数键（1/3/5/7）≈ 9.3 万**
> —— 与"音符在序列里的第几个"**无关**，只与**键的奇偶**有关：
> 同一个 pad6 在第 7 音（奇位）是 92.9k、在第 9 音（idx 8，偶位）是 304.7k。
> ⇒ 电平差 **3.3 倍**（峰值 725k vs 339k，**2.1 倍**）。
>
> **结论**：
> · 既不是"窗错位"，也不是"音频连续" ⇒ 先前的两个猜测都排除；
> · 判据 `show_check` 的 0/15 **主要是被这个电平不对称掩盖的**
>   （弱音那几条的谱峰被强音压过，`argmax` 取不到它们）；
> · **真问题**：**pad 路径存在按"键奇偶"分档的电平不对称**（偶数键明显更响）。
>   这**不是** `show_check` 的错，是**产品行为的不对称**。
>
> **待查（下一轮起点）**：奇数键为什么弱 3.3 倍？候选方向
>   · `pad_pitch` 的音符号映射（奇偶键是否落到不同音区/不同预设档）；
>   · `preset` 选择：`tb_show` 用 `preset(2'd1)`，需确认奇偶键是否用同一预设；
>   · 振荡器/包络的按音高缩放（低音更响？但 0 与 1 只差一个音级，不该差 3.3 倍）。
>   排查方式：**快判据**（分别只按 pad0 与 pad1，各录 20k 样本，比较谱与 RMS），
>   分钟级，**不要再跑 93 分钟**。
>
> #### ★ 进一步量化：**稳态差 ≈25 倍**，且**衰减形状不同**（不是单纯的"弱一点"）
>
> 上面那个 3.3 倍是**起音段前 3000 样本**的数字，低估了问题。改看**稳态**
> （每音内第 6000–11000 样本）：
>
> | 位置 | 稳态 RMS | 峰 |
> |---|---|---|
> | 偶位（pad 0/2/4/6） | **226,000 – 232,000** | ≈476,000 |
> | 奇位（pad 1/3/5/7） | **9,000 – 9,700** | ≈41,000 |
>
> ⇒ **能量差约 25 倍**（幅度约 25 倍、峰值 11.6 倍）。且**形状不同**：
> ```
> idx0 pad0(偶) 每 1000 样本 RMS: 296977 308030 304007 273380 283351 244713 263628 221647 245050 201560 225186
> idx1 pad1(奇) 每 1000 样本 RMS: 120814  81085  67139  46776  36617  28399  16441   9537   5137   3092   2849
> ```
> · 偶位：**基本维持**（~29.7 万 → ~22.5 万，12 个样本周期内只降到 76%）
> · 奇位：**迅速塌掉**（12.1 万 → 0.28 万，降到 **2.3%**）
>
> **已排除**：
> · **不是 preset 表差异** —— 预设是**全局**的（`preset(2'd1)`），
>   而且 preset 1 的 16 个泛音幅度是平滑的 220→12，不含音高相关的分档。
> · **不是包络参数按音高变** —— `tdm_top.v` 的 `a_inc/d_inc/d_m/d_k/s_lvl/r_inc/r_m/r_k`
>   都是**编译期常量**，对所有音符相同。
> · **不是 Nyquist 截断** —— 这些音（C3~C4）的 16 次泛音最高约 4.2 kHz，远低于 26.4 kHz。
> · **不是窗错位 / 音频连续**（上一节已排除）。
>
> **下一步指向**：既然包络参数全局相同，**同样的"音"却表现出完全不同的衰减**，
> 说明奇位那一路的**包络根本没有正常驱动**（或它走的是**另一条**发声路径）。
> 注意：pad 事件有**两条**通路 —— `pad_scan.v` 的 `penta_note()` → `ev_*`，
> 与 `pad_pitch.v` → `pp_ev_*`。⇒ 下一步应先确认 **tb_show 的这一路实际走的是哪一条**
> （读 `tdm_top` 的 `mh_valid`/`pp_pend` 选择逻辑 + `pad_scan` 的 `pick` 机制），
> 再判断是"映射错"还是"包络没驱动"。
> **仍用快判据**（分钟级），不要再跑 93 分钟。

---

## 一直悬着的两件事

- ~~**饱和（截顶）路径未覆盖**~~ → ✅ **已覆盖**（2026-10-07，闸口套件 `20 sat`）。
  `12 f1` 与 `16 i2s top` 确实到不了饱和区（32 复音满力度时 `sum_raw` 峰值 383370 / 阈值 524288 = 73%），
  本机也没有 Gowin 工具链、没有增益寄存器可调 ⇒ 改为 **force 引擎内部的 `acc_next`**
  （饱和表达式的输入），逐点核对期望值。10 个点全对，包括**正负不对称**这一细节：
  | `acc_next` | `scaled = <<4` | 输出 |
  |---|---|---|
  | 524287 | 8388592 | 8388592（不夹） |
  | **524288** | 8388608 | **8388607（夹）** |
  | -524288 | -8388608 | -8388608（**不夹**，恰好等于 MINV） |
  | -524289 | -8388624 | -8388608（夹） |
  正侧分界点是 `>MAXV`，负侧是 `<MINV` ⇒ 两侧行为不对称，判据必须分别覆盖。
  判据：`RESULT sat=PASS`（`src/sim/tb_sat.v`）。

- **亮度轴乘法尚未重新综合** —— 🔶 **本次无法完成，需带 Gowin 工具链的机器**。
  已核实的**基线**（`impl/pnr` 产物，2026-10-06 14:59）：
  - 最差 SETUP slack = **+15.229 ns**，时钟周期 37.037 ns，TNS(setup) = **0**、TNS(hold) = **0**
  - 最差路径：`u_top/u_tdm/pp_mem…DO[0]` → `u_top/u_tdm/env_mem…DI[13]`
    （**tdm_engine 内部**，本项目从未改动该模块）
  - `+15.229 ns` 相对 ≥5 ns 的余量要求有约 10 ns 裕量
  - ⚠️ 但该报告**早于**事件队列/轮转仲裁/`note_map` 回收修复与亮度轴乘法，
    因此**不能**直接用来宣称当前源码的时序。下次在装有 Gowin 的机器上 PnR 后必须复核。
    我未改动 `tdm_engine`，所以最差路径的两个端点都不在改动范围内 —— 这是"应当无影响"的
    推理依据，但**推理不等于证据**。

#### ✅ 关键排除（2026-10-07 第六轮，新判据 `tb_padprobe.v`）：**25 倍不是"键"的属性**

用新做的快判据逐键隔离测试（`+pad=N` 只按一个键，同时观测 **pad_pitch 事件 /
note_map 分配 / 输出 RMS** 三者，不再只看音频）：

| | pad0（偶） | pad1（奇） |
|---|---|---|
| note-on 事件 | **note=48** ✓ | **note=49** ✓ |
| 分配声部数 | 1 | 1 |
| 稳态 RMS | **163,334** | **161,720** |
| 峰 | 359,760 | 356,496 |

⇒ **单独按 pad0 与单独按 pad1，输出几乎逐位相同**（比值 1.01）。
且 `48 + pad` 的映射**完全正确**（pad0→48=C3、pad1→49=C#3）。

**这推翻了"奇偶键本身有缺陷"的假设。** 25 倍不对称**只在 `tb_show` 那种
"交替切换多个键"的场景里出现**。回到 `show_pads.txt` 的实测：

- 位置 0（pad0）：RMS 峰值 303k、稳态 232k
- 位置 1（pad1）：RMS **峰值仅 92k**、稳态 9k，且**衰减斜率与位置 0 相同**

⇒ 两者**衰减时间常数一致**（所以不是包络参数问题），但位置 1 的**起始电平就只有
位置 0 的 1/3，随后一路更低** ⇒ 像是"该次按键的起音没有正常建立"。

**已排除（本轮新增）**：不是 per-pad 缺陷、不是音符号映射错、不是声部未分配。
**待查**：`tb_show` 的切换序列里，为什么"位置 1 的那次按键"起音不足 ——
下一步应**复现该切换序列**（按 pad0 → 松开 → 按 pad1，短序列、分钟级），
并 dump 两次 note-on 的**时间关系**与当时的 `gact`/`pad_state`。

**★ 本轮我犯的一个错，记下来**：我用 PowerShell `-replace` + `Set-Content`
去改 `.v` 文件，把 UTF-8 中文**全部写成乱码**并破坏了语法。
**教训：改这个仓库的文本文件一律用 `edit`/`write` 工具，不用 PowerShell 文本替换**
（本会话早先已因 `Set-Content` 加 BOM 吃过一次亏，这是第二次同类）。

#### ✅✅ 已复现并定位到条件（2026-10-07 第七轮，判据 `tb_padseq.v`）：**前一个音的存在压低新音**

新判据 `tb_padseq.v` 精确复现"切换"序列（按 pad0 → 松开 pad0 同时按 pad1 → 松开），
并打出**事件时序**（每次 note-on/off 的样本号、音符号、当时的在响组数）：

```
[A] 静息基线                     在响组数=0
[B] 按 pad0                      [t=  1000] note-ON  note=48  在响组数=0
                                 在响组数=1
[C] 松开 pad0，同时按 pad1        [t=  9000] note-OFF note=48  在响组数=1
                                 [t=  9000] note-ON  note=49  在响组数=1
                                 在响组数=0        ← 注意：此时在响组数变成 0
[D] 松开 pad1                    [t= 17000] note-OFF note=49  在响组数=0
```

**事件层完全正常**：两次 note-on 都在、音符号正确（48、49）、note-off 也都在。

**但音频层出现了差异**（同一段序列里两个音的稳态 RMS）：

| 场景 | pad1（note 49）稳态 RMS |
|---|---|
| **pad1 隔离**（`tb_padprobe`） | **161,720** |
| **pad1 紧跟 pad0**（本判据，C 段） | **41,324** |

⇒ **相差 3.9 倍** —— 在此之前的所有隔离测试里，pad1 都是**完全正常**的。
**⇒ 条件已锁定：新音的音量取决于"前一个音是否刚响过"。**

同一序列里 pad0（B 段）稳态 **243,478**，pad1（C 段）稳态 **41,324** ⇒ 比值 **5.9 倍**，
与 `tb_show` 里观察到的 25 倍是**同一现象的不同表现**（`tb_show` 的间隔更短、叠加更多）。

**逐段衰减速率的差异**（每 1000 样本 RMS）：
```
B 段 pad0: 296977 308605 303424 273854 282901 245008 263365 221815   ← 缓降
C 段 pad1: 285486 174246 148488  92197  81816  54300  49789  30600   ← 骤降
```
两段**起点相同**（285k vs 297k），但 C 段**衰减快得多**。
⇒ 不是"起音没建立"，而是**新音的包络衰减被加速**（或它继承/复用了前一个音的状态）。

**下一步（已缩小到一处）**：C 段事件日志里 `[t=9000]` 那两拍之后"在响组数=0"，
说明发生了 **note-off 释放 + note-on 重新分配**。嫌疑最集中的是：
**note 49 被分配到 note 48 刚释放的那个组**，而该组的**包络/相位状态没有干净复位**。
判法（分钟级）：在 `tb_padseq` 里额外 dump 两次分配命中的组号（`gsel`/`gtab`），
确认是否**同一个组**；再查该组在释放后包络是否归零。
**这与阶段 3「统一声部生命周期（释放→回收闭环、刷新/复位）」直接相关** ——
可能正是"回收后未完全复位"的一个实例。

#### ★★★ 根因指向：**切换瞬间的 note-ON 被 note_map 静默吞掉**（2026-10-07 第八轮）

给 `tb_padseq.v` 加了**组状态探针**（dump `gact`/`gtab`：哪个组在响、音符号是多少），
在 446 秒的一次仿真里拿到了完整时序与组状态：

```
     在响组数=0
     [组状态] t=1000 在响组:
   [t=  1000] note-ON  note=48  在响组数=0
     在响组数=1
     [组状态] t=9000 在响组: g0(note=48)          ← 只有 g0，正常
 [C] 松开 pad0，同时按 pad1
   [t=  9000] note-OFF note=48  在响组数=1
   [t=  9000] note-ON  note=49  在响组数=1        ← 事件**发出去了**
     在响组数=0                                    ← 但**没有任何组在线**
     [组状态] t=17000 在响组:                      ← 空
   [t= 17000] note-OFF note=49  在响组数=0
     [组状态] t=21000 在响组:                      ← 空
```

**关键判读**：
1. **事件层没问题**：`note-ON note=49` 在 t=9000 **确实从 `pad_pitch` 发出了**
   （这是 `pp_on_p`，源头正确）。
2. **但分配层没有结果**：t=9000 之后的组状态快照里**始终没有任何组**；
   t=17000（note 49 松开）时"在响组数=0"；到 t=21000 全空。
   ⇒ **note 49 的 note-on 没有在 `note_map` 里落地**（没有被分配到任何组）。
3. **而同一段音频里** t=9000 处 RMS 从 285k **骤降**（285k→174k→148k→92k…）
   —— 那正是 note 48 的**释放衰减**，**叠加不上 note 49**。
   这解释了"新音起音不足"：**新音根本没响，听到的是前一个音的尾音**。

**⇒ 与 `tb_show` 观测完全自洽**：位置 1 的 RMS 只有位置 0 的 1/3，衰减斜率却相同
—— 因为它**不是新音**，而是**前一个音的释放尾音**。

**这直接命中目标的阶段 2**：
> 「输入事件待处理与接收确认，**绝不静默丢 note-off**」

实测是 **note-ON 被静默吞掉**（比 note-off 更严重：note-off 丢了会挂音，note-on 丢了
只是"不响"，更难发现）。**这正是"静默丢失"这一类缺陷的一个实例**，而且它**逃过了
已有的 `17 evloss` 判据** —— 因为 `17 evloss` 测的是"8 键同时按/放、事件都对应"，
用的是**缓慢、不重叠**的激励，恰好避开了"**释放与按下同一拍**"这个条件。

**下一步（已非常窄，分钟级）**：
- 在 `tb_padseq` 里 dump **事件队列**的入队/出队（`event_hold` 的 `out_valid/out_ready`
  与 `note_map` 的 `ev_valid/ev_ack`），确认 note 49 是**没进队**还是**进了队但被 ack 掉**；
- 重点怀疑**同一拍同时到达 note-off 与 note-on** 时，
  `note_map` 的状态机（`ST_IDLE/ST_ALLOC/ST_LOAD`）一次只处理一个事件，
  而 **ack 的时序**可能把第二个事件"确认"掉却没执行。
  （阶段 2 的工作对象正是这条通路；`event_hold` + 轮转仲裁是为它加的。）

**阶段 3 的结论保持不变**：这不是"回收后未复位"，而是**事件在切换瞬间丢失** ⇒
归入**阶段 2**，**阶段 3 的"释放→回收闭环"仍算通过**（组确实回 FREE 了）。
我上一轮把它归到阶段 3 是**判断过早**，此处更正。

#### 🔴 缺陷已精确定位（2026-10-07 第九轮，判据 `tb_padfast.v`，**11 秒**，已登记 `36 padfast(kf)`）

**结论：pad 通路在"释放与按下紧邻"时会静默丢一个事件，丢的是 note-ON。**

**复现（11 秒，不录音频）**：
```
 A 只按 pad0                     事件数=1  在响组数=1  note48 组=0        ✅
 B 松开 pad0 + 同一拍按 pad1      事件数=2  ack 增量=1  在响组数=0  note49 组=-1  ❌
     [事件] 拍=60697 OFF note=48
     [事件] 拍=60698 ON  note=49     ← **两个事件都产生了**
 C 单独按 pad1（不重叠）           事件数=1  ack 增量=1  在响组数=1  note49 组=0   ✅
```
⇒ **两个事件只隔 1 拍产生，但 `nm_ev_ack` 只确认了 1 次**，note49 从未被分配。
**C 通过而 B 失败** ⇒ 确证触发条件是「**重叠切换**」。

**分级定位（两步排除，都有判据）**：
| 测什么 | 判据 | 结果 |
|---|---|---|
| 事件队列 + `note_map` 本身 | `tb_evseq.v`：直接在外部事件口打**1 拍间隔**的 off→on | ✅ **2 秒通过** |
| pad 通路 → 队列 这一段 | `tb_padfast.v`：走完整 pad_scan/pad_pitch | ❌ **FAIL** |
⇒ **丢失不在队列、也不在 note_map**，而在 **pad 通路到队列之间**
（`tdm_top.v` 的 per-source 挂起位 / 轮转仲裁那一段）。

**为什么逃过了已有的 `17 evloss`**：那条判据用的是「8 键同时按/放、缓慢不重叠」的激励，
**恰好避开了「释放与按下紧邻」这个触发条件**。⇒ 判据覆盖了"量"，没覆盖"时序紧邻"。

**为什么重要（对应目标）**：直指阶段 2 的
「输入事件待处理与接收确认，**绝不静默丢 note-off**」。
实测丢的是 **note-ON** —— 比 note-off 更隐蔽：**note-off 丢了会挂音（听得出），
note-on 丢了只是"不响"（听不出，会被当成演奏失误）**。
这也解释了 `tb_show` 里"新音起音不足"的全部现象：
**新音根本没响，听到的是前一个音的释放尾音**。

**下一步（修它的前提，已很窄）**：
在 `tb_padfast.v` 里 dump 队列的写侧信号（`event_hold` 的 `in_valid/in_ready`、
每一路的挂起位 `pp_pend`/`sh_pend`/`uh_req`/`dh_pend`）与轮转指针 `arb_rr`，
确认：
  (a) 第 2 个事件**没被写进队列**（挂起位/仲裁漏采）——最可能；
  (b) 或写进去了但被 `out_ready` 连拍吞掉。
`tb_padfast` **不录音频**，所以这条迭代是**秒级**（对比 `tb_padseq` 的 446 秒）。

**★ 方法论收获（本轮最实用的一条）**：
把"要录音的复现"（446 秒）换成"**不录音、只测事件与组状态**的复现"（11 秒），
迭代速度提升 **40 倍**，才使得这种逐级排除变得可行。
**以后排查事件类问题，先建立"秒级判据"，不要用音频判据去迭代。**

#### 🎯 根因确证（2026-10-07 第十轮）：**单槽挂起寄存器 `pp_pend` 静默吞掉紧邻事件**

**代码位置**：`src/rtl/tdm_top.v:817`（pads 源的事件锁存）

```verilog
//   pads：同样锁存（锁存后它就不再占着 mux，低优先级源才有机会）
if (pp_ev_valid && !pp_pend) begin      // ★ 单槽挂起：pp_pend=1 时这一拍的事件被直接忽略
    pp_on_r   <= pp_ev_on;
    pp_note_r <= pp_ev_note;
    pp_vel_r  <= pp_ev_vel;
    pp_pend   <= 1'b1;
end
```

`pp_pend` 是**单槽挂起寄存器**：它置 1 之后要等 `ev_in_ready`（事件队列可接收）
才清零。在这个窗口内到来的任何事件，`pp_ev_valid` 虽为 1，却因 `!pp_pend` 为假
而**被直接忽略** —— **既不入队、也不报错**，即**静默丢弃**。

**实测证据**（`tb_padfast.v` B 段：松开 pad0 的同一拍按 pad1）：

| 观测量 | 实测 | 含义 |
|---|---|---|
| `pad_ev_valid` 拍数 | **2** | 两个事件**都产生了** |
| `pp_pend` 置 1 次数 | 1 | 只有第一个被接收 |
| **被挂起位挡掉** | **1** | ← **第二个事件被丢在这里** |
| `nm_ev_ack` 增量 | 1 | 只确认了一个事件 |
| note49 所在组 | **-1** | 从未被分配 |
| 两个事件的间隔 | **1 拍**（拍 60697 OFF / 60698 ON） | 触发条件极窄 |

对照：**单独按 pad1**（不重叠）⇒ 正常分配到组 0。
⇒ 判据 `tb_padfast` 现已把根因写成硬断言：
`B-src-produced-2-valid (2)` ✅ 与 `B-dropped-by-pending-slot (1)` ✅ 均通过，
而 `B-both-events-acked` 与 `B-note49-allocated` 失败。

**影响面**：
- 丢的是 **note-ON** ⇒ 比 note-off **更隐蔽**（note-off 丢了会挂音、听得出；
  note-on 丢了只是"不响"，会被当成演奏失误）。
- 这就是 `tb_show` 里"新音起音不足"的**全部成因**：新音根本没响，
  听到的是前一个音的**释放尾音**。
- **同源风险**：`sh_pend`（定序器）、`uh_req`（UART）、`dh_pend`（排针）
  也是**单槽挂起**，**同样有这个缺陷**，只是尚未逐条构造判据验证。

**默认处置：不擅自修**。理由：
1. 这是**输入事件通路的架构性改动**（单槽挂起 → 每源小队列），
   属于阶段 2 的核心工作对象，且会触及 `tdm_top` 的事件汇合逻辑；
2. 修法有多种（每源 1 深 FIFO / 扩大挂起 / 反压上游），**取舍需要设计决定**；
3. 交付物层面还有一条硬要求要一并满足：
   **任何被丢弃的事件都必须可观测**（计数器/状态位），不允许静默丢弃。
⇒ 已把根因、证据、影响面与修法方向完整写入 `tdm_top.v` 的注释（纯注释改动，
   逻辑未变，门禁依旧全绿），并在判据里固化为**已知失败**登记，
   使这个缺陷**不会被遗忘、也不会被误判为"已修"**。

**若要动手修，必须复跑**：`36 padfast`（目标转绿）、`17 evloss`、`18 evmerge`、
`19 alloc`、`28 legato`、`32 pitchmod`。

#### 📋 修复方案已成文（2026-10-07 第十一轮）：`37-事件通路静默丢失-修复方案v1.md`

由于这是**输入事件通路的架构性改动**（且该路径本项目已踩过三次坑，
约束写在 `tdm_top.v:707-711`），所以**先出方案、再动手**。方案要点：

- **根因归类**：四个源各用**一个单槽挂起寄存器**（`uh_req`/`sh_pend`/`dh_pend`/`pp_pend`），
  置 1 后要等 `ev_in_ready` 才清零；该窗口内到来的事件因 `!pend` 为假被**直接忽略**。
- **★ 本轮新发现（同一族的第二个缺陷）**：UART 那一行是
  ```verilog
  if (u_ev_valid) begin          // ★ 没有 !uh_req 判断
      uh_req      <= 1'b1;
      uh_req_note <= r_note_num; // ← 旧事件尚未被接收时，被新事件**覆盖**
  ```
  即 UART 不是"丢弃"而是**错位**（旧音符被新音符顶掉）。
  已核对源码确认（`tdm_top.v:798`）。⇒ 与小节上面的 pads 缺陷**同源**，
  只修 pads 会把同类缺陷留在系统里。
- **修法**：把四处的"单槽挂起"换成**每源一个小队列**
  （复用**已验证的** `event_hold.v`），mux 改为**读各源队头**；
  `arb_rr` 轮转仲裁**一字不改**（公平性行为不变）。
- **必须一并满足的硬要求**：**任何被丢弃的事件都必须可观测**
  （汇总四个源队列的 `overflow` 到只读寄存器）——
  这正是目标里"待处理与接收确认"的实质，不是可选项。
- **实施顺序**：**分源小步走**（先只改 pads → 复跑 → 再依次改其余三个），
  每步复跑 `11 tdm`（音频逐位）+ `17/18/19/28/32`（事件与分配），
  任一非预期失败**立即回滚该步**。
- **不改音频行为、不重写内核**，符合用户三条原则。
- 新增要求：`tb_padfast` 补 **D 段三连事件**（验队列深度与顺序），
  并新增 **UART 连续两次写**用例（复现"覆盖"缺陷）。

---

## 📌 本轮收口记录（2026-10-07/08，第 44 轮）

> 背景：按用户指示**暂停扩展审计与反复全量回归，先收口**。以下为可审查的固定状态。

### 收口时的固定状态

| 项 | 值 |
|---|---|
| **交付提交 SHA** | **`f4c53b5`**（工作树**干净**） |
| 门禁（全量） | 见 `sim_build/regress_FINAL_f4c53b5.txt` |
| 本轮未交付的尝试 | `sim_build/tdm_top.v.WIP-queue-attempt`（**未提交**，仅留档） |

### 已完成（本轮及前序，均已提交）

- **根因确证**：pads 事件丢失 = `tdm_top.v` 的**单槽挂起寄存器** `pp_pend`
  （`if (pp_ev_valid && !pp_pend)`，挂起窗口内到达的事件被静默忽略）。
- **可复现判据**：`src/sim/tb_padfast.v`（**11 秒**，不录音频），
  登记为 `36 padfast(kf)`；6 项断言中 4 项 PASS（含根因断言
  `B-src-produced-2-valid=2`、`B-dropped-by-pending-slot=1`），2 项 FAIL。
- **修复方案**：`37-事件通路静默丢失-修复方案v1.md`（含验收表、分源小步实施顺序、风险对策）。
- **同族缺陷识别**：UART 的 `if (u_ev_valid)` **无 `!uh_req` 判断** ⇒ 旧事件被新事件**覆盖（错位）**。
- **前置收口**（阶段 1/4）：规格 SHA 绑定已做成**机械校验**（`31 spec sha`）；
  门禁覆盖已可审计（`34 gatecov`）；RTL 已无死参数（`30 deadparam`）。

### 未完成（本轮明确未交付）

- ❌ **pad 紧邻 off→on 事件丢失的修复本身**（用户收口清单第 1 项）。
- ❌ 其余三个单槽源（UART / 定序器 / 排针）的修复。
- ❌ 事件丢弃的**外部可观测性**（溢出计数器读通路）。

### 为什么未完成（诚实说明，不掩饰）

本轮已按方案 §5 实施"只改 pads 为队列"（复用已验证的 `event_hold`），
**但集成后 `tb_padfast` 由 2 项失败变为 3 项失败**（C 段原本通过，集成后也失败），
即**引入了回归**。已用隔离判据 `tb_qdbg` 证明 **`event_hold` 模块本身工作正常**
（两个紧邻单拍脉冲均被正确入队、按序输出、无溢出）⇒ **问题在我的集成接线**，
而非设计。因用户要求"出现失败则定位处理，不无限扩大本轮范围"，
**选择回滚未完成的集成**、保留干净基线，而不是交付一个半坏的改动。

**下一步定位起点**（已缩小）：`u_padq` 实例接线是可疑点 ——
`in_ready` 悬空（符合"单拍脉冲源无法反压"的意图）但需确认
`pp_q_valid` 是否真的被 `arb_p` 采到；WIP 副本在
`sim_build/tdm_top.v.WIP-queue-attempt` 可直接 diff。

---

### 附：单槽挂起源的**容量与可观测性**审计（收口清单第 2 项）

| 源 | 待处理容量 | 挂起位 | 溢出是否可观测 |
|---|---|---|---|
| UART(0x61) | **1 个事件** | `uh_req` | ❌ 无计数器 |
| 定序器 | **1 个事件** | `sh_pend` | ❌ 无计数器 |
| pads | **1 个事件** | `pp_pend` | ❌ 无计数器 |
| 排针 `ev_*` | **1 个事件** | `dh_pend` | ❌ 无计数器 |
| （下游）事件队列 | `EVQ_DEPTH = 4` | — | ⚠️ 有 `ev_q_ovf`，但只接到 `ev_ovf_dbg`/`ev_lvl_dbg` 两根**悬空线**（全仓除声明外**无任何引用**）⇒ **实际不可观测** |

**明确支持的输入速率**：
- **可持续速率**：每个源 **≤ 1 个事件 / 挂起窗口**
  （窗口 = 从挂起位置 1 到 `ev_in_ready` 且该源被轮转选中，最坏情况下
  要等下游 `note_map` 走完 `ST_ALLOC + ST_LOAD`，约 20 拍）。
- **突发容量**：**每源 1 个事件**。**超出即静默丢弃**（UART 例外：是**覆盖**）。
- **最快的源是 pads**：`pad_pitch` 的扫查仲裁每 35 拍一轮，但**同一拍可给出多路**，
  实测可产生 **1 拍间隔的连续事件**（判据 `tb_padfast`：拍 60697 OFF / 60698 ON）
  ⇒ **已超出 1 槽容量**，必然丢。
- **超出容量时的可观测性**：**当前为零**。只能通过
  `tb_padfast` 的层次探针（`u_top.pp_pend`）或"听出不响"来发现。
  ⇒ **不满足目标"绝不静默丢事件"的要求**，这是必须与修复一并解决的部分。

### 附：本轮范围内**明确不做**的事（用户指示）

| 项 | 状态 | 后续归属 |
|---|---|---|
| 新交互接入 | 未做 | 阶段 5 |
| I²C（`i2c_master`） | 仍是 **v2 资产**，自检 **失败 3 项**，登记 `25 i2c(kf)` | 不参与出货设计；若要用需先修接收采样相位 |
| 新 GUI / 协议接合 | 未做 | 阶段 5 |
| 触控驱动（真实器件） | 未做；**被硬件阻塞**（MPR121 拿不到压力） | 阶段 5，需触控原型选型落地 |
| 板级验收（I²S 相位裁决） | 未做 | 方案在 `36-I2S相位板级了结方案.md`，需板子+示波器 |
| PnR 时序复核 | 未做 | 需 Gowin 工具链；且当前 `+15.229 ns` 是**旧源码**的数，不可继承 |
