sakuyaShining/FPGA-Music-project-internal/docs/02-技术方案/39-最新设计构想与落地差距-2026-10-09.md

# 最新设计构想与落地差距 · 2026-10-09

> **2026-10-19联合探针资源后续**：见[86号](86-联合探针资源调整与布线失败边界-2026-10-19.md)和`experiments/joint_probe_resources_20261019/project/CURRENT.md`，版本`joint-probe-resources-20261019-v0`。先备份116项，MAC前15项、RAM延迟前11项；85号音乐引擎88文件及全部时序/引脚约束不变。仅把验证探针历史链迁至9个DSP寄存器与96拍RAM延迟，普通寄存器11243→10760；五配置10万拍逐位历史对照、DSP/延迟反例，以及两延迟各200实际音乐PCM录入/读出和200图案播放在限定数字范围**已验证**。联合布局通过，但正常策略仍DesRoute/PR0004，路由**未通过**；PnR报告20478Logic、10357/10368CLS、32BSRAM、22.75/24DSP，无有效setup/hold/recovery/removal余量、无新码流，加严构建未运行。三个前候选路由失败及错误目标中止均保留；不能用0 unrouted字样放行。COM6未找到，串口清单为空，本轮板状态未核实；无下载/发音/Flash/TF操作，最后成功确认仍76号。探针**已实现待验证**、整机**部分实现**，禁止下载结构探针；下一步针对核心高占用/局部路由及真实命令包装继续优化，不擅减复音/泛音或取消可视化，不据此裁定双板。

> **2026-10-19联合布局实际边界**：见[85号](85-音乐存储联合布局与RAM模式修正-2026-10-19.md)与`experiments/joint_timing_20261019/project/CURRENT.md`，版本`joint-timing-20261019-v0`。先备份106项、修RAM前8项、原生RAM前8项；保留84/83及原源。建立保留音乐/可视化/扫描/录放的串行结构探针，实际PLL与55个SDRAM内部端口；不是实体演奏协议，禁止下载。联合PnR先暴露rc_delta_store的DPB READ_FIRST不支持，已改为写口保持＋碰撞旧值旁路；36万拍对照、160帧位置/5帧扫描回归通过。音高双存储改原生RAM，寄存器718→142，8万拍独立全地址及96万拍音高对照、三组985PCM旧轨迹逐字节一致；两延迟各200音乐PCM录入/读出和200图案播放在限定数字范围**已验证**。但最终综合20189Logic/11243寄存器/31BSRAM，默认和策略1均PR0003，仍158寄存器未放置，**联合布局未通过、无有效时序余量、加严构建未运行**。全部六构建保留FAIL；不能用资源总数或RTL回归放行。新路径**已实现待验证**、整机**部分实现**，没有下载/Flash/TF/新听感；COM6只读确认76号就绪/活动0/512拍。下一步压缩结构探针开销/状态布局并重做联合PnR，最终混音/文件/非易失继续**待实现**，不据此擅自减少功能或裁定双板。

> **2026-10-19音高状态资源优化**：见[84号](84-音高状态分存与资源优化验证-2026-10-19.md)与`experiments/pitch_memory_20261018/project/CURRENT.md`，版本`pitch-memory-20261019-v0`。先备份102项，82号音乐/存储副本仅改pitch_mod状态存储；96万拍四配置逐拍/全组对照、两故障反例、原三组506645拍/985PCM轨迹逐字节一致及配置/包络回归，在限定数字范围**已验证**。公平综合20422→20117Logic，省305，BSRAM仍31，余619Logic/15BSRAM；寄存器增加64，并非整表变成RAM。无完整联合PnR或新音高实体验证，优化路径**已实现待验证**，整机**部分实现**。系统盘耗尽期间的轨迹/构建不签收，转D盘后完整重跑并保留失败；没有删除历史交付。用户断电后已用操作2重载76号，COM6身份/512拍/2048零PCM通过，无Flash/TF或新听感结论。下一步音乐＋实际SDRAM时钟联合时序，再接回放混音/文件；83号旧比较异常根因仍待定位，不据本轮综合解除。

> **2026-10-18录放SDRAM板验**：见[83号](83-录放SDRAM调度板验与诊断比较修正-2026-10-18.md)与`experiments/sdram_stream_board_20261018/project/CURRENT.md`，版本`sdram-stream-board-20261018-v4`。先备份19项、诊断修订前再备份117项；82号五个搬运RTL逐字节保持。实际COM6/B、ID81B仅操作2 SRAM，默认1024字FIFO/每向256KiB环形区，两次完整静音合成图案测试各1345540内存事务：266240样本/方向含两次回绕、停止后排空、在途/阻塞请求清空、132097连续前缀、8次读空和4096样本/方向恢复均在限定范围**已验证**。早期四个物理版本最终前缀比较异常均保留FAIL并恢复76号；分字节寄存复核后两次通过，未证明旧异常根因为工具或排除全部时序因素。选定v4加严PnR setup/hold +4.205/+0.011ns，余量紧、原始时钟布线警告/确切die温压/完整联合时序仍**待验证**。已恢复76号，身份/512拍/2048零PCM确认，无Flash/TF操作。新调度限定板验完成，文件/非易失/最终混音/真实音乐录放及完整联合PnR仍**待实现/待验证**，整机**部分实现**。下一步先恢复逻辑余量并做音乐＋存储联合时序，再接回放混音/TF文件，不能用独立诊断余量签整机。

> **2026-10-18录放环形调度接合**：见[82号](82-录放缓冲与SDRAM环形调度接合-2026-10-18.md)与`experiments/sdram_stream_20261018/project/CURRENT.md`，版本`sdram-stream-20261018-v0`。先备份101项，冻结原音乐/双FIFO，沿用81号注册输出控制器；新增录制/回放独立SDRAM环形区、四客户轮转及clear接受/清退/完成围栏，停止采集仍排空旧队列。四配置共680016拍/49139内存请求/6341清空、最多等其他3次授予；双后端整链及溢出前缀/读空恢复、四个故障反例在数字范围**已验证**。同工程20124→20422Logic，31BSRAM，余314Logic/15BSRAM；只算联合综合，无新PnR/板验。中间一次工具卡住人工终止，退出0仍不计通过，串行新工程正常完成后才签收。本轮无下载/COM/Flash/TF访问，板上仍76号；实际新调度**已实现待验证**。逻辑数据搬运已接通，但TF/文件/非易失/事件配对/最终混音/完整音乐联合时序仍**待实现/待验证**，整机**部分实现**。下一步隔离调度板验、联合时序与资源优化，再接TF和回放音频，不能用SDRAM易失缓存冒充断电保存。

> **2026-10-18 SDRAM时序与板验**：见[81号](81-SDRAM时序排查与板级读写验证-2026-10-18.md)及`experiments/sdram_timing_20261018/project/CURRENT.md`，版本`sdram-timing-20261018-v0`。先备份109项，修复前再备份194项；隔离注册命令/地址/DQM输出，18万拍9593事务旧源对照和原SDR模型/四反例通过。补齐内部SDRAM映射、双向min/max及相关时钟约束，27→27MHz PLL改善核心时钟分布；正常setup/hold为+5.704/+0.225ns，加严为+4.204/+0.037ns，原未注册加严−0.877ns反例和漏约束假绿反例保留。实际COM6/B、ID81B，仅操作2 SRAM，两次8MiB双图案写读各16777216事务无错；已恢复76号并确认身份、512拍采样与2048零PCM。限定板上路径**已验证**，原始PLL输入PR1014/确切die与封装时序/温压和长期保持仍**待验证**，不作量产签收。本轮无Flash/TF访问或音乐源/GUI/旧快照变更；完整音乐＋新控制器联合资源/PnR、FIFO仲裁/环形区、TF文件/非易失/混音仍**待实现/待验证**，整机**部分实现**。下一步接录放缓冲与SDRAM有界调度/清退，再做联合时序与实测。

> **2026-10-18 SDRAM控制增量**：[80号](80-SDRAM单事务控制与时序模型验证-2026-10-18.md)与`experiments/sdram_controller_20261018/project/CURRENT.md`为新存储控制实验。先备份108项；冻结79号引擎/双FIFO，新增16位单事务、32位SDRAM/半字DQM、200us候选初始化、CAS3、显式预充电与自主刷新。2147事务/1090读1057写、95刷新、最长间隔397拍、最长接受后响应11拍及四个故障反例，在自写子集模型范围**已验证**。公平联合综合20082→20114Logic，BSRAM仍31，余622Logic/15BSRAM；整体映射差值不等于控制器固有成本。真实die时序/封装内引脚/约束/收发时钟/PnR/板验仍**待验证/待实现**，没有下载/串口/Flash或介质访问，板上仍76号。FIFO到SDRAM环形缓冲/仲裁尚未连接，TF/文件/非易失/混音仍**待实现**；整机**部分实现**。下一步缓冲调度/在途事务清退与实际SIP包装/模型、资源和板级验证，不把子集模型PASS当实体RAM已可用。

> **2026-10-18录放缓冲增量**：[79号](79-录放双向缓冲与停顿边界验证-2026-10-18.md)和`experiments/pcm_buffer_20261018/project/CURRENT.md`为新存储实验入口，音乐引擎沿用78号。先备份206项；新增两路1024×16同步RAM FIFO、录制溢出锁存/连续前缀保护、播放读空报告与独立清空。2/8/1024深度共153180拍独立队列参考/坏指针反例、2290578拍双路压力仿真通过；512拍采样、约14.81ms后台停顿后2344录制样本完整、同时2304播放样本无读空。公平联合综合19765→20082Logic、29→31BSRAM，余654Logic/15BSRAM。限定数字缓冲/综合**已验证**，无PnR/板验；SDRAM/TF控制器、文件保存、非易失、最终混音/曲谱配对仍**待实现**。本轮无下载/串口/介质/Flash访问，板上仍76号，原源/GUI/快照保持；录放整体**部分实现**。小FIFO单向满容量约19.42ms，不能保证卡停顿；下一步SDRAM初始化/刷新/读写与缓冲调度资源探针，后端切换还须清退在途事务。

> **2026-10-18参数回读RAM优化**：[78号](78-参数回读RAM与逻辑余量恢复-2026-10-18.md)及`experiments/register_memory_20261018/project/CURRENT.md`为最新源码入口。先备份195项，保留原reg_bank/旧顶层和77号；仅在实际tdm_top_owned接入128字节同步RAM与35字节实时镜像/前拍写转发。15万拍全地址存储/复位、5万拍9993次回读对照及漏转发反例，原音乐/包络/配置回归和115200板级包装仿真通过。同工程20635→19765Logic，减少870；11592→10844寄存器，BSRAM28→29，余971Logic/17BSRAM。限定数字与综合**已验证**；诊断PnR10629Logic/22BSRAM，setup+9.076/hold+0.074ns，无新下载/串口/介质或Flash访问，实体新RAM路径**已实现待验证**。当前板上仍为76号；GUI/原源/旧包/快照保持。非易失、SDRAM/TF与录放仍**待实现**，整机**部分实现**；下一步以恢复的资源做存储控制器和缓冲的隔离验证/联合预算，不据诊断余量承诺全功能。

> **2026-10-17效果器存储优化**：[77号](77-效果器单读口与存储资源账-2026-10-17.md)及`experiments/fx_memory_20261017/project/CURRENT.md`为最新源码入口。先备份189项，仅隔离改fx_delay为单同步读＋标签/转发，保留原抽头更新边沿及现有调度。两轮各60万拍、两种深度逐拍输出/十抽头/写回对照、错位标签反例和原音乐/包络/配置回归通过；同工程20537/46BSRAM→20635/28，释放18块但Logic增98仅余101。数字优化/综合**已验证**；14脚新诊断PnR10369Logic/21BSRAM，setup+7.694/hold+0.083ns，未下载/新板验，实体路径**已实现待验证**。板上和GUI仍用76号已实测版本；原源/包/旧快照保持，本轮无COM/Flash/介质访问/采购。原效果器实际free-running调度与注释不符及启动未知另列，等价不当作时间规格达标；断电保存/TF/SDRAM/录放仍**待实现**。下一步用释放RAM换逻辑余量，再接存储控制，整机仍**部分实现**。

> **2026-10-17包络资源优化与配置板验**：[76号](76-包络共享资源优化与配置板验-2026-10-17.md)及`experiments/envelope_resources_20261017/project/CURRENT.md`为最新入口。先备份172输入，仅隔离共享互斥D/R运算；680560组×3宽度参考、原音乐逐拍/独立包络/配置传输及104GUI回归通过。相同工程仅osc_env不同，20767→20537Logic减少230，余199，BSRAM46/46；联合综合**已验证**，无完整联合PnR。14脚配置诊断PnR10495Logic/39BSRAM，setup+8.486/hold+0.074ns；实际COM6/B、ID81B，仅操作2 SRAM下载，新能力75/1，5次配置确认、快慢起音/击发/两独立音/坏CRC与忙拒绝、最终2048零PCM在限定板上范围**已验证**。当前SRAM已为新配置诊断，使用本轮隔离GUI；旧73六用例与原GUI/exe保留回退，未覆盖或读写Flash。加速复位测试仅确认512时隙关门/幅度/待写及零PCM，不宣称短窗口env全清或新增物理S2实测；新听感待用户反馈。整机仍**部分实现**，断电保存/录放/独立效果/四层/实体显示触控等缺口保持；下一步缓存与存储资源账、非易失和录放接合，不据诊断余量签整机容量。

> **2026-10-17可靠配置传输/GUI接合**：[75号](75-配置可靠传输与GUI接合验证-2026-10-17.md)及`experiments/config_transport_20261017/project/CURRENT.md`为最新实验入口。先备份138输入，隔离接合能力75/ABI1、CRC完整帧、inactive bank提交、事务/版本回读、失败隔离/恢复及GUI应用，旧D4部分应用保留。串口独占/双入口与标准115200引脚到PCM、11主机故障项、104离线GUI、原包络/逐拍兼容及反例在记载范围**已验证**。完整联合候选实际综合20767Logic，超20736上限31，**未通过**；逐位CRC尝试已回滚，失败报告保留，无本版本PnR/码流/板验。完整配置仍**部分实现**，仅通电有效，非易失/录放/完整四层/独立效果/实体触控显示缺口保持。原源/GUI/74号/旧快照不改，未开COM或下载/Flash/采购；下一步有回归约束的资源优化，再做对应音频板级包装/PnR和真实应用确认，不以仿真回执当实体成功。

> **2026-10-17乐器配置/独立包络接合**：[74号](74-乐器配置与逐层包络接合验证-2026-10-17.md)及`experiments/instrument_config_20261017/project/CURRENT.md`为最新实现入口。先备份110输入，在72号隔离副本扩88位运行时槽和独立A/D/R时间参数，schema1持续/击发/混合、频谱与ADSR可编译到逻辑配置口；旧音保留配置、新音用发布数据仍为原型。11项编译检查、5万拍独立RAM/包络参考、最大分频两次回绕、4123PCM/5ON5OFF整链、原985PCM逐拍兼容及额外启用选项兼容、3反例在限定数字范围**已验证**。完整组合综合20277Logic/11189寄存器/45BSRAM，余459Logic/1BSRAM，未PnR/新板验，不保证全产品容量。当前仍仅Nano20K＋喇叭；CLI只写本地文件，真实UART/GUI应用、非易失及独立颤音/效果器仍待接，开启不支持项明确拒绝，完整配置**部分实现**。原源/GUI/71/72/73/旧快照保持，无新下载或Flash操作；下一步可靠传输/能力确认与GUI应用，再接板级验证。

> **2026-10-17在手硬件更正**：用户最新明确当前只有Tang Nano 20K和喇叭，暂无屏幕与实体触控；以此覆盖较早“已有显示屏”的在手清单，不能安排立即点屏/实体触控实测，也不将屏幕候选视为已购买/已到手。约7英寸右手泛音显示触控、逐音滑条及可视化功能目标保持；接口/面板仍待选型闭环与实物验证。73号板载音频限定实测继续有效，原RTL/包/快照未改。后续优先推进不依赖新增外设的完整乐器配置/逐层包络及主机参数应用，使用虚拟输入和仿真继续验证，再将已接合路径上板；录放/存储仍按资源与接口证据推进，不能把板载TF卡座当作已有存储卡。此为开发顺序建议，不替用户冻结音乐行为、取消功能或发起采购。详情见`notes/hardware-availability-20261017/CURRENT.md`。

> **2026-10-17板级实测**：[73号](73-板级音频实测与复位按键更正-2026-10-17.md)与`notes/board-audio-hardware-20261017/CURRENT.md`为最新实体入口。USB恢复后识别COM6/B、GW2AR ID81B，操作2临时SRAM下载成功，实际UART profile72/ABI1/D3正确；六项2048PCM回读、512拍采样、32组满载/34子ON抢占和停止清音在限定板上范围**已验证**。短音另捕获起音/释放下降/最终零PCM；实际复位后计数/绑定归零、2048零PCM，重新A4演奏成功；用户反馈能听到且暂未发现异常。重要更正：约束87脚对应**S2**，旧72/40/41等“S1/87”是文字编号错误，按S1的失败记录保留；码流连接未改。原源/GUI/71/72准备包及旧快照保留，新证据另存，不读写Flash。实体引脚边沿/外部I²S时序/模拟质量、屏幕/触控/完整整机及配置/存储/录放缺口仍待验证/实现；不把短诊断检查外推整机完成。

> **2026-10-17板级音频准备**：用户此前未上电；新增[72号](72-板级音频诊断准备与复位清音验证-2026-10-17.md)及`experiments/board_audio_20261017/project/CURRENT.md`。先备份542项，隔离14脚音频诊断与静音回退，保持原源/GUI/71号及旧快照；发现按住双层音复位后时隙可残留发声，板级默认启用两遍512时隙清音/启动围栏，默认关闭路径仍与71号三组506645拍/985PCM逐字节一致。板级284PCM/40ON38OFF/12移动、实际115200配置仿真、512时隙清零及故障反例、主机9项检查在限定数字范围**已验证**。最终默认策略PnR 15258Logic/7287寄存器/36BSRAM/14IO，内部27MHz setup +3.523ns、hold +0.214ns、TNS0；策略1超时保留，外部I²S/实体未验，诊断资源不外推完整71号/整机。交付SRAM临时镜像/静音回退/只读默认串口脚本，**已实现待验证**；未开实际串口、下载、读写Flash/采购，下一步上电核验并保存真实音频与状态证据，完整配置/录放/7英寸等缺口保持。

> **2026-10-16资源优化，保持音乐行为**：用户强调防止优化引入bug；新增[71号](71-资源优化与逐拍等价回归-2026-10-16.md)和`experiments/resource_safety_20261016/`，备份并核验500项原交付后，优化触点锚点、实例身份与触点记录存储/读取。三组锚点各50040拍、5000事件、541帧原桥功能/对照＋26条600随机帧、完整音乐三场景506645拍/985PCM逐字节轨迹比较在限定范围**已验证**；3个故意破坏副本均因预期断言失败，未进入产品。公平工程重综合参考20668Logic/12604寄存器/43BSRAM，选定19892/11120/43，腾776Logic、1484寄存器，余844Logic/3BSRAM；无PnR/板验，不等于全产品装得下。完整包络/配置、非易失、录放/曲谱和7英寸界面继续**待实现/部分实现**；原源/GUI/70号/旧快照保持，启动未知、≤10ms/显示/硬件与预算缺口保留，无下载/采购，未替用户决定新音乐规则。当前入口`experiments/resource_safety_20261016/project/CURRENT.md`，下一步按资源账接逐层配置/包络和存储。

> **2026-10-16四槽与双层实现增量**：[70号](70-四槽运行时音色与双层音频原型-2026-10-16.md)及`experiments/instrument_layers_20261016/`新增四槽16分量运行时表和原子提交、每起音独立预设、双层子身份、一指双组滑音及按旧选择释放。四槽352PCM/9ON9OFF、扫描到双层259PCM/6ON6OFF、旧374PCM/I²S兼容及存储优化对照在限定数字范围**已验证**；首PCM及512拍I²S启动未知、模拟/屏幕/听感/PnR仍未验。初版21822、同步表20897、全去复位21183Logic均失败；选定同步身份查询/预取与世代压缩20668Logic/43BSRAM，仅余68Logic/3BSRAM，须先进一步优化。起音/释音/效果器仍共享，v0槽表不是GUI完整配置；四层同时、完整配置应用/断电保存、录放/曲谱、7英寸界面继续**待实现/部分实现**。新音用新配置/旧音保持、最多双层、逐层抢占和未自动补层均为可替换原型，不冻结最终音乐语义。备份334项并保留原源/GUI/69号/旧快照，无下载/采购；当前入口`experiments/instrument_layers_20261016/project/CURRENT.md`，下一步资源余量与完整包络/存储接合。

> **2026-10-16左手实例接合增量**：[69号](69-左手实例事件与真实音频接合-2026-10-16.md)及`experiments/left_hand_events_20261016/`接通位置→实例事件/完成反馈→逐指绑定→真实PCM；同MIDI音位独立、移动不重奏、旧OFF/抢占保护、故障恢复及左右手保持/恢复在限定数字范围**已验证**。117分配事件、541桥接帧、500事件32组等价、134样本/75事件真实音乐、259样本扫描到PCM、374样本原PCM/I²S兼容通过；理想RC模型不是实体签收。联合并行19758Logic、串行19621Logic/41BSRAM，只省137，余1115Logic/5BSRAM不含完整配置/分层/录放/7英寸界面，无PnR/板验。先备份194/318/108项，main192/最新246身份核对，原源/GUI/旧实验/协议/快照保持。8帧/100ms故障与世代等为可替换工程设置，音乐未决项不冻结；整机仍**部分实现**，下一步配置/双层及进一步资源/存储接合，无下载/试听/采购。

> **2026-10-16整机接合与资源优化**：用户要求持续完善完整项目，新增[68号](68-整机接合实现与扫描资源优化-2026-10-16.md)、`experiments/system_integration_20261016/`与整机逐项状态。实现6路96节点RC扫描/595锁存、显式校准/差值、26条位置报告；160帧独立参考及并发1574音频样本/43位置报告/1次FFT在数字范围**已验证**，左手报告到音符实例仍**待实现**。共享滑音候选40000周期/256万逻辑组检查及原引擎整链对照通过；本版联合综合原滑音20175Logic→共享17234，BSRAM41，余量不代表录放/分层/7英寸界面已容纳，无PnR/板验。扫描默认无等待1.859ms，每控制字等64拍2.011ms，后一情景未过2ms采集规划，也不能按两帧确认宣称整机4ms。原产品/旧实验/GUI/约束/快照保持，先备份194/318/141项；main192/最新246身份核对，未下载/试听/采购。整机继续**部分实现**，下一步输入实例/反馈、配置/分层及录放资源，音乐未决项保持讨论中。

> **2026-10-16推子音频接入增量**：新增[67号](67-右手推子音频接入与联合资源探针-2026-10-16.md)与独立`experiments/right_hand_audio_20261016/`，沿最新engine-safety246输入底座接入推子→映射→平滑→真实PCM。读出幅度修饰不写基础谱/相位/音高/包络；控制261过渡样本、内核1030样本、真实顶层和弦374样本/8事件在限定数字范围**已验证**，包括保持、释放包络、新音与恢复后PCM/I²S一致。8组映射/最大2倍/步进仅可替换测试设置，跨区、分层/PCM范围未冻结。联合旧扫描＋可视化21658Logic超20736，**RP0006失败**；移除旧扫描的诊断副本18292Logic/39BSRAM，但**新实体左手前端未计入**，不能宣布整机单板可部署。main192与最新246身份通过，原194/930/43项先备份并保持；未改产品源/GUI/协议/约束/码流/旧BOM/快照，无下载或试听。产品仍**部分实现**；实体驱动/联合PnR/端到端延迟**待实现/待验证**，下一步补新前端资源与真实报告，不自动加板或扩大预算。

> **2026-10-16分区推子实现增量**：用户已确认左右分侧/两触点高度中点并授权实现，新增[66号](66-右手分区推子控制器与交互原型实现-2026-10-16.md)及`experiments/right_hand_faders_20261016/`。用户补充每推子有分区、B不抢A区触点、范围可调；当前原型按硬边界＋区内横向距离/半径，是否允许显式扩邻区的进一步问答待答，不冒充最终音乐规则。实现前194/930/219来源文件ZIP/哈希备份；独立RTL整帧控制、近者/中点/保持/恢复抢占已实现，11项规则单元、2480帧RTL/参考及同输入浏览器模型、11项浏览器UI检查在限定范围**已验证**。通用/示例封装独立综合1317/564Logic、0BSRAM，无联合PnR/板验；8×5控制49周期约1.815µs仅数字算式。浏览器同帧多指抬起中间目标缺陷已修正。实体报告驱动、到音频的映射/平滑、分层/尾音/回放范围仍**待实现/讨论中**，完整路径**部分实现**；旧源/GUI/图纸/旧BOM/快照不变，无下载或串口接入。下一步收口作用区域后独立接音频修饰层与实际报告。

> **2026-10-16用户明确推子规则**：用户选择“附近推子随触点位置移动、松手保持”，同侧两个触点取最靠近推子的，两侧各一个时推子移到中心；取代此前相对位移/落指单组独占候选，不采用靠近手柄才接管。已同步49/65，行为**待实现**。左右分侧、中心高度算术中点为当前待确认解释，最近距离/影响范围/交接平滑等仍**讨论中**，不先定几何算法。全和弦/RESET目标保留；main192身份PASS，仅文档更新，无产品/硬件/旧快照变更。

> **2026-10-16右手推子行为待澄清**：用户重提“推子行为”及“靠近屏幕接触点”，当前不完整描述尚不能决定绝对位置跟随、邻近泛音带动或靠近手柄才接管。65号已注明相对位移仅是旧文档候选，不能替代用户原意；等待明确触点/推子对应关系后再定映射。已确认松手保持/全和弦目标保留，细则**讨论中**，无代码/图纸或硬件变化，main192身份PASS。

> **2026-10-16成本/右手应用核查**：新增[65号](65-成本可行性与右手泛音构造应用审计-2026-10-16.md)，只读核查ca03主机与engine-safety底座11文件、资料与算式。约558元成本使用MRB7966并口屏，而原17GPIO候选依赖SPI屏，接口/适配/制造未闭环；保护/MUX回退情景约599/578元，二者回退约619元，均非成交总价。右手继续以7英寸、全和弦、松手保持/RESET为目标；V1.0横选组/纵向相对调整/8组仅候选，区别基础谱编辑与演奏强调。当前主机11版仅空闲部分应用预设/谱；受查RTL旧pad掩码命中255、只刷gact，不具完整触屏追踪/保持/平滑，也不能保证尾音修饰。GT911官方100Hz及理想读取已不能证明最坏≤10ms，SSD1963有显存不等于SPI/高层绘图；PCM伴奏的右手作用范围仍需讨论，不擅自定只修现场。main192身份PASS，无产品/图纸/旧BOM/快照修改或采购；核查限定范围**已验证**，成本**讨论中**，完整路径**部分实现/待实现/待验证**。下一步整屏含适配路线、隔离手势/音频原型、联合资源/实测与真实制造价。

> **2026-10-16继续降本**：用户要求继续压缩，新增[64号](64-七英寸整机降本候选与选择性装配-2026-10-16.md)与`hardware/cost-compression-20261016/`，保持7英寸/两八度逐音滑条/录放与AUX等功能。国内精确MPN/C码核对得到Nexperia C179326参考1.49元×6、台舟四通道保护C2841426参考0.3392元×25；26音位例部分电子料123.9649→62.9049元，较旧混合价模型潜在减少61.06元，数量档结算与RC/保护资格未过，未覆盖旧BOM。台舟原厂5页PDF已渲染目视核对，最大电容0.4pF、10nA漏电条件±2.5V/25°C，不当成TI等价已验证。原315元预留不削，180元屏参考下条件情景约558元且适配仍缺，500元尚未闭环。用户确认普通件自行焊接/小封装工厂，并报告有5V3A电源、铭牌待补；选择性SMT报价和合格电源可扣金额待核，不把45元供电合项全部归零。状态**讨论中**，硬件**待实现/待验证**；资料/金额检查不等于产品验证，无引擎/图纸/旧BOM/快照或采购变化。下一步优先小样资格、完整屏含适配价和选择性制造实价。

> **2026-10-16成本调查**：用户要求实际调查成本，新增[63号](63-七英寸整机成本调查与预算缺口-2026-10-16.md)及`hardware/cost-survey-20261016/`。18条国内JSON-LD Offer参考、9条国际USD数量阶梯，首次区分`theRatio`销售增量、颗数库存/完整包装库存、装机用量/首台采购；EC11/EEPROM/PT8211-S/PCM5122国内公开参考分别8.21/2.64/2.94/13.22元，所需数量档和结算未验。MRB7966厂家样品25USD、MSP7001公开30USD，均非国内含运报价。混合价格参考中，部分电子料最小包装约121～124元，另315元未报价预留后，加屏保守情景约619～712元且部分仍缺接口/电容选项；USD按假设7.2折算，非实时汇率，不能当市场最低或最终报价。500元目标及7英寸方向保留，国产保护/制造/已有电源等降本需资格和实价，不自动削减保护、改功能或加预算。选型/预算**讨论中**，资料与算式仅限记载范围核对，main192身份PASS，无产品源/图纸/旧BOM/快照修改或采购。下一步补国内少量阶梯、具体整屏版本与制造/装配报价。

> **2026-10-15右手约7英寸与整机成本增量**：用户要求继续嘉立创选型、右手屏优先约7英寸、控制成本。新增[62号](62-七英寸右手触屏选型与整机布局评估-2026-10-15.md)及`hardware/seven-inch-selection-20261015/`，6条整屏路线、原生系统库筛选、5条国内公开商品身份/库存、470×220mm比例布局及500元分配表。优先架构为800×480、屏侧显存/图形命令、SPI显示＋直接I²C多点触摸；MSP7001低成本线索缺显示/触摸IC规格，MRB7966是16位并口，ER-TFTM070-5V4电容＋SPI版尚无完整价。LT7680A-R/C5156687库内存在但国内已停售/库存0，不能采购定案；C359951单件包参考239.40元/库存1，但USB触摸增加主机开发，不作首选。屏200＋其余300仅分配，尚无满足全部接口和约500元整机报价的最终型号。7英寸替代此前小屏主推荐，原两屏/两八度逐音滑条、独立八度选择、录制伴奏＋现场演奏与AUX等保留；13音位/8泛音组仅布局例。选型**讨论中**，新屏与联合资源/延迟**待实现/待验证**。原生只读会话已关闭、工程哈希零变更，main192身份PASS，无引擎/旧BOM/图纸/快照修改，无采购制造。下一步先补确切模组控制器/版本/整价，再按实际接口做隔离驱动、GPIO/电源和联合资源验证。

> **2026-10-15伴奏＋现场演奏硬件规格规划**：用户要求规划所需硬件与规格，新增[61号](61-录制伴奏与现场合奏硬件规格规划-2026-10-15.md)及`hardware/recorded-accompaniment-plan-20261015/`。建议一路PCM回放＋现场合成，复用Nano/TF座/8MiB SDRAM/功放，卡用16/32GB SDHC/FAT32；预留约1MiB录放工作区，其中读/写各256KiB，各约2.486秒PCM。105468.75B/s与30分钟189.84MB为算式，不冻结录音时长；0.5MB/s为有效吞吐实测目标。卡30元＋既有新增AUX支路50元仅预算分配，非报价。52.734375kHz/32fs/位对齐成为DAC资格门槛，未将PCM5102A通用模块直接定案，停产UDA1334ATS仅作技术参考；立创错MPN结果已拒绝。规格**讨论中**，硬件功能**待实现**；main192身份PASS，无引擎/图纸/旧BOM或快照变化，无采购。下一步隔离TF/SDRAM/混音与联合资源探针，再收口DAC和真实价格。

> **2026-10-15已确认新增个人合奏方式**：用户明确将“录好钢琴伴奏并播放，同时现场演奏弦乐旋律”加入设计。伴奏与现场可有不同音符/节奏/乐器，回放期间现场输入必须有效，与原同次演奏音色分层并存，状态**待实现**。已同步42/49与57号§6：优先评估PCM回放＋实时合成但未冻结后端，独立状态/所有权、混音余量与TF缓冲、全机资源/延迟需验证。当前上位机旧曲谱路径会禁用手动演奏，不能当此功能已实现。循环、多轨继续叠录、变速、轨数及右手作用范围仍讨论中。main192身份PASS，仅设计增量，无代码/图纸/采购或旧快照变更；下一步建立并行录放/演奏状态与资源探针。

> **2026-10-15重新讨论音色分层与演奏录入**：用户希望再讨论这两项，尚未提出替代规则。既有同次演奏同音分层、音频保存/回放与实体录入/指引需求继续作为讨论起点，不据此撤销需求或推定新增分轨/循环叠录。需区分：实时同音音色层、保存实际音频、记录带时间戳演奏事件，以及先录一段再配合新声部的分轨合奏；最后一项目前仅用于澄清愿景。层间音高/表情/启停、实时或逐音录入及是否边回放边演奏等具体规则**讨论中**，不提前写死到实现。main192输入身份PASS，本轮仅文档讨论，无引擎/图纸或旧快照变更。下一步先听取用户对两项的目标或不满意之处，再形成动作与声音的例子。

> **2026-10-15恢复硬件选型/最终实现前复述**：用户在11版GUI交付后要求继续硬件选型与最终实现，当前先复述功能和硬件要求。已将最新两屏、两八度逐音滑条＋只选档八度条、四槽自定义/同音分层、按压旋钮与断电保留、录放/曲谱、喇叭＋仅AUX的3.5mm支路、Nano插接建议、500元与≤10ms约束汇总至[49号当前执行汇总](49-最终收敛设计总纲-2026-10-15.md)。具体触摸屏/DAC/保护器件、端点/尺寸、联合资源、报价和局部音乐规则仍未定；主机部分应用不代表完整配置实现。仅更新文档，main192身份PASS，不新写快照、不改引擎或图纸，不将继续研发理解为付费下单。

> **2026-10-15用户截图确认与高级工具重设计**：实际运行的是`ca03`工作树交付的`host-workbench-20261015-10`；它已支持预设/谱部分应用，前轮只读核对6e70/engine-safety不能代表该用户版本。已先备份233文件、验证原发布输入无漂移，再增加按屏幕可用区域限制的高级窗口、上下固定关闭/Esc、固定保存与部分应用、文件菜单和窗口内状态；日志单独标签，关闭保留草稿。100项主机测试、舒适/大字和多档Qt缩放布局及源码启动/自测在各自离线范围**已验证**；11版实际打包验收见`notes/advanced-tools-redesign-20261015/delivery.json`。完整模式/包络等应用继续**待实现**，本次不冻结新音乐规则或修改引擎/协议，不下载或接管原运行进程。来源/风险见ca03的`docs/05-上位机/高级工具窗口重设计-20261015.md`；main192输入仍按原基线验明，不更新旧快照。下一步交付新版后由用户实用确认；完整配置及非易失应用另行推进。

> **2026-10-15调参后不知如何应用的反馈**：用户称“高级功能的开发设置”难用，调好后不知道如何应用；具体页面/运行版本尚待确认，已询问。只读核对6e70及engine-safety的`tools/host/config_editor.py`：完整配置页的“应用到在奏音 · 待接入”按钮被显式禁用，保存/载入只操作本地文件；`dsp_gui.py`中的设备实验页与该草稿独立，旧谱形需“下发谱 + 显式刷新”，真串口另有协议v1.1回读门禁。不能建议用旧谱形命令冒充完整激励/包络配置应用，也不能据此推定用户实际运行的exe或板上版本。应用闭环仍**待实现**；建议后续明确试听/设备生效/断电保存的独立状态与入口，方案**讨论中**，未替用户冻结在奏音更新语义。本轮未改GUI/引擎/设备参数，未接串口或试听，main192输入身份PASS。下一步先识别用户页面，再给对应操作或补齐实际适配缺口。

> **2026-10-15音乐表现入门讨论**：用户希望学习如何调整音乐表现，尚未提出新的交互决定。本轮将听感拆为音高、节奏/音长、强弱、起音/衰减/释放、音色演化与层间角色；建议先用单音比较瞬态/持续行为，再试逐指滑音、全和弦右手修饰，最后做双层角色对比和短句试听。所有练习、参数和调整顺序均为**讨论中**，未冻结激励/连奏/八度/动态控制映射，不新增压力要求。电容位置/接触面积不能直接当力度；连续音量控制缺口应先讨论已有输入能否承担，再决定硬件。延续右手全和弦修饰、松手保持/RESET平滑恢复，分层为同次演奏同音驱动多个音色，不推定独立伴奏。完整自定义包络、实体表情与分层仍**待实现/部分实现**，具体边界按44/49及后续证据；本轮未试听、改引擎/图纸或新写基线，main192输入身份PASS。下一步用少量声音样例和同一短句比较形成可听的选择，再由用户确定参数与行为。

> **2026-10-15用户明确3.5mm用途**：仅接有源音箱／音响AUX输入，按模拟线路输出设计，耳机直驱不纳入本轮需求。该用途决定已记录，电路仍**待实现**；候选为独立I²S DAC线路输出支路，保留板载喇叭支路，具体器件、接口电平、音量和插拔抑噪、预算及接合均未验证。是否插入后自动关闭喇叭继续**讨论中**，不将此前耳机静音建议自动沿用为决定。见60号§6补充。本轮仅更新文档，main192输入基线PASS，未改产品实现或原理图。

> **2026-10-15新增3.5mm音频输出与安装答疑**：用户先讨论硬件问题，询问整块Nano可插接安装，并明确希望实体机增加3.5mm输出。已在60号§6记录整板排针/排母可拆卸的安装建议，实板排针/机械尺寸未核；新增模拟音频输出**待实现**，耳机/有源音箱/两者用途及自动静音仍**讨论中**，已询问。板载MAX98357A差分喇叭输出不能直接接普通共地耳机/AUX；候选另加I²S DAC与所需耳机驱动，具体料号/预算/时钟/负载均未定，不增加计算MCU、不擅改采样率。此前28行BOM尚不包含新音频支路，不能称全部外围齐备。main192基线PASS，仅需求与讨论记录，未恢复图纸/代码实施，无采购或新增音频验收。

> **2026-10-15整机选型收尾：排针事实纠正**：用户继续推进，补充原型喇叭4Ω/3W，显示模块实物接法暂不清楚。新增[60号](60-整机选型收尾与真实排针核对-2026-10-15.md)和`hardware/system-candidate-20261015/`：官方3921 Rev1.30原理图逐图核对后，纠正旧源码注释把27～42都称为板边排针的假设；形成17 GPIO候选，复用LED0～5、共享两屏DC/复位、现有595的Q6/Q7控制复位，保留音频/TF/USB调试。实际接线/RTL均**待实现**，GPIO15的MOSI带LED负载待实测，不将静态冲突检查视为板级完成。F款SKU30896为5V供电/3.3V逻辑，国内官方搜索索引107.06元只作参考；更正其显示窗口尺寸与此前通用3.5英寸算例不同。28行整机范围BOM、80/83感测节点分配和保护器件身份/封装排查已交付；完整价格、机械、保护与传感、双屏/录放资源仍未闭环。原生EDA只读查询前后图纸哈希不变，main192输入PASS，无采购/制造或产品源码/快照修改。选型状态**讨论中**，本轮资料/表格检查仅在记载范围**已验证**。

> **2026-10-15右手直接显示决定与商城筛选**：用户明确右手泛音区需要在手指下直接显示可操作图形；纯触控平面不再作为替代。新增[59号](59-右手触摸显示区商城筛选与接口预算-2026-10-15.md)：优先验证3.5英寸五点SPI显示/I²C触控成品，微雪F款SKU30896（ST7796S/GT911）及DFR0669/C17641738（ILI9488/GT911）为较大候选，2.8英寸SKU27579为紧凑备选，未冻结型号/尺寸。国内立创DFR0669精确身份已读、库存0；厂家自营页169元/有货，未结算；系统库对照查询可用但所查模块无结果，不虚构库UUID。GT911公开手册`0x8056`有`5+N ms`周期，修正仅凭官网100Hz排除更快配置的推断，物理≤10ms仍未验证。按已有可视化屏＋右手屏核算约21逻辑GPIO、局部更新与新增预算，未决定第二FPGA或取消已有屏；500元分项上限只是建议，非整机报价。候选/预算**讨论中**，接口/整机资源/实测**待实现/待验证**；现有EDA工程只读查询前后哈希无变化，音乐源码main192输入PASS，无采购/制造。

> **2026-10-15右手触控区域澄清与具体配对**：用户说明“触控屏幕”指泛音构造操作的右手区域。已整理[58号](58-右手泛音触控区域与音高滑条组合候选-2026-10-15.md)：具体候选Waveshare 2.8inch Capacitive Touch LCD/SKU27579（ST7789T3＋CST328、SPI显示/I²C触摸、厂家标称5点）＋左手定制PCB逐音滑条及既有4067/LVC14。右手24节点只是旧容量例，不是二维屏已选定；若右手坐标独立采集，则25/26音位＋八度5节点例为80/83，6路×14可用=84，18逻辑GPIO示意可重排。状态**讨论中**，未冻结右手面积/本地显示/单双屏，未保证报告延迟≤10ms或500元，未换原理图/购料。GT911官方100Hz报告不能直接满足含后级处理的最坏≤10ms；原FPGA原始触控计算与专用控制器提坐标须区分。main192输入PASS，仅资料/算例，无新产品验证。

> **2026-10-15更高刷新率讨论**：用户询问计算资源是否已限制刷新率。已补55号§5：95.4%Logic为空间占用，不能当CPU繁忙率；20Hz是当前调度目标，局部更新仍可优化。现6.75MHz SPI全屏纯像素182.044ms，手册10MHz理想全屏仅8.138fps，故全屏30/60fps需不同带宽路线。既有压力场景并集擦画理论可省9344byte（25.8%），30Hz局部更新作为下一档候选而非保证；时钟/连续发送、短音保持、联合资源与实屏仍待实现/验证。仅代码/手册/算式核对，main192输入PASS，无RTL/原理图/采购改变，不替用户冻结新刷新率或延续旧暂停。

> **2026-10-15新增录放/曲谱要求与小样接线**：用户要求保存演奏音频并播放、实体录入演奏、曲谱指引及播放。需求已记载，新增实现**待实现**；建议PCM原声轨＋带时间戳的演奏轨，前者回放声音、后者指引，不以EEPROM/FFT或旧64步定序器代替。官方确认板载TF座/8MiB SDRAM，保留80～85脚，单板新增逻辑尚需资源探针。时长/逐音编辑/外谱范围的问题仍待答复，按压旋钮菜单为建议。小样三页53元件已接线，原生规则检查0项，231引脚与独立网表0差异；状态**部分实现**，仅图纸连通范围**已验证**。见[57号](57-小样接线与录音曲谱功能扩展-2026-10-15.md)及`hardware/pitch-sliders/prototype-schematic-20261015/`；下一步保护/电极封装/接口资格确认及存储资源验证。main192输入PASS，未改音乐引擎、产品协议/约束或旧快照，未生产采购。

> **2026-10-15用户恢复嘉立创硬件选型**：选型暂停已由用户明确解除；55号显示缺口不因此消失，也不作为阻止选型的前置许可。本轮CLI连通，备份并打开既有小样工程，改用MPN精确搜索核对18种型号/C号与库UUID；实际保存12个关键元件、原生BOM7类/12件、129引脚读回及整图，见[56号](56-嘉立创硬件选型恢复与关键料审阅-2026-10-15.md)。14种国内公开页身份/库存记录，18种实际单价仍未报价；新旋钮候选B2避开无货/NRND候选，修正跨音位容量例为每路2校准、112感测节点。工程为选型审阅页、未接线/PCB/生产；状态**部分实现**，身份读回范围**已验证**。下一步小样原理图/保护/引脚、PCB/实际计价与实测；500元仍为预算目标，无采购/制造下单，未改音乐产品源码或旧基线。

> **2026-10-15可视化性能指标核验**：用户认可画面后要求确认刷新率等指标；已新增[55号报告](55-音乐可视化性能指标核验-2026-10-15.md)，未改音乐/显示RTL。保守合法接口压力4轮最长51.721ms、迟帧1次，20Hz全压力门槛未通过；5ms短音轨迹漏记复现。FFT约47.64Hz，波形约9.71ms快照/50ms而非连续覆盖，频谱UI满高回落约900ms；具体实测/推导/实屏未验证分别列明。审计范围**已验证**，产品仍**部分实现**；下一步合并波形擦画、轨迹事件保持，再做完整图像/压力、联合综合PnR和实屏。优化目标/回落时间为建议，未替用户改变音乐交互；原输入身份与备份不变，选型制造继续暂停。

> **2026-10-15音乐可视化模块增量**：用户提供YT240L008N并要求实现清晰、流畅的可视化及先备份。三份备份先完成校验，新模块仅放在`experiments/music_visualizer_20261015/`。真实PCM波形、1024点FFT/48频带、32声部轨迹的隔离实现及8轮20Hz调度/引脚图像在数字范围**已验证**；1505012周期、2939样本PCM/I²S对照一致，原main192/最新246及备份297文件未改。单独2968Logic/7BSRAM，联合核心19777/20736Logic、38/46BSRAM；约95.4%的Logic占用尚无真实IO/PnR，不能签收完整产品或据此直接决定双板。模块接合**部分实现**，实屏/最终初始化/事件适配器**待实现/待验证**；屏幕N后缀和实物绑带/排针/供电仍需核对。详见[54号](54-音乐可视化独立模块与验证报告-2026-10-15.md)；选型/制造暂停继续有效，下一步是实物信息、独立板级包装与联合PnR/点屏。

> **2026-10-15 ILI9341候选驱动第一轮验证**：用户提供商品ID992086116483，明确ILI9341无触摸版，补充8080/SPI描述；原生240×320已按手册核对，但实际模块排针/跳线/供电未确认，商品页未读成功。已在notes隔离实现4线SPI/RGB565候选，完成引脚时序、整屏/局部GRAM逐像素检查、传输中复位、源暂停、非法窗口与三类负向对照，详见[53号报告](53-ILI9341驱动仿真与资源探针报告-2026-10-15.md)。v1.11规定SPI写周期≥100ns，之前20/40MHz算例不能套到该屏；新驱动6.75MHz，整屏仿真219ms，不能承诺20～30次/秒全屏。独立综合336Logic/150寄存器/0BSRAM；同核心＋驱动17373Logic/31BSRAM，133抽象端口、无物理IO/PnR，不是完整三视图验收。驱动在上述数字范围**已验证**；真实面板、三视图/全功能与实体**待实现/待验证**。main192及源工作树246身份检查PASS，未改产品RTL/快照、未下载；选型/制造继续暂停，下一步为真实数据渲染/局部更新预算、联合资源与实际模块信息。

> **2026-10-15 优先验证显示，暂停选型**：用户担忧音乐可视化失败，转向先做屏幕驱动与可视化验证，已记入[52号计划](52-屏幕与音乐可视化优先验证计划-2026-10-15.md)。先取得实际屏幕驱动IC/分辨率/接口，做协议与图像重建仿真、真实音频三视图/并发对照、联合资源PnR及实屏验证；不能凭驱动仿真或50号对照综合签收全功能。用户此前已明确八度条只选档不测力、增加按压旋钮、设备断电保存；49号已同步，状态**待实现**。50号两次隔离综合为18190/38BSRAM与17087/31BSRAM，均非完整产品PnR；单板尚可验证，双板仅条件性备选。嘉立创初始化后API已连通，在独立会话创建本地小样工程骨架，但库查询为空/原理图创建无UUID，未放置器件；已暂停继续选型和制造。main192基线PASS，本轮未改产品源码或新增屏幕/板级验收，不更新源码快照。

> **2026-10-15 边界与选型推进顺序讨论**：用户询问先明确规则还是选型打板；已在49号§9记录建议：先收口影响传感物理量/触点目标、编辑输入、存储、接口与全尺寸几何的少量硬件边界，同时推进选型和小样验证；分层/激励/编辑行为继续细化，不要求全部讨论完成才做原型。建议先相邻3～4条小样，检查连续位置、串扰/误触/释放，并核算完整规模扫描；完整面板需传感证据、通道/引脚/资源、总预算与制造检查后再定版。状态**讨论中**，不视为采购/制造授权或用户规则决定。main192输入基线PASS，无产品源码/制造文件或新硬件验证，不更新快照。

> **2026-10-15 最终收敛设计统一入口**：用户要求整理最终收敛方案、确保理解一致。已新增[49号最终收敛设计总纲](49-最终收敛设计总纲-2026-10-15.md)，区分用户已决定的产品主线、待确认行为与工程选型：自定义乐器＋音色分层；两排逐音滑条共两个八度＋独立八度切换条；实体TFT、泛音构造区、四预设与编辑入口；取消独立钢琴键机构而不取消逐音布局。通用定义按激励、频谱、时间演化、表情映射组合；不擅自冻结分层切换、编辑试听/应用、再激发、断电保存或新增编码器。三版硬件仍按48号同规格比较，首版PCB电容/FPGA路线仅为优先验证建议，未签最终BOM/制造报价。主线功能**待实现**，局部规则**讨论中**；main192输入基线PASS，本轮仅设计文档整理，无新增产品实现或验证，不更新源码快照。下一步按引擎→单乐器定义/生命周期→表情/尾音→分层推进，传感小样与全规模预算同步核算。

> **2026-10-15 用户授权代安装EDA，安装与CLI检查完成**：用户明确询问并授权助手安装嘉立创EDA，同时询问风险；该授权优先于skill的默认人工安装流程。已从官方HTTPS文件服务器下载4.1.71 x64，257686992字节，SHA256与CDN响应头一致，Windows Authenticode Valid/发布者深圳嘉立创科技集团股份有限公司。安装于`C:/Users/Sakuya/AppData/Local/Programs/LCEDA-Pro`，安装器退出0，日志确认非管理员/HKCU且无需重启。CLI实际版本4.1.71.7a7261be，help/doctor退出0；doctor为ok=true、connected=false，尚未启动编辑器或验证激活/原理图/PCB/API权限，不把安装成功当设计完成。证据见46号§8及notes安装证据目录。安装来源/完整性和CLI在上述范围**已验证**；其余工作仍按48号**讨论中/待实现**，音乐产品源码未改。

> **2026-10-15 嘉立创服务与客户端安装说明**：用户询问官方指南为何要求AI不自行下载安装及平台能帮项目做什么。本轮核对官方服务/CLI/BOM/AI客服资料，在46号§7区分EDA、商城/BOM、PCB/SMT/FPC、结构制造、开源参考与AI接口；指出PCB可制造定制滑条电极，但不能自动保证位置/压力/10ms性能。安装句子仅为所读AI CLI指南默认流程，文档未给制定理由，不提升为嘉立创普遍禁令；本轮无新增代安装授权/产品规则。原两八度逐音滑条＋一条八度切换条及三版选型目标不变；main192输入基线PASS，仅资料澄清，无新EDA工程或产品验证。

> **2026-10-15 用户纠正：保留原两八度逐音布局＋一条八度切换滑条**：用户要求回看最新设计，明确是输出三版完整选型设计。此前助手把“取消钢琴键”扩大解释为取消逐音布局、重新讨论少数全音域滑条或单条多指，属于理解偏差，相关46/47号内容已标为不适用，不能沿用。当前边界：两排逐音滑条覆盖两个八度，保留一条独立八度切换滑条，四预设/编辑/右手构造及全和弦修饰等目标继续有效；不另开布局选择题。旧39号§3/25号通道表为24半音＋高端C共25音位，最新“每排完整八度”是否两排都带端点尚不能从旧表裁定；三版按25音位作计算基线，列26音位增量，不重开已明确的总体布局。已整理[48号同规格三版选型](48-两八度逐音滑条三版选型设计-2026-10-15.md)，比较完整规模的PCB/FPGA电容测量、原始CDC、膜式位置条，包含八度条、节点/器件规模、500元约束与制造缺口；状态**讨论中/待实现**，不把预算分配或旧小样当最终制造验收。本轮main192输入基线PASS，仅文档修正，无产品源码改动。

> **2026-10-15 三套方案澄清**：用户明确“三板”意为三套方案，不要求制造三块实物板；已同步46/47号。用户询问“多条独立滑条/单条多指滑条”含义，本轮解释为分开感应区各自跟踪触点与共享连续区同时跟踪多个触点两种布局；各条不必固定音名或绑定预设。条数、布局、音高映射仍**讨论中**；未因释义默认选定四条或单音能力。三传感架构与两种布局属于不同维度，后续按实际布局复核可行性。main192输入基线PASS，仅文档澄清，无新增产品实现或传感验证。

> **2026-10-15 用户取消钢琴键，改纯滑条并要求嘉立创工作流**：用户明确放弃钢琴键布局，音高入口改为滑条，覆盖此前45号琴键/条合一比较和旧24～26键数量假设；新形态**待实现**。用户要求“出三板”及约500元最终选型制造方案；“三板”含义（3套候选/3块实物）和独立多条/共享多指布局已发起澄清，未以默认值代裁。已新增[46号嘉立创工作流](46-嘉立创AI选型与PCB制造工作流-2026-10-15.md)与[47号三传感架构比较及预算](47-纯滑条音高演奏三方案与制造边界-2026-10-15.md)：官方easyeda-api1.1.52与社区lcsc skill已安装；用户确认EDA客户端未安装，尚未接通/创建工程/DRC/导Gerber。公开商城核对了4067/LVC14、AD7147两个包装、ThinPot及FDC候选；发现AD7147的C456284缺货但C207411有货，不能泛化；USD/国际站不当国内结算报价。社区AD7147查询实测错配电容，已用只读身份过滤器拒绝，未将错误料写入候选BOM。500元为上限分配，尚无完整实时报价；关键边界/传感证据/客户端缺口未解除，不标制造最终。main192输入基线PASS，本轮无产品RTL/表/协议更改；下一步收口条数/触点/行程/映射后落实一主方案的原理图、PCB及制造报价。

> **2026-10-14 滑条选型风险收口**：用户指出滑条选型是重大问题；一体键建议不视为硬件可行性签收。已在45号§6.1补原始电容/FPGA、膜式位置电位器、原始CDC的路线比较与官方资料；优先4键原型，再定全尺寸面板。24～26键按候选3电极已达72～78测量节点，须把全通道周期、多指位置、噪声、端到端10ms、500元预算及现有全FPGA边界一起评估。传感及面板状态**讨论中/原型待验证**，未冻结新音乐语义、未采购或修改产品源码；本轮main192输入基线PASS。下一步先取得位置/延迟/噪声证据，再选前端和键条形态。

> **2026-10-14 实体面板与机上编辑需求**：用户明确两排音高区，每排一个完整八度、共两个八度；压力感应条用于八度切换；一块音乐可视化屏；沿用泛音构造区；四预设按钮支持单选/多选分层；编辑键后选择槽，在实体机修改音色、激励等，需求状态**待实现**。用户要求比较“独立琴键＋上方滑条”与“一体滑动触控键”，尚未选定，不能将建议当决定；端点键数、机械/触控形态、传感位置能力也未冻结。比较与编辑状态机、参数页、草稿试听/显式保存、编码器新增建议详见[45号草案](45-实体面板与机上乐器编辑交互草案-2026-10-14.md)，补充规则均为**讨论中**。保留右手全和弦/松手保持等既有决定，实体编辑扩展旧电脑编辑定位；断电保存、编辑试听版本、分层开关/释放语义仍需裁定。本轮main192输入基线PASS，无产品源码变更或新音乐验证。下一步按两方案原型与规则比较确定键区，再收口编辑操作、持久化和通道/引脚/资源预算。

> **2026-10-14 规则不确定性与实施边界讨论**：用户担忧功能规则未明确会影响实现，并询问能否在开发期间继续思考规则。本轮解释：参数存储/版本/校验、接口职责、参考模型与资源探针可先推进；激励、松手阻尼/自然衰减、重奏、滑动归属、预设切换及分层表情等用户可感知行为必须显式列为**讨论中**，不能借实现默认值冻结。第一阶段“再起音从当前电平进入Attack、相位保留”是已记录的实现策略，不升级为所有乐器最终再激发语义；频率安全修复也不等于所有临界过渡听感验收。后续建议用“动作→预期声音→明确例外”的规则表与短演奏例子收口，由用户决定体验方向，具体数值结合试听/验证；未经确认的分支可保留候选与测试，不直接作为正式设备默认。本轮未新增产品代码或冻结音乐语义，main192输入基线PASS。下一步先明确生命周期、连续表达、配置生效和分层作用范围，再落实第二阶段行为。

> **2026-10-14 第一阶段实现交付**：用户批准按44号顺序推进，已在隔离工作树`instrument-engine-safety`从整合07向前实现全宽/调制后频率保护，以及显式Note On与刷新分离、持续/尾音/快速OFF→ON的重新起音。源码`a7427ed`、交付`683db48`，246输入新清单与最终码流绑定check-build通过；29项针对性组合覆盖，含16个黄金参考配置，初始集成22/23退出1的旧512槽夹具问题修正后专项通过，不称一次全量29/29。首轮84未布通原样保留，事件序号优化后最终PnR setup+9.643ns/hold+0.310ns/TNS0，CLS10066/10368（比07增加18），BSRAM/DSP不增。状态：本阶段在针对性数字与PnR范围**已验证**，实体与项目全量仍**待验证**；未下载，T60/旧LFO/PR1014不继承签收。main未合并产品源码，完整包见[交付身份](../../notes/engine-safety-stage1-20261014/delivery.json)。下一步为单乐器可写定义与生命周期闭环，其后表情/尾音、分层仍**待实现**；不因本阶段改变未决音乐规则。

> **2026-10-14 音乐引擎适配审计**：用户要求首先确认音乐引擎能否承载两核心功能，结论与证据见[44号](44-音乐引擎对通用乐器与分层的适配审计-2026-10-14.md)。以66a4候选07为底座，main192/07共241输入身份检查PASS；本次隔离重跑原包络、finger_pitch、512槽释放连续性三项机制通过。另新增Nyquist安全目标测试真实失败：MIDI108/org第16分量完整增量21308176在取24位后为4530960且幅度非零，证实截断后判Nyquist会漏过越界；调制后缺最终频率检查为独立源码风险。本轮未修。独立包络状态已有，但逐槽epar只含衰减/持续电平，顶层起音与释放仍共用常量；可写完整定义、完整三生命周期、平滑右手修饰/保持/尾音参与、实例/层身份与多组绑定仍待实现。保留32×16 TDM底座是建议，完整新功能需资源探针/PnR；不得用现有320CLS余量口头签收。状态分别**部分实现/待实现/待验证**，三个机制PASS不等于新目标通过。新增审计脚本、测试和证据在notes，未改产品RTL/表、未新建产品快照、未全回归/综合/板验。下一步优先频率安全与重奏判据，再单乐器定义闭环、表情/尾音、分层与联合资源验证。

> **2026-10-14 最终功能主线收敛**：用户明确“自定义乐器（实时音乐构造、表情均包括）＋音色分层（实现个人合奏）”。已记入43号§0，作为后续产品定义的两项核心；实施状态**待实现**，不把四个静态预设等同自定义框架、不把分层同音齐奏等同自动独立旋律。已有模块验证边界不变；层数、具体参数/动作细节、右手形态及存储/器件仍需收口。下一步围绕两主线明确可验收功能、运行期塑形与保存/应用关系，再进行实例身份/多层表情及资源验证。本次main192输入基线PASS，仅文档更新，无新增产品验证。

> **2026-10-14 通用框架定案研究与用户新选择**：用户明确同时追求多种可辨识乐器行为及自由组合创造新乐器；自由度选“组合激励、频谱、包络和表情映射并保存”，左手首版选“独立音高键、每键连续滑动”；新增预算500元，已有/已购显示屏、Nano20K、喇叭。屏幕目前仅知“TFT、SPI3/4线、8/16位并口”，驱动IC/分辨率/实际接法未明。上述需求已记载，相关功能仍**待实现**。已整理[43号通用框架与功能选型定案工作稿](43-通用乐器框架与功能选型定案工作稿-2026-10-14.md)：Elements、Chromaphone、REAKTOR、Osmose、MicroFreak官方案例；有界可组合定义及四快捷槽建议；完整功能表、原始触控候选及500元预算上限分配。AD7147满12阶段最快表列9.216ms，不能直接满足整机10ms预算；优先建议验证FPGA计时＋CD74HC4067/SN74LVC14A模拟外围，实际连续位置/噪声/延迟未验，不是成品硬件已签收。右手面板、合奏首版范围、设备断电保存、屏幕确切型号/接口和喇叭规格仍待收口；不能因“今天定案”擅自裁掉功能或伪造验收。main192输入与整合07共241输入身份检查PASS，仅文档调研，未修改产品源或重写快照。下一步由43号具体选项收口功能，再以小样与联合资源证据签正式BOM。

> **2026-10-14 通用框架的动作/响应边界建议（N-01、N-04～N-08、N-11）**：针对用户询问如何解决统一动作与不同乐器响应的关系，候选方案为“固定动作的音乐语义＋受约束的乐器响应配置”。落指创建音符并发起激励，保持维持控制所有权（不强制恒定音量），左手移动只改变所属音高且不再激发，离开结束控制/持续驱动并进入配置的尾音策略；右手仍作用全和弦、松手保持、RESET平滑恢复。Continuous/Impulse/Hybrid决定持续输入/瞬态能量的响应，乐器配置决定分量随时间演化、释放/阻尼、力度曲线与有界映射；不通过乐器名或速度阈值暗改动作含义。首版建议共享左手音高映射校准与范围，同类右手修饰允许各预设有不同有界谱响应；更复杂映射后置讨论。以独立的“交互契约、乐器定义、运行状态”组织设计，先在现有16分量后端逐个验证持续与瞬间两种端到端行为，再考虑混合与分层。上述为**讨论中**建议，未代替用户冻结；最小定义字段及每种生命周期仍**待实现**。main192输入基线PASS，仅记录方案，无新源码/仿真/综合/板验；下一步逐项确认动作契约并用两类声音检验落指/保持/移动/松手/重奏与尾音。

> **2026-10-14 乐器定义框架继续讨论（N-07～N-08、N-11）**：用户要求在音色分层前先讨论“乐器是否等于激励模式＋音色预设”。本轮候选解释为：乐器是把演奏动作与当前内部状态转为随时间演化声音的响应系统；可按激励、发声/共鸣特性、动作与状态的耦合来理解。若“音色预设”仅指静态16分量幅度，两项不足以定义起音、衰减、阻尼、再激发与连续表达；若其已含上述动态规则，两项可作配置分类，但不能省略行为。三分法是职责建议，不要求物理建模、增加三套RTL或冻结新的控制语义。原Continuous/Impulse/Hybrid作为激励策略仍保留，非完整乐器定义；本轮先讨论通用框架，不推进四层实现。状态**讨论中**；下一步以同一音符的落指、保持、移动、松手响应检验定义，再选最小配置字段。仅更新讨论记录，无产品实现或功能验收。

> **2026-10-14 通用框架职责澄清（N-01～N-09）**：用户重申通用乐器框架目标并要求讲解五职责，已补充42号§12：统一音乐事件、控制/声音分离的生命周期、版本化乐器配置、保持统一动作含义的表情映射，以及一演奏实例对应多子声部。特别区分finger/note/voice身份、已静音但仍接触、释放尾音、组合配置与活动声部；普通移动不再激发，Impulse允许移动且不补能量。四乐器作为配置实例，组合及自动伴奏作为不同组织职责。新接口和四层整合状态仍**讨论中/待实现**，未替用户冻结音乐规则。main192输入基线PASS，仅更新说明，无实现或新增功能验证。下一步先以双层原型核对实例身份、释放/尾音、表情分发及资源。

> **2026-10-14 成熟案例调研与分层方案（D-01、N-01～N-02、N-04～N-09）**：用户授权搜索成熟案例并开始制定实现方案，已整理[42号四预设音色分层与合奏实现方案](42-四预设音色分层与合奏实现方案-2026-10-14.md)。官方案例为Yamaha PSR-E373的Dual Voice/Style、Nord Stage 4的独立层控制、Roland JUPITER-X的五Part/I-Arpeggio；参考其交互和声音组织，不推断本项目具备相同音质或AI编配。候选采用32组动态共享、一演奏实例对应多层、逐组预设/版本与独立包络，首个原型建议钢琴式＋弦乐式。源码另确认`finger_pitch`一指只绑一组的限制，须与同MIDI匹配、全局预设、公共谱、尾音回收一起改造。07归档CLS仅余320，先做共享表/串行控制资源探针，再联合PnR，不能仅按复音数承诺可部署。设计状态**讨论中**；数字原型与四层协议/GUI/按钮为**待实现**；自动琶音/独立伴奏范围及音乐规则待用户裁定。本次main192输入、整合07共241输入身份检查均PASS，无产品源码修改，无新增仿真/综合/PnR/上板/试听；不更新源码快照。下一步确认首版范围并落实P1资源与行为探针，V1.0原文保留。

> **2026-10-14 四预设与合奏草稿讨论（D-01、N-07～N-09）**：用户提出四种内置乐器预设、四个选择按钮及合奏功能，示例为一次按键同时触发小提琴与钢琴同一音高。该新增草稿状态为**讨论中**，未冻结四种乐器、选择动作、右手作用范围或滑音规则。示例对应同音音色分层；其他乐器演奏独立旋律/伴奏则是另一层需求，不能推断已选定。源码核对：66a4候选`note_map`仍按MIDI音符匹配同组，预设输入为全局2位，四个预设表槽不等于已实现多乐器同时发声；已有分量频率比、幅度与包络可作为底座。候选实现为每个选中乐器占独立声部，分配身份增加触点/音符实例与乐器层，保存逐组预设并让松手和抢占处理整个组合；32组下1/2/3/4层容量分别为32/16/10/8个完整按键组合，实际尾音重叠另评估。采用固定512槽不直接要求扩大发声计算容量，但新增控制、资源余量、满载时序与音色质量未验证。音乐上建议先试听钢琴衰减层与弦乐持续层的组合，分别保留包络和混音增益；16分量近似音色不承诺真实乐器复刻。下一步先确认同音分层是否为首版范围，以及持续/衰减、音高表情和右手修饰作用规则，再做双层原型与容量/释放/削顶测试。本次主目录基线PASS（192输入），仅讨论及文档更新，无产品源码修改或新增板验；V1.0原文不改写。

> **2026-10-14 复音与振荡器答疑（D-01）**：主目录源码指纹检查PASS（192文件）；较新66a4产品候选07身份检查PASS（241输入）。核对其`tdm_top.v`与`note_map.v`：32声部，每声部16个正弦分量，共512个逻辑振荡器状态，采用TDM共享运算链；不是512个独立音符，也不是512套并行硬件。满32组后新音会抢占；相同MIDI音符优先复用在奏组，任意同音多指独立仍为部分实现。主目录实体音高输入仍仅8键，不能把引擎容量视为完整面板验收。基础内核状态沿用已有范围的**已验证**，本次仅解释既有能力，无新音乐语义决定、无实现改动，未新增仿真/PnR/上板/试听。下一步仍是实体多指、满载演奏及端到端延迟验收；不新增或覆盖源码快照。

> **2026-10-12 阅读入口纠正**：用户提供并指出 2026-10-11《[统一可表达电子乐器：交互与演奏系统规格 V1.0](统一可表达电子乐器-交互与演奏系统规格-V1.0-2026-10-11.md)》为更新设计。已原样归档，应优先作为最新设计候选阅读。该文标注“设计基准线候选，等待项目正式冻结”；本次未替用户正式冻结，亦未修改产品实现。

> **2026-10-13 音乐引擎指标复核（D-01、N-01、N-10、N-12）**：发现并读取较新的整合工作树 `C:/Users/Sakuya/.codex/worktrees/66a4/FPGA-Music-project/project/CURRENT.md`、`design.md`、`validation.md` 与07交付记录。该工作树 HEAD 为 `614b2a7`，产品候选源身份为 `integration-20261011-07.json`，本次241输入检查PASS；main、a61b、6e70各自旧基线亦PASS。下文“未接合”描述属于此前盘点，不能覆盖66a4已有整合成果；主目录仍未接合。
>
> 07已有32组×16分量、27MHz/512采样链；归档新PnR setup +7.378ns、hold +0.198ns、TNS0，Logic18751/20736、CLS10048/10368、BSRAM38/46、DSP10.75/24。归档真实UART/内部PCM30秒769帧、10事件、CRC/缺帧/断点/损失0；六种释放连续性板测通过。原全量57/58退出1，身份环境项补验通过后组合覆盖58项，不称一次全量58/58。T60已知失败、旧LFO跳变仍挂账。上述构建和板测均为既有证据，本次未重跑回归、PnR、查询板上身份或下载。
>
> 状态：基础内核及07松键连续性在上述数字范围**已验证**；任意同音多指为**部分实现**；新右手连续修饰/保持、实体触控与独立实体三视图仍**待实现**；模拟DAC音质、I²S电气及最坏触摸到声音≤10ms仍待验证。没有新增音乐语义决定。下一步在固定Nano20K预算内评估接入功能的资源余量，并补物理音频、触控端到端与效果器验收；不因本次指标整理捕获新源码快照。
>
> 下文 §0 和 §6 是此前资料及源码核对，不能把其“未决”清单直接覆盖 V1.0。V1.0 已写出新音继承全局修饰、可听释放尾音同受修饰、逐组松手保持及 RESET 平滑恢复等规则；8 组映射、乘性强调与 normalize、二维相对位移、每组单编辑所有权等仍带建议性质，状态为讨论中/待冻结。对应 RTL、协议、GUI 与实体闭环仍待实现或接合验收；基础内核沿用既有验证边界。下一步按 V1.0 逐项建立决定/建议/实现/验收对应，明确正式冻结范围与数值参数。本次主目录源码基线 PASS（192 文件无变化），不代表新设计已实现。

> 本文整理主目录、相关工作树和可读取任务记录中的最新构想，**不把讨论稿视为已实现**。
> 当前代码事实见 [38-代码盘点与实现基线](38-代码盘点与实现基线-2026-10-09.md)。
> 最新主要来源：6e70 的37/42/47号文档，a61b 的40/41号文档，以及任务“修复 pad 紧邻事件丢失”的近期演奏语言讨论。
> 主目录25～37号与架构提案图用于历史追溯。更晚但未读取或未落档的决定不推断为已确认。

## 0. 最新设计：已经不同于旧的“四维触后”方案

> **硬件进展（2026-10-09）**：已通过JTAG把独立v5诊断码流下载到SRAM，COM6实测收发、事件、声部及内部数字样本。只有2个数字表达组，不能算完整多指实体演奏验收。复位极性与状态清空只在诊断副本修正；MIDI127冲突、连续回传缺字节、持续发声混响削顶待实现修复。完整RTL首轮51/52，失败项补充专项PASS，组合证据覆盖52项硬判据，另有2项已知失败、2项INFO；不能写成一次全量52/52。DAC模拟输出、I²S电气波形、实体触控及最坏10ms继续未验。详见[41号测试报告](41-板级全面测试报告-2026-10-09.md)。

最新方向是：**左手选音并控制所属音的音高表情；右手强调已有声音分量、平滑改变音色；电脑编辑并保存配置。**
触控前端与FPGA解释动作，发声仍由FPGA完成。PCB＋I²C方向保留，器件未最终冻结。

一个必须纠正的冲突：旧05图的“右手抬手回中”已被后续明确需求“**右手松手保留最后修饰**”取代；
旧的“按一个音只修饰该音”也不能覆盖后续“**右手修饰整个在奏和弦**”。
旧D-18“四维全部逐声部”要拆开理解：**左手各指独立音高；右手公共修饰，但各声部保持各自音高、力度和包络**。
不能继续以触后控制全局/逐声部LFO作为最新左手表情的唯一实现目标。

### 最新需求与真实落地位置

| ID | 设计构想 / 已记载用户选择 | 实现与差距 | 状态 / 来源 |
|---|---|---|---|
| N-01 左手直接跟手 | 位置变化控制音高，各指控制所属音；往返自然产生手动颤音 | a61b `6b50ca9` 有 `finger_pitch`、触点ID绑定、组通知、逐组比例；默认关闭，真实传感器/追踪/绑定上游未接 | **数字接口已验证，实体演奏待实现/验证**；a61b41号 |
| N-02 左手所有权 | 多指各自表达，旧手指不得控制已重用声部 | 数字解绑/重分配有测试；同音多指仍按MIDI匹配共享组，缺事件所有者身份，不能宣称任意多指独立 | **部分实现**；a61b41号P0 |
| N-03 自动颤音辅助 | 保留往返手势控制自动颤音深度/速率扩展，先直接跟手 | 自动跟踪、强度、进入/结束规则未冻结；旧LFO另有跳变缺陷 | **讨论中**；a61b41号及近期任务讨论 |
| N-04 右手强调已有分量 | 基础谱演前自由配置，修饰不覆盖保存谱；多个触点各有贡献 | 当前按位掩码推到255不等于新强调规则；增益、上限、零分量处理未定 | **待实现，参数待试听**；6e70 R05/R06 |
| N-05 作用于在奏和弦 | 同一修饰改变各目标音的谱，各音保留自身音高/力度/包络 | `0x63=0xFF` 全刷只是基础；受控提交、旧/新音隔离、保持力度/包络未完成联合验收 | **部分基础，产品行为待实现**；6e70 R01/R07 |
| N-06 右手连续移动 / 松手保持 | 跨位置平滑强调；松手不恢复底谱；另有明确恢复动作 | 缺平滑、贡献锁存、部分松手组合、恢复动作；新音是否继承未最终确认 | **待实现**；6e70 R08/R09；优先于旧回中提案 |
| N-07 发声方式 | 持续 / 瞬间 / 混合；沿用统一接触和移动语言 | 包络基础不等于三方式完成；字段、重触发、尾音、混合机制未全部实现；“混合后置”仍是建议 | **待实现**；6e70 R04、a61b41号 |
| N-08 配置编辑与保存 | 保存完整参数；编辑草稿不自动改变在奏音；显式应用 | 6e70 `caa0034` 文件层已提交；GUI本地闭环和视觉改进有工作树代码；设备应用尚未接合 | **本地文件已实现/有历史测试，设备应用待实现**；6e70 R01/R02/42号 |
| N-09 实体配置与编辑保存 | 多个实体配置按钮、默认预设、保存修饰的编辑模式 | 配置槽数、选择范围、保存对象和断电介质未定；没有完整实体操作实现 | **已记载需求，待细化/实现**；6e70 R03、a61b41号 |
| N-10 触控与延迟 | PCB＋I²C；所有需要通道开启、可靠检测且实际触摸到声音最坏 **≤10ms** | 6e70最新资料筛选优先实验 FDC2114、备选FDC2214；只是候选，不是采购或达标保证；真实多指位置和压力另验 | **原型待验证**；6e70 47号、a61b40/41号 |
| N-11 统一演奏语言 | 不把所有可能映射做成上位机开关；动作含义稳定，声音响应可丰富变化 | 最新讨论建议接触激发、移动塑造同一音、离开结束控制；恢复/再激发需明确动作；完整规则仍需冻结和演奏验证 | **用户明确反对功能堆叠；具体动作规则为讨论建议**；任务“修复 pad 紧邻事件丢失”近期讨论 |

N-01 数字接口暂定 256位置单位/八度、上下各一八度，不是面板毫米量程或最终灵敏度。
表达生效时该声部绕过旧自动portamento与全局LFO；未绑定组保留原路径。移动不重起包络。
右手作用于整个和弦与左手逐指独立不冲突：一个改变谱的共同修饰，一个改变所属音的频率。

### 最新设计仍要收敛的具体问题

- **右手组合**：每指贡献怎么叠加、峰值上限、部分松手后的保留方式、新音是否继承、怎样恢复底谱。
- **左手身份**：触点到分配结果的关联、接收/拒绝可观测、跨域、ID重用、同音多指分别释放。
- **发声生命周期**：持续/瞬间/混合的包络与再激发；滑动是否始终延续同一音；不要用速度阈值偷偷改变动作含义。
- **配置**：新音应用与在奏音显式应用分别何时发生；全局效果如何过渡；实体槽与非易失保存。
- **硬件**：少量电极原型验证多指位置、噪声与延迟；不能把4通道前端或单通道峰值速率当作38点整机证明。
- **验收范围**：a61b事件修复已完成无需在main重写；GUI/协议接合、LFO缺陷、实物验收仍独立挂账。

### 可追溯来源与接合顺序

- `C:/Users/Sakuya/.codex/worktrees/6e70/FPGA-Music-project/docs/02-技术方案/37-首版交互需求分析-讨论稿.md`：R01～R10用户选择。
- 同工作树 `42-需求到实现追踪.md`、`47-触控10ms硬指标候选复核.md`：本地GUI实现与硬件候选边界；存在未提交更新。
- `C:/Users/Sakuya/.codex/worktrees/a61b/FPGA-Music-project/docs/02-技术方案/41-逐指音高接口与待办-2026-10-08.md`：更晚逐指选择与已提交数字接口。
- 任务“修复 pad 紧邻事件丢失”（`01a119c6-d453-7bf2-bdaa-de2c63b843dc`）近期讨论：用户指出不能用开关堆叠替代设计；助手提出统一动作语言，**建议不当成用户批准**。

下一步优先**选定接合版本、保存6e70未提交成果、接合a61b已验事件/逐指路径与GUI/协议**，
再按上述未决问题实现新的演奏行为；触控原型与现有板卡音频验收可分别推进。本次没有代替用户合并或冻结新语义。

**下文 §1～§5 是主目录旧设计的历史对照**，用来解释代码为什么仍停在旧实现。
与本节冲突时，以可追溯的后续选择为准；不能把下文旧“触后四维”“右手回中”重新当成最新决定。

## 1. 历史设计方向（主目录旧稿）

做一台**音色可以在演奏中被塑造的复音乐器**：FPGA 负责实时发声，面板承担选音、和弦和表情，
上位机负责编辑、调试与演示兜底。结构设定、自动演化和演奏表情分别定义，避免把编辑音色算成演奏表情。

仓库已有记录的方向是定制 PCB 面板与四维逐声部表情。
具体器件和手势阈值仍依赖原型，不以旧文档的成本、工期或器件参数作为本次采购结论。

## 2. 旧设计项账本（与 main 对照）

状态用语：**讨论中 / 文档记载已定待实现 / 部分实现 / 已实现待验证 / 已验证 / 已回滚**。
“已定”表示既有文档记载的决定，不表示本次替用户作出新决定；验证必须注明是单元、顶层还是板级。

| ID | 最新构想 / 既有决定 | 当前代码落点与差距 | 状态与来源 |
|---|---|---|---|
| D-01 发声主架构 | 32 声部 × 16 泛音，纯 HDL TDM；保持已验证内核 | `tdm_engine` 主线已实现；音乐系统板级、当前 PnR 未签收 | 部分验证；38、35 号 |
| D-02 新演奏面板 | 25 音高触点 + 5 音域格 + 8 泛音触点 = **38**；定制 PCB 路线 | `pad_pitch` 能映射 38 位，但只接物理 8 音高键；`strip_ctrl` 输入常零；缺完整驱动与实际面板 | 文档记载已定待完整接入；25/28/30 号 |
| D-03 力度 | 轻/重两端相对标定；约 **10 ms 起音窗取峰值**，16 档；同时影响音量和音色 | 引擎幅度与音色路径存在；物理输入固定 12；缺采样、标定、峰值窗与噪声死区 | 部分实现；32 号 D-01～D-04 修正 31 号“瞬时取值” |
| D-04 触后颤音 | 起音窗之后才计算变化；每声部独立深度和相位，避免重按自动被算成触后 | `pitch_mod` 仍为全局 LFO/深度；需逐声部状态与输入映射 | 文档记载已定待实现；32 号 D-05/D-06/D-18、33 号 P1 |
| D-05 颤音兜底 | 触后不可靠时长按自动渐入；渐入 100–300 ms，默认 **200 ms** | 未实现；33 号建议长按阈值 400–700 ms、5.5 Hz/26 音分均是候选值 | 待实现，参数待试听；32 号 D-07、33 号 P2/Q1～Q4 |
| D-06 滑音 | 保持同一声部重定向音高，跨键不中断；和弦、legato、滑动须有明确语义 | 偏移机制有；正常演奏不触发 legato，缺滑动检测与重定向契约 | 讨论中 / 部分实现；33 号顶部更正、34 号 §3.5 |
| D-07 亮度轴 | 谱倾斜为主、预设为补充；只做手势级推拉，验高次能量占比 | `0x5C` 已实现，但参数全局；需每声部独立值/选中规则及刷新接线 | 部分实现；32 号 D-13/D-14/D-18 |
| D-08 泛音排点按与滑动 | 稳定点按经延迟确认才改结构；期间位移则视为滑动，不触发泛音切换 | 当前仍是二值掩码；缺位置、消歧、去抖与选择状态机 | 文档记载规则待实现；32 号 D-11/D-12/D-15 |
| D-09 回中 / 演前编辑 | 右手绝对位置轴双向，抬手回到结构底谱；按住某音时只作用该声部；设定模式编辑基准谱 | `0x63` 提供逐组刷新基础；手势选组、多音归属、回中和设定模式尚未实现 | **较早提案，未确认全部沿用**；05 架构图、18 号 |
| D-10 包络层谱形演化 | 起音谱 → 稳态谱，区别于玩家主动表情 | 每槽包络已有，但没有提案所指的两套谱形插值控制 | 提案待确认；03/05 架构图 |
| D-11 事件可靠性 | 每源小队列，轮转保持，成功接收才出队；丢弃必须主机可观测 | 公共 FIFO 已有，四个源仍单槽；pads 集成尝试回滚 | 方案已成文，修复未交付；37 号、35 号收口 |
| D-12 I²S / 硬件验收 | 固定可辨位型，示波器查看 WS/SD 相位，记录板级证据 | 仅数字模型证据，尚无裁决 | 方案已成文待板级执行；36 号 |

逐声部力度在装载时已保存在泛音幅度中，并不一定需要额外的力度 RAM。
逐组刷新能力也不自动等于“每个音有独立亮度控制”：还需要表情状态、音符归属和刷新请求。

## 3. 面板与音域的统一解释

现有最新通道表、`pad_pitch` 与 PCB 清单一致指向：

- 0–11：C3–B3；12–23：C4–B4；24：独立 C5。
- 25–29：五档音域条；30–37：8 个泛音键；合计 38。
- MIDI = 48 + 通道偏移(0–24) + 12 × 相对档位(−1…+3)。
- 按下锁存音符，松开沿用锁存值，换档不改变已经按住的音。

根据该公式，每一档只有两个八度加端点：

| 档位 | 单档范围 |
|---|---|
| −1 | MIDI 36–60：C2–C4 |
| 0 | MIDI 48–72：C3–C5 |
| +1 | MIDI 60–84：C4–C6 |
| +2 | MIDI 72–96：C5–C7 |
| +3 | MIDI 84–108：C6–C8 |

整体换档覆盖 C2–C8。25 号文档中“默认档终点 C8”、36 通道、Shift 等文字属于未同步的旧稿，
不能全部叠加成当前规格。现有 38 通道预算不含独立 Shift；是否保留 Shift 要另行决定，不能默默增通道。

## 4. 旧方案需要决定或实测的事项（须先核对 §0 是否已取代）

| 事项 | 已知约束 | 本次整理后的未决点 |
|---|---|---|
| 传感器路线 | PCB 方向已有记录；电容量不等于已证明的压力 | 实测能读、IRQ、量程、重复性、全通道周期；稳定连续量不可用时选显式轴或兜底 |
| 力度曲线 | 16 档与峰值窗已有设计 | 标定入口、曲线、10 ms 是否牺牲起音延迟，需要原型和试听 |
| legato 与和弦 | “旧音仍响就复用”可能吞掉正常和弦 | 选择独立单音连奏模式、专用滑动重定向，或维持复音模式；不要由分配器耗尽决定音乐语义 |
| 滑动连续性 | 间隙短暂全松，快速重复音可能误判 | 30–50 ms 全松阈值、滑动窗、采样率、多指/和弦处理，需要边界判据 |
| 逐声部亮度 | 四维逐声部方向已记载，当前亮度却是全局 | 单音/多音选择、参数存储、释放后的清理、音域切换时冻结哪些量 |
| 右手手势细节 | 倾斜轴最新，回中来自较早提案 | 回中是否沿用、无左手按音时作用对象、多指取最左还是首次触点、点按确认延迟 |
| 事件小队列 | 公共队列正常不代表源端可靠 | 37 号图示每源深度 2，UART 段又建议 4；实际深度/满时行为、可观测寄存器地址及真实 UART 激励需实施前统一 |
| 资源预算 | 历史 PnR、估算都不能签收新实现 | 各项有可验证实现后再综合，单独记录 source/config/report 对应关系 |

## 5. 旧主目录视角的建议顺序（已由 §0 接合顺序取代）

1. 先收口事件源缺陷：按 37 号方案分源接队列，定位之前集成失误，保序与丢弃可观测一起验收。
2. 保持声部回收和音频黄金参考不退化；明确 legato/和弦/滑动模式契约。
3. 实现逐声部颤音与无传感器兜底，在仿真里测两个音的独立性。
4. 以触控原型结果冻结传感器和连续量路线，再完整接入 38 通道及手势。
5. 做板级 I²S、PnR、输入延迟和试听签收；把演示材料同步到实际可运行版本。

每次讨论完一个 ID，至少留下：决定/候选值、源码落点、还缺什么、验证证据、下一步。
发生实现变更时同时更新 38 号基线；仅讨论新目标时更新本文，不能把状态直接写成“已实现”。

## 6. 2026-10-12 泛音构造专项说明（N-04～N-06、N-08）

本次核对主目录 `fe326ad` 的实际 RTL、主机谱写入，以及 6e70 `6246926` 之上的未提交 RTL 差异。主目录源码基线检查 PASS（192 文件，新增/删除/修改均为 0）；只代表指纹一致。本次未运行音频仿真、综合、上板或试听，没有新增音乐交互决定。

- **已实现，验证沿用历史边界**：32 声部 × 16 分量加法合成；预设表提供 Q8 频率比、8 位幅度及包络参数。公共 16×8 谱 RAM 经 `0x58/0x59` 编辑，`0x5A` bit0 为 0=叠加、1=替换，bit1 控制自动刷新；`0x63` 支持逐组/全体在奏组刷新。主机部分注释有位含义反写，以 RTL 和实际帧值为准。
- **部分实现**：物理高 8 位与 `0x5B` 按位 OR，控制前 8 个分量；命中时谱输入直接取 255。无连续位置、插值或松手保持；掩码随松手撤销。全部 16 分量可由电脑谱编辑。频率比来自当前预设，因此“第 k 个分量”不在所有预设中都等于整数第 k 次谐波。
- **部分实现、未接合**：6e70 未提交代码已有 pending 谱/提交逻辑，以及 `group_velocity` 保存并恢复各组力度。main 刷新未从逐组力度状态恢复 `vel_cur`，不能保证不同力度和弦刷新后保持原力度。上述工作树增量本次仅源码核对，未新增验证，不算已合入 main。
- **待实现**：N-04 强调已有分量、N-05 全和弦修饰并保持各音状态、N-06 连续移动平滑变化及松手保持；基础谱与运行期修饰分开，修饰不覆盖保存谱。多指增益组合、零分量处理、峰值上限、部分松手组合、新音继承与恢复动作仍为**讨论中**。
- **下一步**：接合既有谱提交与逐组力度保存代码，再在用户确认未决语义后实现运行期修饰状态和幅度过渡；验收多音不同力度、包络不重触发、多指部分松手、保持/恢复、频谱与削顶。不能把旧掩码全刷当作新右手交互完成。
