sakuyaShining/FPGA-Music-project-internal/docs/02-技术方案/41-板级全面测试报告-2026-10-09.md

# 板级全面测试报告 · 2026-10-09

当前结果：真实板级首轮 **12/14 PASS**；音色/效果器改逐样本回读的“非零输出”专项PASS，但新增样本削顶审计 **13/14 PASS，混响FAIL**。MIDI127缺陷、高速回传缺字节、混响削顶仍未解决。完整RTL首轮 **51/52 PASS**，失败项补充专项PASS，组合证据覆盖52项硬判据；另有2项已知失败、2项信息审计，**不是一次全量52/52**。

## 版本与实际下载

产品main仍为 `fe326ad9505c94f46f9236bf7f9bfc3b5f1b9a12`，产品RTL没有修改或合并。
诊断底座为a61b `7ca52c9dd57bfc04d97e7ed2261fd802cdff9d97`，独立副本v5。
v5修复复位状态与物理极性，增加观察接口；32声部×16泛音，数字表达仅2组/2触点，物理RC输入禁用。
COM6，115200 8N1，读身份D2。Gowin SRAM Program（操作2）下载成功，UserCode DD8A，Status 6020；没有写Flash。

## 实际验证

| 层级 | 结果与边界 |
|---|---|
| v5诊断UART线仿真 | PASS：身份、参数无别名、on/off计数、两指反向移动、非法ID、采样与字节顺序、活动音复位清空 |
| v5综合/PnR | 成功；setup +12.565ns，门限+5ns；hold +0.205ns。保留clk_d通用布线警告，不能据此宣称外部I²S波形已验 |
| v3完整RTL回归 | 首轮51/52；09 regctl输入rc_seq只11118/12000行，末行不完整，检查器IndexError。原runner对该用例900秒超时并忽略返回码；独立文件夹给2400秒上限专项重跑，307.172秒正常结束，完整12000行，原判据PASS。多数用例关闭诊断，逐指集成完整32组；不能等同v5完整回归 |
| 上电与时钟 | 默认寄存器、活动声部0、512个静音样本、内部采样间隔最短/最长512拍，通过 |
| 控制与声部分配 | 80组寄存器模式读写、7个音区on/off、32声部及抢占回收，通过；MIDI127边界失败 |
| 事件压力 | 固定种子306条随机事件、5000条连续真实UART事件，确认数精确一致、清音后活动0、74–7C丢弃计数全0，通过 |
| 实际数字音频 | A4峰值440.955Hz；+75音分移动后460.267Hz；释放后尾音归零；力度4到15的RMS比3.980，通过 |
| 两指表达 | 两音分别反向移动，观测273.585/376.582Hz；移动不产生额外note-on，通过；范围限2组 |
| 音色与效果 | 首轮因连续回传6144/6145字节失败；逐样本专项四预设、延迟、合唱、混响非零输出通过。新增审计发现混响25/512饱和样本（4.88%），FAIL；其余采集文件未达24位饱和端点。详细冲激响应判据仍属仿真 |
| 定序器 | 启动产生事件、关闭停止新增事件，通过；关闭并非all-notes-off，需显式清音 |

内部数字样本直接来自FPGA采集RAM，不是电脑生成，也不是从DAC模拟输出录制。

## 缺陷与未验证项

1. **复位状态遗漏**：note_map复位未清gact/gtab；专项修前FAIL、修后PASS。仅诊断副本已验证，产品待实现接合。
2. **物理复位极性**：板载引脚87高有效，原包装低有效直连；诊断v5转换并同步释放后实际UART正常。仅诊断副本已验证，实体按键反复复位未单独验收。
3. **MIDI127与FREE冲突**：同时触发127和60仅剩一个活动组；note_map使用127作空闲哨兵，匹配/空闲判定未完整区分活动位。待实现；不缩小测试范围掩盖。
4. **连续回传缺字节**：一次应收6145仅收6144。逐字节地址回读可完成音色/效果验证，但不证明高速路径可靠；根因待查。
5. **完整32组表达资源/时序**：v3一次布线失败，另一次setup仅+1.832ns未达+5ns；v5限定2组通过。完整产品配置已实现待板级验证，不能复用v5余量。
6. 本轮完整回归复现i2c已知失败与高反馈0xC0混响69039/70000（98.6%）削顶；两项不计硬门通过率，但必须保留。旧LFO跳变另挂账，本轮pitchmod PASS不证明已修该缺陷。
7. **板上混响削顶**：FX_CTRL=0x59、反馈0x80、阻尼3、A4力度15，512样本有25个饱和端点。artifact名`reverb_safe.npy`沿用首次命名，不表示配置安全。专项原判据仅非零输出，原PASS保留；新增`audit_board_samples.py`独立FAIL，后续主机测试也新增削顶断言。需检查增益与持续信号反馈，不能把历史冲激测试的安全档描述直接用于持续发声。

未验证：DAC/功放/扬声器听感与模拟输出、I²S电平和相位、真实触控/压力/身份、最坏触摸到声音≤10ms、断电重启与长期温漂。没有相关仪器和外设，本轮不作完成声明。

下一步先修并接合确定的实现缺陷，再对选定产品版本做回归与构建；显示和最新右手交互仍按39号独立推进。本轮测试不替用户决定新的音乐语义。

原始日志、源码及报告入口见[40号诊断说明](40-无仪器板级诊断与验收-2026-10-09.md)。首次失败报告保留，专项复核分别落盘。
精简原始证据归档：[ZIP](验收证据/板级-2026-10-09/diagnostic-v5-evidence.zip)与[SHA-256清单](验收证据/板级-2026-10-09/sha256.json)，每个归档文件已逐项复核。
产品源码HEAD未变；新增7个诊断源码/脚本经评估验证后写入`notes/baselines/main-2026-10-09-board-diag.json`，192文件指纹检查PASS，不把它解释为功能验收PASS。
