sakuyaShining/FPGA-Music-project-internal/docs/02-技术方案/44-音乐引擎对通用乐器与分层的适配审计-2026-10-14.md

# 音乐引擎对通用乐器与分层的适配审计 · 2026-10-14

> 后续第一阶段已在`codex/instrument-engine-safety`实现，代码`a7427ed`、交付`683db48`。下文是对原07的审计证据，原失败保留；修复版在针对性数字和最终PnR范围已验证，未板验、未项目全量回归。完整版本、源码与码流包见[交付身份](../../notes/engine-safety-stage1-20261014/delivery.json)。新可写定义、完整三生命周期、表情保持/尾音参与和分层不因此成为已实现。

## 1. 结论

**现有引擎适合作为“自定义乐器＋音色分层”的加法合成底座，但尚不足以直接交付这两项完整功能。** 主要缺口是可写的乐器定义、独立的完整生命周期/包络参数、平滑修饰、实例与层身份，以及安全频率/混音约束。完整功能能否放入固定Nano20K，仍需实际资源探针与联合PnR，不能仅凭32复音保证。

当前能够承载的声音族是最多16个正弦分量及其时间演化所能表达的谐波/非谐波声音。它可作为多种持续、衰减和混合声音的执行器；不是已实现的激励器—共鸣器物理模拟，也没有采样播放器、真实弓弦/吹管反馈或通用噪声后端。真实乐器辨识与音质须试听，不将预设名称等同完成。

本审计不改用户音乐语义、不修改产品RTL/数据表。新增审计脚本、一个安全边界测试及证据；不新建或覆盖产品基线快照。

## 2. 版本与本次证据

- 主目录：`fe326ad9505c94f46f9236bf7f9bfc3b5f1b9a12`；main基线PASS，192输入无新增/删除/变化。主目录有既有文档/诊断等修改，未清理或合并。
- 审计底座：`C:/Users/Sakuya/.codex/worktrees/66a4/FPGA-Music-project`，`614b2a7`；`project/versions/integration-20261011-07.json`，241输入检查PASS；该工作树有未跟踪资料，不等于完全干净。审计报告绑定实际完整HEAD及RTL/表哈希。
- [可复跑审计脚本](../../notes/engine-capability-audit-20261014/audit.py)、[结果与源哈希](../../notes/engine-capability-audit-20261014/summary.json)。脚本运行在主目录独立`sim_build/engine-audit-20261014-01`，不改整合工作树源或原证据。
- 本次未运行全量回归、综合/PnR、下载或实体演奏；未验证触控、DAC模拟音质和整机10ms。

| 本次检查 | 实际结果 | 可支持的结论 |
|---|---|---|
| 原有`tb_osc_env` | 通过，A1～A9 | 原有ADSR组合状态推进；不是三激励策略完整验收 |
| 原有`tb_finger_pitch` | 通过 | 组0/31、锚点/限幅、释放/重用/竞争/复位等数字端点能力 |
| 原有`tb_release_continuity` | 通过，遍历512槽 | gate-off保留已发声谱参数，含刷新、静音分量和槽再利用；不保证新的Note On在尾音中正确再激发 |
| 新`tb_note_map_guard` | **目标断言失败，边界缺陷已复现** | 高于Nyquist的分量可在截断后漏过静音检查 |
| 全表整数算术审计 | 801个非零幅度组合可能漏过，MIDI36～108内399个 | 与RTL切片/比较等价的静态风险计数，不是801个实际音频用例 |

原有测试使用各自的单元测试时钟/参数，不能把PASS解释为本轮实测27MHz整机性能。审计脚本退出0只表示前三项机制通过与审计期间源码哈希未变；它不包括后续独立安全边界测试。该测试仿真退出1的失败原样保留，不能与前面PASS相抵。

## 3. 能力与缺口

| 产品能力 | 源码事实 | 状态与必要工作 |
|---|---|---|
| 32声部×16分量 | `tdm_top`显式NG32/P16/NSLOT512；27MHz/512=52734.375Hz | 基础内核在已有范围**已验证**；本轮未重新签收整机 |
| 可变频率比与基础幅度 | `note_map`预设项为48位：16位Q8频率比、8位幅度、23位有效包络字段 | **部分实现**；设备只有4×16预设ROM，当前运行时谱RAM只写幅度，缺完整可写定义银行 |
| 各分量独立演化 | 每槽独立相位、包络电平、阶段及epar；共享一套运算逻辑 | **部分实现**；参数自由度不等于完整独立ADSR |
| 起音/释放不同的乐器 | epar只保存`sustain[15:0]+decay_m[1:0]+decay_k[4:0]`；a_inc、r_inc/r_m/r_k等共用输入 | **待实现**；顶层起音117/样本、释放m3/k13等为统一常量；须扩字段或引入紧凑包络配置索引 |
| 持续声音 | sustain可非零、gate-off进入release | 已有ADSR基础；真正Continuous生命周期与动作接合为**部分实现** |
| 瞬间衰减声音 | sustain=0可令分量在按住期间衰减到零 | 行为有基础；Free Decay/Damped Release、再激发、静音但仍接触的身份为**待实现** |
| Hybrid | 一组16项可以选择不同sustain/decay | 可近似瞬态＋持续分量；显式分组和完整生命周期**待实现**，同一分量双包络不在已有能力中 |
| 左手直接跟手 | finger接口可独立改组的比例偏移、不重发Note On，保留释放音高 | 数字端点在既有范围**已验证**；实体输入、绑定上游及一指多组仍有缺口 |
| 右手连续强调与保持 | 旧pad掩码命中幅度255；公共谱事务、亮度16档、逐组刷新有基础 | 新规则**待实现**；缺连续贡献/平滑、保持、RESET、逐层基础谱及可听尾音更新 |
| 不同乐器同音分层 | 分组引擎天然可算不同参数；分配器仍按MIDI同音匹配，全局2位preset | 产品分层**待实现**；改成父音符实例＋layer子声部，逐组预设/版本、整体分配/释放 |
| 任意同音多指 | 输入事件只有音高/ON/OFF/力度，非独立实例身份 | **部分实现**；MIDI音高不能替代所有权 |
| 安全频率/混音 | 有Nyquist比较、定点饱和输出与效果器 | **部分实现且有缺陷**；须补全宽/调制后频率检查、峰值留量、效果稳定性 |
| 发声后端扩展 | 共享正弦表与512槽加法链 | 可保留接口职责；新增模态/波导/采样/噪声需独立评估，不能直接承诺 |

## 4. 需要纠正的几个能力误读

### 4.1 独立状态不等于独立完整包络参数

`tdm_engine`的512槽各自推进包络，但a_inc、r_m/r_k等是同一组输入。当前`tdm_top`固定a_inc=117，满幅32768约需281次推进，即起音爬升约5.329ms，另有事件/样本对齐延迟。这不是测得的触摸延迟，也不是总10ms指标。

因此先前“钢琴快速敲击、弦乐慢起音，各自独立释放”的描述是目标，当前顶层不能分别配置这两套起音/释放。建议复用共享包络计算器，以每声部/分量参数索引扩展；不要复制32套完整运算逻辑。

### 4.2 当前钢琴预设并非完整瞬间激励模型

现有四预设为org、piano、bell、marimba，并非已完成小提琴。piano的16项sustain均非零，范围250～12000，按住足够久会停在非零延音；bell/marimba的sustain为零。修改表可以得到部分衰减行为，但Note Release仍统一进入release，未实现各乐器独立自然衰减/阻尼策略。

`osc_env`只在IDLE处理trig_on，其他阶段没有显式RETRIGGER处理；门保持1时重复装载也不会产生新上升沿。快速重奏、尾音期间复用、满载抢占的重新起音需要新判据，不能因已有分配器把同音复用注释为“重触发”就宣称满足。

### 4.3 运行时幅度编辑不等于完整自定义乐器

`part_rom`从hex初始化，运行时谱RAM提供16个幅度；无频率比和包络字段的主机可写通路。亮度只取高4位形成16档，旧掩码直接拉到255。GUI保存激励字段不代表设备执行。

新结构需要乐器定义银行（频率比/幅度/时间参数）、版本锁存、按层基础谱、独立演奏修饰。Apply时不能向正在发声的槽写出半份定义；幅度目标还需有界平滑。当前逐槽周期标记只保证相应参数消费逻辑，不自动提供跨全和弦/多层的原子提交。

### 4.4 gate-off参数保护与可听尾音修饰是两件事

07的`release_only`在gate1→0时保留已有inc/amp/epar，解决释放尖峰；本次512槽测试通过。另一方面`note_map`刷新扫描只看gact，松手时gact清零，尾音不再进入普通刷新；这不满足V1.0“可听尾音也受全局修饰”的目标。

需要分开维护接触所有权、按住状态、声音/释放状态；对尾音的合法修饰使用明确路径，同时保留gate-off保护。不要为了刷新尾音简单把门重新置1。

## 5. 已复现的频率安全缺陷

`note_map`先算40位乘积，再用`inc_mul[31:8]`取24位结果`inc_cal`；Nyquist比较在24位结果上进行。若真正增量已超过2^24，截断可能把它绕回低于2^23，因此误判为可发声。

本次[测试源](../../notes/engine-capability-audit-20261014/tb_note_map_guard.v)使用未修改的07 `note_map`/`vel_shape`及权威表：MIDI108（C8）、org预设第16分量，完整增量21308176，装载后4530960且幅度71。实际所需频率约66976.15Hz，截断后变成约14241.78Hz。超过Nyquist本应静音，测试断言真实失败。见[失败日志](../../notes/engine-capability-audit-20261014/note_map_guard.log)与[绑定源哈希的记录](../../notes/engine-capability-audit-20261014/note-map-guard-summary.json)。

此外，当前Nyquist静音只发生在装载前；引擎之后乘左手比例/音高调制，未见对应最终频率安全检查。例如MIDI90第16分量约23679.7Hz在初始采样率下可发声，但向上移动一八度后约47359.3Hz，超过26367.1875Hz。本项是源码/算术风险，本次未新增调制后音频仿真。

建议先修全宽判断、配置合法性校验与调制后的最终增量约束；再制定高频分量接近边界时的静音/过渡规则。不能仅运行旧静态预设审计脚本就宣称运行时音频安全，也不能以音高表本身PASS覆盖乘法和调制路径。

## 6. 复音、运算预算与硬件余量

| 分层数 | 完整按键实例理论上限 | 说明 |
|---:|---:|---|
| 1 | 32 | 每实例一组16分量 |
| 2 | 16 | 两乐器各占一组 |
| 3 | 10 | 两组余量不足承接完整三层新实例 |
| 4 | 8 | 四层三音和弦占12组；五指占20组，余量可用于尾音 |

这是共享32组的计算容量，不保证尾音无限保留。当前松手立即释放分配占用，后续新音可复用该组并覆盖尾音；新设计应按完整实例回收/抢占，并明确平滑与再激发策略。

512槽每音频样本轮转一次，正常计算已覆盖全部槽，不能认为没有按满32音就有等比例免费时钟可运行其他后端。装载/映射属于另一条共享控制链，可在保持音频节拍下扩展，但最终取决于真实综合结果。

07已有PnR：Logic18751/20736、CLS10048/10368、BSRAM38/46、DSP10.75/24（工具单位），setup+7.378ns/hold+0.198ns/TNS0，PR1014仍挂账。剩余约1985 Logic、320 CLS、8 BSRAM，CLS仅约3.1%。这些资源来自包含观察链的配置；任何优化回收必须拿新证据，不能口头扣除。完整触控/实体三视图/可写配置/分层需联合预算，不能分别承诺同一余量。

## 7. 产品和控制规则建议边界

本审计建议的首版定位为：**在16分量加法合成范围内，可自定义激励/频谱演化/表情响应，并支持多乐器分层的电子乐器。** 这是对后端能力的表达，不替用户决定最终音色或缩减目标。

- 继续复用现有TDM与共享包络计算结构；先实现可写参数和完整事件生命周期，再接分层。
- 运行期左手表达不重起包络，右手修饰不改已保存基础定义；配置Apply、再激发和场景选择各有明确语义。
- 每层可有不同起音、释放与衰减，但同一动作仍按统一演奏规则解释。全和弦修饰保留层间差异。
- 开放的频率比、增益、包络范围须由合法性校验及硬件安全路径共同约束；不让用户通过自定义参数触发回绕/溢出。
- 分层保留32组资源基线，定义尾音回收和完整组合的接收/拒绝；确切触点数、层数参数及平滑规则仍由功能定案收口。
- 真实压力、自动颤音和混响不能借已有接口提前签收；旧LFO接缝/T60高反馈失败各自解决。

## 8. 接下来的实施顺序与验收

1. **频率安全与重奏探针**：全宽/调制后检查；增加持续中RETRIGGER、释放中再起音、满载复用的目标判据。先让失败明确可复现，再修复，不删除或改名失败。
2. **单乐器定义闭环**：可写频率比/幅度/包络参数＋版本与Apply；同一RTL产生持续、自然衰减、分组混合三类行为，保存/加载可重复。
3. **完整表情与尾音**：有界平滑、原力度/包络保持、松手保持/RESET、新音与可听尾音修饰；用数字输入先验证，再接实体。
4. **分层闭环**：父实例＋子层、同音所有权、一指多组表达、完整分配/释放/抢占与逐层预设；双层先验，再测四层边界。
5. **资源与实体签收**：每个阶段适当综合探针，最终联合PnR与板测；实际DAC音质/电气和最坏触摸→声音≤10ms独立验收。

状态：底层既有机制在表列范围**已验证**；通用乐器定义及三生命周期为**部分实现/待实现**；音色分层、连续修饰保持和尾音作用为**待实现**；两项频率保护问题分别为**已复现未修**和**源码风险待验证**；完整新功能资源为**待验证**。不将本次三个机制测试PASS写成产品目标完成。
