sakuyaShining/FPGA-Music-project-internal/docs/02-技术方案/45-实体面板与机上乐器编辑交互草案-2026-10-14.md

# 实体面板与机上乐器编辑交互草案 · 2026-10-14

> **后续用户决定覆盖**：用户在2026-10-15明确取消独立钢琴键设计，音高演奏改为滑条，并进一步纠正：保留原两排/两个八度的逐音布局，另加一条八度切换滑条；不改成少数全音域条或单条多指。最新同规格三版选型见48号，工作流见46号。本稿独立键/条交接比较留作历史，四槽/编辑等用户目标继续保留，补充交互仍按原讨论状态。

状态：用户明确的需求为**待实现**；以下补充交互均为**讨论中**，未经用户确认不写成设备正式默认。仅设计文档，无产品源码变更。

## 1. 本轮用户明确的实体目标

- 音高区：压力感应条用于八度切换；用户随后明确每排一个完整八度，两排共两个八度。键上方滑条可直接发音并实现滑音、颤音；独立琴键是否保留，用户要求比较两种方案后再选择。
- 音乐可视化区：一块屏幕显示音乐。
- 音色构造区：沿用已有泛音构造方向；保留全和弦修饰、松手保持、RESET平滑恢复等已有决定。
- 四个预设按钮：可选择一种或多种乐器，用于自定义乐器演奏及音色分层。
- 编辑按钮：按下后选择一个预设槽，在实体机上编辑该乐器的音色、激励模式等。

此需求扩大了实体机编辑范围，不再仅依靠电脑修改乐器。四槽不代表框架仅支持四类声音；设备保存与断电保留仍须分别定义。

## 2. 音高区候选

建议把键形布局与连续滑动区域合并：每个触控键直接产生基准音，落指位置作为相对滑音锚点，沿键移动改变所属音符音高，往返移动产生手动颤音。保留琴键外形、分区与触觉边界；不要求额外机械键盘。该建议替代键外上方独立滑条布局，尚待用户选择。

若保留机械键与独立滑条，必须另定：滑条能否独立触发、同键同时触发如何计数、按键转移至滑条是否保持音符、各自松手如何终止控制。不能将两路简单OR后宣称身份连续。

每键单触点、多指跨键与同键多触点为不同能力，传感原型通过前不承诺同键双指。滑音量程、跨键动作、松手音高、追踪丢失宽限仍未冻结。

八度条建议按位置划分有迟滞的档位，压力用于确认接触而非默认按用力大小切档；器件需核实是否输出位置，不能从“压力感应条”名称推定。建议切档只影响之后新音，已有按住音维持音高，避免整和弦跳变；待用户确认。

两排各一八度已由用户明确；12个半音键/排共24键、或含高端C共13键/排26键、或共享端点等仍需确定，不直接从“两八度”推定旧25键/38通道。

### 2.1 用户要求的两方案比较

| 维度 | 独立琴键＋上方独立滑条 | 琴键自身为滑动触控区域 |
|---|---|---|
| 直接发音 | 两路都能发音时需处理重复触发；若滑条不发音则改变用户原意 | 同一触点落指起音、移动表达、离开释放 |
| 从稳音进入滑音 | 通常需从键移动到条，交接空隙、两指重叠、跨区所有权需要规则与原型验证 | 同一键内原手指移动，无独立区域交接 |
| 稳定音高 | 独立键可完全固定音高；滑条独立承担变化 | 需位置锚定、静止区/迟滞、滤波平衡抖动与微小颤音 |
| 多音表情 | 每键有对应滑条才有直接逐音映射；共享一条需另定作用对象 | 每键独立位置自然对应各自音符；仍需原型证明并行能力 |
| 面积和实现 | 两排各12或13键外再配逐键滑条会增加面板与输入规模；不一定是机械键 | 合并发音区与表达区，但长条几何、行距和可达性需手板验证 |
| 力度/触觉 | 只有额外行程/测力结构才有对应能力，独立按键本身不保证真实力度 | 单纯电容条不自动有真实压力/机械回弹；可做表面分隔 |
| 适合的产品方向 | 明确保留传统独立键手感、允许两种演奏入口，愿意承担交接与更多传感硬件 | 同一动作兼顾起音与逐音连续表达，优先统一控制框架 |

建议优先验证一体式触控滑动键，但不代替用户定案。可制作单键/少量键原型：静按不飘音、缓慢小幅往返能表达、快速落指不起偏、多键保持独立、松手无挂音；再扩展两排。独立方案可作为保留独立按键手感的候选，不以主观喜好直接淘汰。
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
