sakuyaShining/FPGA-Music-project-internal/docs/02-技术方案/46-嘉立创AI选型与PCB制造工作流-2026-10-15.md

# 嘉立创AI选型与PCB制造工作流

> **最新范围修正**：用户进一步明确保留原两排逐音布局/两个八度，音位采用滑条，另有一条八度切换滑条；要求三版选型设计。下文“重新选择独立少量条/单条多指及数量”的未决项来自助手误读，不再适用。工作流仍有效，具体同规格规模与方案见48号。

状态：**部分实现**。官方设计skill与社区选型skill已安装，商城候选核对与身份过滤已执行。用户进一步明确授权代安装后，EDA专业版4.1.71已安装，CLI版本/doctor命令**已验证**；编辑器未启动，doctor返回connected=false，工程/封装/DRC/制造文件及国内最终报价**待实现**。本记录不等于选型或制造签收。
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
