sakuyaShining/FPGA-Music-project-internal/docs/04-架构图/01-运行时架构.png

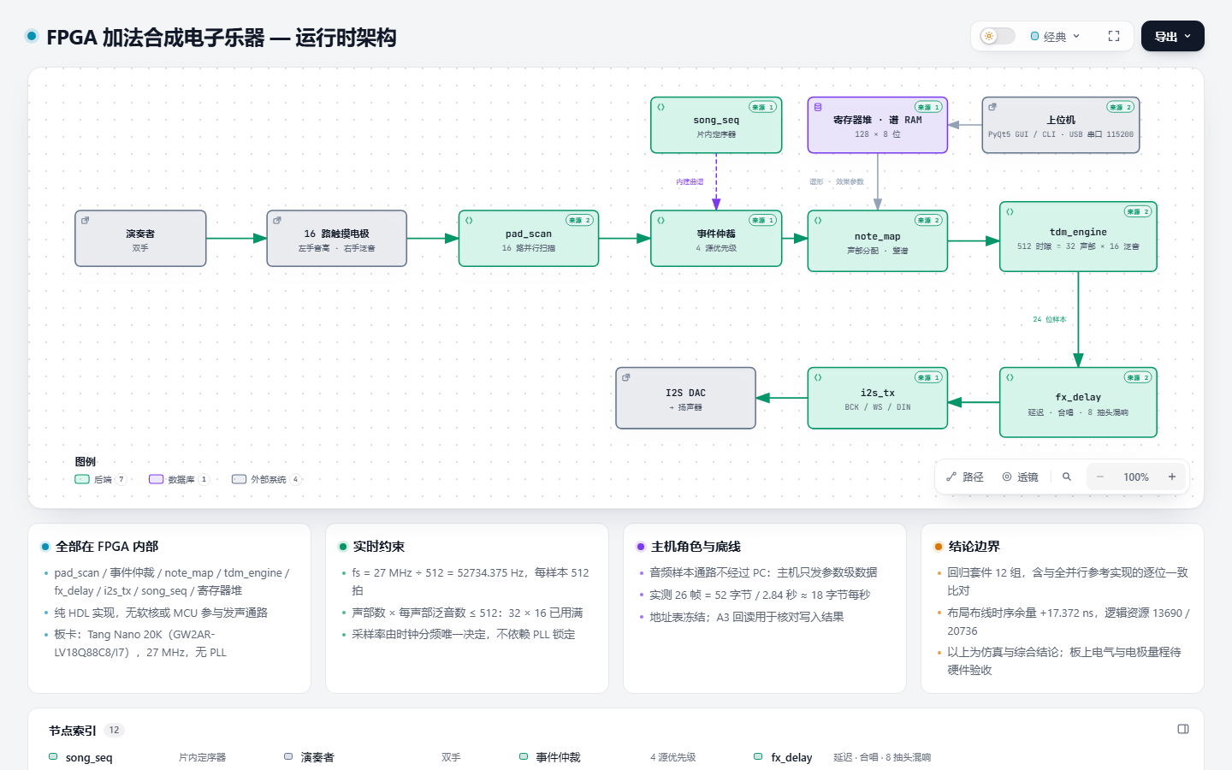
docs/04-架构图/01-运行时架构.png
