sakuyaShining/FPGA-Music-project-internal/docs/04-架构图/02-音符完整链路-时序.png

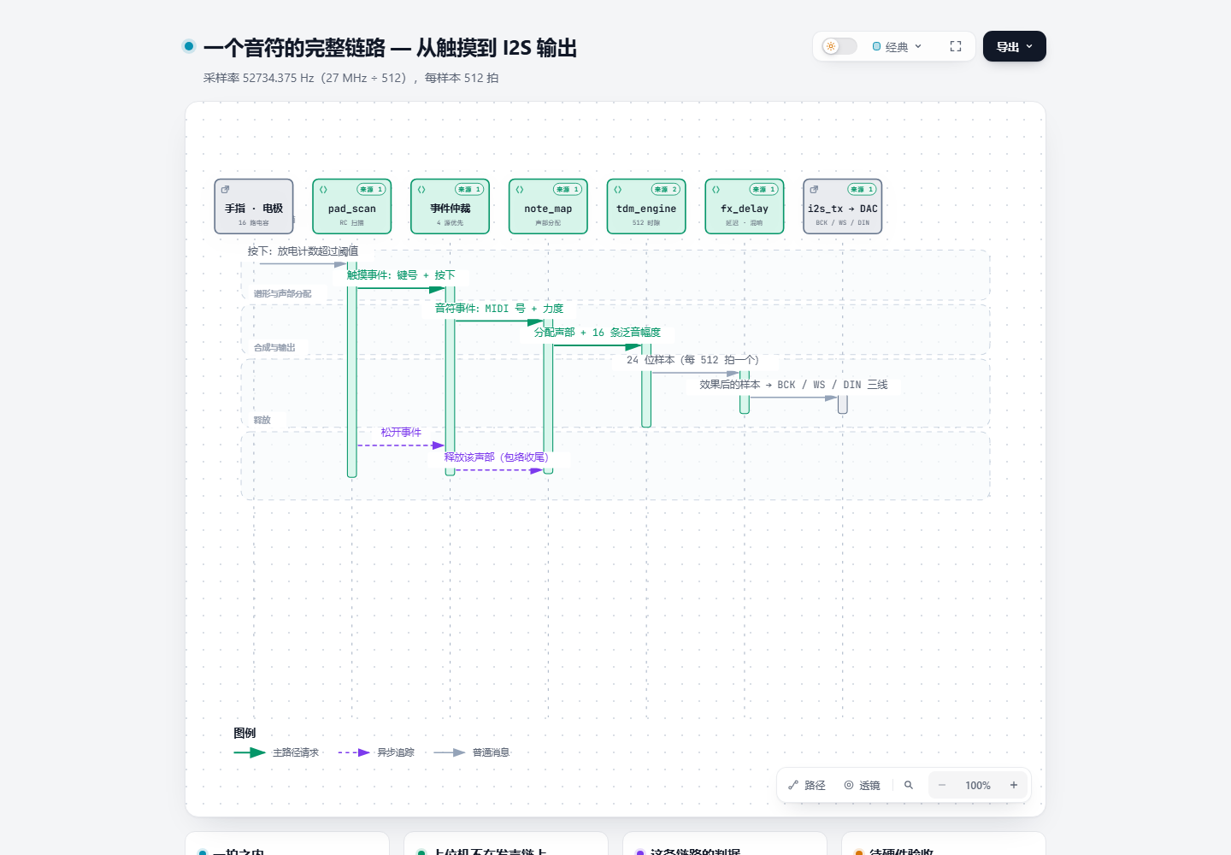
docs/04-架构图/02-音符完整链路-时序.png
