sakuyaShining/FPGA-Music-project-internal/docs/04-架构图/03-交互层三层分工.png

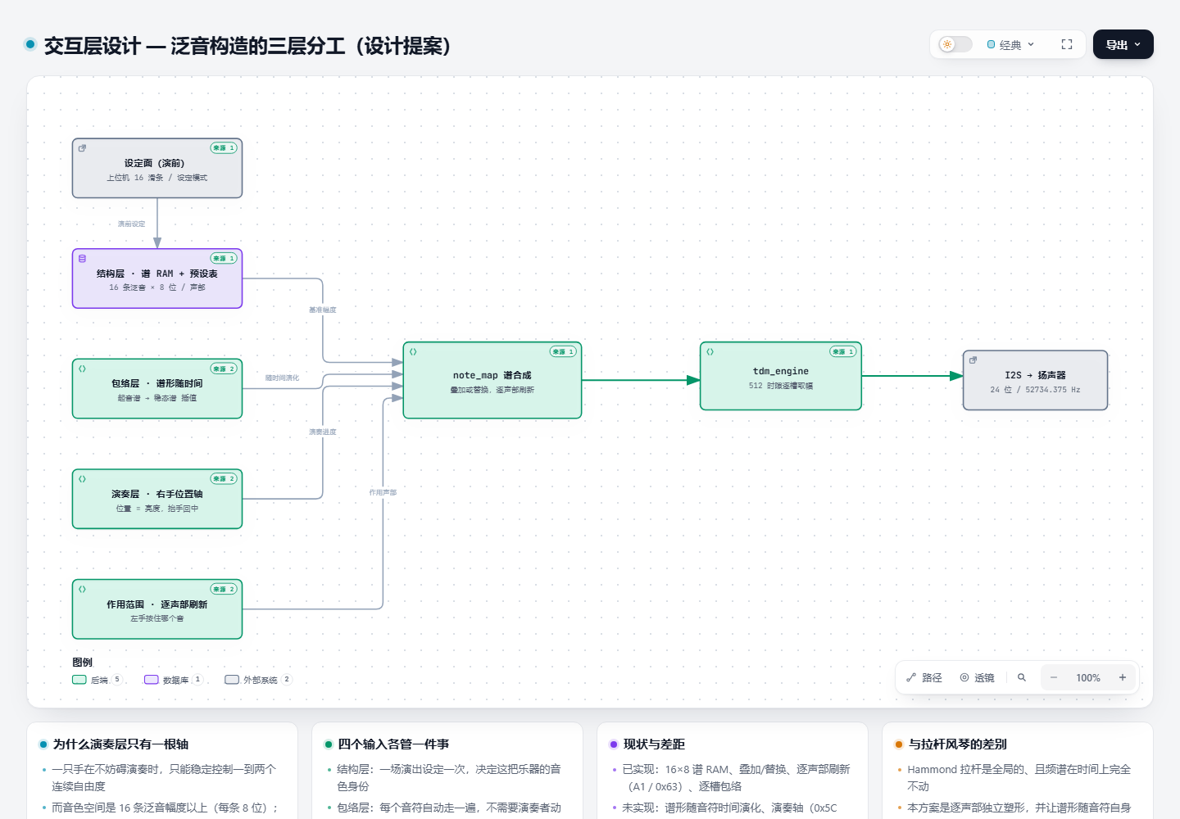
docs/04-架构图/03-交互层三层分工.png
