sakuyaShining/FPGA-Music-project-internal/docs/04-架构图/04-泛音构造-当前实现.png

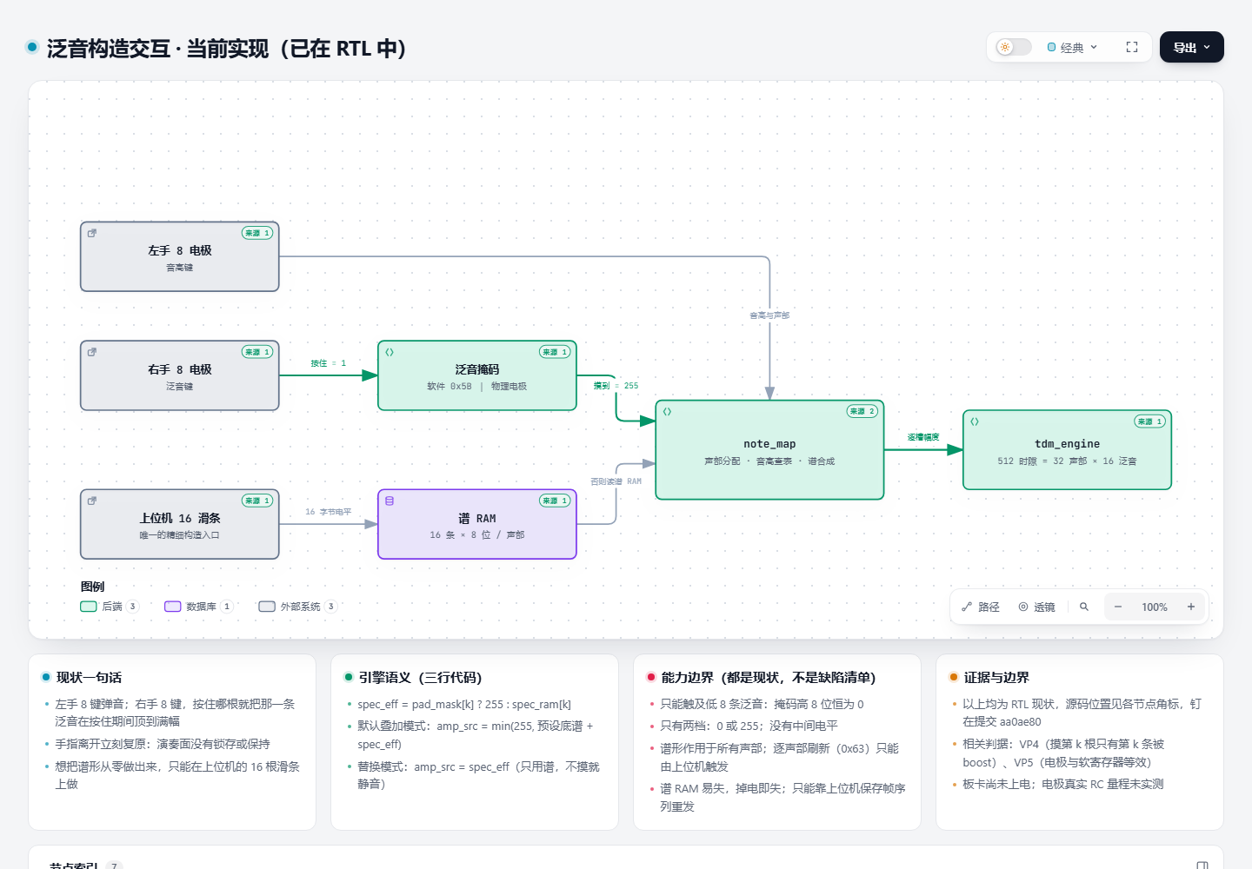
docs/04-架构图/04-泛音构造-当前实现.png
