sakuyaShining/FPGA-Music-project-internal/docs/04-架构图/05-泛音构造-提案手势.png

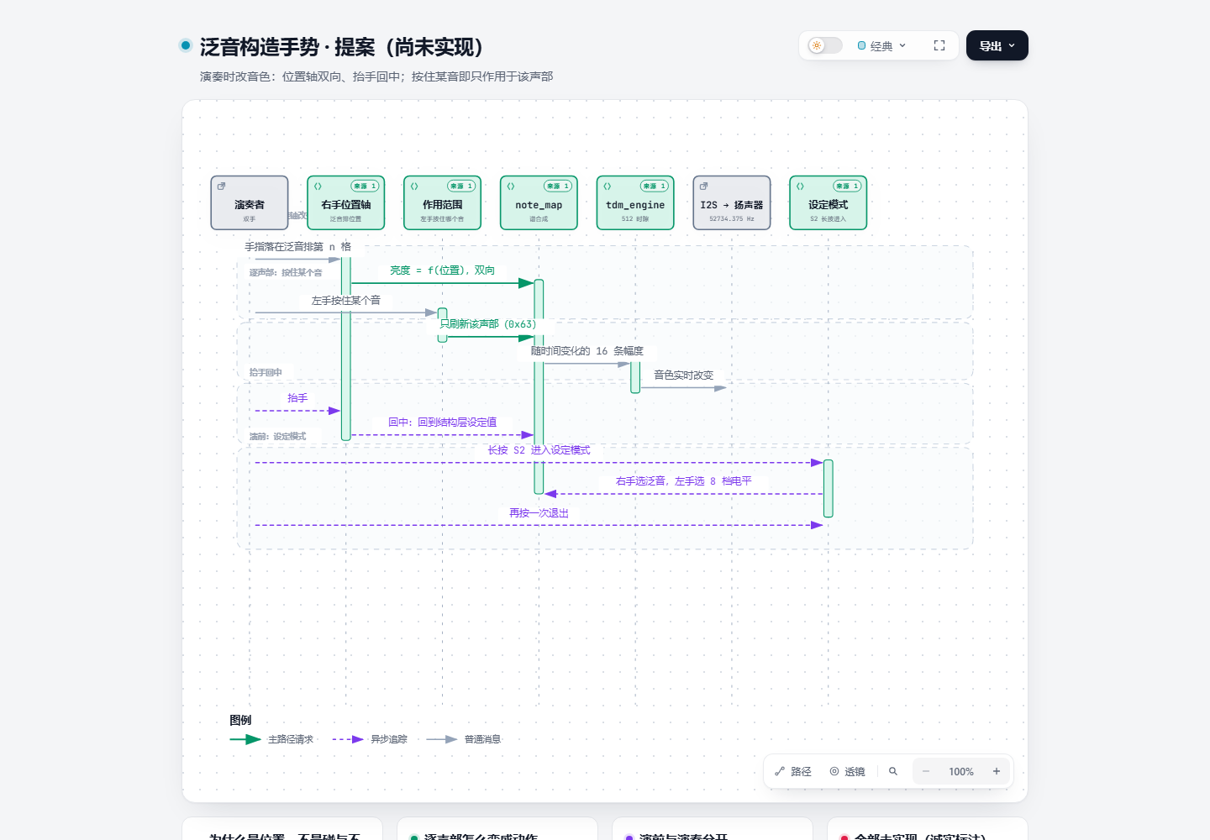
docs/04-架构图/05-泛音构造-提案手势.png
