sakuyaShining/FPGA-Music-project-internal/hardware/current/module-plan/evidence/control-DFR0072-official-schematic-page1.png

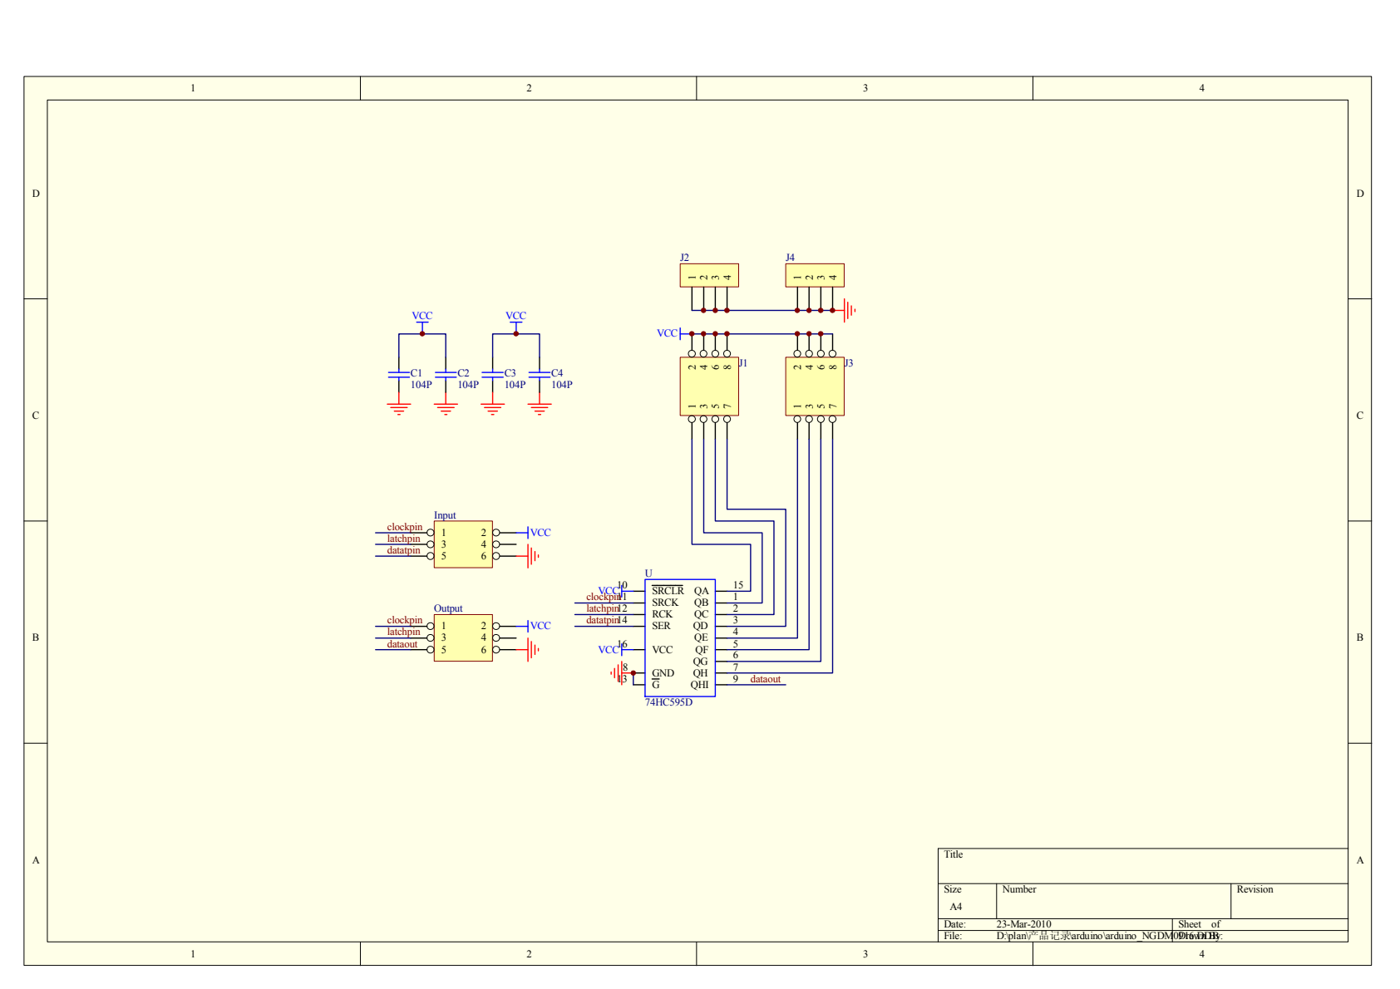
hardware/current/module-plan/evidence/control-DFR0072-official-schematic-page1.png
