sakuyaShining/FPGA-Music-project-internal/hardware/current/module-plan/evidence/Microchip-24LC256-DS20001203W-pinout.png

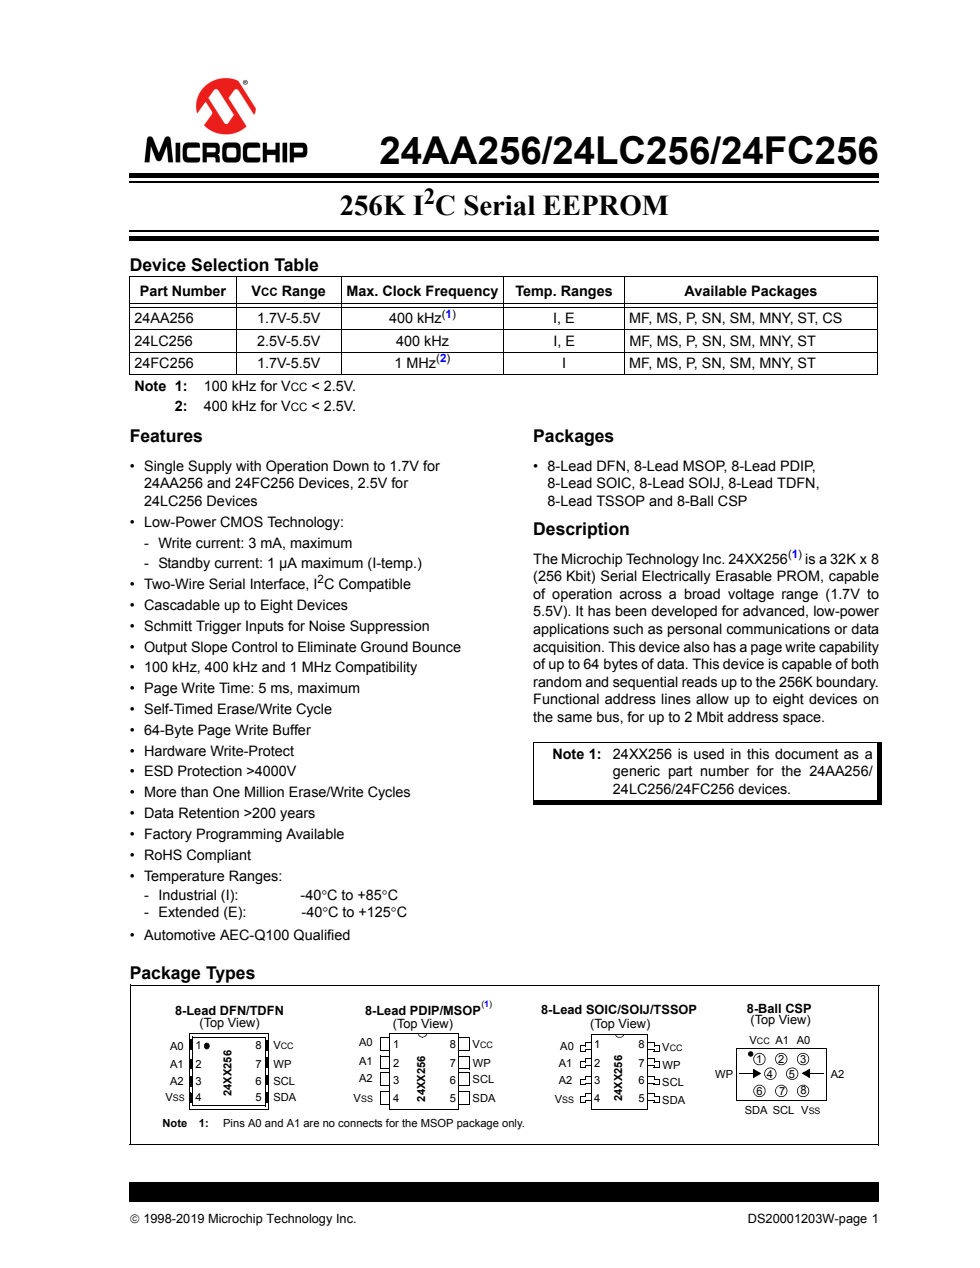
hardware/current/module-plan/evidence/Microchip-24LC256-DS20001203W-pinout.png
