sakuyaShining/FPGA-Music-project-internal/hardware/current/module-plan/evidence/Nano20K-TF-proof-current.png

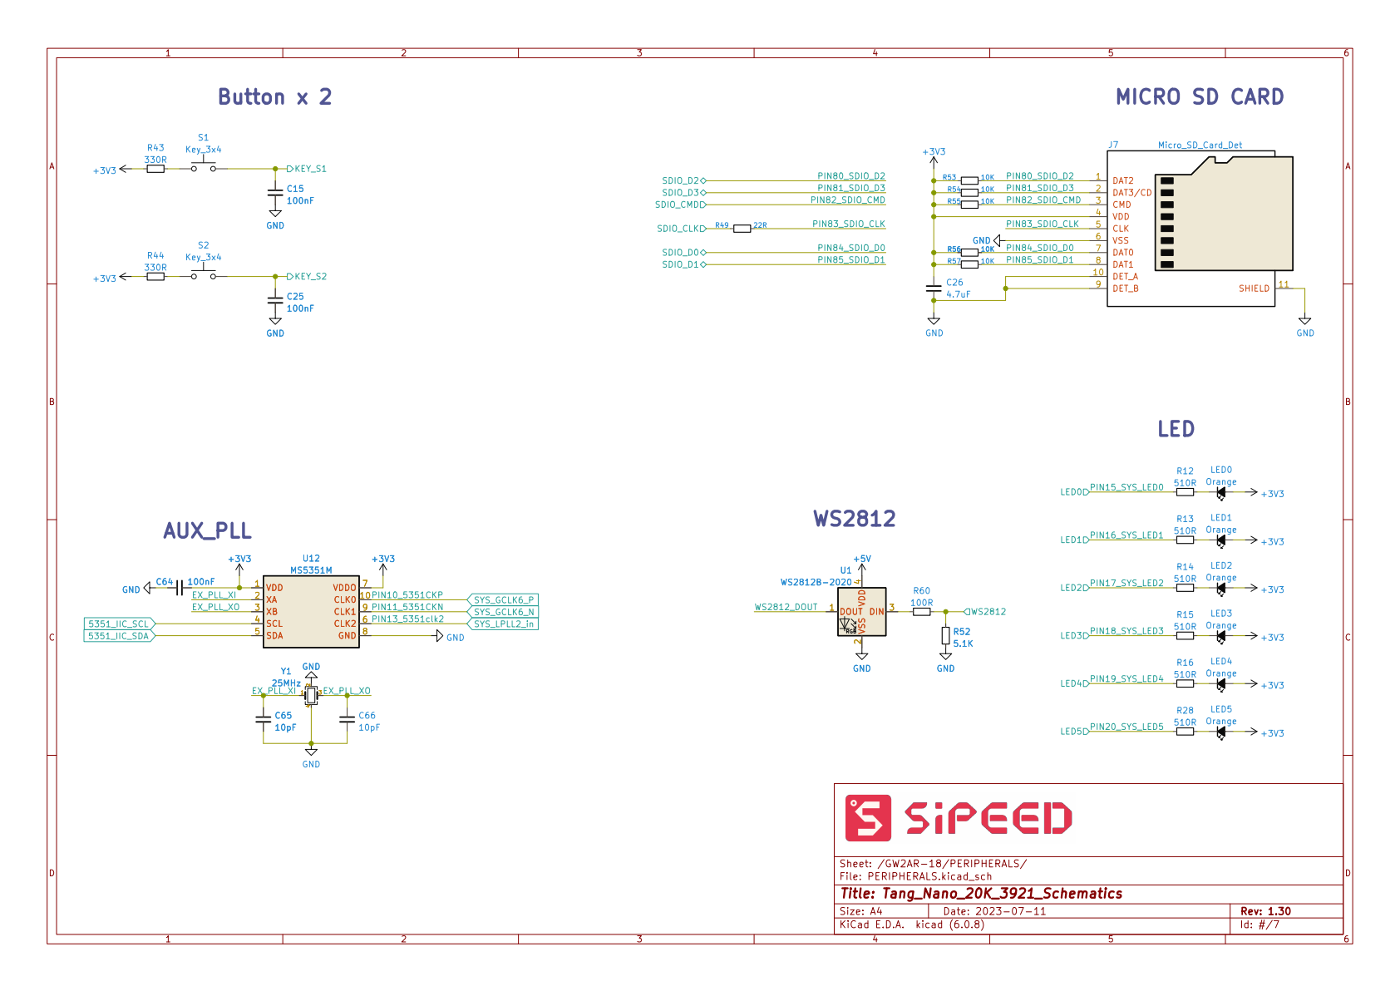
hardware/current/module-plan/evidence/Nano20K-TF-proof-current.png
