sakuyaShining/FPGA-Music-project-internal/hardware/current/module-plan/evidence/sensor-header-fanout-current.png

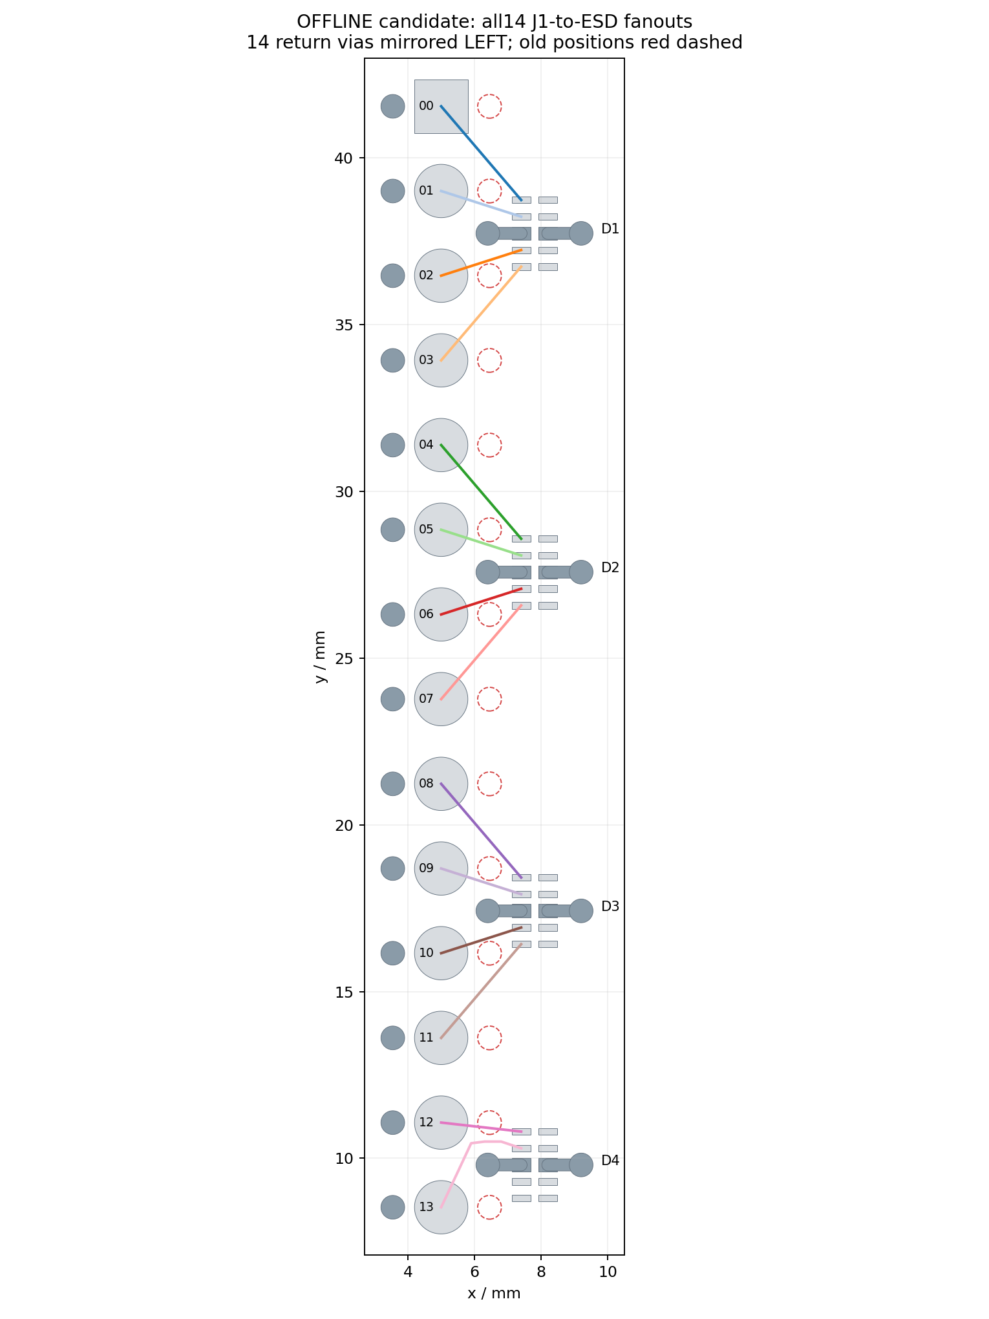
hardware/current/module-plan/evidence/sensor-header-fanout-current.png
