sakuyaShining/FPGA-Music-project-internal/hardware/current/module-plan/evidence/Spotpear-010313400000-schematic.png

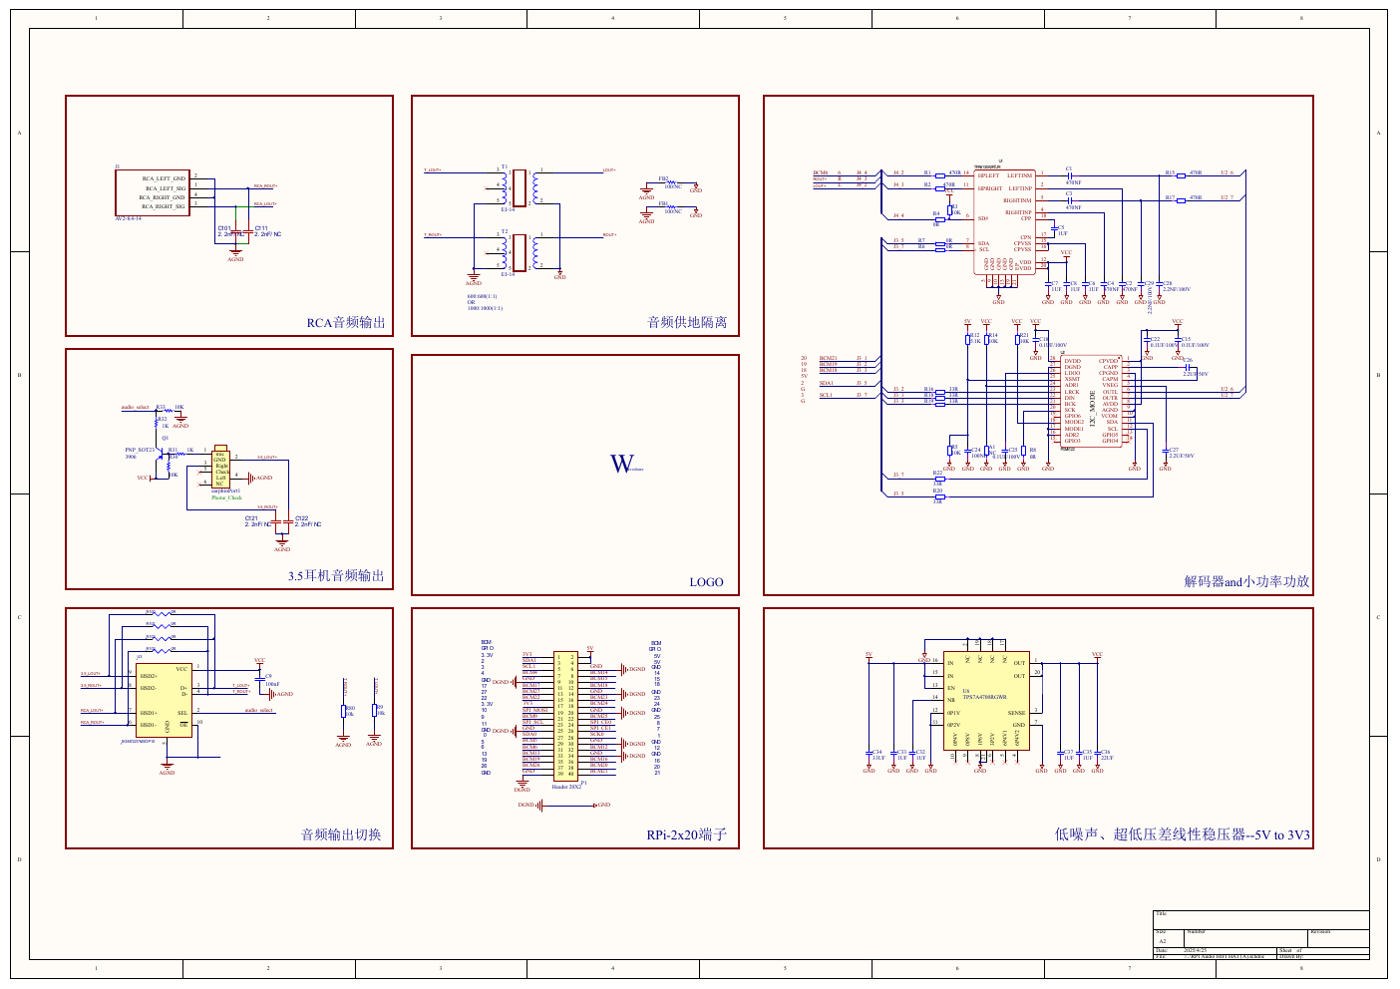
hardware/current/module-plan/evidence/Spotpear-010313400000-schematic.png
