sakuyaShining/FPGA-Music-project-internal/hardware/current/module-plan/evidence/Spotpear-audio-DAC-amp-review-current.png

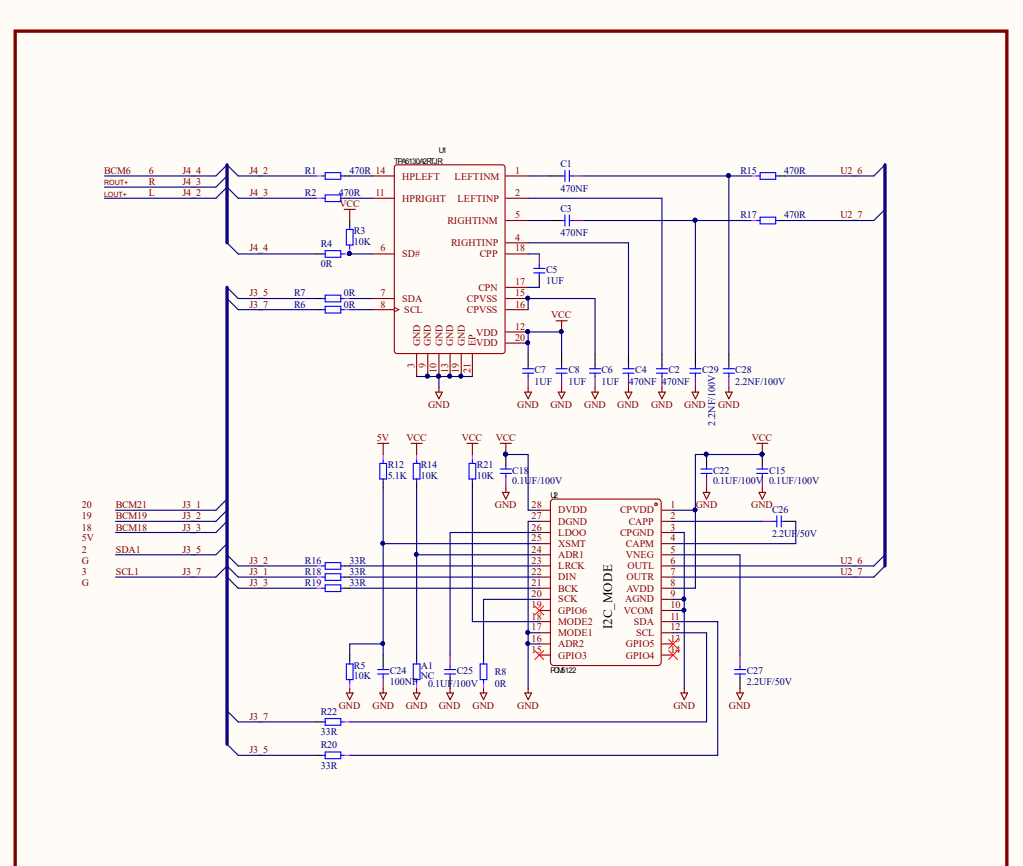
hardware/current/module-plan/evidence/Spotpear-audio-DAC-amp-review-current.png
