sakuyaShining/FPGA-Music-project-internal/hardware/current/module-plan/evidence/Spotpear-audio-detail.png

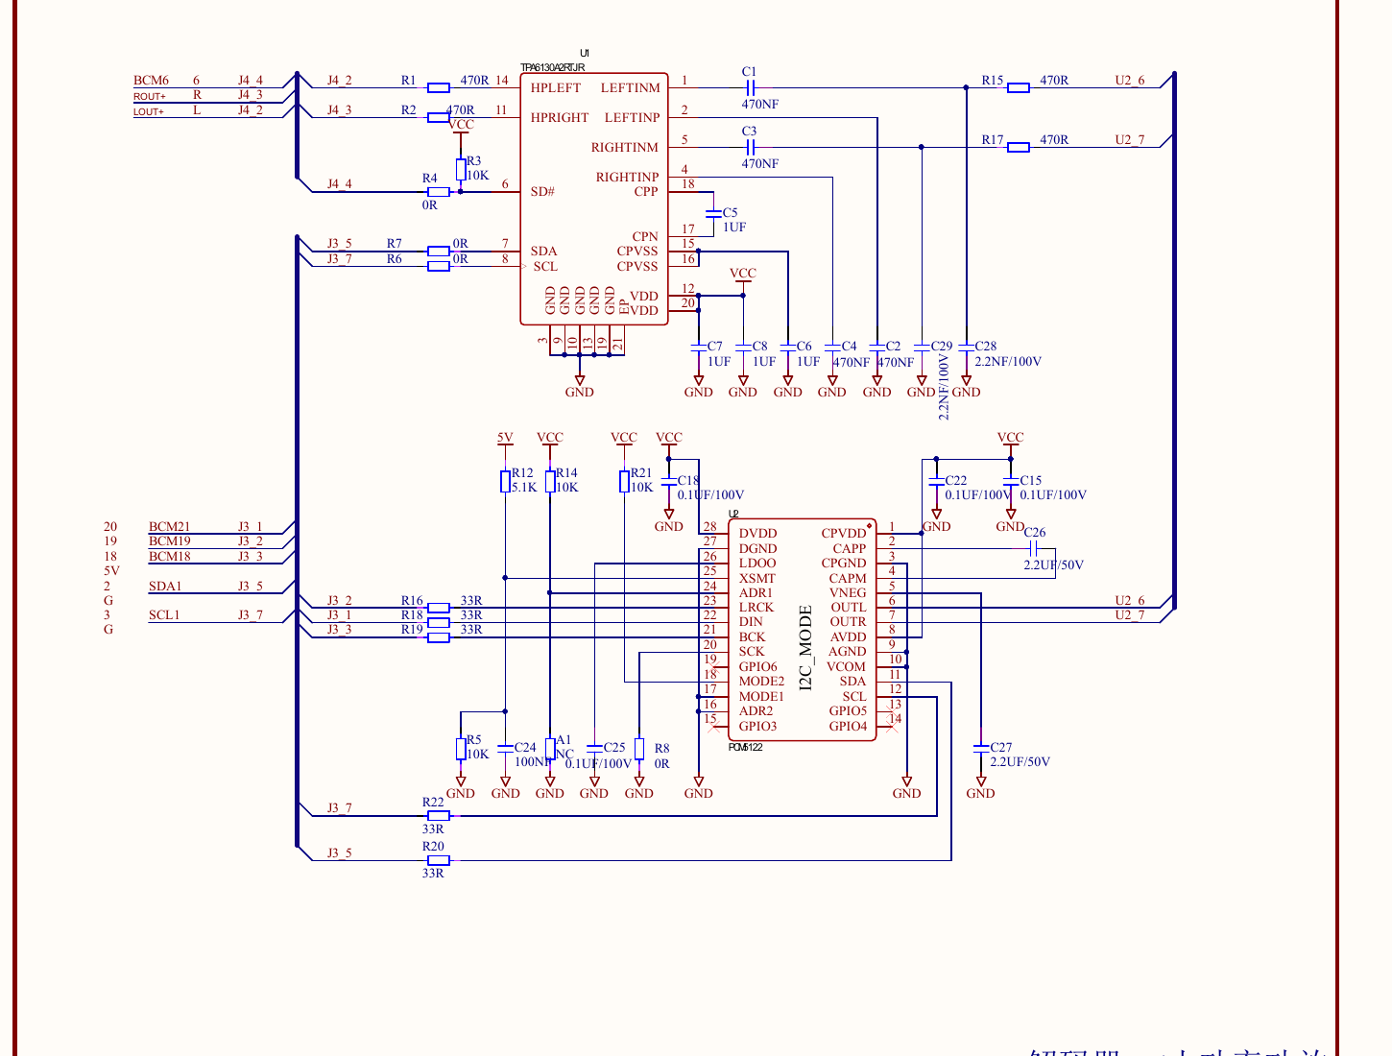
hardware/current/module-plan/evidence/Spotpear-audio-detail.png
