sakuyaShining/FPGA-Music-project-internal/hardware/current/module-plan/evidence/TI-SN74LVC244A-SCAS414AG-pinout.png

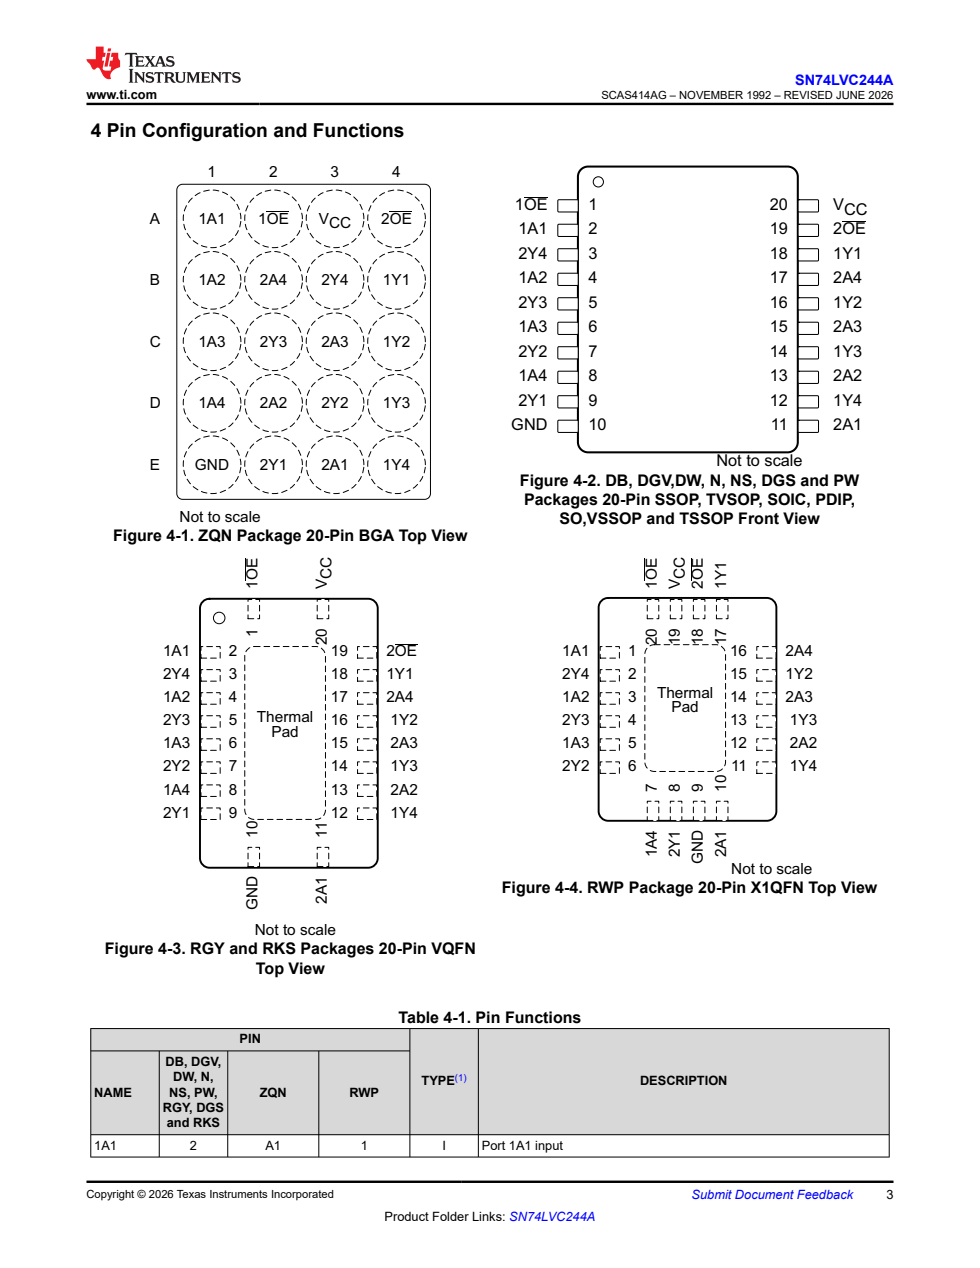
hardware/current/module-plan/evidence/TI-SN74LVC244A-SCAS414AG-pinout.png
