sakuyaShining/FPGA-Music-project-internal/hardware/current/module-plan/evidence/TPD4E02B04-layout-current.png

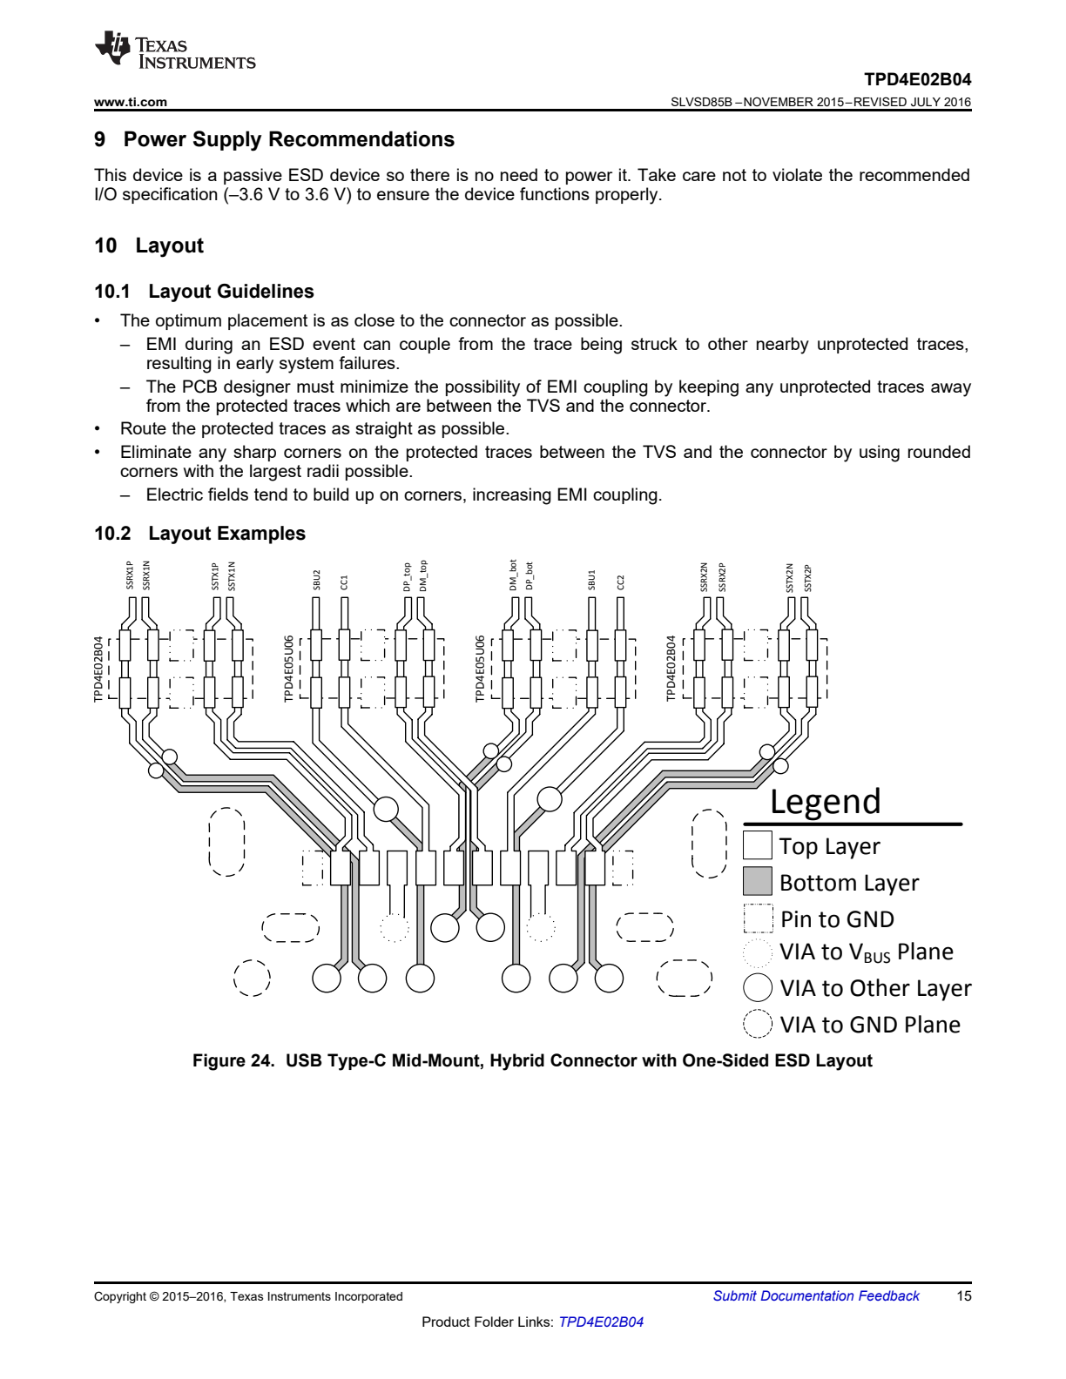
hardware/current/module-plan/evidence/TPD4E02B04-layout-current.png
