sakuyaShining/FPGA-Music-project-internal/hardware/sourcing-closure-20261030/quote-options-20261030/README.md

# C88十三个电容的替代报价选项：仅询价，不改冻结源

**给采购队友的具体路径：先让厂家按1块C88 R2完整成品带料贴装报价，不预先在零售商城买两万个电容。** 若工厂无法以合适数量/交期供应C14663，再比较本目录明确列出的13位号C1591替代报价。当前没有实际厂家报价，也没有确认整机700元预算可满足。

现行冻结BOM、原理图实例和PCB实际属性仍为C14663，身份一致。此目录`Control88-R2-ALT-C1591-QUOTE-ONLY.csv`是88行完整对照报价候选；仅C8/C9/C10/C11/C22/C23/C24/C25/C33/C34/C35/C36/CX1这13行，MPN改为Samsung CL10B104KB8NNNC、LCSC改为C1591，其余75行和全部位号/Type保持原样。逐行偏离表和可复跑核查脚本同时提供。**不能把报价候选当成同源制造BOM交付生产。** 冻结CAD、BOM、Gerber、CPL都未改。

名义参数/封装比较沿用[厂家资料核对](../MANUFACTURER-NOMINAL-COMPARISON.json)：两型号均100nF±10%50V、X7R、0603/1608。没有宣称ESR/ESL/DC偏压曲线完全相同。供应商若选择替代，还要明确实际备料/损耗/费用/交期，并在确认制造选择后另做相应原生属性与制造BOM版本，避免把C14663源与C1591报价文件混用。

## 414元说法的证据边界

本轮重新解析并校验了WorkBuddy于2026-10-29 03:42抓取的[国内C14663商品页](https://item.szlcsc.com/15331.html)原始HTML，SHA256为80a23fd8…：型号和编号匹配，`minBuyNumber=20000`、`minWholeNumber=4000`，另有合作供货字段provider=waldom。`stockNumber=24000000`与`validStockNumber=6000`同时存在，不应把两者混成同一可立即发货数量。按旧模型的0.0207元计，20000×0.0207=414元，算术成立；这是**特定历史零售路径的条件成本**。

本轮国内页自动读取返回HTTP405，浏览器控制也超时；web只读页面可确认型号但没有返回动态价格/起订数量。因此**当前MOQ/价格没有重新验真**，不能把历史414元写成今天厂家的贴装报价，不能据此直接判定整机一定超700元。原始失败记录保留。C1591历史MOQ100、0.0467元也不能冒充当前价，本报价候选不填预计节省金额。

[嘉立创EDA官方教程](https://image.lceda.cn/files/LCEDA-Tutorials_v6.3.53.pdf)明确区分商城购买与SMT选料的库存/价格；[JLCPCB当前官方选料流程](https://jlcpcb.com/help/article/how-to-build-your-own-parts-library-in-jlcpcb)也区分自有库存、预购、客供及起订要求，[官方匹配问题说明](https://jlcpcb.com/help/article/common-bom-and-cpl-matching-issues-and-explanations)提醒还会有最低贴装量和损耗。国际站规则不能替代国内订单的具体收费，本项目需要厂家回填本次实际口径。

## 请采购队友索取的两份明确报价

1. 现行C14663方案：C88 R2组装成品1块，按实际BOM用量13个该电容，列工厂可用库存、最小计费数量、损耗、上料/代购费用、完整含运总价及发货日。不要仅回传电容零售价。
2. 若第一方案需要大批备料或交期不可接受，再报附件C1591候选13位号，列同样费用和交期、明确其它75件/PCB/插件不变。请勿在未确认前自行替代生产。

费用必须和六块S2、完整电极、屏幕、电源、线束、覆盖、结构及全部运费一起计入700元上限；未知项保持空白，不能填0。此文本为询价草稿，未代发商家、未下单、未制造放行。
