sakuyaShining/FPGA-Music-project-internal/hardware/current/context/purchase-preparation-20261021-r1/README.md

# 当前采购与装配入口

原生PCB仍为951：227件、649孔，42项未连通、12个网络；ADDR2已验收，整板未完成。实物UNMEASURED，禁止据此下单。

- current-procurement-entry.json：同源951采购包入口。
- current-board-procurement.json：板上227件、36料号；215个SMT与12个通孔件均按工厂装配准备，不能默认用户手焊。
- current-system-procurement.json：整机附件和未关闭事项。单J10触控屏、84传感、Nano20K、140×100毫米四铜层；J11及其屏和专用线束取消。
- native-cpl-current-951ce88a-DRAFT-NOT-FOR-ORDER.csv：951原生重新导出的227行坐标。目前212个顶面SMT、3个背面SMT；任何后续器件移动或翻面后必须重新导出，不套用候选位置。
- current-J10-harness.json / .csv：从951真实12个J10焊盘逐针核对的单屏电气线束草稿。模块侧40个针位均有连接或NC声明，尚不是机械接线施工图。

保留屏目标配置为ER-TFTM070-5V4、RA8875、FT5316电容触摸、工厂四线SPI和5V供电。线束目标选择排针版；确切出货配置、模块接插件朝向、公母配合、线长、完整价格库存交期尚未验证。模块LCD 11脚按NC处理，载板J10.7保留不接；触控复位另接模块36脚。LCD重新启动及棕断恢复、整机SPI频率和IO配置仍需解决，不能因插针映射完成就签最终选型。

原生试摆候选C9背面尚未接受，采购坐标保持实际951。若未来该方案接受，将变为211个顶面SMT与4个背面SMT，须重新核背面净空及工厂双面和通孔工艺。

README-history-r1.md、small-screen-harness.json及旧工作簿仅作历史：小屏线束文件已明确标为取消，不用于生产。旧230件、217个SMT、13个通孔、双屏和手焊分工不能覆盖本入口。历史库存不是当前PCBA匹配报价，基础屏价不是完整配置总价。
