sakuyaShining/FPGA-Music-project-internal/hardware/sourcing-closure-20261030/SCREEN-PRIMARY-FACTS.md

# J10厂家资料复核：已确认规格与订单配置缺口

候选仍为EastRising ER-TFTM070-5V4，RA8875，800×480，选FT5316电容触控、4线SPI、5V模块供电及预焊全配线；没有更换屏幕渠道或型号。

官方目录可查参数：[模块商品页](https://www.buydisplay.com/7-inch-lcd-module-capacitive-touch-screen-panel-i2c-spi-serial)、[模块数据表链接](https://www.buydisplay.com/download/manual/ER-TFTM070-5V4_Datasheet.pdf)、[FT5316触控面板页](https://www.buydisplay.com/7-inch-capacitive-touch-panel-with-controller-ft5316-for-800x480)。本轮模块页/手册直接读取遇到403，官方搜索索引仍能读取目录/手册节录；所以不声称已经逐页视觉核对新版孔位图。

官方目录给模块PCB外形180×104mm，模块5V供电时标注LCM最大300mA（3.3V模式480mA）；其接口列表包含4线SPI。单独ER-TPC070-6触控面板页列FT5316、164.5×99.6×1.5mm、2.8～3.3V、FPC连接。**完整模块5V电源不等于可以把裸FT5316触控电源/IO直接接5V。** 这些目录规格不能替代已选配置的厂家订单确认，也不能证明后插头对插后的总深度。

C88 R2源回读：J10.1为5V_PERIPH，2/12为GND；3/4/5为SCK/MOSI/MISO；6/7为显示CS/RESET；8/9为触控SDA/SCL；10/11为触控INT/RESET。U15 SPI/复位缓冲电源及U14触控侧电源均为3V3_PERIPH；需要厂家提供3.3V逻辑接口和触控线束适配。J10是12针控制接口，屏模块40针不能整条按同序插接；本轮没有厂家逐针端到端转接表，所以不能声称全线束已定。

厂家回填需同时满足：ER-TFTM070-5V4准确修订与FT5316触控照片、4线SPI出厂跳线、5V供电和3.3V逻辑、40针预焊朝向/针1照片、触控电源/I2C/INT/RESET完整引出、J10到40针及触控端逐针表、全部匹配配线长度与已对插高度、实际盖板/孔位/深度图、1套人民币含运总价、备货及发货日。收到配置报价前不按页面基础价买裸屏。未发询价消息，完整报价/交期仍为空。

450mm安装图中的180×104名义预留得到目录支持；最终孔位、盖板、插头弯线和装配总深度仍需完整配置图。当前不切壳，不把目录最大电流当整机全负载实测。电源精确嘉立创SKU与包含Nano和全部附件的电流预算还未闭合。
