sakuyaShining/FPGA-Music-project-internal/docs/02-技术方案/24-采购清单.md

# 采购清单（可移交版）

> 2026-10-05 更新 · 用途：**直接交给负责采购的同学**。
> **本清单包含开发板本体**（第零批）。2026-10-06 更正：此前写「Tang Nano 20K 已在手上」与事实不符——板子**尚未购买**，且它是最急的一项，没有它什么都开不了工。
> 数量与价格是按一个小项目的常规用量估的；同规格可买替代品，等价即可。
> 配套流程见 `16-板卡bringup一页卡片.md`（那张卡片讲"买到之后怎么走"，本清单讲"买什么"）。

---

## 第零批 · 开发板本体（最关键，先下这一单）

> 板子是我们目前**唯一完全空缺**的硬件。没有它，任何演示都无从谈起。

- [ ] **Sipeed Tang Nano 20K 开发板** ×1
      · **必须核对核心芯片型号：GW2AR-LV18QN88C8/I7**（18K LUT4）
      · 用途：整个项目的唯一目标平台
      · 跟店家说"Sipeed Tang Nano 20K 开发板"
      · ⚠️ **不要买 Tang Nano 9K**——那是 GW1NR-9，芯片不同、引脚完全不同，我们的约束对不上
      · ⚠️ 也不建议买 Primer 25K / Mega 60K：它们虽在官方便配板卡列表内，但我们的工程、引脚约束与全部验证结果都是为 20K 写的
      · 建议在 **Sipeed 官方店或授权店**购买，避免不同批次/克隆板的引脚差异

- [ ] **USB-C 数据线** ×2
      · 见第一批第 1 条（同一项，这里重申：必须是数据线）

**板子预算估算：约 70–150 元**（随渠道与是否含配件浮动）。

---

## 第零批补 · 触摸原型的独立读写工具（**原型必需，别漏**）

> 《29-触控原型验证程序》要求用**独立工具**读触摸芯片，这样实验不依赖我们尚未跑通的
> FPGA I²C 驱动。原清单漏了这件，2026-10-06 补上。

- [ ] **USB 转 I²C 适配器** ×1（CH341A 一类），或**树莓派** ×1（若手边已有）
- · 跟店家说「USB 转 I2C 适配器 CH341A 支持 I2C」
- · 用途：一个晚上回答那四个问题（模拟量可分几档、重复性、串扰、轮询周期）

## 第一批 · 立刻下单（bring-up 必需）

板子到手当天就要用到这些。**没有它们，板子只能亮灯，不能出声、也量不了电极。**

- [ ] **USB-C 数据线**（不是充电线！）
      · 数量 1–2 根，长度 1 m 左右
      · 用途：烧录与串口通信
      · 跟店家说"USB-C 数据线，支持数据传输"
      · ⚠️ 只有电源芯的充电线会导致"灯亮但电脑永远认不到板子"——这是已经付过代价的坑

- [ ] **小喇叭** 8 Ω 3 W（或 4 Ω 3 W）
      · 数量 1–2 个，带两根细引线
      · 用途：板载功放是单声道，接上即可出声
      · 跟店家说"8 欧 3 瓦 小喇叭，带线"
      · 备注：**先确认板上是否已有喇叭/扬声器焊盘**——若有，此项可省

- [ ] **逻辑分析仪** 8 通道（USB 版）
      · 数量 1
      · 用途：看 UART、I²S，以后看 I²C 时序；bring-up 阶段最省时间的一件
      · 跟店家说"USB 逻辑分析仪 8 通道 24MHz"
      · 备注：非严格必需，但强烈建议；16 通道更好，价差不大

- [ ] **杜邦线** 公对母、母对母
      · 数量：各 40 根
      · 用途：接喇叭、接电极、接线
      · 跟店家说"杜邦线 40 根一排，公母各一排"

- [ ] **面包板** 830 孔
      · 数量 1–2 块
      · 用途：电极前端临时搭建

- [ ] **万用表**（若手上没有）
      · 数量 1，需带通断与电容档
      · 用途：量电极电容、查通断

**第一批预算估算：约 60–150 元**（逻辑分析仪占大头）。

---

## 第二批 · 电极面板（决定"能不能玩"，可与第一批同时买）

- [ ] **铜箔胶带**（导电铜箔）
      · 数量 1–2 卷，宽 10–20 mm
      · 用途：做 16 个触摸电极
      · 跟店家说"导电铜箔胶带 单导 10mm"

- [ ] **洞洞板 / 亚克力板** 约 10×15 cm
      · 数量 1–2 块
      · 用途：电极底板与面板

- [ ] **1 MΩ 电阻** 1/4 W 金属膜（或 0603 贴片）
      · 数量 **100 只**
      · 用途：**每根电极外接一个**，把 RC 时间常数拉进计数区间
      · 跟店家说"1/4W 1MΩ 金属膜电阻 100 只"
      · 依据：电极的 RC 时间常数要落在计数器的量程内，否则要么分辨不出、要么计数封顶

- [ ] **22 pF 瓷片电容**
      · 数量 **100 只**，耐压 50 V 即可
      · 用途：与 1 MΩ 配对，构成电极的 RC
      · 跟店家说"22pF 瓷片电容 50V 100 只"

> 电阻电容按百只买，单价几分钱，坏一个不心疼。

- [ ] **细导线 / 漆包线** 0.3–0.5 mm
      · 数量 1 卷
      · 用途：电极引线

- [ ] **排针排母** 2.54 mm
      · 数量：排针几排、排母几排
      · 用途：接 27–42 号引脚

- [ ] **20P 排线 + 排母**（面板到控制器，做成可插拔）
      · 数量 2 套
      · 用途：把 16 根电极引线做成**可插拔的前端**——现在接 FPGA 直连（配合现有约束），
        将来若换成 I²C 触摸控制器，只需换个插头，**不必重新焊面板**
      · 跟店家说"16P 杜邦排线 母对母 20cm"+"16P 排母 2.54mm"
      · 说明：面板还没做，这是最便宜的一次架构对冲（几元钱）

- [ ] **电烙铁 + 焊锡丝**（若手上没有）
      · 数量 1 套
      · 用途：焊电阻电容与引线

- [ ] **LED ×10 + 限流电阻（220 Ω–1 kΩ）×20**
      · 用途：音域条每格一个指示灯，其余备用
- [ ] **细铜线 1 卷**
      · 用途：相邻触摸键之间的**接地隔离走线**（显著降低串扰，电容触摸的标准做法）

**第二批预算估算：约 40–80 元。**

---

## 第二批补 · 触摸控制器（**原型要早做，建议与第一批同下**）

> 2026-10-06 调整：原为「bring-up 之后选做」，但触控原型是**画 PCB 面板的前置条件**（见《29》），越早拿到数据越好，故提前。

## 第三批 · 输入扩展（bring-up 之后，选做）

> 这一批是为了"用专用触摸控制器（I²C）替代 16 根直连引脚"。
> **方案尚未最终决定**，但模块便宜，可以先买备用。

- [ ] **MPR121 电容触摸模块**（I²C 接口，12 通道）
      · 数量 **4 片**（合计 48 通道）
      · 用途：十几个音高键 + 7 个泛音键 + 余量
      · 跟店家说"MPR121 电容触摸模块 I2C 12 通道"
      · ⚠️ 四片需能设成不同 I²C 地址（0x5A–0x5D），请挑带 ADDR 焊盘/跳线的模块
      · ⚠️ 下单前核对数据手册：通道数、是否输出**基线补偿后的模拟值**、供电电压

- [ ] **4.7 kΩ 电阻**
      · 数量 10 只
      · 用途：I²C 的 SDA / SCL 上拉

- [ ] 备选（不买也行）：**74HC4067 模拟多路器模块** 16:1
      · 数量 1
      · 用途：**只解决引脚问题**的最省路线（约一元级），保留现有的自研测量逻辑

- [ ] **PCA9685 模块**（I²C 16 路 PWM LED 驱动）
      · 数量 1 片
      · 用途：面板指示灯（音域条 5 格 + 音高台阶），**不占 FPGA 引脚**
      · 跟店家说"PCA9685 16 路 PWM 舵机/LED 驱动模块 I2C"
      · 备注：属于 v1.1 项；模块十几元，可先买备用
- [ ] **面板用 LED ×20**（与板载同色，建议暖白或绿色）
      · 用途：音域条 5 颗 + 音高台阶 6 颗 + 备用
      · 限流电阻按 **1 kΩ**（FPGA 单脚驱动能力有限，别用 220 Ω）

**第三批预算估算：约 30–60 元。**

---

## 第四批 · 观感（有余力再买，答辩前）

- [ ] 亚克力板 / 木板 + 铜柱螺柱：做成一块能站稳的演奏面板
- [ ] 有源小音箱：现场音量比板载喇叭大得多
- [ ] 扎带、理线管：16 根引线不散乱

---

## 明确不用买

| 项 | 原因 |
|---|---|
| ~~开发板本体~~ | **更正：板子尚未购买，必须买**（见第零批）。原表此项作废 |
| 独立的 I²S DAC 模块 | 板载 MAX98357A 已够用；**只有需要立体声时**才考虑（板载是单声道） |
| 外购 MIDI 键盘 / 电子琴 | 属于"外购整机"，不算自研演奏形态 |
| 蓝牙模块 | 选做项。曲谱下载用现有串口已能演示，等有余力再上 |
| 各式电阻电容套装 | 只需要 1 MΩ 与 22 pF 两种规格，买套装反而浪费 |

---

## 采购时的四条提醒

1. **USB-C 线必须是数据线**——这条踩过坑，现象是"灯亮但认不到板子"
2. **喇叭的阻抗与功率**照 8 Ω 3 W 买即可；板载功放是单声道，买一个够用
3. **MPR121 那两片可以先买**，它不影响任何代码决定；但下单前核一眼数据手册
4. 若同一家店能凑齐，优先凑齐以减少运费与到货批次

---

## 与开发顺序的对应

| 批次 | 何时必须到货 | 对应工作 |
|---|---|---|
| 第一批 | 立刻 | 板卡 bring-up：连接、出官方测试音、烧我方码流、首批实测 |
| 第二批 | 同期 | 量 16 路电极的真实 RC 量程，决定前端取值 |
| 第三批 | bring-up 之后 | 触摸输入扩展（现有电极路径保留作兜底） |
| 第四批 | 答辩前 | 面板与观感 |

---

## 到货后第一件事：核对引脚（防止约束对不上）

板子到手当天，**先别焊任何东西**，拿这张表和板子/官方原理图核一遍。我们的约束文件是按这些脚写的（`src/constr/tdm_top.cst`）：

| 信号 | 引脚 | 说明 |
|---|---|---|
| clk | 4 | 27 MHz 晶振 |
| rst_n | 87 | 板上按键 S1（低有效） |
| 板载按键 S2 | 88 | 预留（八度档/设定模式） |
| led[5:0] | 20 / 19 / 18 / 17 / 16 / 15 | 共阳，低电平点亮 |
| pa_en | 51 | MAX98357A 功放使能（高有效） |
| dac_din / ws / bck | 54 / 55 / 56 | I²S 三线 → 板载 MAX98357A |
| uart_rx / tx | 70 / 69 | BL616 USB 串口 |
| pad[0..15] | 27–42 | 40P 排针：16 路触摸电极 |
| 空闲排针 | 48 / 77 | 预留给 I²C 的 SDA / SCL |

核对的三个重点：

1. **40P 排针是否把 27–42 全部引出**（16 路电极全靠它）
2. **板上有没有喇叭/扬声器焊盘**（有则不必买小喇叭；没有则必须买）
3. **48 与 77 是否也是空闲排针**（I²C 扩展要靠它们）

任何一项对不上，先停下核对官方原理图，不要直接焊线——引脚错位会导致"编译通过但板上没反应"这种最难查的问题。

参考来源：`src/constr/tdm_top.cst` 头注释（引脚全部来自官方例程，无一猜测）、`16-板卡bringup一页卡片.md`。
