sakuyaShining/FPGA-Music-project-internal/refs/素材库/课题要求覆盖清单.md

# 课题要求覆盖清单（逐条对表）

> 2026-10-01 · 原文来源：`refs/candidate-guides/gaoyun.txt` 第 245–294 行（高云选题二）
> **本表只按原文逐字判定，不做乐观解读。**

---

## 总览

| 类别 | 项 | 覆盖 | 状态 |
|---|---|---|---|
| **基础 1** | 多维交互控制检测 | **0%** | ✗✗ **完全空白** |
| **基础 2** | 纯硬件实时合成 + 延迟 ≤10ms | **~80%** | ⚠️ 通路完成，延迟未实测 |
| **基础 3** | 复音≥4 + 变调 + ADSR + 混音 + 禁预录 | **100%** | ✅ |
| **拓展 1** | 复音 ≥32 或 单音分量 ≥32 | **100%** | ✅ **超额** |
| **拓展 2** | ≥3 维表情 + 音色切换 + 效果器 | **~95%** | ✅ 三维表情运行时可写 + ✅ 4 音色实时切换 + ✅ **延迟/合唱/混响三件全部验收** |
| **拓展 3** | ≤5ms + 视听反馈 | **~55%** | ✅ 延迟内核侧 **0.104 ms（48× 余量）** + 确定性；✅ **LED 指引已实现验证**；缺图形显示 |
| **拓展 4** | 脱机 LED 指引 + 蓝牙 App | **~45%** | ✅ **片上曲目定序器 + LED 指路已实现验证**（E7）；缺蓝牙＋手机 App |
| **评分 1** | 振荡器统计规则 | **100%** | ✅ |
| **评分 2** | 吞吐量指标 | **100%** | ✅ |
| **评分 3** | 现场验证要求 | **覆盖** | ✅（一处需注意） |

**一句话**：**算法/引擎这条线很硬（三条评分规则全符合、拓展 1 满）✗
但「交互 + 表情 + 效果器 + 可视化」这一大片几乎空白 ✗**

---

## 一、设计要求（总纲，第 245–253 行）

| 原文要求 | 我们的状态 |
|---|---|
| 实现至少 **2 个独立可控演奏维度**的动作采集 | ❌ **空白** |
| 精准识别**选音、和弦、触发、拨弦**等演奏指令 | ❌ **空白** |
| 以 FPGA 为核心并行计算平台，硬件逻辑层搭建专属实时音频合成引擎 | ✅ 完成 |
| 采用波表/加法/FM/物理建模等任意合规算法 | ✅ **加法合成** |
| 对演奏控制信号进行**逐样本、逐声部**实时音频运算 | ✅ 逐样本 |
| 最终通过 **I2S 接口**输出至 DAC 解码发声 | ✅ **闭环已验证** |
| 具备高复音并发能力 | ✅ **32 复音** |
| **多音色切换** | ⚠️ 有 4 音色，**无切换通路** |
| **多维表情调控**特性 | ❌ 空白 |
| 严格控制演奏延迟 | ⚠️ **未实测** |
| 构建纯硬件实时**电子乐器**系统 | ⚠️ 纯硬件 ✓ 但"乐器"缺交互 ✗ |

---

## 二、基础要求（**必须项**）

### 基础 1 · 多维交互控制检测 —— **0%** ✗✗

| 原文 | 状态 |
|---|---|
| 自主设计演奏**交互形态** | ❌ |
| 基于各类**传感器**实现演奏动作精准采集 | ❌ |
| 支持**选音、触发、拨弦、力度感应**等操作 | ❌ |
| 具备**至少 2 个独立可控维度** | ❌ |
| 交互逻辑灵敏稳定，适配乐器演奏场景 | ❌ |

> **这是最严重的缺口** —— 它是【必须项】，而现在连第一步都没开始。

### 基础 2 · FPGA 纯硬件实时音频合成 —— **~80%** ⚠️

| 原文 | 状态 |
|---|---|
| 完整音频生成通路**全部基于 FPGA HDL 硬件逻辑**实现 | ✅ 无 CPU 参与 |
| 支持**逐样本**实时音频运算 | ✅ |
| 可采用任意合规算法 | ✅ 加法合成 |
| 控制信号到音频输出**总延迟 ≤10ms** | ⚠️ **理论可算，无板未实测** |
| **杜绝软件串行运算滞后**问题 | ✅ 纯硬件 |

**延迟的构成（架构上可算）**：
```
控制采样 → 音符事件 → note_map 装载 16 拍 → 待生效区（下个样本边界）
→ 流水线 LAT=4 拍 → 累加 → 输出锁存
→ I2S 一帧（32 BCK）
```
在 27 MHz 下：16 + 4 + 32 ≈ 52 拍 ≈ **1.9 µs** ✗ 加控制侧去抖（若 1 ms）✗ **总延迟约 1 ms，远低于 10ms** ✓
**⇒ 理论余量很大，但必须实测** ✗

### 基础 3 · 合规实时发声与多复音能力 —— **100%** ✓✓

| 原文 | 状态 |
|---|---|
| 基础复音数 **≥4**，四路及以上独立声部并发 | ✅ **32 路** |
| 所有输出音频由 FPGA 根据实时演奏指令**逐音、逐样本实时生成** | ✅ |
| 支持**单音实时变调** | ✅ 音符 → inc（全并行版另有 `reg_bank`） |
| **ADSR 包络调控** | ✅ 有（每泛音 D/S ✓ 全局 A/R ⚠️ 但 ADSR 完整存在） |
| **多声部实时混音** | ✅ TDM 累加即混音 |
| 严禁播放预录 PCM / 预置推流 / 整段录音触发 | ✅ **完全实时生成，可 RTL 佐证** |

---

## 三、拓展要求

### 拓展 1 · 超高规模并行合成引擎 —— **100%** ✓✓

> **2026-10-02 更新：从"只有综合证据"升级为"有功能证据"。**
> `tb_pitch_mod512` 在**出货配置**（NG=32 / PART=16 / NSLOT=512）下，
> 32 个声部的基频时隙相位增量**逐个精确等于** `note_inc.hex` 的期望值
> （**32/32**），FFT 旁证高音区 16 个基频均有能量（16/16）。
> 证据：`refs/素材库/步骤7_表情调制/512档/`。

| 原文 | 状态 |
|---|---|
| 复音数 **≥32** | ✅ **32**（已有功能证据：32/32 路基频逐个精确） |
| **或** 单音加法合成分量 ≥32 路 | ⚠️ 当前 note_map 是 16 泛音/音 ✗（可配 P=32×NG=16 → 单音 32 ✓） |
| 或 多条并行物理建模运算单元 | — 未采用 |
| 最大化发挥 FPGA 并行计算优势，提升振荡器整体吞吐量 | ✅ **24 000 000 osc·Hz（16 倍）** |

> **原文是"或"** ✗ —— 我们**满足"复音数 ≥32"这一支** ✓
> **答辩时应主打"复音 32"** ✓ 不要含糊地说"512 分量" ✗
> （512 是【总时隙数】，不是"单音分量" ✗ —— 这两个说法在评分规则下含义不同 ✗）

### 拓展 2 · 多维表情控制与音频效果处理 —— **~95%** ✅

> **2026-10-02 更新（两次）**
> ① 三维表情的【引擎侧】完成并验收（`refs/素材库/表情调制验收证据.md`）
> ② **运行时可写通路打通**：UART + `reg_bank` 接进 `tdm_top`，
>    颤音深度/速率、滑音时间、音色都变成**演奏时可改的寄存器**
>    （`refs/素材库/步骤9_运行时参数证据.md`）
> | 维度 | RTL 状态 | 验收判据 |
> |---|---|---|
> | 力度动态 | ✅ 装载时 `amp × vel`（原有） | 已有 |
> | **滑音** | ✅ 每音符 Q2.16 音高比偏移，指数衰减到 0；**时间常数可由寄存器改** | 轨迹 vs Python 镜像 **0/1399**；τ 实测 2806 / 343，比值 **8.19 ≈ 8** |
> | **颤音** | ✅ 全局三角 LFO × 深度；**深度与速率可由寄存器改** | 写 0/1000/2000 → 实测 **0.00 / 26.31 / 52.64 音分** |
> | **音色切换** | ✅ `PRESET` 寄存器 + 4 个音色表；引脚/寄存器可选 | 4 个预设 **16/16** 泛音幅度逐个精确 |
> | 比例性（不是加固定 Hz） | ✅ `ph_n = ph1 + eff_inc + ((eff_inc×poff)>>16)` | 谐波比 **16.00000~16.00021** |
> | 关闭时回归 | ✅ 默认全关，`poff≡0` → 逐位不变 | R0 **0/2495** 不变 |
> **仍缺**：交互层的操控通路（与基础 1 是同一件事，但寄存器通路已就绪）；
> **效果器（混响/延迟/合唱）完全空白** ← 下一步 E4。

| 原文 | 状态 |
|---|---|
| 搭建 **≥3 维**演奏表情调控逻辑 | ⚠️ **引擎侧 3 维已实现**（力度 + 滑音 + 颤音），缺交互层 |
| 支持**力度动态** | ⚠️ `note_map` 有 velocity 输入 ✓ 但无输入通路 ✗ |
| 支持**滑音** | ✅ RTL 已实现并逐样本验收 |
| 支持**颤音** | ✅ RTL 已实现并验收（深度/速率目前是编译期常量） |
| 支持 **≥2 种乐器音色自由切换** | ⚠️ **有 4 音色，无切换通路** ✗ |
| FPGA 硬件内部实现**混响、延迟、合唱**等效果器 | ✅ **三件全部实现并验收**（冲击响应判据：回声间距/幅度逐个精确、合唱三角起伏、混响尾巴 309 个回声/单调衰减/不失控）（`refs/素材库/步骤11_效果器证据.md`） |

### 拓展 3 · 极致低延迟与实时视听反馈 —— **~30%** ⚠️

> **2026-10-02 更新：延迟这一半已有实测证据**（`refs/素材库/步骤8_延迟证据.md`，第二轮重测）
> | 项 | 结果 |
> |---|---|
> | 端到端最坏（音符事件 → DAC 输入端样本） | **2807 拍 = 0.104 ms**（对 ≤5 ms 余量 **48×**） |
> | 抖动 | **0**：同相位两遍逐拍一致；相位依赖是**闭式** `t = t0 − ph + 512·[ph+18>511]` |
> | 零抖动的结构性依据 | 晶振直连无 PLL、整数分频（÷16/÷32）、静态时分调度、无 CPU/中断/cache |
> **仍缺**：控制侧（传感器/去抖/USB）延迟要上板用示波器测；MAX98357A 群延迟未计入；可视化基本空白。

| 原文 | 状态 |
|---|---|
| 延迟压缩至 **≤5ms** 且**确定性无抖动** | ⚠️ **内核侧已实测 0.075 ms 且确定性**（67× 余量）；控制侧待上板实测 |
| 基于 FPGA 硬件逻辑实时生成**可视化反馈**：LED 演奏指引 / 李萨如图形 / 实时频谱 / 波形显示 | ⚠️ **LED 演奏指引已实现并仿真验证**（`refs/素材库/步骤12_定序器与LED证据.md`）；图形显示未做（需 LCD 接线，与交互层争引脚） |

### 拓展 4 · 智能联动与脱机拓展 —— **0%** ✗

| 原文 | 状态 |
|---|---|
| **脱机演奏 LED 曲目指引** | ✅ **已实现并验证**：片上曲目定序器（15 步曲谱烧在 RTL 里）→ 音符事件时间戳与曲谱**逐条精确**、速度由寄存器控制（拍间隔比 10.00）、LED 指路序列与曲谱一致、集成实测 8 次起音/7 次收音（`步骤12_定序器与LED证据.md`） |
| 蓝牙模块 + 手机 App 联动（曲谱下载 / 键位自定义 / 录音回传） | ⚠️ **FPGA 侧协议已就绪并验证**（UART 发送 + 寄存器回读 + **曲谱下载**，`refs/素材库/步骤13_E8串口协议证据.md`）；**蓝牙模块与手机 App 内核收不下** |

---

## 四、核心评分规则（**这三条我们全符合** ✓✓✓）

### 评分 1 · 振荡器统计规则 —— **100%** ✓

> 原文：「独立发声单元为包含**独立相位累加器、频率调控、包络控制**的完整振荡器；
> 加法合成按**运算分量**统计」

**逐项核对我们的 TDM 时隙**：
| 要求 | 我们 |
|---|---|
| 独立相位累加器 | ✅ `phase_mem[slot]` 每槽一份 |
| 频率调控 | ✅ `inc_mem[slot]` 每槽一份 |
| 包络控制 | ✅ `env_mem/stg_mem/epar_mem` 每槽一份（**含逐泛音衰减速率与终点**） |
| 按运算分量统计 | ✅ **512 个运算分量** |

**⇒ 完全符合** ✓ 而且**逐泛音包络比"仅每音一份"更严格** ✓

### 评分 2 · 吞吐量指标 —— **100%** ✓

> 原文：「以「同时活跃可闻独立振荡器总数 × 实际音频输出采样率」为核心评分依据，**过采样不叠加加分**」

```
512 振荡器 × 46875 Hz = 24 000 000 osc·Hz
```
**⇒ 未使用过采样** ✓ 数字干净 ✓

### 评分 3 · 现场验证要求 —— **覆盖** ✓（一处需注意 ⚠️）

| 原文 | 状态 |
|---|---|
| 支持**测试模式**下输出多路不同频率音频 | ✅ `test_mode` 已实现 |
| **频谱可观测对应数量独立谱峰** | ⚠️ **见下** |
| 可通过 **RTL 代码佐证**纯硬件实时合成通路 | ✅ 无 CPU、无预录 |
| 验证无预录音频播放行为 | ✅ |

**⚠️ 需要注意的一处**：`tdm_top` 的测试模式装载 **512 个时隙** ✗
→ 频谱仪上会出现 **512 个峰** ✗ **现场很难数清** ✗
**⇒ 建议测试模式提供"稀疏档"** ✗（如 32 峰 ✓ 便于现场计数 ✓ 而 512 由 RTL 与仿真数据佐证 ✓）

---

## 五、结论与优先级

**强项（可作答辩主线）**：
1. ✅ **三条核心评分规则全符合** —— 振荡器定义、吞吐量口径、现场验证
2. ✅ **拓展 1 达成**（复音 32 / 24M osc·Hz / 16 倍）
3. ✅ **基础 3 满分**（复音、变调、ADSR、混音、禁预录）
4. ✅ **证据链硬**：逐位一致（含完整起音段）、时序 0 违例、引脚核查、表初始化验证

**弱项（必须补）**：
1. ❌ **基础 1 = 0%** —— **必须项** ✗ **优先级最高**
2. ❌ **交付物 0%** —— 报告 / 视频 / 答辩 ✗ **硬性提交物**
3. ❌ **拓展 2/3/4 几乎空白** —— 加分项

**建议顺序**：
```
① 基础 1：交互层（形态 + ≥2 维 + 选音/触发/拨弦/力度）
   └ 顺带把 vel / glide / vib 三个维度接到传感器上 → 基础1 与 拓展2 一起收
② 交付物：报告 / 视频 / 答辩
③ 拓展 2：音色切换通路（preset 寄存器）
④ 拓展 2：效果器（混响/延迟/合唱）
⑤ 拓展 3：可视化（LED 指引 / 频谱显示）
⑥ 拓展 4：脱机 LED 曲目指引
```

**④⑤⑥ 都要在板子到手后才有实测意义** ✗ —— **①②③ 现在就能推进** ✓

---

## 更新记录（2026-10-02 各轮）

| 轮次 | 收下的内容 | 关键证据文件 |
|---|---|---|
| 第 3 轮 | 512 档滑音/颤音 + **32 复音功能证据** | `步骤7_表情调制/`、`表情调制验收证据.md` |
| 第 4 轮 | **运行时参数通道**（UART→寄存器→引擎）：颤音深度/速率、滑音速率、音色 | `步骤9_运行时参数证据.md` |
| 第 5 轮 | 出货配置修正（周期=时隙数，修掉 slot 回卷 bug）+ 滑音线性化（省 5591 LUT） | `步骤10_出货配置修正与LUT回收.md` |
| 第 6 轮 | **E4 延迟 + 合唱**（冲激响应判据）+ 旁路等价性 | `步骤11_效果器证据.md` |
| 第 7 轮 | **E7 曲目定序器 + E6 LED 指引**（含共阳极极性修正） | `步骤12_定序器与LED证据.md` |
| 第 8 轮 | **E8 FPGA 侧协议**：UART TX + 寄存器回读 + 曲谱下载 | `步骤13_E8串口协议证据.md` |

**⚠️ 余量提示（写进报告里）**：加 E8 后 Logic 已到 **59%**，SETUP slack 一度掉到 **+0.105 ns**
（利用率挤到布线延迟）。加一级事件流水后回到 **+1.208 ns**。
**再加功能前必须先跑 PnR 看时序** —— 这是本轮的教训。
| 第 9 轮 | **E4 混响**（单线多抽头反馈）→ **E4 三件全部收下**；BSRAM 优化（100% → 64%） | `步骤11_效果器证据.md` |
