sakuyaShining/FPGA-Music-project-internal/hardware/delivery-baselines/20261029-r2-s1/WHOLE-MACHINE-PURCHASE-AND-ASSEMBLY.md

**2026-10-29 基线复核更正：传感板暂停投产。** 实际S1 Gerber底层地铜到22个非地排针焊盘最小间距约0.162858mm，低于保留门限0.1651mm；此前原生DRC0、5μm图形比对与较低通用门限未覆盖该严格条件。可继续询价，先不按本版传感板付款生产。旧冻结包字节保留用于追溯，不能据其中的PASS或READY文字忽略本更正。详见基线`evidence/retained-clearance-gate-audit.json`。

# 整机采购、安装与验收步骤（2026-10-29）

适用版本：Control88 R2（PCB 733e1d9c…）×1，Sensor14Bank S1（PCB 2184d027…）×6，已有 Tang Nano20K，单块 J10 屏幕。制造源已冻结，可送厂 DFM/SMT 审单；尚未取得整机全部物料报价及样机验收。

本说明不更改冻结制造包。送厂入口：`factory-handoff-20261029/README-先读.md`。当前38种料号、256净件只覆盖7块定制板，不能当作包含屏幕、线材、外壳的整机购物车。

## 1. 今天先同时发起三件事

1. 将统一包交厂家，按两种设计分别审单报价：Control88装配成品1块，Sensor14Bank装配成品6块。全部232件SMT由厂家完成，24件插件优先一并预焊。不要购买256件散料后自行贴片。
2. 向屏幕厂家确认ER-TFTM070-5V4完整配置：7英寸800×480、RA8875、4线SPI出厂配置、5V供电、FT5316电容触控、预焊40针、触控接口/线缆、匹配连接器、含运总价和发货时间。要求照片、针脚表、跳线配置及触控电平说明。页面基础价不能替代完整报价。
3. 固件队友按`FIRMWARE-INTERFACE-HANDOFF.md`修正/验证RC扫描语义，并继续屏幕、EEPROM、资源与整机回归；板厂制造期间同步推进。

## 2. 将采购分成以下订单

|项目|数量/口径|购买或准备方式|当前状态|
|---|---|---|---|
|Control88 R2|1块装配成品|嘉立创制板+SMT，插件/排母预焊另列|文件已就绪，待厂家审单报价|
|Sensor14Bank S1|6块装配成品|嘉立创制板+SMT，两根1×16排针/板预焊|文件已就绪，待厂家审单报价|
|Tang Nano20K|已有1块|检查实物版本、排针、下载USB线|不重复买开发板|
|7英寸触摸屏|1套|仅此项允许厂家官方店渠道；按上节完整配置|尚缺最终配置报价/交期|
|控制板到传感板线束|6条，每条16芯|2.54mm单排1×16母座对母座，按1→1核线；长度按实际结构|需要精确商品或定制报价；不是2×8 IDC|
|电极引线组件|84路独立信号|适配六个J1单排1×16；每板14个电极信号，另两脚GND|长度、端接及具体商品待定|
|电极材料|净84个电极区域，另留试片|铜片/铜箔、绝缘底板、覆盖膜、背面固定与引线应力释放；立创/嘉立创渠道找料或询定制|尺寸、间距、膜厚需先做单音位验证|
|J10屏幕转接线|1套|控制端1×12、屏端40针及触控连接按信号适配，能预制则预制|端到端成品线定义仍待屏幕实物配置确认|
|电源与线|按两支路配置|稳压5V方案，Nano USB-C支路+J13两针XH支路；线径/端接/容量按实际总负载与压降核定|具体SKU与总负载、限流验证未闭合|
|音频输出附件|1套|J12三线到可靠固定的3.5mm立体声插座，再接已有有源音箱/功放的线路输入|插座候选C19189087并非已接线成品，针序与固定需核验|
|TF卡|按固件实际支持采购1张|使用Nano20K板载槽，不额外买通用TF模块；容量/格式/文件内容先与固件确认|具体SKU/格式尚未冻结|
|结构/耗材|按最终布置|绝缘底板、支撑柱/螺丝、标签、热缩管、扎带、覆盖膜、旋钮帽|孔位、长度与型号待实物布置确认|
|调试工具|借用或已有优先|万用表、可调限流电源；示波器或逻辑分析仪用于RC/总线验收|不为演示重复购买整套工具|

当前Control88已包含PCM5122及滤波，不重复购买旧清单里的PCM5122 HAT/WM8960音频模块。J11第二块屏幕已取消。不要采购旧的951针载体工程。

## 3. 付款前完成报价闭环

1. 厂家回传DFM及贴装预览，确认PCB版本、芯片1脚、旋转、排针/排母方向、拼板工艺边以及任何替代料。
2. 说明所需成品1+6，裸板最低投板数与实际贴装数分别列出。多做的裸板不自动增加SMT数量。
3. 使用各板单板BOM与单板CPL；不要把总量表配给某一块板，也不要重复乘六。主钻孔已含过孔，Via.DRL为子集，不重复计孔。
4. 报价包括板费、料费、贴装、钢网/上料、插件预焊、税运与加急。按SMT供料核价，不因零售整卷MOQ直接购买两万只电容；替代料需回传具体型号/位号，工程核对后更新源及文件。
5. 合计：PCB+器件+SMT/预焊+屏幕+电源+线束+电极+结构+音频/存储附件+全部运费≤700元。尚未取得能保证满足上限的全套实价，付款前核算；不超支后再拆分付款。
6. 取得明确发货日和运输时效后再排安装日期；11月1日到货为目标，尚无承诺。

## 4. 等板期间准备

- 在纸面/绝缘底板上试排屏幕、100×100mm控制板、六块55×45mm传感板及25个音位，保留USB、TF、插头和螺丝操作空间。结构尺寸未冻结前不订不可返工的成品外壳。
- 传感板尽量靠近其电极，减少高阻电极线长度；长距离优先放在板间数字线束。具体长度需测试后确定。
- 电极先制作一个音位A/中/B三片，互不导通，预留可更换覆盖膜和引线；验证后再重复制作剩余音位。
- 按`ELECTRODE-HARNESS-84-VERIFIED.csv`生成双端标签；六板标B0至B5，不能为了接线方便更改通道或并接SENSE。
- 固件交付应含明确源码版本、CST、数据表、可重建工程、码流哈希、烧录步骤及测试模式。现有Q4码流能构建不等于已完成产品固件。

## 5. 到货后先做断电验收

1. 核对数量、PCB版本、器件型号、芯片1脚、排针朝向和焊接质量，拍正反面照片留档。
2. 空载逐板测电源对地，观察电容充电变化，不以蜂鸣器瞬响直接认定短路；持续近零阻需先排查。
3. 测六条J2线束每一针1→1，无交叉/短路。单排连接器翻面会反序，线色不作为针号证据。
4. 核对屏幕5V与SPI出厂配置、触控IC及线缆，按厂商针号检查J10转接线；控制板12针不等同于屏幕40针。
5. 核对已有Nano版本与排针方向，插入J5/J6时两排完整对齐，无错位一针；禁止带电插拔。

## 6. 按供电阶段调试，先不接屏幕和全部传感板

冻结源回读：J13.1=5V_IN、J13.2=GND。J5.1（Nano5V位置）在控制板上未连接，所以J13不能单独给Nano供电。Nano通过USB-C供电，J13为外设电源支路，两者通过板上GND共地。若用同一5V电源分支，应由正确线束分配；连接电脑下载时避免向Nano USB同时接第二个5V源。

1. 先独立确认Nano能由下载USB正常识别、烧录基础测试。
2. 拔掉电源，把Nano按正确方向插入控制板，仅保留主控，无屏幕/传感板/音频负载。先由限流电源在工程人员监测下分阶段检查J13的5V保护链。
3. Nano供电后确认3V3_IO。注意U17外设开关由3V3_IO使能，Nano未供电时5V_PERIPH等下游电源关闭不必然是故障，不能短接保护器件强行供电。
4. 外设供电使能后依次测5V_PERIPH、3V3_PERIPH、DAC_3V3，检查电源故障信号、异常电流和温升。限流值按当前阶段负载预算设置，不直接用整机大电流限值掩盖短路。
5. 有异常立即断电定位；在电源稳定前不接屏幕和六板。

## 7. 一块传感板、一个音位先跑通

1. 断电连接Control88 JB0到B0的J2，1→1；J2.1仅3.3V，J2.2及偶数脚为GND。J2.5的SENSE_OUT只接JB0.5，不能与其他板的SENSE并联。
2. J2针号：1=3V3_IO，3=RC_DRIVE，5=SENSE_OUT，7=ADDR0，9=MUX_DISABLE，11=ADDR1，13=ADDR2，15=ADDR3；2/4/6/8/10/12/14/16=GND。
3. 先运行诊断扫描，不先运行完整演奏固件。MUX_DISABLE高断开、低接通；RC_DRIVE低放电，反相SENSE为高；RC_DRIVE高开始充电，测SENSE高→低的时间。等待放电完成，处理超时，不能把初始高电平当完成。
4. 先核对CH14/CH15板上10pF/100pF参考通道有可重复响应，再依电极映射接一个完整音位的A/中/B，记录未触摸、触摸及滑动数据。两参考通道的读数还受寄生影响，不要求等于标称电容比。
5. 试验电极尺寸、间距、引线、覆盖膜，直到能稳定区分触摸与空闲、可用位置变化且无持续误触，再冻结机械配置。电容电极测接触/接近及面积变化，不是真实按压力传感器。

## 8. 扩成六板并安装全部电极

1. 每次断电新增一板，依次B0至B5；各板校准通道先检查，再测对应14路外接通道。
2. 制作25音位×3=75个音位电极、5个八度电极、4个备用，共84个；每片单独引线，互不导通。
3. 每板J1的1至14为14路电极；15/16为GND，不接成额外触摸电极。按84行已核表接线，C5三电极跨B0/B1/B2的CH12，不自行重排。
4. 线束固定、焊点绝缘、双端标签，保证传感板背面不接触导电底板。支撑位置按实际孔位确定，不钻伤铜层。
5. 完整核对84路无遗漏/重复，建立各路基线与阈值；测试相邻串扰、多指、空闲漂移，以及屏幕/音频运行时干扰。

## 9. 再加入屏幕、音频与存储

1. 断电接J10。控制侧针表：1=5V_PERIPH，2=GND，3=DISP_SCK，4=DISP_MOSI，5=RA_MISO，6=DISP_HARM_CS_N，7=DISP_RESET_N，8=I2C_MOD_SDA，9=I2C_MOD_SCL，10=TP_INT_MOD，11=TP_RESET_MOD_N，12=GND。屏端40针及触控端必须按厂家资料对应；此处未提供已冻结的屏端映射，不盲接。
2. 顺序测试屏复位、RA8875显示、FT5316读回、触点坐标及方向，然后测试刷屏时扫描无丢键/乱键。屏幕、595、165存在共享总线，必须验证仲裁，不能只测单模块。
3. J12.1=AUX_L、.2=AUX_R、.3=GND。先测静态输出与测试音，再接有源音箱/功放线路输入，低音量开始。PCM5122是线路输出，不直接推无源喇叭或普通低阻耳机；需要耳机则另加适合的耳放方案。
4. 接音频附件后测左右声道、静音/恢复、音高及同时刷屏/扫描时的噪声。测A4=440Hz等已知音高，确认实际加载修正后的数据表。
5. 在固件支持的容量/格式确认后准备TF卡与数据；验证录放流程。EEPROM单独测试写入、读回、断电保存，再接应用/保存/取消；不将“板上有存储芯片”当作软件已完成。

## 10. 固定装机与最终交付

所有基础功能通过后再收拢线束、固定屏幕和PCB、保护电极背面焊点并装覆盖层。布局、引线或覆盖层改变后重新标定。

验收逐项记录：

- 25音位的A/中/B映射、5个八度、4个备用、12个校准通道；
- 单音、多音、连续滑动、松手无卡音、长时间空闲无误触；
- 表情、触后与四槽等目标功能逐项实测，不能由电极硬件直接推定已实现；
- 触屏/按键/编码器、音色操作、应用/保存/取消、断电保留；
- 音频双声道、音高、录放及共享总线并发；
- 多次上电复位、完整负载供电压降与温升，观察持续运行稳定性；
- 留存最终接线照片、每板编号、固件版本/哈希、校准数据、实际采购支出及演示视频。

## 当前仍需关闭的事项

板子制造资料已就绪。仍待厂家DFM/SMT预览、正式费用/交期；屏幕完整配置报价；J10端到端转接线；电源/电极/线束/结构/音频插座/TF卡的精确采购项和全套700元预算；固件扫描、屏幕和存储等整机接合；样机实测。

这些项目可与制板并行推进，但不能被“DRC为0”代替。当前最先执行的是送两板审单、向屏厂家确认完整配置，以及让固件队友按已核接口继续工作。

参考：
- EastRising官方商品：https://www.buydisplay.com/7-inch-lcd-module-capacitive-touch-screen-panel-i2c-spi-serial （本轮搜索索引可读；直接中文页403，未取得最终配置报价）
- Sipeed Nano20K官方资料：https://dl.sipeed.com/fileList/TANG/Nano_20K/1_Datasheet/Sipeed%20Tang%20nano%2020K%20Datasheet%20V1.3-en_US.pdf
- TI PCM5122官方数据手册：https://www.ti.com/lit/ds/symlink/pcm5122.pdf
- 本地冻结接口独立回读：sensor14-final-20261029/INSTALL-CONNECTORS-READBACK.json
