sakuyaShining/FPGA-Music-project-internal/fpga/current/upstream-notes/BOM-PROTOTYPE-20261022.md

# 可直接下单的原型采购清单 · 2026-10-22

回答两个问题：
**① 有没有可直接买来组装的清单？** —— 有。基于 88 号 BOM（23 项，大部分已核价）裁剪。
**② 要不要等 PCB？** —— **不用等。** 原型阶段左手电极可以直连 FPGA，PCB 上最贵的那批器件正好都不需要。

---

## 0. 为什么不用等 PCB

关键在左手电极的物理接口。`pad_scan.v` 第 2 行原文：

> **16 路电容触摸扫描（无 ADC，纯数字 RC 计时）**

第 87 行：

```verilog
assign pad = pad_drv_en ? {NCH{1'b1}} : {NCH{1'bz}};   // inout 电极：充/放/读同一根线
```

**电极是 inout，充电、放电、读回都在同一根线上，靠 FPGA 内部弱下拉 + 电极自身电容做 RC 计时。**
所以 16 路电极**直接接 GPIO + 铜箔就行，不需要任何外部模拟前端**。

而 88 号 BOM 里那批器件（74HC4067 ×6、施密特、ESD、0402 阻容）属于
`rc_mux_scan.v` 那条 **83 节点**的扩展路线——用 MUX 把 96 路压进 6 根线。
**原型只做 16 路，这条路线整个用不上。**

> 代价：`pad_scan.v` 注释也写明「内部下拉电阻与电极电容都未知 ⇒ 必须先量出裸计数落在哪，
> 否则可能太快（分辨不出）或计数器封顶（永远摸不着）」。
> 所以上板第一件事是调 `CHARGE` 参数，用 `dbg_raw_sel` 逐根量。这个不花钱，但要花半天。

---

## 1. 今晚能买（不等 PCB）

### 1.1 必需

| # | 件 | 规格 | 数量 | 参考价 | 用途 |
|---|---|---|---:|---:|---|
| 1 | **7 寸电容触摸屏** | **ER-TFTM070-5V4**：RA8875、800×480、**4 线 SPI**、**电容触摸 FT5316**、5V/3.3V | 1 | ¥280 起 | 右手泛音推子 |
| 2 | 导电铜箔胶带 | 宽 10 mm，带背胶 | 2 卷 | ~¥30 | 左手 16 电极 |
| 3 | 亚克力板 / 洞洞板 | 300×200 mm | 2 | ~¥40 | 面板 + 底板 |
| 4 | 杜邦线 | 公对母、母对母 | 各 1 排 | ~¥20 | 接线 |
| 5 | 排针 | 2.54 单排、双排 | 若干 | ~¥10 | |
| 6 | USB-C 数据线 | **数据线，不是充电线** | 2 | ~¥20 | 烧录 + 串口 |
| 7 | 5V 电源适配器 | 2 A | 1 | ~¥20 | 整机供电 |
| | **小计** | | | **≈ ¥420** | |

### 1.2 强烈建议加购

| # | 件 | 规格 | 数量 | 参考价 | 为什么 |
|---|---|---|---:|---:|---|
| 8 | USB 转 I²C 适配器 | CH341A 或同类 | 1 | ~¥15 | **到货先单独读屏的触摸 IC**，确认是 FT5316 还是 GT911，再决定写哪个驱动 |
| 9 | EC11 编码器 | EC11E183440C（30 定位/15 脉冲，**带按压开关**） | 1 | ¥15.56 | 八度/参数旋钮。注意 C470754 无按压，不可用 |
| 10 | 轻触按键 6×6 | | 6 | ¥1.80 | 4 预设 + 1 编辑 + 备 |
| 11 | 旋钮帽 6 mm | 配 EC11 轴 | 1 | ¥3.00 | |
| 12 | microSD 32GB C10 | | 1 | ¥30.00 | 板载卡座复用（录放后补） |
| | **小计** | | | **≈ ¥485** | |

### 1.3 三个采购陷阱

1. **不要买 SSD1963 的屏。** 项目里 RA8875 渲染器已经写好并实测
   （−628 Logic、空 CLS 11→48、路由从 FAIL 变 PASS）。买错屏 = 同时丢掉"显示"和"时序收敛"两条路。
2. **ER-TFTM070 有多个配置版本**，必须指定「**4 线 SPI + 电容触摸**」。基础版是电阻触摸或无触摸。
   BOM 里 ¥280 的状态是「厂家 US$40.18 起，**待询国内含运价**」，电容触摸是加价选项，
   实际到手可能 ¥300–350，不要按 280 做预算。
3. **左手不需要任何触摸 IC**，别被"电容触摸"四个字带偏去买模块。

---

## 2. 必须等 PCB（原型阶段可省）

| 件 | 数量 | 单价 | 小计 | 为什么原型能省 |
|---|---:|---:|---:|---|
| 74HC4067PW,118 | 6 | 2.89 | 17.34 | 83 节点扩展 MUX；原型 16 路直连不需要 |
| SN74LVC14ADR | 5 | 1.4573 | 7.29 | 施密特整形；直连方案不需要 |
| SN74LV595ADR | 1 | 3.16 | 3.16 | 扫描移位输出 |
| SN74LV165ADR | 5 | 2.1232 | 10.62 | 扫描移位输入 |
| 24LC256-I/SN | 1 | 4.50 | 4.50 | 存乐器参数；原型用默认参数 |
| TPD4E02B04DQAR-TP | 25 | 0.7486 | 18.72 | ESD 保护 100 路；原型可省，**但手别直接摸电极焊盘** |
| 0402 阻容（1k/47k/220Ω/1nF/100nF） | — | — | 2.90 | 需要 PCB 焊盘 |
| **两轮打样** | 2 | 50 | 100.00 | 手工原型不需要 |
| **SMT 选择性装配** | 1 | 60 | 60.00 | 同上 |
| 结构（覆盖膜/底板/铜柱） | 1 | 40 | 40.00 | 用亚克力代 |
| 运费 | 1 | 30 | 30.00 | |
| **小计** | | | **≈ ¥288** | |

**所以：全 BOM ≈ ¥653，原型 ≈ ¥420–485。省下的正好是 PCB 那一批。**

---

## 3. 不在清单里、但要提前想清楚的两件

### 3.1 双屏在 11-04 前做不了

产品规格是双屏（RA8875 出推子/编辑，ILI9341 出可视化）。但 CLS 现在 99.6% 满，
第二块屏要再加渲染器逻辑，**面积上放不下**。

**11-04 前只做单屏（RA8875）。** 可视化这一路要么砍，要么用上位机渲染后投到同一块屏上。

### 3.2 音频输出

Tang Nano 20K 板载功放 + 喇叭已实测能出声（73 号文档，SHA256 `7384acdf…`），
**不需要额外功放**。

如果要线路输出到有源音箱，BOM 里的 PCM5122（¥19.87）+ 3.5 mm 插座（¥2.00）+ DAC 外围（¥6.00）
共约 ¥28，可以后补。**视频拍摄用板载喇叭就够。**

---

## 4. 下单时的一句话总结

> 买：**ER-TFTM070-5V4（4 线 SPI + 电容触摸版）**、铜箔胶带、亚克力板、杜邦线排针、USB-C 数据线、5V 电源，
> 加 CH341A、EC11、轻触按键、microSD。
>
> 不买：74HC4067、施密特、595/165、EEPROM、ESD、0402 阻容——**这些等 PCB**。
>
> 不等 PCB 就能搭出一台能演的桌面原型。

---

## 5. 复现命令

```bash
# 左手是 FPGA 直扫，不需要外部前端
sed -n '1,5p;85,90p' candidate_source/engine/src/pad_scan.v

# 完整 BOM
cat docs/02-技术方案/88-硬件选型BOM表-2026-10-19.csv   # 在分支 codex/wb-20261019
```

（路径前缀：`D:/FPGA-Project/codex-deliverables/fpga-agent-handoff-20261022-v1/`）
