sakuyaShining/FPGA-Music-project-internal/hardware/electrode-fullpanel-cam-20261030/Electrode84-NATIVE-BOM.csv

No. | Quantity | Comment | Designator | Footprint | Value | Manufacturer Part | Manufacturer | Supplier Part | Supplier
1 | 6 | PZ254V-11-16P | JB0,JB1,JB2,JB3,JB4,JB5 | HDR-TH_PZ254V-11-16P |  | PZ254V-11-16P | XFCN(兴飞) | C22465876 | LCSC
