sakuyaShining/FPGA-Music-project-internal/hardware/current/module-plan/manufacturing/sensor-BOM-per-board-DRAFT.csv

Comment | Designator | Footprint | LCSC Part # | Quantity_per_board | Quantity_six_boards | Assembly
0603WAF2200T5E | R2 | 0603 | C22962 | 1 | 6 | factory SMT
74HC4067PW,118 | U1 | TSSOP-24 | C179326 | 1 | 6 | factory SMT
CL10B104KB8NNNC | C1,C2 | 0603 | C1591 | 2 | 12 | factory SMT
CL10C100JB8NNNC | C3 | 0603 | C1634 | 1 | 6 | factory SMT
CL10C101JB8NNNC | C4 | 0603 | C14858 | 1 | 6 | factory SMT
PZ254V-11-16P | J1,J2 | 插件,P=2.54mm | C22465876 | 2 | 12 | factory TH preferred; user may solder headers
RC0603FR-071KL | R10,R11,R12,R13,R14,R15,R16,R3,R4,R5,R6,R7,R8,R9 | 0603 | C22548 | 14 | 84 | factory SMT
RC0603FR-0747KL | R1 | 0603 | C105579 | 1 | 6 | factory SMT
SN74LVC14ADR | U2 | SOIC-14 | C133541 | 1 | 6 | factory SMT
TPD4E02B04DQAR | D1,D2,D3,D4 | USON-10(1x2.5) | C106794 | 4 | 24 | factory SMT
