sakuyaShining/FPGA-Music-project-internal/docs/02-技术方案/21-验收判据清单.md

# 验收判据移交清单（→ · 离线期执行手册）

> 2026-10-02 · 因额度离线前交付。本文保留验收配方；其中的阶段状态与后续实现进度可能不同步。
> 本文件给出判据全集与配方；各项的当前完成状态以回归结果和硬件验收为准。
> 配套工具：`tools/scripts/regress_all.py`（回归入口）。

---

## 1. 闸口覆盖声明（当前回归为快速 12 套、全量 29 项；全绿不等于全都验过）

**闸口覆盖**：加法引擎逐位一致 / 时钟链 / 包络状态机 / I2S 闭环 / 多声部 / 测试模式 / 变调 /
定序器 / 运行时参数与旁路 / 效果器冲激响应 / TDM 黄金参考（--full 加 8 掩码×双配置 + F1 栅格）/
**力度→谱形单元（13）与力度→音色 + 独立亮度轴端到端（14）**。

**2026-10-06 新增套件（走同一条 `copy_data()` 取表）**

| 套件 | 判据 | 验什么 |
|---|---|---|
| `13 vel shape` | V1–V9 | 力度→谱形**单元**：基音不消失 / 最少 3 条 / 谱心单调 / 恒等 / **灵敏度只缩放偏差** |
| `14 vel timbre` | J1–J4 | 力度→音色**端到端**（穿 tdm_top）：恒等 / 变亮 / 下限 / 条数 |
| `14 vel timbre` | L1–L6 | 独立亮度轴 `0x5C`：单调 / 恒等点逐位相同 / 最暗不静音 / 动态范围 / 跨预设 / 可复现 |

> **这两套的运行期依赖**：`vel_wtab.hex`、`tilt_wtab.hex` 等 6 张表必须落在**运行目录**里。
> 缺表 ⇒ `$readmemh` 失败 ⇒ 音频全 X ⇒ 判据崩成 traceback。
> 现在由 `regress_all.py` 的唯一入口 `copy_data()` 负责，**缺表直接让闸口红并说明缺哪一张**。
> 试听/调音用 `python tools/scripts/vel_audition.py`（一条命令出 wav + 对照报告）。

**闸口不覆盖**（全绿也不代表这些过了）：
-**任何 PnR 时序**——闸口是纯仿真；改 RTL 后必须单独跑 `build_gowin.ps1` 并读
 `timing_paths`（当前工作点 slack 目标 ≥ +5ns，"时序裕量特征"）；
> ⚠ **2026-10-06 新增的亮度轴乘法尚未重新综合**，`+15.229 ns` 是加它之前的数；
> 下次跑 PnR 必须复核 slack 仍 ≥ 5 ns。
- 音质/听感（无耳朵）；
- 板上一切行为（I2S 电气、真实延迟、MAX98357A 群延迟、扬声器）；
- 上电行为 VP7、塑谱 VP、pads PS 的执行状态请查当前验证台账；本文件后续章节仅保留判据配方；
- 长时稳定性（从未跑过小时级仿真）。

## 2. TDM 三不变量（改引擎前默背，详见移交说明 v2 §一.2）

1. 装载走"待生效区"+周期奇偶标签，样本边界统一消费——**禁止恢复直写状态存储**；
2. 奇偶翻转在 sc=NSLOT-1，判定用读取时刻奇偶（ppr1）；
3. 累加窗口旋转 LAT 拍（清零 sc=LAT、锁存 sc=LAT-1）。
外加：门初值 0（无幽灵音符）；不变量"每样本拍数 = NSLOT"；不变量"查表地址用推进前相位"。

## 3. F1（512 谱峰）——已入闸口

- 工件：`src/sim/tb_tdm_f1.v` + `tools/scripts/f1_check_tdm.py`
-**栅格公式必须用 RTL 式**`(71583+8800k)×fs/2^24`——用四舍五入的 27.7 会累计漂移 18Hz
 （判据的尺子要跟被测物同源）；
- 采样**只在 WS posedge**（两个沿都采=时间轴拉长一倍、频率全部减半）；
- 采样前必须等包络进延音（≥4000 样本周期，按周期计不按拍计）+ UART 引导写 0x40=0x01；
- 判据 G1=512/512，G2=512，G3<5%，G4<半格。

## 4. 塑谱 VP1–VP8 执行细则（步③④完成后立即执行）

| # | 配方 |
|---|---|
| VP1 | 经 UART 连写 0x58(idx)/0x59(val) 16 次（自动步进）→ 断言内部谱阵列逐字节 = 写入序列（hierarchical 读 `u_tdm` 内谱 RAM 或经行为反映） |
| VP2 核心 |**在响变形**：0x60/0x61 长按 note 69 → 采 4096 样本基线谱 → 写新谱（0x58–0x5A，如首泛音→末泛音倾斜）→ 0x63 刷新该声部 → 再采 4096：断言 (a) 新谱峰位置/相对幅度按新谱变化（首/末泛音能量比反转）；(b) 变化发生在 ≤2 个样本边界内（分窗 FFT 或逐样本能量跳变点定位）；(c) 若同时长按第二音（note 72）且 0x63 只刷 note69 声部 → 第二音的谱峰频率与幅度**逐位不变**|
| VP3 | 替换模式（SPEC_MODE[0]=0）：未摸泛音幅度=0；叠加模式（=1）：=预设底谱+写入值（数值断言两种模式之差=底谱） |
| VP4 | 逐 pad：置 HARM_PADS 单位掩码 ×8 → 对应泛音幅度=满幅档、其余=0/底谱，逐根断言 |
| VP5 | 物理电极路径（pad_scan 实现后）：电极注入与 0x5B 写入产生相同 pad 状态与相同谱变化 |
| VP6 | 串行事件（0x60/0x61）与排针 ev_* 触发同一 note_map 装载序列（逐拍比对 load_en/load_slot/load_inc） |
| VP7 | 上电行为：复位、**零 UART 写**、16384 样本：输出全零、无测试模式频谱（test_mode 引脚下拉后=0）、preset=0（行为侧：第一事件响应符合预设 0 的谱） |
| VP8 | regress_all 全绿（含 --full） |

**VP2 的"逐位不变"实现要点**：对比窗口必须取刷新后的**同一相位区间**（谱变化会改波形但
"未触及声部"的波形应逐样本一致）——若两声部混叠无法分离，改为分两次实验（只发一个音）。

## 5. pads PS1–PS7 执行细则（pad_scan 实现后）

| # | 配方 |
|---|---|
| PS1 | 电容模型 tb：把 pad 建成可参数化放电时间（快=无指 / 慢=有指），断言计数单调随参数增大 |
| PS2 | 计数在阈值 ±5% 抖动 100 轮：输出状态翻转 ≤1 次（滞回生效） |
| PS3 | 全 pad 叠加慢漂移（每秒 +0.5% 基线）：自适应后误触发 = 0 |
| PS4 | 8 个音高 pad 逐一触发 → 抓 note_map 装载的 inc，对照五声音阶期望表（C4=262hpz… 用 note_inc.hex 的 MIDI 60/62/64/67/69/72/74/76 项） |
| PS5 | pad_harm 某位置位 → 在响声部对应泛音幅度变化（同 VP2 断言法） |
| PS6 | cst 复核：16 根 pad 引脚 + S2 全部显式 IO_TYPE=LVCMOS33，Bank 电压核对（27–42 均 3.3V bank） |
| PS7 | regress_all 全绿 |

## 6. 混响 T60（17 号契约 V2–V4 的执行配方）

1.**冲激**：单样本满幅注入（tb_fx test=2 已有），采 ≥30000 样本（T60 最长档 ~2s @fs）；
2.**Schroeder 积分**：E(n) = 10·log10(Σ_{k≥n} h(k)²) —— 从尾向头累加；
3.**T60**：E 从 −5dB 到 −35dB 段线性拟合，外推到 −60dB 的样本数 × Ts；
4.**V2**：RV_FB（0x48）逐档 → T60 实测 vs 理论 `6.91·Ts/(1−fb)` 误差 <10%；
5.**V3**：回声密度——前 200ms 内脉冲计数随时间单调增；
6.**V4**：把冲激分别过低通（截止 2kHz）/ 高通（6kHz）再各自 Schroeder → damp 最大档时
 高频 T60 < 低频 T60（差 ≥20%）——**"高频先死"**，报告直接引用；
7. 溢出测试：满幅正弦持续 5s 无回绕（V5）；全部走 0x48/0x49 寄存器（顺带验证 UART 路径）。

## 7. 复核方法论（替我盯 的五条）

1.**独立重跑**：证据文档的每条命令自己跑一遍，不读结论只看输出；
2.**主张必须挂路径**：写不出证据文件路径的主张 = 未证（已自我约定，你监督）；
3.**移动靶**：回归红了先查文件 mtime—— 会实时改文件；
4.**尺子与被测物同源**：判据脚本里的公式/常数/栅格必须从 RTL 源码抄，不从注释/记忆抄
 （27.7 vs 27.664 的教训）；
5.**肉眼看谱**：Top-25 峰表打印出来人工过目一遍，脚本判据会漏"形状不对"。

### 2026-10-06 追加的五条（当天一天里踩到的，都是"判据本身错"这一类）

6. **先查"红的日志是不是这一版代码跑出来的"**。当天 `14 vel timbre` 报 FAIL 并抛
   `ValueError: invalid literal for int(): 'X'`，看起来像 RTL 崩了；实际那份 judge log 的
   mtime（15:36:23）**晚于**修复提交（15:31:44），但**早于**那次会话真正落盘的时间 ——
   也就是说它记录的是**修复之前在磁盘上的那版代码**。**回归红了，第一步比对
   "日志时间 vs 代码修改时间"，而不是直接读 RTL。**
7. **判据要能被"缺数据"红，而不是崩**。同一件事当天栽了三次：运行目录缺 hex ⇒
   `$readmemh` 失败 ⇒ 音频全 X ⇒ 判据脚本抛异常。异常被截成 120 字符的 traceback，
   既看不出缺什么、也看不出哪个文件。**判据脚本对"文件缺失/行数不足/含 X"三类坏输入
   必须各给一句可读结论**；数据文件收成唯一入口，缺表直接让闸口红。
8. **指标方向本身可能是错的**。用"谱心"判亮度，遇到"砍掉高次泛音"就会给出**反向**结论
   （逐峰明显更亮，谱心却更低）。**指标与听感冲突时，先怀疑指标。** 亮度改用
   "高次能量占比"后单调且与听感一致。
9. **测试段之间共享全局状态 ⇒ 假绿/假红的常客**。`tb_vel_shape` 的 V6/V7 把 `vscale`
   改掉后没恢复，V8 就在"功能开"的状态下测"恒等"，报出 `base=16 amp=15` 这种差 1 的怪值。
   **每段判据开头显式设定它依赖的全部状态**，不要依赖"上一段留下的默认值"。
10. **判据的阈值要与被测物的取值范围对得上**。`09 regctl` 的 E7 原先要求
   "LED 序列去重后 ≥ 5 项"，但曲谱音高只落在 5 档台阶里的 2 档 ⇒ 期望序列最长 3 项，
   **这条判据写在纸上就注定红**（在基线 commit 上复现，确认与当天改动无关）。
   写阈值前先算一遍"被测物按规格最多能有多少个不同值"。

## 8. 争议与解释权

协议歧义：先通读 19 号 §1–§8 全文 + 修正案 A1–A6（⑤ 的教训：只读 §3/§4 会漏）；
仍有歧义 → 列表请示用户。 回归后：本文 §4–§7 的执行结果全部由 抽验，
抽验不合格的关闭回滚。
