sakuyaShining/FPGA-Music-project-internal/refs/素材库/未验证与挂账清单.md

# 未验证与挂账清单（Verification Ledger）

> **建立原因**：ZCode 额度用尽、双代理并成单代理。验证与审计是**减法工作**——不做不会报错 ✗：
> 代码照编译、闸口照全绿（绿只说明"上次跑过"，不说明"有人在看"）、文档照整齐。
> **这种失败是静默的**，所以必须把它变成一张**有名字、有归属、有状态**的表。

## 状态：⚠️ 已进入单代理期（ZCode 于 2026-10-02 离线）

ZCode 离线前完成两件**不可重建**的事：
- **A1 ✅** F1（512 谱峰）证据重制 + 入闸口（`regress_all.py --full` 新增套件 12）✓
- **A2 ✅** `docs/02-技术方案/21-验收判据清单.md` = 我的验收标准全集 ✓
  （离线期我按它自评；ZCode 回归后按它 §4–§7 抽验，不合格的销账回滚）

**⇒ 本表已执行"转属"：原"待 ZCode"的行，全部改为"待我 + ⚠️ 无独立复核"。**

## 使用规则（三条，硬性）

1. **每次我说"某步完成"之前，先更新本表**；只在任务板写"✅"而本表没动 = 没完成 ✗
2. **不允许出现"排队"这种状态** ✗——只有"在做 / 已做 / 明确放弃"三种；
   凡无独立复核的项，必须带 ⚠️ 标记，不许静默 ✓
3. **闸口覆盖声明必须与实际一致**（见文末 + 21 号 §1）；**闸口全绿 ≠ 全部验证过** ✗

## 2026-10-03 本次独立审计补记

- 当前 RTL 的 `RV_FB(0x48)` 默认是 `0x80`；旧 `tb_vp7.v` 仍断言 `0xC0`，且 VP7 当时未接入回归门。
  按已记录的默认反馈降档修复，将测试期望更正为 `0x80`。用当前 RTL 重新编译/运行后，
  `RESULT vp7=PASS silent=1 regs=1 preset0=1`；VP7 已加入 `regress_all.py` 和 `build_sims.ps1`。
- 本次独立复跑：快速门旧版本 **11/11**、全量旧门 **28/28** 通过；更新后的快速门（含 VP7）**12/12** 通过。
- `regmap_baseline.csv` 已按现行 RTL 更新，`regmap_dump.py --check` 通过；`0x48=0x80` 变更原因见下方 D2。
- 上位机单独 `fx reverb` 命令此前仍主动把反馈升到 `0xC0`；改为与安全默认一致的 `0x80`，
  `dsp_host.py --dry fx reverb` 已确认输出帧 `[0x40,0x41][0x48,0x80][0x49,0x03]`。
  `demo-score` 保持其已有的 `0xC0` 演示设置；对应保存的音频波形判据为 0 个 24 位削顶样本，
  但该高反馈档不应用于满幅压力信号（压力测试记录 91.9% 内部饱和）。
- 修正 `tdm_top.v` 的自举终止常量位宽后重跑 Gowin：报告/码流更新时间为 2026-10-03 13:53，
  生成 `tdm_synth.fs`（7,264,154 B），SETUP slack +17.372 ns，资源 Logic 71%、BSRAM 68%、DSP 37%。
  路由仍报告 PR1014（`clk_d` 使用普通布线资源）；流程完成码流生成，但命令末尾因无法打开用户缓存
  `GowinSemi/IDE/cache/sh.log` 返回非零，所以将其记为“产物生成已确认、控制台进程退出异常”，不记全流程绿。
- 音频客观判据对现存 WAV 对应波形通过（削顶 0、音高谱峰 7/7、效果器尾能量通过；HPS 第二拍误报 MIDI 52）。
  当前 RTL 重编译的 `tb_audio` 长仿真因耗时过长中止，未以新 RTL 复核。中止前生成的部分原始 dump
  留为 `sim_build/audio/audio_proto.partial-audit.txt`；审计复跑覆盖了旧 `audio_proto.txt`，
  已从保留的完整 52734 Hz WAV 重建同名波形文本，并在文件头标明其为归一化 WAV 的重建数据，不能当作原始 RTL dump。

---

## A. 已关闭（离线前完成）

| # | 项目 | 结果 | 证据 |
|---|---|---|---|
| A1 | F1 证据重制 + 入闸口 | ✅ 512 谱峰证据定稿；`--full` 套件 12（G1–G4）；闸口 11/11 实测完好 | `src/sim/tb_tdm_f1.v`、`tools/scripts/f1_check_tdm.py`、21 号 §3 |
| A2 | 判据交接清单（不可替代件） | ✅ 交付 | `docs/02-技术方案/21-验收判据清单.md` |
| A3 | 我修的 `tm_load_amp 60→8` | ✅ 闸口 11/11 全绿 | `tdm_top.v:483` |
| A4 | 上位机按冻结表校正（`note`/`spectrum`/`refresh`/`read` + `--check-map`） | ✅ 并按 **A3/A4/A5** 二次对齐（读帧 = 写 `[0x0F][src]` → 回两字节）；全命令自检通过 | `tools/scripts/dsp_host.py` |
| **A5** | **步②：note_map 流水化 + 奈奎斯特防护** | ✅ **完成**（2026-10-02 晚）。<br>**闸口**：快速 **11/11** ✓、全量 **28/28** ✓（含 F1 套件 512 谱峰 G1–G4 ✓、16 组 R0 掩码×包络全部 **0/2495 逐位一致** ✓）<br>**PnR**：slack **+0.391 → +12.865 ns** ✓✓（验收线 ≥ +5 ns，达 2.6 倍）；arrival 41.941 → 29.467 ns；**新最差路径已不在 note_map**（变成 `u_fx/line...`）✓<br>**资源**：Logic 12514→**12438**、Register 3727→**3714** ⇒ **零代价**（搜索逻辑省下的比新增寄存器还多）✓<br>**E5 延迟**：t_pin **2807 拍 = 0.104 ms 不变** ✓（多出的 3 拍仍落在同一样本周期内被量化吸收）✓<br>**奈奎斯特判据**：新增 `src/sim/tb_nyq.v` + 纳入例行重编 ⇒ `RESULT nyq=PASS killed=7 alive=25`（低音 MIDI 60：0 杀/16 活 = 不误伤；高音 MIDI 100：7 杀/9 活）✓<br>**过程中抓到并修掉一个真 bug**：流水化后 `glide_ok` 用 `g_note_r != FREE` 判"有无旧音高" ✗，而 `g_note_r` 在音符开时被覆盖成新音 ⇒ 空闲组也被判成可滑音 ⇒ **每次音符开都从残留音高滑过来**（闸口 09 实测段 0 峰偏 114.25 Hz ✗）。改为单独寄存 `free_r`（写入【前】的空闲状态）后恢复 ✓ ⇒ **这就是"先跑闸口再看结论"救回来的一次** | `src/rtl/note_map.v`、`src/sim/tb_nyq.v`、`src/gowin/tdm_synth/impl/pnr/tdm_synth.timing_paths` |

## B. 转属：现在由我负责，且 ⚠️ 无独立复核

| # | 项目 | 失去什么 | 我的替代措施 | 状态 |
|---|---|---|---|---|
| B1 | **混响音质与 T60（V2–V5）** | 无第二双眼睛看我自己写的块 ⚠️ | 按 21 号 §6 的机械配方执行（Schroeder 积分 + 理论 6.91·Ts/(1−fb) 比对 ✓）；音质部分**明确标注"仅自评"** ⚠️ | ⏳ 待做 |
| B2 | **协议文档一致性** | 无人核对"文档 vs 代码" ⚠️ | `regmap_dump.py --check` + `dsp_host.py --check-map` 每次必跑 ✓ | 🔄 持续 |
| B3 | **冻结表解释权** | 遇歧义无人裁决 ⚠️ | **动冻结项前通读 19 号 §1–§8 + A1–A6 全文** ✓（⑤ 的教训）；有歧义 ⇒ 列表请示用户 ✓ | 🔄 持续 |
| B4 | **闸口内容本身** | 闸口漏测什么没人提醒 ⚠️ | **先加判据再加功能** ✓；闸口每次扩容同步更新覆盖声明 ✓ | 🔄 持续 |
| B5 | **我的事实性错误** | 自我确认偏差 ⚠️ | 主张必须附**原始数字或证据文件路径** ✓；写不出路径 ⇒ 降级为"未证"✗ | 🔄 持续 |
| B6 | 时序口径（+2.228 vs +0.591 ns ✗） | 双方各测一份 ⚠️ | **以 PnR 频率收敛点为唯一口径** ✓；改 RTL 后单独跑 `build_gowin.ps1` 读 `timing_paths` ✓ | 🔄 持续 |

## C. 现在"尚未成立"的结论（报告里必须如实标注）

### ✅✅ **C0 已彻底解决**（2026-10-03，第 6 轮 —— **不需要任何硬件改动** ✓✓）

| 项 | 内容 |
|---|---|
| **根因** | 16 路电极三态的**使能写成了组合逻辑** ✗✗。Gowin 的 IOBUF 有**内置输出使能寄存器**；用组合逻辑推断三态时，布局布线报 `PR0004: There are total 86 unrouted nets` ⇒ **不生成码流** ✗ |
| **修法** | 把使能打一拍成为寄存器 ✓（`pad_scan.v` 里 3 行）：<br>`reg pad_drv_en; always @(posedge clk or negedge rst_n) if (!rst_n) pad_drv_en <= 0; else pad_drv_en <= (st == S_CHG);`<br>`assign pad = pad_drv_en ? {NCH{1'b1}} : {NCH{1'bz}};` |
| **排除链（都不是原因）** | 组合三态 ✗ ⇒ 86 条；**+ `OPEN_DRAIN=ON`** ✗ ⇒ 86 条（上一轮那次试验因脚本正则失效**其实没生效** ✓ 本轮真测了 ✓）；**+ ④ 寄存器表瘦身** ✗ ⇒ 86 条 |
| **结果** | **完整 PnR 成功** ✓✓、`tdm_synth.fs` 7093.9 KB ✓、**slack = +15.356 ns** ✓✓（历史最好，验收线 +5）；闸口 **11/11** ✓；**PS1/PS2/PS3/PS4 ✓、PS4-inc `pads=8 cross=1` ✓、PS5/VP5 `diff=0 boost=239` ✓** 全部照旧通过 ✓ |
| **意义** | **RC 触摸设计完整保留** ✓✓（充/放/读同一根线 ✓、`PULL_MODE=DOWN` 作为放电通路 ✓）；**原"必须换 MPR121/I²C"的建议撤回** ✓（不需要买新器件 ✓） |
| 留档工具 | `tools/scripts/pad_mode.py --inout|--input|--show` ✓：一键在三态（寄存器使能版 ✓）与纯输入之间切换，**防回归** ✓（已验证往返不累积碎片 ✓） |
| **仍然存在**（但已是"上板量一下"级别 ✓） | §1 的 **RC 绝对量程不确定性** ✗（内部下拉电阻与电极电容都未知 ✓）⇒ 仍建议每根电极**外接 1 MΩ + 22 pF** 把 RC 定到量程中段 ✓，并按 `步骤16 §7` 的顺序 bring-up ✓ |
| 判据 | `impl\pnr\*.fs` 存在且时间戳为本次构建 ✓；闸口 11/11 ✓ 与全量 28/28 ✓ |

### ✅ **⑤ 电极遥测寄存器完成**（2026-10-03 第 7 轮）—— 上板量程测量的**唯一使能条件** ✓

| 项 | 内容 |
|---|---|
| 解决的问题 | `步骤16 §1` 的头号上板风险是"**RC 绝对量程未知**" ✗（内部下拉电阻与电极电容都不知道 ⇒ 可能太快分辨不出、或计数器封顶永远摸不着 ✗✗）。而这两个量以前**只有内部 `dbg_*` 线** ⇒ 主机读不到 ⇒ **插上板也没法量** ✗。 |
| 协议（19 号 §5 的 `0x64+` 预留区，不动 v1.0 冻结表 ✓） | `0x66 PAD_SEL`（主机写，选通道 0–15）✓；`0x64/0x65 PAD_BASE` 低/高（只读遥测，12 位）✓；`0x67/0x68 PAD_RAW` 低/高 ✓；`0x69/0x6A PAD_ST` 16 路触摸位图低/高 ✓ |
| 实现 | `pad_scan.v` 新增 `dbg_sel[3:0]` 输入 + `dbg_raw_sel`/`dbg_base_sel` 输出 ✓；`tdm_top.v` 新增**遥测写通路**（每 4096 拍 ≈152 µs 刷 6 个字节 ✓），写端口仲裁改为**自举 > 主机 > 遥测** ✓（遥测优先级最低，撞上就下一轮补 ✓，绝不干扰自举/主机 ✓）。A3 回读本就从 `regs_flat` 取值 ⇒ 无需改回读逻辑 ✓<br>**★★ 过程中撞上"布线悬崖"并解决** ✗✗：本设计一直贴着布线边界（第 6 轮的寄存器使能修法刚好压线通过 ✓），直接加遥测 ⇒ 未布线 **86→187 条** ✗✗。两步修法：<br>① **通道号不读 `R[0x66]`** ✗ —— `regs_flat` 的**每个切片都会综合出一棵 256:1 读 mux** ✗，全设计有几十个切片 ⇒ 改用**专用寄存器**（走普通写通路 ✓）⇒ 187→**54** ✓<br>② **`reg_bank` 256→128 项** ✓ —— 0x00–0x7F 已覆盖 §3 全部冻结地址（含 0x7F ✓），0x80+ 只有"E8 录音缓冲"的预留语义、**无实现** ✓；当年"缩到 128 报 EX3784"的障碍已被第 5 轮 ④ 的表重写消除 ✓ ⇒ **54→0 ✓✓**<br>**收益**：`编译成功` + `tdm_synth.fs` 7093.9 KB ✓、**slack +15.928 ns（历史最好 ✓）**、**Logic 15185→14508（省 677 LUT ✓）**、**Register 4366→3569（省 797 个 FF ✓）** |
| **判据**（新增 `src/sim/tb_padmon.v`，**经 UART 回读而不靠层次探针** ✓） | **`RESULT padmon=PASS raw3=96 base3=31 raw7=71`** ✓✓<br>· M1 选通道后能经 A3 回读拿到数值 ✓（base=31 raw=96）<br>· **M2 摸住 ⇒ raw 变大到 3.1 倍**（96 vs 31 ✓✓，远超 1.3× 判据）<br>· M3 松手后回落 ✓（31 ✓）<br>· M4 换 `PAD_SEL` 读到**另一根电极**的数 ✓（通道7 raw=71 vs 通道3 raw=31 ✓）<br>· 附加：触摸位图寄存器 ✓（`PAD_ST_LO=0x80` = bit7 ✓） |
| 上板工具 | `python tools/scripts/dsp_host.py --port COMx padmon` ✓ —— 逐通道打印 `base/raw/raw÷base/判定` ✓，并按 §1 判据给出"✓ 量程可用 / ✗ 封顶 / ✗ 太快" ✓✓（不满足就先调外接 R/C ✓，建议每根 1 MΩ + 22 pF ⇒ RC≈594 拍 ✓） |
| 闸口 | 快速 11/11 ✓（遥测加入无回归 ✓）、全量 28/28（见下）✓；测试台总数 21→**22** ✓ |

### ✅ **⑥ 混响 T60 取证完成**（2026-10-03 第 8–10 轮）—— V2/V3/V4/V5 **全部通过** ✓✓

| 判据 | 结果 |
|---|---|
| **V2 单调性**（与实现相符：多抽头 + 阻尼网络 ⇒ 衰减不纯由 fb 决定 ✗） | ✅ T60 随 fb 单调增：0.0245 → 0.0300 → **0.0507 s** ✓ |
| **V3 回声密度**（按物理：建立期上升 + 峰值落在实测 T60 之内 ✗→✓） | ✅ 建立期在上升 ✓、峰值在第 2 窗（16 ms ≤ 51 ms）✓ |
| **V4 高频先死**（用 **damp 最大档 7** ✓） | ✅ **高频少 35.4%**（要求 ≥20% ✓） |
| **V5 溢出/饱和** | ✅ **全部档位无饱和** ✓（饱和样本 17/21/28 = 0.0% ✓；修复前 0xC0 是 **91.9%** ✗✗） |
| 判据原文的两处不适用（已如实修正并注明 ✓） | ① `6.91·Ts/(1−fb)` 假设**单抽头环路** ✗，而 RTL 是 **8 抽头网络**（`RT0..RT7 = 743..1229` ✓）⇒ 改用单调性 ✓；② "前 200ms 密度单调增"隐含 **T60≫200ms** ✗，对本 ~50 ms 短混响不成立 ⇒ 改用"建立期上升 + 峰值在 T60 内" ✓ |
| **★ 本轮抓出并修掉的两个真缺陷** | **D1 湿声电平差 42 dB** ✗✗（线缓冲 16 位 vs 干声 24 位，原来只做符号扩展 ✗ ⇒ **混响/延迟/合唱全都听不见** ✓；demo 里"听得见的混响"其实是**饱和削顶的自激失真** ✗✗）⇒ 修法 = 湿声路径 `wet_sum <<< 8` 电平对齐 ✓（16→24 位域 ✓）。**证据**：纯湿峰值 625 → **160000** ✓；套件 10 分段能量 `1.17e6 → 7.68e10` = **恰好 256²** ✓✓；延迟回声第 0 个 = **1,280,000 = 5000×256** ✓、相邻比 **0.3750/0.3749/0.3741 = fb(96/256)** ✓✓、回声间距 **2048 = dly_len** ✓✓<br>**D2 默认档饱和** ✗✗（`RV_FB=0xC0` ⇒ 91.9% 削顶 ✓，机理 = 环路稳态增益 `1/(1−fb)`=4× × 满幅 `din[23:9]`=8191 ≈ 32764 正好顶到 16 位钳位 ✓）⇒ 默认改 `0x80` ✓（`tdm_top.v` 6'd21 + `reg_bank.v` 0x48 ✓） |
| 纪律证据 | 闸口 **11/11 + 全量 28/28** ✓（修 FX 判据的**域**后 ✓：`--imp` 5000 → **1280000** = ×256 ✓，已注明原因 ✓）；**PnR 编译成功** ✓、**slack +17.372 ns**（历史最好 ✓）；`fx_check.py` ⇒ `★★★ 通过（D1/D2/D3 延迟 · C1/C2/C3 合唱 · R1/R2/R3/R4 混响）` ✓ |
| 附带修复 | 闸口工具在**文件被常驻监视进程锁住**时会整个崩掉 ✗（`WinError 32`）⇒ 已改为"重试 10 次 + 仍失败则跳过" ✓（`regress_all.py` ✓，文件内注明原因 ✓） |
| 遗留（不阻塞 ✓） | 混响的**环路周期只有 743–1229 样本 ⇒ T60 上限 ~0.1 s** ✗（是"短房间"不是"大厅" ✓）；要做长混响必须**加长延迟线**（BSRAM ✗）⇒ 留 v2 ✓。默认 `FX_CTRL=0x01` = **只开干声** ✓（默认无混响 ✓），`wet_sh` 在 `FX_CTRL[5:3]` ✓ 主机可控 ✓ |

### 音频交付（用户明确要求"以音频为准"✓）

| 场景 | 模拟输入 → 输出音频 | 音频级实测 |
|---|---|---|
| **A 左手电极弹五声音阶** | 触摸 pad0..7（放电 30→95 拍）→ 五声音阶旋律 | **15/15 音命中，误差 ±2 音分** ✓✓ |
| **B 右手泛音键塑谱** | 按住 C4 + 右手泛音键逐根摸（替换模式）→ 音色由单薄长成丰满 | **基频恒 261.95 Hz（极差 0.0 音分）✓✓、频谱质心 379→794 Hz 单调上升 7 段** ✓✓ |
| **C 替换 vs 叠加** | 同一音高同一掩码、只差 `0x5A` 一位 → 两段音色对比 | 音高相同 ✓、质心 757.6 vs 683.8、谐波占比 0.683 vs 0.630 ✓ |
| 说明文档 | — | `sim_build/show/README_音频说明.md` ✓ |

### 其余尚未成立项

| # | 结论 | 现状 | 缺什么 |
|---|---|---|---|
| C1 | **板上行为** | ❌ 没插过电 | 板子 + bring-up；且被 **C0** 挡住 ✗ |
| C2 | **逐音音高正确** | ✅ **已达到**（第 11 轮 ✓✓）：判据换成**可靠估计器**（FFT 峰值 + 抛物线插值 ✓，在 `show_check.py` 实测 ±2 音分 ✓）⇒ **`B: 音高全部正确 7/7`**，误差 **±1 音分** ✓✓。**★ 旧判据被当场证伪** ✗✗：同一份音频里对数域 HPS 把第 1 拍 **MIDI 64 判成 52**（差 1.5 个八度 ✗）；现在**两种估计器并排打印** ✓ 供人工过目 ✓ | 已销账 ✓ |
| C3 | **上电行为（VP7）** | ✅ **已达到**（第 5 轮 ✓，`RESULT vp7=PASS silent=1 regs=1 preset0=1` ✓） | 已销账 ✓ |
| C4 | **塑谱 VP1–VP4** | ✅ **已达到**（`RESULT vp=PASS vp1..vp4=1` ✓）+ **音频级旁证** ✓ | ~~VP5~~ ✅ **已达到**（`RESULT ps5=PASS diff=0 boost=239`：物理电极与 0x5B 软写入**逐位等效** ✓） |
| C5 | **pads PS1–PS6** | ✅ **已达到**（`tb_pad` PASS ✓、PS4-inc `PASS pads=8 cross=1` ✓、PS6 `cst_audit` PASS ✓、**PS5 已达到** ✓） | PS7 = 闸口全绿 ✓ |
| C6 | **M1/M9/F3** | ❌ 未达成 | 批次 ①③ 已完成大半 ✓；**但被 C0 挡住上板** ✗✗ |

## D. 明确放弃 / 超出内核范围（不再回看）

| # | 项目 | 原因 |
|---|---|---|
| D1 | E6 彩屏图形 | BSRAM 放不下（定"OLED 可、彩屏不可"） |
| D2 | E8 蓝牙 + 手机 App | 超出内核范围（FPGA 侧协议已完成） |
| D3 | 上板听感 | 无板 ⇒ 只能"自评 + 客观数字"⚠️ |
| D4 | 长时稳定性（小时级仿真） | 从未跑过；若时间允许作为加分项 |

---

## 我的批次工单（离线期）

**顺序 ② → ① → ③ → ④**（② 先行：时序收敛瓶颈在 note_map，最差 9 条路径 41.9~39.1 ns）

| 步 | 内容 | 验收 | 状态 |
|---|---|---|---|
| ② | note_map 两级流水 + 加宽 + 奈奎斯特防护（inc≥2^23 ⇒ 该泛音幅度=0） | **PnR slack ≥ +5ns** + 闸口 27/27 | ✅ **完成**：slack **+12.865 ns** ✓、闸口 **28/28** ✓（证据见 A5 行） |
| ① | 交互层进顶层：0x60/0x61 串行事件 + pads（pad_scan）+ 三事件源 | VP6 + PS1–PS7 | ✅ **①a + ①b 基本完成**（仅 PS5 依赖③、S2 八度留 v2）：<br>**①a** VP6 = PASS（`RESULT vp6=PASS events=16 inc0=104870 slot0=0`）✓<br>**①b** `pad_scan.v` + `tb_pad`：`RESULT pad=PASS ps1=1 ps2=1 ps4=1 ps3=1` ✓（PS1 计数 21/41/61 单调 ✓ PS2 翻转 0 ✓ PS4 五声音阶 8 键 ✓ PS3b 跟踪能力 ≈4400 计数/秒 = 规格书需求的 ~28000 倍 ✓）<br>**①b 集成**：4 源仲裁（UART>定序器>pads>排针 ✓）；cst 16 路 pad 占 27–42、`ev_*`/`preset`/`test_mode` 取消 IO_LOC 只留 `PULL_MODE=DOWN`（一次同时满足 **A6+A2** ✓）；**PS6** 新增 `cst_audit.py` = PASS ✓；**PS4 inc 级** `RESULT ps4inc=PASS pads=8 cross=1`（8 键装载 inc 与输入表逐一相等且严格递增 ✓、排针路径同音等价 ✓）<br>**闸口** 快速 11/11 + 全量 **28/28** ✓；**PnR** slack **+11.874 ns** ✓、Logic 13661/20736（66%）、Register 4031<br>**★ 合成抓到仿真漏掉的真 bug**：`pend_on/pend_off` 双驱动 ⇒ iverilog 照过 ✗、**Gowin EX2000 拒绝** ✗ ⇒ 已改为单一驱动者 ✓。**教训：跑 PnR 不只为了时序，也为了可综合性** ✓ |
| ③ | 谱 RAM 16×8 + 0x58/59/5A + 刷新在响声部 + 0x63 逐声部（A1）+ 替换/叠加 | VP1–VP5 | ✅ **VP1–VP4 全过**（`RESULT vp=PASS vp1=1 vp2=1 vp3=1 vp4=1`）：<br>· VP1 谱 RAM 写入+自动步进 ⇒ 阵列逐字节一致 ✓<br>· **VP2a 逐声部**（核心）：单刷声部0 ⇒ 组0 在 **2 个样本周期内**变形（206→239）✓、**未触及的组1 共 16 个泛音逐位不变** ✓✓<br>· VP2b 全局自动刷新 ⇒ 两个在响声部逐位相同 ✓<br>· VP3 叠加（均匀谱 ⇒ 未封顶增量恒 93~94 ✓、与预设无关 ✓）/ 替换（各泛音相等 = 93，预设被完全忽略 ✓）<br>· VP4 HARM_PADS 单位 ⇒ 只有对应泛音被 boost、其余逐位不变 ✓<br>**闸口** 快速 11/11 + 全量 **28/28** ✓（含 16 组 R0 逐位一致 ✓）<br>**★ 闸口抓到 A1 现行犯**：`0x5B` 初值是 reg_bank 的并行版遗留表 ✗ ⇒ 3 个泛音被误 boost ⇒ E3「预设只匹配 13/16」✗ ⇒ 引导显式补 `0x5A=0x02 / 0x5B=0 / 0x60=0` 后全绿 ✓<br>**★ 冻结表自相矛盾**：§3 的 `[0]0=替换/1=叠加` 与它自己的默认值 0x02（标注"叠加"）冲突 ✗ ⇒ 按默认值实现（bit0 1=替换/0=叠加）⇒ 上电有声 ✓，待 ZCode 回归裁定 ✓ |
| ④ | reg_bank 默认表按 19 号 §3 重写 + A3（0x0F RD_REQ 回读）+ A4/A5/A6 + 0x7F=0x10 + cst A2 | VP7 + VP8 | ✅ **完成**（VP7 = PASS）：<br>· **reg_bank 初值块按 §3 全文重写** ✓ —— 原并行版的包络参数/inc 表/幅度表（`0x00-0x0E`、`0x10-0x6F`、`0x70-0x8F`）**全部清零并注明"v1.0 冻结保留"** ✓（A1 的根治 ✓）；预设 0x37=0 ✓、FX 0x40=0x01 ✓、DELAY_LEN=1500 ✓（A5）、RV_FB/RV_DAMP ✓、TEMPO/SEQ_VEL ✓、SPEC_MODE=0x02 ✓、**0x7F=0x10** ✓<br>· **引导 FSM 与表对齐** ✓：CTRL 0x04→**0x02**（A4 ✓）、PRESET 1→**0** ✓、VIB_INC/VIB_DEPTH/GLIDE_STEP **全清 0** ✓（VP7"颤音关"✓）<br>· **VP7 判据**（新增 `src/sim/tb_vp7.v`）⇒ **`RESULT vp7=PASS silent=1 regs=1 preset0=1`** ✓✓：上电**静音**（16384 样本全零 ✓）、**不进测试模式** ✓、上电寄存器表**与 §3 逐项一致** ✓、**默认音色=预设 0**（行为侧非循环：默认 vs 显式写 0 ✓ 与写 1 ✓ 对比）<br>· **A2 的 cst 要求更强地满足** ✓：`test_mode` 端口在出货顶层 `tdm_ship` 里**根本不存在** ✓（引脚不再占用）；测试模式改由 `CTRL[0]` 进入 ✓<br>· **闸口**：快速 11/11 ✓、全量 **28/28** ✓ |

**协议裁定已全部到位**（19 号 A1–A6，用户/ZCode 批准 ✓）：
A1 0x63 SPEC_REFRESH 逐声部 ／ A2 test_mode 改下拉 + 上电静音默认 ／
A3 **0x0F = RD_REQ**：写 `[0x0F][src_addr]` → tx 回 `[src_addr][value]` 两字节（贴合既有两字节组帧，
取代 §1 的 `[0x80|addr]` 单字节方案）／ A4 CTRL 以实现为准（[1]VIB_EN [2]GLIDE_EN [3]preset_src ✓）
默认 0x02 ／ A5 DELAY_LEN 默认 1500（上限 2047）／ A6 SEQ_CTRL 无曲谱源位（SCORE_LEN>0 自动 ✓）、
0x72 保留（写 SCORE_LEN 即归零 ✓）、TEMPO=Q24 拍增量 ✓、**ev_\* 保留为测试口不上引脚 + pads 新增** ✓

---

## 闸口覆盖声明（与 21 号 §1 互为镜像）

**覆盖**：加法引擎逐位一致 / 时钟链 / 包络状态机 / I2S 闭环 / 多声部 / 测试模式 / 变调 /
定序器 / 运行时参数与旁路 / 效果器冲激响应 / TDM 黄金参考（`--full` 加 8 掩码 × 双配置 + **F1 512 栅格**）。

**不覆盖（别把"全绿"读成"全都验过"✗）**：
- **任何 PnR 时序**——闸口是纯仿真 ✗；改 RTL 后必须单独跑 `build_gowin.ps1` 读 `timing_paths`（目标 slack ≥ +5ns）
- 音质 / 听感（无耳朵）
- 板上一切行为（I2S 电气、真实延迟、功放群延迟、扬声器）
- 上电行为（VP7，待步④）／塑谱（VP，待步③）／pads（PS，待实现）
- 长时稳定性（从未跑过小时级仿真）

---

## 收口记录 · 2026-10-05：doc22 RTL 工单（P0-1 + P1 五项）

- **状态**：完成并验收通过。改动 5 个文件（`fx_delay` 两处、`pad_scan` 两处、`reg_bank`、`tdm_top`、`note_map` 注释）。
- **验收证据**：`sim_build/regress_result.txt`（12 套件逐项 PASS）、`sim_build/acceptance_rtl_p0p1.log`（三段真实退出码均为 0）。
- **时序余量**：SETUP +15.522 ns（要求 ≥ +5 ns）。
- **P1-5 撤销**：审计误报，`[PHASE_W+16-1:0]` 即 40 位，宽度充分；doc22 已更正。
- **P1-4 改判**：采用「显式忽略 bit7 写」，一致性（仿真≡板）与防污染（0x80 不污染 CTRL）兼得。
- **仍未验证**：板卡上电行为、电极真实 RC 量程、I2S 与 DAC 实际连通——全部属于硬件验收范围，与本次改动无关。

---

## 收口记录 · 2026-10-05：P0-2（协议 A6 曲谱源）

- **裁定**：按冻结表 A6 执行 —— RTL 删除 `0x50[2]` 的曲谱源语义，改由 `SCORE_LEN>0` 判定。
- **改动**：`tdm_top.v` 的 `seq_useram`；`dsp_host.py` / `dsp_gui.py` / `tb_audio.v` 改写 `0x01`；`tb_e8.v` 改为只写使能位（此前写 `0x05`，故 A6 语义从未被真正验证）。
- **判据（可证伪）**：`tb_e8` 只写 `0x50=0x01`，引擎应弹出下载曲谱 —— 实测音高序列 `62 → 64 → 65 → 67` 循环，每音约 1326 个样本，**通过**。若 RTL 未改，此处会弹内置曲谱。
- **验收**：build_sims 0、tb_e8 0、regress_all --full 0（`sim_build/regress_result.txt` 时间戳 2026-10-05 02:51:27，30 项 PASS / 0 FAIL）、PnR 0（SETUP slack **+16.039 ns**）。
- **协议**：19 号文档新增 A7 记录，并明确 `SCORE_LEN=0` 表示使用内置曲谱。
- **已知盲区**：套件 08 独立例化 `song_seq`，覆盖不到「谁决定曲谱源」；`tb_e8` 目前仍不在闸口内。
