sakuyaShining/FPGA-Music-project-internal/docs/02-技术方案/12-课题要求覆盖清单.md

# 课题要求覆盖清单（逐条核对）

> 赛题：《2026 FPGA 赛道选题指南（高云半导体）》选题二
> 核对日期：2026-09-24　｜　剩 41 天
> 原文出处： 第 242–302 行
> 判定口径：**"RTL 实现"才算覆盖**；Python 验证器只证明算法可行，不算覆盖（赛题要求「完整音频通路全部基于 FPGA HDL」）

---

# 总览

| 类别 | 完全达成 | 部分达成 | 未做 | 合计 |
|---|---|---|---|---|
| **必须项** | **0** | 3 | 6 | 9 |
| **合规红线** | 2 | 1 | 0 | 3 |
| **核心评分依据** | 0 | 1 | 0 | 1 |
| **形式项** | 1 | 2 | 1 | 4 |
| **拓展项** | 0 | 0 | 8 | 8 |
| **合计** | **3** | **7** | **15** | **25** |

**加权覆盖率**（完全达成 = 1，部分 = 0.5）：(3 + 7×0.5) / 25 = **26%**

> ⚠️ **但真正要紧的是这一行**：
> **9 个必须项里，完全达成的有 0 个。**
> 必须项是"缺一不可"的，部分达成不等于合格。
> **按现状无法提交一份合格作品。**

---

# 一、必须项（9 项，缺一不可）

| # | 要求 | 状态 | RTL | Python 验证器 | 缺口说明 |
|---|---|---|---|---|---|
|**M1**| ≥2 个独立可控演奏维度 | ⚠️**骨架+判据就绪，未上板**| 交互层核心 `perf_ctrl.v` + 传感器仿真器 +**交叉测试**判据 | ✅ 有 4 维 | 已实现"选音 + 力度"两维**独立可控**并仿真证明（P1/P2 交叉测试）；缺真实器件与现场演示 |
| **M2** | 完整音频通路全部基于 FPGA HDL | ⚠️ **部分** | 合成引擎是纯 RTL | — | **没有输出通路**（I2S），所以"完整通路"目前不存在 |
| **M3** | 经 I2S 输出至 DAC 发声 | ❌ **未做** | 无 | — | I2S 发送器一行没写 |
| **M4** | 延迟 ≤10 ms | ⚠️ **架构支持，无法测** | 7 级流水线 ≈ 6 样本 = **128 µs** | — | 没有 I2S 就没有端到端，**测不了** |
| **M5** | 基础复音数 ≥4 | ❌ **未做** | 1 个声部（8 泛音） | ✅ 有 4 声部 | RTL 侧完全没有声部管理 |
| **M6** | 单音实时变调 | ⚠️ **架构支持** | `inc` 是**编译期常量** | ✅ | 改成可写寄存器即可，但没做 |
| **M7** | **ADSR 包络调控** | ❌ **未做** | **完全没有** | ✅ 有（6ms 起音 + 200ms 释放） | **RTL 里振幅是静态常量 `amp_flat`** |
| **M8** | 多声部实时混音 | ❌ **未做** | 无 | 有（加法叠加） | 需要混音器 + 饱和限幅 |
| **M9** | 自研演奏交互形态 | ⚠️ **设备无关骨架就绪，未上板** | `perf_ctrl.v`：通用测量总线 + 两种手感（按住触发 / 挥手拨弦）+ 力度感应 | — | 选音/触发/拨弦/力度感应四件事在仿真里都有判据（P1~P4）；**具体传感器未定**，真机形态未做 |

**必须项完成度：0 / 9 完全达成，3 / 9 部分。**

## 🔴 最致命的一条：M7 与「完整振荡器」定义

赛题对"独立振荡器"的定义是：

> 「独立发声单元为包含**独立相位累加器、频率调控、包络控制**的完整振荡器」

| 三要素 | 我们的状态 |
|---|---|
| 独立相位累加器 | ✅ 8 个，完全独立 |
| 频率调控 | ✅ `inc` |
| **包络控制** | ❌ **没有** |

→ **严格讲，我们现在这 8 个单元还不算"完整振荡器"。**
→ **这意味着「振荡器数 × 采样率」这个核心指标目前不能声称成立。**
→ 虽然 M7 只列在"必须项"里，但它**同时卡住了评分依据**，是双重缺口。

---

# 二、合规红线（3 项）

| # | 红线 | 状态 | 证据 / 缺口 |
|---|---|---|---|
| **R1** | 严禁播放预录 PCM | ✅ **满足** | 设计上**不可能踩**：代码里没有任何音频存储器。正弦表是**波表**（赛题明确允许），不是成品音频 |
| **R2** | 所有音频逐音逐样本实时生成 | ✅ **已证明** | Python 模型与 RTL **逐位一致，0 个样本差异**；两者都是实时计算 |
| **R3** | 现场需自证无预录 | ⚠️ **部分** | 已做 A/B 独立性实验（只改第 3 泛音 → 只有第 3 峰移动），是雏形。**但不是 RTL 内置的"测试模式"**，现场做不了 |

**红线：2 / 3 完全满足，1 项部分。**
这是目前最扎实的一块 —— **R1/R2 已经站住了**。

---

# 三、核心评分依据（1 项，但最重要）

> **吞吐量指标 = 「同时活跃可闻独立振荡器总数 × 实际音频输出采样率」**

| 项 | 状态 | 说明 |
|---|---|---|
| 计数规则理解 | ✅ | 加法合成按运算分量统计 —— 每个泛音算一个振荡器 |
| **指标能否成立** | ⚠️ **不能** | 因为"完整振荡器"缺**包络控制**（见 M7） |
| 当前可实现数值 | （若补上包络）8 泛音 × 46875 Hz = **375 000 osc·Hz** | 这是"一个声部"的数字 |
| 扩展到 32 泛音 | ×46875 = **1 500 000 osc·Hz** | 需 BSRAM 32/46 块 |

→ **补包络是解锁这一项的前提。**

---

# 四、形式项（4 项）

| # | 要求 | 状态 | 说明 |
|---|---|---|---|
| **F1** | 测试模式（多路不同频率 → 频谱数峰） | ⚠️ **部分** | 仿真里做过（8 峰全中，误差 < 半个 FFT 格），**但没做成 RTL 内置模式** |
| **F2** | 振荡器含 相位累加器 + 频率调控 + **包络控制** | ⚠️ **2/3** | 缺包络 —— **与 M7 是同一个缺口** |
| **F3** | 能识别 选音/和弦/触发/拨弦 | ❌ **未做** | 需要交互层 |
| **F4** | 适配 Sipeed Tang 系列 | ✅ **满足** | Tang Nano 20K（GW2AR-LV18QN88C8/I7） |

---

# 五、拓展项（8 项，加分）

| # | 要求 | 状态 | 备注 |
|---|---|---|---|
| **E1** | 复音 ≥32 / 加法分量 ≥32 / 物模单元 | ❌ | 全并行上限约 46 泛音；要 ≥32 复音需 TDM |
| **E2** | ≥3 维表情调控 | ❌ | Python 演奏器有 4 维，RTL 无 |
| **E3** | ≥2 种音色切换 | ❌ | Python 演奏器有，RTL 无 |
| **E4** | 混响 / 延迟 / 合唱 | ❌ | 未开始 |
| **E5** | ≤5 ms 无抖动 | ❌ | 未测 |
| **E6** | 可视化（LED / 李萨如 / 频谱 / 波形） | ❌ | 9K 学习项目里有 LCD 显示，但**不是本赛题的设计** |
| **E7** | 脱机 LED 曲目指引 | ❌ | 未开始 |
| **E8** | 蓝牙 + 手机 App | ❌ | 未开始 |

**拓展项：0 / 8。** 这是正常的 —— 必须项还没做完，拓展项本来就在后面。

---

# 六、已有的资产落在哪里

| 资产 | 位置 | 对覆盖的贡献 |
|---|---|---|
| 加法合成引擎（8 泛音独立振荡器） | `src/rtl/osc_additive.v` | F2 的 2/3、R1、R2 |
| 综合顶层（时钟分频 + 输出） | `src/rtl/osc_additive_top.v` | 使设计可综合、可测资源 |
| 仿真测试台 | `src/sim/tb_osc_additive.v` | R2 的证据 |
| **Python 逐位一致模型** | `tools/scripts/synth_engine.py` | **验证器**：证明 M1/M5/M6/M7/E2/E3 的算法都可行，只差搬进 RTL |
| 实时演奏器（键盘） | 同上 `play` 模式 | 产品概念的可行性验证 |
| FFT 分析工具 | `tools/scripts/additive_tool.py` | F1 的原型 |
| 综合/时序流水线 | `tools/scripts/build_gowin.ps1` | 支持"不需要板子"的验证 |

> **一个重要的乐观因素**：
> Python 验证器已经把 **M1 / M5 / M6 / M7 / E2 / E3** 的**算法全部跑通了**。
> 剩下的工作是**把算法搬进 RTL**，不是"从零发明"。
> 这比"什么都还没想清楚"要好得多。

---

# 七、要达到"可提交"，必须补的顺序

| 顺序 | 动作 | 解锁哪些要求 | 需要板子？ | 预估 |
|---|---|---|---|---|
| **1** | **给振荡器加包络** | **M7 + F2 + 核心指标成立** | ❌ | 1 天 |
| **2** | **补 `.sdc` + 时序收敛到目标频率** | 使 M4/E5 可测 | ❌ | 1 天 |
| **3** | **I2S 发送器** | **M3 + M2（完整通路）** | ❌ | 2 天 |
| **4** | **多声部 + 混音 + 声部分配** | **M5 + M8** | ❌ | 3 天 |
| **5** | **测试模式（RTL 内置）** | **F1 + R3** | ❌ | 1 天 |
| **6** | 实时变调接口（`inc` 改寄存器） | M6 | ❌ | 0.5 天 |
| **7** | **交互层** | **M1 + M9 + F3** | ⚠️ 部分需硬件 | 3 天 |
| 8 | 拓展项（效果器/可视化/音色/复音扩展） | E1–E8 | ❌ | 3 天+ |

**关键结论**：
> **第 1–6 步全部不需要开发板**，可完全在"仿真 + 综合"里完成，
> 而它们解锁了 **8 个必须项中的 7 个**（M2/M3/M4/M5/M6/M7/M8）+ F1 + F2 + 核心指标。
>
> **只有第 7 步（交互层）可能需要硬件**，而它也可以用板载按键 + UART 在不加任何外设的情况下满足。

## 时间可行性

| | 天 |
|---|---|
| 第 1–6 步（不需要板子） | 约 **8.5 天** |
| 第 7 步（交互层） | 约 **3 天** |
| 第 8 步（拓展项，可选） | 约 **3 天+** |
| 报告 + 视频 + 提交 | 约 **6 天** |
| **合计** | **约 21 天** |
| **剩余** | **41 天** |

→ **时间上是够的，前提是不在意外的地方耗掉。**

---

# 八、一句话总结

> **红线基本站住了（2/3），必须项一个都还没完成（0/9），但算法全在 Python 里跑通过。**
> **接下来的工作性质是"搬运 + 工程化"，不是"研究"。**
>
> **最该先做的一件事：给振荡器加包络** —— 它同时解锁 M7、F2 和核心指标，是性价比最高的一步。
