sakuyaShining/FPGA-Music-project-internal/docs/02-技术方案/18-交互层决策清单.md

# 交互层决策清单（M1/M9/F3 · 用户拍板用）

> 2026-10-02 · ZCode 起草。**用法**：不必一次答完——每条决策附"检验句"，答得出就拍板，答不出就先挂着。
> 教学原则：每个决策 = 四股力（物理/赛题/可靠性/叙事）的平衡，检验句就是四股力的试金石。

---

## 决策 ①：音符事件通道 —— 并口排针 vs UART 串行 【第一批，阻塞其它一切】

| 项 | 并口（现状） | **串行（UART）** |
|---|---|---|
| 事件接口占用 | 排针 16/18 根 | 排针 **0** 根（走 BL616 板载串口） |
| 电极可用引脚 | 2 根（8 键不可能） | **18 根全可用** |
| RTL 改动量 | 无 | note_map 寄存器路径**已支持**，零改动 |
| 时序风险 | 无 | 无（115200 波特，音符事件毫秒级） |
| 断线兜底 | 排针断一根坏一路 | 键盘/触摸/定序器同走一条协议 |

- **检验句**："触摸板要 10 个电极，引脚从哪来？"（并口方案此题无解）
- **ZCode 观察（非结论）**：串行是唯一解，且让交互硬件与 RTL 解耦——换任何输入设备都能演。

## 决策 ②：选音物理形态 —— 传感器选型 【第二批，板到手后】

| 选项 | M9 自研性 | 可靠性 | 工作量 | 引脚 | 赛题原文点名 |
|---|---|---|---|---|---|
| 上位机键盘 | 弱（定位=工具+兜底） | ★★★★★ | 零 | 0（串口） | — |
| 板载按键 S2 | 弱 | ★★★★★ | 零 | 0 | — |
| **电容触摸电极** | **★★★★** | ★★★（需现场调阈值） | 半天（铜箔+万用板） | 每键 1 根 | **✓ 第一个点名的技术** |
| 光电/手势无接触 | ★★★★ | ★★（环境光/标定） | 1 天+ | 每路 1-2 根 | ✓ |
| 外购 MIDI 键盘 | ★（拼接不加分） | ★★★★★ | 零 | 串口 | — |

- **检验句**："断一根线还能演吗？"（演示冗余原则：主链断了兜底链在）
- **ZCode 观察（非结论）**：电容触摸主演奏面 + UART 键盘兜底 + 定序器脱机压轴 = 三级冗余。
  手势/光电不做主线（决赛现场环境光不可控）。

## 决策 ③：F3 四种指令的映射 【第一批，零硬件风险】

| 指令 | 映射设计 | 可观测证据（答辩用） |
|---|---|---|
| 选音 | 单键 valid+on 边沿 | 对应音高谱峰出现 |
| 和弦 | 时间窗（如 20ms）内 ≥2 键 valid → 同时装载多组 | 频谱同时出现多列谐波 |
| 拨弦 | on→off 间隔 < 阈值（如 150ms）→ 短衰减 epar/拨弦音色 | 包络衰减率对比（长按 vs 短按） |
| 触发 | valid 边沿本身（已有） | 起音瞬态 |

- **检验句**："每种指令在音频上有什么可观测的不同？"（答不出 = 假识别）
- 实现层：note_map 加窗口计数 + 门宽分类，纯 RTL，无硬件依赖。

## 决策 ④：表情维度分配（≥3 维，E2 RTL 已就绪，缺物理输入接入）

| 轴 | 物理来源 | RTL 侧现状 |
|---|---|---|
| 力度 velocity | 触摸电容计数值大小 → ev_vel（4bit 已预留） | ev_vel 路径已有 |
| 滑音 glide | 触摸滑条位置（多电极插值） | glide 寄存器已有 |
| **塑谱（谱心/谱宽）** | 滑条第二轴 或 上位机旋钮 → 逐泛音 amp | **逐泛音 amp 运行时可写已有** |
| 颤音 | 上位机/寄存器（或 LFO 自动） | vib 深度/速率寄存器已有 |

- **检验句**："两个表情维度同时独立调节时，示波器/频谱上互不干扰吗？"
  （这是 M1"独立可控"的现场证明方法——提前设计好这个演示动作）

## 决策 ⑤：演示叙事（8 分钟脚本）【死线前 2 周，只有你能答】

建议结构骨架（内容你填）：
1. 开场 30s：**脱机定序器**演奏一段（证明"它自己就是乐器"，不依赖任何电脑）
2. 2 分钟：UART 键盘实时演奏 + 表情轴（证明"可演奏"）
3. 3 分钟：**塑谱演示**——长按一个音，右手滑条实时改变泛音结构（频谱仪同屏：这是 FPGA 不可替代性的可视化）
4. 兜底：任一环节失效 → 降级到下一层（触摸→键盘→定序器）
5. 红线自证收尾：测试模式 32 谱峰（评委可数的振荡器证据）

---

## 附：RC 电容触摸测时原理（30 秒版，答辩要会讲）

IO 引脚输出高 → 电极充电 → 切输入 → 数放电到阈值需多少个时钟。
手指靠近 = 极板电容变大 = 放电变慢 = 计数值变大。**无 ADC、纯数字**，
与本项目"相位累加器数周期"是同一种思想（数时钟 = 测物理量）。
参数量级：27 MHz 计数、16 bit 计数器、每键扫描 < 100 µs、8 键轮询一遍 < 1 ms（≪10 ms 预算）。

## 待办与归属

| 批次 | 内容 | 谁执行 |
|---|---|---|
| 第一批（拍板①③后立即） | 事件协议串行化 + F3 指令识别 RTL + 上位机键盘桥 | DeepSeek(RTL) + ZCode(协议/上位机) |
| 第二批（板到手第 1 周） | UART 键盘演奏跑通（M1 保底）→ 铜箔触摸实验（2 根排针起步） | 用户(手作) + ZCode(判据) |
| 第三批（死线前 2 周） | 塑谱轴接物理输入 + 演示脚本定稿 + 现场冗余演练 | 全员 |

---

## 决策 ⑥：右手"塑谱"的交互方式（核心概念题）【分两版走】

> 拆题框架：右手交互 =（感知原语）×（提取统计量）×（映射到频谱参数）。
> 三层分开答，就不是等灵感而是做填空。

### 候选菜单

| # | 方式 | 硬件 | 可靠性 | 评委看到什么 | 成本 |
|---|---|---|---|---|---|
| 1 | 泛音键排：8 电极=8 泛音，摸哪根哪根响（拉杆风琴实时化） | 与左手同一套触摸代码 | ★★★★★ | 摸第 3 根→第 3 根谱线立起 | 最低 |
| 2 | 电极条：位置质心→谱心（频谱鼓包左右滑） | 8 电极条 | ★★★★ | 鼓包跟手滑动 | 低 |
| 3 | 接触展开度→谱宽（宽指=泛音列宽，指尖=单泛音） | 同上（纯二值统计） | ★★★★ | 谱包络胖瘦变化 | 低（与 2 共享硬件） |
| 4 | 滑动速度→谱形变化速率 | 零新增（位置导数） | ★★★★ | 慢抹渐变/快甩瞬变 | 最低 |
| 5 | 非谐度轴：管风琴↔钟连续变形 | 零（上位机先行） | ★★★★ | 纯谐波滑成钟声 | 中（note_map 比例插值） |
| 6 | 无接触距离→亮度 | 光电/RC | ★★ | 悬空挥舞控音色 | 高 |
| 7 | 上位机鼠标 X-Y | 零 | ★★★★★ | （开发/兜底层） | 零 |

### ZCode 建议（非结论）

- **第一版 = 方案 1（泛音键排）**：与左手共享全部传感代码与风险等级；映射一句可讲；
  逐泛音 amp 通路已运行时可写，只差"触摸读数→寄存器写"。
- **第二版 = 方案 2+3+4（电极条三轴）**：质心/展开/速度三个连续轴从同一排二值电极
  长出来——避开"定量电容测量"这个已标注的最大物理风险（9/23 审计）。
- **方案 5 单独走上位机先行**；**方案 6 不做主线**（决赛环境不可控）。
- **架构减负**：谱形映射计算放上位机（右手→几个字节→PC 算 16 泛音幅度→UART→引擎），
  RTL 零新逻辑；脱机模式再固化成 RTL 查找表（同曲谱 ROM 模式）。
- 检验句："**右手做不同动作时，频谱仪上的谱形变化是否一一对应、且正在响的音立即变形？**"

### 用户批复（2026-10-02）

- [x] 第一版右手 = **泛音键排**（DeepSeek 核验修正：需谱 RAM+刷新+12→16 路 pads，非零 RTL）；
- [x] 第二版 = **MPR121/CAP1188（I2C）电极条**（真连续），等板子；二值电极只做 8 档+滞回（D7）；
- [x] 非谐度轴进演示脚本，**RTL 直接做、PC 兜底**（D8：M1 判定口径）；
- [x] **左手 4→8 键（五声音阶 C4 D4 E4 G4 A4 C5 D5 E5）**，总 pads 16，引脚 16/18（规格：`20-pad扫描规格书.md`）；
- [x] **协议修正案 A1：0x63 = SPEC_REFRESH（逐声部独立塑形）**——对 Hammond"全局注册"的差异化关键；
- 定位框架：Hammond/Teleharmonium/Fairlight = 谱系而非模仿对象（报告叙事：拉杆从设置变演奏面、全局变逐音、谐波变任意谱形+模态演化）。

开放残留（上板后调）：pad→幅度曲线、叠加底谱选择、铜箔尺寸间距手感。
