sakuyaShining/FPGA-Music-project-internal/docs/03-学习路线/01-9月24日回归验收清单.md

# 9 月 24 日回归验收清单

> 目的：把"我希望你回来时会什么"变成**可自测的勾选项**。
> 基准日：2026-09-18（今天）→ 2026-09-24（回归，还剩 **41 天** 到提交）
> 原则：**不追求"完备"，只追求"能独立完成一个最小闭环"。**

---

# 零、先校准预期

**6 天学不出"完备的 FPGA 基础"**，这是事实。但**项目也不需要完备**。

这个项目真正用到的技能，只占 FPGA 知识体系的一小块：

```
整个 FPGA 知识体系
├── 需要 ✅  Verilog 基础语法 / 时序逻辑 / 计数器 / 状态机 / 仿真 / 工具链流程
├── 需要 ✅  定点数思维 / 位宽管理 / 流水线概念 / BRAM / DSP 基本用法
├── 需要 ✅  会看资源报告与时序报告
├── 不需要 ❌ SDRAM/DDR 控制器、高速接口（PCIe/MIPI/以太网）
├── 不需要 ❌ 复杂 IP 集成（软核 CPU、AXI 总线）
├── 不需要 ❌ 高级时序约束（多周期路径、false path、时钟组）
└── 不需要 ❌ PCB 设计、信号完整性、电源完整性
```

→ **把 6 天全部投在"需要"那一栏，足够了。**

---

# 一、必须会（回来后立刻要用）

每一项都写成**可自测的动作**。能做出动作 = 会了；只是"看过" = 不会。

## A. 工具链闭环（最重要，优先级最高）

| # | 验收动作 | 自测方法 |
|---|---|---|
| A1 | 能**从零**建一个 Gowin 工程，器件选对 | 器件选 **GW2AR-18C** → 封装 **QFN88** → 型号 **GW2AR-LV18QN88C8/I7** |
| A2 | 能写 `.cst` 把信号绑到真实引脚 | 例：把 `led` 绑到某个引脚，烧进去灯真的亮 |
| A3 | 能走完 **综合 → 布局布线 → 烧录** | 板子上出现你预期的现象 |
| A4 | 能找到**资源报告**里的 LUT / FF / BSRAM / DSP 占用 | 说出你的点灯工程占了多少 LUT |
| A5 | 能在**时序报告**里找到 **WNS** | 知道 WNS < 0 是什么意思（时序没满足） |

> **A 组是硬门槛。** 如果 6 天只能做一件事，做这一组——因为后面所有工作都跑在这个流程上。

## B. Verilog 核心（够用即可，不用学全）

| # | 验收动作 |
|---|---|
| B1 | 能写一个 1 Hz 闪烁 LED（用计数器分频） |
| B2 | 说得清 `wire` 和 `reg` 的区别，说得清**为什么时序逻辑要用非阻塞赋值 `<=`** |
| B3 | 能写一个计数器，并用它产生一个"每 1000 个时钟来一次"的**使能脉冲**（clock enable） |
| B4 | 能用 `case` / `if` 写组合逻辑 |
| B5 | 能用 `parameter` 参数化一个模块，能说出 `generate` 是干什么的 |
| B6 | 能写一个简单的状态机（哪怕只是"等待→工作→完成"三态） |

## C. 心智模型（比语法更重要）

| # | 验收动作 / 能回答的问题 |
|---|---|
| C1 | 能解释：**"FPGA 里代码不是顺序执行的，而是同时存在的硬件"** |
| C2 | 能解释：**"一个 `always @(posedge clk)` 描述一组寄存器，每个时钟上升沿才更新一次"** |
| C3 | 能解释：**"组合逻辑有传播延迟，时序逻辑按周期推进"** |
| C4 | 知道**位宽要自己管**，知道两个 16 位数相加可能变成 17 位 |
| C5 | 能解释：**"为什么 FPGA 能做'同时算 100 个东西'，而 CPU 不行"** |

> **C 组是"能不能独立判断"的分水岭。** 语法忘了可以查，心智模型错了会写出完全错的架构。

## D. 仿真（必须有，否则等于盲写）

| # | 验收动作 |
|---|---|
| D1 | 能写一个最简单的 testbench：产生时钟、给激励、跑仿真 |
| D2 | 能看波形（Gowin 自带仿真 或 Icarus Verilog + GTKWave），并**从中看出问题** |
| D3 | 有过至少一次"仿真发现 bug"的真实经历 |

## E. 定点数（建议会，不会也能边做边补）

| # | 验收动作 |
|---|---|
| E1 | 知道 Q 格式是什么（如 Q1.15 表示 16 位有符号小数） |
| E2 | 知道 16 位有符号数的范围是 −32768 ~ +32767 |
| E3 | 知道两个 Q1.15 相乘，结果要右移 15 位才是 Q1.15 |

---

# 二、回来后**立刻**能开工的验收仪式

**如果只能做一个自测，做这个：**

> ### 🎯 30 分钟挑战
> **计时 30 分钟，从零开始：**
> 1. 新建 Gowin 工程（器件 GW2AR-LV18QN88C8/I7）
> 2. 写一个 LED 闪烁的程序
> 3. 写 `.cst` 绑定引脚
> 4. 综合 + 布局布线
> 5. 烧录
> 6. **板子上的灯按你的预期闪了**
> 7. 打开资源报告，说出 LUT 占用数字
>
> **30 分钟内完成 = 你准备好了。**
> 超时没关系，但要知道卡在哪一步——那一步就是我们回来第一个要解决的。

---

# 三、**不需要**现在会（别浪费时间）

| 不需要 | 为什么 |
|---|---|
| SDRAM / DDR 控制器 | 我们的效果器用片内 BSRAM 就够 |
| 高速接口（PCIe / MIPI / 千兆网） | 本项目用不到 |
| 软核 CPU / AXI 总线 | 赛题要求"纯 FPGA HDL"，不用软核 |
| 复杂 IP 集成 | 我们只需要 rPLL（时钟）一个 IP |
| 高级时序约束 | 单时钟域设计，约束简单 |
| PCB 设计 / 信号完整性 | 我们的硬件是铜箔 + 杜邦线 |
| SystemVerilog 高级特性 | 纯 Verilog-2001 足够 |
| 形式验证 / UVM | 用不上 |

> **如果教程里有这些章节，可以先跳过。** 它们不是本项目的前置条件。

---

# 四、如果 6 天不够，优先级怎么砍

```
第 1 优先  A 组（工具链闭环）        ← 不做完这个，后面全部无法开始
第 2 优先  B1 B2 B3（计数器和时序逻辑）← 项目 80% 的代码是这些
第 3 优先  D1 D2（仿真）              ← 不做仿真的话，调试成本会翻倍
第 4 优先  C 组（心智模型）           ← 可以在做的过程中建立
第 5 优先  B4 B5 B6（case/参数化/状态机）
第 6 优先  E 组（定点数）
```

**最低底线：A 组全部 + B1 + B3。** 有任何一天的时间，先保这四项。

---

# 五、回来之后，**你不必独自扛**的部分

| 你负责 | 我负责 |
|---|---|
| 判断与拍板（架构、概念、取舍） | 把选项、代价、赛题影响摊开 |
| 理解每一行为什么这么写 | 逐行注释 + 讲清原理 |
| 决定项目往哪走 | 写代码骨架、查资料、排坑、跑验证、维护文档 |
| 最终对作品的理解（决赛要答辩） | 帮你准备答辩材料与自证实验 |

**具体说，回来后的分工预期**：
- **TDM 调度器 / 定点数值设计 / 时序收敛** —— 这些是最难的部分，我会给方案和代码，但要你能讲明白
- **决策框架 v2 的 D0~D8** —— 决策权仍在你，我只提供选项
- **4 个验证实验（E0~E3）** —— 我准备脚本与测试方法，你上板执行

---

# 六、除了技能，希望你还带回来的四样东西

| # | 带回来什么 | 为什么重要 |
|---|---|---|
| **1** | **一个日期**（9/24） | 我要重算剩余天数并重排计划（41 天，不是 47 天） |
| **2** | **你被哪个概念打动了** | 07 方案 / 08 灵感库里，哪个让你"心里动了一下"？这决定 D0 |
| **3** | **学习时卡住的问题清单** | 卡过的地方往往是真实的技术难点，值得优先解决 |
| **4** | **USB 驱动装好了没** | 那个 UAC 弹窗需要你手动点【是】，我点不了 |

---

# 七、一句话

> **我不需要你"完备"。**
> **我需要你能独立完成一个最小闭环：建工程 → 写代码 → 约束 → 烧录 → 看报告。**
>
> 剩下的，我们一起做。

---

## 附：回归当天我们会做什么

1. 你告诉我日期 → 我重算剩余天数
2. 检查 `docs/01-竞赛情报/monitoring-log.md`（周检有没有发现官方新内容）
3. 你做完上面的「30 分钟挑战」
4. 根据结果决定：直接进 Phase 0（4 个验证实验），还是先补 1–2 天基础
5. 你从 07/08 里挑方向，我们开始推 D0

**See you on the 24th.** 🎹
