sakuyaShining/FPGA-Music-project-internal/hardware/sourcing-closure-20261030/assembly-bom-20261030/C88-S2x6-ALT-C1591-QUOTE-37SKU-256pcs.csv

LCSC | MPN | C88_qty | six_S2_qty | EP84_header_qty | net_quantity_only | board_refs | assembly | supplier_minimum_attrition_quote
C105579 | RC0603FR-0747KL | 0 | 6 | 0 | 6 | B0.R1;B1.R1;B2.R1;B3.R1;B4.R1;B5.R1 | SMT | PENDING
C106794 | TPD4E02B04DQAR | 0 | 24 | 0 | 24 | B0.D1;B0.D2;B0.D3;B0.D4;B1.D1;B1.D2;B1.D3;B1.D4;B2.D1;B2.D2;B2.D3;B2.D4;B3.D1;B3.D2;B3.D3;B3.D4;B4.D1;B4.D2;B4.D3;B4.D4;B5.D1;B5.D2;B5.D3;B5.D4 | SMT | PENDING
C110499 | DMP2035U-7 | 1 | 0 | 0 | 1 | C88.Q1 | SMT | PENDING
C133541 | SN74LVC14ADR | 0 | 6 | 0 | 6 | B0.U2;B1.U2;B2.U2;B3.U2;B4.U2;B5.U2 | SMT | PENDING
C14858 | CL10C101JB8NNNC | 0 | 6 | 0 | 6 | B0.C4;B1.C4;B2.C4;B3.C4;B4.C4;B5.C4 | SMT | PENDING
C158012 | B2B-XH-A(LF)(SN) | 1 | 0 | 0 | 1 | C88.J13 | TH | PENDING
C1591 | CL10B104KB8NNNC | 13 | 12 | 0 | 25 | C88.C10;C88.C11;C88.C22;C88.C23;C88.C24;C88.C25;C88.C33;C88.C34;C88.C35;C88.C36;C88.C8;C88.C9;C88.CX1;B0.C1;B0.C2;B1.C1;B1.C2;B2.C1;B2.C2;B3.C1;B3.C2;B4.C1;B4.C2;B5.C1;B5.C2 | SMT | PENDING
C1592 | CL10A105KO8NNNC | 1 | 0 | 0 | 1 | C88.C32 | SMT | PENDING
C1607 | CL10A225KP8NNNC | 8 | 0 | 0 | 8 | C88.C20;C88.C21;C88.C26;C88.C30;C88.C31;C88.C37;C88.C38;C88.C39 | SMT | PENDING
C1634 | CL10C100JB8NNNC | 0 | 6 | 0 | 6 | B0.C3;B1.C3;B2.C3;B3.C3;B4.C3;B5.C3 | SMT | PENDING
C179326 | 74HC4067PW,118 | 0 | 6 | 0 | 6 | B0.U1;B1.U1;B2.U1;B3.U1;B4.U1;B5.U1 | SMT | PENDING
C205940 | SN74LV595ADR | 1 | 0 | 0 | 1 | C88.U8 | SMT | PENDING
C210834 | MF-MSMF110/16-2 | 1 | 0 | 0 | 1 | C88.F1 | SMT | PENDING
C22465876 | PZ254V-11-16P | 6 | 12 | 0 | 18 | C88.JB0;C88.JB1;C88.JB2;C88.JB3;C88.JB4;C88.JB5;B0.J1;B0.J2;B1.J1;B1.J2;B2.J1;B2.J2;B3.J1;B3.J2;B4.J1;B4.J2;B5.J1;B5.J2 | TH | PENDING
C22548 | RC0603FR-071KL | 2 | 84 | 0 | 86 | C88.R71;C88.R73;B0.R3;B0.R4;B0.R5;B0.R6;B0.R7;B0.R8;B0.R9;B0.R10;B0.R11;B0.R12;B0.R13;B0.R14;B0.R15;B0.R16;B1.R3;B1.R4;B1.R5;B1.R6;B1.R7;B1.R8;B1.R9;B1.R10;B1.R11;B1.R12;B1.R13;B1.R14;B1.R15;B1.R16;B2.R3;B2.R4;B2.R5;B2.R6;B2.R7;B2.R8;B2.R9;B2.R10;B2.R11;B2.R12;B2.R13;B2.R14;B2.R15;B2.R16;B3.R3;B3.R4;B3.R5;B3.R6;B3.R7;B3.R8;B3.R9;B3.R10;B3.R11;B3.R12;B3.R13;B3.R14;B3.R15;B3.R16;B4.R3;B4.R4;B4.R5;B4.R6;B4.R7;B4.R8;B4.R9;B4.R10;B4.R11;B4.R12;B4.R13;B4.R14;B4.R15;B4.R16;B5.R3;B5.R4;B5.R5;B5.R6;B5.R7;B5.R8;B5.R9;B5.R10;B5.R11;B5.R12;B5.R13;B5.R14;B5.R15;B5.R16 | SMT | PENDING
C22912 | 0603WAF2372T5E | 1 | 0 | 0 | 1 | C88.R67 | SMT | PENDING
C22962 | 0603WAF2200T5E | 0 | 6 | 0 | 6 | B0.R2;B1.R2;B2.R2;B3.R2;B4.R2;B5.R2 | SMT | PENDING
C23162 | 0603WAF4701T5E | 5 | 0 | 0 | 5 | C88.R33;C88.R34;C88.R52;C88.R60;C88.R61 | SMT | PENDING
C23179 | 0603WAF4700T5E | 2 | 0 | 0 | 2 | C88.R41;C88.R42 | SMT | PENDING
C247920 | 2.54-1*12P反弯针 | 1 | 0 | 0 | 1 | C88.J10 | TH | PENDING
C25803 | 0603WAF1003T5E | 5 | 0 | 0 | 5 | C88.R63;C88.R64;C88.R66;C88.R68;C88.R69 | SMT | PENDING
C273656 | SN74LV165ADR | 2 | 0 | 0 | 2 | C88.U9;C88.UX1 | SMT | PENDING
C318884 | TS-1187A-B-A-B | 8 | 0 | 0 | 8 | C88.SW2;C88.SW3;C88.SW4;C88.SW5;C88.SW6;C88.SX1;C88.SX2;C88.SX3 | SMT | PENDING
C33353 | CL10C222JB8NNNC | 2 | 0 | 0 | 2 | C88.C27;C88.C28 | SMT | PENDING
C411625 | 24LC256-I/SN | 1 | 0 | 0 | 1 | C88.U10 | SMT | PENDING
C4190 | 0603WAF2201T5E | 2 | 0 | 0 | 2 | C88.R50;C88.R51 | SMT | PENDING
C470754 | EC11E15244B2 | 1 | 0 | 0 | 1 | C88.SW1 | TH | PENDING
C49257 | 2.54-1*3P针 | 1 | 0 | 0 | 1 | C88.J12 | TH | PENDING
C503437 | 74LVC1G157GV,125 | 1 | 0 | 0 | 1 | C88.U11 | SMT | PENDING
C50984 | 2.54-1*20P母 | 2 | 0 | 0 | 2 | C88.J5;C88.J6 | TH | PENDING
C51118 | AP2112K-3.3TRG1 | 2 | 0 | 0 | 2 | C88.U13;C88.U18 | SMT | PENDING
C544515 | TCA9517DGKR | 1 | 0 | 0 | 1 | C88.U14 | SMT | PENDING
C55266 | TPS2553DBVR | 1 | 0 | 0 | 1 | C88.U17 | SMT | PENDING
C7668 | SN74LVC244APWR | 1 | 0 | 0 | 1 | C88.U15 | SMT | PENDING
C7836 | SN74LVC1G17DBVR | 1 | 0 | 0 | 1 | C88.U16 | SMT | PENDING
C962071 | PCM5122PWR | 1 | 0 | 0 | 1 | C88.U12 | SMT | PENDING
C98220 | RC0603FR-0710KL | 13 | 0 | 0 | 13 | C88.R30;C88.R32;C88.R40;C88.R53;C88.R54;C88.R55;C88.R56;C88.R57;C88.R62;C88.R70;C88.RX1;C88.RX2;C88.RX3 | SMT | PENDING
