sakuyaShining/FPGA-Music-project-internal/hardware/team-handoff-20261030/audio/J12音频输出插座-采购与装配.md

# J12音频输出插座：采购与装配（2026-10-30）

用户最新决定：有源音箱借用，不再代选或列入新购；本次只解决音频引出接口。控制板冻结BOM的J12是C49257、1×3P、2.54mm公排针，针序1=AUX_L、2=AUX_R、3=GND。保留控制板设计与制造源。

## 插座选型

选用 **XKB Connection/中国星坤 PJ-301M-3-B，C381127**，国内立创商品页：
https://item.szlcsc.com/353359.html

它是3.5mm TRS双声道插座，带螺母、三焊片，可穿面板固定。注意型号中是 **-3-B**；相近的-2-B/-2-Y是TS单声道，不采购。原C19189087是PCB插装候选，退出本次面板固定插座的首选项。

实装需要1套（插座及配套螺母）。库存/销售起订倍数以国内结算页面为准，若最低5套，才按最低5套下单，实装1套其余备用。LCSC公开接口本次返回库存620、5件档US$0.2194/件；仅作海外接口快照，不是国内人民币报价或发货承诺。不能从这份数据推定国内可单买1套。

这是**未焊引线的器件**；尚未核实到整条“J12母头到此插座”的可直接购买成品SKU。不能把器件购买说成预焊组件已经到手。

## 确定的连接合同

|控制板端|线束标识|插入的TRS公头对应触点|
|---|---|---|
|J12.1 AUX_L|L|Tip，最尖端|
|J12.2 AUX_R|R|Ring，中间一段|
|J12.3 GND|G|Sleeve，靠线缆的根部|

板端为1×3、2.54mm杜邦压接母头，适配0.64mm方针；不能用PH2.0或XH2.5插头直接替代。插座端焊接，建议将内部线先做200mm长、双芯加屏蔽的柔性音频线；屏蔽层接J12.3及插座Sleeve，各焊点单独热缩绝缘。200mm是可裁短的装配默认值，最终走线应尽量短并避开开关电源和数字总线。

装配时依据实际插座和TRS插头的导通结果接线，不凭焊片位置、线色或相近型号编号猜左右。当前厂家图有2/3/5端子标识，但本交付未将其无歧义换算为Tip/Ring/Sleeve，因此按下述三触点导通检验验收；不编造物理焊片针号。

## 安装方式

随本记录保存的C381127.pdf是该商品的厂家图，已打开渲染检查：前端螺纹M6×0.5，螺纹段约5.5mm。用配套螺母夹紧绝缘薄面板；可先在废料试钻约6.2mm通孔，面板/垫片总厚度先按1.5–2mm评估，实物试装后再开正式孔。正式装机坐标随整机结构确定，不因选定插座锁定外壳尺寸。

插拔受力由面板和螺母承受，不由J12排针或焊线承担。焊线附近加独立扎带应力释放，螺母内侧留绝缘及弯线空间，不能以热熔胶单独承担反复插拔。

## 不自行焊线时的采购路径

立创商城官方有线束定制入口：https://cable.szlcsc.com/ 。可将下面规格与本记录交其评估，要求卖方明确能否焊此音频座、最低数量、配套螺母、总价和发货日。该服务入口已确认，但本项目线束可接单/报价/交期**尚未取得确认**，本会话未向商家发送消息。

> 定制音频引出线1条：板端1×3P、2.54mm杜邦压接母头，适配0.64mm方针，孔位1=L、2=R、3=GND；另一端预焊星坤PJ-301M-3-B/C381127的3.5mm TRS双声道面板插座并附配套螺母。内部线有效长度约200mm，双芯屏蔽柔线，L接Tip、R接Ring、GND/屏蔽接Sleeve，焊点分别热缩绝缘，两端永久标号。插座穿板固定，焊线加应力释放。请逐线导通检验、确认三网互不短接，回传接线照片，并列出含料/焊接/测试/税运总价、最低数量与发货时间。不要用TS单声道插座替代。

如由用户/装配人员焊接，可按同一连接合同完成；无须重画控制板或另做功能PCB。若使用PCB排母代替压接母头，可采购BOOMELE 2.54-1*3P母/C146243（https://item.szlcsc.com/157575.html），但还需在排母尾脚焊线、绝缘和应力释放，不能称为预压接成品线。优先压接母头方案。

## 装配验收

1. 全部断电，线束暂不接控制板；插入普通三段TRS插头，用万用表确认母头孔1只通Tip、孔2只通Ring、孔3只通Sleeve，不能短路或反接。绝缘环分段，不能将四段TRRS耳麦头作默认验收件。
2. 拔插数次并轻拉线束，重复导通测试，确认插座不转动、焊点不受力。
3. 接J12前核对板上1脚标识与三线标签，避免将无防呆母头反插。
4. 首次接借来的音箱/功放只接AUX/LINE IN，低音量开始，用左/右独立测试音确认左右及无异常噪声。该输出是线路输出；不直接接无源喇叭或普通低阻耳机。

当前完成：插座精确商品、机械固定路线、J12到TRS功能映射、预焊线束规格和验收步骤。未完成：国内实际结算价、预焊线束供应商接单及报价、实物制作/导通测试；不声称已购买或已实装。
