sakuyaShining/FPGA-Music-project-internal/hardware/current/module-plan/manufacturing/SCREEN-SELECTION.md

# J10 屏幕选型核验（2026-10-27）

状态：**技术首选已明确，采购型号配置、含运总价与发货时间未闭环**。用户明确表示尚未取得原报价，要求使用嘉立创工具继续获取资料并选型。本页不把未配置标价当作成交价。

| 项目 | 首选 EastRising ER-TFTM070-5V4 | 备选 Waveshare 8964 |
|---|---|---|
| 显示 | 7英寸、800×480、RA8875 | 7英寸、800×480、RA8875 |
| 需要的配置 | 4线SPI、5V、FT5316电容触控、预焊40针及配线 | 官方默认8080并口；是否可由供货方配置SPI待核 |
| 触控 | V4采用FT5316，不能沿用旧FT5206型号假设 | GT911，驱动及复位/地址选择须适配 |
| 供电 | 5V选项；原厂列LCM最大300mA@5V（不能据此推定所有附件总峰值） | 官方列3.0–3.6V，不能接现有5V屏电源 |
| 连接 | 40针焊接和线材必须在最终配置中明确 | 随附40针FFC，不等于现有40针排针线兼容 |
| 公开价格 | 旧抓取基础标价273.22元/40.18美元，未含全部指定选项，不能计为最终报价 | 官方商城公开产品API数量1价格326元，未证实运费、SPI改配费或发货日 |
| 当前结论 | 保留为技术首选，尚不可下单冻结 | 作为需改电源/驱动/接口的备选，未批准替换 |

嘉立创/LCSC工具未检得符合上述完整配置的RA8875七寸成品模块。未检得不证明市场不存在，也不把不同控制器、HDMI/DSI/RGB屏或电阻触控屏替代进BOM。嘉立创EDA网关在线但当前没有连接的EDA窗口，不能声称已在客户端完成在线器件库核验或生成制造文件。

最终报价必须逐项确认：完整型号及V4版本、4线SPI出厂跳线/配置、5V供电、FT5316触控及I2C电平、预焊40针的方向/间距/针号、匹配线材两端定义、是否包含连接器/运费/税、发货日期及到广东清远的预计送达日。没有报价和交期证据时保持空值，不用官网泛称“有货”推定可到货。

当前并未向供应商发送消息或订单。后续若需要询价，应以以上配置作为完整询价条件；本页是技术选型记录。

依据（价格/库存均须使用时复核）：

- [EastRising原厂商品页](https://www.buydisplay.com/7-inch-lcd-module-capacitive-touch-screen-panel-i2c-spi-serial)：RA8875、800×480、V4/FT5316更新、供电选项及LCM电流。搜索索引可读，直接访问返回403，未绕过限制。
- [微雪中国官方商品页](https://www.waveshare.net/shop/7inch-Capacitive-Touch-LCD-C.htm)及该页官方公开[产品API](https://api.waveshare.net/api/v1/goods/123)：2026-10-27读取326元。原始API响应保存于本目录`waveshare-8964-public-product.json`，不含收货信息或订单。
- [微雪原厂商品资料](https://www.waveshare.com/product/displays/lcd-oled/7inch-capacitive-touch-lcd-c.htm)与[原理图](https://files.waveshare.com/upload/7/79/7inch_Capacitive_Touch_LCD_C_GT911.pdf)：供电、GT911及接口需联合核验；SPI信号存在不等于已预配置且可直接替换。
