sakuyaShining/FPGA-Music-project-internal/docs/02-技术方案/64-七英寸整机降本候选与选择性装配-2026-10-16.md

# 七英寸整机降本候选与选择性装配 · 2026-10-16

状态：**讨论中**。承接用户“继续优化、压缩成本”，保留约500元新增采购目标，约7英寸右手触摸显示、两八度逐音滑条、独立八度档位、四槽自定义/断电保存、分层、伴奏录放＋现场演奏及AUX。没有替用户冻结新音乐规则、缩屏、合并逐音滑条或购买第二计算板。

## 1. 本轮有证据的降本候选

独立表见`hardware/cost-compression-20261016/`，旧BOM/63号成本证据原样保留。两种原数量端点仍仅算例，价格为公开参考，不是结算报价。

|项目|原26音位采购参考|新候选采购参考|潜在差额|门槛|
|---|---:|---:|---:|---|
|6颗16选1开关|TI CD74HC4067M96，28.6632元|Nexperia 74HC4067PW,118/C179326，6×1.49=8.94元|19.7232元|新TSSOP24焊盘、3.3V RC计时/寄生/漏电验证|
|83节点保护|TI单通道，购85颗49.8168元|台舟四通道C2841426，装22颗/购25颗×0.3392=8.48元|41.3368元|本厂规格/脚号/封装、漏电、电容与串扰实测|
|其余原部分电子料|45.4849元|45.4849元|0元|原资格继续挂账|
|部分电子料合计|123.9649元|62.9049元|**61.06元**|尚未获得完整资格/数量档结算|

原TI两项来自国际USD阶梯×假设7.2；新两项是国内JSON-LD公开Offer，所需数量档未验。差额表示原成本模型的条件下降，不能称同条件竞价已省61.06元或已经支付这一价格。25音位算例潜在差额58.1296元。

- [Nexperia国内商品](https://item.szlcsc.com/190720.html)：精确MPN/C码、TSSOP24、销售增量1、库存9073颗已读取；[原厂手册](https://assets.nexperia.com/documents/data-sheet/74HC_HCT4067.pdf)支持HC供电2～10V。HCT不可直接用3.3V替代。
- [台舟国内商品](https://item.szlcsc.com/3023524.html)：精确MPN/C码、DFN2510-10、销售增量5、库存5121颗；[原厂5页规格](https://atta.szlcsc.com/upload/public/pdf/source/20210623/C2841426_3BD48A1F2533C69C8EEEB2CADAAA6EED.pdf)已下载并目视核表、引脚、机械/焊盘，不借TI同名规格。

四通道并非通用“集成就便宜”。TI四通道的当前小量价比原单通道方案更贵；已停售CD4067也不作低价采购。替代品仍有资格差距，细节见`hardware/cost-compression-20261016/qualification.md`。

## 2. 保护分组与小样门槛

为了不把全部高阻电极用长排线引到中心，按每排及八度区就近分组。26音位例每排39节点，各10颗四通道，八度5节点2颗，共22颗，按增量5买25。25音位例36＋39＋5节点需9＋10＋2=21颗，也买25。不能为了只装ceil(83/4)=21颗牺牲走线条件；最终节点数/拓扑未冻结。

台舟电容**0.25pF典型、0.4pF最大**，条件写为0V/1MHz且I/O之间；最大漏电10nA仅在±2.5V、25°C测试。它不是原TI单通道最大0.25pF的已验证等价品，也未证明3.3V/全温漏电或邻通道串扰。p1与p5高度差异记录在资格表，按最大高度预留。下一步隔离小样比较轻触/多指轨迹、基线漂移、屏/TF同时活动、供电变化与保护回路；通过后再替换制造BOM。

## 3. 用户装配条件已明确

用户本轮确认：**可焊排针、按键和普通贴片，小封装交给工厂**。

据此准备选择性装配：普通阻容/连接件/按钮/旋钮可由用户完成，DFN保护、TSSOP MUX及DAC等小封装优先SMT。单面布局、重复排板拼板和小载板作为报价比较目标；保护/前端须就近电极，不能先承诺所有SMT都塞进10×10cm中心板。最终分工须结合焊盘、工具与DFM，不以“普通贴片”推定用户愿意焊所有TSSOP。

100元制造项暂不降低：钢网/工程/最小批次/重复工装/供料/分板和运输仍缺真实报价。保护器件少了但脚数不同，不能直接按颗数推算装配节省。简单平板＋支柱＋覆膜优先于定制外壳，操作面积与间距保留；40元结构预留也未当成已取得低价。

用户随后确认已有5V3A电源，之后可提供型号/铭牌；记为已有硬件线索，实际输出能力/接口/整机负载资格待核。45元电源/线材/路径合项预留暂不直接扣除，按确定无需新增的条目扣减，供电保护和布线成本仍须保留。已有Nano20K、YT240L008N和喇叭、板上TF座/SDRAM继续复用，不重复购买ADC/播放器/独立存储模块。

## 4. 当前预算能压到哪里

保持63号全部315元未报价预留，替代部分料后：

`62.9049电子料＋315原预留＋180屏幕参考=557.9049元`。

180元仍是MRB7966厂家USD25样品EXW×**假设**7.2，不是国内含运价；该屏为16位并口，适配未实现/未报价。若另加20元接口敏感度变量，则为577.9049元；20元不是适配BOM报价。MSP7001参考216元的对应情景为593.9049元，控制器/触点资格仍缺；ER的273.22元基础屏对应651.1249元，电容选配仍缺。不同屏价格不能脱离接口开发与选配比较。

因此，已有依据的方向是把原约619元参考情景降至约558元，**500元尚未闭环**。即使全部替代通过，仍需再落实约58元下降，并覆盖尚缺的接口/完整屏配置费用。用户已报告有电源，资格核对后可扣相应采购费；若极限假设45元整项全部可复用，条件情景为512.9049元，但实际电源路径/线材仍可能新增，不能整项扣45，现在不采用此数作为预算。普通件自行焊接可缩小SMT范围，实际节省额仍待制造报价。

本轮没有把制造/结构/运输/预备费纸面调小来宣布达标。下一步优先：

1. 验证新前端/保护小样，合格后把约61元潜力转为确定BOM；普通器件与小封装按用户装配条件拆单。
2. 收口7英寸整屏的确切显示IC/多点触摸版本、实际接口和国内含运小量价；总价包括适配，而非只买低价裸屏。
3. 按实际板外形/拼板/SMT清单取得选择性装配完整报价，与完整装配比较，合并采购运输但不默认免运或券资格。
4. 继续用500元约束作采购闸门；实价仍超出时报告真实差额，不替用户加预算或删功能。

## 5. 版本与实际验证

来源HEAD `fe326ad9505c94f46f9236bf7f9bfc3b5f1b9a12`。本轮只新增公开取证/算例脚本、成本资料并更新39/49；无产品RTL/协议/约束、旧BOM、原理图/PCB、旧快照修改，无采购/制造/外部联系。已有未提交工作保持。

资料核对：3条商品身份读取，2条在售候选；台舟PDF5页已渲染目视核对，扫描PDF无可提取文本，不能把空文本视为已读。Nexperia本地下载403未重试，官网PDF网页工具读取成功，未伪造本地副本。资料/算式检查只覆盖来源身份、数量增量与金额；新硬件状态**待实现/待验证**，没有新增综合、PnR、触控实测或整机ESD验收。

收尾实际运行：`project_baseline.py --check notes/baselines/main-2026-10-09-board-diag.json`为PASS，192输入、0新增/删除/改变；`notes/cost-compression-20261016/audit.py`为资料身份/算式限定范围PASS，36行成本例。没有新写源码快照，这两项PASS不代表替代器件电气资格或目标功能完成。
