sakuyaShining/FPGA-Music-project-internal/docs/02-技术方案/27-移交说明-硬件组装.md

# 移交说明（硬件组装）

> 给负责采购与组装的队友。**先读这一页，再按下面的顺序看其它文档。**

## 0. 当前阶段（重要，先看这一节）

设计尚未全部冻结，**有些事现在做是对的，有些事现在做会白做**。

| 事项 | 现在能不能做 |
|---|---|
| 采购（板子、线、铜箔、电阻电容、触摸模块） | **现在就该做**，最急的是开发板 |
| 板级 bring-up（本文第 5 节的段一、段二） | **可以做**——只依赖板子，与面板设计无关 |
| 用面包板临时接几根电极做 RC 实测 | **可以做**，不需要正式面板 |
| **按终稿尺寸焊 38 触点面板** | **先别做**——布局仍在冻结中 |
| 触摸控制器原型（**1 片 + 12 键**） | 可以做，但只当技术验证，不要当最终形态 |

**为什么**：音高与八度的规格还是草案（有 4 项未定：泛音键数量、音域条几何、板载按键用途、
是否加第三排），触摸控制器驱动也还在开发中。现在按终稿尺寸切铜箔，一旦改设计就要重做。

**等什么**：等我们发出"布局冻结"通知，再按《电极面板装配指南》做正式面板。
在那之前，面板相关的只有一件值得做——**用一片控制器加十几个触点，验证"手工铜箔 + 触摸控制器"
这条路本身能不能走通**。

---

## 1. 你要做三件事

1. **采购**：按《采购清单》下单，最急的是**开发板**（没有它什么都开不了工）
2. **做面板**：按《电极面板装配指南》裁铜箔、贴触点、接线
3. **上电验证**：按《板卡 Bring-up 一页卡片》一步一步走，每步都写了"该看到什么"

## 2. 按顺序读这四份

| 顺序 | 文档 | 作用 |
|---|---|---|
| 1 | `docs/02-技术方案/24-采购清单.md`（或同目录的 `24-采购清单-微信版.txt`） | 买什么、买多少、为什么 |
| 2 | `docs/02-技术方案/26-电极面板装配指南.md` | 面板尺寸、触点编号、接线表、分阶段装配 |
| 3 | `docs/02-技术方案/16-板卡bringup一页卡片.md` | 拿到板子当天怎么一步步验证 |
| 4 | `docs/02-技术方案/25-音高与八度规格.md` | 最终验收标准（P1–P15 判据） |

另有 `docs/02-技术方案/23-触摸输入扩展评估.md`：如果想知道"为什么用触摸控制器而不是直接把电极接在板子上"，看这份。

## 3. 你需要装什么

| 要装的 | 用途 | 备注 |
|---|---|---|
| **Gowin 编程器驱动** | 让电脑认到板子 | 装完设备管理器应出现 2 个 USB Serial Converter + 1 个 COM 口 |
| Python 3 | 跑上位机命令行工具 | 可选；只看串口遥测时需要 |
| Gowin IDE | **只有要自己重新编译时才需要** | 包里有现成码流，通常不用装 |

## 4. 怎么烧板子

包里的 `码流/tdm_synth.fs` 就是可以直接烧的文件。

| 项 | 取值 |
|---|---|
| 烧录方式 | **SRAM**（掉电即失、零风险；不要烧 Flash） |
| 下载频率 | **2.5 MHz** |
| Verify | **不勾**（勾了会极慢或失败） |
| 数据线 | 必须是 **USB-C 数据线**，充电线会让"灯亮但电脑认不到" |

⚠️ **SRAM 烧录掉电即失**：拔电就没了。演示或录像前必须重新烧一次。

## 5. 第一天走这三步就够

1. **只验硬件**：烧官方 audio 例程 → 扬声器出声（先排除线/驱动/板的问题）
2. **只验数字通路**：烧`码流/tdm_synth.fs` → **LED 心跳亮**（不用耳朵就能判断 FPGA 活着）
3. **连电脑读遥测**：`python tools/scripts/dsp_host.py --port COMx padmon`

后面才是面板、触摸控制器、音高验收。

## 6. 出问题去哪儿查

| 现象 | 查哪里 |
|---|---|
| 板子认不到 / 烧录失败 | Bring-up 卡片 §5 失败判读表 |
| 焊接后某个键不灵 / 相邻键互相触发 | 装配指南 §6 装配类常见错误 |
| 声音破音、音高不对 | Bring-up 卡片 §3 三个容易出事故的点 |
| 触摸控制器读不到 | Bring-up 卡片 §5 最后一行 |

## 7. 现在还没有的东西（如实告知）

| 项 | 状态 |
|---|---|
| 音高扩展（半音键、八度档） | **尚未实现**。当前码流是 8 个五声音阶键、无八度切换 |
| 触摸控制器驱动 | **开发中**，自检尚未通过 |
| 开发板 | **尚未购买**（最急） |

也就是说：**现在烧进去能出声、能读遥测、能验证硬件通路，但还不能弹半音和换八度。**那部分是下一阶段的工作，规格已经写好在 `25-音高与八度规格.md`。

## 8. 关于源码

包里包含完整源码（`src/rtl`、`src/sim`、`src/constr`、`tools`）。如果你要自己重新编译：

```powershell
powershell -File tools\scripts\build_gowin.ps1 -Project src\gowin\tdm_synth\tdm_synth.gprj -SspiAsGpio -PlaceOpt 2 -RouteOpt 2
```

改完代码要跑验收：

```powershell
powershell -File tools\scripts\accept_all.ps1
```

它会自动编译、跑回归、综合布局布线，并检查时序余量（低于 +5 ns 直接判红）。
