sakuyaShining/FPGA-Music-project-internal/hardware/electrode-fullpanel-450-20261030/assembly/full84-front-source-preview.png

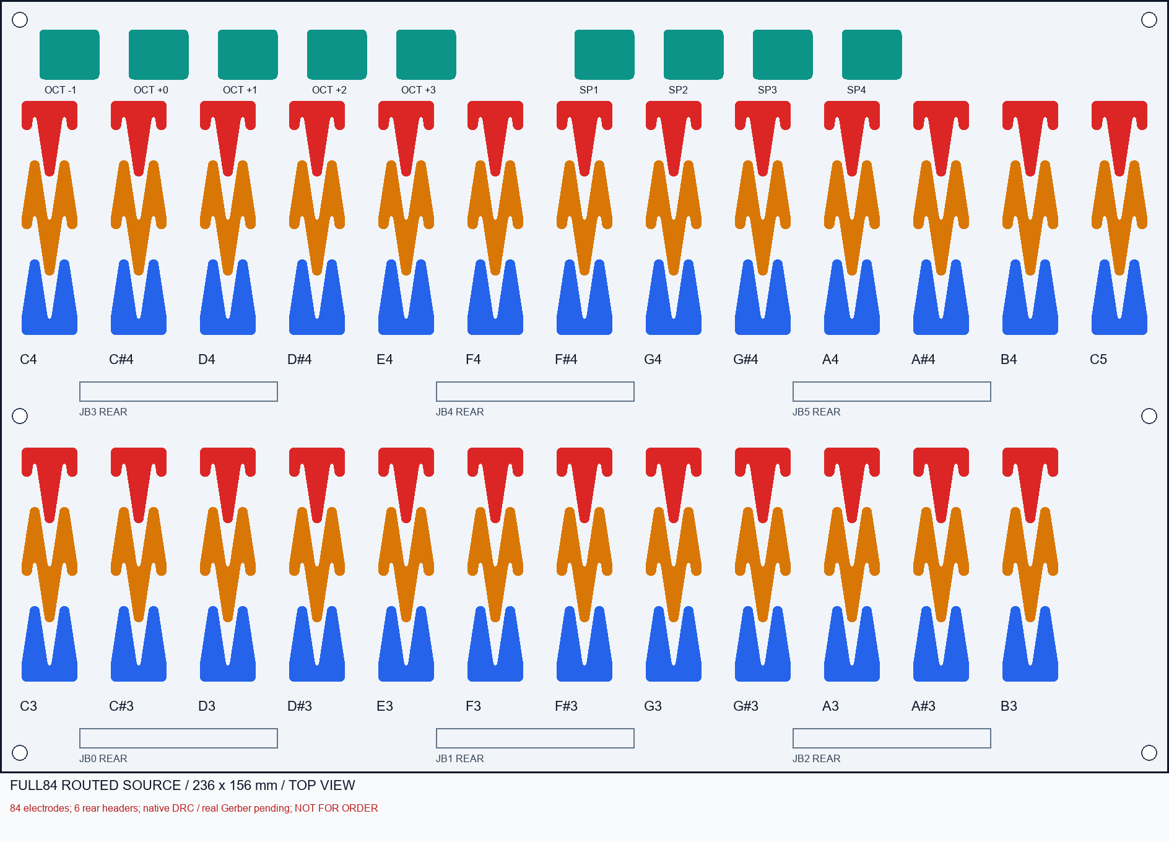
hardware/electrode-fullpanel-450-20261030/assembly/full84-front-source-preview.png
