sakuyaShining/FPGA-Music-project-internal/hardware/electrode-fullpanel-450-20261030/ELECTRODE-HARNESS-84-VERIFIED.csv

raw_index | kind | pitch | note_index | row | row_position | electrode | board_label | bank | channel | connector | pin | PCB_electrode_net | series_resistor | mux_pin | audit | octave_slot | octave_offset | assembly
0 | pitch | C3 | 0 | 下排 | 1 | 端A | B0 | 0 | 0 | J1 | 8 | L0_E07 | R3 | 9 | VERIFIED_SENSOR_S1_2184D027_CURRENT_PAD_NETS
1 | pitch | E3 | 4 | 下排 | 5 | 端A | B1 | 1 | 0 | J1 | 8 | L0_E07 | R3 | 9 | VERIFIED_SENSOR_S1_2184D027_CURRENT_PAD_NETS
2 | pitch | G#3 | 8 | 下排 | 9 | 端A | B2 | 2 | 0 | J1 | 8 | L0_E07 | R3 | 9 | VERIFIED_SENSOR_S1_2184D027_CURRENT_PAD_NETS
3 | pitch | C4 | 12 | 上排 | 1 | 端A | B3 | 3 | 0 | J1 | 8 | L0_E07 | R3 | 9 | VERIFIED_SENSOR_S1_2184D027_CURRENT_PAD_NETS
4 | pitch | E4 | 16 | 上排 | 5 | 端A | B4 | 4 | 0 | J1 | 8 | L0_E07 | R3 | 9 | VERIFIED_SENSOR_S1_2184D027_CURRENT_PAD_NETS
5 | pitch | G#4 | 20 | 上排 | 9 | 端A | B5 | 5 | 0 | J1 | 8 | L0_E07 | R3 | 9 | VERIFIED_SENSOR_S1_2184D027_CURRENT_PAD_NETS
6 | pitch | C3 | 0 | 下排 | 1 | 中 | B0 | 0 | 1 | J1 | 7 | L0_E06 | R4 | 8 | VERIFIED_SENSOR_S1_2184D027_CURRENT_PAD_NETS
7 | pitch | E3 | 4 | 下排 | 5 | 中 | B1 | 1 | 1 | J1 | 7 | L0_E06 | R4 | 8 | VERIFIED_SENSOR_S1_2184D027_CURRENT_PAD_NETS
8 | pitch | G#3 | 8 | 下排 | 9 | 中 | B2 | 2 | 1 | J1 | 7 | L0_E06 | R4 | 8 | VERIFIED_SENSOR_S1_2184D027_CURRENT_PAD_NETS
9 | pitch | C4 | 12 | 上排 | 1 | 中 | B3 | 3 | 1 | J1 | 7 | L0_E06 | R4 | 8 | VERIFIED_SENSOR_S1_2184D027_CURRENT_PAD_NETS
10 | pitch | E4 | 16 | 上排 | 5 | 中 | B4 | 4 | 1 | J1 | 7 | L0_E06 | R4 | 8 | VERIFIED_SENSOR_S1_2184D027_CURRENT_PAD_NETS
11 | pitch | G#4 | 20 | 上排 | 9 | 中 | B5 | 5 | 1 | J1 | 7 | L0_E06 | R4 | 8 | VERIFIED_SENSOR_S1_2184D027_CURRENT_PAD_NETS
12 | pitch | C3 | 0 | 下排 | 1 | 端B | B0 | 0 | 2 | J1 | 6 | L0_E05 | R5 | 7 | VERIFIED_SENSOR_S1_2184D027_CURRENT_PAD_NETS
13 | pitch | E3 | 4 | 下排 | 5 | 端B | B1 | 1 | 2 | J1 | 6 | L0_E05 | R5 | 7 | VERIFIED_SENSOR_S1_2184D027_CURRENT_PAD_NETS
14 | pitch | G#3 | 8 | 下排 | 9 | 端B | B2 | 2 | 2 | J1 | 6 | L0_E05 | R5 | 7 | VERIFIED_SENSOR_S1_2184D027_CURRENT_PAD_NETS
15 | pitch | C4 | 12 | 上排 | 1 | 端B | B3 | 3 | 2 | J1 | 6 | L0_E05 | R5 | 7 | VERIFIED_SENSOR_S1_2184D027_CURRENT_PAD_NETS
16 | pitch | E4 | 16 | 上排 | 5 | 端B | B4 | 4 | 2 | J1 | 6 | L0_E05 | R5 | 7 | VERIFIED_SENSOR_S1_2184D027_CURRENT_PAD_NETS
17 | pitch | G#4 | 20 | 上排 | 9 | 端B | B5 | 5 | 2 | J1 | 6 | L0_E05 | R5 | 7 | VERIFIED_SENSOR_S1_2184D027_CURRENT_PAD_NETS
18 | pitch | C#3 | 1 | 下排 | 2 | 端A | B0 | 0 | 3 | J1 | 5 | L0_E04 | R6 | 6 | VERIFIED_SENSOR_S1_2184D027_CURRENT_PAD_NETS
19 | pitch | F3 | 5 | 下排 | 6 | 端A | B1 | 1 | 3 | J1 | 5 | L0_E04 | R6 | 6 | VERIFIED_SENSOR_S1_2184D027_CURRENT_PAD_NETS
20 | pitch | A3 | 9 | 下排 | 10 | 端A | B2 | 2 | 3 | J1 | 5 | L0_E04 | R6 | 6 | VERIFIED_SENSOR_S1_2184D027_CURRENT_PAD_NETS
21 | pitch | C#4 | 13 | 上排 | 2 | 端A | B3 | 3 | 3 | J1 | 5 | L0_E04 | R6 | 6 | VERIFIED_SENSOR_S1_2184D027_CURRENT_PAD_NETS
22 | pitch | F4 | 17 | 上排 | 6 | 端A | B4 | 4 | 3 | J1 | 5 | L0_E04 | R6 | 6 | VERIFIED_SENSOR_S1_2184D027_CURRENT_PAD_NETS
23 | pitch | A4 | 21 | 上排 | 10 | 端A | B5 | 5 | 3 | J1 | 5 | L0_E04 | R6 | 6 | VERIFIED_SENSOR_S1_2184D027_CURRENT_PAD_NETS
24 | pitch | C#3 | 1 | 下排 | 2 | 中 | B0 | 0 | 4 | J1 | 4 | L0_E03 | R7 | 5 | VERIFIED_SENSOR_S1_2184D027_CURRENT_PAD_NETS
25 | pitch | F3 | 5 | 下排 | 6 | 中 | B1 | 1 | 4 | J1 | 4 | L0_E03 | R7 | 5 | VERIFIED_SENSOR_S1_2184D027_CURRENT_PAD_NETS
26 | pitch | A3 | 9 | 下排 | 10 | 中 | B2 | 2 | 4 | J1 | 4 | L0_E03 | R7 | 5 | VERIFIED_SENSOR_S1_2184D027_CURRENT_PAD_NETS
27 | pitch | C#4 | 13 | 上排 | 2 | 中 | B3 | 3 | 4 | J1 | 4 | L0_E03 | R7 | 5 | VERIFIED_SENSOR_S1_2184D027_CURRENT_PAD_NETS
28 | pitch | F4 | 17 | 上排 | 6 | 中 | B4 | 4 | 4 | J1 | 4 | L0_E03 | R7 | 5 | VERIFIED_SENSOR_S1_2184D027_CURRENT_PAD_NETS
29 | pitch | A4 | 21 | 上排 | 10 | 中 | B5 | 5 | 4 | J1 | 4 | L0_E03 | R7 | 5 | VERIFIED_SENSOR_S1_2184D027_CURRENT_PAD_NETS
30 | pitch | C#3 | 1 | 下排 | 2 | 端B | B0 | 0 | 5 | J1 | 3 | L0_E02 | R8 | 4 | VERIFIED_SENSOR_S1_2184D027_CURRENT_PAD_NETS
31 | pitch | F3 | 5 | 下排 | 6 | 端B | B1 | 1 | 5 | J1 | 3 | L0_E02 | R8 | 4 | VERIFIED_SENSOR_S1_2184D027_CURRENT_PAD_NETS
32 | pitch | A3 | 9 | 下排 | 10 | 端B | B2 | 2 | 5 | J1 | 3 | L0_E02 | R8 | 4 | VERIFIED_SENSOR_S1_2184D027_CURRENT_PAD_NETS
33 | pitch | C#4 | 13 | 上排 | 2 | 端B | B3 | 3 | 5 | J1 | 3 | L0_E02 | R8 | 4 | VERIFIED_SENSOR_S1_2184D027_CURRENT_PAD_NETS
34 | pitch | F4 | 17 | 上排 | 6 | 端B | B4 | 4 | 5 | J1 | 3 | L0_E02 | R8 | 4 | VERIFIED_SENSOR_S1_2184D027_CURRENT_PAD_NETS
35 | pitch | A4 | 21 | 上排 | 10 | 端B | B5 | 5 | 5 | J1 | 3 | L0_E02 | R8 | 4 | VERIFIED_SENSOR_S1_2184D027_CURRENT_PAD_NETS
36 | pitch | D3 | 2 | 下排 | 3 | 端A | B0 | 0 | 6 | J1 | 2 | L0_E01 | R9 | 3 | VERIFIED_SENSOR_S1_2184D027_CURRENT_PAD_NETS
37 | pitch | F#3 | 6 | 下排 | 7 | 端A | B1 | 1 | 6 | J1 | 2 | L0_E01 | R9 | 3 | VERIFIED_SENSOR_S1_2184D027_CURRENT_PAD_NETS
38 | pitch | A#3 | 10 | 下排 | 11 | 端A | B2 | 2 | 6 | J1 | 2 | L0_E01 | R9 | 3 | VERIFIED_SENSOR_S1_2184D027_CURRENT_PAD_NETS
39 | pitch | D4 | 14 | 上排 | 3 | 端A | B3 | 3 | 6 | J1 | 2 | L0_E01 | R9 | 3 | VERIFIED_SENSOR_S1_2184D027_CURRENT_PAD_NETS
40 | pitch | F#4 | 18 | 上排 | 7 | 端A | B4 | 4 | 6 | J1 | 2 | L0_E01 | R9 | 3 | VERIFIED_SENSOR_S1_2184D027_CURRENT_PAD_NETS
41 | pitch | A#4 | 22 | 上排 | 11 | 端A | B5 | 5 | 6 | J1 | 2 | L0_E01 | R9 | 3 | VERIFIED_SENSOR_S1_2184D027_CURRENT_PAD_NETS
42 | pitch | D3 | 2 | 下排 | 3 | 中 | B0 | 0 | 7 | J1 | 1 | L0_E00 | R10 | 2 | VERIFIED_SENSOR_S1_2184D027_CURRENT_PAD_NETS
43 | pitch | F#3 | 6 | 下排 | 7 | 中 | B1 | 1 | 7 | J1 | 1 | L0_E00 | R10 | 2 | VERIFIED_SENSOR_S1_2184D027_CURRENT_PAD_NETS
44 | pitch | A#3 | 10 | 下排 | 11 | 中 | B2 | 2 | 7 | J1 | 1 | L0_E00 | R10 | 2 | VERIFIED_SENSOR_S1_2184D027_CURRENT_PAD_NETS
45 | pitch | D4 | 14 | 上排 | 3 | 中 | B3 | 3 | 7 | J1 | 1 | L0_E00 | R10 | 2 | VERIFIED_SENSOR_S1_2184D027_CURRENT_PAD_NETS
46 | pitch | F#4 | 18 | 上排 | 7 | 中 | B4 | 4 | 7 | J1 | 1 | L0_E00 | R10 | 2 | VERIFIED_SENSOR_S1_2184D027_CURRENT_PAD_NETS
47 | pitch | A#4 | 22 | 上排 | 11 | 中 | B5 | 5 | 7 | J1 | 1 | L0_E00 | R10 | 2 | VERIFIED_SENSOR_S1_2184D027_CURRENT_PAD_NETS
48 | pitch | D3 | 2 | 下排 | 3 | 端B | B0 | 0 | 8 | J1 | 14 | L0_E13 | R11 | 23 | VERIFIED_SENSOR_S1_2184D027_CURRENT_PAD_NETS
49 | pitch | F#3 | 6 | 下排 | 7 | 端B | B1 | 1 | 8 | J1 | 14 | L0_E13 | R11 | 23 | VERIFIED_SENSOR_S1_2184D027_CURRENT_PAD_NETS
50 | pitch | A#3 | 10 | 下排 | 11 | 端B | B2 | 2 | 8 | J1 | 14 | L0_E13 | R11 | 23 | VERIFIED_SENSOR_S1_2184D027_CURRENT_PAD_NETS
51 | pitch | D4 | 14 | 上排 | 3 | 端B | B3 | 3 | 8 | J1 | 14 | L0_E13 | R11 | 23 | VERIFIED_SENSOR_S1_2184D027_CURRENT_PAD_NETS
52 | pitch | F#4 | 18 | 上排 | 7 | 端B | B4 | 4 | 8 | J1 | 14 | L0_E13 | R11 | 23 | VERIFIED_SENSOR_S1_2184D027_CURRENT_PAD_NETS
53 | pitch | A#4 | 22 | 上排 | 11 | 端B | B5 | 5 | 8 | J1 | 14 | L0_E13 | R11 | 23 | VERIFIED_SENSOR_S1_2184D027_CURRENT_PAD_NETS
54 | pitch | D#3 | 3 | 下排 | 4 | 端A | B0 | 0 | 9 | J1 | 13 | L0_E12 | R12 | 22 | VERIFIED_SENSOR_S1_2184D027_CURRENT_PAD_NETS
55 | pitch | G3 | 7 | 下排 | 8 | 端A | B1 | 1 | 9 | J1 | 13 | L0_E12 | R12 | 22 | VERIFIED_SENSOR_S1_2184D027_CURRENT_PAD_NETS
56 | pitch | B3 | 11 | 下排 | 12 | 端A | B2 | 2 | 9 | J1 | 13 | L0_E12 | R12 | 22 | VERIFIED_SENSOR_S1_2184D027_CURRENT_PAD_NETS
57 | pitch | D#4 | 15 | 上排 | 4 | 端A | B3 | 3 | 9 | J1 | 13 | L0_E12 | R12 | 22 | VERIFIED_SENSOR_S1_2184D027_CURRENT_PAD_NETS
58 | pitch | G4 | 19 | 上排 | 8 | 端A | B4 | 4 | 9 | J1 | 13 | L0_E12 | R12 | 22 | VERIFIED_SENSOR_S1_2184D027_CURRENT_PAD_NETS
59 | pitch | B4 | 23 | 上排 | 12 | 端A | B5 | 5 | 9 | J1 | 13 | L0_E12 | R12 | 22 | VERIFIED_SENSOR_S1_2184D027_CURRENT_PAD_NETS
60 | pitch | D#3 | 3 | 下排 | 4 | 中 | B0 | 0 | 10 | J1 | 12 | L0_E11 | R13 | 21 | VERIFIED_SENSOR_S1_2184D027_CURRENT_PAD_NETS
61 | pitch | G3 | 7 | 下排 | 8 | 中 | B1 | 1 | 10 | J1 | 12 | L0_E11 | R13 | 21 | VERIFIED_SENSOR_S1_2184D027_CURRENT_PAD_NETS
62 | pitch | B3 | 11 | 下排 | 12 | 中 | B2 | 2 | 10 | J1 | 12 | L0_E11 | R13 | 21 | VERIFIED_SENSOR_S1_2184D027_CURRENT_PAD_NETS
63 | pitch | D#4 | 15 | 上排 | 4 | 中 | B3 | 3 | 10 | J1 | 12 | L0_E11 | R13 | 21 | VERIFIED_SENSOR_S1_2184D027_CURRENT_PAD_NETS
64 | pitch | G4 | 19 | 上排 | 8 | 中 | B4 | 4 | 10 | J1 | 12 | L0_E11 | R13 | 21 | VERIFIED_SENSOR_S1_2184D027_CURRENT_PAD_NETS
65 | pitch | B4 | 23 | 上排 | 12 | 中 | B5 | 5 | 10 | J1 | 12 | L0_E11 | R13 | 21 | VERIFIED_SENSOR_S1_2184D027_CURRENT_PAD_NETS
66 | pitch | D#3 | 3 | 下排 | 4 | 端B | B0 | 0 | 11 | J1 | 11 | L0_E10 | R14 | 20 | VERIFIED_SENSOR_S1_2184D027_CURRENT_PAD_NETS
67 | pitch | G3 | 7 | 下排 | 8 | 端B | B1 | 1 | 11 | J1 | 11 | L0_E10 | R14 | 20 | VERIFIED_SENSOR_S1_2184D027_CURRENT_PAD_NETS
68 | pitch | B3 | 11 | 下排 | 12 | 端B | B2 | 2 | 11 | J1 | 11 | L0_E10 | R14 | 20 | VERIFIED_SENSOR_S1_2184D027_CURRENT_PAD_NETS
69 | pitch | D#4 | 15 | 上排 | 4 | 端B | B3 | 3 | 11 | J1 | 11 | L0_E10 | R14 | 20 | VERIFIED_SENSOR_S1_2184D027_CURRENT_PAD_NETS
70 | pitch | G4 | 19 | 上排 | 8 | 端B | B4 | 4 | 11 | J1 | 11 | L0_E10 | R14 | 20 | VERIFIED_SENSOR_S1_2184D027_CURRENT_PAD_NETS
71 | pitch | B4 | 23 | 上排 | 12 | 端B | B5 | 5 | 11 | J1 | 11 | L0_E10 | R14 | 20 | VERIFIED_SENSOR_S1_2184D027_CURRENT_PAD_NETS
72 | pitch | C5 | 24 | 上排右端独立C5 | 13 | 端A | B0 | 0 | 12 | J1 | 10 | L0_E09 | R15 | 19 | VERIFIED_SENSOR_S1_2184D027_CURRENT_PAD_NETS
73 | pitch | C5 | 24 | 上排右端独立C5 | 13 | 中 | B1 | 1 | 12 | J1 | 10 | L0_E09 | R15 | 19 | VERIFIED_SENSOR_S1_2184D027_CURRENT_PAD_NETS
74 | pitch | C5 | 24 | 上排右端独立C5 | 13 | 端B | B2 | 2 | 12 | J1 | 10 | L0_E09 | R15 | 19 | VERIFIED_SENSOR_S1_2184D027_CURRENT_PAD_NETS
75 | octave |  |  |  |  |  | B3 | 3 | 12 | J1 | 10 | L0_E09 | R15 | 19 | VERIFIED_SENSOR_S1_2184D027_CURRENT_PAD_NETS | 0 | -1
76 | octave |  |  |  |  |  | B4 | 4 | 12 | J1 | 10 | L0_E09 | R15 | 19 | VERIFIED_SENSOR_S1_2184D027_CURRENT_PAD_NETS | 1 | 0
77 | octave |  |  |  |  |  | B5 | 5 | 12 | J1 | 10 | L0_E09 | R15 | 19 | VERIFIED_SENSOR_S1_2184D027_CURRENT_PAD_NETS | 2 | 1
78 | octave |  |  |  |  |  | B0 | 0 | 13 | J1 | 9 | L0_E08 | R16 | 18 | VERIFIED_SENSOR_S1_2184D027_CURRENT_PAD_NETS | 3 | 2
79 | octave |  |  |  |  |  | B1 | 1 | 13 | J1 | 9 | L0_E08 | R16 | 18 | VERIFIED_SENSOR_S1_2184D027_CURRENT_PAD_NETS | 4 | 3
80 | spare |  |  |  |  |  | B2 | 2 | 13 | J1 | 9 | L0_E08 | R16 | 18 | VERIFIED_SENSOR_S1_2184D027_CURRENT_PAD_NETS |  |  | 安装并连接实体备用电极，标SPARE；保留采样检查，不默认为新音符或八度功能
81 | spare |  |  |  |  |  | B3 | 3 | 13 | J1 | 9 | L0_E08 | R16 | 18 | VERIFIED_SENSOR_S1_2184D027_CURRENT_PAD_NETS |  |  | 安装并连接实体备用电极，标SPARE；保留采样检查，不默认为新音符或八度功能
82 | spare |  |  |  |  |  | B4 | 4 | 13 | J1 | 9 | L0_E08 | R16 | 18 | VERIFIED_SENSOR_S1_2184D027_CURRENT_PAD_NETS |  |  | 安装并连接实体备用电极，标SPARE；保留采样检查，不默认为新音符或八度功能
83 | spare |  |  |  |  |  | B5 | 5 | 13 | J1 | 9 | L0_E08 | R16 | 18 | VERIFIED_SENSOR_S1_2184D027_CURRENT_PAD_NETS |  |  | 安装并连接实体备用电极，标SPARE；保留采样检查，不默认为新音符或八度功能
