sakuyaShining/FPGA-Music-project-internal/notes/project-organization-audit-20261022/IMPLEMENTATION-RESULT.md

# 1—3步整理与新Agent交接结果

本次只收口源码保全、内部远程同步和统一入口，没有搬迁活跃工程、接合产品功能、下载码流或制造放行。

## 已完成

1. 已通过GitHub API核实internal仓库为private，将原本落后62提交的远程main同步至3824391，并上传既有版本归一、安全修复、硬件/GUI备份等分支。origin/public没有推送。
2. 17个Git工作树、2个M1目录、3个CAD原生项目形成22个具备源清单的保全分支。全量核验18,277个文件条目、5,845个不同内容/编码组合通过；条目含跨工作区重复，不能当成独立模块数。生成目录、第三方依赖和目录联接目标不是完整磁盘备份的一部分，排除范围在各清单中记录。
3. 4d37原先未提交的候选、87—89号文档、交接工具和审计资料进入命名管理分支，原100个FPGA构建输入按原字节保留。本工作区已完成提交；其他工作树的HEAD、索引和文件未改写。
4. README、AGENTS、project/CURRENT、state/catalog/dependencies、版本清单、协作板与恢复工具接通。保全分支只作恢复档案，不作为新增活跃任务。
5. 检查点后观察到的5个硬件/M1源变化另存增量ZIP，带来源提交与哈希，不继承原报告。M1恢复支持只取源/上下文并叠加已登记增量；自动硬件/原生事务叠加被拒绝。

## 防止下一位Agent读旧版本

- 管理入口分支：`codex/project-management-20261022`。
- 本批冻结交接标签：`handoff/20261022-management-v1`。
- 第一份阅读文件：`project/AGENT-START.md`；机器身份：`project/handoff.json`。
- 可直接转交的指令：`project/NEXT-AGENT-PROMPT.md`。
- 首次启动执行`project_control.py check --full --remote --fresh-entry`；老工作区不包含当前已发布入口，或本地入口尚未上传时，检查失败，不能降级使用旧main/README。
- 当前M1起点由固定检查点加源增量构成，100个有效构建输入全部列明。已经与活跃M1的完整相应输入集合逐项匹配；匹配时间在handoff.json记录，不声称覆盖未来改动。
- M1恢复目录优先提供AGENTS与PRESERVATION-ORIGIN，省略历史证据、旧运行时标记及派生大fixture副本，防止把旧路径、旧source-identity或旧报告误认为当前。

## 实际验证

- 从实际GitHub重新克隆，22个快照全部内容哈希及实际远程引用核对通过。
- 从GitHub对象恢复原4d37与CAD输入；重复恢复同一目录被拒绝，没有覆盖。
- 从GitHub恢复最新登记M1源加增量，100个构建输入与交接身份全部相符。
- 保留便携包原TB、参考模型和黄金轨迹，在重建的最新M1输入上运行engine、pitch专项，两者通过。原冻结包的native、engine恢复回归也通过。
- 实际旧入口提交5cf9803面对新发布入口a151d10被识别为STALE；未发布的本地入口被识别为UNPUBLISHED；更新后的GitHub克隆正常通过。
- 归档初稿曾被Git换行过滤影响。已从原始捕获副本追加无过滤修正、保留原历史、固定快照EOL属性并重新全量验证，没有修改原工作文件或强推历史。

上述结果属于源码保全与专项行为证据，不是最新M1完整PnR、STA、板验或全功能产品验收。验证记录见`project/versions/management-validation-20261022.json`。

## 尚未接合与下一步

main按现有协作板“main只由用户合并”的约定，仍待管理PR接合。此前新Agent必须明确使用上述管理分支/标签，不能默认main已有本入口。

后续由各owner在命名任务分支继续提交新检查点、同步internal并更新交接。M1活跃owner仍需登记；硬件verified、pending与原生会话保持各自边界。不在本轮批量合并功能历史、整理目录或删除工作树。
