sakuyaShining/FPGA-Music-project-internal/fpga/current/upstream-notes/TODO-REVIEW-20261022.md

# 待办清单核查 · 2026-10-22

被核查对象（用户口述三条）：**① 优化演奏逻辑　② 明确右手泛音构造功能的规则　③ PCB**

核查方式：全部只读，读源码、读构建证据、读 `hardware-status.json`。未修改任何产品文件。

---

## 0. 结论先行

三条方向都对，**但颗粒度差一到两级，且漏了 4 类共 7 项**。

最要紧的一句：**按现在这三条排期，会在"没有可下载码流"这一步卡死。**
因为 ① 和 ② 都是改 RTL，而当前设计的物理实现状态是 setup −0.700 ns / hold −0.126 ns，
没有任何一个能烧进板子的码流。改得再对也下不去。

| 你的条目 | 判定 | 主要问题 |
|---|---|---|
| ① 优化演奏逻辑 | **成立，但是 7 件事的打包** | 其中"三/四层"不是优化，是缺失功能 |
| ② 明确右手泛音规则 | **成立，且是最该先做的一条** | 已有 5 条待定项成文，但没人拍板 |
| ③ PCB | **方向对，但当前状态是"被阻塞"而非"待办"** | 59 项未连通 + 事务未推广 + 未放行 |

---

## 1. 逐项核查

### 1.1 ① 优化演奏逻辑 —— 拆开是 7 件事

| 子项 | 真实现状 | 证据（文件:行） |
|---|---|---|
| 同音快速重按 | **已经是对的**。分配器优先复用"正在奏同一音符的组"（`found_match`），不叠层；`osc_env` 的 `trig_on` 分支只把状态置 `ST_ATK`、**不清零电平**，相位也不重置 ⇒ 从当前音量继续起音，**不爆音**。限制：同音不能叠两个 | `note_map_owned.v:312-329`、`osc_env.v:118-123` |
| 右手推子方向 | **只能加不能减**。源码注释原文 `bounded boost only`；增益下限硬锁 `10'd256` | `tdm_engine_rh.v:135`、`:493` |
| 8 推子管 16 泛音 | **做不到 16 路独立**。`NF=8`、`PART=16`，16 个泛音按 `part_to_control` 映射到 8 个推子 | `rh_fader_gain_map.v` |
| 效果器 | **三个效果全已实现且已在网表**（delay 1500 样本 / chorus 1.35 Hz / reverb 反馈 0.5）。开机自举写 `FX_CTRL=0x01`（仅干声）⇒ 整条链被旁路。**打开零面积成本** | `fx_delay.v`、`tdm_top_owned.v:271`、`:390` |
| 频谱不随时间演化 | 16 个泛音共用同一条包络形状，没有"高次泛音衰减更快" | `env_mem` 每 slot 一份但 `load_env` 每音符一份 |
| 高音变闷 | `nyq_kill` 判超 Nyquist 后幅度直接清零（数学正确，听感偏闷） | `note_map_owned.v:519`、`:530-531` |
| **三/四层** | **未实现**。`selected_count>2` 时直接 `selection_error<=1` 拒绝 | `layer_dispatch.v:100` |

> **要点**：最后一行不属于"优化"。产品规格是四层，代码只支持 1 层或 2 层，三/四层是**缺失功能**，
> 需要新写分配逻辑并重新验收，工作量与"调推子曲线"不是一个量级。

### 1.2 ② 明确右手泛音规则 —— 已有 5 条待定项，缺拍板

65 号文档已经把待定项写死了（原文）：

> 「横向选控制组，落指锁定组与当前保持值，纵向相对位移增减强调；再落指从保持值开始，避免瞬跳；
> 同组单编辑所有权；失踪触点释放所有权/保留最后可信值。
> **8 组映射 16 分量仅初始方案，数量、曲线、上限、复位范围与手指冲突细节仍需确认。**」

所以"明确规则"= 把下面 5 条答完：

| # | 待定项 | 现行实现是什么 | 改动的真实代价 |
|---|---|---|---|
| R1 | **数量**：8 组还是 16 分量独立 | 8 组，16 泛音按表映射 | 改 `NF=16` 需重排 `part_to_control` 与查表，面积未知（CLS 现 99.6% 满） |
| R2 | **曲线** | `fader_gain_q8.hex` 1024 行，从 `0x200`(512) 单调递减到 `0x100`(256) | 只换 HEX 表，零 RTL 改动 |
| R3 | **上限** | +6 dB（×2.0） | 改常数，注意 10 位增益字段上限 1023 |
| R4 | **复位范围** | 未见成文规则 | 需定义：换音色？换层？松手？开机？ |
| R5 | **手指冲突** | 同组单编辑所有权、失踪触点释放 | 需确认"释放后保留最后可信值"是否就是你要的 |

**外加一条你这次没说但绕不过去的：**

| R6 | **推子要不要能衰减** | **不能**，下限锁 256 | 需改 `tdm_engine_rh.v:493` 的下限钳位 + 重做 `fader_gain_q8.hex` + 重新算乘法位宽 |

> R1 和 R6 都会动面积，而当前 CLS 只剩 41 格。**这两条必须在面积收敛之前定，否则等于白做两次。**

### 1.3 ③ PCB —— 当前是"被阻塞"，不是"待办"

`hardware-status.json` 实测读出：

| 项 | 值 | 含义 |
|---|---|---|
| `checkpoint_declared_drc.connection` | **59** | 59 项未连通 |
| `checkpoint_declared_drc.clearance` / `physical` | 0 / 0 | 间距与物理规则干净 |
| `manufacturing_release` | **false** | 未放行制造 |
| `native_matches_declared_checkpoint` | **false** | 原生文件 `6509803e…` ≠ 声明检查点 `8b9b68a5…` |
| `pending_trial` | 存在，**未推广** | 原文：`never repeat creation`、`After saved57, reopen and audit real copper/ground before promoting` |

拆成三件事，且有严格顺序：

1. **59 项连通**（DRC connection 清零）
2. **事务推广**（pending trial → 正式检查点；当前存的是 saved**57**，与声明的 **59** 不是同一状态）
3. **制造放行**（`manufacturing_release` 置 true）

> **边界**：你此前明确要求「不得触碰 PCB 项目」。以上是只读核查结论，
> 这三件事属于硬件负责人职责，我不执行任何编辑、恢复或重跑。

---

## 2. 缺项清单（按"会不会卡死"排序，不按重要性）

| # | 缺项 | 为什么必须补 | 证据 |
|---|---|---|---|
| **1** | **面积 / 时序收敛** | setup −0.700 / hold −0.126，**没有可交付码流**。这是唯一"不做就什么都交不出"的项 | 本轮 M1 实测；4d37 为 −6.397 / −0.048 |
| **2** | **真实产品顶层** | 当前顶层是 `joint_timing_top`（探针）：587 位串行历史 + 956 位奇偶观察，**无原子演奏命令，外部音频固定静音**。87 号原文："不能下载，更不能作为整机" | `rtl/joint_timing_top.v`；87 号 §2 |
| **3** | **三 / 四层** | 见 1.1 末行，代码明确拒绝 | `layer_dispatch.v:100` |
| **4** | **录放 / TF** | TF 与文件服务、PCM 与事件配对、断电保存、回放＋现场最终混音，全部未实现 | 87 号 §2 |
| **5** | **双屏** | 7 英寸推子屏 / 曲谱 / 实体编辑界面未实现；短音漏显示已知；50 ms 压力绘制超时。另：800×480 整帧 768000 B，6.75 MHz 下理想 **910 ms（1.1 fps）**，必须屏侧显存＋局部更新 | 87 号 §2；65 号 §107 |
| **6** | **版本管理收摊** | 87/88/89 编号被两拨工作各用一次；本轮 M1 三份文档**完全在 git 之外** | 上一轮核查 |
| **7** | **效果器开关** | 零面积成本，只差写一位寄存器 `0x40` | `fx_delay.v` 已在网表 |

---

## 3. 修正后的待办（按依赖排序）

排序原则：**先让"能下去"，再让"对"，最后让"全"。**

| 阶段 | 内容 | 退出条件 | 依赖 |
|---|---|---|---|
| **P0** | M1 三份文档入库；87/88/89 编号冲突定规则 | 有分支、有 commit | 无 |
| **P1** | **右手泛音规则定案**：R1–R6 六条全部有明确答案，写成可测判据 | 六条无"待定"字样 | **需要你拍板** |
| **P2** | **面积 / 时序收敛**到 setup 与 hold 全非负 | 四类 STA 非负，且留出空 CLS | P1 定案后才知道要不要为 `NF=16` 预留面积 |
| **P3** | 演奏逻辑改动（推子方向、效果器、包络演化、nyq 处理） | 逐项行为回归通过 | P2 有余量 |
| **P4** | 真实顶层替换探针 | 从真实引脚进，不依赖 `force` | P2 |
| **P5** | 三/四层、录放、双屏 | 各自验收条件 | P4 |
| **PCB（并行，非我职责）** | 59 连通 → 事务推广 → 制造放行 | `manufacturing_release=true` | 硬件负责人 |

> P1 必须在 P2 之前，理由很硬：R1（8→16 路）和 R6（允许衰减）都会动乘法位宽与查表规模，
> 在 CLS 只剩 41 格的情况下，这两条决定了 P2 要腾多少面积。**顺序反了就要做两遍。**

---

## 4. 时间紧的前提下，该砍什么

按这个顺序砍，前面的先砍：

1. **效果器**——可以后加，零面积，随时能开
2. **双屏的曲谱 / 实体编辑界面**——保可视化，砍编辑 UI
3. **录放**——保现场演奏，砍录放
4. **三 / 四层**——保 1/2 层（但这是产品规格，砍了需你书面同意）

**不能砍的**：
- 逐指表情（你已明确判定为核心）
- 右手推子（产品核心差异点）
- 面积收敛（砍了没有码流，等于零交付）
- 真实顶层（砍了只能交仿真，不是产品）

---

## 5. 需要你现在回答的 3 个问题

1. **推子要不要能衰减？** 现行只能加（0…+6 dB）。要"减"就是 RTL 改动 + 重做查表 + 重算位宽。
2. **8 组还是 16 分量独立？** 16 路要改 `NF=16`，面积代价当前不可测（CLS 已 99.6%）。
3. **"时间特别紧"具体到什么程度？** 是"几周内出可演奏样机"还是"一个月内交参赛作品"？
   这直接决定 P3/P5 砍到哪一档，也决定 P2 是否值得为 `NF=16` 预留面积。

---

## 6. 复现命令

```bash
# 演奏逻辑证据
grep -n "found_match" candidate_source/engine/src/note_map_owned.v
grep -n "bounded boost only" candidate_source/engine/src/tdm_engine_rh.v
grep -n "10'd256 ? 10'd256" candidate_source/engine/src/tdm_engine_rh.v
grep -n "nyq_kill" candidate_source/engine/src/note_map_owned.v
grep -n "8'h40; b_data <= 8'h01" candidate_source/engine/src/tdm_top_owned.v

# 分层限制
grep -n "selected_count" candidate_source/engine/src/layer_dispatch.v

# PCB 状态
cat hardware/hardware-status.json
```

（路径前缀：`D:/FPGA-Project/codex-deliverables/fpga-agent-handoff-20261022-v1/`）
