sakuyaShining/FPGA-Music-project-internal/hardware/team-handoff-20261030/audio/C381127.pdf

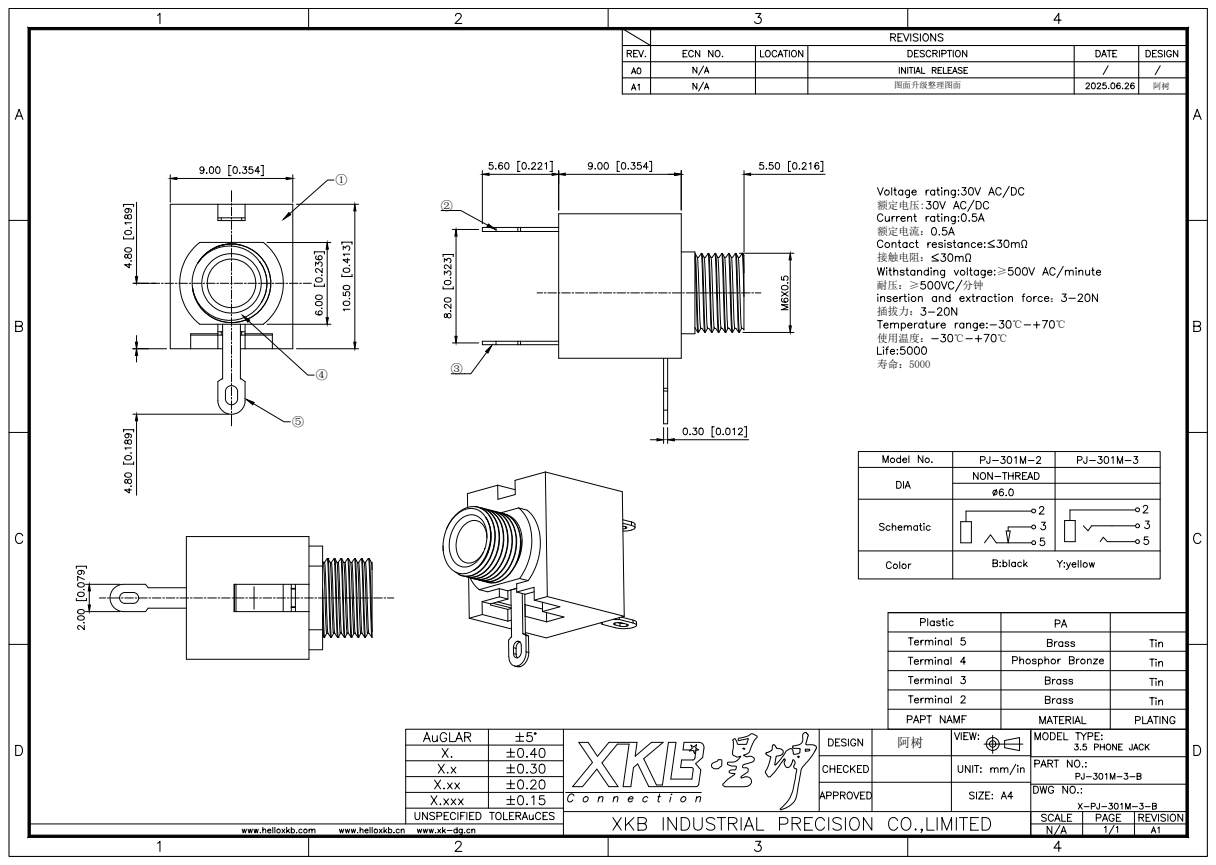
[picture p17: page 1]
图面升级整理图面; 额定电压:; 额定电流：; 接触电阻：; 插拔力：; 使用温度：
