sakuyaShining/FPGA-Music-project-internal/hardware/current/module-plan/evidence/sensor-front-wire-schematic.js

const p=await eda.dmt_Project.getCurrentProjectInfo();if(p.uuid!=='6b570f10a9004c2a7374c39b14185fbbe64449a767876fe377667e630fc1e3c7')throw Error('Wrong project');await eda.dmt_EditorControl.openDocument('00ba33d542279ea0');const si=await eda.dmt_Schematic.getCurrentSchematicInfo();if(si.uuid!=='2cfb45d67dbe504d')throw Error('Wrong schematic');const cs=await eda.sch_PrimitiveComponent.getAll('part',false);if(cs.length!==28)throw Error('Unexpected component count');if((await eda.sch_PrimitiveWire.getAll()).length)throw Error('Wires exist; inspect instead of repeating');const expected={"U1": {"1": "RC0", "10": "ADDR0", "11": "ADDR1", "12": "GND", "13": "ADDR3", "14": "ADDR2", "15": "MUX_DISABLE", "24": "3V3_IO", "9": "L0_M00", "8": "L0_M01", "7": "L0_M02", "6": "L0_M03", "5": "L0_M04", "4": "L0_M05", "3": "L0_M06", "2": "L0_M07", "23": "L0_M08", "22": "L0_M09", "21": "L0_M10", "20": "L0_M11", "19": "L0_M12", "18": "L0_M13", "17": "L0_M14", "16": "L0_M15"}, "U2": {"1": "RC0", "2": "INV0", "3": "GND", "4": null, "5": "GND", "6": null, "7": "GND", "8": null, "9": "GND", "10": null, "11": "GND", "12": null, "13": "GND", "14": "3V3_IO"}, "R1": {"1": "RC_DRIVE", "2": "RC0"}, "R2": {"1": "INV0", "2": "SENSE_OUT"}, "C1": {"1": "3V3_IO", "2": "GND"}, "C2": {"1": "3V3_IO", "2": "GND"}, "C3": {"1": "L0_M14", "2": "GND"}, "C4": {"1": "L0_M15", "2": "GND"}, "J1": {"1": "L0_E00", "2": "L0_E01", "3": "L0_E02", "4": "L0_E03", "5": "L0_E04", "6": "L0_E05", "7": "L0_E06", "8": "L0_E07", "9": "L0_E08", "10": "L0_E09", "11": "L0_E10", "12": "L0_E11", "13": "L0_E12", "14": "L0_E13", "15": "GND", "16": "GND"}, "J2": {"1": "3V3_IO", "2": "GND", "3": "ADDR0", "4": "GND", "5": "ADDR1", "6": "GND", "7": "ADDR2", "8": "GND", "9": "ADDR3", "10": "GND", "11": "MUX_DISABLE", "12": "GND", "13": "RC_DRIVE", "14": "GND", "15": "SENSE_OUT", "16": "GND"}, "R3": {"1": "L0_E00", "2": "L0_M00"}, "R4": {"1": "L0_E01", "2": "L0_M01"}, "R5": {"1": "L0_E02", "2": "L0_M02"}, "R6": {"1": "L0_E03", "2": "L0_M03"}, "R7": {"1": "L0_E04", "2": "L0_M04"}, "R8": {"1": "L0_E05", "2": "L0_M05"}, "R9": {"1": "L0_E06", "2": "L0_M06"}, "R10": {"1": "L0_E07", "2": "L0_M07"}, "R11": {"1": "L0_E08", "2": "L0_M08"}, "R12": {"1": "L0_E09", "2": "L0_M09"}, "R13": {"1": "L0_E10", "2": "L0_M10"}, "R14": {"1": "L0_E11", "2": "L0_M11"}, "R15": {"1": "L0_E12", "2": "L0_M12"}, "R16": {"1": "L0_E13", "2": "L0_M13"}, "D1": {"1": "L0_E00", "2": "L0_E01", "3": "GND", "4": "L0_E02", "5": "L0_E03", "6": null, "7": null, "8": "GND", "9": null, "10": null}, "D2": {"1": "L0_E04", "2": "L0_E05", "3": "GND", "4": "L0_E06", "5": "L0_E07", "6": null, "7": null, "8": "GND", "9": null, "10": null}, "D3": {"1": "L0_E08", "2": "L0_E09", "3": "GND", "4": "L0_E10", "5": "L0_E11", "6": null, "7": null, "8": "GND", "9": null, "10": null}, "D4": {"1": "L0_E12", "2": "L0_E13", "3": "GND", "4": null, "5": null, "6": null, "7": null, "8": "GND", "9": null, "10": null}};const report=[];globalThis.__sensorFrontConstruction.wired=[];for(const c of cs){const ref=c.getState_Designator();const m=expected[ref];if(!m)throw Error('Unexpected part '+ref);const pins=await c.getAllPins();for(const pin of pins){const n=pin.getState_PinNumber();if(!(n in m))throw Error('Unexpected pin '+ref+'.'+n);const net=m[n];if(net===null){await pin.setState_NoConnected(true).done();report.push({ref,pin:n,NC:true});continue;}const x=pin.getState_X(),y=pin.getState_Y(),rot=pin.getState_Rotation();if(rot!==0&&rot!==180)throw Error('Unhandled pin direction');const end=x+(rot===180?-45:45);const w=await eda.sch_PrimitiveWire.create([x,y,end,y],net);if(!w)throw Error('Wire failed '+ref+'.'+n);const port=await eda.sch_PrimitiveComponent.createNetPort('BI',net,end,y,rot===180?0:180,false);if(!port)throw Error('Net port failed '+ref+'.'+n);globalThis.__sensorFrontConstruction.wired.push(ref+'.'+n);report.push({ref,pin:n,net,wire:w.getState_PrimitiveId(),port:port.getState_PrimitiveId()});}}const saved=await eda.sch_Document.save();const nf=await eda.sch_ManufactureData.getNetlistFile('Sensor14Bank-current','JLCEDA');const netlist=nf?await nf.text():null;globalThis.__sensorFrontConstruction.phase='schematic-wired-await-independent-audit';return {saved,wiring:report,netlist,wireCount:(await eda.sch_PrimitiveWire.getAll()).length};
