sakuyaShining/FPGA-Music-project-internal/hardware/current/module-plan/evidence/sensor-fourlayer-Ground-thermal-refill-single.js

const d=await eda.dmt_SelectControl.getCurrentDocumentInfo();if(d?.uuid!=="f52674d6627fca6f"||d.parentProjectUuid!=="6b570f10a9004c2a7374c39b14185fbbe64449a767876fe377667e630fc1e3c7")throw Error('WrongPCB');const a=__CLI__.args,s=globalThis.__sensorTodayFourLayer?.GroundThermalWidthTrial;if(!s||s.phase!=='saved-await-independent-readback'||s.fill[a.layer])throw Error('Stagechanged or layeralreadyattempted');for(const x of s.done){const h=(await eda.pcb_PrimitivePad.get(x.id)).getState_HeatWelding();if(h?.connectionMethod!=='Divergent'||h.divergenceSpacing!==10||h.divergenceLineWidth!==16||h.divergenceAngle!==90)throw Error('Heatreadbackfailed '+x.id);}const p=(await eda.pcb_PrimitivePour.getAll()).filter(p=>p.getState_Layer()===a.layer);if(p.length!==1||p[0].getState_PreserveSilos())throw Error('Pouridentity');s.fill[a.layer]={phase:'running'};const rebuilt=await p[0].rebuildCopperRegion();const saved=await eda.pcb_Document.save();s.fill[a.layer]={phase:'saved',rebuilt:Boolean(rebuilt),saved};return {layer:a.layer,stage:s};
