sakuyaShining/FPGA-Music-project-internal/hardware/current/module-plan/evidence/sensor-fourlayer-reinforcement-save-close-reopen.js

const d=await eda.dmt_SelectControl.getCurrentDocumentInfo();if(d?.uuid!=="f52674d6627fca6f"||d.parentProjectUuid!=="6b570f10a9004c2a7374c39b14185fbbe64449a767876fe377667e630fc1e3c7")throw Error('WrongPCB');const s=globalThis.__sensorTodayFourLayer?.GroundReinforcement;if(!s||s.reopened||![2,15,16].every(l=>s.fill[l]?.saved&&s.fill[l]?.rebuilt))throw Error('Stage');const saved=await eda.pcb_Document.save();if(!saved)throw Error('Save');s.reopened={phase:'closing'};const closed=await eda.dmt_EditorControl.closeDocument(d.tabId);if(!closed)throw Error('Close');const tab=await eda.dmt_EditorControl.openDocument('f52674d6627fca6f');if(!tab)throw Error('Open');s.reopened={phase:'opened-await-readback',saved,closed,tab};return s.reopened;
