sakuyaShining/FPGA-Music-project-internal/hardware/current/module-plan/evidence/sensor-fourlayer-reopen-after-unsupported-heat.js

const d=await eda.dmt_SelectControl.getCurrentDocumentInfo();if(d?.uuid!=="f52674d6627fca6f"||d.parentProjectUuid!=="6b570f10a9004c2a7374c39b14185fbbe64449a767876fe377667e630fc1e3c7")throw Error('WrongPCB');const s=globalThis.__sensorTodayFourLayer?.GroundThermalWidthTrial;if(!s||s.reopenedAfterUnsupported||Object.keys(s.fill).length)throw Error('Unexpectedstage');s.reopenedAfterUnsupported={phase:'closing-saved-tab-no-file-overwrite'};const closed=await eda.dmt_EditorControl.closeDocument(d.tabId);if(!closed)throw Error('Closefailed');const tab=await eda.dmt_EditorControl.openDocument('f52674d6627fca6f');if(!tab)throw Error('Openfailed');s.reopenedAfterUnsupported={phase:'opened-needs-independent-readback',closed,tab};return s.reopenedAfterUnsupported;
