sakuyaShining/FPGA-Music-project-internal/hardware/current/module-plan/evidence/sensor-fourlayer-signal-reference-repair-native.js

const d=await eda.dmt_SelectControl.getCurrentDocumentInfo();if(d?.uuid!=="f52674d6627fca6f"||d.parentProjectUuid!=="6b570f10a9004c2a7374c39b14185fbbe64449a767876fe377667e630fc1e3c7")throw Error('WrongPCB');const s=globalThis.__sensorTodayFourLayer,a=__CLI__.args;if(!s||s.SignalReferenceRepair)throw Error('Alreadyattempted; inspectactual');if((await eda.pcb_PrimitiveLine.getAll()).length!==301||(await eda.pcb_PrimitiveVia.getAll()).length!==48||(await eda.pcb_PrimitiveComponent.getAll()).length!==28)throw Error('Objectcounts');for(const x of a.delete_own_candidate_lines){const t=await eda.pcb_PrimitiveLine.get(x.primitiveId);if(t.getState_Net()!==x.net||t.getState_Layer()!==x.layer||Math.hypot(t.getState_StartX()-x.startX,t.getState_StartY()-x.startY)>.001||Math.hypot(t.getState_EndX()-x.endX,t.getState_EndY()-x.endY)>.001)throw Error('Deleteidentitychanged');}s.SignalReferenceRepair={phase:'creating-real3vias-and7segments-before-selective6owncandidate-delete',newVias:[],newLines:[],deleted:[],fill:{}};for(const v of a.new_vias){const q=await eda.pcb_PrimitiveVia.create(v.net,v.xy[0]/.0254,v.xy[1]/.0254,v.drill/.0254,v.OD/.0254,0,null,null,false);s.SignalReferenceRepair.newVias.push({role:v.role,id:q.getState_PrimitiveId()});}for(let i=0;i<a.routes.length;i++){const r=a.routes[i];for(let j=1;j<r.points.length;j++){const p=r.points[j-1],q=r.points[j];const l=await eda.pcb_PrimitiveLine.create(r.net,r.layer,p[0]/.0254,p[1]/.0254,q[0]/.0254,q[1]/.0254,r.width_mm/.0254,false);s.SignalReferenceRepair.newLines.push({route:i,segment:j,id:l.getState_PrimitiveId()});}}for(const x of a.delete_own_candidate_lines){await eda.pcb_PrimitiveLine.delete(x.primitiveId);s.SignalReferenceRepair.deleted.push(x.primitiveId);}const saved=await eda.pcb_Document.save();s.SignalReferenceRepair.phase='saved-await-actual-refill-and-fullchecks';return {saved,state:s.SignalReferenceRepair};
