sakuyaShining/FPGA-Music-project-internal/hardware/current/module-plan/evidence/sensor-front-apply-left8-manual.js

const d=await eda.dmt_SelectControl.getCurrentDocumentInfo();if(d?.uuid!=="f52674d6627fca6f")throw Error("WrongPCB");if((await eda.pcb_PrimitiveLine.getAll()).length!==48||(await eda.pcb_PrimitiveVia.getAll()).length!==36)throw Error("ChangedCu");if(globalThis.__sensorLeft8Manual)throw Error("Alreadyattempted;inspectactualstate");const plan={"scope":"Manual grouped left8 analog channels; unchanged native targets and hard gates","tracks":[{"net":"L0_M00","points_mm":[[20.753364639999997,18.8000005],[21.22509178,18.8000005],[23.3,20.87490872],[24.47740088,20.87490872]],"width_mm":0.1651,"reference_missing_mm2":0.0},{"net":"L0_M01","points_mm":[[20.753364639999997,20.00000064],[21.77510592,20.00000064],[23.3,21.52489472],[24.47740088,21.52489472]],"width_mm":0.1651,"reference_missing_mm2":0.0},{"net":"L0_M02","points_mm":[[20.753364639999997,21.20000078],[22.324866059999998,21.20000078],[23.3,22.175134720000003],[24.47740088,22.175134720000003]],"width_mm":0.1651,"reference_missing_mm2":0.0},{"net":"L0_M03","points_mm":[[20.753364639999997,22.40000092],[22.8751342,22.40000092],[23.3,22.82486672],[24.47740088,22.82486672]],"width_mm":0.1651,"reference_missing_mm2":0.0},{"net":"L0_M04","points_mm":[[20.753364639999997,23.60000106],[23.17485166,23.60000106],[23.3,23.47485272],[24.47740088,23.47485272]],"width_mm":0.1651,"reference_missing_mm2":0.0},{"net":"L0_M05","points_mm":[[20.753364639999997,24.8000012],[22.62483752,24.8000012],[23.3,24.12483872],[24.47740088,24.12483872]],"width_mm":0.1651,"reference_missing_mm2":0.0},{"net":"L0_M06","points_mm":[[20.753364639999997,25.999998799999997],[22.074825920000002,25.999998799999997],[23.3,24.774824719999998],[24.47740088,24.774824719999998]],"width_mm":0.1651,"reference_missing_mm2":0.0},{"net":"L0_M07","points_mm":[[20.753364639999997,27.199998939999997],[21.524811780000004,27.199998939999997],[23.3,25.42481072],[24.47740088,25.42481072]],"width_mm":0.1651,"reference_missing_mm2":0.0}],"independent_preflight_pass":true,"violations":[],"layer":1,"existing_copper_retained":true};globalThis.__sensorLeft8Manual={phase:"applying",created:[]};for(const t of plan.tracks){for(let i=1;i<t.points_mm.length;i++){const a=t.points_mm[i-1],b=t.points_mm[i];const p=await eda.pcb_PrimitiveLine.create(t.net,1,a[0]/.0254,a[1]/.0254,b[0]/.0254,b[1]/.0254,t.width_mm/.0254,false);if(!p)throw Error("Linefailed"+t.net+"."+i);globalThis.__sensorLeft8Manual.created.push({net:t.net,id:p.getState_PrimitiveId()});}}globalThis.__sensorLeft8Manual.phase="applied";return {state:globalThis.__sensorLeft8Manual,saved:await eda.pcb_Document.save()};
