sakuyaShining/FPGA-Music-project-internal/hardware/current/module-plan/evidence/sensor-front-run-Top-only-kept-signal-route.js

if((await eda.dmt_Pcb.getCurrentPcbInfo()).uuid!=="f52674d6627fca6f"||(await eda.pcb_PrimitiveComponent.getAll()).length!==28||globalThis.__sensorFrontTopSignalRoute)throw Error("Wrong board or existing route job; inspect without restart");globalThis.__sensorFrontTopSignalRoute={phase:"running",started:Date.now(),RoutingNets:["ADDR0", "ADDR1", "ADDR2", "ADDR3", "L0_E00", "L0_E01", "L0_E02", "L0_E03", "L0_E04", "L0_E05", "L0_E06", "L0_E07", "L0_E08", "L0_E09", "L0_E10", "L0_E11", "L0_E12", "L0_E13", "L0_M00", "L0_M01", "L0_M02", "L0_M03", "L0_M04", "L0_M05", "L0_M06", "L0_M07", "L0_M08", "L0_M09", "L0_M10", "L0_M11", "L0_M12", "L0_M13", "MUX_DISABLE", "RC_DRIVE", "SENSE_OUT"],layers:[1],existingPrimitiveMode:"keep"};try{const result=await eda.pcb_Document.autoRouting({RoutingNets:["ADDR0", "ADDR1", "ADDR2", "ADDR3", "L0_E00", "L0_E01", "L0_E02", "L0_E03", "L0_E04", "L0_E05", "L0_E06", "L0_E07", "L0_E08", "L0_E09", "L0_E10", "L0_E11", "L0_E12", "L0_E13", "L0_M00", "L0_M01", "L0_M02", "L0_M03", "L0_M04", "L0_M05", "L0_M06", "L0_M07", "L0_M08", "L0_M09", "L0_M10", "L0_M11", "L0_M12", "L0_M13", "MUX_DISABLE", "RC_DRIVE", "SENSE_OUT"],layers:[1],cornerStyle:0,optimization:1,existingPrimitiveMode:"keep"});globalThis.__sensorFrontTopSignalRoute.phase="terminal";globalThis.__sensorFrontTopSignalRoute.result=result;globalThis.__sensorFrontTopSignalRoute.saved=await eda.pcb_Document.save();return globalThis.__sensorFrontTopSignalRoute;}catch(e){globalThis.__sensorFrontTopSignalRoute.phase="terminal-error";globalThis.__sensorFrontTopSignalRoute.error=String(e);throw e;}
