sakuyaShining/FPGA-Music-project-internal/hardware/current/module-plan/evidence/sensor-front-tighten-new-pcb-config-only.js

if((await eda.dmt_Pcb.getCurrentPcbInfo()).uuid!=="f52674d6627fca6f"||(await eda.pcb_PrimitiveComponent.getAll()).length!==28)throw Error("Wrong PCB");const before=await eda.pcb_Drc.getCurrentRuleConfiguration(),r=JSON.parse(JSON.stringify(before)),c=r.config;const changed=[];for(const block of Object.values(c.Spacing["Safe Spacing"]))for(const table of Object.values(block.tables??{})){for(let i=0;i<table.content.length;i++)for(let j=0;j<table.content[i].length;j++){let floor=0.165;if(i===5||j===5||i===12)floor=0.25;const old=table.content[i][j];if(old<floor){table.content[i][j]=floor;changed.push({rule:block.editName,row:i,column:j,old,new:floor});}}}for(const block of Object.values(c.Physics.Track)){for(const d of Object.values(block.form?.data??{}))d.minValue=Math.max(d.minValue,0.1524);}const via=c.Physics["Via Size"].viaSize.form;via.viaInnerdiameterMin=Math.max(via.viaInnerdiameterMin,0.35);via.viaInnerdiameterDefault=Math.max(via.viaInnerdiameterDefault,0.35);via.viaOuterdiameterMin=Math.max(via.viaOuterdiameterMin,0.7);via.viaOuterdiameterDefault=Math.max(via.viaOuterdiameterDefault,0.7);const ok=await eda.pcb_Drc.overwriteCurrentRuleConfiguration(r.config);await eda.pcb_Document.save();return {ok,spacing_changes:changed,no_routing_started:true,reason:"documented config-only argument; prior wrapper call did not change readback"};
