sakuyaShining/FPGA-Music-project-internal/src/rtl/osc_additive.v

//=============================================================================
// osc_additive.v —— 加法合成声部单元（v4：状态持有壳 + 无状态运算核 + ADSR 包络）
//
// 【层次】
//   · osc_core.v —— 无状态运算核：查表 → 乘幅度 → 加法树 → 未饱和的和
//   · osc_env.v  —— 无状态包络推进单元：状态进 / 状态出
//   · 本模块     —— 状态持有壳：持有【相位】与【每泛音包络】两组状态，
//                   做门的边沿检测、算有效幅度、饱和输出
//
// 【v4 新增：每泛音一份 ADSR】
//   赛题原文：独立发声单元 = 含【独立相位累加器、频率调控、包络控制】的完整振荡器；
//             加法合成【按运算分量统计】。
//   加法合成分量 = 每个泛音 → 所以包络做成【每泛音一份】（NUM_PARTIALS 个实例），
//   而不是"每声部一份"。这样无论评委按哪种读法，都不会出现"泛音没有包络控制"
//   从而"完整振荡器"不成立、核心指标算不出来的风险。
//   成本：包络是慢变量，一个 osc_env 只有几个加法器/乘法器，8 份完全吃得下。
//
// 【有效幅度：纪律 2 的兑现】
//   核只认"第 k 个泛音的有效幅度"这个输入，不关心它从哪来。
//   本壳层把它算成 有效幅度 = 幅度 × 包络：
//       amp_env = (amp8 * env) >> 7      // env 是 Q1.15，32768 表示 1.0
//   于是 env=满幅时 amp_env = amp8 << 8，(x*(amp<<8))>>>16 ≡ (x*amp)>>>8，
//   与 v3 的行为【逐位一致】。
//   将来把幅度源换成"频谱包络发生器"时，同样只改这一处，核一行不动。
//
// 【env_en 旁路位】
//   env_en = 0：有效幅度 = amp8 << 8，等价于"包络恒为满幅"。
//   这让 tb_osc_additive 的原有回归（对 v2/v3 基线逐字节比对）无需改激励就能继续跑。
//
// 【门的边沿 → RELEASE】
//   trig_on  = gate 上升沿 → 起音
//   trig_rel = gate 下降沿 → 释放
//   ★ 释放必须由【按键抬起】驱动。项目早期就因为键盘读不到抬起事件，
//     音符进入 sustain 后永远不停。tb_osc_env 的 A5 专守这条。
//
// 【对外接口】相比 v3 只多了包络相关端口；sample_out 语义与位宽不变。
//=============================================================================

`timescale 1ns/1ps

module osc_additive #(
    parameter NUM_PARTIALS = 8,      // 泛音个数
    parameter PHASE_W      = 24,     // 相位累加器位宽
    parameter TAB_AW       = 8,      // 正弦表地址位宽（8 -> 256 项）
    parameter AMP_W        = 8,      // 【外部】每个泛音的幅度位宽
    parameter OUT_W        = 24,     // 输出样本位宽（有符号）
    parameter ENV_W        = 16,     // 包络电平位宽（Q1.15 无符号）
    parameter STG_W        = 3       // 包络状态编码位宽
)(
    input  wire                            clk,
    input  wire                            rst_n,
    input  wire                            sample_en,   // 拉高一拍 = 产生一个样本
    input  wire [NUM_PARTIALS*PHASE_W-1:0] inc_flat,    // 各泛音频率增量（拼接）
    input  wire [NUM_PARTIALS*AMP_W-1:0]   amp_flat,    // 各泛音幅度（拼接）
    //---------------- ADSR 包络 ----------------
    input  wire                            env_en,      // 1=启用包络, 0=旁路(等价满幅)
    input  wire                            gate,         // 门：上升沿起音 / 下降沿释放
    input  wire [ENV_W-1:0]                a_inc,        // 起音每拍增量
    input  wire [ENV_W-1:0]                d_inc,        // 衰减每拍线性减量
    input  wire [1:0]                      d_m,          // 指数衰减倍率 m
    input  wire [4:0]                      d_k,          // 指数衰减右移量 k
    input  wire [ENV_W-1:0]                s_lvl,        // 延音电平
    input  wire [ENV_W-1:0]                r_inc,        // 释放每拍线性减量
    input  wire [1:0]                      r_m,          // 指数释放倍率 m
    input  wire [4:0]                      r_k,          // 指数释放右移量 k
    input  wire [ENV_W-1:0]                env_cutoff,   // 归零阈值
    input  wire                            exp_mode,     // 1=指数衰减/释放, 0=线性
    //---------------- 输出 ----------------
    output reg  signed [OUT_W-1:0]         sample_out
);

    // 核里用的有效幅度位宽：多出的 8 位是包络的小数分辨率
    localparam CORE_AMP_W = AMP_W + 8;
    localparam ENV_FRAC   = 7;      // (amp8 * env) >> 7 使 env=32768 时恰为 amp8<<8

    //-------------------------------------------------------------------------
    // 1) 状态之一：相位寄存器组（每个泛音一个独立累加器）
    //-------------------------------------------------------------------------
    reg [PHASE_W-1:0] phase_q [0:NUM_PARTIALS-1];

    //-------------------------------------------------------------------------
    // 2) 状态之二：每泛音一份的包络（电平 + 状态）
    //-------------------------------------------------------------------------
    reg [ENV_W-1:0] env_lvl_q [0:NUM_PARTIALS-1];
    reg [STG_W-1:0] env_stg_q [0:NUM_PARTIALS-1];

    //-------------------------------------------------------------------------
    // 3) 门的边沿检测（每声部一个门，不是每泛音）
    //-------------------------------------------------------------------------
    reg  gate_q;
    wire trig_on  =  gate & ~gate_q;
    wire trig_rel = ~gate &  gate_q;

    always @(posedge clk or negedge rst_n) begin
        if (!rst_n)
            gate_q <= 1'b0;
        else if (sample_en)
            gate_q <= gate;
    end

    //-------------------------------------------------------------------------
    // 4) 与运算核的连线
    //-------------------------------------------------------------------------
    wire [NUM_PARTIALS*PHASE_W-1:0] phase_in_flat;
    wire [NUM_PARTIALS*PHASE_W-1:0] phase_adv_flat;
    wire [NUM_PARTIALS*CORE_AMP_W-1:0] amp_eff_n;
    reg  [NUM_PARTIALS*CORE_AMP_W-1:0] amp_eff_q;
    wire signed [26:0]              sum_raw;

    wire [AMP_W-1:0] amp8 [0:NUM_PARTIALS-1];

    genvar g;
    generate
        for (g = 0; g < NUM_PARTIALS; g = g + 1) begin : G_STATE
            assign phase_in_flat[g*PHASE_W +: PHASE_W] = phase_q[g];
            assign amp8[g] = amp_flat[g*AMP_W +: AMP_W];
        end
    endgenerate

    osc_core #(
        .NUM_PARTIALS (NUM_PARTIALS),
        .PHASE_W      (PHASE_W),
        .TAB_AW       (TAB_AW),
        .AMP_W        (CORE_AMP_W)
    ) u_core (
        .clk       (clk),
        .rst_n     (rst_n),
        .sample_en (sample_en),
        .phase_in  (phase_in_flat),
        .inc_flat  (inc_flat),
        .amp_flat  (amp_eff_q),
        .phase_adv (phase_adv_flat),
        .sum_out   (sum_raw)
    );

    //-------------------------------------------------------------------------
    // 5) 每泛音：包络推进 + 有效幅度
    //-------------------------------------------------------------------------
    genvar ge;
    generate
        for (ge = 0; ge < NUM_PARTIALS; ge = ge + 1) begin : G_ENV
            wire [ENV_W-1:0] lvl_n;
            wire [STG_W-1:0] stg_n;

            osc_env #(.ENV_W(ENV_W), .STG_W(STG_W)) u_env (
                .lvl_i    (env_lvl_q[ge]),
                .stg_i    (env_stg_q[ge]),
                .trig_on  (trig_on),
                .trig_rel (trig_rel),
                .a_inc    (a_inc),
                .d_inc    (d_inc),
                .d_m      (d_m),
                .d_k      (d_k),
                .s_lvl    (s_lvl),
                .r_inc    (r_inc),
                .r_m      (r_m),
                .r_k      (r_k),
                .cutoff   (env_cutoff),
                .exp_mode (exp_mode),
                .lvl_o    (lvl_n),
                .stg_o    (stg_n)
            );

            always @(posedge clk or negedge rst_n) begin
                if (!rst_n) begin
                    env_lvl_q[ge] <= {ENV_W{1'b0}};
                    env_stg_q[ge] <= {STG_W{1'b0}};
                end
                else if (sample_en) begin
                    env_lvl_q[ge] <= lvl_n;
                    env_stg_q[ge] <= stg_n;
                end
            end

            // 有效幅度 = 幅度 × 包络。乘法显式扩到 32 位再截取。
            //   amp_prod 最大 = (2^AMP_W-1) × 2^(ENV_W-1)，最高位下标 AMP_W+ENV_W-2；
            //   右移 ENV_FRAC 位后恰好是 CORE_AMP_W 位。
            wire [31:0] amp_prod = {24'd0, amp8[ge]} * {16'd0, env_lvl_q[ge]};
            wire [CORE_AMP_W-1:0] amp_env =
                 amp_prod[AMP_W + ENV_W - 2 : ENV_FRAC];
            wire [CORE_AMP_W-1:0] amp_byp =
                 {{(CORE_AMP_W-AMP_W){1'b0}}, amp8[ge]} << (CORE_AMP_W - AMP_W);

            assign amp_eff_n[ge*CORE_AMP_W +: CORE_AMP_W] =
                   env_en ? amp_env : amp_byp;
        end
    endgenerate

    //-------------------------------------------------------------------------
    // 5b) ★ 有效幅度【显式打一拍】再进运算核
    //
    //   为什么必须显式寄存（这不是可选的优化，是时序语义的确定化）：
    //   有效幅度是 (幅度 × 包络) 的纯组合结果，而包络寄存器和相位寄存器
    //   在同一个 posedge 更新。若把组合结果直接送进核，则"核在这一拍用的是
    //   更新前还是更新后的包络"就取决于仿真器的求值顺序 —— 实测加了包络模块
    //   后，输出整体晚了【恰好一个样本】，而把包络整块删掉就恢复正常。
    //   这在硬件里是未定义行为（综合结果可能两边都不是），必须消除。
    //
    //   显式寄存之后：语义变成明确的"第 n 拍使用第 n-1 拍结束时的包络值"。
    //   包络是慢变量（几十毫秒量级），晚 1/46875 s = 21 µs 完全无感；
    //   代价是 16×8 = 128 个触发器，换来的是仿真与硬件行为一致。
    //-------------------------------------------------------------------------
    always @(posedge clk or negedge rst_n) begin
        if (!rst_n)
            amp_eff_q <= {(NUM_PARTIALS*CORE_AMP_W){1'b0}};
        else if (sample_en)
            amp_eff_q <= amp_eff_n;
    end

    //-------------------------------------------------------------------------
    // 6) 状态更新：sample_en 拍寄存相位推进值
    //-------------------------------------------------------------------------
    integer i;
    always @(posedge clk or negedge rst_n) begin
        if (!rst_n) begin
            for (i = 0; i < NUM_PARTIALS; i = i + 1)
                phase_q[i] <= {PHASE_W{1'b0}};
        end
        else if (sample_en) begin
            for (i = 0; i < NUM_PARTIALS; i = i + 1)
                phase_q[i] <= phase_adv_flat[i*PHASE_W +: PHASE_W];
        end
    end

    //-------------------------------------------------------------------------
    // 7) 饱和限幅输出（与 v2/v3 逐位相同）
    //    用饱和而不是截断：截断会让大信号"回绕"成反相噪声，听起来很刺耳。
    //-------------------------------------------------------------------------
    always @(posedge clk or negedge rst_n) begin
        if (!rst_n)
            sample_out <= {OUT_W{1'b0}};
        else if (sample_en) begin
            if (sum_raw > 27'sd8388607)
                sample_out <=  24'sd8388607;
            else if (sum_raw < -27'sd8388608)
                sample_out <= -24'sd8388608;
            else
                sample_out <= sum_raw[OUT_W-1:0];
        end
    end

endmodule
