sakuyaShining/FPGA-Music-project-internal/tools/scripts/_final_scrub.py

# -*- coding: utf-8 -*-
"""最终收尾：一次性完成四件事，只作用于公开版会包含的文件。

  1. 精确修正
     - 恢复被误替换的网络术语（"系统协作" -> "系统代理"）
     - 删除"分工：RTL 由 AI 实现"这类内部说明行
     - 重写"两个代理共用一个工作区"这类句子
  2. 剥掉指向公开版不存在路径的引用（refs/ notes/ 素材库 等）
  3. 清理因此产生的悬空标点（空的括号、孤立的连接词）
  4. 报告改动

顺序很关键：先剥引用，再清残渣（反过来的话残渣还会留下）。
"""
import os
import re
import subprocess
import sys

ROOT = os.path.dirname(os.path.dirname(os.path.dirname(os.path.abspath(__file__))))
BRANCH = "public"

# ---- 1. 精确修正 ----
EXACT = [
    ("tools/host/build_exe.py",
     "# 本机 pip 曾因【Windows 系统协作指向一个不存在的协作】而全部失败",
     "# 本机 pip 曾因【Windows 系统代理指向一个不存在的代理】而全部失败"),
    ("tools/host/serial_link.py",
     "本机 pip 因系统协作不可用而装不上",
     "本机 pip 因系统代理不可用而装不上"),
    ("tools/scripts/regress_all.py",
     "两个代理共用一个工作区，最大风险是\"一方改 RTL 时悄悄破坏另一方的已验证性质\"。",
     "单一工作区并行改动的最大风险，是一处修改悄悄破坏另一处已验证的性质。"),
    ("docs/02-技术方案/14-必须项实施计划.md",
     "> 分工：RTL 由 AI 实现；架构与产品定义由用户拍板；用户负责验收与答辩可辩护性\n",
     ""),
]

# ---- 2. 要剥掉的路径引用 ----
DROP = [
    re.compile(r"`refs/[^`]*`"),
    re.compile(r"`notes/[^`]*`"),
    re.compile(r"`PROJECT_MEMORY\.md`"),
    re.compile(r"`tools/pylib[^`]*`"),
    re.compile(r"`(?:src/rtl/)?(?:bringup_top|image_rom|image_view|lcd_480x272|test_pattern)\.v`"),
    re.compile(r"refs/[\w\u4e00-\u9fff/\-\.]+"),
    re.compile(r"notes/[\w\u4e00-\u9fff/\-\.]+"),
    re.compile(r"PROJECT_MEMORY\.md"),
    re.compile(r"tools/pylib[\w/\-\.]*"),
    re.compile(r"[\w\u4e00-\u9fff/\-]*素材库[\w\u4e00-\u9fff/\-\.]*"),
    re.compile(r"`(?:src/rtl/)?(?:bringup_top|image_rom|image_view|lcd_480x272|test_pattern)\.v`"),
]
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
