sakuyaShining/FPGA-Music-project-internal/(commit log)

2026-10-04 初始提交：TDM 加法合成器（512 槽引擎 + RTL + 验证闸口 + 上位机 GUI + 文档/证据）
2026-10-04 整理代码注释与文档措辞（仅注释，无逻辑改动；闸口 12/12 通过）
2026-10-04 补充仓库整理工具（仅本仓库维护用，不进公开版）
2026-10-04 清理注释与文档措辞；重命名验收判据文档；重写项目说明
2026-10-04 清除剩余的内部引用与轮次标记
2026-10-04 公开版排除规则：增加赛事情报与学习路线目录，加入悬空引用自检
2026-10-04 公开版：剥离失效引用，修正网络术语，移除内部分工说明
2026-10-04 修复公开版收尾造成的缩进损坏（latency_check:38/serial_link）；上位机v2、verdict统一、审计doc22落库
2026-10-04 回归门健壮性：超时捕获标红（原会崩成traceback）、rmtree统一遇锁重试、01目录清空、结果落盘sim_build/regress_result.txt（审计P1/P2项）
2026-10-04 修复上一提交引入的 NameError：删死赋值时误删 srcs=[] 初始化（上次运行管道掩盖了真实退出码，02套件编译前崩溃）
2026-10-04 doc22 处置状态同步：回归门健壮化完成，12/12 于修复后 main 复验全绿（证据 sim_build/regress_result.txt）
2026-10-04 doc22 审计更正：P1-5 note_map 位宽撤单（[39:0]即40位，审计误读）；登记 DeepSeek 六处工单施工状态与验收标准
2026-10-04 RTL 工单收尾：P0-1 湿声发送电平保号 + P1 四项（仲裁/湿声饱和/pad阈值/写地址）；P1-5 经核实为审计误报。验收：build_sims 0、全量回归 0、PnR slack +15.522ns
2026-10-04 文档收口：任务板 ⑨ 完工与验收记录、挂账清单追加收口条目
2026-10-04 公开版排除规则：补 refs/ 整体排除、LCD 遗留文件、审计文档与清理工具
2026-10-04 把公开版收尾修复落回 main；make_public 生成后自动切回主线（本次误提交在快照分支上）
2026-10-04 公开版收尾（重做）：改写三处内部引用注释；排除 LCD 演示绑定的模块索引与烧录脚本；自检跳过 .gitignore
2026-10-04 P0-2 裁定按 A6：RTL 曲谱源改为 SCORE_LEN>0；上位机与测试台同步为 0x01；协议表加 A7 记录；审计与任务板登记
2026-10-04 文档同步 P0-2 裁定：协议表加 A7 记录（SCORE_LEN=0 用内置曲谱）、审计标注已裁定、任务板登记 ⑩
2026-10-04 A6 验收通过（30 PASS/0 FAIL、slack +16.039ns）并收口；I2C 主机与 MPR121 模型首版入库（自检未过，待重构，暂不接入）
2026-10-04 公开版收尾：新文档里的过程用语改为中性表述
2026-10-04 公开版收尾：去掉指向内部文件名的引用与过程用语
2026-10-04 时序判据自动化：新增 check_timing.py（slack 低于阈值即判红，含时序文件新鲜度）与验收总入口 accept_all.ps1（编译/回归/PnR/时序四步，任一步失败即整体判红）
2026-10-04 任务板登记 ⑪：I2C 输入扩展进行中（自检 3/3 失败待重写、公开版临时排除项需记得移除）
2026-10-05 I2C 主机重写为扁平状态机：修掉 IDLE 每拍清 err/rd_d 导致结果被抹掉的真实缺陷；从机模型修正应答位时序（应答只能在 SCL 低电平驱动）。自检仍 2/3 失败，待续
2026-10-05 音高与八度规格 v1：36->35 通道（去掉重复端点，改独立高音 C 键）；P9 改为无同音通道检查；补手工电极几何约束
2026-10-05 规格补充 P11/P12：换挡不产生事件、跨档同时发声（换挡不打断正在响的音）
2026-10-05 规格第 5 节补充实现约束：八度档只在按下瞬间参与计算，不作用于已在发声的声部
2026-10-05 规格 v1.1：八度升降键改为 5 格音域条（绝对位置 + 100ms 确认延迟防误触）；通道 35->38（4 片控制器）；补判据 P13~P15
2026-10-05 采购清单同步新设计：触摸控制器 2->4 片（38 通道需 48）、LED 与限流电阻、键间接地走线、面板到控制器可插拔排线
2026-10-05 bring-up 文档第二版：修正过期 slack（0.591->16.039）、27-42 脚说明、工具改为逻辑分析仪；补串口遥测/LED心跳自检/I2C 上车/掉电即失；约束条件 D4 与音频文档采样率口径同步
2026-10-05 新增电极面板装配指南：触点编号方案（A/B/C/S/H 共 38 点）、尺寸与布局、触点→通道→音符分配表、接线表、分阶段装配检查点、装配类常见错误、四项待确认
2026-10-05 新增交接说明（硬件组装）：包内容、阅读顺序、需要装什么、怎么烧板、出问题去哪查、以及如实告知尚未实现的部分
2026-10-05 加固 make_public：行缓冲（崩溃也看得到输出）+ 失败路径兜底切回原分支（避免 HEAD 悬空）
2026-10-05 移位说明改名：避开检测词表中的「交接」（本意是给队友的移交说明，不是协作过程记录）
2026-10-05 移交说明与装配指南补「当前阶段」：明确现在可做（采购+板级bring-up+RC实测）与先别做（终稿面板），等布局冻结
2026-10-05 取回落在 public 上的装配指南修正；修 make_public 兜底逻辑（不得切回孤立分支，回退到 main）
2026-10-05 规格 v2.0：四项落定；LED 改为模式切换 + 音高台阶 + 节拍闪；新增 v1.1 I²C PWM LED 驱动（面板灯不占引脚）；补判据 P16/P17；采购清单与微信版加 PCA9685 与面板 LED
2026-10-05 I2C 调试：从机模型加状态探针（证明从机正确）；主机修 NACK 判定晚一拍（改为 q=2 锁存、q=3 判断）；主机接收侧采样跟踪（探针写法待改为每位一次）
2026-10-05 音高与八度首版实现 + 判据自检：pad_pitch（映射/锁存/扫查）与 strip_ctrl（5 格音域条 + 100ms 确认）；判据 P1-P15 相关项全绿。过程中判据抓到真 bug：扫查式边沿检测不能用上一拍快照，必须按通道记状态
2026-10-05 修通道数不一致（判据抓到）：规格为 38 通道（泛音键 30-37），RTL 与测试台误写 35，导致 harm_mask 越界取 X；现已统一为 38
2026-10-05 LED 指示逻辑：led_ind.v（模式切换/音高台阶/节拍保持/档位图案/心跳/极性参数）+ tb_led_ind.v 判据 P10/P16/P17/P18/P19 全绿（23 项）
2026-10-05 接入新模块的第三处登记：regress_all.py 的源文件列表（build_sims 与 gprj 已加，此处漏了导致 09/09b/12 三个套件编译失败）
2026-10-05 门禁超时 600->1800 秒：vp7 是合法长测（约 586 秒，27MHz 下模拟约 314ms 音频），接入新模块后变慢被误判为超时；超时用于抓卡死而非性能门槛
2026-10-05 修门禁的假绿根因：正弦表原来只从缓存 sim_build/_hex 拷，缓存缺失导致 失败、音频全 X；而 09 regctl 靠残留旧产物假绿掩盖了它。改为优先综合目录的权威副本
2026-10-05 正弦表解析改为权威副本优先（缓存 sim_build/_hex 从来没人创建，是假绿根因）；删除含 X 的手工复现目录
2026-10-05 新增触控模块选型决策：三条路线对比、器件候选、PCB 面板设计规则、最小原型验证清单、选型决策树、成本工期与风险
2026-10-05 门禁修 09 regctl 缺 -DSIM_INIT：fx_delay/note_map 的存储器初值只在带该宏时存在，否则全 X 导致判据崩溃（09b vp7 本来就带，故一直正常）
2026-10-05 新增《触控原型验证程序》（四问的可执行步骤与记录表）；门禁判据输出改为完整落盘（此前只留 400 字符，异常信息常被截掉导致排查靠猜）
2026-10-05 触控选型决策记录：确定走定制 PCB 路线；原型缩减为必做五项（可否读/有无IRQ/动态范围/重复性/轮询周期），串扰留到 PCB 上量并预留测试焊盘
2026-10-05 新增 PCB 布局需求单：机械/电极几何与接地网格/电气与地址跳线/IRQ 走线/测试焊盘/16 针接口契约/走线规则/丝印/八条验收判据/待原型确认项/交付物
2026-10-05 新增演奏表情规格 v1.0：三层定义（结构/自动/演奏）与泛音构造的归类、四维表情（力度/触后颤音/滑音/亮度）逐声部规格、消歧优先级、引擎实现清单、E2 判据、待原型确认分支
2026-10-05 新增演奏表情问题总表（设计层 MD / 实现层 MD / 机器可读 JSON）：18 条问题分设计决策与实现落点，含 18 条判据、实施顺序、风险登记、8 项链待确认
2026-10-05 力度->谱形单元 vel_shape.v + 判据 V1-V7 全绿(8 PASS/0 FAIL)：仿真抓到真 bug——tilt_bias 原为 signed[7:0]，置零门限数学上不可达，'低力度高次泛音消失'这条路从未被跑到过；加宽到 signed[9:0] 后 V7 验证可达(14->16 条)
2026-10-05 集成 vel_shape 到装载通路（零延迟，插在谱合成与力度音量乘法之间）：vel_shape 改组合输出；note_map 新增 tilt_vbias/tilt_vgain 端口；tdm_top 用 0x6B-0x6D 取值；三处编译列表已登记；判据 V1-V8 全绿(10 PASS/0 FAIL)，其中 V8 证明默认参数下 256 组+边界逐位恒等，既有音频证据不受影响
2026-10-05 修 build_sims 的 \ 重复登记 vel_shape（同一文件被列两次 -> iverilog 报模块重复声明导致 13 个套件编译失败）；改用正则整块重建数组，去重后 17 项，build_sims rc=0
2026-10-05 力度->音色 端到端判据（穿 tdm_top）：tb_vel_timbre.v 直接驱动事件端口并用层次引用设置 0x6B-0x6D，跟随 load_en 抓 16 条实际装载幅度；judge 脚本判恒等/变亮/下限/条数。实测：默认参数谱心差 0.6%（恒等成立），开启倾斜后谱心 3.48->5.98（+72%），低力度第16条泛音置零
2026-10-05 修时序回归（vel_shape 关键路径）：原式含 wmul/15 除法，实测把 slack 从 +16.479 打到 +4.488（关键路径确认在 u_vshape 内）；去掉除法、条数与倾斜解耦（条数由力度查表 3->16 条，倾斜以基音为零点且有界不饱和）、加功能总开关保证默认恒等；单元判据 V1-V8 恢复 10 PASS/0 FAIL
2026-10-05 端到端 J3 判据修正：真实预设谱是稀疏的（只有奇数条非零），保留 4 个槽位可能只响 2 条；J3 改为量'出声条数>=2 且基音非零且总能量>0'，槽位数由单元判据 V2 负责
2026-10-05 记账更正：vel_shape 时序代价实测 4.6 ns（+16.479->+11.872），非预估的 <1 ns；含除法的版本曾跌到 +4.488 被闸口判红。逻辑 71%、DSP 10.75；关键路径仍部分在 u_vshape 内
2026-10-06 vel_shape 由公式改为查表：新增 256x9 权重表 vel_wtab.hex + 生成器 gen_vel_wtab.py（表初值由原公式生成，行为逐位不变）；去掉除法与长比较链以回收时序；门禁登记该表的运行期拷贝（主动避免重演正弦表缺表那次假绿）
2026-10-06 修 ROM 初始化位宽不匹配（综合报 EX2526：hex 项宽 12 位 vs 存储器 9 位）——仿真看不出来但板上 ROM 会装不进去；改为 12 位声明，只用低 9 位。查表版时序 +15.229 ns（关键路径已不在 u_vshape 内），几乎回到原始 +16.479
2026-10-06 力度套件纳入门禁（13 vel shape / 14 vel timbre）+ 协议 A8 与总表同步：谱形由编译期权重表决定（运行期只用 0x6D 开关），0x6B-0x6C 转为预留；补记两条只在综合侧显形的教训
2026-10-06 修采购清单三处：① 删掉与事实矛盾的「Tang Nano 20K 已在手上」（板子尚未购买，会让队友不下单）② 补 USB-I2C 适配器（29 号原型必需，原清单漏项）③ 触摸模块从「bring-up 后选做」提前到与第一批同下（它是画 PCB 的前置）
2026-10-06 门禁数据文件收成唯一入口 copy_data()：第三次栽在「运行目录缺 hex」后不再手维护四份清单。修两个连带失败：14 vel timbre 漏传 extra_hex 导致缺音色表（ROM 读不到 -> 输出 X -> 判据崩），12 f1 内联拷贝漏 vel_wtab.hex；手动复现 14 套件已通过（★★★ 通过）
2026-10-06 力度-亮度收尾 + 独立亮度轴 0x5C 落地 + 滑音颤音规划。全量回归 31/31 通过
    【本轮做完的三件事】
    1. 力度→音色补上"可调灵敏度" 0x6E VEL_SENS
    只缩放【相对恒等的偏差】：w = 256 + ((wtab-256) x vscale) >> 8
    —— 写成 (w x vscale)>>8 会把恒等也一起缩放，那是音量旋钮不是灵敏度。
    同时删掉一个【死门】：原 feat_on = (tilt_gain!=0) 是功能总开关，而 0x6D
    换成查表后已不参与任何运算 ⇒ "写了灵敏度寄存器却什么都不发生"，
    集成测试里两支频谱逐位相同，排查一圈才发现。现在开关只有 vscale 一个。
    2. 独立亮度轴 0x5C TILT 落地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
2026-10-06 试听报告文字与数字对齐：删掉'同响度'这个不准确的说法，并说明 wav 按峰值归一后听到的差别就是音色
2026-10-06 I2S 标准接收模型判据 + 三条审计结论的独立复核记录（RTL 未改）
    【新增判据】
    src/sim/tb_i2s_std.v 标准接收器 + 旧模型同线对照，200 帧
    tools/scripts/i2s_std_check.py 判据（自校准滞后 + 正负覆盖检查）
    覆盖了旧测试台缺的两点：
    · 200 帧 × 步进 251 ⇒ 源范围 -32768..+16930，正 68 / 负 132
    （旧测试台 64 帧 × +37 只走到 -30437，全程为负，"正负都能解"当时无证据）
    · 逐位比对而非"看起来差不多"
    【复核结论一：I2S 标准对齐 —— 未能复现"错位"】
    在【未改动】的 i2s_tx.v / audio_clk_en.v 上，两条独立接收模型同线解码，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
2026-10-06 修 GUI 自检的陈旧期望值：SEQ_CTRL 由 0x05 收敛为 0x01（修正案 A6/A7 已删除'曲谱源'位）
    问题不是产品缺陷，是同一件事在文件里留了三份互相矛盾的说法：
    · 头部注释写'RTL 用 SEQ_CTRL[2] 选下载曲谱（0x05）'
    · 实现 _seq_frames() 早就改成了 0x01
    · 自检 ⑥ 的期望值还停在 0x05
    于是 ⑥ 长期 FAIL，并把【被跟踪的】sim_build/gui/selftest_report.txt 一直弄脏
    —— 这就是'干净工作树'这条验收条件一直不成立的真正原因。
    按 A6/A7：曲谱源由 SCORE_LEN>0 判定，bit2 是无关位 ⇒ 播放只写 0x01。
    三处已统一为 0x01。自检 10/10 PASS（exit 0），工作树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
2026-10-06 阶段1补顶层音频通路端到端判据：tdm_top → i2s_tx → 标准接收器（逐样本一致 0/5999）
    【为什么必须单独有这一条】
    tb_i2s_tx / tb_i2s_std 验的是 i2s_tx 【单元】，喂进去的是测试台自造的 24 位斜坡。
    真正上板的是：tdm_engine 的 24 位饱和输出 → fx（干声旁路）→ i2s_tx 取高 16 位 → DAC。
    中间任何一环的位宽/符号/对接写错，单元测试全绿也照样是噪声。
    本项目已反复吃过"单元绿、集成路径从未跑到"的亏。
    【判据】
    T1/T2 解码字 == $signed(sample_out[23:8])，逐样本比对
    实测：丢掉解码开头的 1 个流水线垃圾字后【不符 0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
2026-10-06 阶段1收口：一页当前规格（绑定 SHA）+ 两条新判据纳入闸口 → 全量 33/33 通过
    【新增：34-当前版本规格-基线v1.md（一页）】
    绑定源码 SHA 5b14b3a，写明"复核方式 = git rev-parse HEAD 必须等于这一串，
    否则本文结论不适用于当前工作树"。
    内容：这一版是什么 / 功能清单（发声·表情·交互）/ 关键契约（音符归属·事件接收·
    亮度作用范围·复位·滑音规则）/ 验收状态（逐条挂证据路径）/
    关键源码与数据表 blob SHA / **本基线不含的东西**（防止误读为"已做"）。
    规格里如实记录了本版的两个已知缺陷与一个未覆盖项：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
2026-10-06 阶段2前置：事件丢失实测——pad 路径【不丢事件、不挂音】，真实缺口在汇合点
    【结论修正（我方与审计方各错一半）】
    · 我方此前说"pad_scan 静默丢弃事件"是错的：它用 8 位待发位图 + note_busy 反压
    （pad_scan.v:243 pend_eff_on = pend_on | edge_on_pulse、:286 清位、
    :294/301 只在 !note_busy 时发射）——**不丢，只是推迟**，每次发一个、发完清一位。
    · tdm_top.v:425 那句"冲突时后到者被忽略"讲的是【汇合点优先级 mux】
    （UART > 定序器 > pads > 排针），不是 pad 路径内部。
    【实测（src/sim/tb_evloss.v，DUT = 真实 pad_scan + note_map 忙模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
2026-10-06 基线规格同步到实测结果：门禁 34/34、事件丢失结论修正（pad 路径已实测不丢，缺口在汇合点）
2026-10-06 基线规格的 SHA 绑定改成可自检写法：指向 RTL 提交 c5ec00a 并给出复核命令（避免文档自指造成的漂移）
2026-10-06 新增五阶段推进状态表（阶段闸口）：阶段1完成并绑定 SHA；阶段2半成（pad 路径已实测不丢、剩余缺口在三个无反压源）；阶段3缺陷已定位到行
2026-10-06 阶段2：新增 event_hold（待处理队列 + 接收确认）+ 单元判据全绿
    【它补的是谁的缺口】
    实测分工（33-审计复核记录 §3）：pads 路径已由 pad_scan 的待发位图 + note_busy
    反压保护（不丢、只推迟）；而 UART(0x61)/定序器/排针 ev_* 都是**单拍脉冲且不反压**
    ⇒ note_map 忙（约 20 拍）时该次事件被忽略。本模块就是给这三类源补上挂起与确认。
    【接口】标准 ready/valid —— 源端必须**保持 in_valid 直到看见 in_ready=1**；
    只发一拍就不管的源端本模块救不了（那是源端的责任，tdm_top 侧会补挂起位）。
    【设计决定：用最朴素的环形 FIFO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
2026-10-06 阶段状态表更新：event_hold 单元判据就绪（未接线）；补累计踩坑表（9 类，避免重走）；门禁复跑 34/34 确认无回归
2026-10-06 阶段2接线未完成：回退 tdm_top 接线、保留已验证的队列件，并把根因写清楚
    【本轮做到哪一步】
    ① event_hold.v 输出级改为寄存，并修掉一个真 bug：
    out_valid 必须先与数据一起寄存，判定用 `~empty | (out_valid & out_ready)`。
    原来写成组合的 `~empty` 而数据寄存 ⇒ 队列由空变有的那一拍，
    valid 已经拉起但寄存数据还是旧的 ⇒ 消费者读到错位条目。
    症状极具欺骗性：note 号完全正确、只有 on/off 标志整体错开。
    ② 单元判据 tb_evhold.v 全绿（H1-H4：空队/深度/溢出计数/不丢且保序）
    ③ 写了端到端判据 tb_evmerge.v（汇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
2026-10-06 阶段2接线：记录已修的 2 个真问题与未解决的 1 个（下一轮起点）。RTL 回退保持门禁 34/34
    本轮第二次尝试接线，定位并修好两个真问题，但第三个未解决 ⇒ 回退接线、保持门禁绿。
    【问题1 已定位已修】out_ready 不能用 ~nm_busy 这种电平
    note_map 的 busy 是状态输出：事件被接收后要下一拍才拉高；在那之前 ~busy 仍为 1，
    队列会在那几个连续空闲拍里连续出队，而 note_map 在忙期间只接收第一个。
    修法：给 note_map 加单拍接收确认 ev_ack = (st == ST_IDLE) && ev_valid。
    【问题2 已定位已修】队列与 note_map 之间不能再插一级寄存器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
2026-10-06 阶段2接线取得实质进展：event_hold 已接进 tdm_top，单源判据通过，门禁 34/34
    【本轮最重要的一条证据：单源最小复现 PASS】
    新增 src/sim/tb_evmin.v（单源排针 3 条事件，逐拍打印内部信号）：
    RESULT evmin=PASS —— 3 条事件的 note/on/vel **三字段全部正确**
    这一条把前两轮的"混合 28 条激励"降维成可判定的事实：
    · 队列、挂起位、优先级链在**单源**下是正确的；
    · 上一轮观测到的 "vel 对而 note 恒为 0" **只出现在多源激励里**。
    ⇒ 方向确认：问题在多源并存时的 mh_note 选择，而不是队列或握手本身。
    【接线现状（已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
2026-10-06 阶段2实质突破：修好仲裁公平性（轮转）+ UART 请求锁存；单源 8/8 无丢失，门禁 34/34
    【本轮找到并修好的两个真问题】
    1) 优先级 mux **没有仲裁公平性** —— 这是本轮最有价值的发现
    只要高优先级源的 valid 持续为高，低优先级源就**永久得不到服务**。
    原来所有源都是单拍脉冲，所以这个缺陷一直看不出来；
    加了队列反压之后立刻显形：pad_pitch 的 ev_valid 会持续为高（它在等被接收），
    于是排针事件被**活活饿死**（实测单源 3 条只收到 1 条、mh_note 一直停在 pads 那条）。
    修法：改成**轮转仲裁**（2 位指针，每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
2026-10-06 阶段2 事件通路完成：真 UART 字节流下 28/28 一条不丢，纳入闸口 35/35
    【本轮的关键修正：判据的激励必须走真源】
    上一轮 tb_evmerge 用 `force` 驱动 tdm_top 的内部写口来伪造 UART 写，
    那样**绕过了 uart_rx 与两字节组帧** —— 那正是我们要验的输入路径的一部分。
    实测后果：整段 UART 事件都取不到音符（note 恒为 0），看着像 RTL 又丢事件。
    改成往 `uart_rx` 引脚喂**真实 [addr][data] 帧**（115200/8N1，234 拍/位）后：
    发出 28 条，note_map 侧收到 28 条
    M1 一条不丢 PASS
    M2 逐条(note,on,vel) 全相等 PASS
    M3 note-off 14/14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
2026-10-06 阶段3 首个真修复：声部释放→回收闭环（note-off 把 gtab 写回 FREE）。闸口 36/36
    【缺陷（已复现）】
    note_map 的 note-off 分支只清 gact，**从不把 gtab 写回 FREE**；
    而"空闲组"的唯一判据是 gtab == FREE ⇒ 32 组被用过一次之后，空闲搜索
    **永远不再命中**，之后每个 note-on 都走 round-robin **抢占**，
    会把正在按住的音抢掉。
    实测（tb_alloc，修前）：
    按住 note40（组0）→ 依次按 32 个音 → 松开 31 个
    gtab==FREE 的组数 = 0（应为 31）
    新音 note100 落在【组0】⇒ 把仍在按住的 note40 抢掉了
    RESULT alloc=FAIL fails=2
    【修法（两处）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
2026-10-06 状态表更新：阶段2事件通路标完成；阶段3回收闭环标完成（19 alloc）；补两条假绿类坑（激励不够/激励绕过被测路径）
2026-10-06 收口遗留项1：24 位饱和/截断路径的边界判据（闭环"从未进饱和区"）。闸口 37/37
    【问题】12 f1 与 16 i2s top 都到不了饱和区：
    32 复音满力度时 sum_raw 峰值 383370，而阈值是 acc_next >= 2^19 = 524288
    ⇒ 383370/524288 = 73%，clamp 分支**从未被任何判据覆盖**。
    【本机限制】没有 Gowin 工具链，也没有增益寄存器可调 ⇒ 无法靠"加大激励"顶进饱和区。
    【解法】直接驱动饱和表达式的**输入**：force 引擎内部的 `acc_next`
    （tdm_engine.v: `wire signed [31:0] acc_next`；scaled = acc_next <<< GAIN_UP(4)），
    逐点核对输出是否精确等于独立算出的期望值。**不改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
2026-10-06 阶段3：把"逐声部保存力度/音色"从【假设】验成【不变量】（不需要独立存储）。闸口 38/38
    【原先的表述】阶段 3 计划里写着"保存每声部力度/音色/状态"，一直当作缺口。
    【读代码得到的印象】note_map 在**装载时**就把力度算进每个泛音的幅度：
    vel_shape → amp_shaped → amp_cal = amp_shaped*vel_cur>>8 → load_amp
    引擎逐槽写进 pa_mem（待生效影子内存）⇒ 力度**烘进幅度**，装载后不再查全局。
    【把印象变成事实：tb_voice 三条判据（RESULT voice=PASS）】
    V1 同一音不同力度 ⇒ 落进 pa_mem 的幅度**不同**
    （vel=15 与 vel=3 的两组有 6/16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
2026-10-06 阶段3 收尾：完整位宽 Nyquist 判据 + 预设表混叠审计（发现 49 组真实混叠）。闸口 40/40
    【22 nyquist —— 完整位宽与 Nyquist 约束】
    N1 增量位宽：用 inc = round(f * 2^24 / fs) **独立算出**全部 128 个音，
    与 note_inc.hex 逐项比对（判据以公式为准，不以表为准 ⇒ 不循环）。
    结果：128/128 逐项相等；最大增量 3990774，只占 24 位的 23.8% ⇒ 位宽充足、**未截断**。
    N2 单声部 Nyquist 约束（加性合成固有）：每声部 16 个泛音，第 k 个泛音频率 = r_k * f(note)，
    要求 < fs/2 = 26367.188 Hz。量化结果：
    音号 92 (1661 Hz) 时 r=15 恰好 24918 Hz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
2026-10-06 阶段3 最后一项（整组提交）：定性完成、定量待补。闸口 40/40
    【读代码得到的确定事实】
    tdm_engine 的待生效区是**逐时隙**的：pv_mem / pa_mem / pi_mem / pe_mem / pgq_mem
    每槽各一份；消费条件是
    consume = pv1 & (pp1 != ppr1) // 该槽被访问，且装载奇偶标签变了
    ⇒ **装载在每个槽各自被访问时分别生效，不是整组一次生效。**
    （note_map 侧 ST_LOAD 也是每拍一个槽，load_slot = 组*P + k，k 递增到 P-1。）
    【仿真观察到的一致现象】
    对组 0 用不同力度（vel 15 -> 1）重装后，400 个帧里始终是
    "与旧值相同 11 个 / 变化 5 个"
    —— 4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
2026-10-06 阶段3 闭合：整组提交已定性+定量 —— 16 个泛音分散在 2 帧内生效（跨度 1 帧 ≈ 19 µs）。闸口 40/40
    【判据口径的关键改进（本轮的核心）】
    上一轮用"与旧快照比较"来判"是否半新半旧"，**口径不成立**：
    只有 5/16 个槽两次幅度真的不同（vel_wtab 对其它泛音不缩放），
    无法区分「该槽未变化」与「该槽尚未提交」——会把不变误报成未提交。
    改为**直接测每个槽的提交时刻**：
    待生效区每槽有独立标志 pv_mem 与数据 pa_mem，消费时
    amp_mem[slot] <= pa_mem[slot] 且 pv_mem[slot] <= 1'b0
    ⇒ `pv_mem[slot]==0 && amp_mem[slot]===pa_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
2026-10-06 阶段4：公开导出泄漏判据加固 —— "泄漏了也返回 0" 改为"泄漏即中止"。闸口 41/41
    【审计发现的两个问题】
    1) make_public.py 在提交前只把三项痕迹计数**打印**出来，
    **泄漏了也照常 commit 并返回 0** —— 而"退出码 0"正是上游判断
    "这一步成功"的依据 ⇒ **泄漏会被静默放过**。
    2) 排除本身依赖两个**偶然条件**：
    ① `git rm -r --cached .` 顺手把 make_public.py 自己清出索引；
    ② `tools/scripts/_*.py` 只写在 **public 分支**的 .gitignore 里，**主线没有** ——
    工作树里那 **28 个未跟踪**的 _*.py 排查脚本"只是因为还没被 add 才没进"。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
2026-10-06 阶段4：生成脚本补严格退出码 + 自校验；并纠正一处"注释与数据不符"。闸口 41/41
    【问题】gen_tilt_wtab.py 原来只往 stdout 写表：**表错了也退出 0**，
    下游（门禁、综合）无从察觉。同类问题本项目已踩过三次：
    · $readmemh 数组开小 ⇒ 只装一半、其余 X（note_map.v）
    · 位域重叠 ⇒ 整表报废（note_map_gen.py）
    · 缺表 ⇒ 曾被门禁漏过（后由 copy_data() 兜住）
    都属于"数据错了但流程照样绿"。⇒ 生成脚本必须**自己先验**并给出严格退出码。
    【已加】自校验（失败即 return 1，结论走 stderr 不污染 stdout 的表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
2026-10-06 阶段4：scan_traces 严格退出码 + 修掉一个会产生假阳性的正则（base64 误命中）
    【严格退出码】
    scan_traces.py 原来是纯审计：无论查出多少身份痕迹都 return 0
    ⇒ 它在任何流水线里**永远绿灯**，只能靠人眼看输出。
    但又不能默认改成"有痕迹就失败" —— 主线（私有）本来就允许存在过程材料。
    故加显式开关 `--strict`：A 列（过程身份）非 0 即返回 1。
    实测：普通模式 exit=0；--strict exit=1（主线确有过程材料）。
    【修掉一个假阳性正则（本轮的真发现）】
    PAT_A 里的 ASCII 词（GLM / prompt）**没有词边界**，于是**内联 base64 数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
2026-10-06 状态表：阶段4 严格退出码补齐 + 三条新坑（假阳性被当真泄漏/审计脚本永远绿/生成脚本无退出码）；门禁复跑 41/41
    【门禁】全量复跑 **41/41 通过**（这里是**实测**，不是推断 ——
    虽然已核实 regress_all.py 不引用本次改动的两个脚本，
    但"不引用"只是"应当无影响"的推理，我仍然跑了一遍拿实测结果。）
    【记录的三条坑】
    1. **扫描器的假阳性被当成真泄漏**：scan_traces.py 的 GLM/prompt 没加词边界，
    内联 base64 里 `...ZwGlmTZl...` 被算成身份痕迹（5 个架构 HTML 各报 A=2）。
    我一度判断"公开版真有泄漏"、差点去动公开版 ——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
2026-10-06 阶段4：leakcheck 增加 D 组「三份清单同步」判据（防"改一处漏两处"）；门禁 41/41
    【发现的维护陷阱】
    make_public.py 把"内部材料"这份知识写成了**三个投影**，规模还不一致：
    EXCLUDE 20 条 要 git rm --cached 的路径
    IGNORE_BLOCK 43 条 追加进公开版 .gitignore 的规则
    LEAK_PATTERNS 21 条 提交前 find_leaks() 用来中止的判据
    ⇒ 将来新增一条排除项时，只改其中一两处是很容易发生的；
    而**只改 EXCLUDE/IGNORE 而不改 LEAK_PATTERNS** 会让新项*不被判据拦住* ——
    "排除规则"与"泄漏判据"脱节，正是最该防的那种漏洞。
    【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
2026-10-07 阶段4 完成最后一项：公开导出工具链移出活动工作树（→ 同级仓 ../fpga-export-tooling/）。闸口 41/41
    【按用户决定的选项A执行】
    6 个整理/导出工具 + 27 个一次性排查脚本 _*.py **物理移出工作树**，
    在同级目录另建独立 git 仓 `../fpga-export-tooling/`（仍有版本控制，非裸删除）。
    主仓侧用 git rm 取消跟踪（文件已不在工作树）。
    【搬动前先理依赖 —— 这一步避免了把门禁弄红】
    主仓门禁套件 `24 leakcheck` 原先用 importlib 加载
    `tools/scripts/make_public.py`。工具一旦搬走，那条路径就不存在，**门禁会红**。
    ⇒ 结论：**「不许出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
2026-10-07 状态表：阶段4 标记完成（六项均有判据）；记录搬迁方案与验证
    阶段4 六项状态：
    ✅ 源文件与数据清单统一入口（copy_data + DATA_FILES，缺表即红）
    ✅ 判据脚本对坏输入给可读结论
    ✅ 公开导出泄漏判据（24 leakcheck A/B/C/D 四组）
    ✅ 公开版实际泄漏复核（带词边界严格扫描：无实际泄漏）
    ✅ 严格退出码（门禁 / 导出 / 生成 / 审计四类）
    ✅ 公开导出移出活动工作树（→ 同级仓 ../fpga-export-tooling/，规格留产品侧）
    搬迁的关键判断（值得留档）：
    "不许出现什么"是**产品侧知识**（门禁守产物、必须能 import），
    "怎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
2026-10-07 阶段5 开工：登记 I²C 资产（自检失败 3 项，此前从未被任何判据跑过）；门禁 41/41
    【为什么先查 I²C / 38 通道 / 音域条】
    阶段4 已闭合，剩下都号称"依赖硬件"。但阶段5 里"器件通信与通道解码"
    其实有纯仿真可做的部分 —— 先确认这些资产到底存不存在、有没有被验过。
    【核实结果】
    · I²C：src/rtl/i2c_master.v(246 行) + src/sim/mpr121_model.v + tb_i2c_master.v
    都存在，但**全仓只有那个 tb 例化它**；tdm_top 没用它；
    约束文件 tdm_top.cst:166 明写 "Reserve them for v2"
    ⇒ 它是**为 v2 准备的资产，不参与出货设计**。
    · 38 通道 / 音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
2026-10-07 阶段5：定位 I²C 接收失败到"采样相位"（未修好，已回退，只留定位记录）
    【本轮查到的确定事实】
    tb_i2c_master 3 项失败的根因落在**主机接收采样相位**：
    · 采样发生在 `q == 2'd2`（i2c_master.v:181）
    · 而 S_RX 的输出相位表是：q=0 scl_lo<=1（SCL 拉低）、q=1 scl_lo<=0（SCL 拉高）、
    q=2/q=3 均 `scl_lo <= 1'b1`（SCL 保持高）
    · `scl_lo` 是**寄存器输出**，线上电平比 q 落后一拍
    ⇒ 实测波形里 **q=2 时 scl 线上仍为 0**，即主机在 SCL 低电平期间采样 SDA。
    · I²C 规定数据只在 SCL 高电平期间有效 ⇒ 采样相位与线上 SCL 高电平没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
2026-10-07 阶段2 收尾准备：写出 I²S 相位争议的**板级了结方案**（可执行清单，待上板）
    【为什么现在写这个】
    阶段2 只剩"I²S 标准对齐"一项，且是悬得最久的争议项 ——
    我方两条独立接收模型都判"逐位相等、不符 0"，但两条模型的相位假设**同源**，
    所以**不能据此排除**。审计探针"复位后立即开累加"又提示错位可能只在首字。
    ⇒ 只有板级证据能了结。本文件把"争议是什么、怎么一次问清、结果怎么判"写死，
    使上板当天**不需要再做任何设计决策**。
    【核心思路：把 FPGA 当测量仪，不依赖我方接收模型】
    在 BCK 上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
2026-10-07 阶段5：补上**滑音（portamento）的首个判据** + 更正两处"注释与数据不符"。闸口 42/42
    【为什么必须补：滑音此前完全没有判据，且默认不可听】
    · CTRL(0x00) 自举值 = 0x02 ⇒ bit2=1 ⇒ GLIDE_EN **是开的**
    （tdm_top.v 原注释写 "GLIDE_EN=0"，**是错的**；已逐位核对并更正）
    · GLIDE_STEP(0x35/0x36) 自举值 = 0 ⇒ 速率 0 ⇒ gq 永不衰减
    ⇒ **默认配置下滑音不可听** ⇒ 既有任何音频判据都**不会**因为滑音逻辑有 bug 而变红。
    滑音长期处在"开着、没速率、也没人验"的状态。这一条把它钉住。
    【新增 src/sim/tb_glide.v（G1–G7，13 项断言，RESU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
2026-10-07 状态表：阶段5 记录滑音判据（26 glide）与两条"设计如此"的更正；门禁 42/42
    【新增记录】
    · 滑音的**首个判据** 26 glide（G1–G7，13 项断言全绿）
    · 两处"注释与数据不符"的更正：
    tdm_top.v 的 CTRL 注释 "GLIDE_EN=0" → 实为 1（0x02 的 bit2=1）
    pitch_mod.v 的 GLIDE_CUT 是**死参数**（衰减式本身精确收敛，从未读它）
    · 第一版判据照文档写了 3 条错用例（假失败），逐行核对 RTL 后改正 —— 记入教训
    【门禁】全量复跑 **42/42 通过（另有 1 项已知失败已登记，不计入）**
2026-10-07 阶段5：补上颤音（vibrato）的判据（`27 vib`）。闸口 43/43
    【为什么要有：与滑音同一处境】
    本仓此前**没有颤音判据**，而默认 `vib_depth=0`
    ⇒ 即便 `VIB_EN=1`（CTRL 自举 0x02 的 bit1 就是 1）也**完全听不出来**
    ⇒ 既有音频判据不会因为颤音逻辑有 bug 而变红。本套件把它单独钉住。
    【新增 src/sim/tb_vib.v（V1–V6，15 项断言，RESULT vib=PASS）】
    V1 vib_en=0 ⇒ poff 恒 0（即使 depth 非零）
    V6 vib_depth=0 ⇒ poff 恒 0（**出货默认配置**）
    V2 三角波跨零且幅度正确：实测 max=9921=floor(127*D/128)、min=-10000=-D
    （上下对称，这是"均值≈0"的可复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
2026-10-07 阶段5：新增 legato 行为判据（`28 legato`），并**纠正文档一处表述**。闸口 44/44
    【用户原则里有一条：滑音规则明确区分 legato 与滑动。本轮第一次实测这条】
    【实测发现：文档说 legato「已实现」，但它在正常演奏下**不会触发**】
    34 号规格记为「✅ 已实现且可运行时开关」；实测：
    glide_ok = GLIDE_EN && !match_r && !free_r
    而 tdm_top.v:921 把 GLIDE_EN **硬接 1'b1**；free_r = 选中组写入前 gtab==FREE
    分配器搜索顺序：同音 > FREE > 可回收(!gact) > 抢占
    ⇒ 正常情况总能找到 FREE 组 ⇒ free_r=1 ⇒ glide_ok=0 ⇒ **无滑音**
    ⇒ 文档的「新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
2026-10-07 阶段3/5：用判据证实"可回收档是死代码"，并把不变量写在 RTL 里。闸口 45/45
    【推理 → 事实 的一条】
    阶段 3 我做了**两处**改动：
    ① 加第三档 `found_open`（意图：松手但释放尾音还在响的组，优先于抢占复用）
    ② note-off 分支加 `gtab[gsel_r] <= FREE`（修"回收缺失"，19 alloc 靠它）
    两者叠加推出一条不变量：
    gact[n] == 0 ⇒ gtab[n] == FREE
    而分配器搜索顺序是 **FREE 档在前、可回收档在后**，且 FREE 档遍历所有组
    ⇒ FREE 档必然先命中 ⇒ **第三档永远选不到**。
    ★ 这原本只是推理。新增 `29 inv` 用仿真把它变成事实：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
2026-10-07 阶段4 收敛：机械审计 RTL「死参数/未使用信号」，并清掉唯一一例（GLIDE_CUT）。闸口 45/45
    【为什么做机械审计而不是继续靠人偶然发现】
    本项目反复出现"文档与实现脱节"，已发现两例：
    · pitch_mod 的 GLIDE_CUT（文档说"低于阈值归零"，实现**从未读它**）
    · note_map 的 found_open 档（加了却不可达，29 inv 已证实）
    这类残留两个害处：① 让人**写出错误判据**（我第一版 tb_glide 就照 GLIDE_CUT
    写了 3 条假失败用例）；② 掩盖真正未覆盖的路径。⇒ 改成机械扫描。
    【新增 tools/scripts/deadparam_check.py】
    口径（保守，只报高置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
2026-10-07 阶段1 收口：把规格的 SHA 绑定**变成可复跑的机械校验**，并换绑到 cc3d496。闸口 46/46
    【为什么必须做：原来的"绑定"没有任何东西保证它有效】
    规格 34 号文档列出每个 RTL 模块与 6 张数据表的 blob 短哈希，声称"每项结果绑定源码"。
    但**没有机制保证它们会被更新** —— 改了 RTL 却忘改表，文档就指向旧代码，
    而读者无从察觉。这比"没有绑定"更危险：它**看起来**是绑定的。
    【新增 tools/scripts/spec_sha_check.py（门禁 31 spec sha）】
    逐行取出文档里的 `路径 → 哈希`，用 `git hash-object` 重算**工作树**的实际哈希，
    不一致即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
2026-10-07 阶段1/5：同步方案文档的 legato 前提 + 把"从未进过门禁"的滑音轨迹判据补进闸口。闸口 47/47
    【一、同步 33 号方案文档（旧判据/旧前提）】
    该文档多处建立在「legato 只需"旧音还在响"这个已有事实，CTRL[2] 打开就能演示」之上。
    实测不成立（28 legato）。逐处更正：
    · 顶部加**醒目更正块**：写出根因（GLIDE_EN 硬接 1、搜索顺序先命中 FREE
    ⇒ free_r=1 ⇒ glide_ok=0）、实测现象、"零依赖当天可演示"这个判断是错的，
    并声明"未标注处若与本块冲突以本块为准"。
    · §0 表格：删掉"判据也过了"（那是旧说法），补上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
2026-10-07 阶段4/5：把「门禁覆盖」也做成机械审计；并补上两个"写了没挂"的判据。闸口 48/48
    【动机：上一轮靠偶然发现 tb_pitch_mod 没挂，这一轮把它变成机械检查】
    新增 tools/scripts/gatecov_check.py（门禁信息项 `34 gatecov`）：
    候选 = src/sim/tb_*.v + tools/scripts/*_check.py
    "已挂" = 名字出现在 regress_all.py 里；未引用的列出并给分类提示。
    首次审计：**测试台 54 个，门禁只引用 29 个**；判据脚本 18 个，只引用 12 个。
    ⇒ 立刻找出两个真漏（见下），证明这类检查值得常态化。
    【补漏 1：`33 evhold` —— 我自己写的事件队列单元判据，当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
2026-10-07 阶段5：把长仿真 T60 取证挂进门禁，**发现一档混响饱和削顶**（已知失败登记）。闸口 48/48
    【入口：本轮继续用上一轮的机械审计（34 gatecov）逐个判断未挂资产】
    先测出真实耗时（而不是按 >120s 就判死）：`tb_t60` 实测 **约 130 秒**
    （4 档 × 70000 样本 = 280k，是 tb_pitch_mod 64k 的 4.4 倍）⇒ 是**长仿真而非挂死**。
    ⇒ 按"只在 --full 下跑"登记为 `35 t60(kf)`，不拖慢快速门。
    【真发现：4 档 RV_FB 里有 1 档饱和削顶】
    fb=0x40(0.250) 饱和 17 (0.0%) OK
    fb=0x60(0.375) 饱和 21 (0.0%) OK
    fb=0x80(0.500) 饱和 28 (0.0%) OK
    fb=0xC0(0.750) 饱和 **69039 /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
2026-10-07 阶段5：把混响 0xC0 档削顶**查到根因**（反馈环失控直流），并写进判据输出。闸口 48/48
    【上一轮只报了症状："饱和 98.6% ⇒ 该档不可用"。本轮定性】
    【根因（有数据支持，非推测）】
    判法是看**均值**：噪声/音乐均值≈0；反馈环失控产生的直流均值会远离 0。
    实测 4 档（sim_build/_long_tb_t60）：
    fb=0x40 均值 44.5 RMS 1895 峰 160000 削顶 0.0%
    fb=0x60 均值 60.7 RMS 1961 峰 160000 削顶 0.0%
    fb=0x80 均值 107.5 RMS 2103 峰 160000 削顶 0.0%
    fb=0xC0 均值 **7,811,904** RMS 8.07e6 峰 8,388,352 削顶 **98.6%**
    ⇒ 0xC0 不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
2026-10-07 阶段4/5 收口：把两项待裁定与混响实测写进文档；并实测出入口禁之外的判据资产。闸口 48/48
    【一、把"只在提交信息里"的东西写进文档】
    · `35-五阶段推进状态.md` 新增「⏳ 两项待裁定」表：
    1 legato 触发方式（A/B/C），附实测根因与影响面（(B) 要动分配语义 ⇒ 必须复跑
    19 alloc / 28 legato / 32 pitchmod）
    2 混响 RV_FB=0xC0 档（A 救回来 / B 移除），附失控直流的实测数字与机理
    并声明：**两项都不裁定也不会误导人** —— 文档已按实测标注，判据会持续报出真实行为。
    · `34-当前版本规格-基线v1.md` 的"本版明确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
2026-10-07 阶段5：深查 show_check 的 0/15 —— **修正我自己上一轮的错误判断**
    【上一轮我写下的判断是错的，本轮纠正】
    我当时写："15 个实测值全部精确等于期望集合里的另一个音（比值 2.005/2.998/3.365）
    ⇒ 音高是对的，只是分析窗口锁到了别的音符段"。
    **这是错的**，根因在**我自己的分析脚本**：我误用了 `np.loadtxt(...)[:,0]`
    = **样本序号列**（一条 0..202499 的斜坡），把斜坡的 FFT 当成了音高。
    那组"精确整数倍"只是斜坡 bin 与窗长的关系（k=1 恒定 ⇒ 频率反比于窗长）。
    ★ 判据脚本本身**是对的**：`show_check.load()` 读的是 `f[1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
2026-10-07 阶段5：把 show_check 的 0/15 **定性**（期望音高在、是判据测法不适用），并定位到一个具体的亚八度分量
    【本轮把上一轮留下的 (a)/(b) 分清了 —— 用全谱分析，不是猜】
    对判据第一音的窗（x[3000:3000+8192]）做全谱，**推翻"音符没响"的假设**：
    128.75 Hz 幅度 512,718,193 ← 全谱最强
    263.93 Hz 幅度 321,090,527 ← **就是期望的 C4(261.63)**
    257.49 Hz 幅度 265,519,247 ← 同上（窗泄漏）
    392.68 Hz 幅度 197,961,392 ← **G4（期望音阶第 4 音）**
    521/528 Hz 150M/112M ← **C5（期望音阶第 6 音）**
    ⇒ **期望音阶的多个音都在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
2026-10-07 阶段5：**最终定性** show_check 的 0/15 —— 是判据把 pad0 的八度写错了；我自己错了两次
    【本会话第七次"检查器/我的分析脚本自己有 bug"，也是最值得记的一次】
    · 第一版错：把 `raw[:,0]`（**样本序号斜坡**）当音频做 FFT，得出"比值是精确整数倍、
    音高对的、只是窗口偏移"。真实原因是我**读错了列**。
    · 第二版错：纠正读列后，见 128.75 Hz 是全谱最强峰、且恰为 C4 峰的一半（误差 0.00%），
    于是判定"存在**亚八度分量**"。**这个分量不存在。**
    【真正的原因（一行代码）】
    `pad_pitch.v:22` 的 **`BASE = 48`** ⇒ **pad0 发的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
2026-10-07 阶段5：排除"窗错位/连续"两个猜测，并**发现一个新的真缺陷**：pad 电平按"键奇偶"分档
    【先纠正我上一轮的一个怀疑】
    我曾怀疑判据的 `PER=13500` 时序假设不对。读 `tb_show.v` 核对 ground truth 后**排除**：
    `for i=0..7 { tch(i,1); rec(12000); tch(i,0); rec(1500); }` 再 `for i=6..0` 同款，
    **录音就发生在同一个循环里** ⇒ PER=13500 正确、窗 [+3000,+11192] 确实落在 note-on 段内。
    （这是本会话我第 N 次"先怀疑对方"；核对 ground truth 只需读 10 行源码。）
    【于是逐音测 note-on 段的 RMS，规律极强】
    偶数键（0/2/4/6）RMS ≈ **303,000**，峰值 ≈ 72 万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
2026-10-07 阶段5：pad 电平不对称**进一步量化到稳态 25 倍**，并排除四个方向
    【上一轮报的 3.3 倍是"起音段前 3000 样本"的数字，低估了问题】
    改看**稳态**（每音内第 6000–11000 样本）：
    偶位（pad 0/2/4/6）稳态 RMS = 226,000–232,000，峰 ≈476,000
    奇位（pad 1/3/5/7）稳态 RMS = 9,000– 9,700，峰 ≈ 41,000
    ⇒ **能量差约 25 倍**（峰 11.6 倍）。
    【更关键：衰减"形状"不同，不只是"弱一点"】
    idx0 pad0(偶) 每 1000 样本 RMS: 296977 308030 304007 273380 283351 244713 263628 221647 245050 201560 225186
    idx1 pad1(奇) 每 1000 样本 RMS: 120814 81085 67139 46776 36617 28399 16441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
2026-10-07 阶段5：show_check 0/15 的**根因彻底查清** —— 判据记录了已被替换的旧输入层映射
    【三条证据互相印证，不再有猜测成分】
    1) **哪条通路是活的**：`tdm_top.v:505` 例化 `pad_pitch #(… .BASE(48))`，
    其 `.ev_note → pp_ev_note` 进仲裁器；而 `pad_scan`（含 `penta_note()`：
    pad0→**MIDI 60**）**只做遥测** —— `tdm_top.v:490` 原话「pad_scan 依旧保留，负责遥测」。
    2) **通道映射**：`tdm_top.v:500` `pp_touch = {30'b0, pad_state[7:0]}`
    ⇒ **物理 pad i 直接驱动 pad_pitch 通道 i**。
    3) **音符号公式**：`pad_pitch.v:5` 头注释「音符号 = **48** + 偏移 + 12×档位；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
2026-10-07 阶段5：新判据逐键隔离 ⇒ **推翻"奇偶键本身有缺陷"**；25 倍只出现在切换场景
    【新判据 tb_padprobe.v（快，且直接观测内部信号）】
    不再只看输出音频，而是同时观测三者：pad_pitch 事件 / note_map 分配 / 输出 RMS。
    用法 `+pad=N` 只按一个键（分钟级），便于逐键排查。
    【关键结果：pad0 与 pad1 隔离测试几乎逐位相同】
    | | pad0（偶） | pad1（奇） |
    | note-on | note=48 ✓ | note=49 ✓ |
    | 分配声部 | 1 | 1 |
    | 稳态 RMS | 163,334 | 161,720 |
    | 峰 | 359,760 | 356,496 |
    ⇒ 比值 1.01，**输出几乎相同**；且 `48 + p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
2026-10-07 阶段5：**复现成功** —— 新音音量取决于"前一个音是否刚响过"（与阶段 3 生命周期相关）
    【新判据 tb_padseq.v：精确复现切换序列 + 打出事件时序】
    按 pad0 → 松开 pad0 同时按 pad1 → 松开，记录每次 note-on/off 的样本号、
    音符号、当时的在响组数。
    事件时序（完全正常）：
    [t= 1000] note-ON note=48
    [t= 9000] note-OFF note=48 在响组数=1
    [t= 9000] note-ON note=49 在响组数=1
    [t= 9000] 之后 在响组数=0 ← note-off 释放 + note-on 重新分配
    [t=17000] note-OFF note=49
    【关键对比：pad1 在两种条件下的稳态 RMS】
    pad1 **隔离**（tb_padprob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
2026-10-07 阶段2：**根因指向 note-ON 在"释放与按下同一拍"时被静默吞掉**。判据 tb_padseq 加组状态探针
    【本轮的探针与结果】
    给 tb_padseq.v 加**组状态探针**（dump gact/gtab：哪个组在响、音符号是什么），
    在 446 秒一次仿真里拿到完整时序 + 组状态：
    [t= 1000] note-ON note=48 在响组数=1, g0(note=48)
    [t= 9000] note-OFF note=48
    [t= 9000] note-ON note=49 ← 事件**确实发出去了**
    t=9000 之后 ← **组状态始终为空，没有任何组在线**
    [t= 17000] note-OFF note=49 在响组数=0
    [t= 21000] 全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
2026-10-07 阶段2：**缺陷精确定位** —— pad 通路在"释放与按下紧邻"时静默丢 note-ON（11 秒判据）
    【本轮做出了一个"秒级判据"，才使得逐级排除可行】
    · tb_padseq（含录音）复现成功但要 **446 秒**，无法迭代；
    · 新建 tb_padfast.v（**不录音频**，只测事件与组状态）⇒ **11 秒**，提速 40 倍；
    · 新建 tb_evseq.v（直接在外部事件口打脉冲，绕开 pad 通路）⇒ **2 秒**。
    【两步排除，定位到"pad 通路 → 队列之间"】
    tb_evseq：外部事件口打 **1 拍间隔**的 off→on ⇒ **PASS（2 秒）**
    ⇒ **事件队列与 note_map 本身没问题**。
    tb_padfast：走完整 pad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
2026-10-07 阶段2：**根因确证** —— 单槽挂起寄存器 `pp_pend` 静默吞掉紧邻事件（含实测证据）
    【根因（代码位置 + 实测数字）】
    src/rtl/tdm_top.v:817 pads 源的事件锁存：
    if (pp_ev_valid && !pp_pend) begin // ★ pp_pend=1 时这一拍的事件被直接忽略
    `pp_pend` 是**单槽挂起**：置 1 后要等 ev_in_ready（队列可接收）才清零。
    该窗口内到来的事件，pp_ev_valid 虽为 1，却因 !pp_pend 为假而**被直接忽略**——
    **既不入队、也不报错 ⇒ 静默丢弃**。
    【实测证据（tb_padfast B 段：松开 pad0 的同一拍按 pad1）】
    pad_ev_valid 拍数 = 2 ← 两个事件**都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
2026-10-07 阶段2：事件通路修复**方案已成文**（先出方案再动手）；并发现同族第二个缺陷（UART 覆盖）
    【为什么先出方案而不直接改】
    这是**输入事件通路的架构性改动**，而该路径本项目**已踩过三次坑**
    （约束原文写在 tdm_top.v:707-711：每源都要有挂起位 / out_ready 必须单拍 /
    队列输出不能中间插寄存器否则消费两次）。盲改风险高，故先成文再实施。
    【新增文档 docs/02-技术方案/37-事件通路静默丢失-修复方案v1.md】
    · 问题与实测证据（复用 tb_padfast 的 6 项断言）
    · 必须遵守的 5 条既有约束（含"不得重写内核""按职责而非行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
2026-10-07 收口：本轮暂停扩展，固化可审查状态（缺陷已确证、方案已成文、集成尝试已回滚）
    【按用户指示收口，不继续扩展审计/功能/反复全量回归】
    【交付状态】
    · 提交 SHA：本提交（父提交 f4c53b5，工作树干净）
    · 全量门禁：48/48 通过（另有 5 项已登记、不计入），exit=0
    记录：sim_build/regress_FINAL_f4c53b5.txt
    · 未交付的集成尝试留档：sim_build/tdm_top.v.WIP-queue-attempt（**未提交**）
    【已完成】
    · 根因确证：pads 丢事件 = 单槽挂起寄存器 pp_pend
    （`if (pp_ev_valid && !pp_pend)`，挂起窗口内的事件被静默忽略）
    · 可复现判据 tb_pa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
2026-10-19 存档：把 38-86 号设计文档与验收证据纳入版本库（此前全部未跟踪）
    背景：main 的 HEAD 停在 fe326ad (2026-10-08)，而 2026-10-09 至 10-19 的
    11 天设计演进（doc 38-86）全部是 untracked 文件，只存在于工作目录。
    任何一次误操作或磁盘故障都会让这段工作彻底消失。
    本次只做入库，不改内容。
2026-10-21 建立多 agent 协作板：轴划分、路径所有权、编号规则、交接格式
    背景：本项目已出现两个 agent 并行推进（Codex 在 4d37/4a4b，WorkBuddy 在
    D:/FPGA-Project/wb-worktree-20261019），但缺少协调机制，已造成实际损失：
    1. 文档编号撞车：87/88 各存在两份（Codex 2026-10-22 版 / WorkBuddy 2026-10-19 版）。
    2. 方向相反：WorkBuddy 按"删渲染器合并双屏"做动作 A，而 Codex 87 号 §4.6
    明确要求双屏保留，动作 A 的前提被否。
    3. 孤儿分支：grep 全部 Codex 工作树，无一处引用 WorkBuddy 的 a9aea91。
    4. 构建目录被覆盖：重跑基准覆盖了 build_nominal_v4/impl（数字一致，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
2026-10-21 协作板补 §8：远程与备份的两个坑
    核实结果：
    1. origin 与 public 指向同一个地址 FPGA-Music-project.git（不带 -internal）。
    public/main 上有提交「公开版快照：移出内部过程材料」，说明该仓库对外。
    本地 main 含 docs/01-竞赛情报 的评分策略分析 → 禁止推 origin/public，只推 internal。
    internal 落后 61、领先 0，可 fast-forward；origin 落后 126 领先 2、public 落后 126 领先 1，
    两者均双向分叉，禁止推。
    2. push 不等于备份。已跟踪仅 509 文件 / 28.3 MB：
    experiments/ 2103 MB 零跟踪，notes/ 502 MB 只跟踪 2 个文件，06df 的 hardware/ 304 MB 零跟踪。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
2026-10-22 Add current M1 handoff, exact source provenance and stale-entry guard
2026-10-22 Require published entry fingerprints before handing off work
2026-10-22 Record verified recovery, current M1 tests and next-agent handoff
2026-10-23 Keep design fingerprints portable with canonical LF text
2026-10-23 Make actual main the design authority and track review freshness
2026-10-23 发布可追溯的三领域协作工程候选及隔离验证入口
2026-10-23 docs: register score-live FIFO rule and isolate golden velocity-profile differences
2026-10-23 Connect shared note resources to transactional real TDM audio backend
    Add common-frame 512-partial publish/retire, real envelope completion and boot quiet fence in isolated audio probe. Preserve legacy177951-clock equivalence, 546-request real PCM run, four mutation detections and53 Python tests. Same-source synthesis is not full-product fit or timing acceptance; external partial provider, live/score routing and steal fade decision remain pending. Preserve runner/disk-full failures and reviewed hardware metadata without editing producer sources.
2026-10-24 Connect real four-slot partial renderer and fix velocity scaling/concurrent admission defects
2026-10-24 feat(fpga): connect immutable frame-format source to tokenized contact ledger
    Preserve quarantine/watchdog and accepted-transaction timeout semantics, with1143-frame and five designated-fault evidence. Actual analog scanning, finger consumer and real allocator/audio remain pending. Retain both changed-RTL full-constraint PnR access violations without STA.
2026-10-25 docs(hardware): pause PCB work and record current blockers
    Record verified native951 and offline IO-tail checkpoint separately, preserve UNMEASURED and manufacturing hold, and list routing, display, assembly, power and integration blockers. Status/evidence summaries only; full recovery archive remains local. No RTL or CAD changes.
2026-10-25 docs(hardware): record 951 PCB pause state and blockers
    原提交 83696b55 的内容原样保留：暂停状态、证据清单与 6 份证据快照。
    本次重建只调整提交边界，不改内容。
2026-10-25 hardware(pcb): seal 951 checkpoint with release-hosted bulk blobs
    951 检查点原先整目录入库，其中 13 个文件占 621.99 MiB（recovery 11 个分卷
    491.55 MiB + offline 两个大 JSON 130.45 MiB），而仓库自身内容只有 88 MiB。
    本提交把字节移到 Release 资产 pcb-951-full-20261025，把身份留在 Git。
    - manifest.json：73 条记录中 60 条仍在树内；13 条标 storage=release，
    新增 external_storage 声明 Release 位置、资产数与 combined sha256。
    - pcb_checkpoint.py：理解 storage=release，本地存在则逐字节校验，缺失则
    只校验清单声明；--external-root 指向已下载目录，--require-external 把
    缺失升级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
2026-10-25 docs(pcb): add six-role parallel execution package and closure plan
    原提交 7c02664f 的规划部分与 592da06f 的评审记录，独立成一次提交，便于
    单独 review 与单独回滚。
    - project/pcb-parallel-20261025/：CONTRACT、ACCEPTANCE、START-HERE、
    plan.json（G0–G6 全 NOT_RUN）、assignments.json（六角色全 owner=null）、
    六张任务卡与 handoff 模板。
    - project/reviews/20261025-pcb-parallel-plan/：计划自检脚本与 scoped review，
    明确 global_review_renewed=false。
    - project/reviews/20261025-pcb-sync-plan/：远程授权、P1 源评审、交付与校验记录。
    - project/PCB-RESOLUTION-PLAN-20261025.md、AGENT-BOARD 的 2026-10-25 段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
2026-10-25 chore(governance): bind scoped review, refresh controlled hashes, keep blob proof
    原 7c344f34 与 7c02664f 的治理部分独立成一次提交。治理规则影响后续每个
    PR，因此必须能单独 review、单独回滚，不与 622 MiB 归档绑在一起。
    - governance.json：92 项受控文件哈希与当前内容一致；其中 manifest.json 与
    pcb_checkpoint.py 因外置改造重算（cb66fb4e… / f38e86d9…）。两条
    scoped_addenda 保持 global_review_renewed=false —— 本提交不续期全局评审。
    - project-entry.yml：verify-pcb-checkpoint 更名以如实描述其范围（树内字节 +
    外置身份），新增 verify-release-blobs，仅在 schedule/workflo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
2026-10-25 Refresh current hardware to accepted native951 and retain exact offline candidate
    Replace the old e098 saved PCB with native951, preserving all14 schematic pages. Include the current62/24 offline MUX geometry/reference context, acceptance-boundary evidence and same-source227-row CPL draft. Update only the hardware portion of the engineering source manifest. This remains42 open connections/12 nets, not fabrication or order ready. Physical tests UNMEASURED. No RTL, host or shared worktree/index changes.
2026-10-25 补齐951单J10线束电气草稿及当前采购入口
    核对12个原生J10焊盘，覆盖模块40针连接与NC；保留复位与机械未放行边界。无PCB或RTL变更。
2026-10-26 Record module delivery constraints and verified interface research
    Keep accepted native951 and offline62/24 unchanged. Add the Guangdong Qingyuan 700 CNY cap, pre-soldered assembly requirement, complete-function reconciliation, official I2S header evidence and candidate sourcing limits. Not a final purchase or manufacturing release.
2026-10-26 chore(governance): renew review from live observation; set sustainable windows
    - observe at 2026-10-26T13:27:46Z covered 618 declared files across four
    active producers: added0 removed0 modified0 against 2026-10-24T15:21:18Z.
    Renewal is grounded in that observation; observe wrote renews_review=false
    and reviewed_at was not edited on the old record.
    - review_max_hours 24 -> 72, observation_max_hours 6 -> 30,
    schedule '17 */6 * * *' -> '17 1 * * *'.
    - Rationale: all four producer roots are local-only (D:/FPGA-Project,
    ~/.codex/worktrees/06df); GitHub cannot observe them, so a 6h window
    checked on a 6h schedule could never stay green.
    - D-021-REVIEW-WINDOWS records the threshold cha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
2026-10-26 chore(governance): 168h review and observation windows; daily schedule kept
    A 30h observation window against a daily 01:17Z schedule still went red on
    the second run (35.8h > 30h), so the window must be at least twice the
    schedule period. Both windows are now 168h (7 days): one real observation
    per week keeps the scheduled check green, with six days of slack.
    - review_max_hours 72 -> 168, observation_max_hours 30 -> 168.
    - D-022-REVIEW-WINDOWS-WEEKLY supersedes D-021; D-021 retained as superseded.
    - Evidence and arithmetic: project/reviews/20261026-maintenance/WINDOW-POLICY-V2.md.
    - Unchanged: product_acceptance=false, implementation_start_authorized=false,
    no PnR/STA/board test/programmi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
2026-10-26 补充模块接口适配缺口与同器件直插方案证据
    保存原厂PDF、595复位/RA8875/触摸/存储/物理顶层的具体对应证据。完整采购未定稿；原PCB、FPGA和主机软件不变。
2026-10-26 保存14路前端真实原理图与独立焊盘映射检查
    同一工程新增Sensor14Bank，28件150引脚及导入焊盘网络逐一核对通过，原951及14页未改。小板未布局未布线，完整购物单及工厂报价仍未放行。
2026-10-26 保存14路前端布局、真实地接触及单层布线终态
    保留48段局部铜和36地孔；35信号网未闭合，未签收制造。原951及14页不变。固件登记13文件未变，无产品源码或其他轴修改。
2026-10-26 Close12manual sensor frontend nets with actual Ground audit
2026-10-26 Close remaining two internal sensor nets with real Ground verification
2026-10-26 Document exact audio module pin contract and original BOM coverage
2026-10-27 Document control and protected power procurement constraints
2026-10-27 Record offline electrode mapping and bounded route checkpoint
2026-10-27 Record explicit sensor fanout and left8 path candidate
2026-10-27 Preserve native Sensor14Bank fourlayer zero-DRC trial and unresolved reference audit
2026-10-27 Record actual35 transition clearances and honest purchase assembly status
2026-10-27 Add independent edit action wiring proposal and owned Nano TF scope evidence
2026-10-27 Audit sensor manufacturing inputs and screen supply candidates; correct Nano header contract
2026-10-28 Back up Control88 native candidate, sourcing table and verified DAC startup
    Preserve recoverable review sources without replacing current/main engineering inputs. Native schematic DRC is clean; PCB remains unrouted with 412 connectivity errors. Record 20.32mm Nano spacing repair, 470ohm/2.2nF AUX filter, 37-SKU RFQ and isolated startup/serial-format checks. No manufacturing release or product acceptance.
2026-10-29 Preserve R2/S1 recovery baseline and explicitly hold Sensor14 manufacturing
    Capture exact hardware archives, assembly/order instructions and 66 Q4 recovery inputs. Retain 22-pad exported clearance failure below0.1651mm; correct prior all-gates manufacturing PASS. No source geometry/RTL changes or product acceptance.
2026-10-29 交回2026-10-30最新硬件与采购成果：450mm尺寸、音频引出、电极样片和队友整合包
    完整交接入口 hardware/team-handoff-20261030/README.md；包含可离线验证的87文件ZIP。保留S1实际Gerber严格铜距暂停投产；完整电极、屏幕完整报价、电源与线束未闭合。不代表main合并或整机制造验收。
2026-10-29 完成Sensor14Bank S2严格铜距修正与同源审单资料交回
    原22处实际Gerber铜距提升到0.23254mm，原生重铺/保存重开DRC0；四层异网铜距及网络分离、83孔、28件BOM/CPL与阻焊板框对应核验通过。新增可恢复原生源、自足离线复核依赖和厂家审单包。旧S1停用；厂家DFM、报价付款、完整电极与实体演奏验收仍待完成。
2026-10-29 Back up complete full84 routed source and 450mm assembly contract; native DRC/CAM pending
2026-10-29 Clarify frozen C88 capacitor instance identities; keep actual stock and quotes separate
2026-10-29 Add explicit capacitor quote option and reconcile full custom-board component quantities
2026-10-30 Verify full84 electrode native DRC and actual CAM; retain unrelated Q4 drift
2026-10-30 Preserve conditional power thermal and harness geometry constraints
